NexusGPT/openring/design/datasheets/README.md

# Maker documents are not included

The project was built from the datasheets, application notes and web pages of the parts' makers. Those documents belong to their makers, so none of them is in this repository. Each part below has its maker, the maker part number as written in the parts lists (`design/bom.csv` for the ring, `design/case/case-bom.csv` for the charging case) and the title of the maker document the project cites. A public address is given only where a project file already states it; no address was looked up for this table. Get the documents from the makers.

The `Cited as` column holds the file name the document had in the project's working folder, so that a citation in a design document can be matched to a row.

| Maker | Maker part number | Used for (reference, list) | Title of the cited maker document | Cited as | Public address stated in a project file |
|---|---|---|---|---|---|
| Nordic | NRF54LM20A-CAAA-R7 | U1 (ring) | no maker document is cited for this row (order code from a list or a calculation) | none | none stated |
| Nordic | nPM1304-CAAA-R7 | U2 (ring) | nPM1304 Power Management IC - Datasheet v1.0 | npm1304_datasheet_v1_0.pdf | none stated |
| Yageo | RC0201FR-0747KL | R60, R71, R63,R64,R65 (ring) | no maker document is cited for this row (order code from a list or a calculation) | none | none stated |
| Yageo | RC0201FR-07150KL | R72 (ring) | no maker document is cited for this row (order code from a list or a calculation) | none | none stated |
| Yageo | RC0201FR-07330KL | R73 (ring) | no maker document is cited for this row (order code from a list or a calculation) | none | none stated |
| CS Semiconductor | CSNP32GCR01-BOW | U3 (ring) | SD NAND Memory (CSNP32GCR01-BOW ) | slim2_cs-sdnand-20230403.pdf | none stated |
| Texas Instruments | SN74AXC4T774RSVR | U10 (ring) | no maker document is cited for this row (order code from a list or a calculation) | none | https://www.ti.com/lit/ds/symlink/sn74axc4t774.pdf |
| SGMICRO | SGM38046YG/TR | U4 (ring) | SGM38046 / Single Inductor Power Supply [first lines of page 1] | p3_sgm38046.pdf | none stated |
| Knowles | SPK0641HT4H-1 | U5,U6 (ring) | no maker document is cited for this row (order code from a list or a calculation) | none | none stated |
| Tailor Pixels | TOH095XVT-01 | DISP1 (ring) | Manufacturer Certificated / CERT. No.: 282Q19070712006 CERT. No.: 282E19070712007 [first lines of page 1] | display_TOH095XVT-01.pdf | none stated |
| Hirose | FH35C-15S-0.3SHW(50) | J1 (ring) | no maker document is cited for this row (order code from a list or a calculation) | none | none stated |
| Johanson | 2450AT18D0100001E | ANT1 (ring) | no maker document is cited for this row (order code from a list or a calculation) | none | none stated |
| Murata | LQP03HQ3N6B02 | L2 (ring) | nRF54LM20x_caaa | nrf54lm20x_caaa_ref_schematic_0_2.pdf | none stated |
| Murata | LQP03HQ4N7H02 | L3 (ring) | nRF54LM20x_caaa | nrf54lm20x_caaa_ref_schematic_0_2.pdf | none stated |
| Murata | LQP03HQ3N3B02 | L4 (ring) | nRF54LM20x_caaa | nrf54lm20x_caaa_ref_schematic_0_2.pdf | none stated |
| Murata | GJM0335C1H1R2WB01D | C3 (ring) | nRF54LM20x_caaa | nrf54lm20x_caaa_ref_schematic_0_2.pdf | none stated |
| Murata | GJM0335C1ER50WB01D | C12 (ring) | nRF54LM20x_caaa | nrf54lm20x_caaa_ref_schematic_0_2.pdf | none stated |
| Kyocera | CX2016DB32000D0WZRC1 | X1 (ring) | nRF54LM20x_caaa | nrf54lm20x_caaa_ref_schematic_0_2.pdf | none stated |
| TXC | 9HT11-32.768KDZC-T | X2 (ring) | nRF54LM20x_caaa | nrf54lm20x_caaa_ref_schematic_0_2.pdf | none stated |
| TDK | MLZ1608M4R7WT000 | L1 (ring) | nRF54LM20x_caaa | nrf54lm20x_caaa_ref_schematic_0_2.pdf | none stated |
| Murata | BLM03AG121SN1D | FB1 (ring) | nRF54LM20x_caaa | nrf54lm20x_caaa_ref_schematic_0_2.pdf | none stated |
| Yageo | RC0603FR-072R2L | R1 (ring) | no maker document is cited for this row (order code from a list or a calculation) | none | none stated |
| Yageo | RC0201FR-07220RL | R2 (ring) | no maker document is cited for this row (order code from a list or a calculation) | none | none stated |
| Samsung | CL03A104KP3NNNC | C1,C2,C5, C61,C72,C80,C81,C82 (ring) | no maker document is cited for this row (order code from a list or a calculation) | none | none stated |
| Murata | GRM155R60J106ME15D | C4, C25, C74,C75,C78,C79,C90 (ring) | GRM155R60J106ME15# 「 # 」には包装コードが入ります。 / ＜包装コード有り品番一覧＞ [first lines of page 1]<br>SGM38046 / Single Inductor Power Supply [first lines of page 1] | w1d_murata_grm155r60j106me15.pdf<br>p3_sgm38046.pdf | none stated |
| Murata | GRM035R60J475ME15J | C6 (ring) | nRF54LM20x_caaa | nrf54lm20x_caaa_ref_schematic_0_2.pdf | none stated |
| Murata | GRM033D80E225ME47D | C7,C10,C14 (ring) | nRF54LM20x_caaa | nrf54lm20x_caaa_ref_schematic_0_2.pdf | none stated |
| Murata | GRM155R61A475MEAAD | C11, C84, C21,C26,C27 (ring) | nRF54LM20x_caaa<br>GRM155R61A475MEAA# 「 # 」には包装コードが入ります。 / ＜包装コード有り品番一覧＞ [first lines of page 1]<br>SGM38046 / Single Inductor Power Supply [first lines of page 1] | nrf54lm20x_caaa_ref_schematic_0_2.pdf<br>w1d_murata_grm155r61a475meaa.pdf<br>p3_sgm38046.pdf | none stated |
| Murata | 1269AS-H-2R2M=P2 | L10, L71,L72 (ring) | SGM38046 / Single Inductor Power Supply [first lines of page 1]<br>Spec No. J(E)TE243A-0004A-01 Reference Only 1/9 / 参考図 Reference Specifications 型名 Type DFE252010C [first lines of page 1]<br>nPM1304 Power Management IC - Datasheet v1.0 | p3_sgm38046.pdf<br>w1b_murata_1269as-h-2r2m.pdf<br>npm1304_datasheet_v1_0.pdf | none stated |
| Murata | GRM188R61C106KAALD | C24 (ring) | SGM38046 / Single Inductor Power Supply [first lines of page 1] | p3_sgm38046.pdf | none stated |
| Murata | GRM155R60J225ME15 | C23 (ring) | SGM38046 / Single Inductor Power Supply [first lines of page 1] | p3_sgm38046.pdf | none stated |
| Murata | GRM155R60J106ME15 | C22, C83 (ring) | SGM38046 / Single Inductor Power Supply [first lines of page 1] | p3_sgm38046.pdf | none stated |
| Murata | GRM155R60J226ME11D | C28,C29 (ring) | SGM38046 / Single Inductor Power Supply [first lines of page 1] | p3_sgm38046.pdf | none stated |
| Murata | GRM033R60J105MEA2D | C73, C31,C32 (ring) | no maker document is cited for this row (order code from a list or a calculation) | none | none stated |
| Kyocera AVX | 04025A102JAT2A | C35,C36 (ring) | C0G (NP0) Dielectric / General Specifications [first lines of page 1]<br>SPK0641HT4H-1 / Digital SiSonicTM Microphone [first lines of page 1] | w1_kyocera_avx_c0g_dielectric.pdf<br>w1b_knowles_spk0641ht4h-1_chipdip.pdf | none stated |
| Yageo | RC0201FR-07100RL | R61, R31,R32 (ring) | no maker document is cited for this row (order code from a list or a calculation) | none | none stated |
| Alps Alpine | SKTAAAE010 | SW2, SW1,SW3,SW4,SW5 (ring) | 一太郎 10/9/8 文書 | slim_alps-skta-aaae010-orwin.pdf | none stated |
| Yageo | RC0201FR-074K7L | R57,R58 (ring) | no maker document is cited for this row (order code from a list or a calculation) | none | none stated |
| Kyocera AVX | 0402ZC225KAT2A | C60, C85 (ring) | SD NAND Memory (CSNP32GCR01-BOW )<br>X7R Dielectric / General Specifications [first lines of page 1]<br>nPM1304 Power Management IC - Datasheet v1.0 | slim2_cs-sdnand-20230403.pdf<br>w1_kyocera_avx_x7r_dielectric.pdf<br>npm1304_datasheet_v1_0.pdf | none stated |
| Jinlong Machinery | W0525AB001D | M1 (ring) | YB0525BWA APPROVAL REQUEST Rev.0  - 副本.docx | slim2_jinlong-w0525ab001d.pdf | none stated |
| Texas Instruments | TLV75530PDQNR | U11 (ring) | TLV755P 500mA, Low-IQ , Small-Size, Low-Dropout Regulator datasheet (Rev. D) | motor_tlv755p.pdf | none stated |
| Grepow (custom order) | not stated | BT1, PRT1 (ring) | no maker document is cited for this row (order code from a list or a calculation) | none | none stated |
| Gore | not stated | MEM1,MEM2 (ring) | no maker document is cited for this row (order code from a list or a calculation) | none | none stated |
| Texas Instruments | TPD4E05U06DQAR | U6, U9 (case+ring) | TPDxE05U06 1, 4, 6 Channel ESD Protection Device for Super-Speed (Up to 6 Gbps) Interface datasheet (Rev. O) | case_tpd4e05u06.pdf | none stated |
| Yageo | RC0201FR-07100KL | R62,R66 (ring) | no maker document is cited for this row (order code from a list or a calculation) | none | none stated |
| Murata | GRM155R61E105KA12D | C71, C86,C87 (ring) | 注意 : このデータシートは最新でない可能性があります。 / 製品検索 データシート 村田製作所公式ウェブサイトよりGRM155R61E105KA12#の最新データシートをダウンロードして [first lines of page 1]<br>nPM1304 Power Management IC - Datasheet v1.0 | w1b_murata_grm155r61e105ka12.pdf<br>npm1304_datasheet_v1_0.pdf | https://akizukidenshi.com/goodsaffix/GRM155R61E105KA12.pdf |
| Murata | GRT188R61A106KE13D | C88 (ring) | Note: This datasheet may be out of date. / Product Search Data Sheet Please download the latest datasheet of GRT188R61A106KE13# from the official webs [first lines of page 1]<br>nPM1304 Power Management IC - Datasheet v1.0 | w1c_murata_grt188r61a106ke13.pdf<br>npm1304_datasheet_v1_0.pdf | none stated |
| Murata | GRM0335C1H102JE01D | C76,C77 (ring) | Chip Multilayer Ceramic Capacitors for Consumer Electronics & Industrial Equipment Reference Sheet / ■ Scope [first lines of page 1] | c76_murata_GRM0335C1H102JE01.pdf | none stated |
| Murata | NCP15XH103F03RC | RT1 (ring) | Note: This datasheet may be out of date. / Product Search Data Sheet Please download the latest datasheet of NCP15XH103F03RC from the official website [first lines of page 1]<br>nPM1304 Power Management IC - Datasheet v1.0 | w1b_murata_ncp15xh103f03rc.pdf<br>npm1304_datasheet_v1_0.pdf | https://static.chipdip.ru/lib/012/DOC013012218.pdf |
| Master Bond | EP30Med | RC1 (ring) | no maker document is cited for this row (order code from a list or a calculation) | none | none stated |
| Espressif | ESP32-S3-MINI-1-N8 | U1 (case) | ESP32-S3-MINI-1 / ESP32-S3-MINI-1U [first lines of page 1]<br>ESP32-S3 Series / Datasheet Version 2.2 [first lines of page 1] | case_esp32s3_mini1.pdf<br>case_esp32s3_ds.pdf | none stated |
| Texas Instruments | BQ25895RTWR | U2 (case) | BQ25895 I2C Controlled Single Cell 5-A Fast Charger with MaxChargeTM for High Input Voltage and Adjustable Voltage 3.1-A Boost Operation datasheet (Rev. C) | case_bq25895.pdf | none stated |
| Texas Instruments | TPS63802DLAR | U3 (case) | TPS63802 2-A, High-efficient, Low IQ Buck-boost Converter in DFN Package datasheet (Rev. D) | case_tps63802.pdf | none stated |
| Zetta | ZDSD64GLQEAG-R | U4 (case) | ZDSD08G/16G/32G/64G / ZETTA SD NAND Product Datasheet [first lines of page 1] | sdnand_zetta_family_atta.pdf | none stated |
| Texas Instruments | TPS2553DBVR | U5 (case) | TPS255xx Precision Adjustable Current-Limited Power-Distribution Switches datasheet (Rev. G) | case_tps2553.pdf | none stated |
| DNK Power | DNK852338 | BT1 (case) | 3.7V DNK852338 700mAh LiPo Battery Pack with PCM. This / Battery Dimension Pictures 1 YEAR [first lines of page 1] | case_cell_dnk852338.pdf | none stated |
| GCT | USB4105-GF-A | J1 (case) | USB4105 | case_usb4105.pdf | none stated |
| Harwin | P70-6000045R | P1-P4 (case) | (file not found in the source project)<br>(file not found in the source project)<br>(file not found in the source project) | w15_harwin_drawing_P70-600.pdf<br>w15_harwin_component_spec_C056.pdf<br>w15_harwin_graph_CPPOGO.txt | none stated |
| Kingbright | APTF1616SEEZGQBDC | LED1 (case) | APTF1616SEEZGQBDC(Ver.14B) | case_kb_aptf1616.pdf | none stated |
| Yageo | RC0402FR-07510RL (R8); RC0402FR-07270RL (R9 and R10) | R8-R10 (case) | no maker document is cited for this row (order code from a list or a calculation) | none | none stated |
| Mill-Max | 0981-0-15-20-87-14-11-0 | PA1-PA4 (case) | Mill-Max 0981-0-15-20-87-14-11-0 Datasheet | p3_millmax_0981.pdf | none stated |
| Semitec | 103AT-2 | TH1 (case) | BQ25895 I2C Controlled Single Cell 5-A Fast Charger with MaxChargeTM for High Input Voltage and Adjustable Voltage 3.1-A Boost Operation datasheet (Rev. C) | case_bq25895.pdf | none stated |
| Celanese | Vectra E130i, black | MECH16 (case) | no maker document is cited for this row (order code from a list or a calculation) | none | none stated |
