NexusGPT/openring/design/bench/bench-kits.md

# Bench kits for the AI ring recorder (version B2, 2026-11-12)

Same parts as `design/bench/bench-plan.md` version B2. The B1 version of this file (listings read 2026-11-10) is saved as `design/bench/logs/bench-kits-B1-copy.md`; what B2 changed is in `design/bench/b2-notes.md`.

Tags. [F] = read in full on the maker's or seller's page, or in a saved document. [S] = search-result text only, page not opened. [B1] = carried from the 2026-11-10 listing, not read again in B2. Pages read in B2 were fetched as text with `curl` (read only, the default curl user agent except for the first request (the Nordic DK guide, which used the generic string 'Mozilla/5.0 (compatible; text-fetch)' and was refused with a browser check), no account, no cart, no contact, no project or owner name in any request); the UTC read time of each is in `design/bench/logs/fetch_all.log` and the saved copy is in `design/bench/sources/`. Pages that answered HTTP 403 (a browser check), 404 or no reply are listed in the log and marked "not read" below; none was worked around.

The ring's parts are in `design/bom.csv`; the reference and line of each are given in the plan's section 2.

## 1. Main chip (ring: nRF54LM20A, `design/bom.csv` line 2): development kit, debugger, current measurement

**Kit: nRF54LM20 DK, maker Nordic Semiconductor, order code `NRF54LM20-DK`** (Digi-Key part 1490-NRF54LM20-DK-ND) [B1, F on Digi-Key 2026-11-10]. Nordic's DK page prints no order code [B1].

- The kit as sold carries the nRF54LM20B [B1, F]. **The A chip's rules on that kit (new in B2):** the Zephyr documentation of the board says "The nrf54lm20dk/nrf54lm20a board is a modified version of the nRF54LM20 DK that enforces the limitations imposed by the nRF54LM20A IC ... Since Nordic does not offer a development kit for the nRF54LM20A, you can use this board to develop for this IC while using the nRF54LM20 Development Kit (PCA10184)" [F, `https://docs.zephyrproject.org/latest/boards/nordic/nrf54lm20dk/doc/index.html`, saved text `design/bench/sources/zephyr_nrf54lm20dk_board.txt`, page last source update 2026-10-08]. The bench therefore builds for board target `nrf54lm20dk/nrf54lm20a/cpuapp`. This closes the "no kit carries the A die" gap of B1 as far as software can; the silicon stays the B die (plan D4).
- Pin map of the headers [F, new in B2]: DK schematic revision 0.5.4, sheet 8, saved as `design/bench/sources/dk_sch_p8_P1P2-08.png` and `dk_sch_p8_P17top-08.png`. Headers P1 to P5 are 2x10: pins 1, 2, 19, 20 are VDD:IO; P1 pin n = P0.(n-3) (P0.00 to P0.09); P2 pin n = P1.(n-3) (P1.00 to P1.15); P3 pin n = P1.(n+13) (P1.16 to P1.31); P4 pin n = P2.(n-3) (the nets are named P2.00_A to P2.10); P5 pin n = P3.(n-3) (P3.00 to P3.12). P17 (2x13) pin 1 VDD, pin 2 GND, and named pins A0 to F1, C4, G0, H0 to H5 with their chip pins. The user guide's own pin table is still not read (below).
- Pins the DK shares with its own parts [F, DK schematic sheet 2 text and sheet 4 image; Zephyr devicetree `design/bench/sources/zephyr_nrf54lm20dk_common.dtsi` and `zephyr_nrf54lm20dk_a_b_pinctrl.dtsi`]: push button 0 on P1.26, button 1 on P1.09, button 2 on P1.08, button 3 on P0.05; LEDs on P1.22, P1.25, P1.27, P1.28; uart20 on P1.16 to P1.19; uart30 on P0.06 to P0.09 (reaching the debugger through analog switches, sheet 4); the on-board QSPI flash on P2.00 to P2.05.
- Supply: VDD:nRF = VDD:IO = 1.8 to 3.6 V from the DK's own nPM1300; its start-up value is 1.8 V ("Startup VOUT1: 47k -> 1.8V", `design/bench/sources/dk_sch_p6-06.png`, sheet 6) [F]. "DK requires power from USB connector" in the default configuration; a manual override powers the chip through header P14 (sheet 4 note: "R43, R51 mounted: Analog switches are powered from P14") [F]. The two USB-C connectors: nRF USB (J3) and Debugger USB (J4), sheet 8 [F].
- Current measurement: P14 (1x3) and JP1 "Shunt 2.54mm" in the block "Current Measurement", sheet 6 [F]. Nordic's set-up page: "Remove the jumper from the P14 header" and "replace the measurement devices on P14 with the jumper" [B1, F, quoted].
- On-board debugger: SEGGER J-Link OB [B1, F].
- Caveat [B1, S]: a DevZone user read 89 uA on an nRF54LM20A DK against a 4 uA datasheet figure; no confirmed answer found.
- Price: **US$45.00** (quantity 1), Digi-Key US, 321 in stock, lead time 19 weeks, as read 2026-11-10 [B1, F]. Not read again in B2: Digi-Key answers curl with HTTP 403.
- Not read: the DK user guide v0.3.4 (a browser-check page, `design/datasheets/bench_nrf54lm20-dk-hw-ug-v0.3.4.pdf`) and the same guide through `https://docs.nordicsemi.com/bundle/ug_nrf54lm20_dk/...` (HTTP 403, `design/bench/sources/nordic_dk_connector_if.html`).

**Power Profiler Kit II, maker Nordic Semiconductor, order code `nRF-PPK2`** [B1, F: "Ordering code: nRF-PPK2" on `https://www.nordicsemi.com/startppk2`]. Range 200 nA to 1 A; supports all Nordic DKs [B1, F]. Price **US$107.30**, Digi-Key US part 1490-NRF-PPK2-ND, 1,608 in stock, lead 16 weeks, 2026-11-10 [B1, F]. Header names of the PPK2 are not read.

## 2. Power chip (ring: nPM1304-CAAA-R7, `design/bom.csv` line 3): nPM1304 EK

**Kit: nPM1304 EK, maker Nordic Semiconductor, order code `nPM1304-EK`.**

- Order code [F]: Nordic's nPM1304 Product Specification v1.0, "Table 50: nPM1304 order codes", page 168: "nPM1304-EK  Evaluation kit" (saved `design/datasheets/npm1304_datasheet_v1_0.pdf` and its text copy; also `design/architecture.md` line 644 and `design/ecad/motor-drive/motor-drive.md` section 2.9, which names the same kit for the motor test).
- Existence as a product [F]: the specification line "The nPM1304 Evaluation Kit provides simple evaluation and code-free configuration of nPM1304" (same text copy); Zephyr ships a shield `npm1304_ek` for it, "nPM1304 EK", with a 4 mA default charge current and PMIC buttons (saved `design/bench/sources/zephyr_npm1304_ek_doc.txt`, `zephyr_npm1304_ek_overlay.txt`, read 2026-11-11 UTC per the log); Nordic's own product line "The new nPM1304 Evaluation Kit is now available for order through Nordic's distribution partners" is quoted in `design/parts/research-npm1304.md` line 73 [F, saved file].
- Zephyr's page says the EK "is not a direct fit into an Arduino connector" and that its I2C lines must be connected to the board's I2C bus [F]. No header designator or pin table is given.
- **Not read:** price and stock of the nPM1304 EK at any seller (Digi-Key and Nordic answered curl with HTTP 403; Mouser and Farnell gave no reply; see the log). The B1 price of US$64.35 was for the nPM1300 EK and is not carried over. The EK user guide `ug_npm1304_ek` (`https://docs.nordicsemi.com/bundle/ug_npm1304_ek/...`, HTTP 403 browser check, `design/bench/sources/nordic_ug_npm1304_ek_a.html`): battery connector pinout, header labels, VDDIO and pull-ups on the EK are therefore not read (plan section 9, points 1 and 2).
- Chip pins and balls the plan uses: `design/ecad/ring/npm1304-balls.csv` (VBAT D1 D2, VOUT1 B6, VOUT2 C6, LSIN1 B4, LSIN2 B5, LSOUT1 A4, LSOUT2 A5, SDA E5, SCL E3, GPIO0 D6, VDDIO E4).
- Outputs of the buck converters on the family: 1.0 to 3.3 V (Zephyr overlay `limits are set to min/max allowed values`, 1,000,000 to 3,300,000 uV) [F]; this is why the bench sets VOUT2 to 3.3 V (plan D1).
- Used in B1 and not used in B2: the nPM1300 EK (NPM1300-EK, US$64.35 [B1]).

## 3. Microphones (ring: 2 x Knowles SPK0641HT4H-1, `design/bom.csv` line 9)

- **The ring's part, used itself** (plan row 4): Knowles SPK0641HT4H-1, 8-pad LGA, top port, 4.00 x 3.00 x 1.00 mm; pins 1 DATA, 2 CLOCK, 3 SELECT, 4 Vdd, 5 to 8 GROUND; supply 1.6 to 3.6 V; clock 1.0 to 4.8 MHz [F, `design/mech/mic-path/datasheets/knowles-spk0641ht4h-1_chipsmall.pdf`, a third-party host's copy of Knowles Rev A]. Reel suffix, distributor code, stock and price are not known (`design/mech/mic-path/mic-path.md` line 32 and its open item O1; open item S23). Order code: **not confirmed**.
- **Maker's evaluation board for the SPK0641HT4H-1: none found.** No saved file names one. A search engine query for it (`html.duckduckgo.com`, 2026-11-11 UTC) was answered with a bot-check page (HTTP 202, saved `design/bench/sources/ddg_knowles_eval.html`) and was not worked around; Knowles' own site search returned a bot-check page (`knowles_search.html`); Digi-Key, TME and Octopart answered HTTP 403; Mouser, Arrow, Newark and Farnell gave no reply (all in `design/bench/logs/fetch_all.log`). The plan therefore mounts two of the ring's parts on carrier CB-MIC, drawn in plan section 4.1 from the Knowles sheet and the ring's netlist.
- Not used in B2: Infineon kits `KITIM68D128BV01FLEXTOBO1` (US$75.19, 9 in stock, lead time 97 weeks [B1, F]) and `KITIM73D122V01FLEXTOBO1` [B1]. The ring no longer uses the IM68D128B or the IM73D122 (`design/architecture.md` 17.19; review 3 contradiction C7).

## 4. Screen (ring: Tailor Pixels TOH095XVT-01, `design/bom.csv` line 10)

- **The ring's panel cannot run on the bench today.** It needs the vendor's start-up code for the SH8501A (open item 12.1), a panel supply of +4.6 V and -2.2 V (the ring's U4, SGM38046), and a 15-contact 0.3 mm-pitch tail connector (Hirose FH35C-15S-0.3SHW(50), bom.csv line 11) [B1]. No seller offers it with an adapter and example code [B1: BuyDisplay and Gesight pages not readable; Panox BO095F120S datasheet saved `design/datasheets/bench_panox-bo095f120s.pdf`].
- **Chosen stand-in: Waveshare 0.95inch RGB OLED (A), SKU 10507, part number "0.95inch RGB OLED (A)"** [F, `https://www.waveshare.com/product/displays/oled/0.95inch-rgb-oled-a.htm`, saved `design/bench/sources/waveshare_oled095_a.txt`, read 2026-11-11 23:31 UTC]: driver SSD1331, SPI, 96 x 64, 65K colours, 0.95 inch, operating voltage 3.3 V / 5 V; pins 1 VCC (3.3 to 5 V), 2 GND, 3 NC, 4 DIN, 5 CLK, 6 CS, 7 D/C, 8 RES; curved/horizontal pin header; price US$11.99 (quantity 1; US$11.40 at 10 to 49) as read; stock not shown on the page text; a straight-header version "(B)" exists, its SKU not read. Why this one: an OLED like the ring's AMOLED (self-lit pixels, true black), a complete pin table on the page, and the same 0.95 inch size class.
- Considered and not chosen: Adafruit 684, "OLED Breakout Board - 16-bit Color 0.96" w/microSD holder", SSD1331, 96 x 64, 3.3 to 5 V logic and power, US$29.95 (quantity 1), 90 in stock [F, `design/bench/sources/adafruit_684.txt`, same read time]; its pin names are not on the page text.
- The bench stand-in does not carry the panel's real current: the always-lit sign's cost on the ring's panel stays a bench measurement for the day the panel arrives (plan section 8).

## 5. Storage and level shifting (ring: U3 CSNP32GCR01-BOW, bom.csv line 6; U10 SN74AXC4T774RSVR, bom.csv line 7)

- **Adafruit MicroSD card breakout board+, product ID 254** (stand-in; microSD card not included) [F, `https://www.adafruit.com/product/254`, saved `design/bench/sources/adafruit_254.txt`, read 2026-11-11 23:31 UTC]: price US$7.50 (quantity 1), in stock; onboard 5 V to 3 V regulator, 150 mA; 3 V level shifting with a proper level-shifting chip; 0.1 inch header supplied unattached; pins GND, 5V, CLK, DO, DI, CS named in its wiring sentence. The 3 V logic of this board cannot read the DK's 1.8 V highs, which is why the plan puts a TXB0108 breakout in front of it (plan D2). Product 6039 (XTSD 4 GB chip board) was out of stock in B1 [B1].
- **Adafruit 8-channel Bi-directional Logic Level Converter - TXB0108, product ID 395** (two pieces: storage lines and screen lines) [F, `https://www.adafruit.com/product/395`, saved `design/bench/sources/adafruit_395.txt`, same read time]: price US$7.95 (quantity 1; US$7.16 at 10 to 99), in stock; TXB0108 with 0.1 uF capacitors on both sides and a 10 kohm pull-up on the output enable pin; "does not have strong output pins"; I2C does not work well through it. Pin labels on the board (A1 to A8, B1 to B8, VA, VB, OE, GND) are not shown in the page text. Used for SPI lines only.
- **The ring's SD NAND, CS Semiconductor CSNP32GCR01-BOW (LGA-8, 8.0 x 6.2 mm)** [B1, S]: LCSC listing with 2.7 to 3.6 V and an SD interface; SPI-mode pin table in `design/datasheets/slim2_cs-sdnand-20230403.pdf` p4 to p6. A breakout for it: not found [B1, S].
- The ring's level shifter U10 (TI SN74AXC4T774RSVR, one-way ports, Hi-Z below 100 mV on VDD_SD) is not on the bench: the TXB0108 is bidirectional (plan section 8).

## 6. Vibration motor and its regulator (ring: M1 Jinlong W0525AB001D, bom.csv line 44; U11 TI TLV75530PDQNR, bom.csv line 45)

- **Motor: Jinlong Machinery W0525AB001D, the ring's part itself** (plan row 5). Brushless coin motor with its own drive chip, 5.0 mm diameter x 2.5 mm, two lead wires (red +, blue -); rated 3.0 V, operating 2.7 to 3.3 V, rated current below 80 mA, starting current below 175 mA, starting voltage below 2.5 V [F, `design/architecture.md` 17.16; Jinlong spec S-525113 rev 0 copy `design/datasheets/slim2_jinlong-w0525ab001d.pdf`, a third-party host's copy; `design/ecad/motor-drive/motor-drive.md` section 1]. Seller, order code and price: **not confirmed** (bom.csv line 44: "the maker must confirm the part and its price (no price read)"; no seller page found in saved files).
- **Regulator: Texas Instruments TLV75530PDQNR, the ring's part itself, on carrier CB-MOT** [F]: 3.0 V fixed, 500 mA, X2SON-4 (DQN), 1.0 x 1.0 mm, reel of 3000, status Active, marking KI; the order line is printed in `design/ecad/motor-drive/src_tlv755p.txt` (text copy of TI SBVS320D, "TLV75530PDQNR ... Active ... X2SON (DQN) | 4 ... 3000 | LARGE T&R") and `design/ecad/motor-drive/motor-drive.md` section 2.2 (pins OUT 1, GND 2, EN 3, IN 4). TI's product page of the family, read 2026-11-11 23:31 UTC (`design/bench/sources/ti_tlv755p.txt`), lists two evaluation modules: `MULTIPKGLDOEVM-823` ("Universal LDO linear voltage regulator evaluation module for DBV, DRB, DRV and DQN packages", "a DRB, DRV, DQN and DBV footprint for you to solder") and `TLV755EVM-087` ("a single low-IQ, small-size linear regulator"; its package is not stated in the page text). Their pin tables are in user guides not read. Not chosen: CB-MOT is a drawn netlist with known pins (plan section 4.1). Price at quantity 1 of TLV75530PDQNR: not read.
- Not used in B2: Vybronics VC0720B088L (US$3.23 [B1]), VC0625B001L (US$3.17 [B1]) and the Adafruit MOSFET driver 5648 (US$3.95 [B1]); the ring no longer uses them (`design/architecture.md` 17.16 and 17.22; review 3 contradiction C8).

## 7. Switches (ring: 5 x Alps Alpine SKTAAAE010, bom.csv lines 39 and 40)

- **Chosen: Adafruit Thru-hole 5-way Navigation switch, product ID 504** [F, `https://www.adafruit.com/product/504`, saved `design/bench/sources/adafruit_504.txt`, read 2026-11-11 23:31 UTC]: "Inside is 5 switches: left, right, up, down and 'select' (pressing down), all with a common ground pin"; US$1.95 (quantity 1; US$1.76 at 10 to 99), in stock; "Datasheet for similar part SKQUCAA010". The Alps sheet of that similar part (`https://cdn-shop.adafruit.com/datasheets/SKQUCAA010-ALPS.pdf`, saved `design/bench/sources/SKQUCAA010-ALPS.pdf` and `.txt`) gives: SKQU series 4-directional with center push, 10 mm square, 1.57 N (directions), 3.14 N (centre), 12 V DC 50 mA, 100,000 cycles; circuit: pin 1 = A, 2 = B, 3 = C, 5 = D, 6 = centre, 4 = common; drawing: A at the top, B left, C bottom, D right. Whether the Adafruit part's pins follow that table is not confirmed: plan test T0 step 3 reads it by continuity.
- Not chosen: Adafruit 367 (6 mm tactile switch, 20 pack): out of stock on 2026-11-11 [F, `design/bench/sources/adafruit_367.txt`]. The ring's own SKTAAAE010: no seller page read [B1: search-text figures only]; its land pattern is open (open item S9), so no carrier can be drawn.

## 8. Reference device: Plaud recorders [B1]

Prices and specs from `https://www.plaud.ai/pages/compare-plaud-devices` [B1, F] (USD): Plaud Note Pro $189.00; Plaud Note $159.00; Plaud NotePin S $179.00; Plaud NotePin $159.00; Plaud One $249.99. Every model except Plaud One shown as pre-order. Export of raw audio (MP3 or WAV; sample rate) not read: the support page answered HTTP 403 [B1]. `requirements.md` section 4 names a Plaud Note Pro as the reference; B1 and B2 use the NotePin (plan row 11); the owner decides.

## 9. Measurement method sources [B1]

LibriSpeech test-clean (`https://www.openslr.org/12`, CC BY 4.0); ITU-T P.501 (04/2025) Annex B; jiwer (`https://github.com/jitsi/jiwer`, Apache-2.0); Whisper (`https://github.com/openai/whisper`, MIT); Plaud's chamber test (`https://www.plaud.ai/blogs/news/inside-plaud-s-anechoic-chamber`: 1 m and 3 m; quiet about 35 dB, moderate about 55 dB, loud about 70 dB). No neutral head-to-head table at distance was found [B1].

## questions_for_owner

1. Accept a DK with the nRF54LM20B die running the A chip's rules (plan D4)? No kit with the A die exists (Zephyr documentation, section 1).
2. Reference recorder: `requirements.md` section 4 says Plaud Note Pro; the plan buys the NotePin (the one B1 chose). Which one?
3. The nPM1304 EK user guide is behind a browser check. Someone with a browser can save `ug_npm1304_ek` (battery connector pinout, header labels, VDDIO) into `design/datasheets/`; it closes plan section 9 points 1 and 2.
4. Two blocked downloads are still saved in `datasheets/` as `bench_nrf54lm20-dk-hw-ug-v0.3.4.pdf` and `bench_npm1300-ek-ug-v1.1.0.pdf`; each is an HTML block page, not a PDF.

RESULT: done, B2 parts follow the ring (nPM1304 EK, Knowles microphones, Jinlong motor with its TLV75530 regulator, 5-way switch, OLED stand-in); order codes confirmed for 8 items and not confirmed for the Knowles microphone, the Jinlong motor and the Plaud.
