NexusGPT/openring/design/case/case-architecture.md

# Ring charging case: architecture (version C5d)

Version C5d (2026-11-11) is the soft cube the owner chose (C5b, detailed as C5c) with its open points closed. Size unchanged: 45.4 x 45.9 x 41.4 mm (out/case_size.txt). Check: look/c5d_check_lead_rerun.log (last line: "case_check: PASS, 3447 pairs checked, 0 failures"). Handover: c5d-open-points-handover.md.

## Changes from C5d to C5d-r4 (2026-11-13: the routed boards in the model)

Notes with every value and source: `case-model-r4-notes.md`. Check of this version (with the corrected pin heights): r4/pins_full_check.log, PASS with 0 failures over 8035 pair checks at US 7 to 13 (look/c5d_check_lead_rerun.log is still the lead's rerun of C5d; its count is the one quoted elsewhere in this file until the lead reruns this version).

| Topic | C5d | C5d-r4 | Source |
|---|---|---|---|
| Main board | box 23.0 x 35.4 x 1.0 mm, symmetric, part volumes typed as boxes | read on every run from `design/ecad/case/pcb/case_main.kicad_pcb` (KiCad's Python) and its own STEP (kicad-cli): outline 24.85 x 37.90 mm with the socket tab (main part u 0 to 23.0, y -17.70 to 20.20), thickness 1.0 mm, 59 part bodies | r4/case_boards.py; check test 15 |
| Board place | pcb1_x0 = x_lay + 1.9 (-9.637) | -10.142: the socket body's own front sits 0.3 mm behind the skin (the C5d place read the socket front 0.505 mm too far forward) | case.py `pcb1_x0` |
| Cavity at the board | -X wall at -10.037, ends at y +-20.35 | from 0.35 mm under the board to the ceiling: -X wall at -10.542, socket-side end at y 20.60; below the board as C5d | case.py `uf` |
| Pin board | three boxes (inner island 3.9 mm wide) | islands from `case_pins.kicad_pcb`: inner y -2.25 to 2.25, wings 2.35 to 4.90 (and mirrored); the holder's island pockets follow | check test 15a |
| Board holding | none | `board_retainer` (printed): web 0.8 mm under the ceiling, 4 posts dia 1.6 mm, 2.86 mm long, at (6.71, 10.15); (-9.04, 18.90); (9.21, -0.60); (-5.29, 18.15); a fence x 12.88 to 15.84, y -10.00 to 10.00; foam pad 0.8 mm under the cell; insulating sheet 0.25 mm on the cell | BOM MECH18 to MECH20 |
| Leads | not modelled | nine swept wires checked against every part (test 16): TH1_1 6.7 mm; TH1_2 4.7 mm; W1 10.2 mm; W2 10.8 mm; W3 10.8 mm; W4 10.2 mm; W5 11.2 mm; W6 6.7 mm; W7 10.7 mm | case.py `swept_wire` |
| Pin holder | wires had no room in front of the pad face | a 0.7 mm recess in the holder's front wall behind the five wire pads, up to z 22.66; the floor slot starts at x 4.82 (C5d: 6.82) | case.py |
| Lift out | not simulated | test 17: lid open, ring lifted straight up in 0.25 mm steps until clear, every size; smallest free space (seat contacts left out): US 7 0.172 mm to shell at 0.25 mm; US 8 0.175 mm to shell at 0.25 mm; US 9 0.182 mm to shell at 0.25 mm; US 10 0.188 mm to shell at 0.25 mm; US 11 0.163 mm to shell at 0.25 mm; US 12 0.141 mm to shell at 0.25 mm; US 13 0.121 mm to shell at 0.25 mm | case_check.py test 17 |

## Changes from C5c to C5d

| Topic | C5c | C5d | Source |
|---|---|---|---|
| Ring used by the model and the check | `ring-merged32e.step` (US 9) and six COMPUTED sizes (band tube, joystick moved radially) | the accepted exterior merged32h, one real file per size: `design/look/s1/out/ring-merged32h-us7.step` to `-us13.step`; bore radius and centre from `measures-merged32h-us<n>.json` | case.py `RING_STEP_N`, `_ring_info` |
| Joystick | the old merged32e nub (6.4 mm along the band; its outer face at y -14.394 on US 9, 0.739 mm lower than merged32h's -15.133) | the round joystick of merged32h: frame dia 5.4 mm, cap dia 4.4 mm, cap top 1.48 mm above the frame (`work-32h/summary-32h.log`), at -84 / -81 / -78 degrees (US 7 / 8 / 9 to 13); the dish grew from radius 17.10 to 17.64 mm at the floor (rw0) to keep 0.3 mm round every size's joystick; outer size unchanged | out/case_params.json `dish`, `joy_deg`; check test 13 |
| Pads | typed in case.py (pitch 2.4, disc 1.6, row offset -1.0) | READ from `design/mech/thin/placement.csv` (rows `pad_VBUS`, `pad_D-`, `pad_D+`, `pad_GND`): row X -1.000 mm, disc 1.60 x 0.07 mm, face radius 9.4761 mm about Z -9.8740 (circle fitted to the four pad centres), arc pitch 2.4000 mm; kept as arc positions at every size's bore | case.py `read_placement`; out/case_params.json `placement` |
| Pin order | assumption A1: VBUS at -Y | from placement.csv: P1 VBUS y +3.521, P2 D- +1.197, P3 D+ -1.197, P4 GND -3.521 (case frame, US 10 pad places) | out/case_params.json `ypin`, `pin_nets` |
| Pin holder | none: PCB2 islands stood free in front of a plain lug | `pin_holder`: black LCP (Celanese Vectra E130i), front follows the band's inner face, four bores dia 1.60, lip on the lug top, two heat stakes moulded on the post (section 7 "Pin holder") | case.py, out/parts/pin_holder.step, out/case_pin_holder.stl, BOM MECH16, MECH17 |
| Band rests (the two V flanks in the dish) | two bars from the floor to the rim (11 mm above the band) | kept (they are the band's seat), now 7.0 mm high: floor to 1.0 mm below the band's top, top edges rounded 0.8 mm, the flank face's vertical edges rounded 0.25 mm (section 7 "Band rests") | case.py `REST_*` |
| Checks | tests 1 to 12 | test 3 matches each pin to the pad of its own net read from placement.csv; new 13 (joystick clearance per size), new 14 (pin holder: one valid solid, front to the band per size) | case_check.py |

Version C5b (2026-11-11) redoes the look of C5 with size as the first rule: the case was 45.5 x 45.9 x 41.4 mm at C5b (since C5d: 45.4 x 45.9 x 41.4 mm, out/case_size.txt) (C4: 43.2 x 44.0 x 40.6 mm; the C5 attempt at 57.7 x 52.1 x 43.0 mm is in `out/old_C5/` and `look/old_C5/`). Changes against C4, in one line each: (1) the outside is one smooth skin, no planar face (a superellipse plan, elliptical bottom and top edges, a crowned base and a crowned lid); (2) the lid covers the WHOLE top: the seam lies in the straight wall, 0.3 mm gap; (3) the pivot pin is fixed in the lid and hidden, the base magnet is under a 0.5 mm skin, the glides ride on the lid; (4) the USB-C mouth is a recessed rounded slot with a lead-in chamfer, the light is one 1.0 mm dot; (5) the dish rolls into the wall; (6) pads are 1.6 mm discs at 2.4 mm pitch (`design/architecture.md` 17.15); (7) the C4 assembly STEP and GLB applied every part's location twice: fixed. The ring stands around a centre post as in C4; electronics, parts and figures are those of C4 (section 7 and "Changes from C4 to C5b" below). The body is a non-conductive moulded polymer with a metal-look finish (section 7, "Finish and Wi-Fi").

## Changes from C4 to C5b

| Topic | C4 | C5b | Source |
|---|---|---|---|
| Outer size | 43.2 x 44.0 x 40.6 mm | 45.4 x 45.9 x 41.4 mm (out/case_size.txt): +2.2, +1.9, +0.8 mm; the owner's limit was 45.5 x 46.0 x 41.5 | out/case_size.txt |
| Outside form | box, straight walls, edge radius 1.5 (top) and 2.5 (bottom), plan corners 4 and 14 mm, flat top and bottom | one skin: superellipse plan (exponent 6.0 on the -X side, 4.95 on the +X side; smallest radius of curvature 5.6 mm at the -X corners, set by the corners of the 40 mm cell), straight wall, elliptical bottom edge 7.5 mm wide x 3.1 mm high, elliptical top edge 10.0 mm wide x 1.8 mm high, base crowned by 0.44 mm, lid crowned by 0.68 mm; no planar outside face (test 8) | look/pebble.py, case.py `skin_part`, look/explore2.log |
| Lid | flat cap 4.0 mm, a cap over the top of the box | the lid is the whole top of the pebble: its outline is the base's outline, the seam is cut in the straight wall (base rim z = 37.66 mm, lid underside z = 37.96 mm: 0.3 mm shadow gap), the wall runs 0.5 mm above the seam before the top edge starts | case.py |
| Pivot and magnets | pin in the base, 0.4 mm glides on the base rim, magnet pockets open on the rim | pin fixed in the lid at (-7.98, -18.75), its top 1.3 mm under the crown (a 3.2 mm blind hole shows in the rim when the lid is open); four 0.3 mm glides fixed to the lid; base magnet under a 0.5 mm skin; the lid opens 100 degrees | case.py `seam_layout` |
| USB-C and light | rectangular opening, 2.4 mm light hole | rounded slot (radius 0.9 mm, 0.6 mm round the socket) with a 0.9 mm lead-in chamfer, socket front 0.3 mm behind the skin at its outermost corner (the skin curves, so the recess at the middle of the mouth is 1.4 mm), z 13.2 to 16.5 (lower half); the light is one 1.0 mm dot beside it | case.py `mouth_cutter`, test 10 |
| Inside | box well and pocket, sharp edges | dish floor rolls into the wall (1.8 mm radius), pocket and notch with rounded corners | case.py `rolled_prism`, `rbox` |
| Pads | pitch 2.0 mm, discs 1.0 mm | pitch 2.4 mm, discs 1.6 mm; pin heights 1.980 to 2.150 mm, spread 0.170 mm (REPLACED 2026-11-13 (was 2.280 to 2.418 mm, spread 0.138 mm: the C5d range)) | out/case_params.json lines 118 to 120 (pin_travel) |
| Body material | metal-look finish on a non-conductive body (K2) | proposal in section 7 "Finish and Wi-Fi" | case-notes.md K2 |
| Assembly file | location of every part applied twice (`shp.moved(shp.location)`) | fixed (parts are copied) | case.py `main` |
| Checks | tests 1 to 7 | tests 1 to 7 as C4 (the pad selector follows the pad diameter), new test 8 (no planar outside face; run once on the C4 shape it finds 10), test 10 (seam gap, lip, dot); test 9 (plan radius, vertical share) is information only | case_check.py |

## Changes from C3 to C4

| Topic | C3 | C4 | Source |
|---|---|---|---|
| Look | printed box with hinge, 13.0 mm lid and latch tab | rounded pebble, flat 4.0 mm lid that swivels open on a corner pin, rides on four 0.4 mm glides (constant shadow gap), two magnets as detent | owner 21:59 and 22:40, `design/architecture.md` 17.12, case.py |
| Ring pads | four pads on the OUTSIDE of the band at 150 degrees, pitch 1.6 mm | four pads on the INSIDE face of the band opposite the block, in a row around the band; arc pitch at the inner radius is a parameter, default 2.0 mm, pad diameter 1.0 mm, row 1.0 mm from the band middle toward the light end | `design/architecture.md` 17.12, case.py PAD_PITCH |
| Seating | ring rolled 30 degrees on two flanks of a V seat, block rests in a pocket, pins vertical under the pads | ring stands with its band axis vertical, band bottom on the floor around a centre post, block hangs in a pocket beside the post; the band is clamped between the pins (inside) and two flat flanks at +-20 degrees of a V wall (outside), so the band's 2.6 mm thickness, not the ring size, fixes the pad place | case.py, out/case_params.json |
| One post for US 7 to 13 | one V seat, pad moves 0.157 mm | the same V wall; the bore centre moves 2.59 mm (x 11.98 to 14.58) and the pad faces move 0.14 mm in height between sizes; stepped PCB2 islands and the pins' travel take it up: heights 1.980 to 2.150 mm, spread 0.170 mm, stroke needed 0.370 mm (section 7) (REPLACED 2026-11-13 (was heights 2.277 to 2.421 mm, spread 0.144 mm, stroke needed 0.34 mm: the C5c figures)) | out/case_params.json lines 118 to 121 (pin_travel) |
| One orientation | pocket walls and the joystick nub wall A | the pocket (block outline over all sizes plus 0.15 mm each side) blocks a ring turned 180 degrees or across; a ring flipped over is NOT blocked at every size, but no pin reaches a pad on it (section 7, conflict K3 in case-notes.md) | case_check.py |
| Hold-down | two spring plungers in the lid, M5, S7 spring | none: the pins push the band onto the V wall with 4 x 0.39 N; the lid does not touch the ring (0.7 mm clear) | section 7 |
| Pins | CONFLICT K1: Harwin P70-6000045R proposed for 1.6 mm pitch | the fitted pin is the Harwin P70-6000045R (the Mill-Max 0981 does not fit the pin holder's 1.60 mm bores); the pitch is now a parameter; since C5d-r4 the working range is the maker's 1.90 to 2.20 mm (design/case/pin-travel.md; design/datasheets/the Harwin drawing of P70-6000045R sheet 2 (w15_harwin_drawing_*.pdf), w15_harwin_component_spec_C056, w15_harwin_graph_CPPOGO.txt row P70-6000045R), which closes the stroke question | case-notes.md K1 |
| Outer size | 44.0 x 37.6 x 58.0 mm | 43.2 x 44.0 x 40.6 mm (out/case_size.txt); the concept was 46.0 x 46.0 x 37.7 mm without cell, board, socket and light | case.py |
| Pin board | PCB2 10.0 x 16.4 x 0.8 plus printed holder | PCB2 is a rigid-flex of three 0.8 mm islands (3.9 + 2 x 2.85 wide, 5.0 high) in the post's pin lug, the outer two recessed; the pin holder is gone | case.py |
| Main board | PCB1 stands in the YZ plane in a side compartment | PCB1 23.0 x 35.4 x 1.0 lies flat above the cell under the ring floor; J1 and the light open through the -X wall | case.py |
| Ring presence E1 | on PCB2, 2.1 mm below the band's lowest point | on PCB2's front face between the pins, 2.04 to 2.20 mm from the band's inner face on the strip's centre line (1.87 to 1.98 mm at the strip's side edges), US 13 to US 7; does not depend on the ring block's height (REPLACED 2026-11-13 (was 2.28 to 2.42 mm "(pin heights)", the old C5d range)): bench B3 repeats | design/wiring/g9-g11-work/e1_gap.py and e1_gap.log (x_b, cx, ri of out/case_params.json) |

Electrical sections 1 to 6 are unchanged except the pad coordinates and the pin remark below.

C2 changes against C1 (2026-11-10, after the case schematic `design/ecad/case/sch-notes.md`): 464.4 MB per recorded hour (4-microphone ring figure with block headers), so 6.37 min (C3 replaces both: 232.2 MB and 3.18 min, section 1); TPS2553 pin numbers EN 3, FAULT 4, GND 2; LED1 common anode on 3V3, cathodes driven low; U2 DSEL 10 kΩ pull-up (R28); CHG_OTG 100 kΩ pull-down (R27); SD_D2 and SD_D3 10 kΩ pull-ups (R29, R30); USB-C D+/D- no longer reach U2 (blocks the 9 V / 12 V adapter handshake); TPS63802 divider 511 kΩ / 91 kΩ (3.308 V); L1 1 µH settled; fifth pin-board wire W7 for E1; strapping pins left open per the series datasheet. The ring now records only after a long press (no listening mode): no change for the case.

Built against `design/architecture.md` version A5-draft and `requirements.md` section 2.7.
The mechanics (shell, post, pins, lid) are those of C4 for the thin ring with its pads on the inside; the electronics were first designed against A1 and are unchanged, because the link to the ring is still four contacts carrying USB full speed and 5 V.
Evidence tags: **DS** = read in the maker's document (file in `design/datasheets/`, text copies in `design/case/evidence/txt/`); **LIST** = listing, search text, a standard not read here, or my assumption; **CALC** = arithmetic in `design/case/evidence/calc_case.py`, output `design/case/evidence/calc_case.log`.

Axes (C4): X from the V wall toward the block pocket, Y across, Z up, bottom of the case at Z = 0. The ring stands with its band axis along Z; the block points to +X; the light end of the ring is up. The ring-file frame (X band axis, Z toward the block) is turned by `Rot(0, 90, 0)`.

## 1. Central choice: USB host plus Wi-Fi in one part

| Candidate | USB host | Wi-Fi | Fact that decides | Verdict |
|---|---|---|---|---|
| Espressif ESP32-S3-MINI-1-N8 (module) | "USB 2.0 OTG Full-Speed Interface", "FS and LS data rates", host mode with 8 channels, Bulk supported [DS case_esp32s3_ds.pdf p.55-56] | 802.11b/g/n, "802.11n up to 150 Mbps" [DS case_esp32s3_mini1.pdf p.1] | One module, 15.4 x 20.5 x 2.4 mm [DS mini1 Table 1-1]; SD/MMC host, 4-bit, up to 80 MHz [DS esp32s3_ds p.57]; 3.0 to 3.6 V supply, 0.5 A [DS mini1 Table 6-2] | **Chosen** |
| Espressif ESP32-S3-WROOM-1 | same chip, full speed only | yes | Larger module (not read: LIST); no gain over MINI-1 | rejected, size |
| Espressif ESP32-P4 + ESP32-C6 module | "USB 2.0 High-Speed OTG" [DS case_esp32p4_ds.pdf p.4] | **none in the chip**: "Wi-Fi" appears only in the trademark notice of the 10,450-line text [DS, evidence/read_p4.log] | Needs a second chip for Wi-Fi, QFN104 10 x 10 mm [DS p4 p.1], external flash; saves 2.50 min per recorded hour only | rejected (see notes) |

**Transfer time, stated plainly [CALC, evidence/calc_case.log]:**
- One recorded hour: 16,000 x 2 bytes x 2 channels x 3,600 s = 230.4 MB of audio (the ring has 2 microphones, `design/architecture.md` 16.6). The 464.4 MB behind the C2 figure 6.37 min was the old 4-microphone figure (460.8 MB plus 0.78 % block headers: 464.4 / 460.8 = 1.0078). Stored bytes (r4, following `design/firmware.md` line 718): 3,600 s / 0.512 s = 7,031.25 chunks x 33,280 bytes = **234.0 MB per recorded hour** [CALC] (C3 had 232.2 MB from the old header ratio).
- At the full-speed line rate of 12 Mbit/s (1.500 MB/s): 234.0 / 1.500 = 156.0 s = **2.60 min**. This is a bound the bus never reaches.
- Full-speed bulk ceiling: 19 packets x 64 bytes per 1 ms frame = 1.216 MB/s (USB 2.0 figure, LIST). 234.0 / 1.216 = 192.4 s = **3.21 min per recorded hour. This is the planning figure for the chosen part** (`design/firmware.md` line 718). A 10-hour day: 32.1 min. A full 4 GB card (16.9 hours, `design/firmware.md` line 718): 54.2 min. The ring's cell limits recording to 4.3 to 7.8 hours by ring size (`requirements.md` row P2): 4.3 x 3.21 = 13.8 to 7.8 x 3.21 = 25.0 min.
- High speed through ESP32-P4: the ring's storage read over SPI (2 MB/s, architecture.md section 8) is the limit: 234.0 / 2.0 = 117.0 s = 1.95 min per recorded hour. The gain is 1.26 min per recorded hour.
- A ring charge at 1 C (the charge current is open item S12) takes about 60 min of constant current. In the 60 minutes a ring charge takes, the case copies 18.7 recorded hours (60 / 3.21), more than the ring can hold; the 4.3 to 7.8 recorded hours of one battery are copied in 13.8 to 25.0 min.
- Condition: the ring's nRF54LM20A must run its high-speed USB device at full speed when the host does not answer the high-speed handshake. USB 2.0 requires this of every high-speed device (LIST). Nordic's USBHS page was not readable (`design/parts/mcu.md` line 71). Bench item B1.

## 2. Block diagram

```
 USB-C (J1) --VBUS 5 V--> [BQ25895 U2  charger + power path + boost] --BAT--> [cell 700 mAh with PCM, BT1]
   |  CC1, CC2: 5.1 k to GND (R1, R2), sensed by U1 ADC          |  SYS 3.0-4.4 V
   |  D+, D-  : not connected (U2 D+/D- open: no 9/12 V handshake) +--> [TPS63802 U3 buck-boost] --3V3--> U1, U4 (LED1 anode: SYS)
   |                                                              |
   |                             PMID 5.0 V (USB in) / 4.998 V (boost) --> [TPS2553 U5 switch, 401 mA limit] --VRING-->
   |                                                                                                           |
 [ESP32-S3-MINI-1-N8 U1] --USB host D+/D- (IO20/IO19)--> [TPD4E05U06 U6 ESD] -------------------------------+  |
   |-- SD 4-bit --> [ZDSD64GLQEAG-R U4, 8 GB buffer]                                                          v  v
   |-- I2C, INT, OTG, CE --> U2                                         4 spring pins P1-P4 (Harwin P70-6000045R, 1.90-2.20 mm) on pin board
   |-- EN, FAULT --> U5 ; VRING sense (divider)                            P1 VBUS  P2 D-  P3 D+  P4 GND
   |-- TOUCH4 --> copper electrode under the seat (ring presence)               |
   |-- 3 GPIO, active low --> RGB LED1 (common anode on SYS)                      ring pads (C4: on the inside of the band, in a row around it)
   +-- Wi-Fi 2.4 GHz (module antenna) --> upload
```

## 3. Fixed parts, one per function

| Ref | Function | Maker, part number | Key facts | Tag |
|---|---|---|---|---|
| U1 | Main chip: USB host, Wi-Fi, SD host, touch input | Espressif ESP32-S3-MINI-1-N8 | 8 MB flash, no PSRAM, 15.4 x 20.5 x 2.4 mm [Table 1-1]; 3.0-3.6 V [Table 6-2]; Wi-Fi TX peak 355 mA at 802.11b 20.5 dBm, RX 95 mA [Table 6-4]; Deep-sleep with ULP sensor-monitored pattern 18 µA typ [Table 6-7 p.30] | DS |
| U2 | Case cell charger, power path, 5 V boost, battery voltage ADC | TI BQ25895RTWR (BQ25895, RTW WQFN-24 4 x 4 mm) | Input 3.9-14 V; boost 4.55-5.51 V in 64 mV steps, default 5.126 V, up to 3.1 A; boost output on PMID; boost needs "no input source detected at VBUS"; ADC battery range 2.304-4.848 V, 20 mV steps; ILIM pin; inductor 1 µH (text of section 9.2.2: "To get good loop stability, 1-µH and minimum of 20-µF output capacitor is recommended"; the 2.2 µH label in the figure text is not used) [DS case_bq25895.pdf p.1, Table 6-1, p.10-11, section 9.2.2] | DS (order suffix RTWR: LIST) |
| U3 | 3.3 V rail from SYS | TI TPS63802DLAR | Buck-boost, input 1.3-5.5 V, 2 A at VO 3.3 V, 11 µA IQ, VFB 0.5 V, R2 at most 100 k [DS case_tps63802.pdf p.1, p.19] | DS |
| U4 | Recording buffer, 8 GB | Zetta ZDSD64GLQEAG-R | 64 Gb, LGA8x2 9 x 10 mm, SD3.0, 1/4-bit, speed class 10 supported, 3.3 V [DS sdnand_zetta_family_atta.pdf p.3] | DS |
| U5 | Ring VBUS switch with current limit | TI TPS2553DBVR | SOT-23-6, EN active high, 2.5-6.5 V, 85 mΩ, adjustable 75-1700 mA, reverse-voltage protection, FAULT open drain; IOSmin = 25230 / RILIM^1.016 [DS case_tps2553.pdf p.1, Figure 5-1, section 9.2.1.2] | DS (DBVR suffix: LIST) |
| U6 | ESD on the exposed pins D+, D-, VBUS | TI TPD4E05U06DQAR | 4 channels, 0.42-0.5 pF, IEC 61000-4-2 ±12 kV contact, breakdown 6.5 V min, USON-10 [DS case_tpd4e05u06.pdf p.1] | DS |
| BT1 | Case cell | DNK Power DNK852338 (LP852338) | 700 mAh, 3.7 V, 2.59 Wh, charge 4.2 V, max charge 0.5C, PCM over-charge 4.275 V, over-discharge 2.5 V, 40.0 x 23 x 8.5 mm with PCM, 11.7 g [DS case_cell_dnk852338.pdf] | DS |
| J1 | USB-C receptacle | GCT USB4105-GF-A | 8.94 x 7.35 x 3.31 mm top mount, VBUS 5 A, 20,000 cycles, CC1 A5, CC2 B5 [DS case_usb4105.pdf drawing rev B4] | DS |
| P1-P4 | Spring pins | Harwin P70-6000045R (the fitted pin on all four positions; the Mill-Max 0981 does not fit the pin holder and is history only, case-bom.csv reference PA1-PA4 quantity 0) | maker's drawing: flange 1.50 x 0.40 mm at the board, body 1.06 mm to 1.85 mm, plunger 0.60 mm, free height 2.80 mm; working height 1.90 (most compressed) to 2.20 (least), normal 2.10, 0.39 +-0.09 N at 2.10, 1 A, 30 milliohm, 10,000 cycles; the force at our 1.98 to 2.15 mm is not confirmed by a measurement | DS (design/case/pin-travel.md; design/datasheets/the Harwin drawing of P70-6000045R sheet 2 (w15_harwin_drawing_*.pdf), w15_harwin_component_spec_C056, w15_harwin_graph_CPPOGO.txt row P70-6000045R) |
| LED1 | One light, RGB, common anode (pin 1), cathodes red 2, green 3, blue 4 (package drawing p.1, read by the schematic helper) | Kingbright APTF1616SEEZGQBDC | 1.6 x 1.6 x 0.7 mm; VF at 20 mA: red 2.0 typ, green 3.3 typ, blue 3.3 typ [DS case_kb_aptf1616.pdf p.1-2] | DS |
| E1 | Ring presence | copper electrode on the pin board: front strip 3.9 x 1.15 mm plus a 4.1 x 4.6 mm back pour of the same net (18.9 mm2, design/ecad/case/pcb/board-notes.md conflict 7), fifth wire W7 to U1 TOUCH4 (IO4) | no extra part; confirmed by USB attach | CALC / bench B3 |
| R1, R2 | CC pull-downs | 5.1 kΩ 1 % 0402 | USB-C sink | LIST |
| H1 | Lid hold | corner pivot (3.0 mm steel pin), four 0.4 mm glides and two magnets (C4); the pins push the band onto the V wall | | LIST |

The full list with passives: `case-bom.csv`.

## 4. Power tree [values from section 3 rows; CALC lines from calc_case.log]

| Rail | Source | Voltage | Load |
|---|---|---|---|
| VBUS_IN | USB-C J1 | 5.0 V (USB) | U2 VBUS, input limit 500 mA by register (USB default), 1.5 A when CC shows a 1.5 A source |
| BAT | BT1 | 2.5 (PCM cut) / 3.0 (firmware stop) to 4.2 V | U2 BAT |
| SYS | U2 | 3.0-4.4 V on battery (BAT minus BATFET); with USB in, held above the minimum system voltage, default 3.5 V [DS section 8] | U3, VRING divider |
| PMID | U2 | 5.0 V from USB when plugged; 4.998 V boost (BOOSTV code 7 = 4.55 + 0.064 x 7) when on battery | U5 IN |
| VRING | U5 OUT | same as PMID minus 85 mΩ x I; limit 401 mA min (RILIM 59.0 kΩ) | pin P1 to ring VBUS |
| 3V3 | U3 | 3.308 V (R3 511 kΩ top, R4 91 kΩ bottom: 0.5 x (1 + 511/91), the 3.3 V row of TI Table 10-5) | U1 (355 mA peak), U4, pull-ups (LED1's anode is on SYS: design/ecad/case/sch-notes.md section 9) |
| REGN | U2 internal | for TS divider (RT1 5.23 k, RT2 30.1 k (E96 nearest to the computed 5.21 k and 29.87 k; TI Figure 9-1 values), 103AT NTC) [DS section 8] | |

Ring charge: the case supplies at least 401 mA at 4.998 V, about 2.0 W. The ring's charger draws 15 mA x 4.35 V = 0.065 W (a cell of 17.6 to 31.9 mAh by ring size, `design/architecture.md` 17.26; 4.35 V: A5-draft 17.10 and S12); the charge current is open item S12 (CHARGE_CURRENT = 15 mA, 1 C of the smallest cell, from `design/architecture.md` 17.13 line 567; the nPM1304 sets 4 to 100 mA, so the 32 mA minimum of the old nPM1300 no longer applies). The case does not set the ring's charge time; the ring's charger setting does (ring side).

Cell sizing [CALC], at 1 C; the charge current is open item S12: one ring charge takes 0.068 to 0.123 Wh in the ring cell (17.6 to 31.9 mAh by ring size, `design/architecture.md` 17.26, x 3.85 V, nominal voltage: LIST). The ring's charger is linear: 3.85 / 4.998 = 0.770. Boost efficiency taken as 0.85 at light load (datasheet gives 93 % at 1 A). Case energy per ring charge = 0.0678 / 0.770 / 0.85 = 0.104 Wh (US 7) to 0.1228 / 0.770 / 0.85 = 0.188 Wh (US 13); 3 charges = 0.311 to 0.563 Wh. Minimum cell for 3 charges: 84 to 152 mAh (0.311 Wh / 3.7 V; 0.563 / 3.7). Chosen 700 mAh: 13.8 charges at the least (2.59 Wh / 0.188 Wh, US 13) and 25.0 at the most (2.59 / 0.104, US 7), 13.8 to 25.0 ring charges (C2 with the old 135 mAh ring cell: 3.26). The C3 ring needs far less than the chosen cell; the cell stays at 700 mAh because the brief keeps it (electrical choice, not changed here).

Cell current: on battery the case keeps Wi-Fi off while VRING is on (boost plus ring is about 0.35 A from the cell; Wi-Fi peak adds about 0.38 A; the cell allows 1C = 700 mA continuous).

## 5. Sequence, step by step

1. Ring set into the pocket and around the post, lid closed: the two magnets hold the lid; the band's bottom rests on the floor and its outside on the two flanks of the V wall; each pin stands at 1.98 to 2.15 mm (28 values over 4 pins and 7 sizes, design/wiring/ring-case-contact.csv) (Harwin P70-6000045R, working height 2.10 mm).
2. U1 sleeps in Deep-sleep with the touch channel IO4 monitored. The ring's metal band over electrode E1 (on PCB2's front face, 2.04 to 2.20 mm from the band's inner face on the strip's centre line, design/wiring/g9-g11-work/e1_gap.log; REPLACED 2026-11-13 (was 2.28 to 2.42 mm): bench B3) raises the touch reading above the stored empty value: U1 wakes.
3. U1 reads the USB-C state from CC1/CC2 (ADC). No source: U1 sets the OTG pin high and the OTG_CONFIG bit to 1 [DS bq25895 section 8, "OTG pin HIGH and OTG_CONFIG bit =1"], BOOSTV code 7; with a source: no boost, PMID follows USB VBUS.
4. U1 sets U5 EN high: VRING rises at P1. U1 watches VRING sense (IO5) and FAULT (IO16). FAULT low or VRING below 4.5 V after 50 ms: EN low, light red blink (short or wrong object).
5. Ring's charger starts on VBUS. The ring's USB device pulls D+ up: U1, as USB host, sees the attach and enumerates (full speed). No attach within 3 s: EN low, light amber blink 3 times ("turn the ring over": a ring flipped over is not blocked by the pocket at every size), back to sleep.
6. U1 asks the ring for its file list and copies new recordings to U4 (SD 4-bit). Light: blue breathing. Speed 1.216 MB/s at most: 3.21 min per recorded hour.
7. After each file: U1 checks the file length and checksum against the ring's list, then tells the ring the file is safe; the ring may delete it.
8. Charging continues while VRING is on. The ring reports its charge state over USB. At full: EN low, OTG off. Light: green steady 10 s, then off.
9. Upload: when Wi-Fi is known and either USB-C is plugged or the ring charge is done, U1 uploads files from U4 over Wi-Fi, then deletes them from U4 after the server confirms. Light: blue slow blink.
10. Case charging: USB-C plugged: BQ25895 charges BT1 at 350 mA (0.5C), input limit from the CC reading. Light: amber steady while charging the case only.
11. Case low (BATV below 3.40 V): no boost, red blink every 5 s while the ring sits in the case.
12. Lid swung open and ring lifted: touch reading falls, USB detach: EN low, OTG off, U1 back to Deep-sleep.

## 6. Pin plan of U1 (ESP32-S3-MINI-1-N8, pin numbers from Table 3-1 [DS p.11-12])

| Module pin | Name | Net | Notes |
|---|---|---|---|
| 1, 2, 42, 43, 46-65 | GND | GND | |
| 3 | 3V3 | 3V3 | 10 µF + 0.1 µF at the pin |
| 4 | IO0 | BOOT test pad | strapping pin, 10 kΩ to 3V3, pad to GND for download |
| 5 | IO1 | CC1_SENSE | ADC1_CH0, 100 kΩ series from J1 A5 |
| 6 | IO2 | CC2_SENSE | ADC1_CH1, 100 kΩ series from J1 B5 |
| 7 | IO3 | not connected | strapping pin for the JTAG source, floating by default; used only when EFUSE_STRAP_JTAG_SEL is burnt (default 0) [DS esp32s3_ds section 3, Table 3-1 p.32]: left open; the production never burns EFUSE_STRAP_JTAG_SEL or EFUSE_VDD_SPI_FORCE (IO3 and IO45 stay open only while both are 0) |
| 8 | IO4 | RING_TOUCH | TOUCH4, to electrode E1 on the pin board |
| 9 | IO5 | VRING_SENSE | ADC1_CH4, divider 100 kΩ / 47 kΩ from VRING (5.0 V -> 1.60 V); the case software drives VRING_EN low when VRING_SENSE reads above 1.759 V (VRING above 5.5 V, the ring's U9 stand-off) and logs it |
| 10 | IO6 | CHG_OTG | to U2 OTG (pin 8), R27 100 kΩ to GND: OTG_CONFIG resets to 1 ("OTG Enable (default)" [DS bq25895 REG03 bit 5]), so a floating OTG pin could start the boost before U1 runs |
| 11 | IO7 | CHG_INT_N | from U2 INT (pin 7), 10 kΩ to 3V3 |
| 12 | IO8 | I2C_SDA | to U2 SDA (pin 6), 10 kΩ to 3V3 |
| 13 | IO9 | SD_D3 | U4, R30 10 kΩ to 3V3 (Zetta: RDAT pull-up 10-100 kΩ) |
| 14 | IO10 | SD_D2 | U4, R29 10 kΩ to 3V3 (Zetta: RDAT pull-up 10-100 kΩ) |
| 15 | IO11 | SD_CMD | U4, 10 kΩ to 3V3 |
| 16 | IO12 | SD_CLK | U4, 22 Ω series |
| 17 | IO13 | SD_D0 | U4, 10 kΩ to 3V3 |
| 18 | IO14 | SD_D1 | U4, 10 kΩ to 3V3 |
| 19 | IO15 | VRING_EN | to U5 EN (pin 3, TPS2553 SOT-23 [DS Table 5-1]), R25 100 kΩ to GND |
| 20 | IO16 | VRING_FAULT_N | from U5 FAULT (pin 4 [DS Table 5-1]), R17 10 kΩ to 3V3 |
| 21 | IO17 | I2C_SCL | to U2 SCL (pin 5), 10 kΩ to 3V3 |
| 22 | IO18 | CHG_CE_N | to U2 CE (pin 9), R21 10 kΩ to 3V3: charging off at power-on until the software has set the charger (design/ecad/case/sch-notes.md section 9) |
| 23 | IO19 | USB_D- | USB_D- of the internal PHY, through U6 to P2 |
| 24 | IO20 | USB_D+ | USB_D+ of the internal PHY, through U6 to P3 |
| 25 | IO21 | LED_R | R8 510 Ω to LED1 red cathode (pin 2), anode on SYS; active low |
| 26 | IO26 | not connected | |
| 27 | IO47 | LED_G | R9 270 Ω to LED1 green cathode (pin 3), anode on SYS; active low (bench B4) |
| 30 | IO48 | LED_B | R10 270 Ω to LED1 blue cathode (pin 4), anode on SYS; active low (bench B4) |
| 28, 29, 31-37 | IO33, IO34, IO35, IO36, IO37, IO38, IO39, IO40, IO41 | spare to test pads | |
| 38 | IO42 | spare test pad | |
| 39 | TXD0 | UART test pad | programming and log |
| 40 | RXD0 | UART test pad | |
| 41 | IO45 | not connected | strapping pin for VDD_SPI, weak pull-down, default 0 [DS esp32s3_ds Table 3-1 p.32]: left open, module default kept |
| 44 | IO46 | not connected | strapping pin (boot mode, ROM print), weak pull-down, default 0; with IO0 weak pull-up 1 this gives SPI boot [DS esp32s3_ds Table 3-1 p.32]: left open |
| 45 | EN | EN | 10 kΩ to 3V3, 1 µF to GND, test pad; never floating [DS Table 3-1] |

Other pins: U2 STAT (pin 4) not used (status read over I2C), 10 kΩ to 3V3; U2 DSEL (pin 24) R28 10 kΩ to 3V3 (Table 6-1: "Connect the DSEL to a logic rail via 10-KΩ resistor"), not read by U1; U2 QON (pin 12) to a test pad; U2 D+/D- (pins 2, 3) not connected, and J1 A6/B6/A7/B7 not connected: HVDCP_EN and MAXC_EN reset to 1 ("Enable HVDCP handshake (default)", "Enable MaxCharge handshake (default)" [DS bq25895 REG02]) and the handshake asks the adapter "to raise output voltage from 5 V to 9 V / 12 V" [DS section 8.2.3.3.1]; PMID would pass that to U5 (7 V absolute maximum [DS tps2553]) and to the ring. Without D+/D- the charger cannot see a DCP, so no handshake; U1 sets the input limit from the CC reading and also clears HVDCP_EN and MAXC_EN at start. U5 U6 then see at most the USB VBUS, inside the 5.5 V operating maximum of U6 [DS tpd4e05u06 Recommended Operating Conditions]. Whether TI allows D+/D- open: open item S5; U2 ILIM (pin 10): 260 Ω to GND gives 355 / 260 = 1.37 A typ cap [DS KILIM 320-390], register sets the working limit.

Pin order around the band (C5d, from the ring's placement file `design/mech/thin/placement.csv`): P1 VBUS at y = +3.521, P2 D- at +1.197, P3 D+ at -1.197, P4 GND at -3.521 (Y of the case frame, at the US 10 pad places; the joystick is on the -Y side). This replaces the C4 line (P1 VBUS at y = -2.954 ... P4 GND at +2.954, direction along Y by assumption A1, pitch 2.0 mm), which had VBUS on the other side.

## 7. Mechanical layout (built in case.py, checked by case_check.py)

All numbers below come from `out/case_params.json`, `out/case_size.txt` and `look/c5d_check_lead_rerun.log` (last line: "case_check: PASS, 3447 pairs checked, 0 failures, ring sizes US [7, 8, 9, 10, 11, 12, 13]"). C5d: the model and the check use the real exterior file of every size, `design/look/s1/out/ring-merged32h-us7.step` to `-us13.step` (read only); the computed sizes of C4 to C5c (US 9 block on a computed band tube) are no longer used. Numbers in this section written before C5d are the C5b/C5c values; where C5d changed them, the table "Changes from C5c to C5d" and look/c5d_check_final.log hold the current ones.

**Outer size, closed** (out/case_size.txt): 45.4 x 45.9 x 41.4 mm, against 43.2 x 44.0 x 40.6 mm in C4 (+2.2, +1.9, +0.8 mm). Size was the first rule: at most 45.5 x 46.0 x 41.5 mm. look/explore2.py (numpy search, log look/explore2.log) found the smallest-size form whose skin stays 1.15 mm outside the cell, board, pocket, well and socket, with the largest edge radii and the largest plan radius that this allows. What forces the size: the corners of the 40 mm cell (x = -7.68 mm, y = +-20.0 mm, 2.7 mm from the bottom) set the plan corner radius to 5.6 mm and the width to 45.9 mm; the 13.4 mm long socket run (J1 plus its mouth) sets the -X end; the pocket's end (x = 30.2 mm) sets the +X end.

**Form of the skin** (look/pebble.py, parameters in out/case_params.json "pebble"). Plan: a superellipse, exponent 6.0 on the -X side and 4.95 on the +X side, blended with cos t, half length 22.44 mm toward -X and 22.95 mm toward +X, half width 22.74 mm; no straight segment, smallest radius of curvature 5.6 mm (test 9, information). Profile: the outline at height z is the plan scaled by rho(z) about its centre: a base crown of 0.44 mm (centre lowest, smooth step), an elliptical bottom edge (7.5 mm horizontal x 3.1 mm vertical), a straight wall from z = 3.5 to 38.4 mm (86 percent of the height is within 5 degrees of vertical: the C5 limit of 40 percent was dropped on the owner's instruction), an elliptical top edge (10.0 mm horizontal x 1.8 mm vertical) and a lid crown of 0.68 mm. Near the poles the plan rounds toward an ellipse so the crowns close without a pinch. The skin is three lofted B-spline solids (plate z 0 to 3.0, shell 3.0 to 37.66, lid 37.96 to 41.4 mm), each with planar end faces that are inner or seam faces; no boolean runs on the skin. Radii the inside allows, as asked: bottom edge 7.5 x 3.1 mm (a larger vertical radius would cut the cell's lower corners), top edge 10.0 x 1.8 mm (the lid thickness above the seam, 3.4 mm at the crown, and a 0.5 mm wall above the seam leave that), plan corners 5.6 mm.

**Smallest height of this concept.** The ring lies flat around the post with its 29.3 mm block standing up (block half length 14.65 mm each side of the band's middle), so the inside is at least 29.3 mm high, plus 0.3 mm to the rim, the 0.3 mm gap and the lid. With the cell UNDER the ring floor (as modelled) the stack under the floor is plate, cell 8.5, board 1.0, socket 3.31, gaps and a 1.8 mm floor: the floor is 15.7 mm above the plate's top; with a 1.5 mm plate and the 3.0 mm lid of C4's flat form the case is 39.4 mm high [CALC from the same stack, flat bottom and flat top], C4 40.6 mm with a 4.0 mm lid; C5b is 41.4 mm because the bottom edge and crown need a 3.0 mm plate and the lid crown 3.4 mm. With the cell BESIDE the ring instead of under it [ESTIMATE, not modelled]: the block hangs 10.6 mm below the band's bottom face into its pocket, so the floor can be as low as 1.5 + 0.4 + 14.65 - 4.0 = 12.5 mm and the case 12.5 + 4.0 + 14.65 + 0.6 + 3.0 = 34.8 mm high (about 35 mm), but the 40 x 23 mm cell then lies beside the 29 mm ring well and the plan grows to about 70 x 46 mm: lower, not smaller. In this concept (ring standing around a post) the case cannot be a flat pebble.

**Ring seat (one post for US 7 to 13).** The ring stands with its band axis vertical and the band's bottom face on the floor (gap to the floor 0.010 to 0.010 mm over the seven sizes). The post (12.0 mm diameter, top 3.5 mm above the band's middle) stands in the bore; its pin lug faces -X, toward the pads. The band's outside rests on two flat flanks (tangent at +-20 degrees from the pad direction, strips 3.3 to 5.8 mm from the centre line) of the V wall, 0.01 mm model gap (measured normal gap 0.010 to 0.011 mm on both flanks at every size). The pins push the band onto the V wall from the inside, so the band is clamped by its own thickness: it is 2.6 mm at every size, therefore the pad row stays at the same place whatever the bore. What changes with the size is the bore centre (x = 11.985 at US 7 to 14.580 at US 13, 2.595 mm, the V wall guides it) and the curvature of the pad row (the outer pads sit further from the post than the inner pads). Post and pin board stay at least 1.083 mm from the ring body at every size.

**How one post serves seven bores: pin travel.** The band is clamped by its own 2.6 mm thickness, so the pad faces of all seven sizes lie within a narrow band of heights; the rest is taken up by the pins' travel. C5d-r4 (maker's range 1.90 to 2.20 mm, design/case/pin-travel.md; design/datasheets/the Harwin drawing of P70-6000045R sheet 2 (w15_harwin_drawing_*.pdf), w15_harwin_component_spec_C056, w15_harwin_graph_CPPOGO.txt row P70-6000045R): pin heights (from the pin base plane to the pad face) of the inner pins P2, P3 run 1.980 (US 13) to 2.118 mm (US 7), centred on 2.05 at US 10 (+-0.08 left to the maker's range); the outer pins P1, P4 run 2.139 to 2.150 mm, centred on 2.15, because their pads sit about 21 degrees round the bore and the band face under them is tilted: the pin body (1.06 mm, maker's drawing) clears the band from 2.10 mm (r4/outer_pin_scan_fine.log), so their tolerance is +-0.05 (2.10 to 2.20). Heights per pin and size: design/wiring/ring-case-contact.csv (written by case_check test 18). PCB2 is three islands: the inner island (P2, P3) and two outer islands (P1, P4) recessed by 0.676 mm. C5d had 2.277 to 2.421 mm in an assumed 2.15 to 2.65 window, above the maker's range, with the body modelled 1.50 x 1.85. Builder's step (also written as step 5 of the numbered case procedure in design/ecad/case/pcb/board-notes.md, "Soldering order"; depth gauge, 0.01 mm digital, ring out, holder staked): measure how far each free plunger tip stands in front of the pin holder's front face along the pin: P2 and P3 1.170 mm, P1 and P4 1.021 mm (r4/pin_gauge.log). Accept within +-0.04 mm (P2, P3) and +-0.03 mm (P1, P4). A tip standing out too little means the island sits too far back (pins too high): put stainless shim behind that island (between island and lug) in steps of 0.025 mm up to the shortfall (shim stock 0.025, 0.05 and 0.10 mm). A tip standing out too much: lap the lug's face for that island on 600-grit paper on a flat plate by the excess, then measure again. All 28 pin heights are inside the range and no pin barrel touches the band at any size (the pins are modelled at their working compression for each size in the collision check). Lateral offset of the pin axis to the pad centre: at most 0.014 mm over all sizes (limit 0.1), because the pin row is set at the pad positions of US 10 and the pad Y moves by 0.014 mm at most across the sizes. Force: 0.39 +-0.09 N at the 2.10 mm normal working height (maker); at 1.98 to 2.15 mm it is not measured.

**Pad pitch (parameter).** The pitch along the arc at the band's inner radius is `PAD_PITCH` in case.py (default 2.4 mm from C5, with 1.6 mm pad discs, `design/architecture.md` 17.15; C4 ran 2.0 mm and 1.0 mm; env `CASE_PAD_PITCH` runs the check at another value). The pin barrel is 1.5 mm, so the pitch cannot go below 1.6 mm. Pitch only changes the recess of the outer islands (0.26 mm at 1.6, 0.40 at 2.0, 0.58 at 2.4: computed from the pad geometry) and the spread (0.148 to 0.138 mm); above 2.4 mm the margin of the outer pins' barrel edge over the pad row at US 7 is gone (needed height 2.27 mm at 2.5 and 2.29 at 2.6, against 2.28 mm available; the pins-only run at 2.6 mm still passes, with no margin), and the outer barrel (at 3.6 mm from the centre line at 2.4 mm pitch, plus 0.75) reaches 4.35 mm of PCB2's 4.9 mm half width (4.95 mm at 2.8 mm pitch: too wide). Range the post allows: 1.6 to 2.4 mm. Proven by pins-only runs (out/work_c4/pitch_check.py: offset, window, pin barrel against the ring body, US 7 to 13) at 1.6, 2.4 and 2.6 mm, all PASS; the full check ran at 2.0 mm only (case-notes.md proof files).

**Keying (one way in).** The pocket for the block is the block's widest outline over all sizes, including its flare into the band, with 0.15 mm each side (width 20.091 mm, wider than the 14.75 mm block proper; a relief to 20.8 mm beside the band); it lies on the +X side of the post. A ring turned 180 degrees (block toward the post) or across hits the shell and the post for US 7, 9 and 13 (case_check.py, wrong placement lines). A ring FLIPPED over (band axis reversed, joystick nub on the other side) is not blocked at every size: the joystick nub is the only asymmetric feature of the ring and a nub on the +Y side stays inside the well that the larger sizes need; case_check.py prints what each size does. In every case no pin reaches a pad of a flipped ring: the pad row sits 1.0 mm from the band's middle, so the flipped row is 2.0 mm from the pins (check line "pin tip to nearest pad"), and the pins touch only the band's inside face. The light then blinks "turn the ring over" (sequence step 5). A ring-side feature (for example a chamfer on one end of the block) would make the pocket block the flip; that is a request to the ring design, conflict K3 in case-notes.md.

**Roll (R1, held since C5d).** The band is a cylinder, so the V wall does not fix the ring's turn about its own axis; the pocket's side walls (a pocket 20.091 mm wide, because it follows the block's flare into the band) are the only stop. The check turns each ring in 0.25 degree steps until it touches the shell (INFO lines of case_check.py, not counted as failures): the pad row then moves at most 0.135 mm (US 11) against 0.50 mm that a 0.6 mm pin tip can take on a 1.6 mm pad before it leaves the pad: OK. Current figures, look/c5d_check_lead_rerun.log: US 7: +0.75 / -0.75 degrees, pad row at most 0.113 mm; US 8: +0.75 / -0.75, 0.119 mm; US 9: +0.75 / -0.75, 0.124 mm; US 10: +0.75 / -0.75, 0.129 mm; US 11: +0.75 / -0.75, 0.135 mm; US 12: +0.50 / -0.50, 0.093 mm; US 13: +0.25 / -0.25, 0.048 mm; limit 0.50 mm (a 0.6 mm pin tip stays on a 1.6 mm pad), every size OK. State before C5d (C5b/C5c, kept as history only): the pad row moved at most 0.680 mm against 0.2 mm on a 1.0 mm pad, and the roll was not held; the real ring files, the 1.6 mm pad and the wider limit changed that. Not proven: the roll with the real moulded tolerances; the check proves the modelled play.

**Lid.** The lid is the whole top of the pebble: its outline is the base's outline, the seam is cut in the straight wall (base rim z = 37.66 mm, lid underside z = 37.96 mm: an even 0.3 mm shadow gap all round, the wall runs 0.5 mm above the seam before the top edge starts), and it is a crowned cap 3.44 mm thick at the crown. It turns on a 3.0 mm steel pin fixed in the lid (x = -7.981, y = -18.746 mm, found by the search over the seam plane in `seam_layout`: at least 0.9 mm plus the pin radius from the outline, at least 2.2 mm of lid above, clear of the well, relief and notch); the pin top is 1.3 mm under the crown, so nothing is proud of the surface, and with the lid open the pin leaves a 3.2 mm blind hole in the rim. It rides on four 0.3 mm PTFE glides fixed to the lid (one a 5.0 mm washer round the pin, three 4.0 mm discs); two 4.0 mm magnets hold it closed (base magnet under a 0.5 mm skin at x = 25.619, y = 17.254 mm; the lid magnet in the lid's underside). It swivels 100 degrees to open: the smallest angle at which the swung lid uncovers the whole well and pocket with 0.3 mm to spare (the pivot sits at the -X, -Y corner; test 4b prints the sweep). Opened, the lid is held by the pin only (friction; bench item B7). The base's rim is 0.3 mm above the block's top, so the lid is 0.600 mm from the ring when closed (test 4a, needs 0.5). There is no hold-down on the ring: the pins and the V wall hold it.

**Finger notches.** Two notches in the rim beside the pocket (3.5 mm each side, 7 mm deep) let a thumb and finger pinch the block's top end to lift the ring out.

**Pin holder (C5d, part `pin_holder`, BOM MECH16).** One moulded part in Celanese Vectra E130i, black (LCP, 30 percent glass fibre). Case frame, mm (out/case_params.json `pin_holder`):
- Envelope: X 3.83 (front, at y = 0) to 9.00 (lip back edge), Y -5.50 to 5.50, Z 19.71 to 27.03. Volume 156.3 mm3.
- Front face: a vertical surface that follows the band's inner face: at each y it stands 0.35 mm (along X) in front of the inner face of whichever size US 7 to 13 comes nearest the post there (US 13 near y = 0, US 7 toward the edges). Smallest true distance to the ring body, measured face by face per size by check test 14: US 7 0.270, US 8 0.327, US 9 0.335, US 10 0.339, US 11 0.339, US 12 0.336, US 13 0.330 (limit 0.2).
- Four bores dia 1.60 mm for the 1.50 mm barrels of P1 to P4, coaxial with the pins (y +3.521, +1.197, -1.197, -3.521; z 23.71), each with a 0.2 x 45 degree lead-in at the face. The barrel tops sit just inside the bores; only the 0.60 mm plungers stand out.
- Front wall 1.67 mm thick at y = 0 (1.6745: out/case_params.json line 652, key pin_holder.wall_in_front_of_E1 = holder front face at y = 0 to the front of the inner island's pocket, case.py line 877; REPLACED 2026-11-13 (was 1.97 mm: the same distance at the old x_b 5.82, before PCB2 moved 0.30 mm toward the post)), in front of PCB2's inner island and its touch electrode E1 (bench B3 now reads E1 through this wall).
- Back: open over the three PCB2 islands (C5d-r4, islands from the board file: inner island pocket 0.84 x 4.54 mm, outer pockets from x 6.38 back, |y| 2.27 to 4.92; a 0.7 mm wire recess behind the five wire pads), so the islands press into the holder from behind; open at the bottom so the five wires drop to the floor slot. Side cheeks |y| 4.92 to 5.50 run back to x 7.18, 0.02 mm in front of the lug's outer face.
- Lip: 0.80 mm thick on the lug top (z 26.23 to 27.03), plan from the front face to x 9.00, back corners rounded 1.0 mm, top outline rounded 0.3 mm, front corners 0.5 mm, bottom front edge 0.3 mm.
- Fixing: two heat stakes (BOM MECH17). The post carries two pegs dia 1.0 mm on the lug top at x 7.95, y +-3.60; they pass through dia 1.10 holes in the lip and are formed by a heated tip into heads dia 1.70 x 0.35 mm inside dia 1.80 x 0.40 mm counterbores, 0.03 mm below the lip top. Order: solder P1 to P4 to PCB2; press PCB2 into the holder from the back (barrels into the bores); lower the pair onto the lug (the islands' backs slide down the lug's front faces); form the two stakes. The pins push the band with 4 x 0.39 N; the reaction pushes PCB2 onto the lug, so the stakes carry no pin load. Holder and PCB2 come off only by cutting the stake heads.
- Model gaps: 0.02 mm to the lug, the islands and the stake heads (so the boolean checks stay clean).

**Band rests (C5d).** The two flat flanks the band rests on (tangent at +-20 degrees from the pad direction, |y| 3.3 to 5.8 mm, part of `liner`) stay: they are the band's seat, and the pins push the band onto them, so one post serves US 7 to 13. They now end 1.0 mm below the band's top (z 18.7 to 25.71 mm, 7.0 mm high, against 18.7 to the rim at 37.66 in C5c), their top edges are rounded 0.8 mm and the two vertical edges of each flank face 0.25 mm; the flank face keeps |y| 3.55 to 5.55 mm for the band. Check test 2b measures the band on both flanks at every size (0.0105 to 0.0111 mm model gap).

**Compartments.** Under the floor: bottom plate (4 screws), the cell 40 x 23 x 8.5 mm lying along Y, PCB1 above it, as routed: 24.85 x 37.90 x 1.0 mm with the socket tab (`case_main.kicad_pcb`), all 59 part bodies on its top face from the board's own STEP (C5d-r4; C5d had reserved boxes), held by the board retainer (section "Changes from C5d to C5d-r4"). J1's mouth is a recessed rounded slot (radius 0.9 mm, 0.6 mm round the socket) with a 0.9 mm lead-in chamfer in the lower half of the -X side (z 13.2 to 16.5 mm); the socket front is 0.3 mm behind the skin at its outermost corner (the skin curves along the 9 mm mouth, so the recess at the middle of the mouth is larger); the charge light is one 1.0 mm dot beside it (y = 6.75 mm) above the light's 1.6 mm LED on the board. Distances to the shell walls are printed by test 5 of case_check.py (needs 0.3 mm each). PCB2 stands in the lug; its five wires (W1 to W4, W7) go down a slot in the floor to PCB1. The satin finish is a 0.6 mm skin that the dimensions already include; there is no separate liner part in C5b.

**Files.** out/case_assembly_US9.step and .glb (case with the US 9 ring seated, one named node per part, ring node `ring_US9`), out/parts/*.step (one STEP per part, including `lid` and `hinge_pivot`, the lid's vertical swivel axis), STL of the printed parts out/case_shell.stl, case_base_plate.stl, case_lid.stl, case_post.stl, case_pin_board_pcb2.stl, case_hinge_pivot.stl; C5d adds out/parts/pin_holder.step and out/case_pin_holder.stl; C5d-r4 adds out/case_board_retainer.stl, out/parts/board_retainer.step, the leads (out/parts/lead_*.step) and the boards as read (out/boards/) (the older out/case_pin_holder.stl of C3 is overwritten). C5d pictures (look/render.py, no browser): look/case-closed.png, look/case-open.png (ring US 9 seated), look/case-open-empty.png, look/case-post-closeup.png and look/case-post-closeup-ring.png (cutaway at x = -4.0 mm, lid left out: the post, the pin holder, the four pin tips and the two rests; the second with the ring seated); the C5c pictures are kept as look/case-closed-c5c.png, case-open-c5c.png, case-open-empty-c5c.png. Pictures (software renderer look/render.py, no browser): look/case-closed.png, look/case-open.png, look/case-open-empty.png, look/case-side.png, look/case-in-hand.png, look/case-compare-c4-c5b.png (C4 and C5b side by side at one scale with a 20 mm bar); the two C4 line drawings stay in out/case-c4-closed.png and out/case-c4-open-ring.png. Look notes: look/look-notes.md.

**Finish and Wi-Fi (conflict K2, proposal to confirm with a maker).** A metal shell would screen the case's Wi-Fi antenna (U1's module antenna sits inside the shell), so the shell and lid are NOT metal. Proposal 1 (the one the pictures show): a moulded polymer body (PC/ABS or PC, 1.2 mm wall) with a physical-vapour-deposited satin metal layer a few tens of nanometres thick under a satin clear coat; at that thickness the layer is discontinuous at 2.4 GHz and does not screen (non-conductive vacuum metallisation, NCVM, is the maker's name for it). Cost in looks: a slightly softer reflection than solid metal and less cold weight; it can chip at the USB-C mouth. Proposal 2: a ceramic-like coating (anodised-look or PVD ceramic) on the polymer; same Wi-Fi result, harder surface, less metallic. Alternative if the owner wants real metal: a satin aluminium shell with a polymer window over the antenna end (the +X side, about 20 x 12 mm), which shows as a visible patch of another material in the pebble: that costs the one-piece look. Not tested here: no sample, no range test; both proposals are [LIST] and are supplier item S7 (section 8).

## 8. Items only a supplier can close

| # | Item | Who | What to ask |
|---|---|---|---|
| S1 | Cell with the leads, connector and PCM side for this layout | DNK Power | DNK852338 with 40 mm flying leads from the PCM end, NTC 10 k 103AT optional, UN38.3 report, 20 samples |
| S2 | Full-speed fallback of the ring chip's high-speed USB | Nordic | confirmation that nRF54LM20A USBHS enumerates at full speed with a full-speed host |
| S3 | Exact package drawing and pad layout of ZDSD64GLQEAG-R | Zetta | LGA8x2 9 x 10 mm drawing and package height |
| S4 | Pin for 1.6 mm pad pitch (conflict K1) | Harwin | closed in C5d-r4 by the maker's documents (working range 1.90 to 2.20 mm, force, life: design/case/pin-travel.md; design/datasheets/the Harwin drawing of P70-6000045R sheet 2 (w15_harwin_drawing_*.pdf), w15_harwin_component_spec_C056, w15_harwin_graph_CPPOGO.txt row P70-6000045R); left: the force curve between 1.90 and 2.20 mm (only the 2.10 value is stated) |
| S5 | Boost efficiency at 0.1-0.3 A, PMID load in charge mode | TI | confirmation that a load on PMID is allowed while charging from VBUS |
| S6 | Production housing | tooling partner | material and process for shell, lid, post and bottom plate |
| S7 | Satin finish that lets the Wi-Fi through | tooling partner | NCVM (non-conductive vacuum metallisation) or a ceramic-like coating on a moulded polymer shell and lid, as in section 7 "Finish and Wi-Fi": a satin metal look that does not screen the 2.4 GHz antenna of U1 (conflict K2 in case-notes.md), with a sample, a gloss and chip test and a Wi-Fi range test; or a metal shell with a polymer window over the antenna, and the cost in looks |
