NexusGPT/openring/design/case/look/case-closed-c5b.png

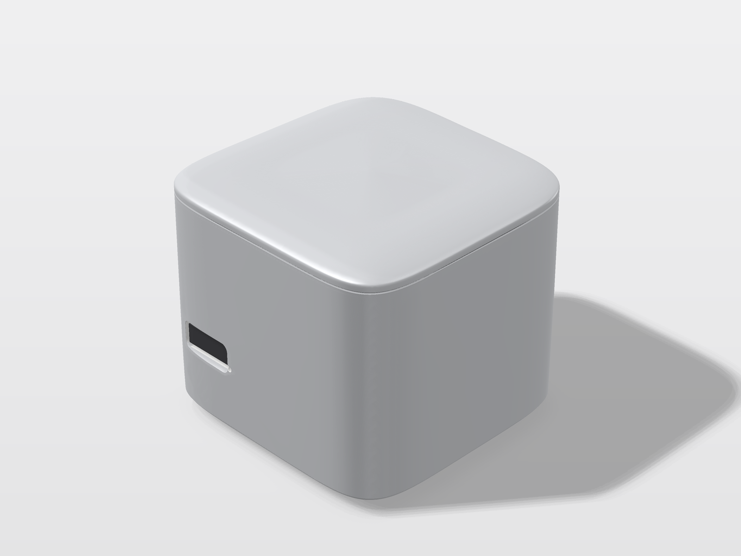
design/case/look/case-closed-c5b.png
