NexusGPT/openring/design/case/look/case-compare-c4-c5b.png

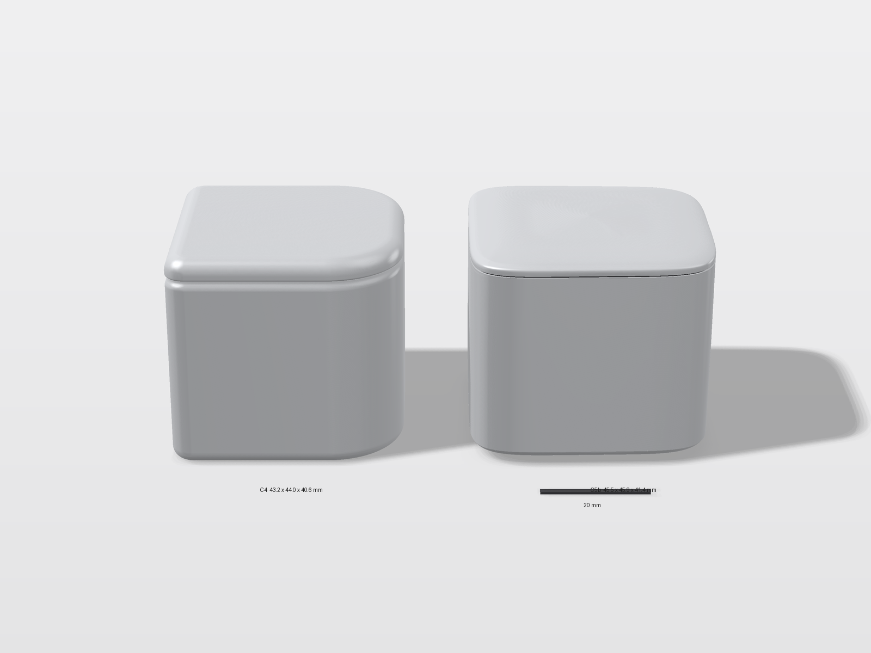
design/case/look/case-compare-c4-c5b.png
