NexusGPT/openring/design/case/look/case-in-hand.png

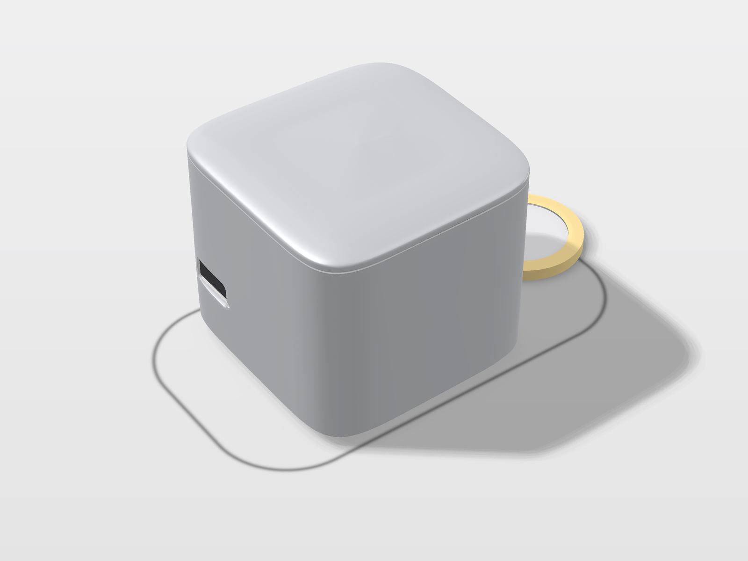
design/case/look/case-in-hand.png
