NexusGPT/openring/design/case/look/case-open-c5b.png

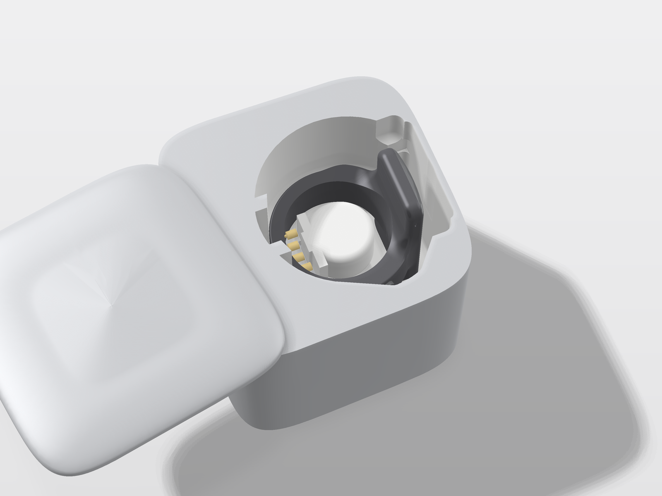
design/case/look/case-open-c5b.png
