NexusGPT/openring/design/case/look/case-post-closeup-ring.png

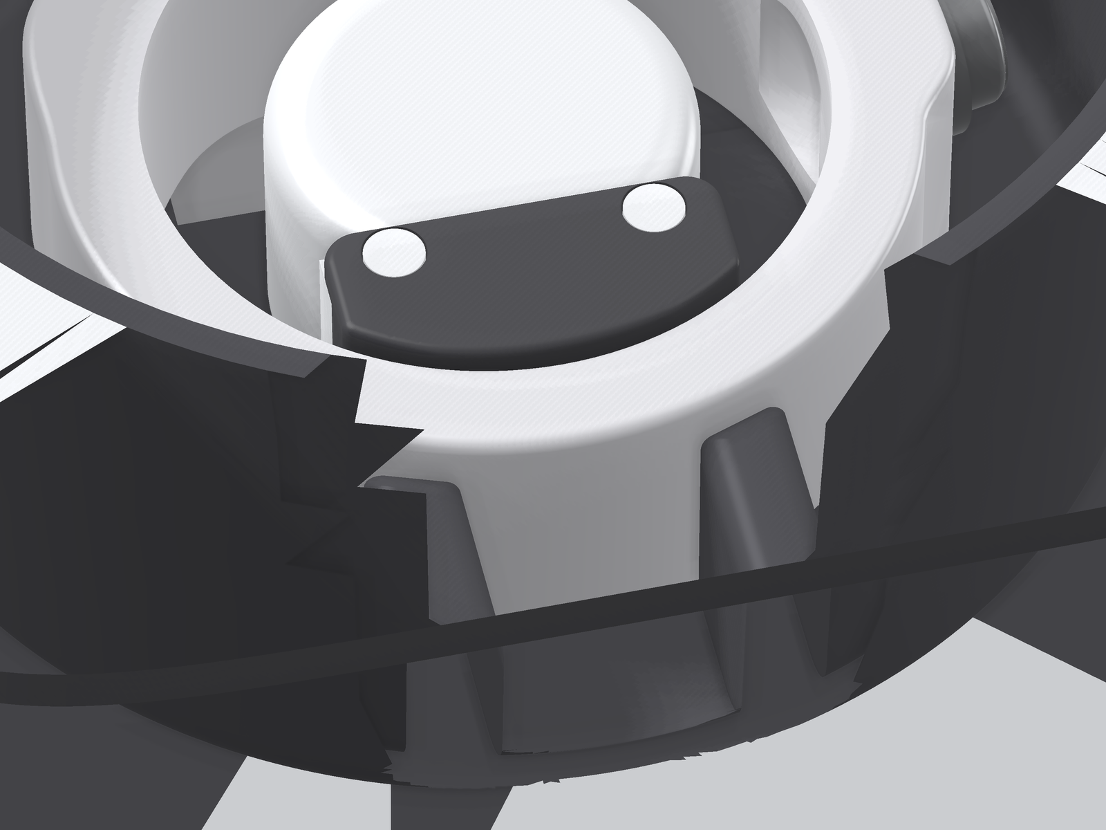
design/case/look/case-post-closeup-ring.png
