NexusGPT/openring/design/case/look/case-post-closeup.png

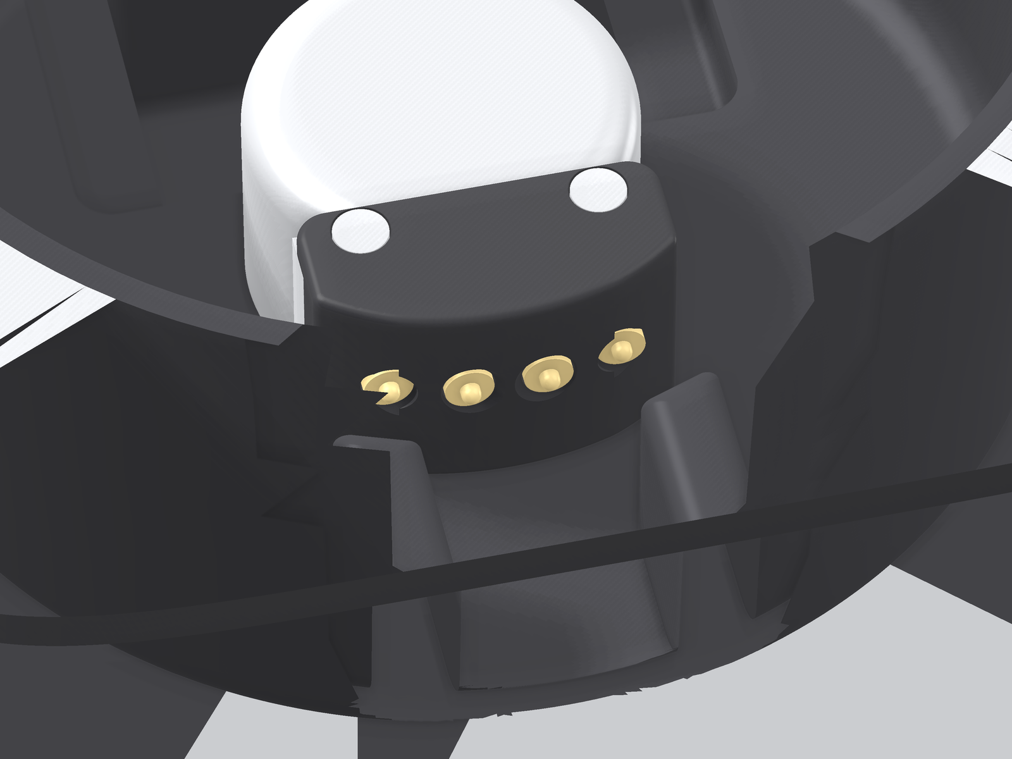
design/case/look/case-post-closeup.png
