NexusGPT/openring/design/case/look/case-side-c5b.png

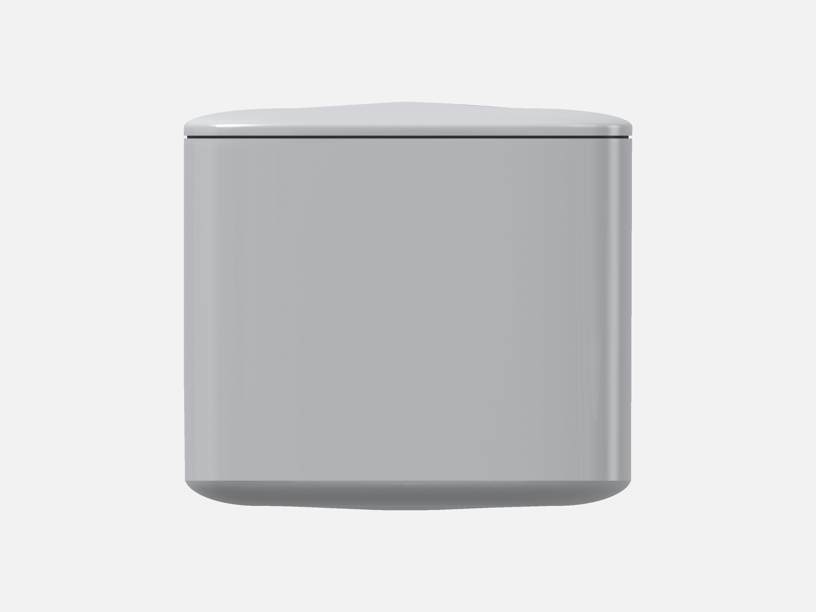
design/case/look/case-side-c5b.png
