NexusGPT/openring/design/case/look/case-underside.png

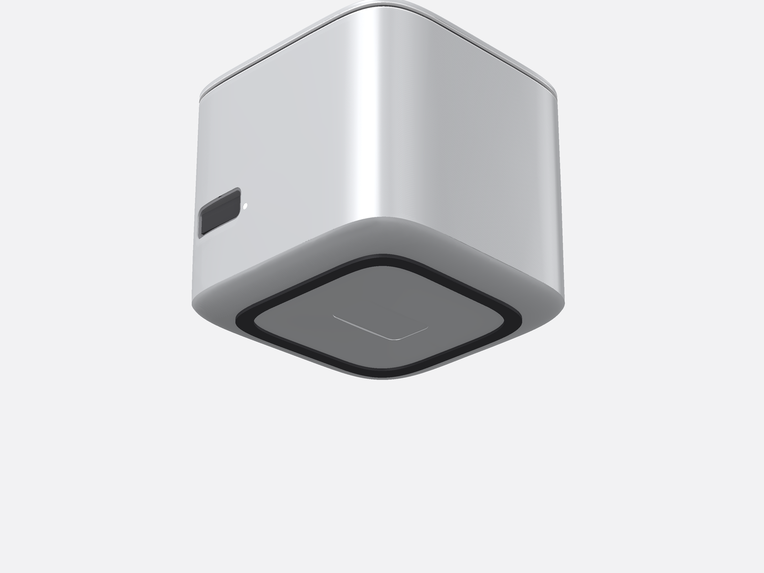
design/case/look/case-underside.png
