NexusGPT/openring/design/case/look/dbg_mat.png

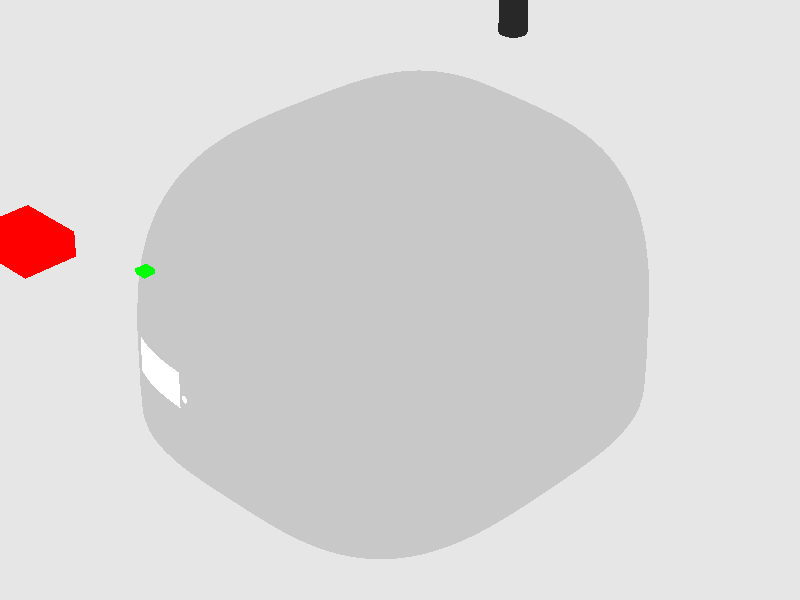
design/case/look/dbg_mat.png
