NexusGPT/openring/design/case/out/case-c4-closed.png

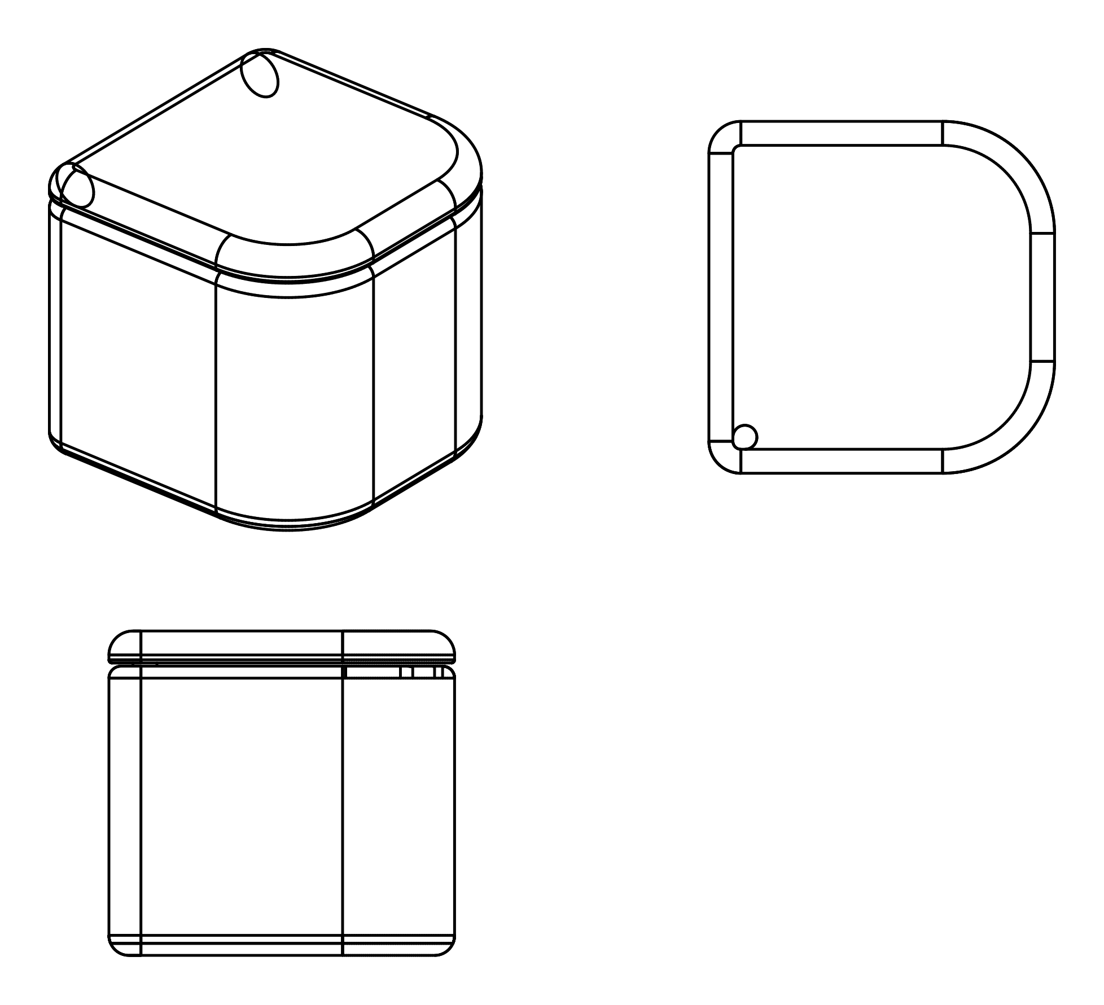
design/case/out/case-c4-closed.png
