NexusGPT/openring/design/case/out/case-c4-open-ring.png

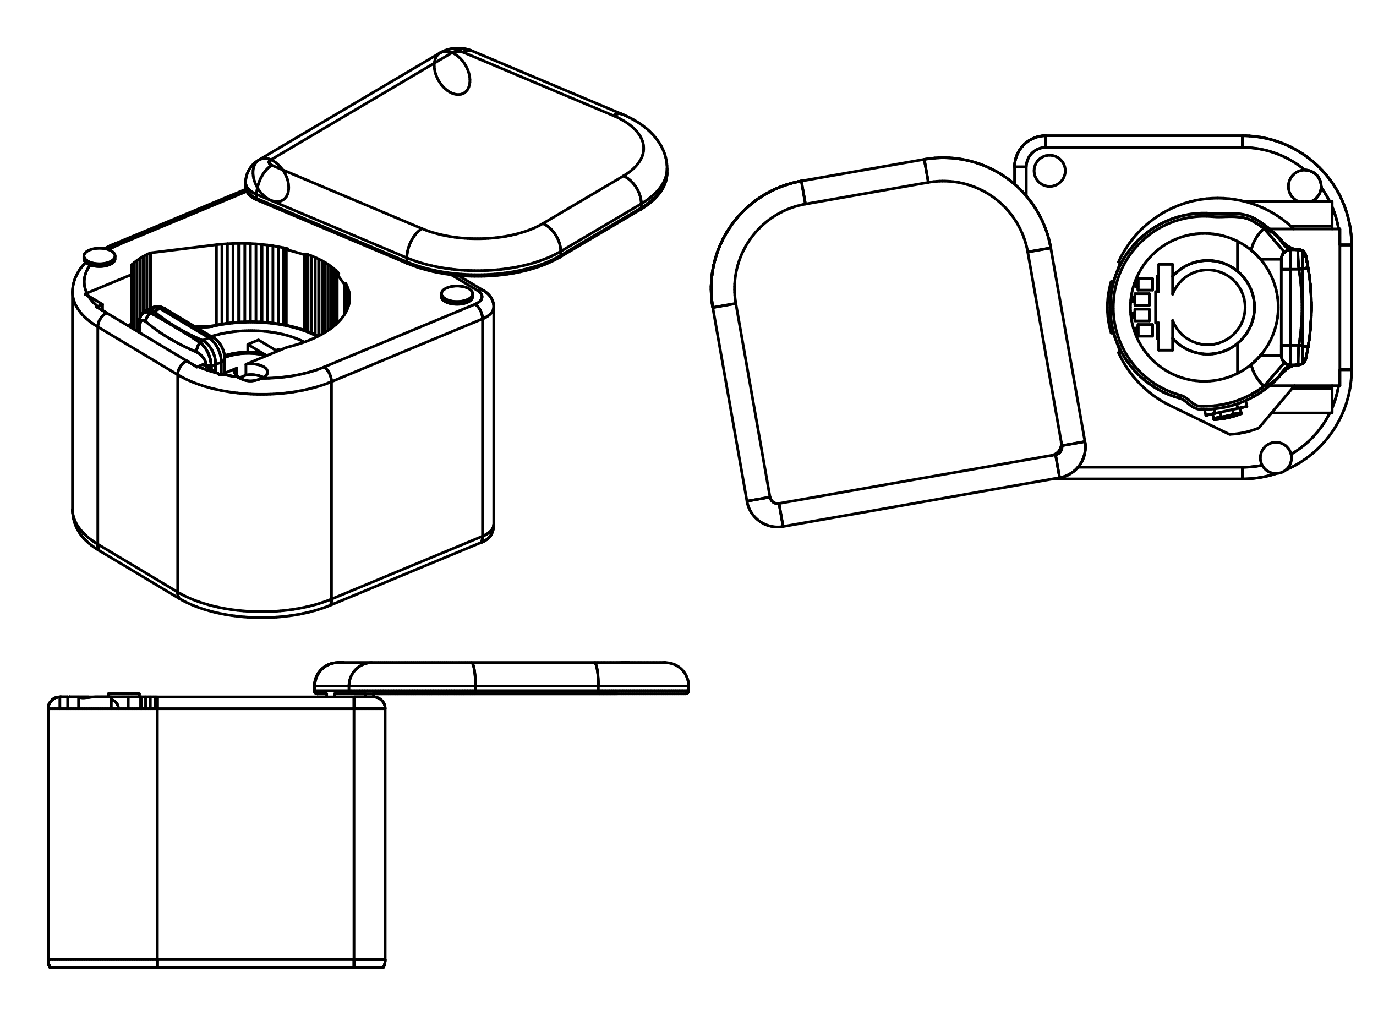
design/case/out/case-c4-open-ring.png
