NexusGPT/openring/design/ecad/band/band-paste-work/after3-f1us9-1.png

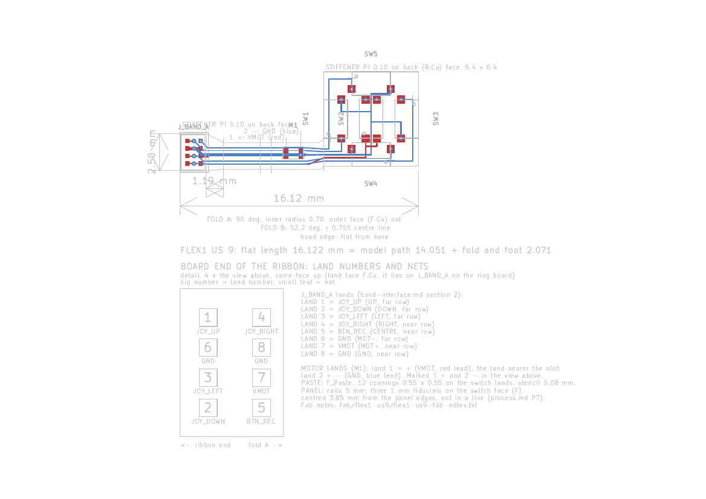
design/ecad/band/band-paste-work/after3-f1us9-1.png
