NexusGPT/openring/design/ecad/band/band-paste-work/after3-f2us9-1.png

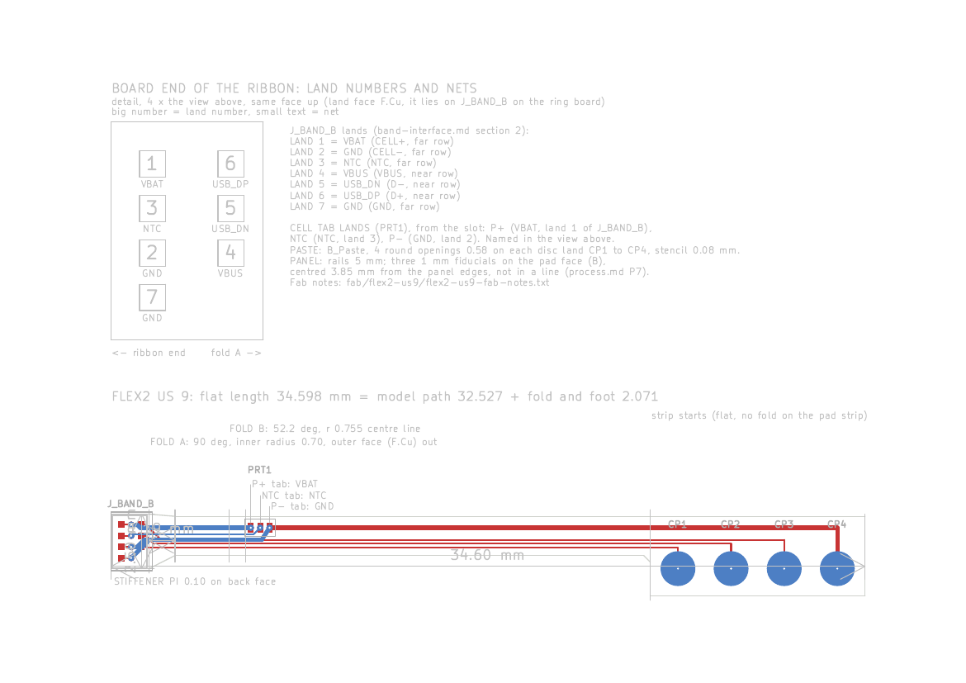
design/ecad/band/band-paste-work/after3-f2us9-1.png
