NexusGPT/openring/design/ecad/band/band-paste-work/before-f1us9-1.png

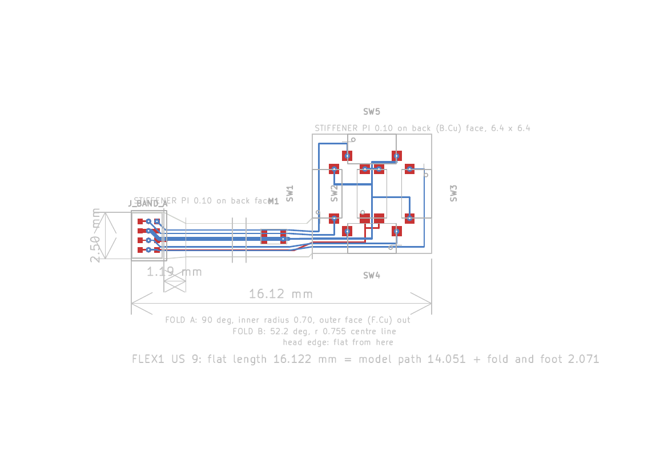
design/ecad/band/band-paste-work/before-f1us9-1.png
