NexusGPT/openring/design/ecad/band/evidence/view/f2-13-1.png

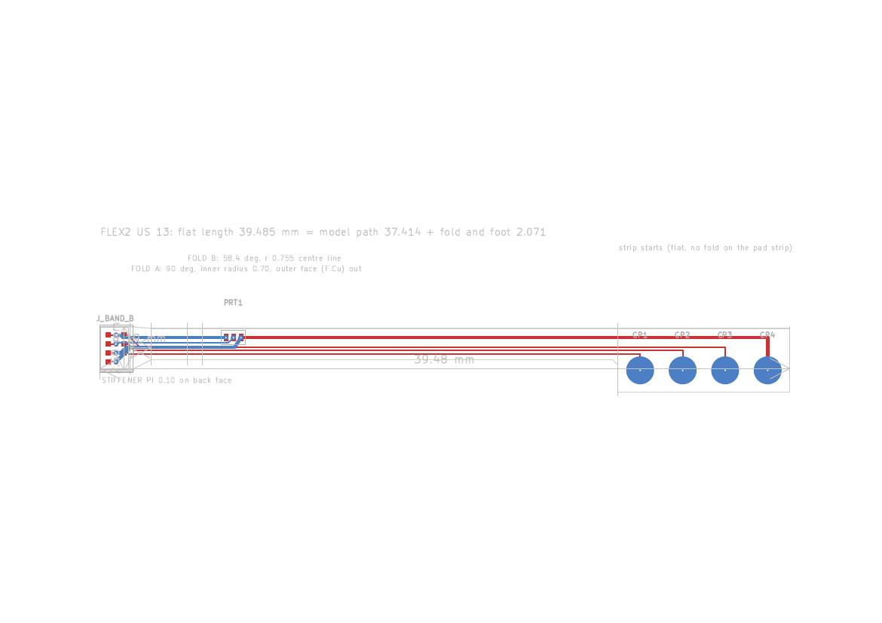
design/ecad/band/evidence/view/f2-13-1.png
