NexusGPT/openring/design/ecad/band/evidence/view/flex1-us9-1.png

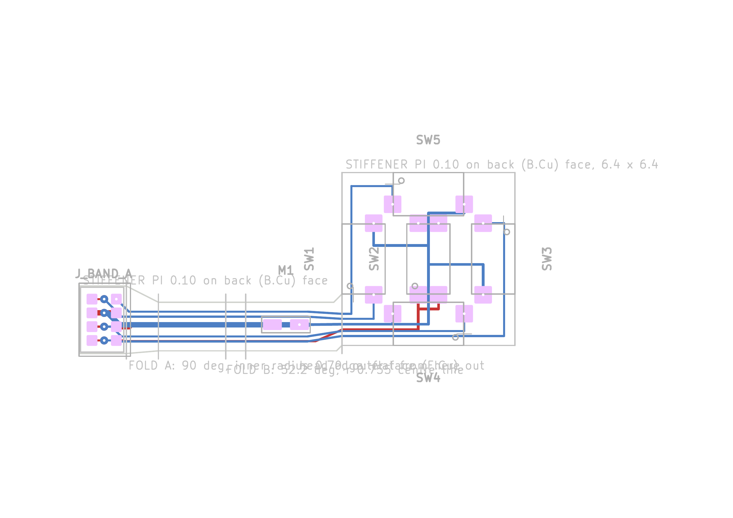
design/ecad/band/evidence/view/flex1-us9-1.png
