NexusGPT/openring/design/ecad/band/evidence/view/flex1-us9b-1.png

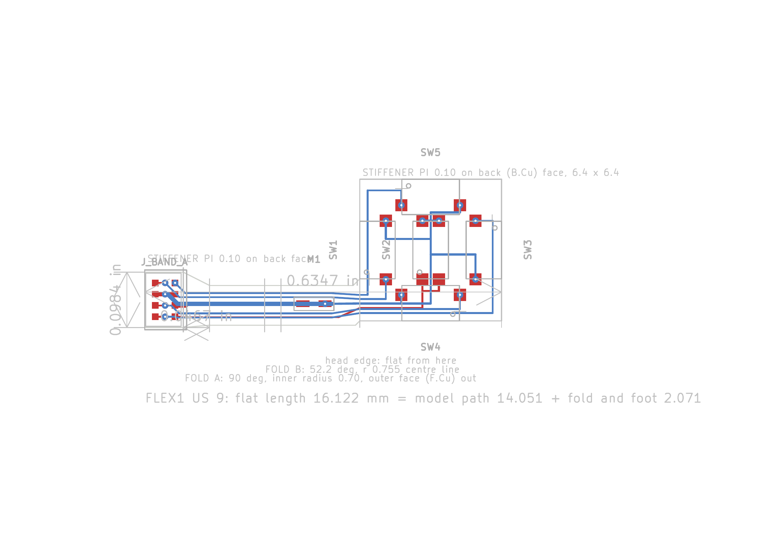
design/ecad/band/evidence/view/flex1-us9b-1.png
