NexusGPT/openring/design/ecad/band/evidence/view/flex2-us9-1.png

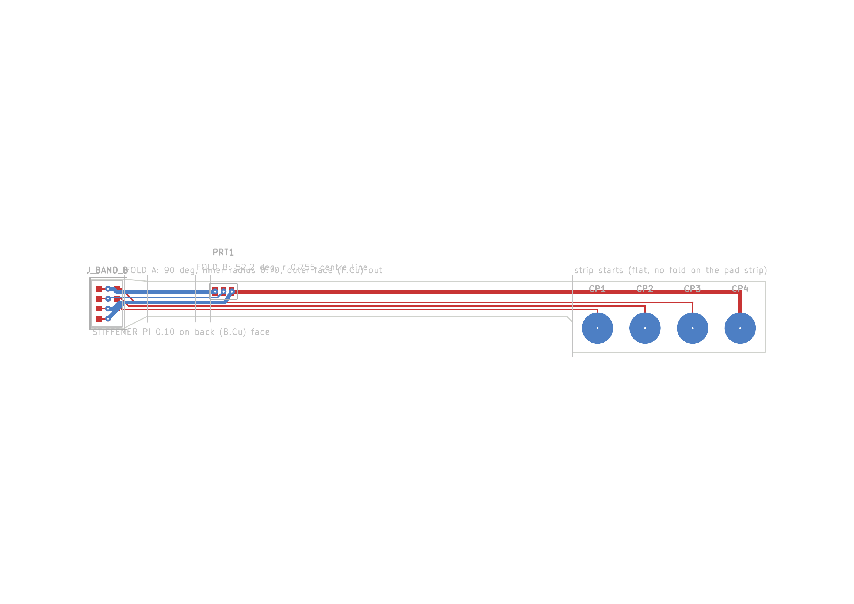
design/ecad/band/evidence/view/flex2-us9-1.png
