NexusGPT/openring/design/ecad/case/evidence/pdf_c1_p1.png

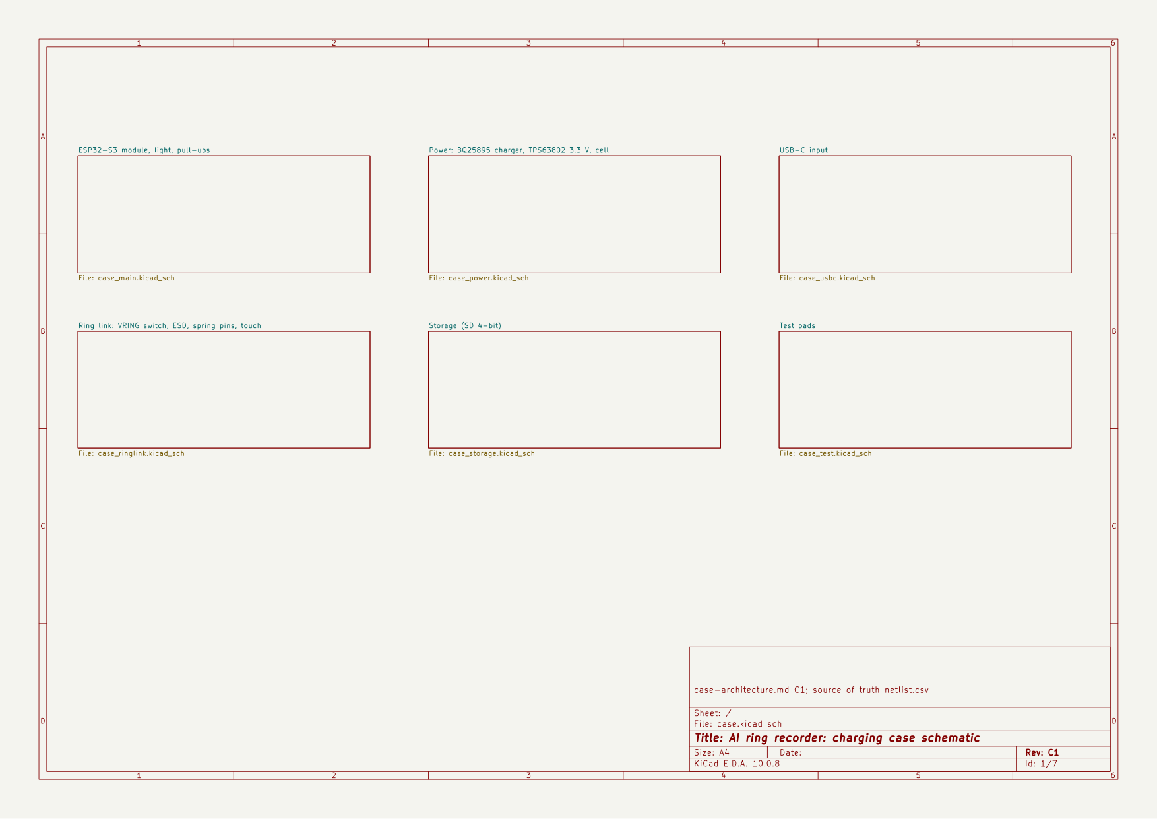
design/ecad/case/evidence/pdf_c1_p1.png
