NexusGPT/openring/design/ecad/case/evidence/pdf_c1_p2.png

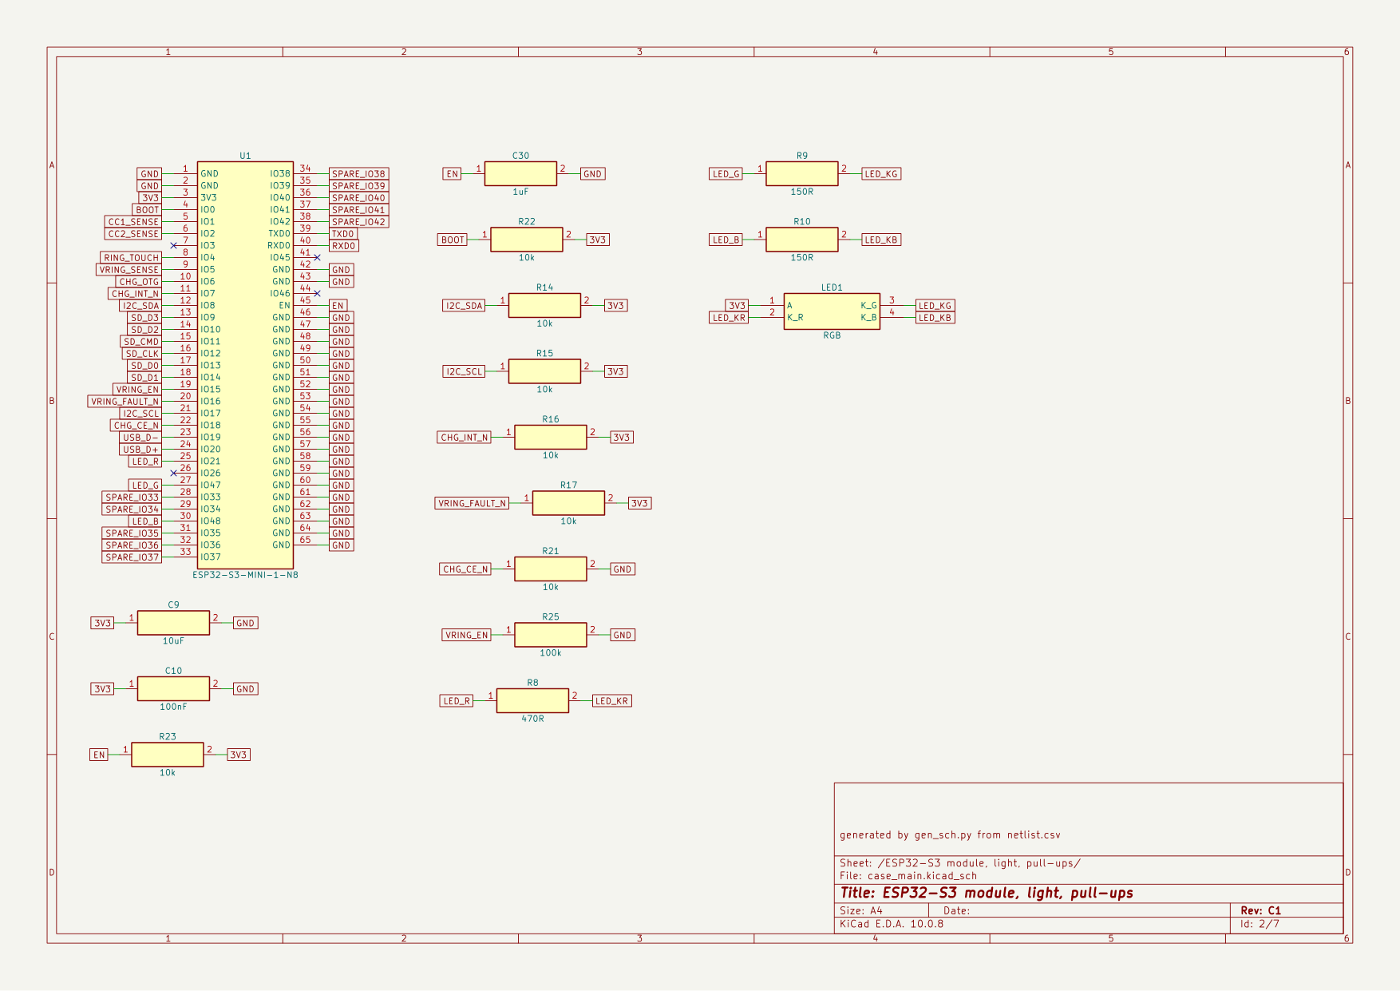
design/ecad/case/evidence/pdf_c1_p2.png
