NexusGPT/openring/design/ecad/case/evidence/pdf_c1_p3.png

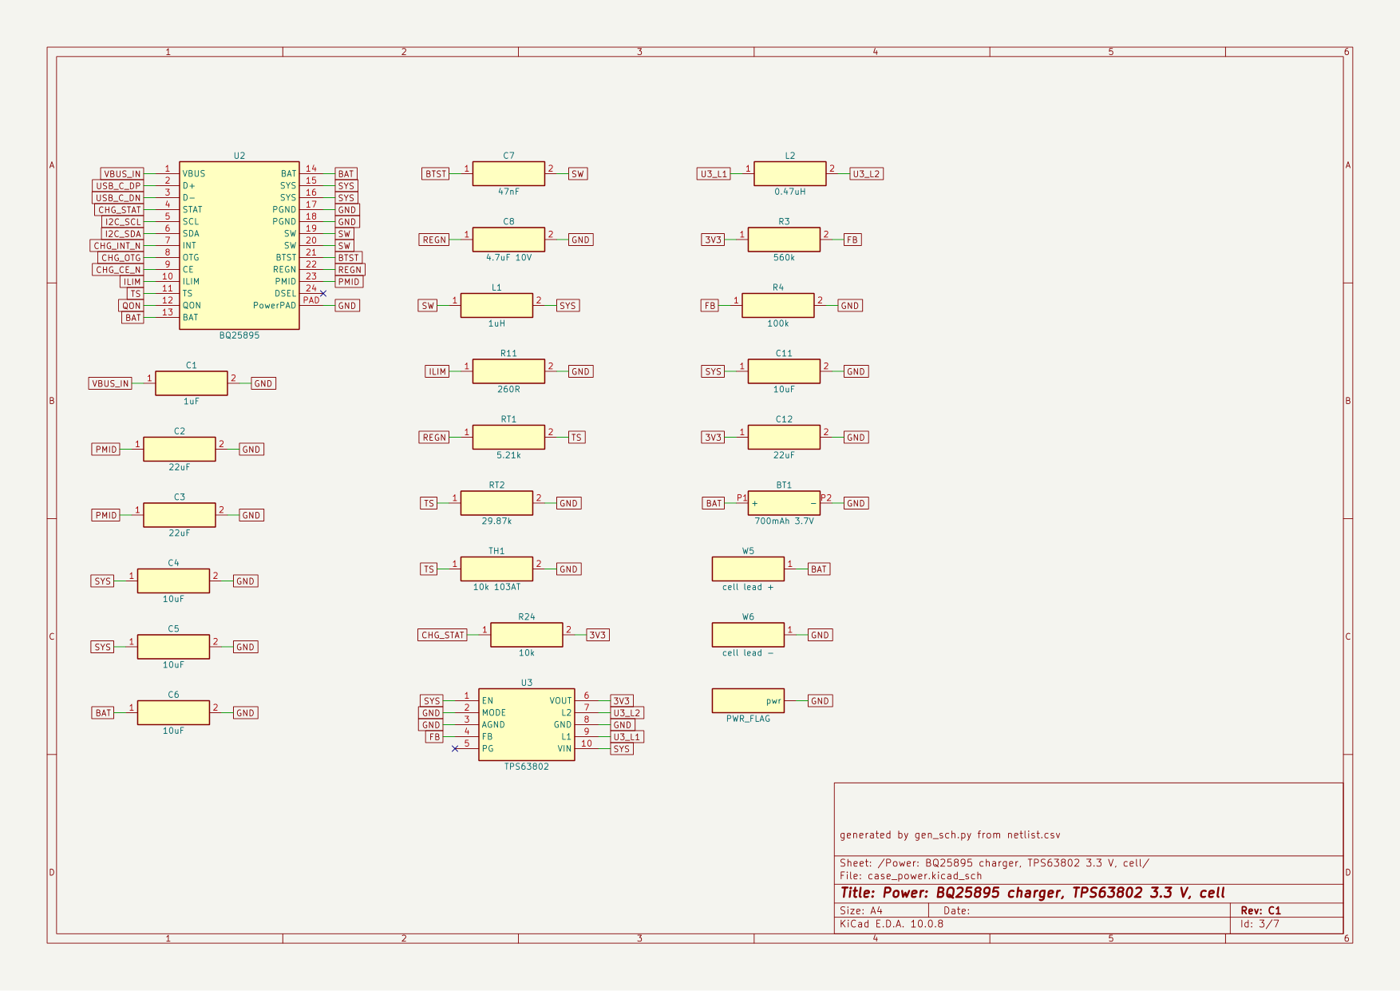
design/ecad/case/evidence/pdf_c1_p3.png
