NexusGPT/openring/design/ecad/case/evidence/pdf_c1_p4.png

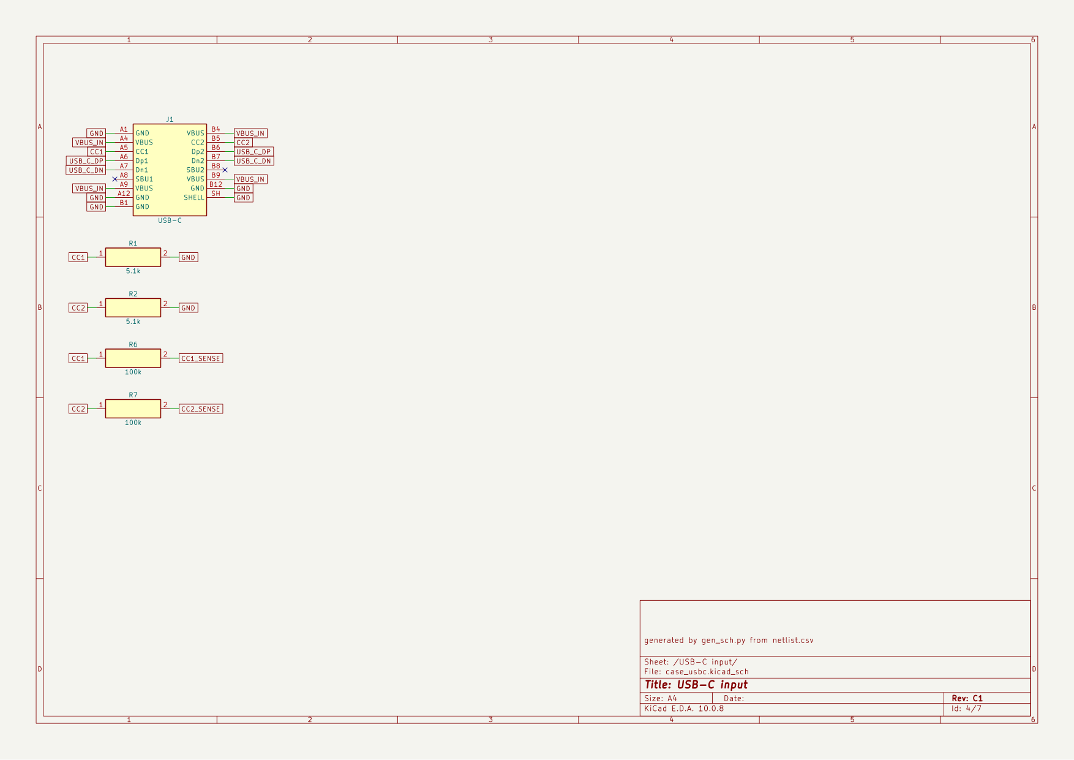
design/ecad/case/evidence/pdf_c1_p4.png
