NexusGPT/openring/design/ecad/case/evidence/pdf_c1_p5.png

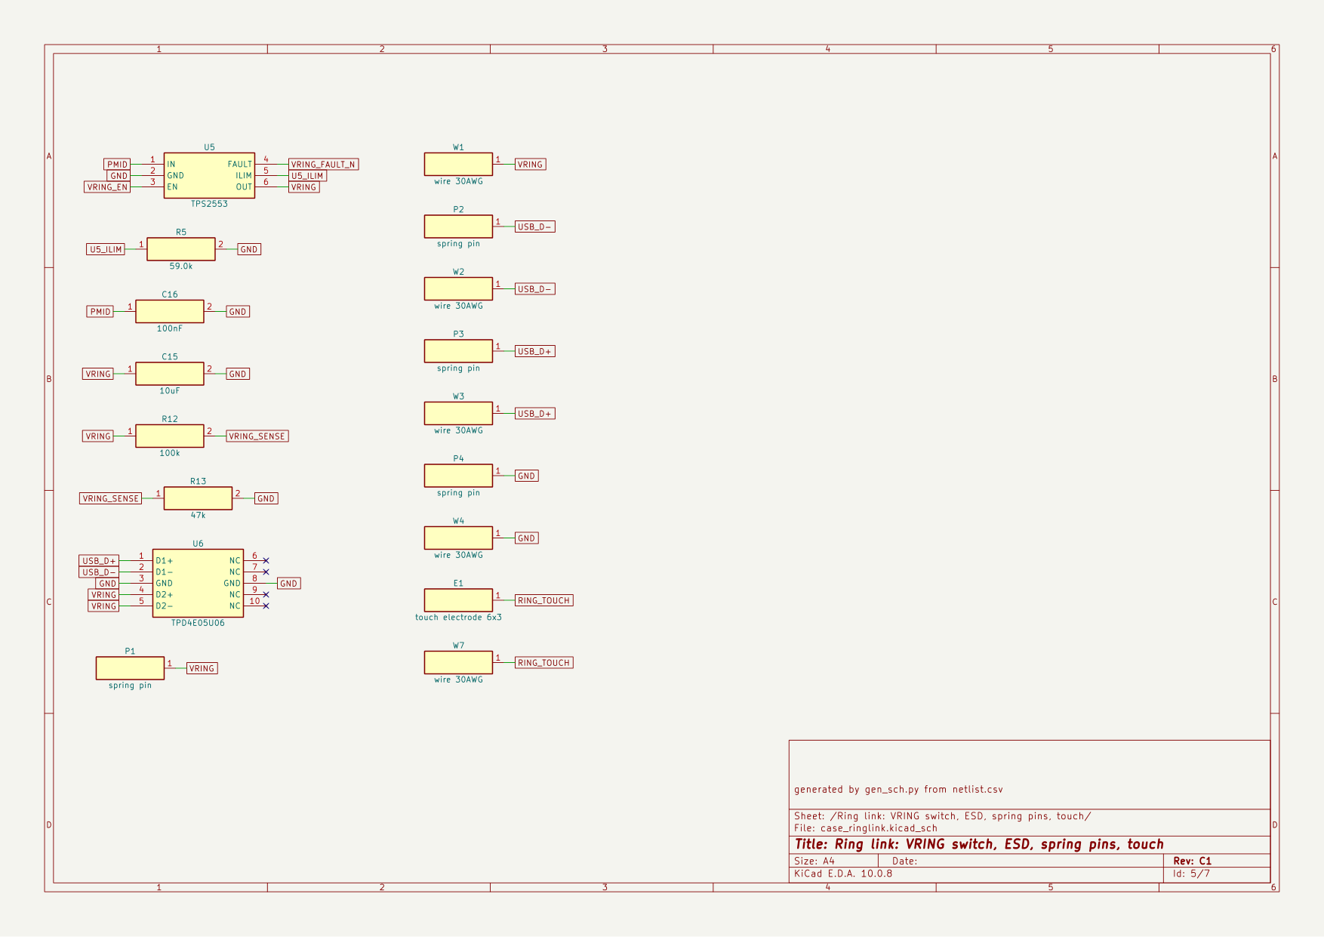
design/ecad/case/evidence/pdf_c1_p5.png
