NexusGPT/openring/design/ecad/case/evidence/pdf_c1_p7.png

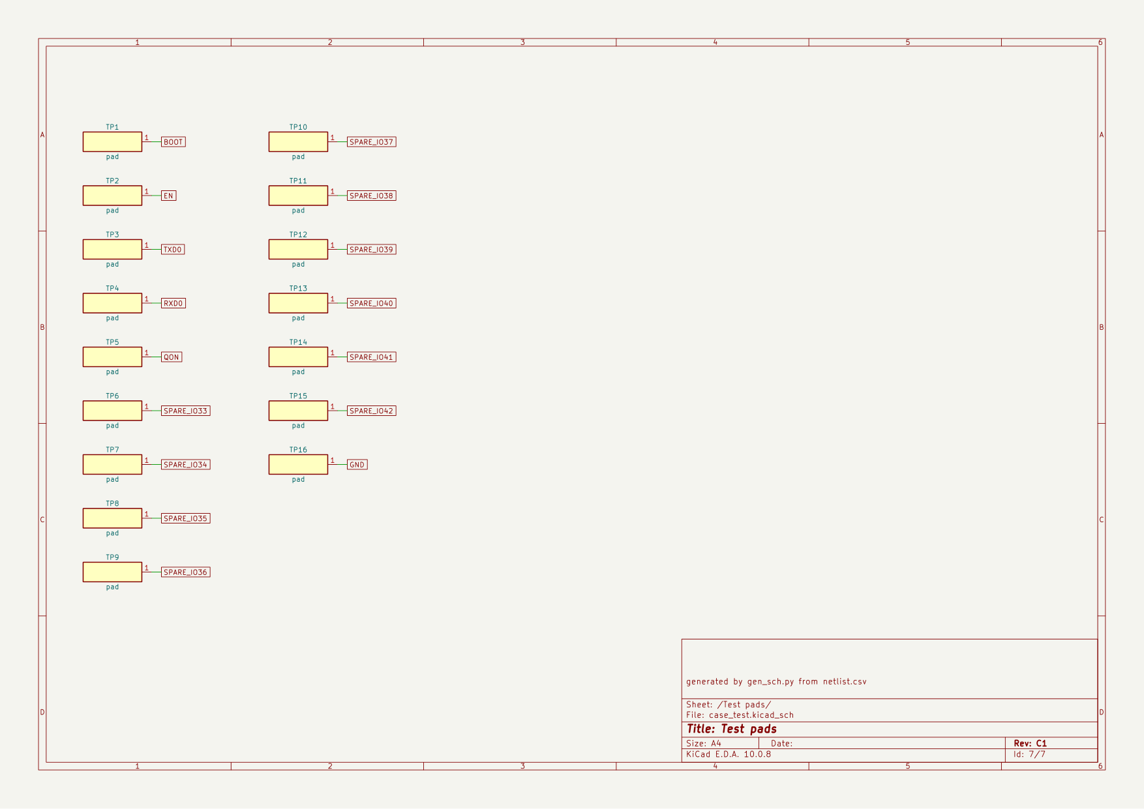
design/ecad/case/evidence/pdf_c1_p7.png
