NexusGPT/openring/design/ecad/case/evidence/pdf_c2_p3.png

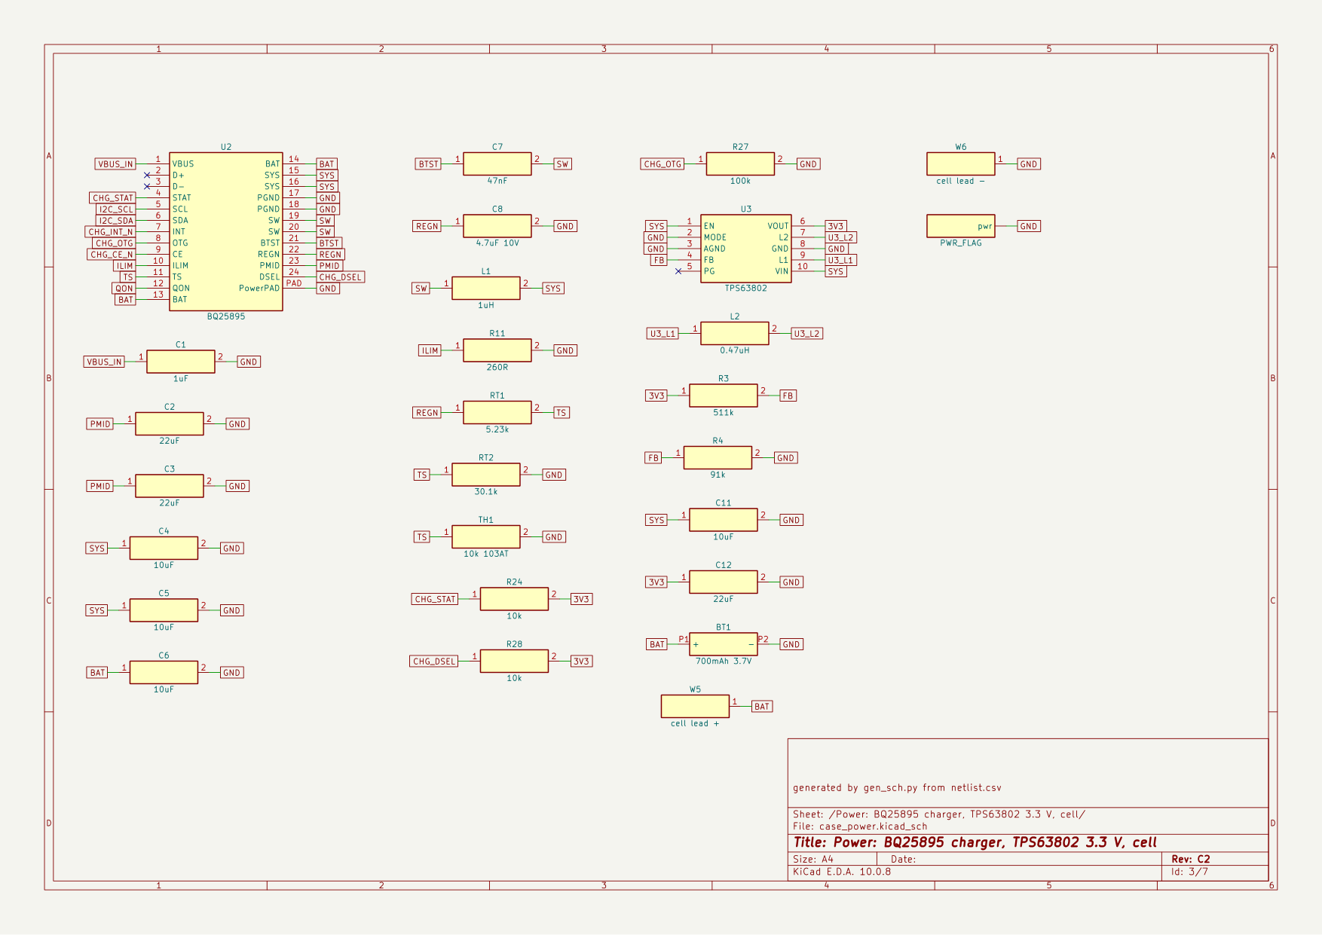
design/ecad/case/evidence/pdf_c2_p3.png
