NexusGPT/openring/design/ecad/case/evidence/pdf_c2_p6.png

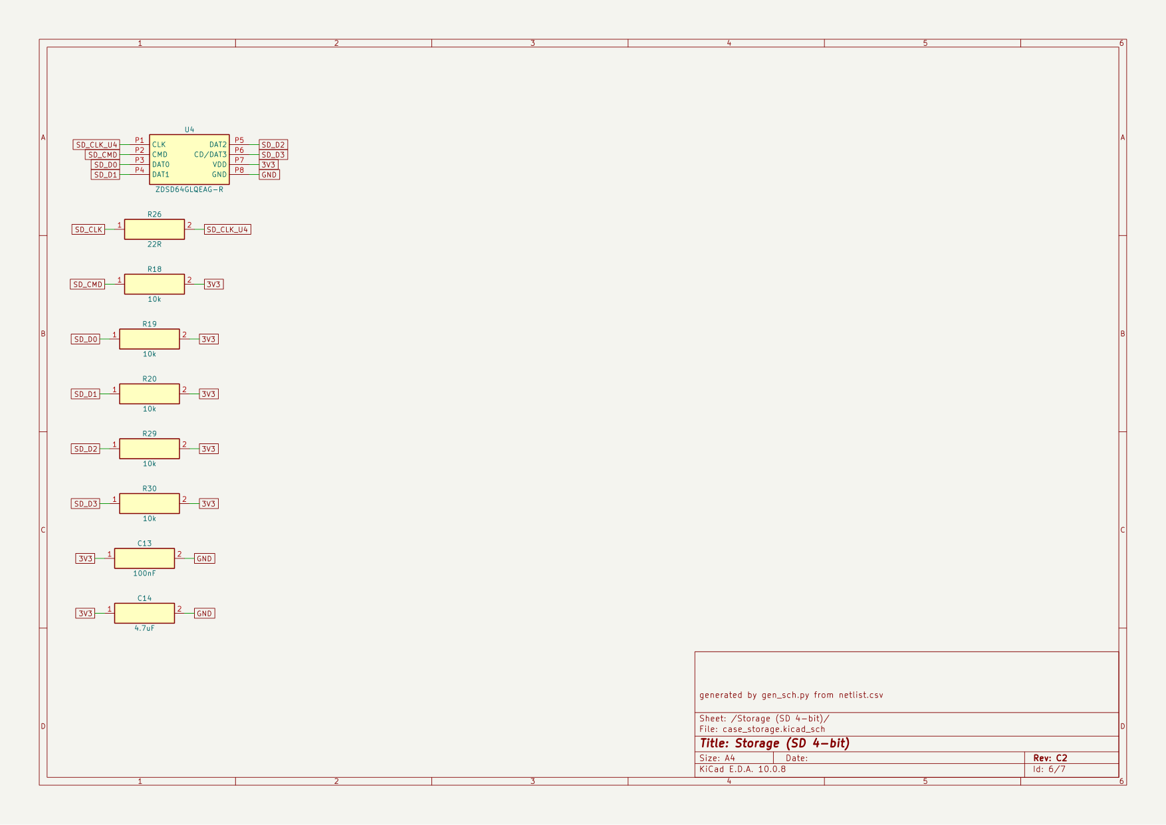
design/ecad/case/evidence/pdf_c2_p6.png
