NexusGPT/openring/design/ecad/case/pcb/evidence/pcb2_front.png

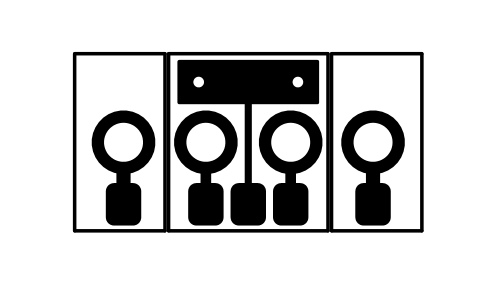
design/ecad/case/pcb/evidence/pcb2_front.png
