NexusGPT/openring/design/ecad/case/pcb/evidence/runB_front.png

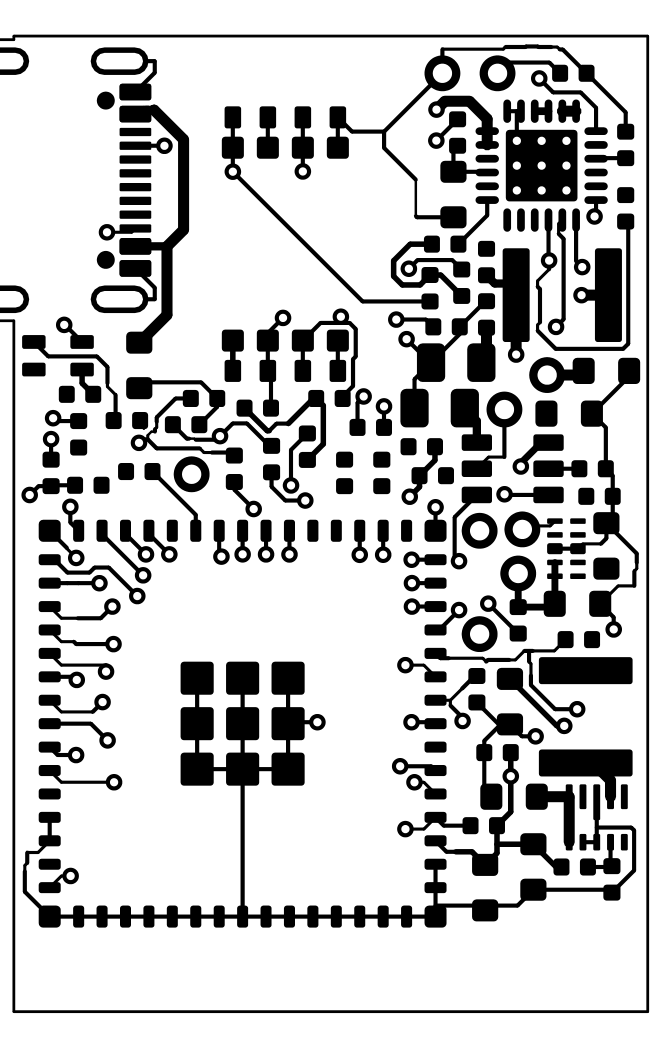
design/ecad/case/pcb/evidence/runB_front.png
