NexusGPT/openring/design/ecad/case/pcb/evidence/t51n_zoom.png

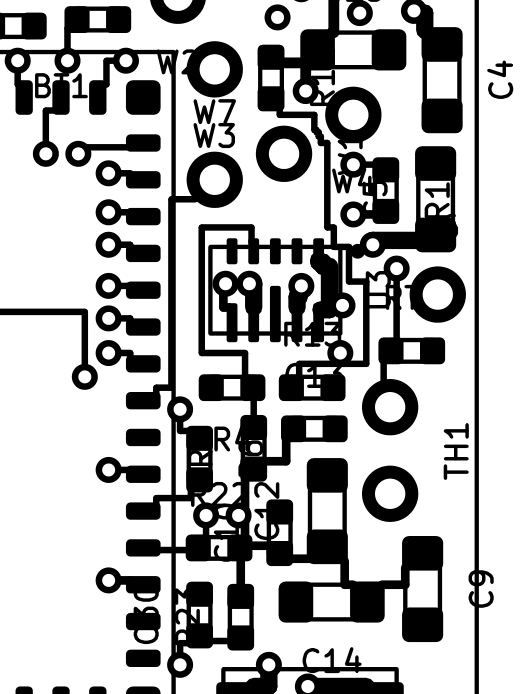
design/ecad/case/pcb/evidence/t51n_zoom.png
