NexusGPT/openring/design/ecad/ring-apply-a2/pic/a2-B.png

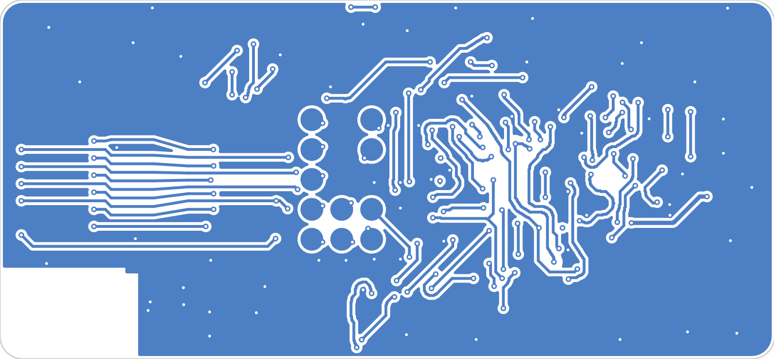
design/ecad/ring-apply-a2/pic/a2-B.png
