NexusGPT/openring/design/ecad/ring-apply-a2/pic/a2-F.png

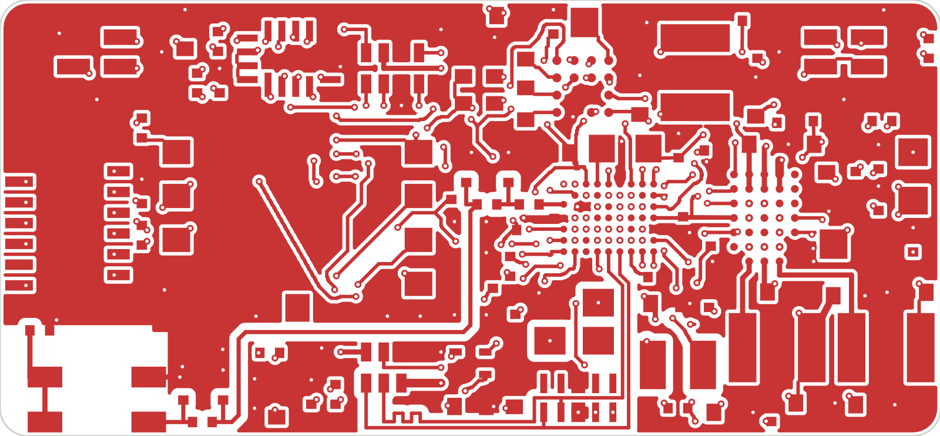
design/ecad/ring-apply-a2/pic/a2-F.png
