NexusGPT/openring/design/ecad/ring-route-h/logs/pic/h00-F.png

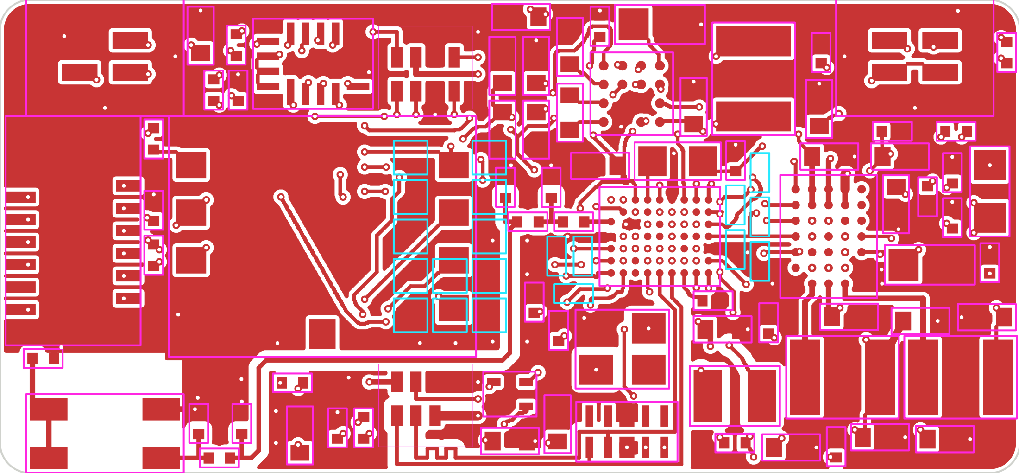
design/ecad/ring-route-h/logs/pic/h00-F.png
