NexusGPT/openring/design/ecad/ring-route-h/logs/pic/h00-In1.png

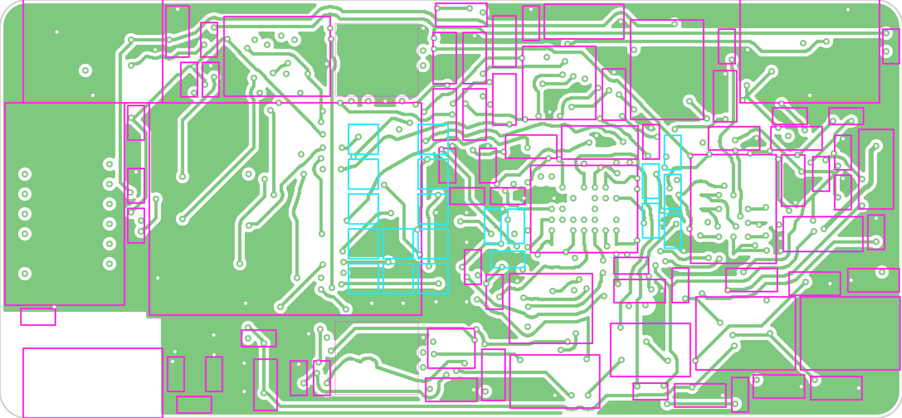
design/ecad/ring-route-h/logs/pic/h00-In1.png
