NexusGPT/openring/design/ecad/ring-route-h/logs/pic/h00-In2.png

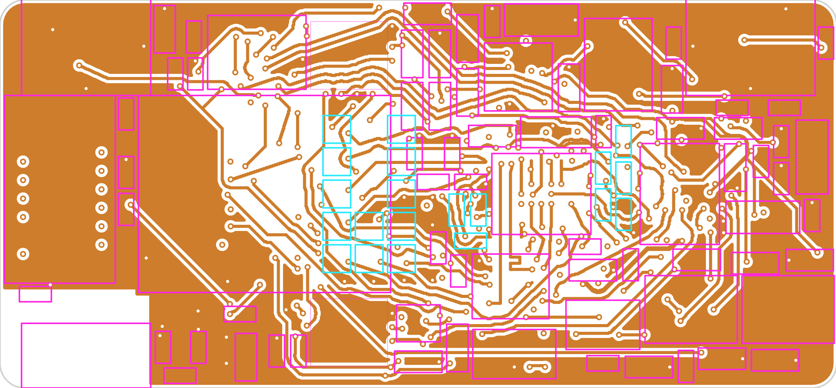
design/ecad/ring-route-h/logs/pic/h00-In2.png
