NexusGPT/openring/design/ecad/ring/evidence/pdf_a5_p1.png

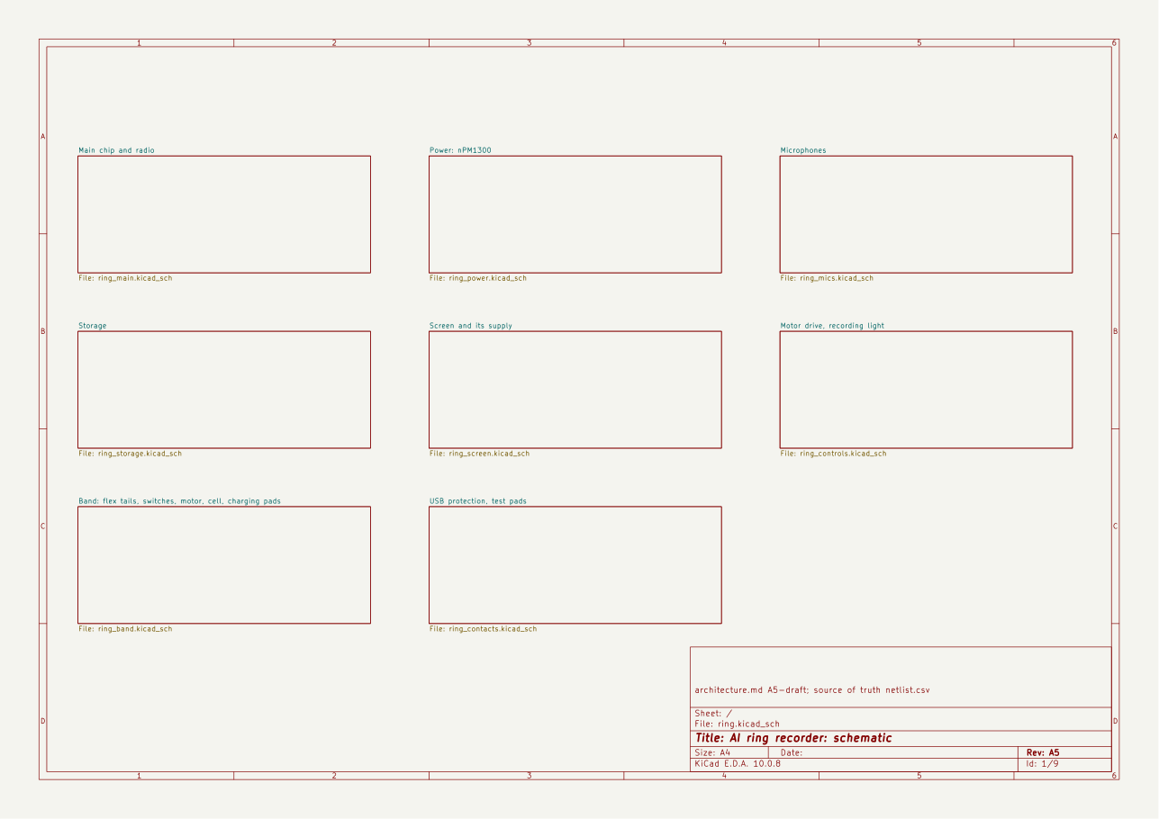
design/ecad/ring/evidence/pdf_a5_p1.png
