NexusGPT/openring/design/ecad/ring/evidence/pdf_a5_p2.png

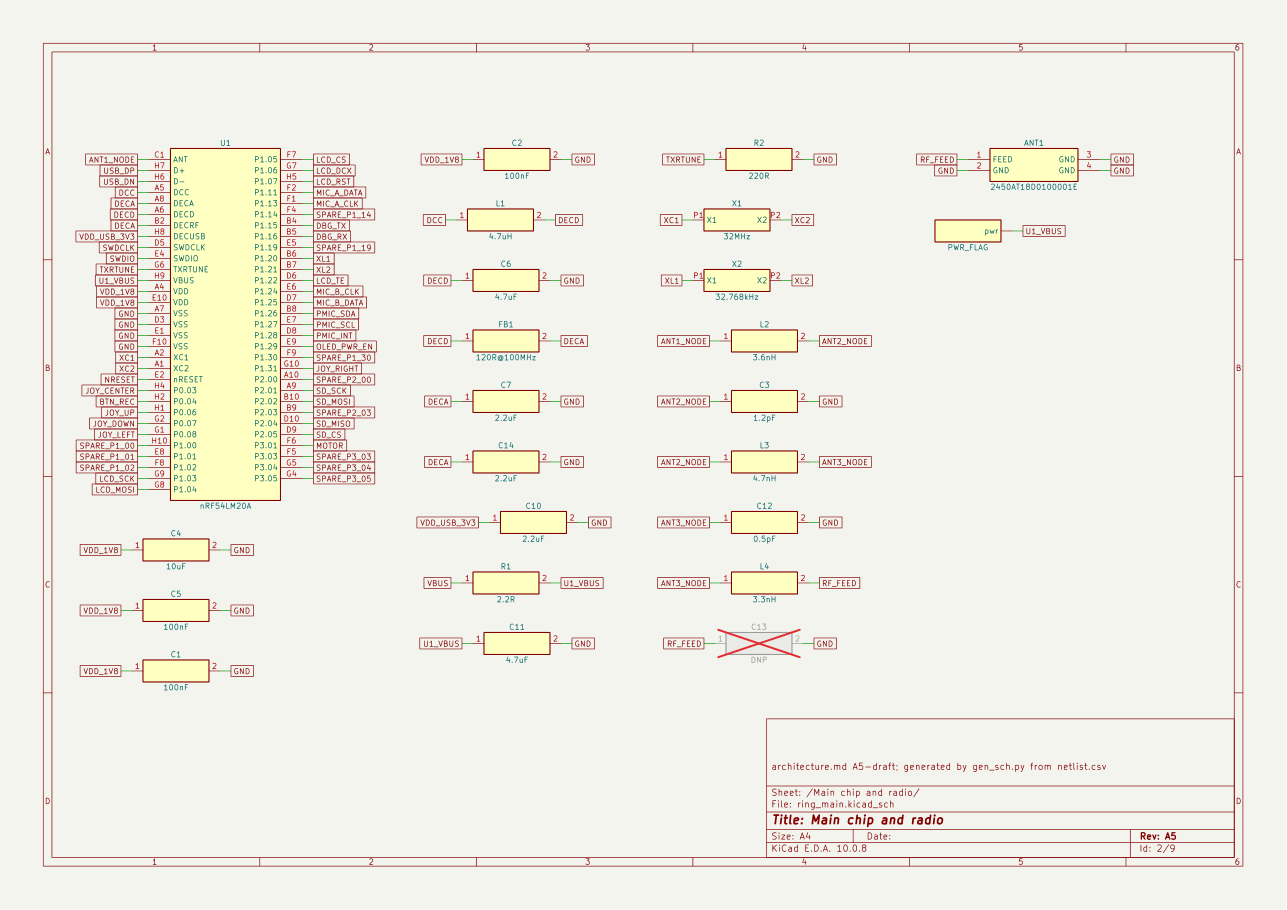
design/ecad/ring/evidence/pdf_a5_p2.png
