NexusGPT/openring/design/ecad/ring/evidence/pdf_a5_p3.png

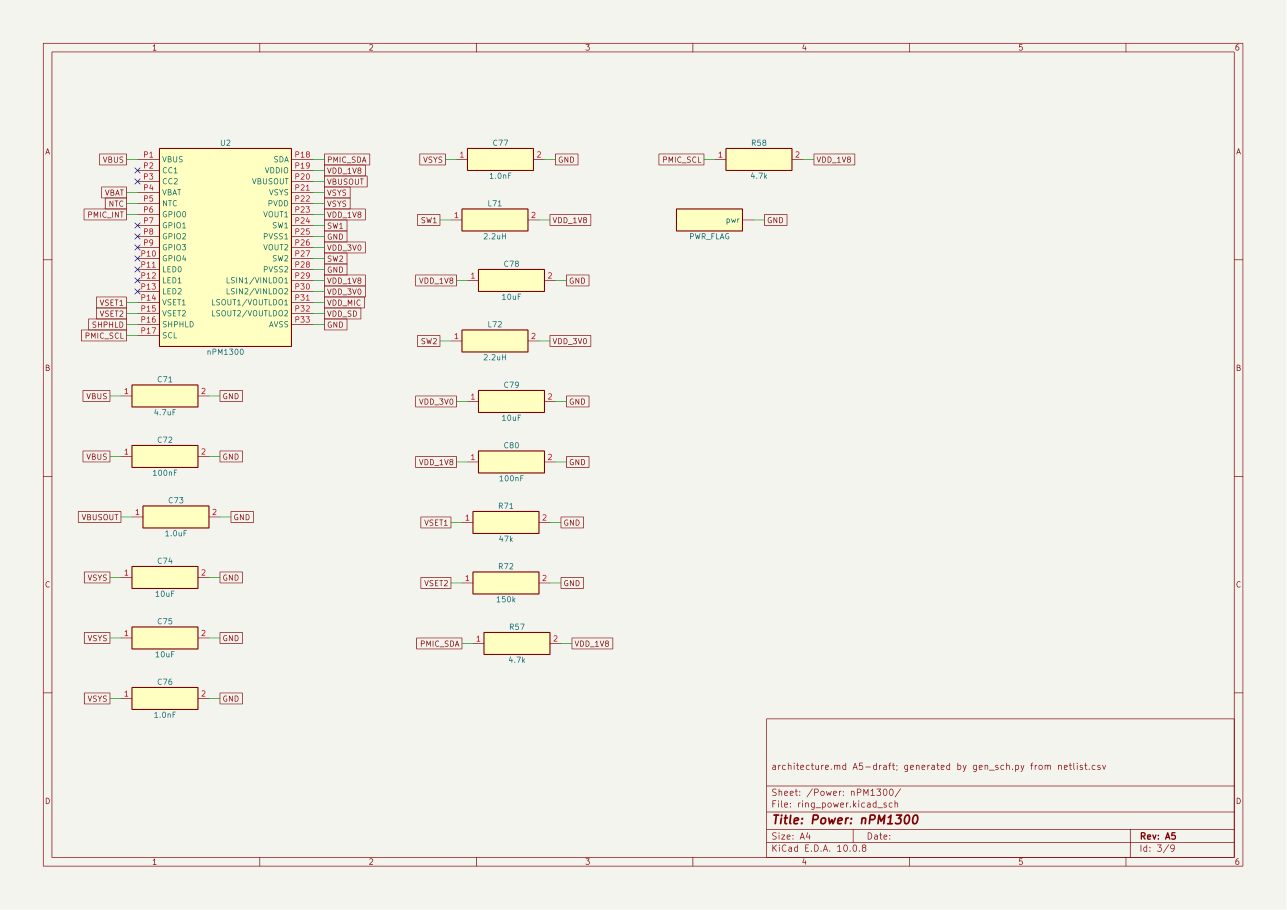
design/ecad/ring/evidence/pdf_a5_p3.png
