NexusGPT/openring/design/ecad/ring/evidence/pdf_a5_p4.png

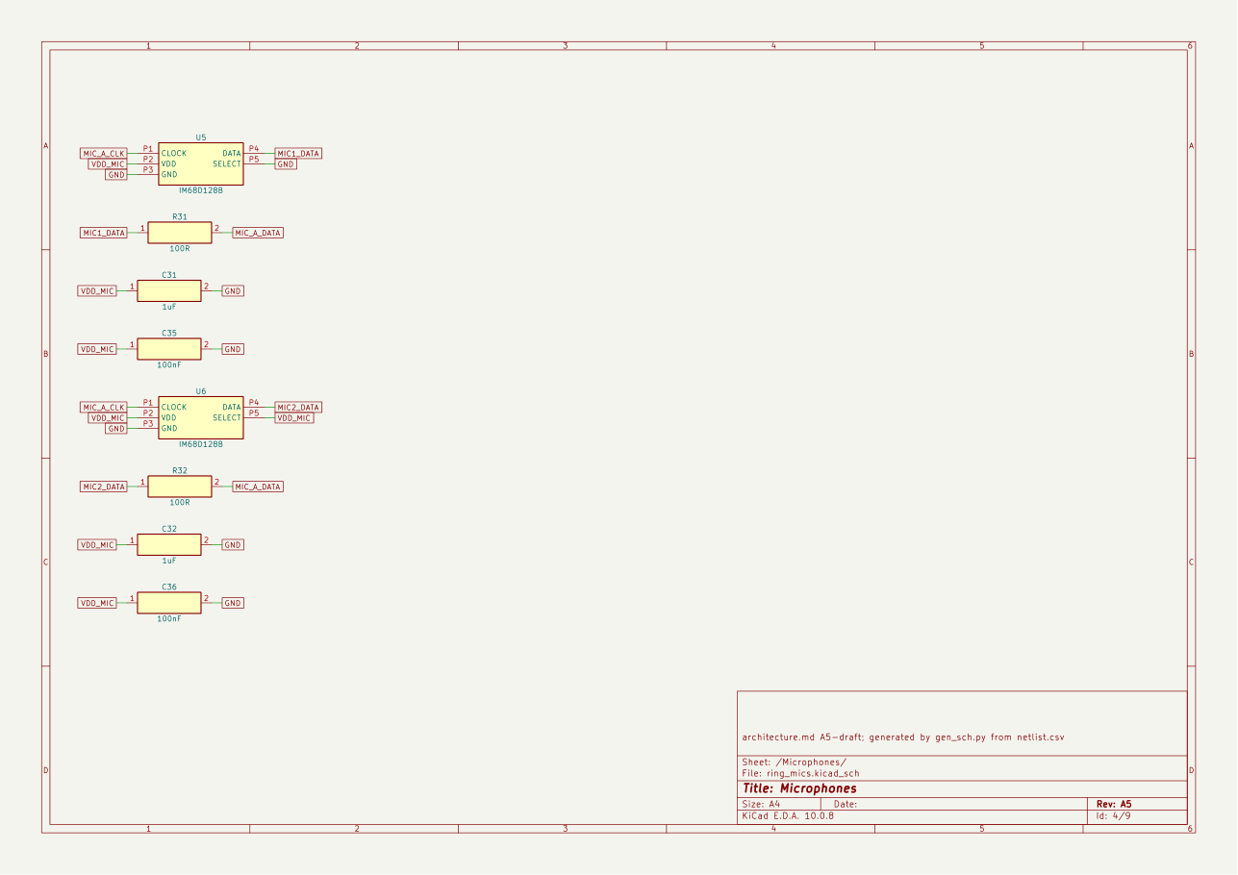
design/ecad/ring/evidence/pdf_a5_p4.png
