NexusGPT/openring/design/ecad/ring/evidence/pdf_a5_p6.png

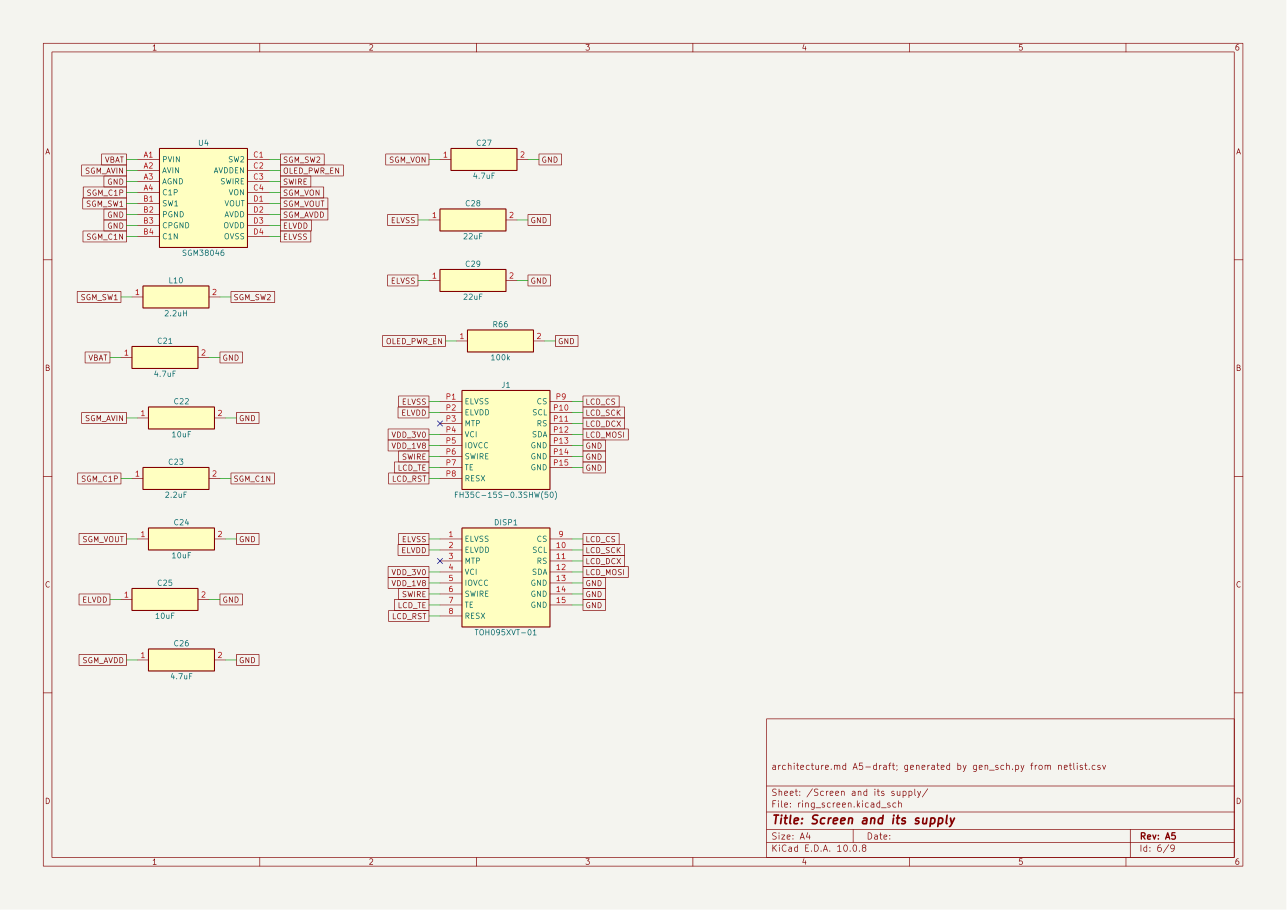
design/ecad/ring/evidence/pdf_a5_p6.png
