NexusGPT/openring/design/ecad/ring/evidence/pdf_a5_p7.png

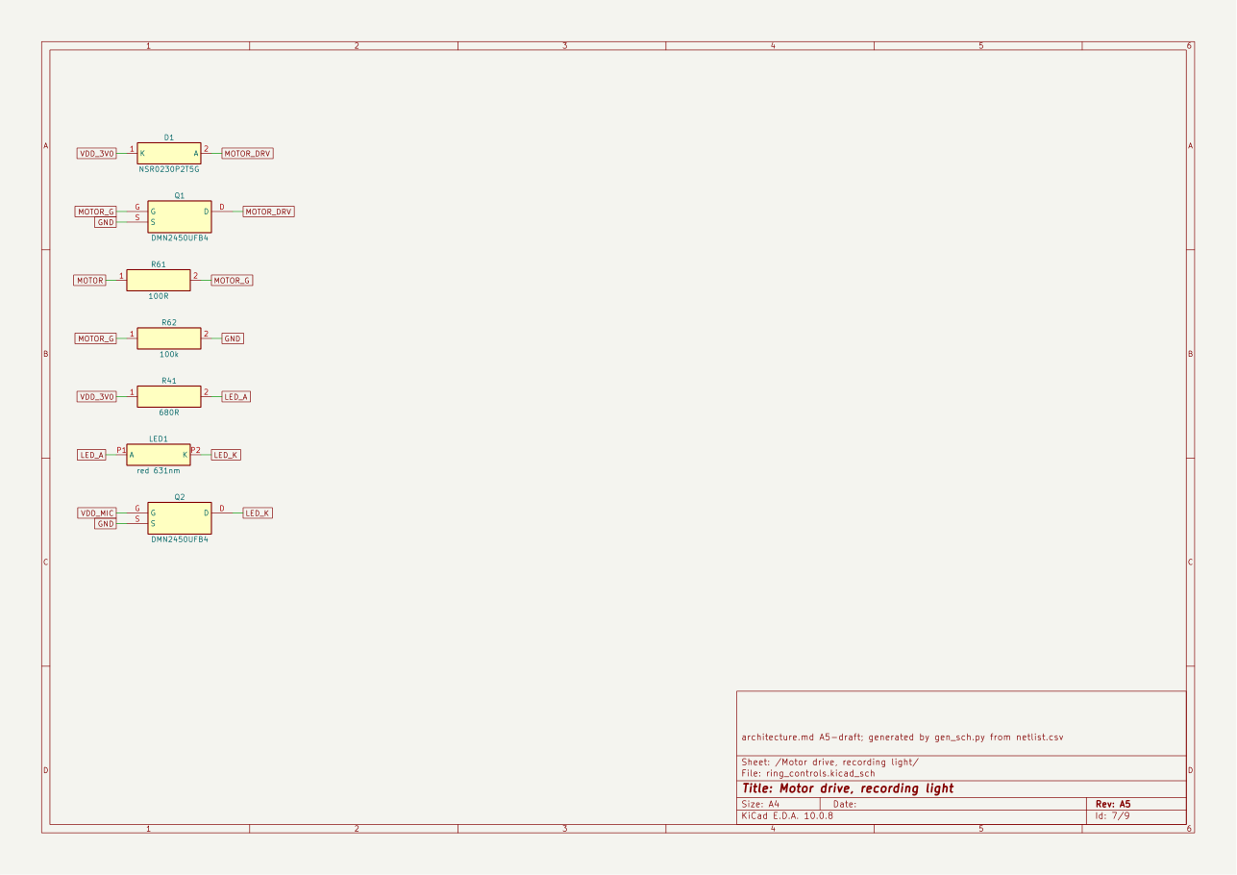
design/ecad/ring/evidence/pdf_a5_p7.png
