NexusGPT/openring/design/ecad/ring/evidence/pdf_a5_p8.png

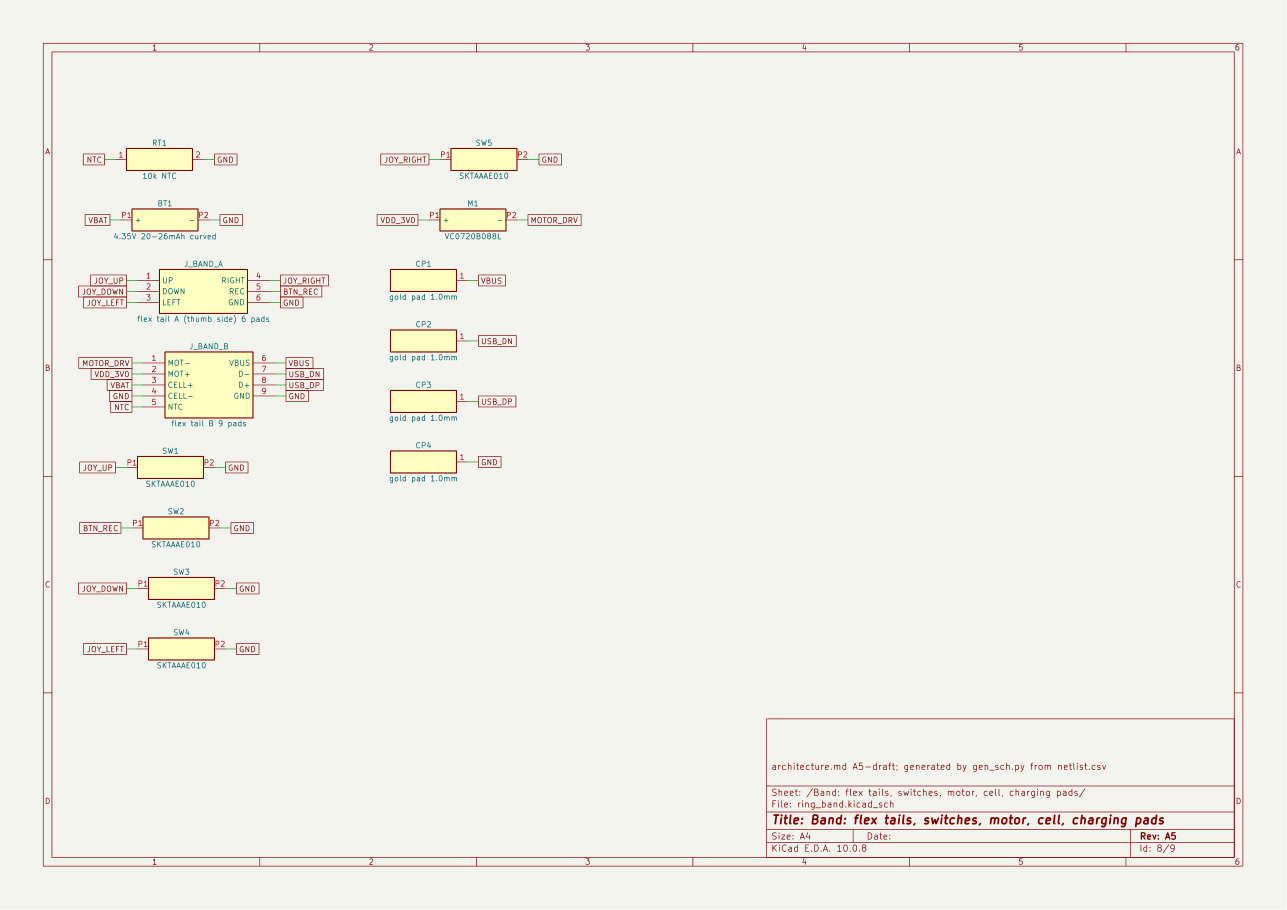
design/ecad/ring/evidence/pdf_a5_p8.png
