NexusGPT/openring/design/ecad/ring/evidence/pdf_a5_p9.png

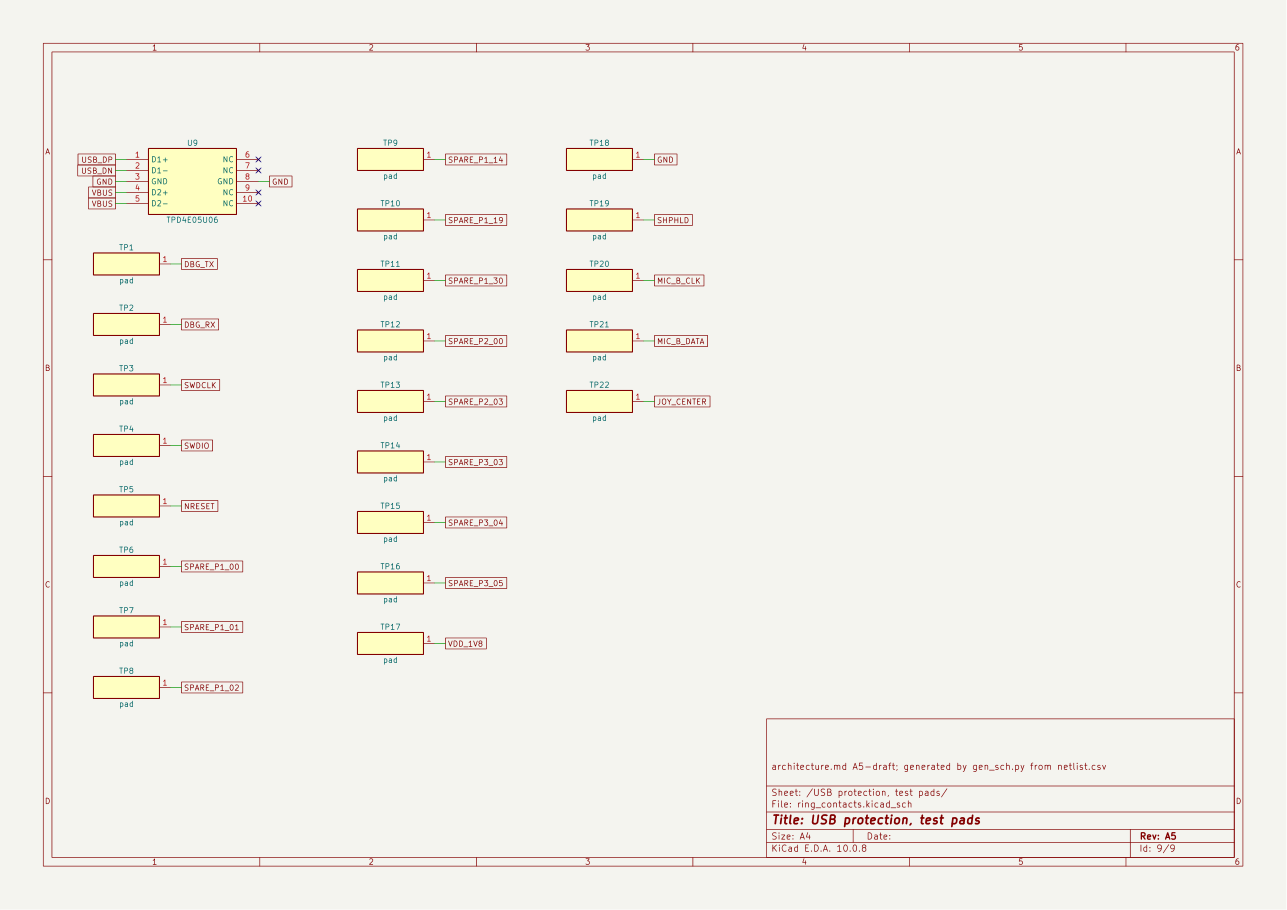
design/ecad/ring/evidence/pdf_a5_p9.png
