NexusGPT/openring/design/ecad/ring/evidence/pdf_a6_p5.png

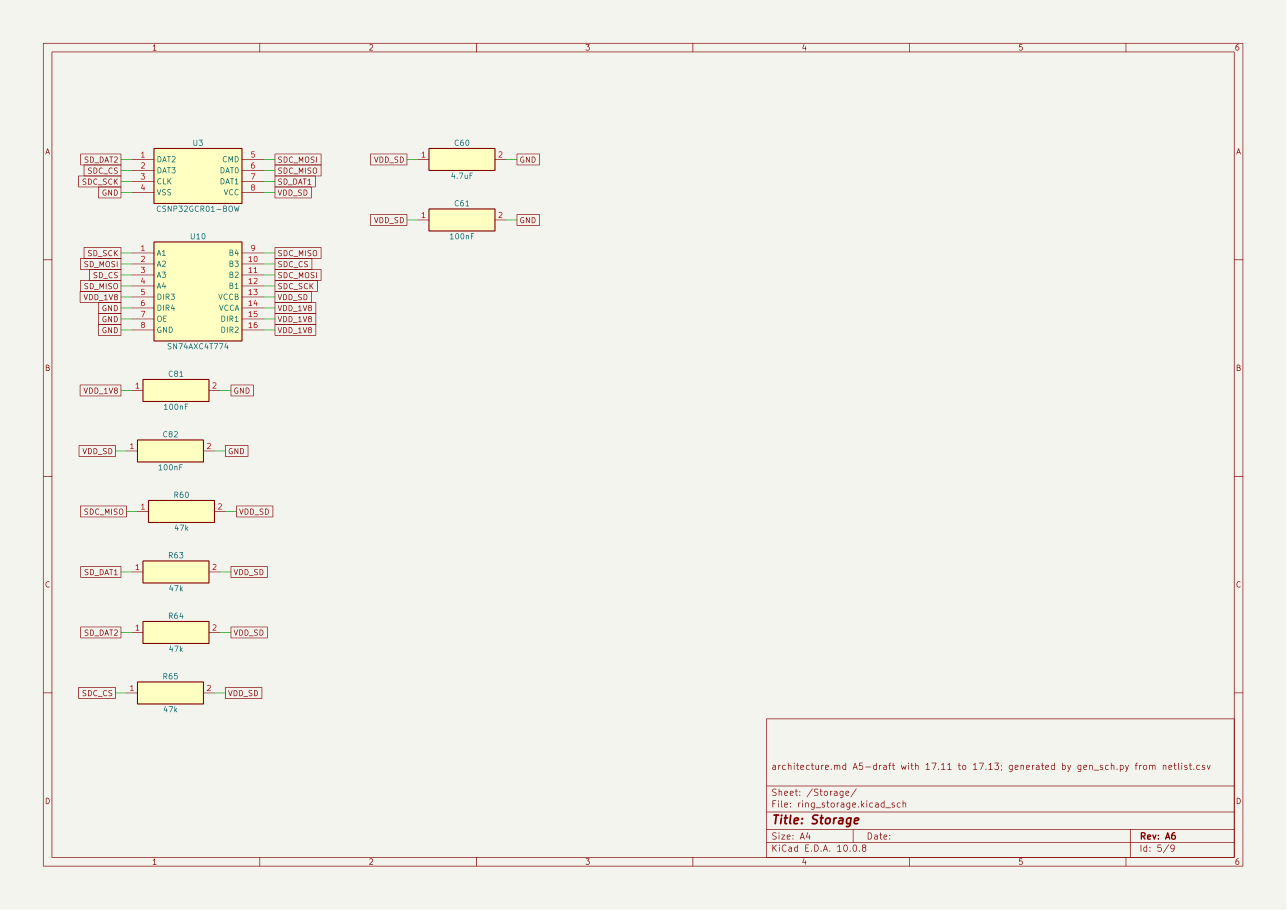
design/ecad/ring/evidence/pdf_a6_p5.png
