NexusGPT/openring/design/ecad/ring/evidence/pdf_a7_1_p3.png

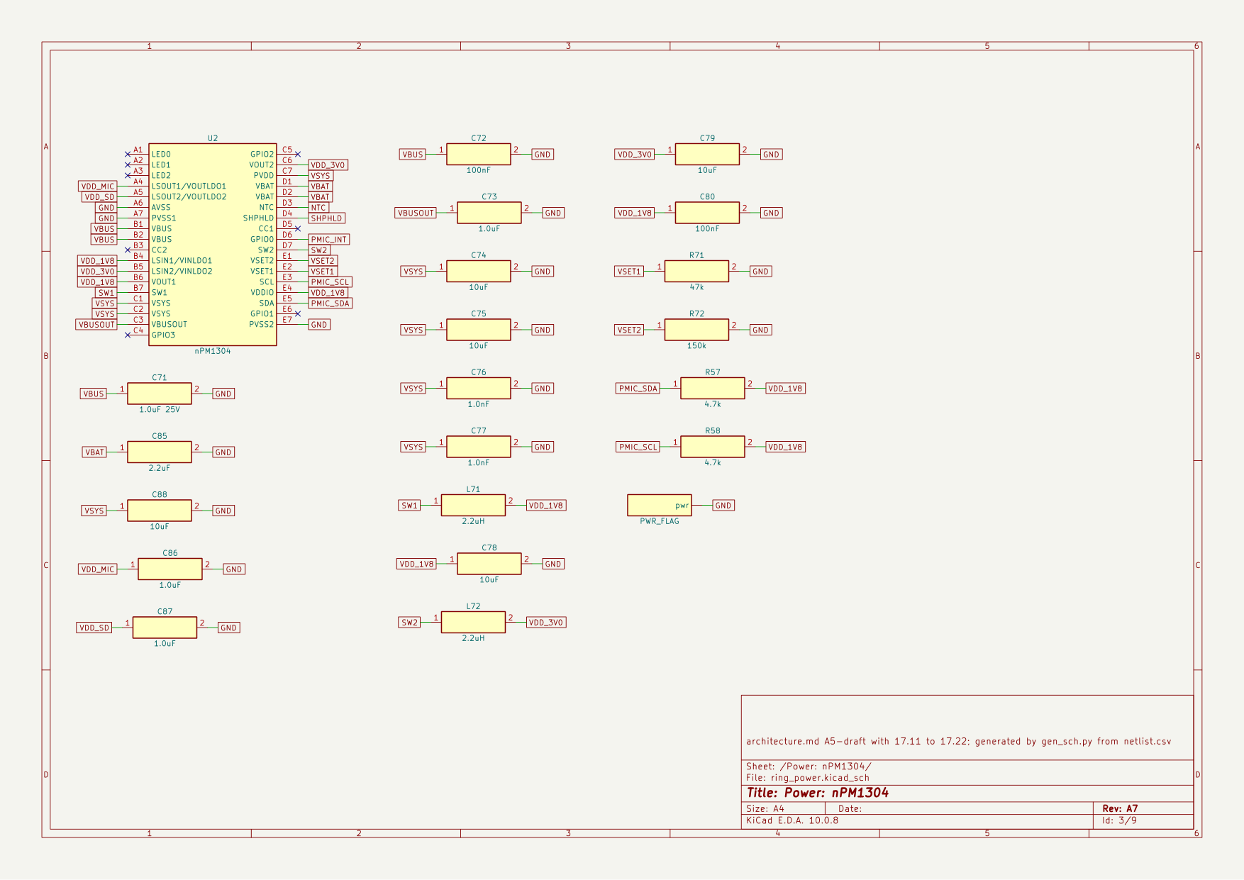
design/ecad/ring/evidence/pdf_a7_1_p3.png
