NexusGPT/openring/design/ecad/ring/evidence/pdf_t4_p1.png

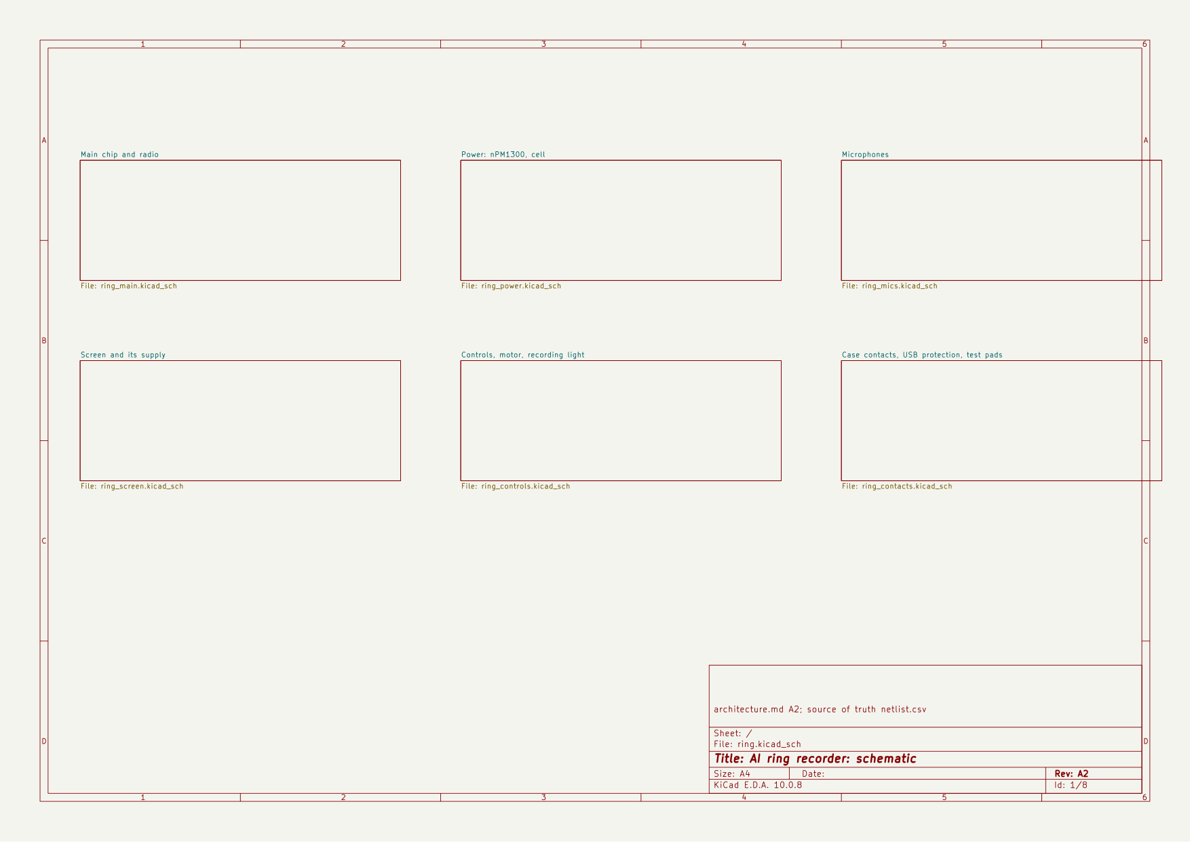
design/ecad/ring/evidence/pdf_t4_p1.png
