NexusGPT/openring/design/ecad/ring/evidence/pdf_t4_p2.png

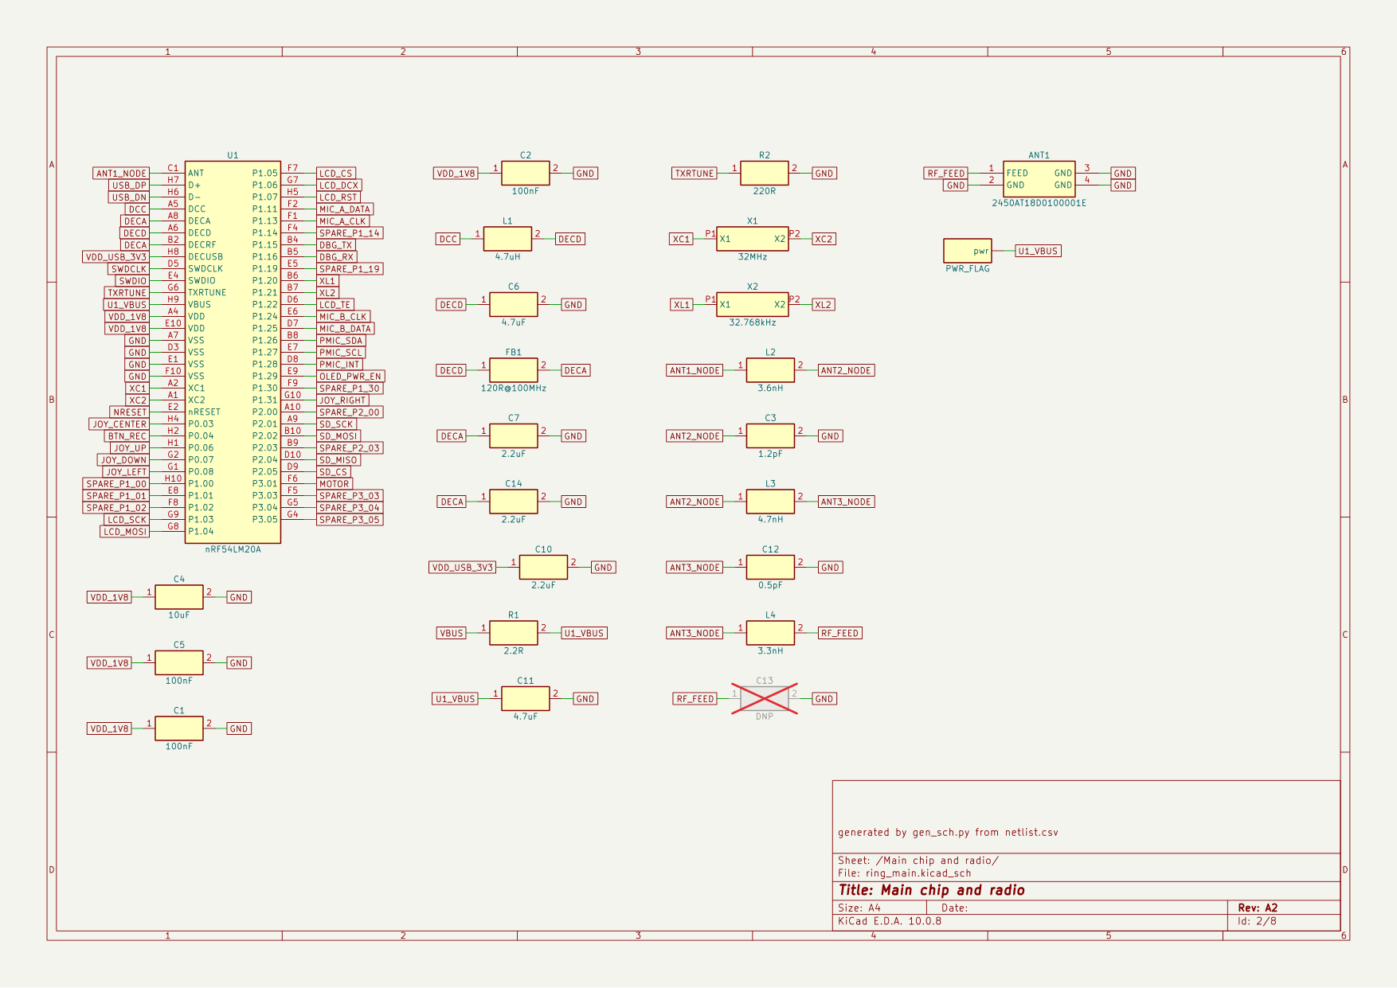
design/ecad/ring/evidence/pdf_t4_p2.png
