NexusGPT/openring/design/ecad/ring/evidence/pdf_t4_p3.png

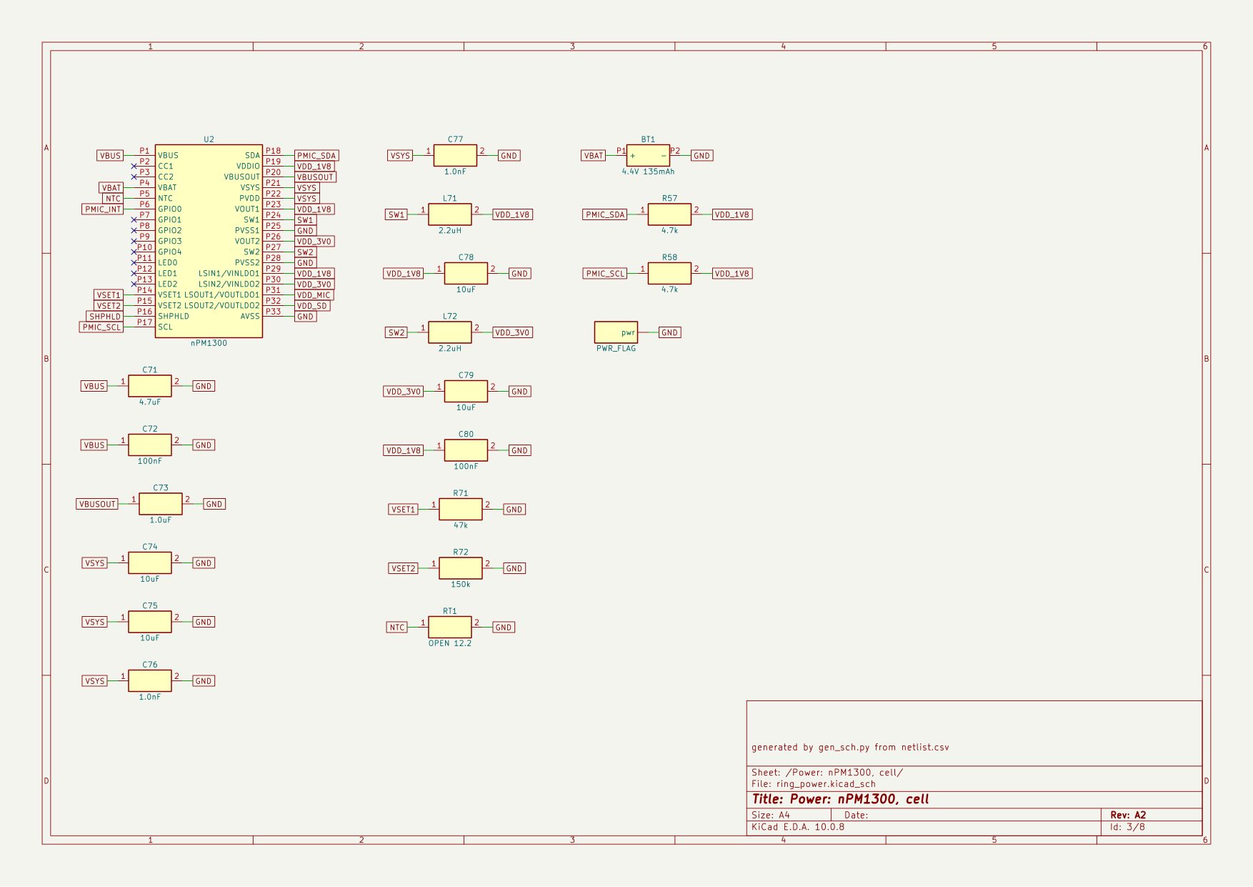
design/ecad/ring/evidence/pdf_t4_p3.png
