NexusGPT/openring/design/ecad/ring/evidence/pdf_t4_p8.png

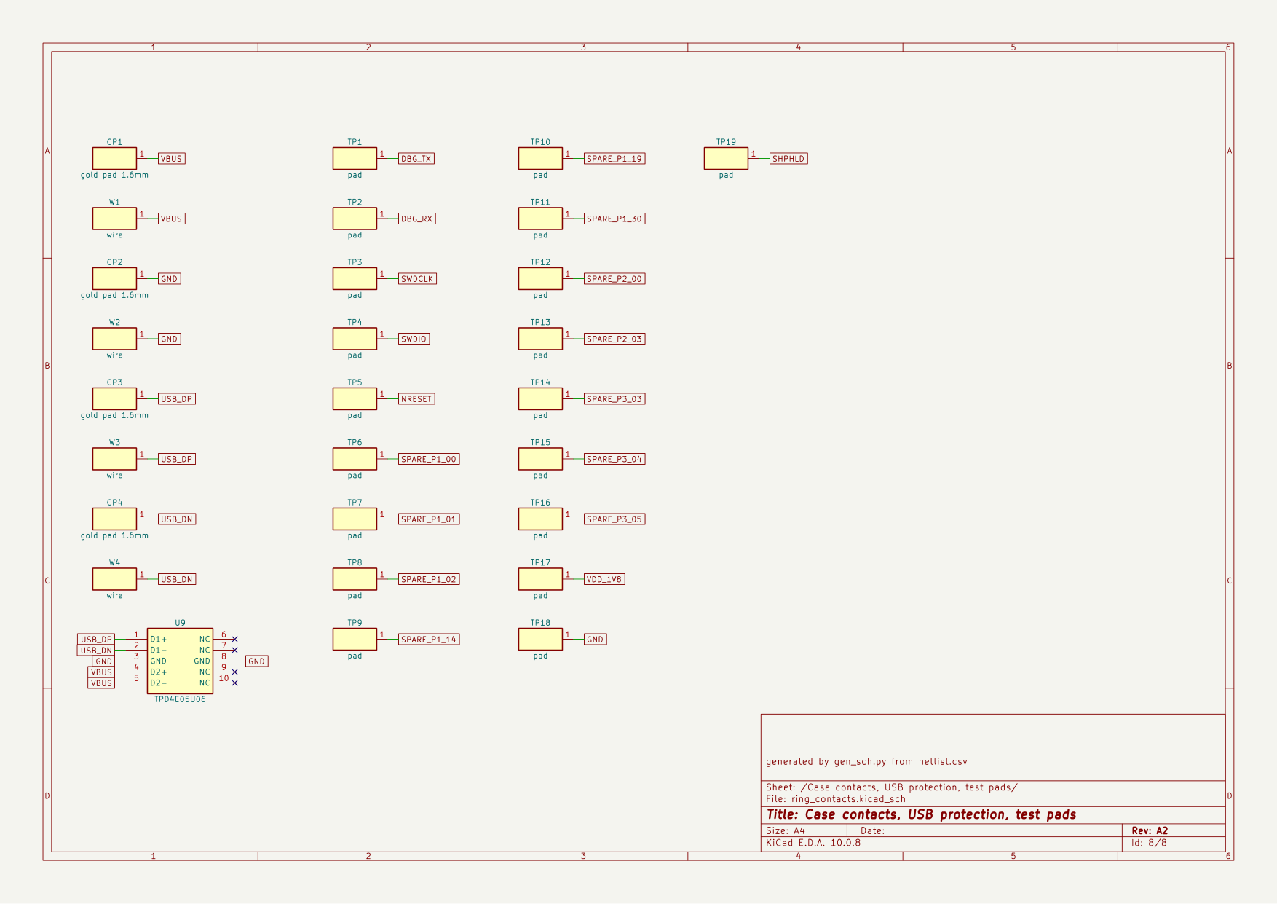
design/ecad/ring/evidence/pdf_t4_p8.png
