NexusGPT/openring/design/ecad/ring/evidence/pdf_t5_p3.png

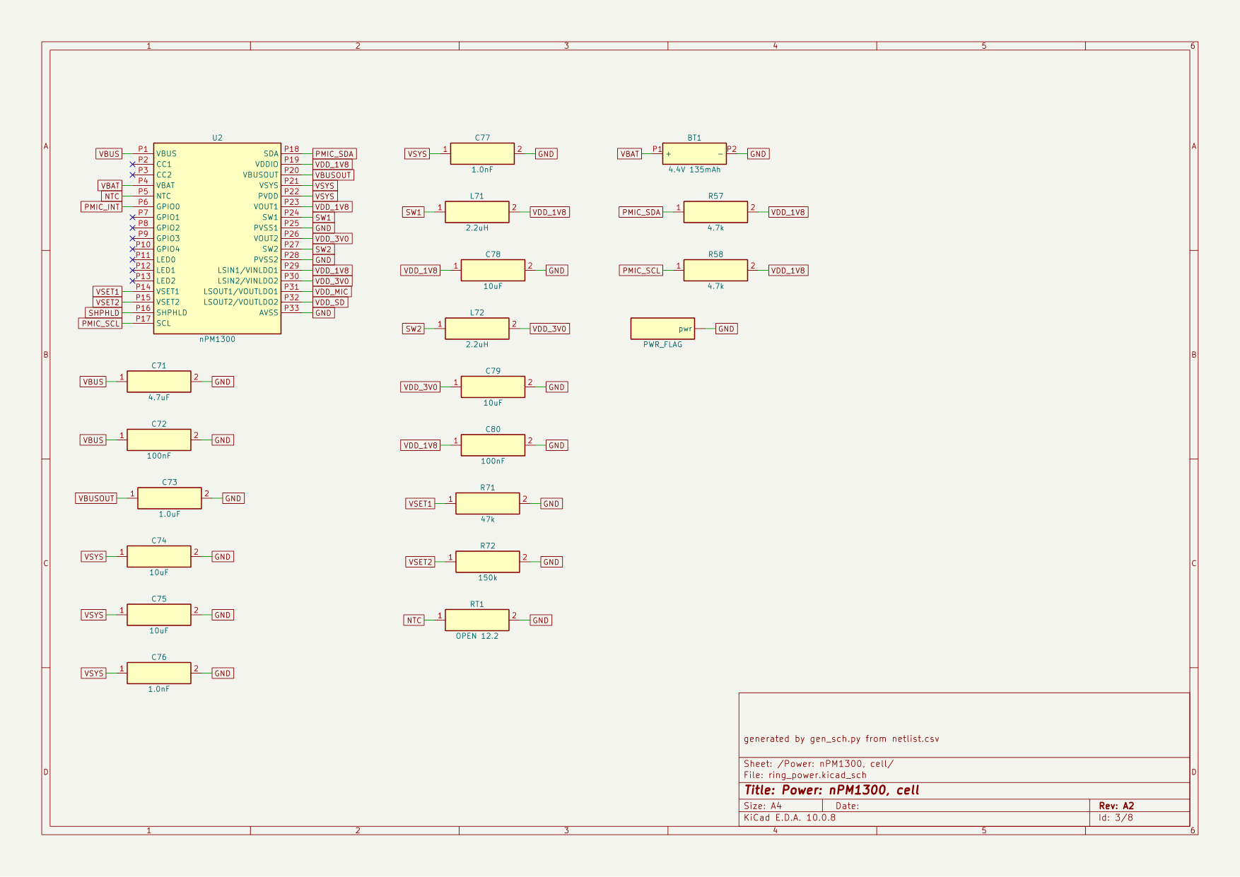
design/ecad/ring/evidence/pdf_t5_p3.png
