NexusGPT/openring/design/ecad/ring/evidence/pdf_t5_p4.png

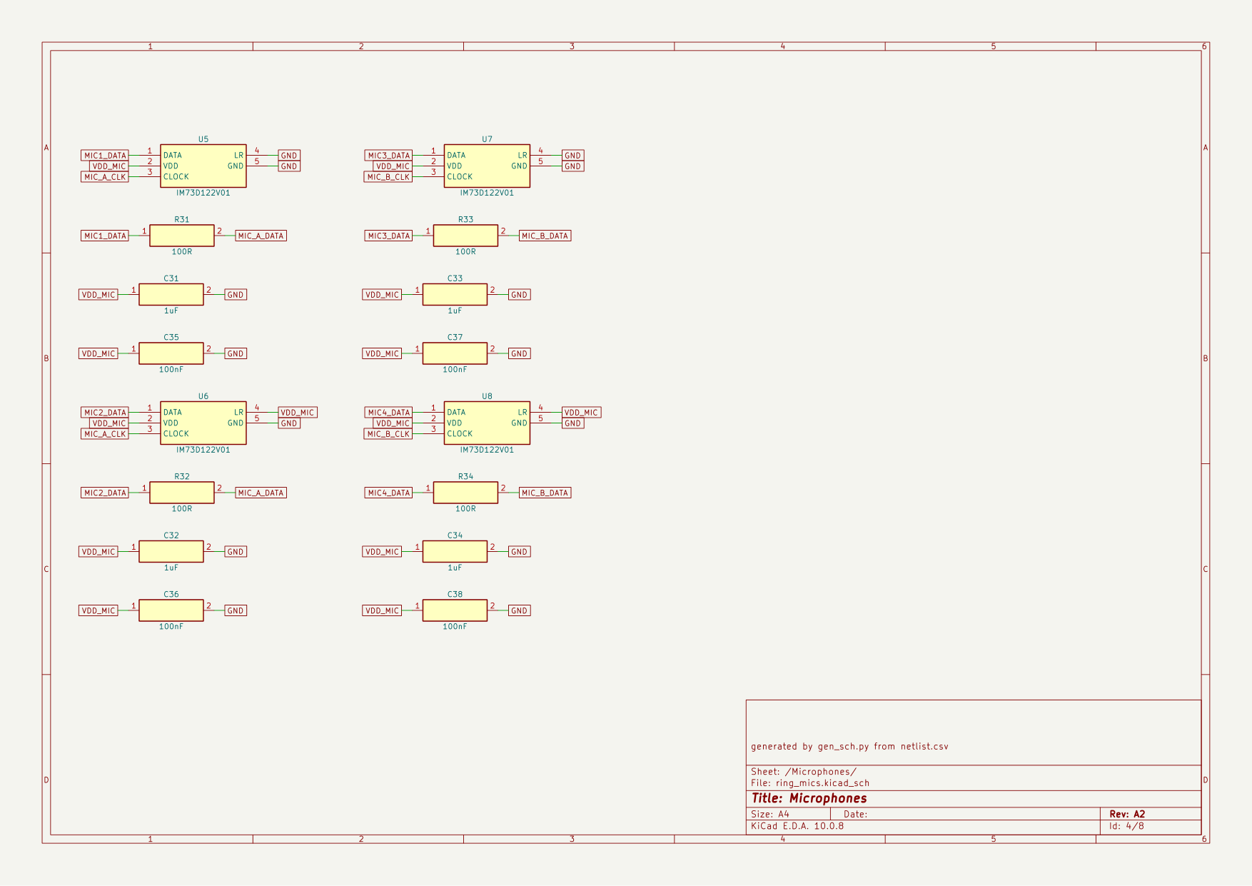
design/ecad/ring/evidence/pdf_t5_p4.png
