NexusGPT/openring/design/ecad/ring/evidence/pdf_t5_p7.png

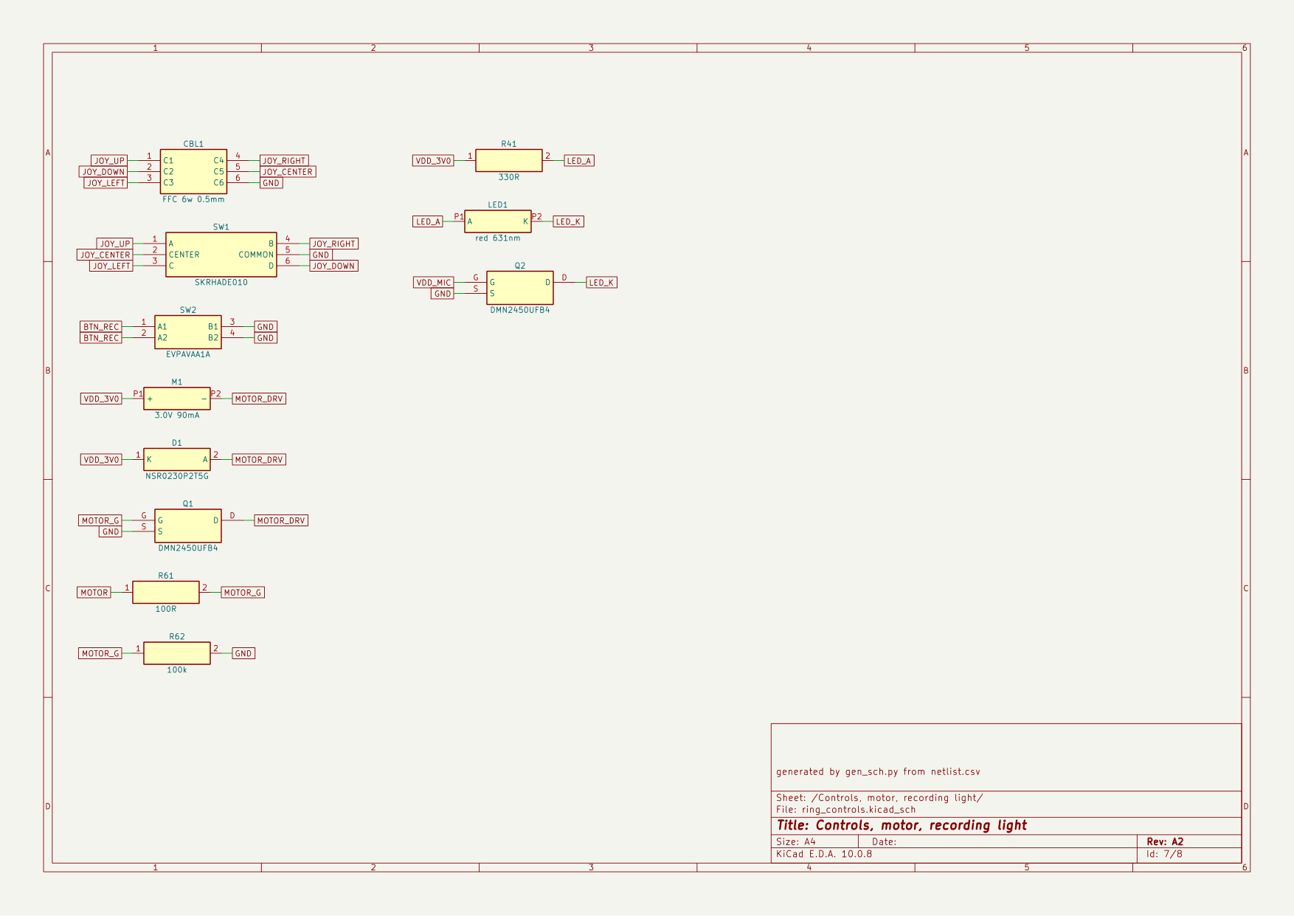
design/ecad/ring/evidence/pdf_t5_p7.png
