NexusGPT/openring/design/ecad/ring/evidence/pdf_t5_p8.png

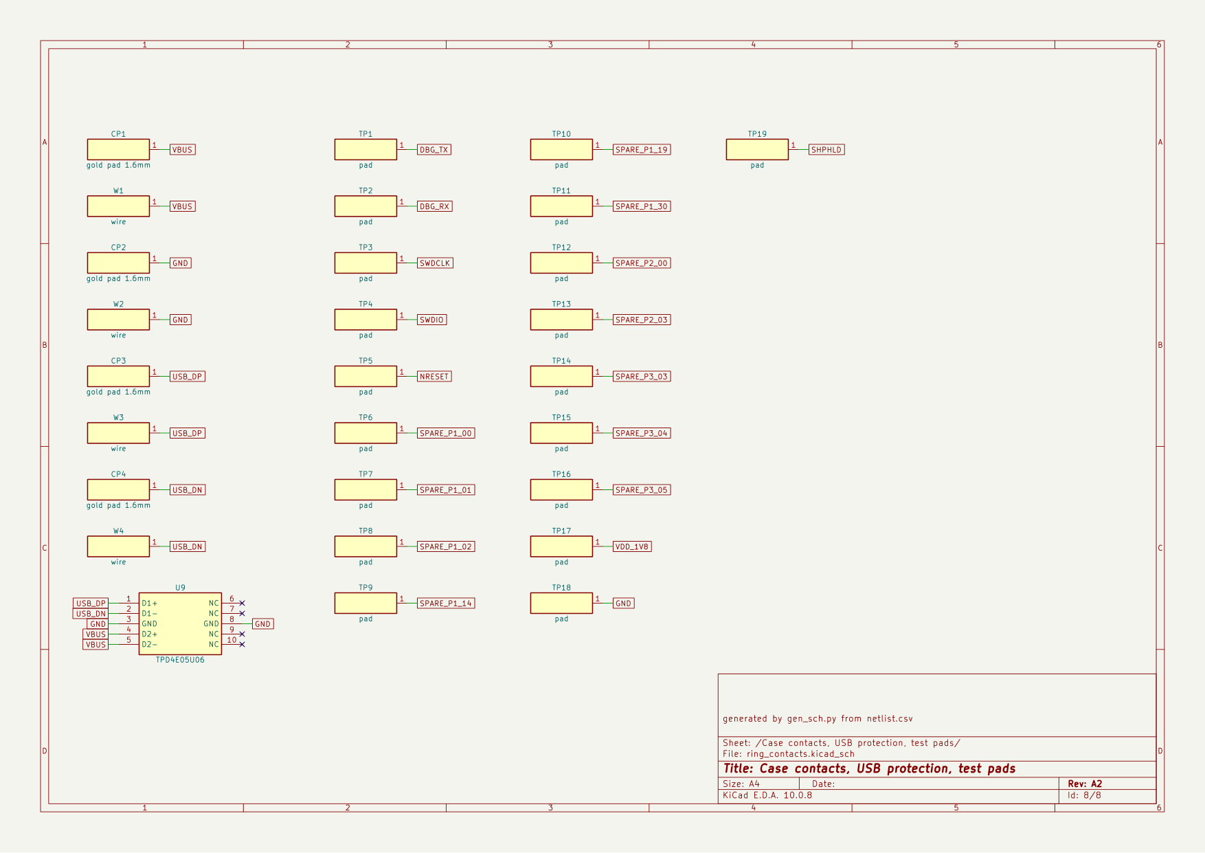
design/ecad/ring/evidence/pdf_t5_p8.png
