NexusGPT/openring/design/ecad/ring/evidence/pdf_t6_p1.png

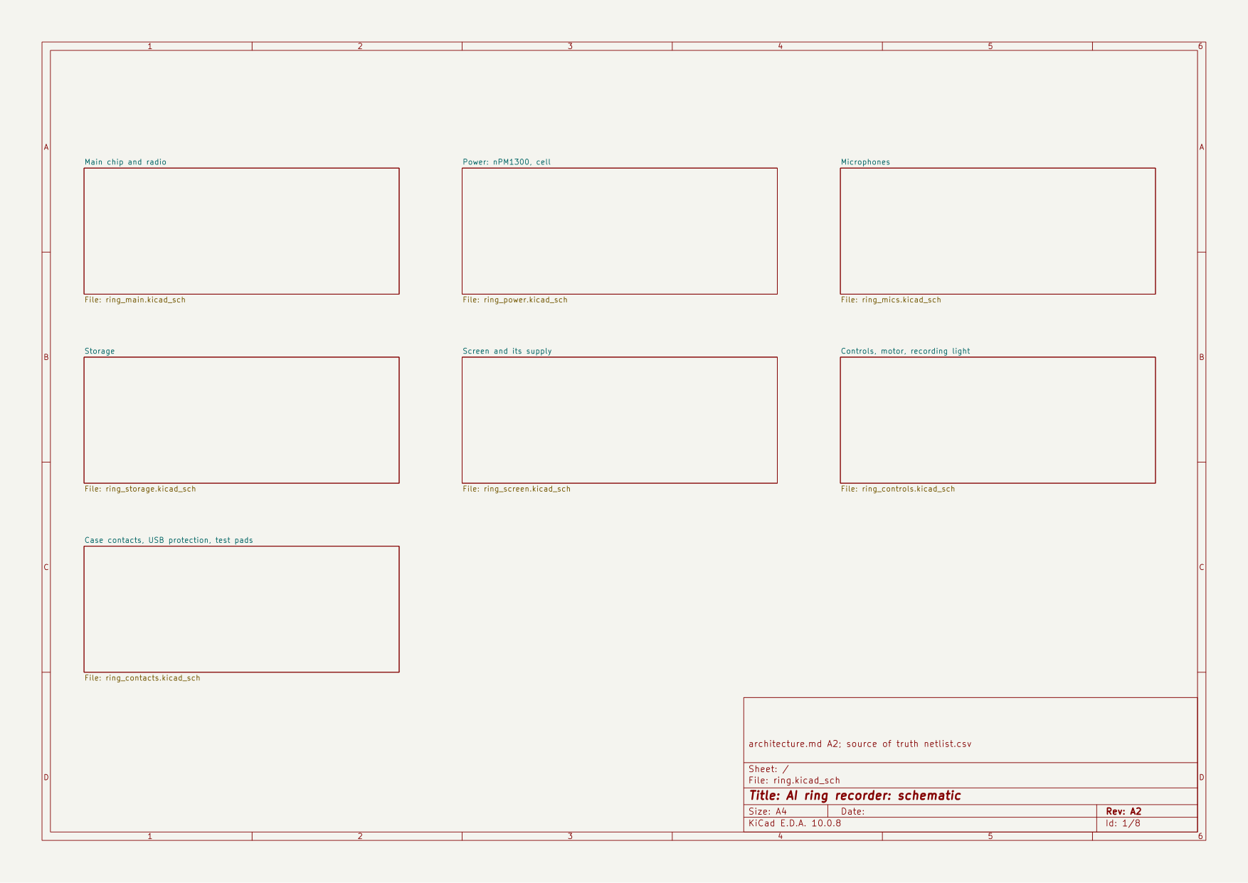
design/ecad/ring/evidence/pdf_t6_p1.png
