NexusGPT/openring/design/ecad/ring/evidence/pdf_t7_p7.png

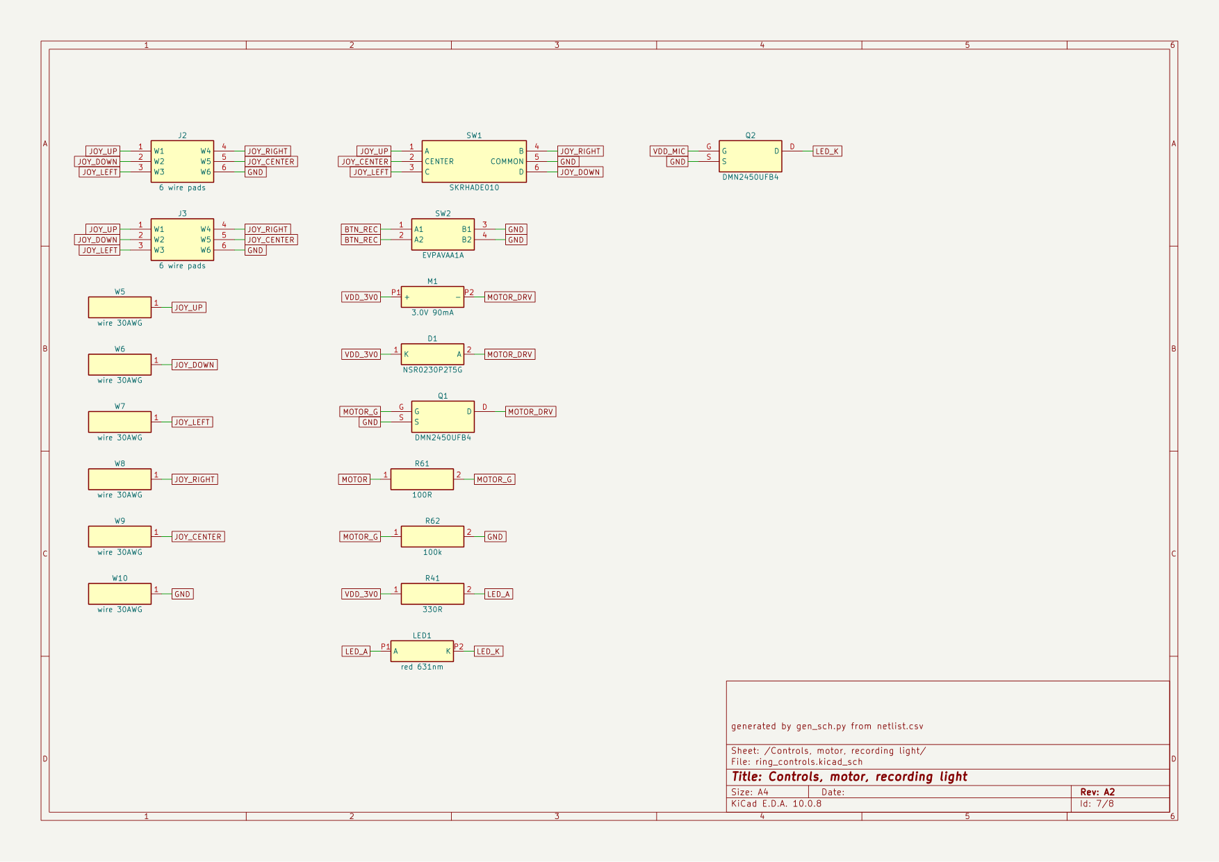
design/ecad/ring/evidence/pdf_t7_p7.png
