NexusGPT/openring/design/ecad/ring/evidence/pdf_v7_final_p7.png

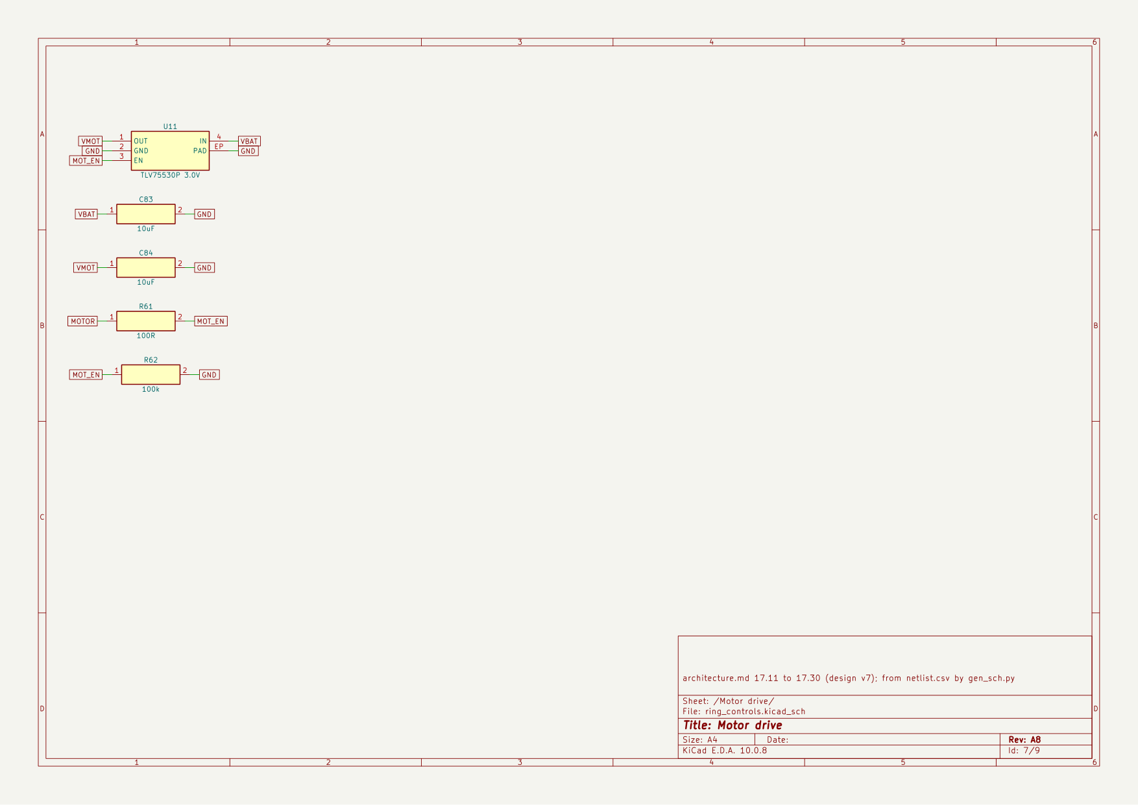
design/ecad/ring/evidence/pdf_v7_final_p7.png
