NexusGPT/openring/design/ecad/ring/pcb/evidence/dbg_top.png

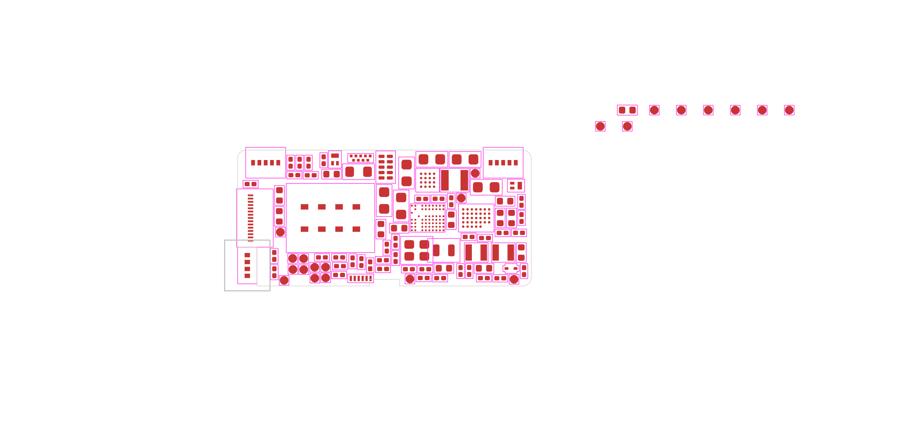
design/ecad/ring/pcb/evidence/dbg_top.png
