NexusGPT/openring/design/ecad/ring/pcb/evidence/r2/s1/fixed_F.png

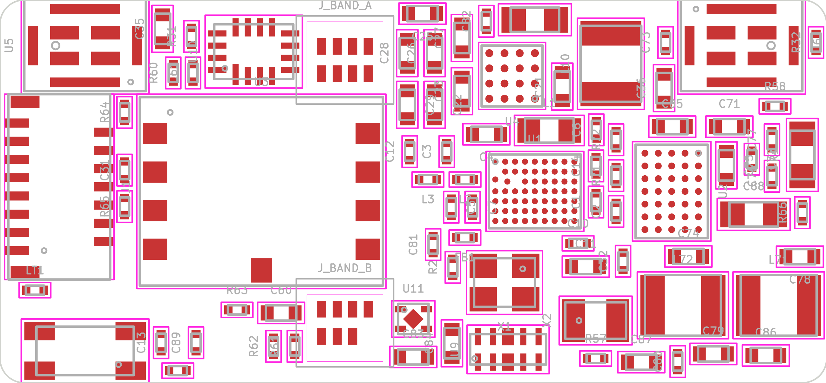
design/ecad/ring/pcb/evidence/r2/s1/fixed_F.png
