NexusGPT/openring/design/ecad/ring/pcb/evidence/r2/s6/p8-In2.Cu.png

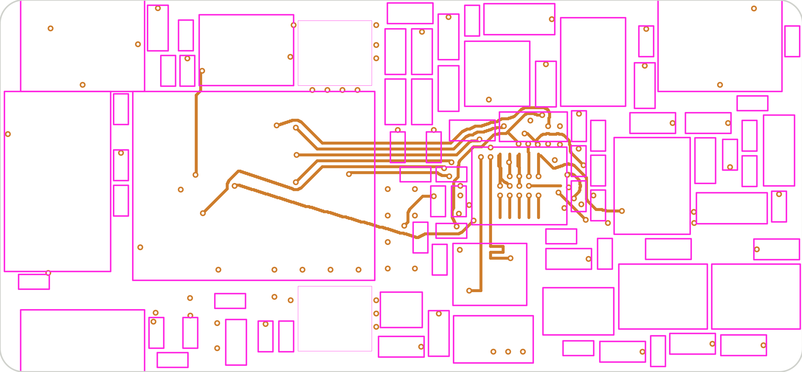
design/ecad/ring/pcb/evidence/r2/s6/p8-In2.Cu.png
