NexusGPT/openring/design/ecad/ring/pcb/fallback-417/board-bottom.png

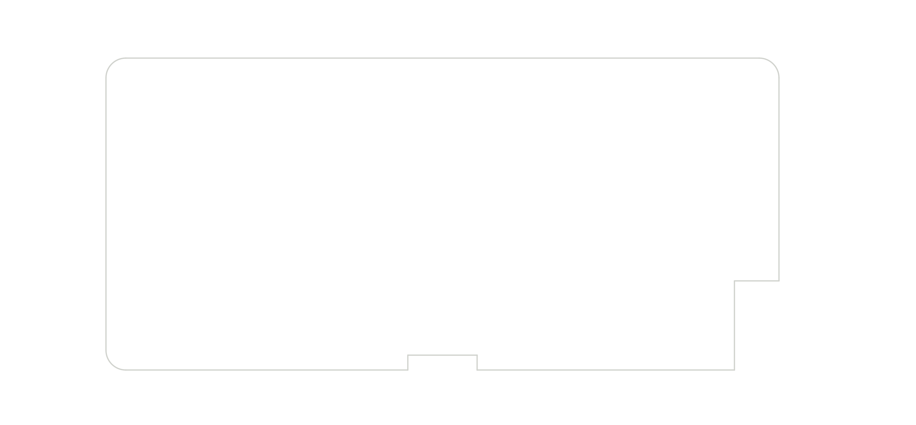
design/ecad/ring/pcb/fallback-417/board-bottom.png
