NexusGPT/openring/design/ecad/ring/pcb/fallback-417/board-top.png

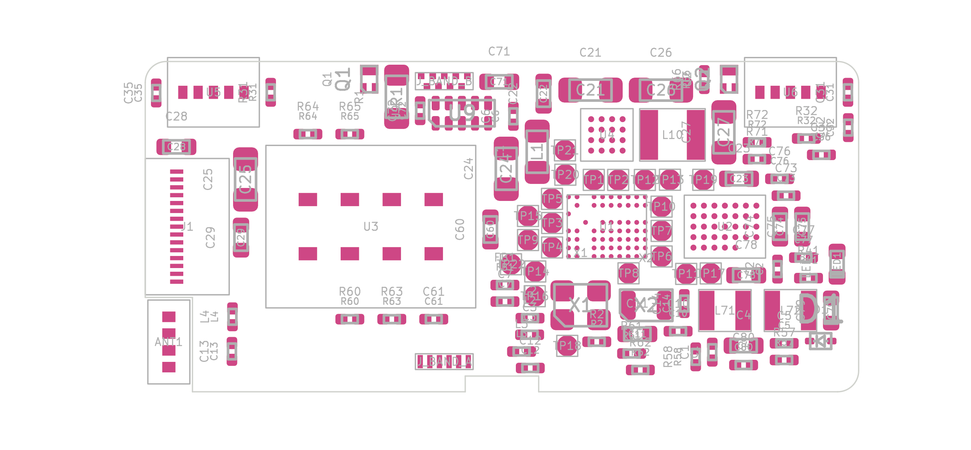
design/ecad/ring/pcb/fallback-417/board-top.png
