NexusGPT/openring/design/look/s1/out/merged32h-us9-before-after.png

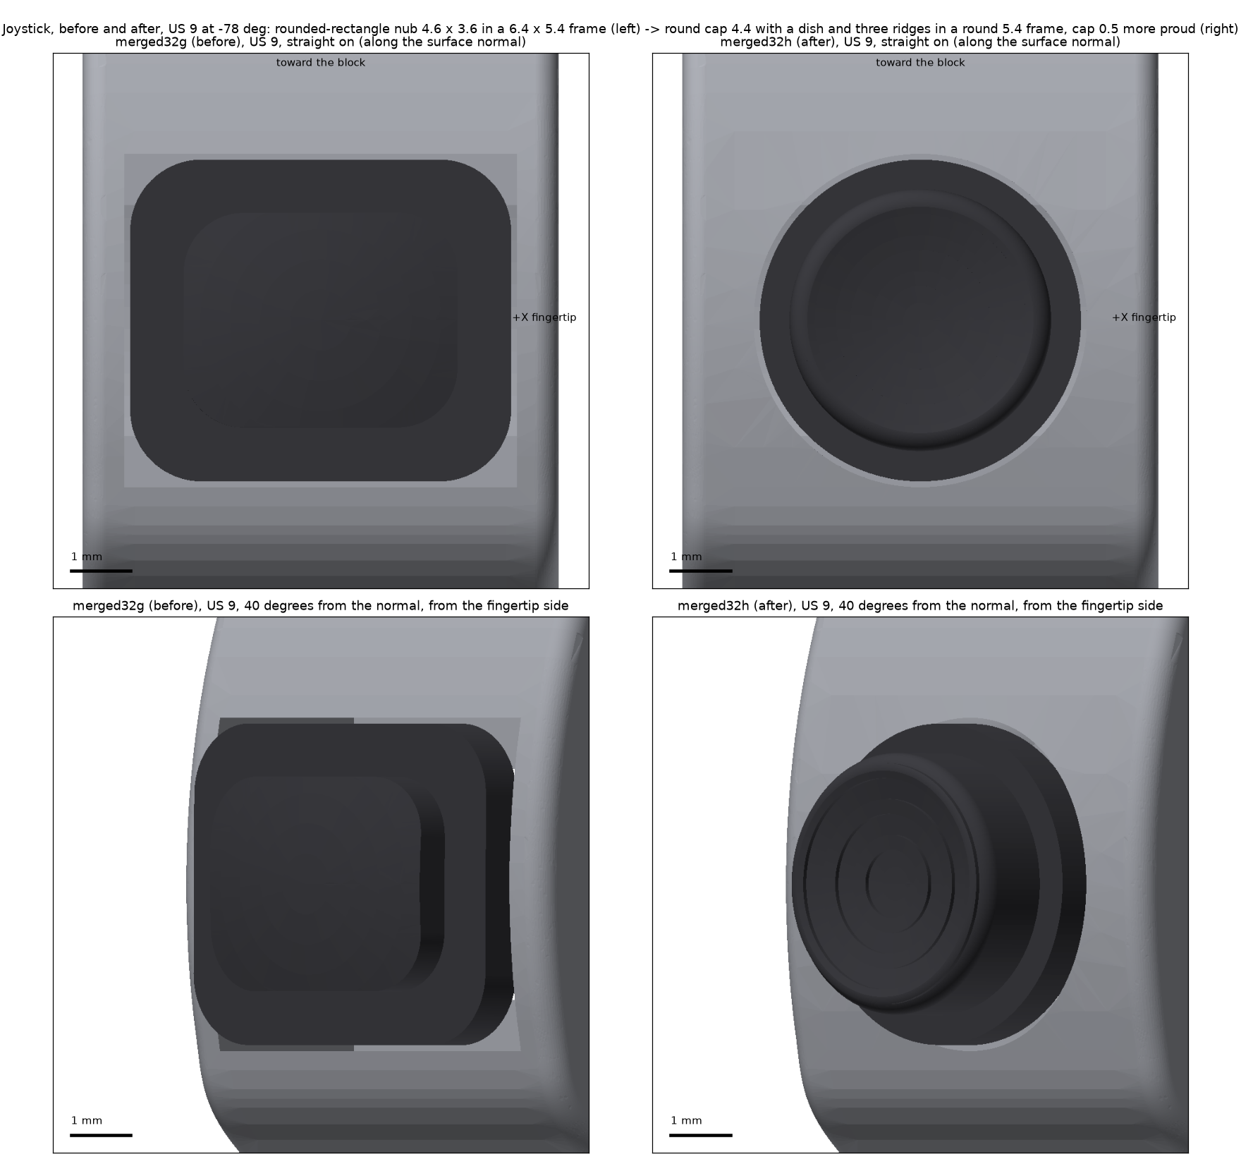
design/look/s1/out/merged32h-us9-before-after.png
