NexusGPT/openring/design/look/s1/pictures-417/merged417flatw-us7-side_m.png

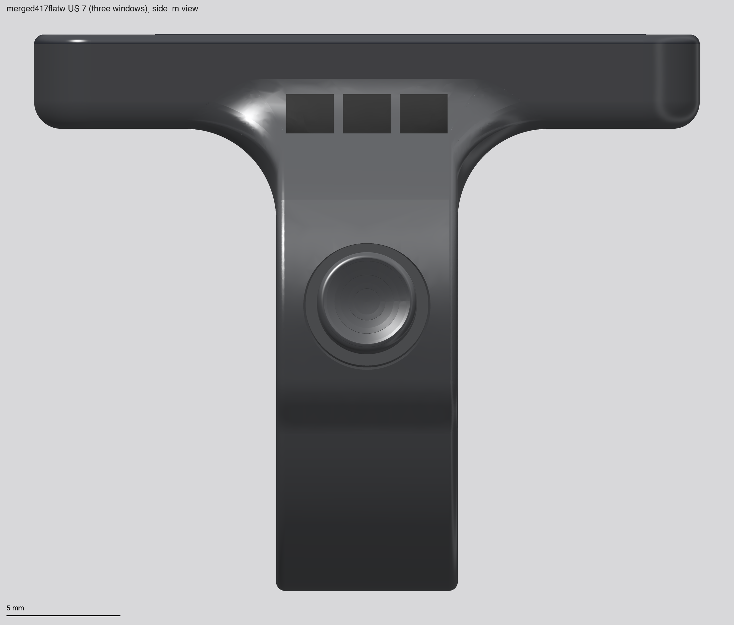
design/look/s1/pictures-417/merged417flatw-us7-side_m.png
