NexusGPT/openring/design/mech/out/section-across-x-6.png

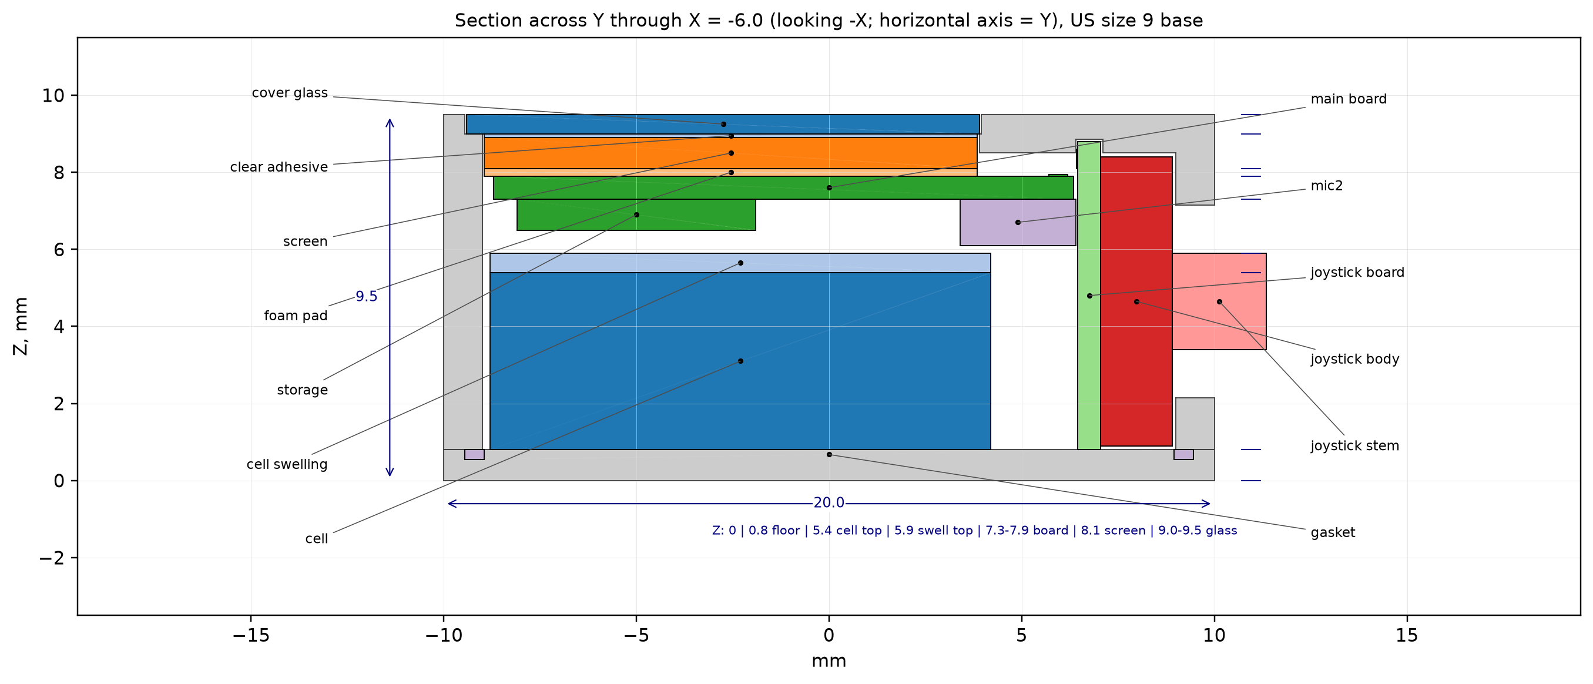
design/mech/out/section-across-x-6.png
