NexusGPT/openring/design/mech/out/section-along-y-2.5.png

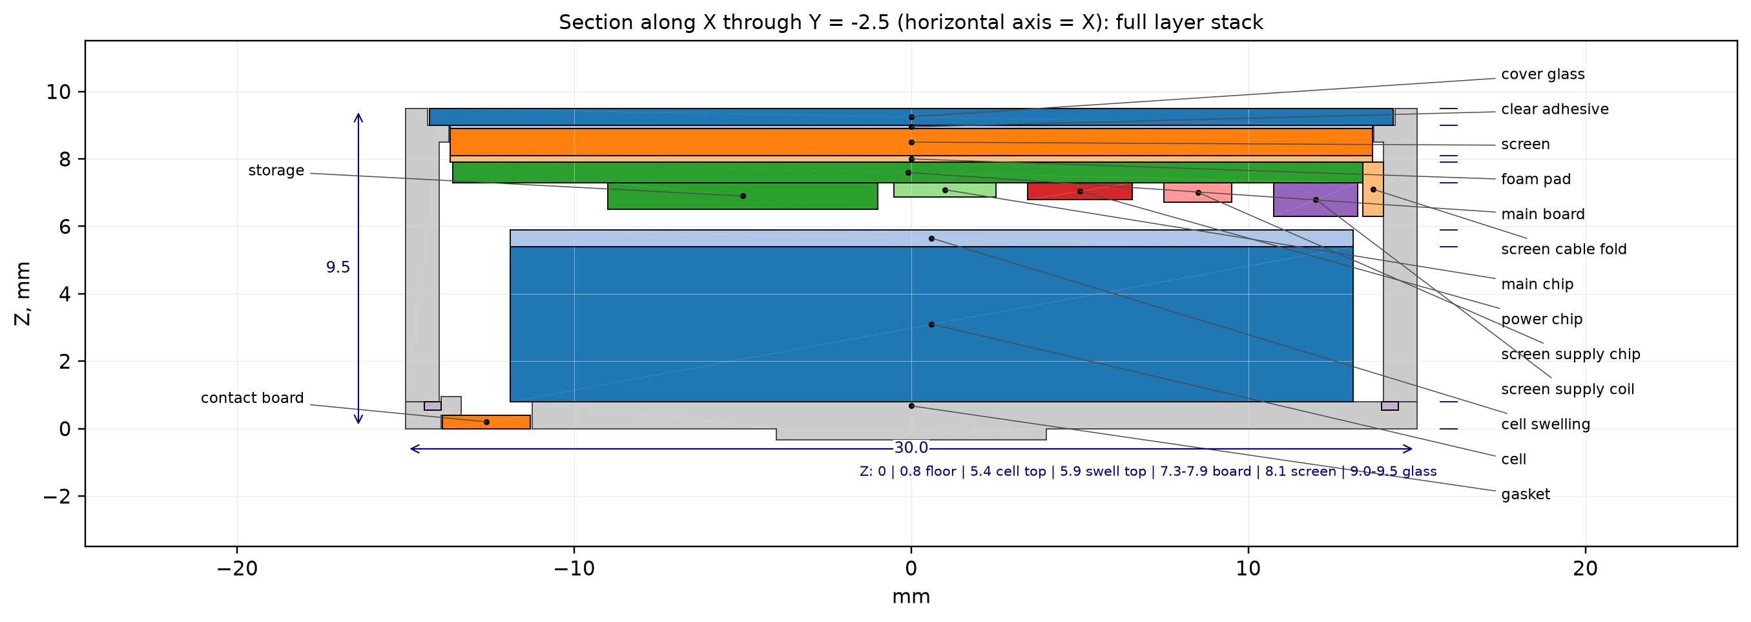
design/mech/out/section-along-y-2.5.png
