NexusGPT/openring/design/mech/out/section-end-x0-bands.png

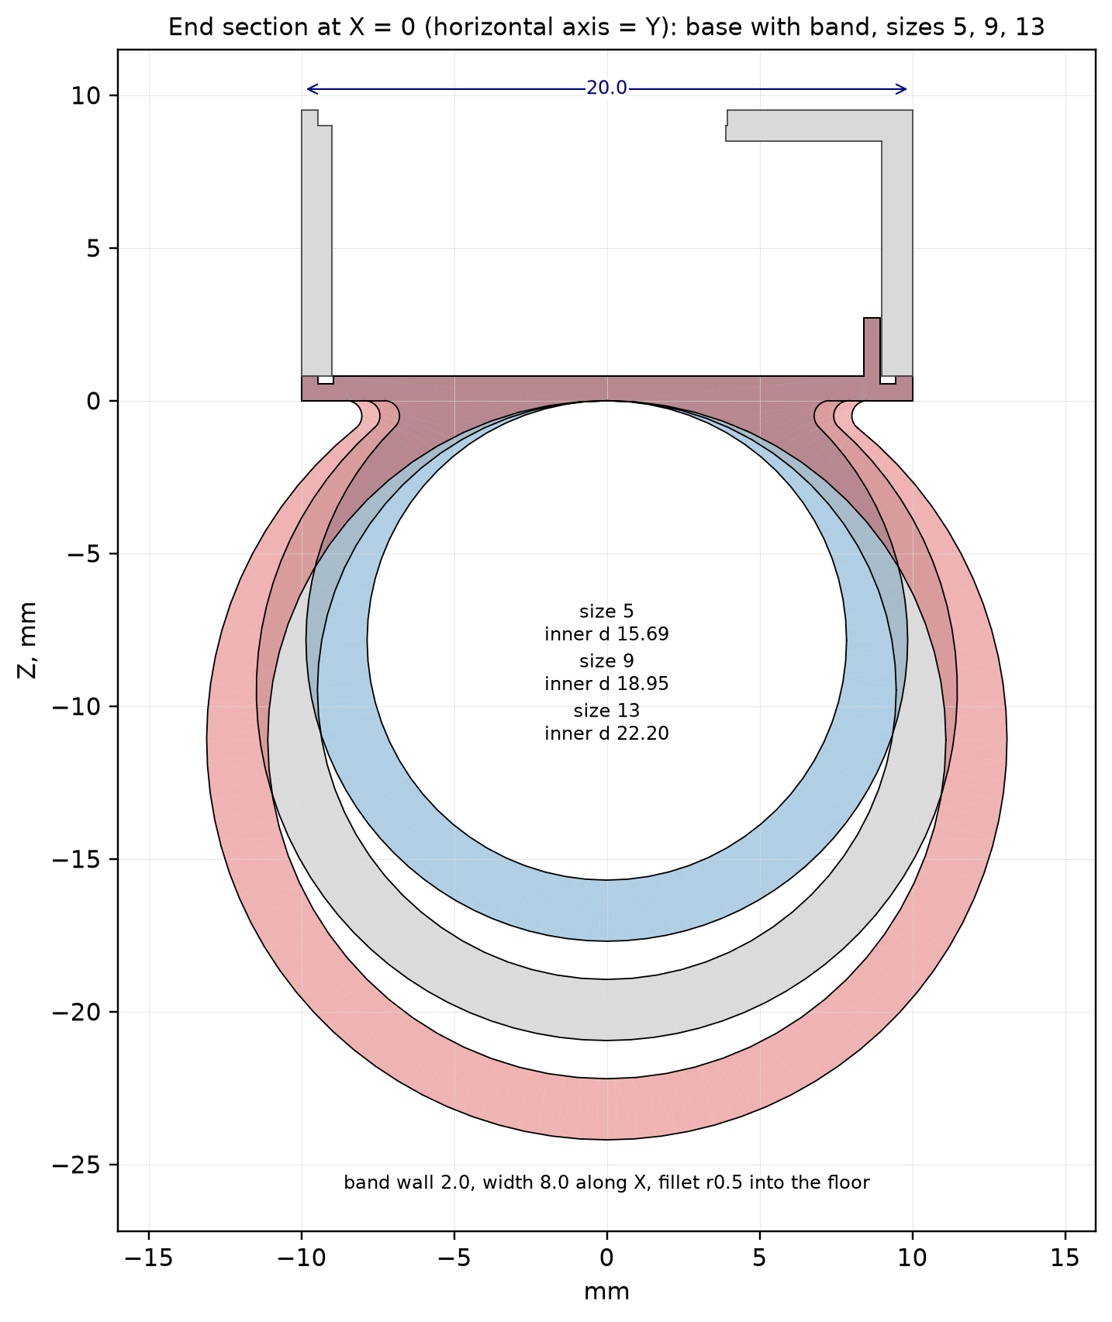
design/mech/out/section-end-x0-bands.png
