NexusGPT/openring/design/mech/out/side-view.png

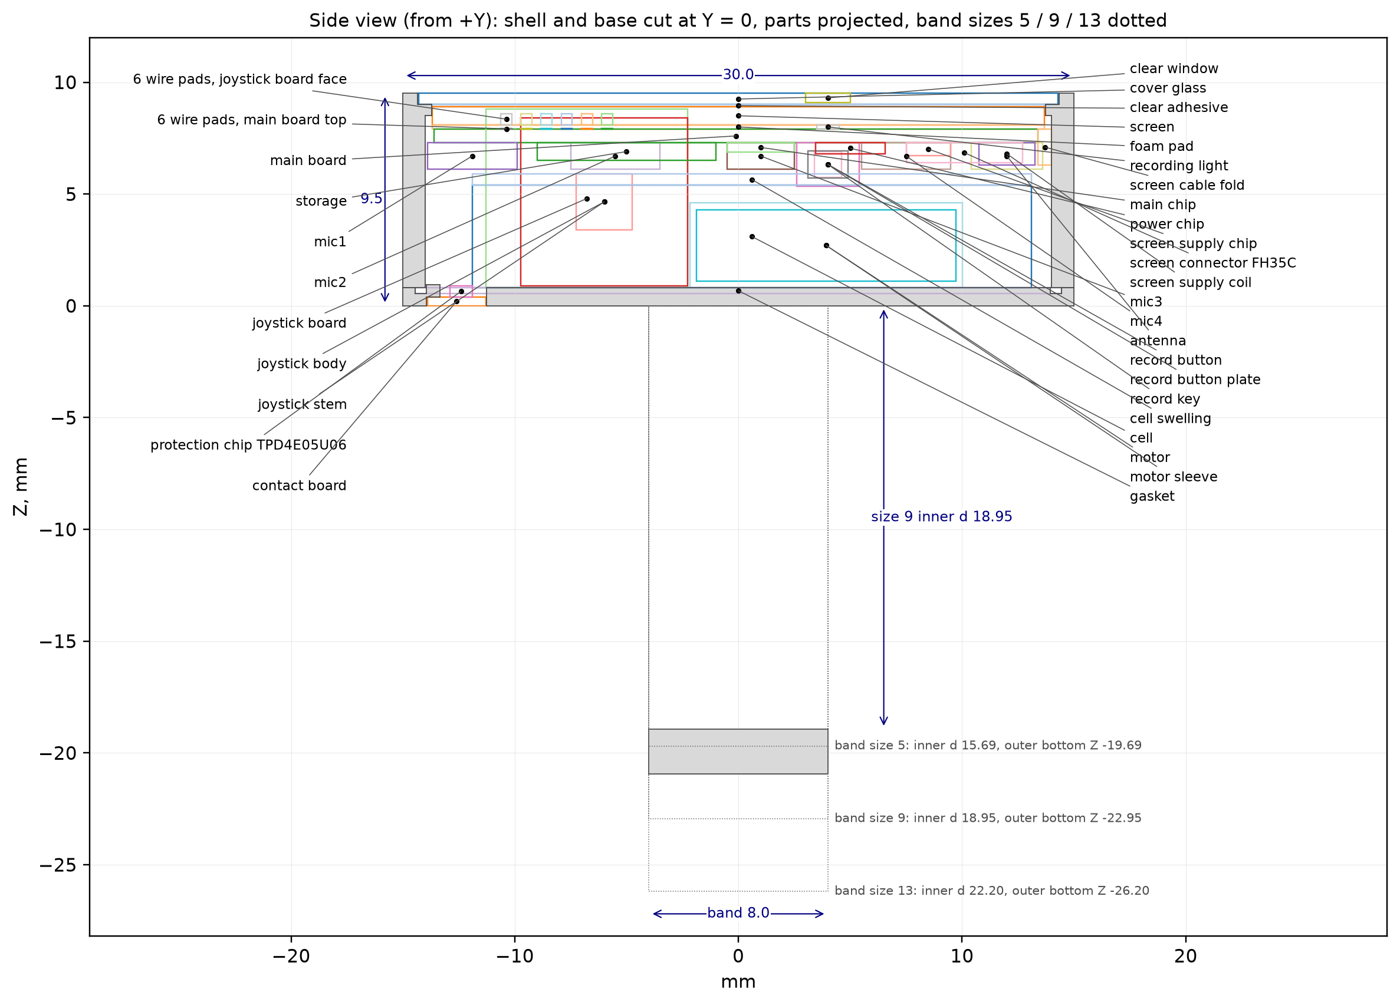
design/mech/out/side-view.png
