NexusGPT/openring/design/mech/out/top-view.png

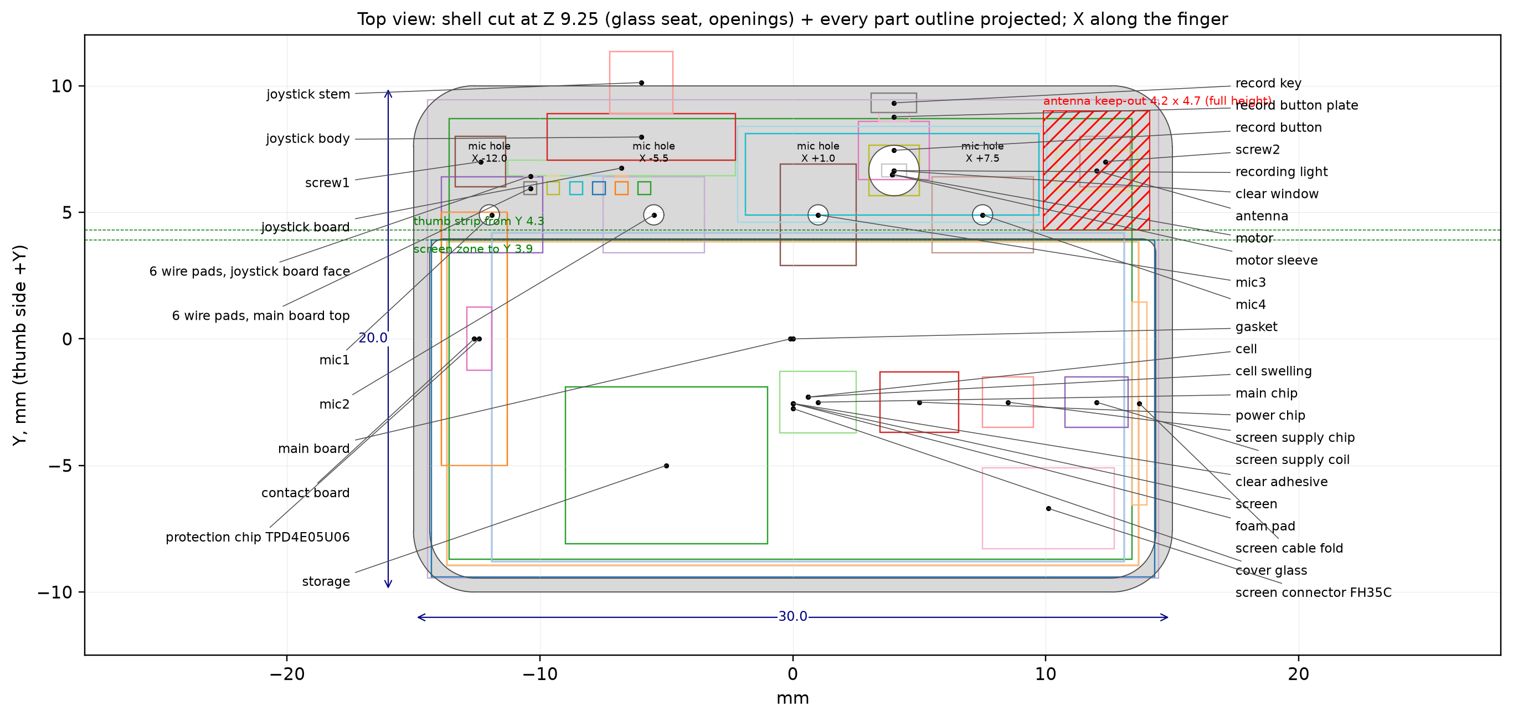
design/mech/out/top-view.png
