NexusGPT/openring/design/mech/thin/out/thin-closeup-board.png

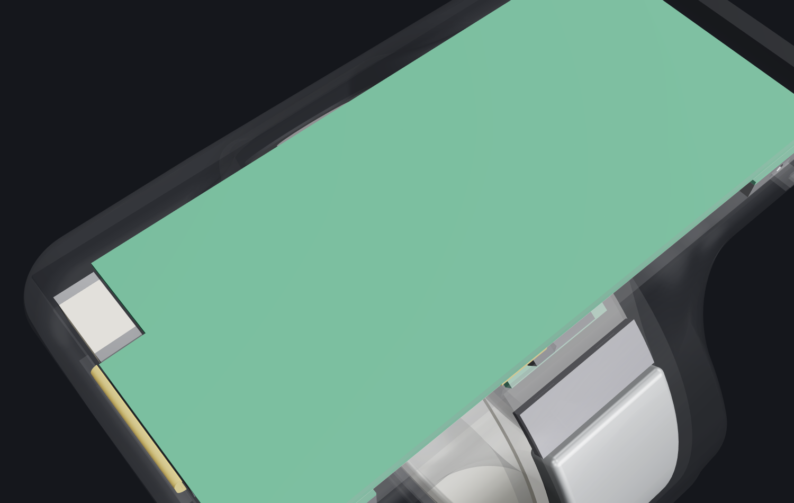
design/mech/thin/out/thin-closeup-board.png
