NexusGPT/openring/design/mech/thin/out/thin-closeup-thumb.png

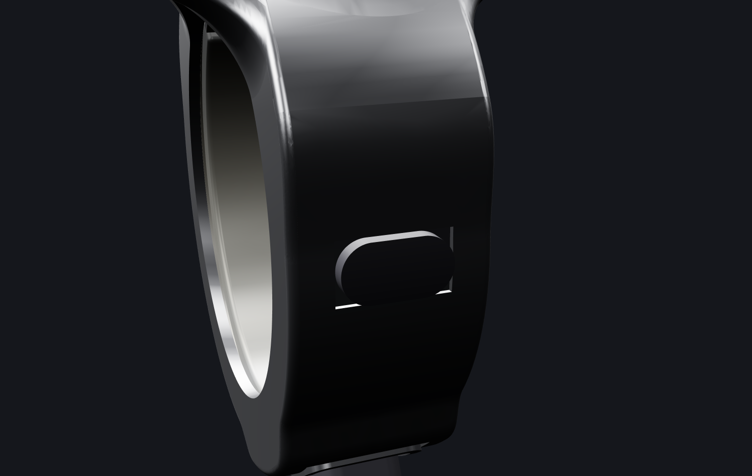
design/mech/thin/out/thin-closeup-thumb.png
