NexusGPT/openring/design/mech/thin/out/thin-closeup-under.png

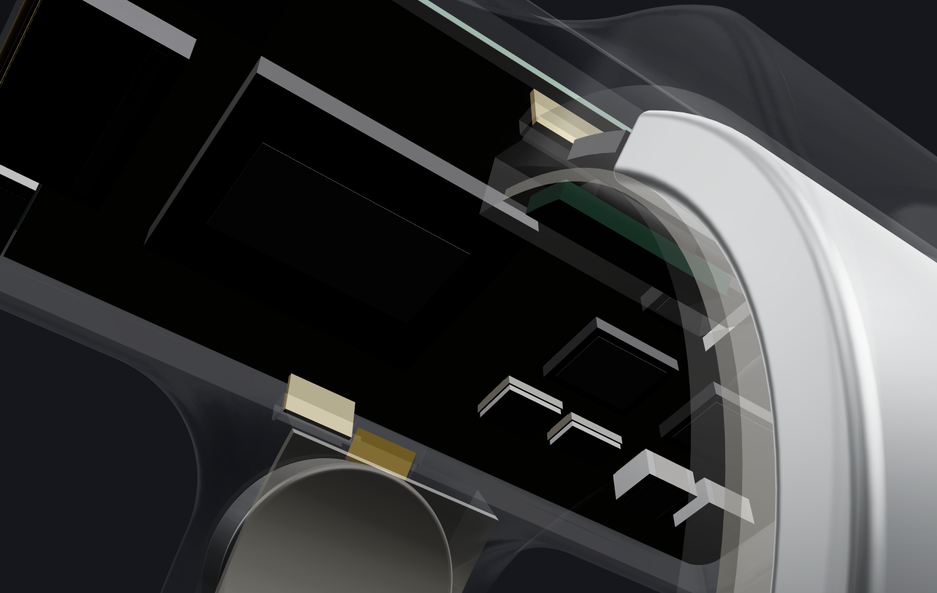
design/mech/thin/out/thin-closeup-under.png
