NexusGPT/openring/design/mech/thin/out/thin-exploded.png

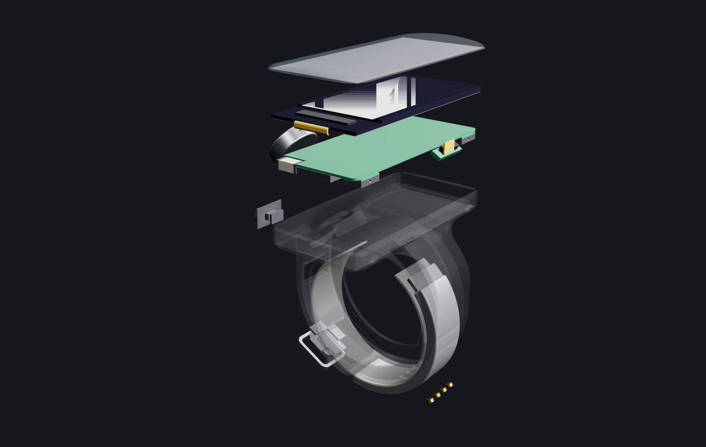
design/mech/thin/out/thin-exploded.png
