NexusGPT/openring/design/mech/thin/out/v7-export/sheet_body-us7.png

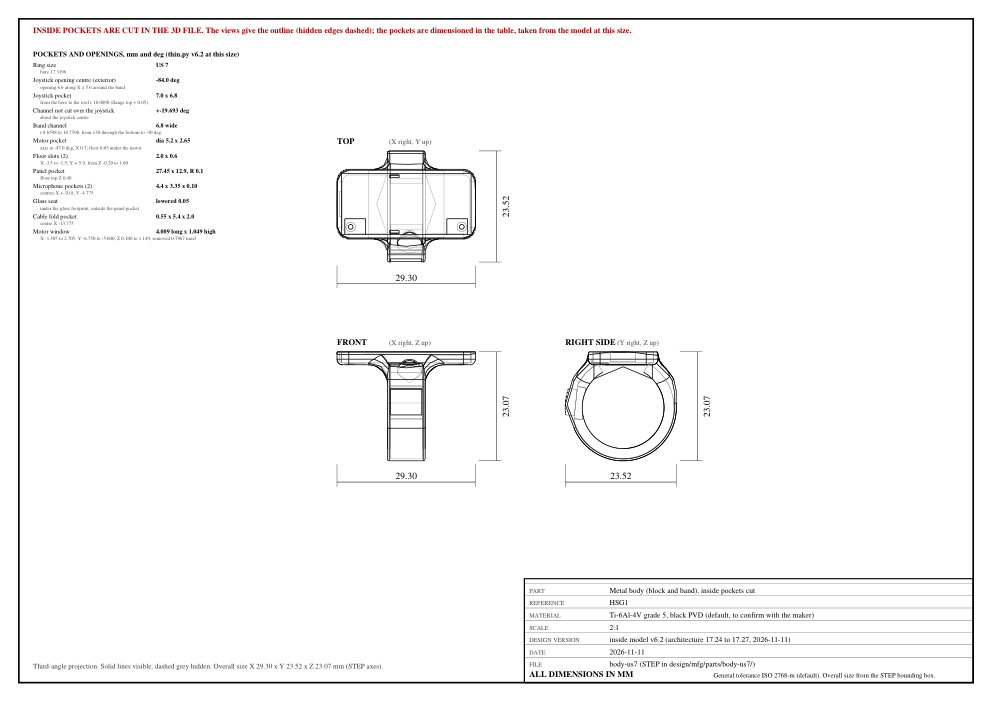
design/mech/thin/out/v7-export/sheet_body-us7.png
