NexusGPT/openring/design/mech/thin/out/v7-export/sheet_body.png

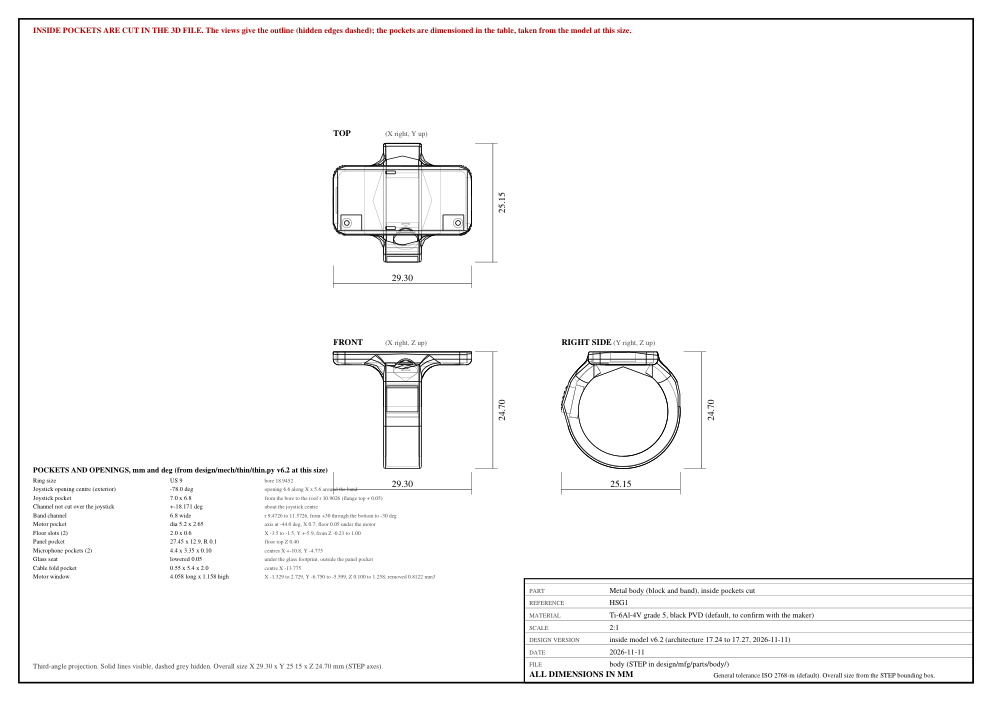
design/mech/thin/out/v7-export/sheet_body.png
