NexusGPT/openring/design/mfg/specs/screen-panel-work/pictures/panel-envelope-final.png

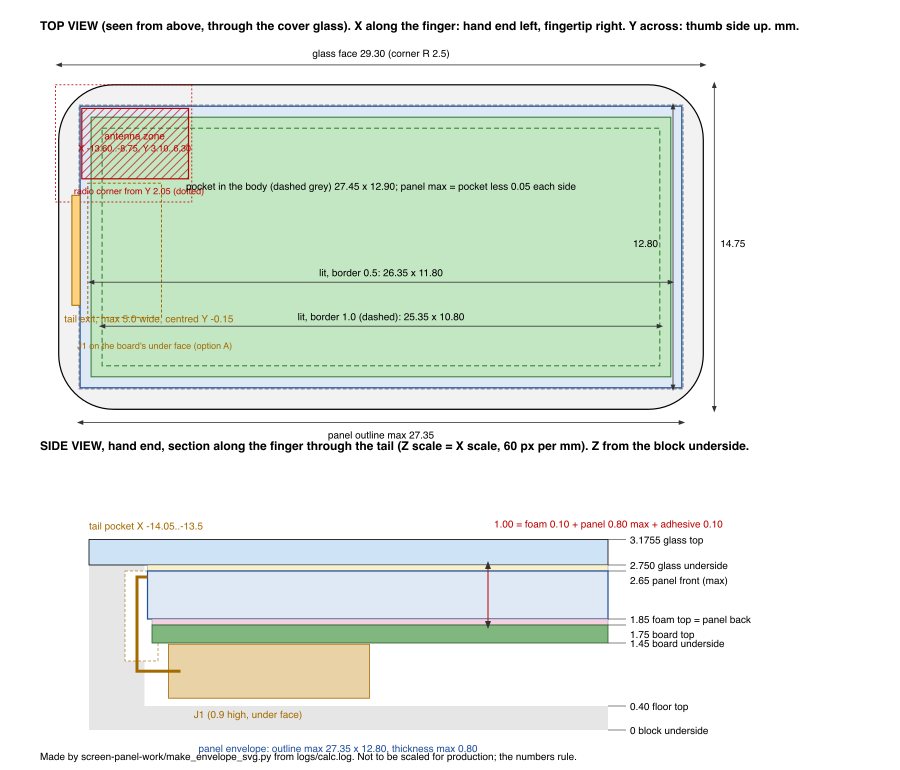
design/mfg/specs/screen-panel-work/pictures/panel-envelope-final.png
