NexusGPT/openring/design/software/os/screens/charging.png

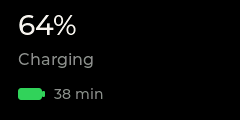
design/software/os/screens/charging.png
