NexusGPT/openring/design/software/os/screens/confirm.png

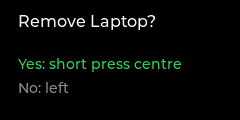
design/software/os/screens/confirm.png
