NexusGPT/openring/design/software/os/screens/control-agent.png

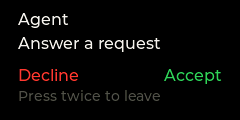
design/software/os/screens/control-agent.png
