NexusGPT/openring/design/software/os/screens/control-media.png

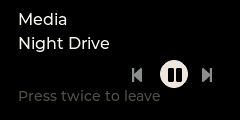
design/software/os/screens/control-media.png
