NexusGPT/openring/design/software/os/screens/control-pointer.png

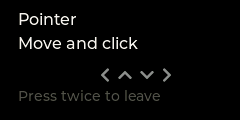
design/software/os/screens/control-pointer.png
