NexusGPT/openring/design/software/os/screens/devices.png

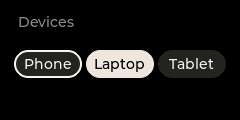
design/software/os/screens/devices.png
