NexusGPT/openring/design/software/os/screens/menu.png

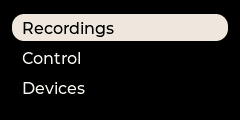
design/software/os/screens/menu.png
