NexusGPT/openring/design/software/os/screens/message-battery-low.png

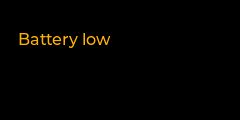
design/software/os/screens/message-battery-low.png
