NexusGPT/openring/design/software/os/screens/modes.png

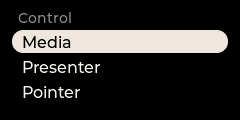
design/software/os/screens/modes.png
