NexusGPT/openring/design/software/os/screens/notification.png

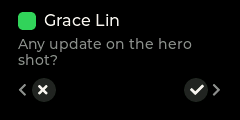
design/software/os/screens/notification.png
