NexusGPT/openring/design/software/os/screens/notifications-empty.png

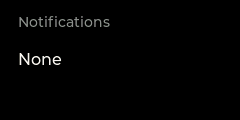
design/software/os/screens/notifications-empty.png
