NexusGPT/openring/design/software/os/screens/notifications.png

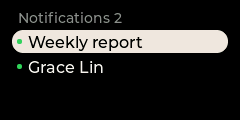
design/software/os/screens/notifications.png
