NexusGPT/openring/design/software/os/screens/pairing.png

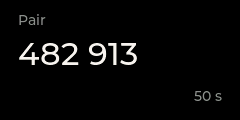
design/software/os/screens/pairing.png
