NexusGPT/openring/design/software/os/screens/recording-highlight.png

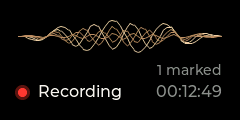
design/software/os/screens/recording-highlight.png
