NexusGPT/openring/design/software/os/screens/recording-idle.png

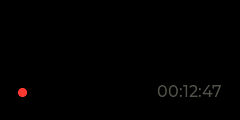
design/software/os/screens/recording-idle.png
