NexusGPT/openring/design/software/os/screens/recording.png

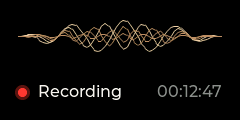
design/software/os/screens/recording.png
