NexusGPT/openring/design/software/os/screens/settings.png

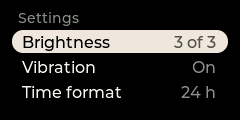
design/software/os/screens/settings.png
