NexusGPT/openring/design/software/os/screens/status.png

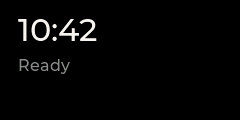
design/software/os/screens/status.png
