NexusGPT/openring/docs/images/screen-designs.png

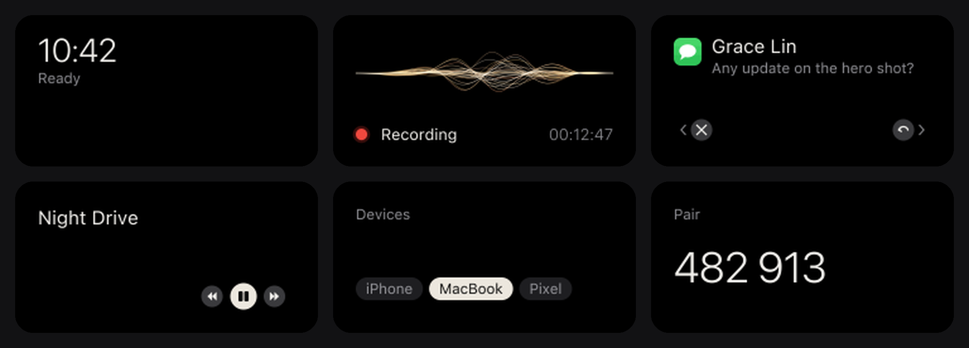
docs/images/screen-designs.png
