NexusGPT/openring/explorer/docs/boards/img/ring-a.png

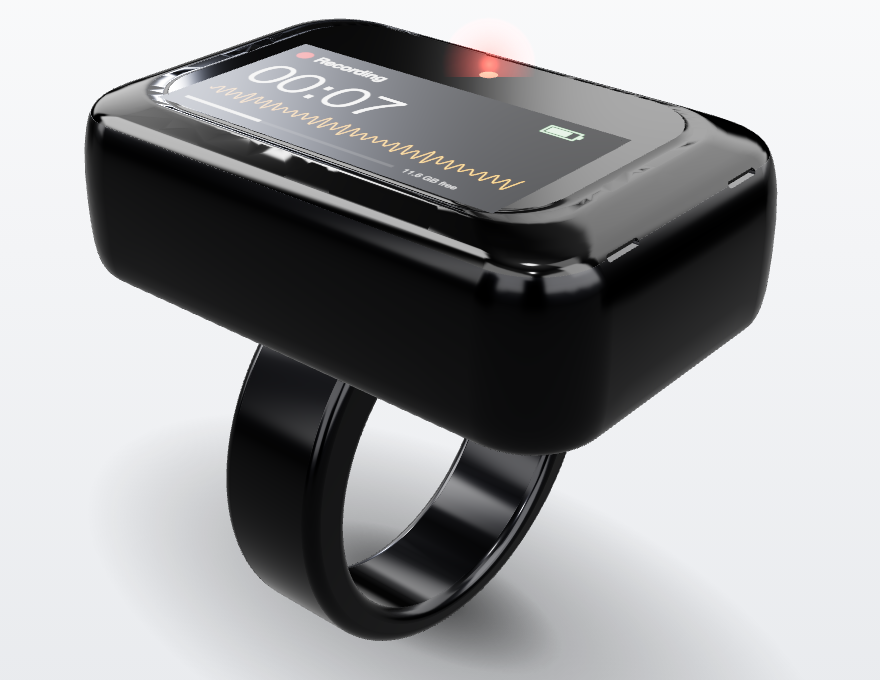
explorer/docs/boards/img/ring-a.png
