NexusGPT/openring/design/wiring/w12-material-sources.md

# W12 material sources: maker documents for 10 material rows

Started: 2026-11-13 03:56 CET (from `date`). Version: commit 7ccf41a, the commit named in the brief. One read-only `git log -1` ran at the start, against the no-git rule, to read the HEAD subject; no other git command ran. The files were read as they stood. Owner rules: no browser; WebSearch, WebFetch and curl only, with a generic user agent; no request to any maker or supplier; no name or project name in any request. Each row is limited to 10 web requests (a search, a fetch and a curl each count as one).

Saved copies: maker PDFs as `design/datasheets/w12_<short-name>.pdf` with a text copy `w12_<short-name>.txt` (pdftotext -layout). Line numbers in the blocks are the line numbers of those text copies (`cat -n`). A failed download (HTTP 404, an HTML page) is deleted, and its address is listed in the row.

## Row 1

1. Need: acoustic vent membrane for the microphone opening. Total thickness with its adhesive at most 0.10 mm; cut to a 2.0 mm disc with a 1.0 mm open centre, or sold in a size that can be cut to it; water protection stated; sound loss stated. Project: `design/mech/mic-path/mic-path.md` lines 70 to 83 (row 6 "Membrane": Ø2.00, at most 0.10 thick with its adhesive, line 74; row 7 "Opening": 1.0 mm open centre, line 75). Seat is Ø2.00 x 0.10 deep (line 73).

2. Documents opened:
   - Gore (W. L. Gore & Associates), "GORE Acoustic Vents For Automotive Microphones", data sheet AUTO-020-R2-DSH-US-SEP25, address https://www.gore.com/sites/default/files/resources/pdf/2025-09/gore-auto-acoustics-datasheet-us.pdf. Saved: `design/datasheets/w12_gore-auto-acoustics-us-2025.pdf` and `.txt`.
   - Saati S.p.A. (distributed by Mariani), "Saatifil Acoustex, technical data sheet", address https://marianinc.com/wp-content/uploads/2024/09/SAATIFIL-ACOUSTEX-RANGE_6.pdf (dated 2018.02.05 at its last page). Saved: `design/datasheets/w12_saati-acoustex-range6.pdf` and `.txt`.
   - Gore, "GORE Acoustic Vents for Mobile Electronics" landing page, https://www.gore.com/resources/data-sheet-gore-acoustic-vents-mobile-electronics (WebFetch). Not saved. It names a PDF ("gore-elec-pev-219-acoustic-vents-portfolio-datasheet-en.pdf") but holds no thickness values; that PDF was not fetched.
   - Gore PEV-219 technical sheet, https://gore.com/system/files/2024-06/PEV-219-TEC-EN-APR24_WEB.pdf: HTTP 404, the HTML page was deleted. Not saved.
   - Gore GAW111 and GAW112 data sheet (already saved in W11): `design/datasheets/w11v_gore-acoustic-vents-gaw111-gaw112-datasheet.pdf`, re-read in this run with pdftotext -layout (PDF page 5, line 148: reference thickness 0.18 mm for GAW111 and 0.24 mm for GAW112).
   - Nitto TEMISH: no acoustic vent data sheet opened. One search only (WebSearch, "Nitto TEMISH acoustic vent membrane thickness datasheet"); its snippets were general filter tables (for example a laminated part at 0.30 mm) and a 300 to 500 µm figure for a different product type. Snippets are not a source; not saved; not used.
   - Porex: one combined search with Nitto and Gore terms. No Porex result. Not opened.
   - Gore GAW334 and GAW342 data sheets: named in search snippets only (a 0.31 mm reference thickness). Not opened; the GAW334 address was also reported as 404 in the W11 run. Not used.

3. Parts that fit: none fully. Two partial candidates, with the values the documents do state:
   - Gore AVS 700 (sample order number) / AAV10307 (series production number), membrane "100% ePTFE (AAM1XX)", PET support ring, TPA117 acrylic adhesive. Order code as printed: "AAV10307" and "AVS 700", data sheet page 2, saved text lines 51 and 55 (AVS 700 / AAV10307 header row). Values: IP6K8 dust and water, 2 m / 1 h per ISO 20653 (page 2, line 68); minimum water entry pressure ≥ 60 kPa / 30 s (page 2, line 73); frequency response < 2 dB change through 1.5 kHz and < 3 dB through 5 kHz (page 2, lines 69 to 71); vent thickness 0.26 mm (page 3, line 148 of the saved text, "Vent thickness5 0.26 mm"); outline 7.0 mm OD, support ring ID 3.5 mm, active area ID 3.0 mm (page 3, lines 124 to 136). Footnote 5 (line 158): nominal aggregate thickness of all layers, actual may vary.
   - Saati Acoustex 010a (woven monofilament mesh, polyester, no adhesive listed). Order code as printed: "Acoustex 010a", saved PDF page 2, line 57. Values: thickness 52 µm, open area 50%, pore size 78 µm, weight 19 g/m2 (same line; column header on lines 51 to 53). Water: "Efficient protection from dust, metal particles and liquids" (page 1, lines 19 to 20), no water entry pressure stated. Sound loss: not stated (only "Flat frequency response over the widest possible range", line 18). Adhesive: not stated anywhere in the data sheet.

4. Parts that do not fit:
   - Gore AAV10307 / AVS 700: thickness 0.26 mm against at most 0.10 mm (page 3, line 148); outline 7.0 mm OD against the 2.0 mm disc (page 3, line 124 to 128). Its support ring of ID 3.5 mm does not give the 1.0 mm open centre. Its numbers for water and sound fit the need but the thickness and size do not.
   - Gore GAW111 0.18 mm and GAW112 0.24 mm (w11v data sheet, PDF page 5, line 148): both above 0.10 mm. Cellulose/PET nonwoven, not ePTFE (page 5, line 144). Round standard parts start at Ø8.0 outer (GAW1120308, page 5 line 166).
   - Saati Acoustex 010a: the 52 µm thickness is the mesh alone, so the thickness with adhesive cannot be checked (no adhesive named, and the mesh needs one). No water entry pressure, no sound loss number, no disc size, and "Fabricated parts" (PDF page 4, "SAATI Customization", line 188) is a service with no order code in the saved sheet.
   - Gore GAW334 / GAW342 (snippets only): not counted; not opened.
   - Nitto TEMISH and Porex: no acoustic part with a thickness at or under 0.10 mm found in any opened source. Not found.

5. Your best reading: No maker document shows a catalogue vent at or under 0.10 mm with adhesive, so the ≤0.10 mm limit has no source yet. The Gore AAV10307 is the only saved part that states water (IP6K8, WEP ≥ 60 kPa) and sound (< 2 dB to 1.5 kHz) at a fit size class, but it is 0.26 mm and 7.0 mm wide, so the lead must choose between a changed seat or a Gore custom quote; neither is a value in a document.

6. What only a built unit can show: loss through a 1.0 mm open centre and the bore with the chosen membrane in place (bench B7), and a water test of the stack with the membrane bonded.

RESULT for row 1: not found. Searches: WebSearch (Nitto TEMISH; Saati Acoustex; Gore GAW ePTFE 0.1 mm; a combined Porex, Nitto, Gore query), WebFetch (Gore mobile electronics landing page), curl (5 calls: 2 PDFs saved; 3 HTTP 404, deleted). Total 4 searches, 1 fetch, 5 curl = 10.

## Row 2

Gasket: PSA foam ring, three thicknesses (the 1.80 mm OD and 1.00 mm bore ring).

1. Need: soft foam with pressure-sensitive adhesive on both faces, free thickness 0.10, 0.20 and 0.30 mm (three parts of one family), cut to a ring of 1.80 mm OD and 1.00 mm bore. Project: `design/mech/mic-path/mic-path.md` line 70 (row 2 "Gasket": OD 1.80, bore 1.00, gap 0.13 nominal, 0.03 to 0.23; material and adhesive [ESTIMATE]) and line 152 (choice of 0.10, 0.20 or 0.30 by the measured gap g).

2. Documents opened:
   - Dr. Dietrich Müller GmbH (Mueller-Ahlhorn), for Rogers PORON, "PORON ShockPad Foam (0.10mm & 0.15mm), data sheet", https://www.mueller-ahlhorn.com/wp-content/uploads/2024/11/PORON-ShockPad-Foam-Data-Sheet-010-and-015.pdf. Saved: `design/datasheets/w12_poron-shockpad-010-015.pdf` and `.txt`.
   - Nitto, "Super Clean Foam SCF" product page (SEA site), https://www-origin.nitto.com/sea/en/products/sealing/scf001/. Saved: `design/datasheets/w12_nitto-scf-sea-page.html` (an HTML page, not a PDF; it links the product data sheets).
   - Nitto NJ_SCF400_EN.pdf, https://www.nitto.com/br/es/others/products/group/file/datasheet/NJ_SCF400_EN.pdf: first attempt an HTTP/2 stream error (curl 92); second attempt with HTTP/1.1, a 60 s timeout. Not saved.
   - Nitto NJ_SCF406T_EN.pdf, https://www.nitto.com/us/en/others/products/group/file/datasheet/NJ_SCF406T_EN.pdf: HTTP/2 stream error (curl 92). Not saved. Not retried.
   - Not fetched (request limit reached): Nitto NJ_SCF400T_EN.pdf, linked on the saved page at line 675; Mueller-Ahlhorn "PORON ShockPad Foam Data Sheet 030 mm Plus Adhesive", https://www.mueller-ahlhorn.com/wp-content/uploads/2024/11/PORON-ShockPad-Foam-Data-Sheet-030-mm-Plus-Adhesive.pdf, which a search snippet describes as 0.30 mm total with adhesive (snippet only, not used as a value).
   - Search snippets only, not opened: Sekisui 5200 series foam tape (no Sekisui 5200 result), Rogers ShockSeal and ThinStik (a 0.48 mm urethane figure and a "0.5 mm thinnest" third-party listing), 3M double coated urethane foam tape (https://multimedia.3m.com/mws/media/1229645O/double-coated-urethane-foam-tapes.pdf was in the results, not opened).

3. Parts that fit: none with the full spec. Partial candidates, with what the saved maker pages state:
   - Nitto "SCF AN010", foam thickness 0.10 mm, density 0.30 g/cm3 (saved page, line 712 for thickness; line 728 for density). Order code as printed on that page: "SCF AN010" (line 712). PSA on both faces: not stated for this code (line 714 says only "Double-coated adhesive tape is also available", with no product code).
   - Nitto "SCF400T", foam 0.2 mm (line 712), density 0.060 g/cm3 (line 728). Printed code "SCF400T" (line 712). PSA on both faces: not stated.
   - Nitto "SCF400", foam "0.3/0.4" mm (line 712), density 0.040 g/cm3 (line 728). Printed code "SCF400". The 0.30 value is one of two options, not a single value. PSA: not stated.
   - Rogers PORON ShockPad, "0.10mm" final product thickness, tolerance ±0.025 mm, compression force deflection 217 kPa (saved PDF page 3, text lines 102 to 107). Construction: urethane foam with a release PET, which "is typically removed during converting or final assembly" (page 3, lines 117 to 122). No adhesive layer is named or drawn, so PSA on both faces is not shown. No order code is printed; the only code is "Black (04)" (line 109), a colour code.

4. Parts that do not fit:
   - PORON ShockPad 0.10 mm: no adhesive on either face is shown (page 3, lines 117 to 122: urethane and release PET only). No order code. Fails the PSA requirement.
   - Nitto SCF AN010, SCF400T and SCF400: the saved page states no adhesive for these codes (line 714 is a general remark). Fails the PSA requirement as shown; the Nitto product data sheets, which would state it, were not obtained.
   - Sekisui 5200 series, 3M thin foam tapes, Rogers ShockSeal: no 0.10, 0.20 or 0.30 mm PSA foam from one family in any opened document. Not found.
   - Rogers PORON 4701-40 Soft: 0.79 mm minimum (W11 read of `design/datasheets/w11v_poron-4701-40-soft-datasheet.pdf`, page 2 lines 57 to 58; not re-read in this run). Too thick for a 0.13 mm gap.

5. Your best reading: No opened document gives one PSA foam family at 0.10, 0.20 and 0.30 mm. The Nitto SCF page has all three thicknesses (SCF AN010 0.10, SCF400T 0.2, SCF400 0.3/0.4) in one maker family, so its PSA versions are the next thing to check; the Nitto product data sheets for those codes must be fetched first, because this run could not get them.

6. What only a built unit can show: the lid height over the foam after reflow, and the foam compression under the lid (the gap g in mic-path.md line 152); the leak with the chosen gasket (mic-path.md line 150 states the leak as 7.31 times the bore's impedance at 1 kHz).

RESULT for row 2: not found (partial: Nitto SCF codes with thickness, PSA not stated). Web requests used: 10 of 10 (4 searches, 1 fetch, 5 curl calls).

## Row 3

Glass seal: double-coated film, 0.05 mm, glass to coated titanium, water-tight.

1. Need: a double-coated adhesive film 0.05 mm thick that bonds the glass cover to coated titanium and keeps water out. Project: `design/mfg/specs/cover-glass.md` line 43 (glass seal SEAL1, 0.05 mm thick, perimeter ring between the glass underside and the body seat, Z 2.70 to 2.75); `design/mfg/assembly/assembly.md` line 321 (K-A4: "Glass seal SEAL1 ... 0.05 mm"; the tape and its compressed thickness open, S26) and line 360 (open row "Glass seal SEAL1: the tape and its compressed thickness", S26).

2. Documents opened:
   - tesa SE, "tesa 61305, 50 µm double sided transparent high performance filmic tape, Product Information" (as of 17/04/26, en-US), https://www.tesa.com/en/files/download/11187710,5,medium-11187710.pdf. Saved: `design/datasheets/w12_tesa-61305.pdf` and `.txt`.
   - tesa SE, "tesa 4972, 48 µm double sided transparent filmic tape, Product Information" (page footers "as of 06/08/2019 - ensg"), https://www.tesa.com/id-id/files/download/817809,31,4972-country-pi-ensg.pdf. Saved: `design/datasheets/w12_tesa-4972-product-info.pdf` and `.txt`.
   - tesa SE, "tesa 4972, Product Information" (footers "as of 19/04/24 – en-NG"), https://www.tesa.com/en-ma/files/download/11338953,2,medium-11338953.pdf (the requested ",0," address redirected to ",2,"). Saved: `design/datasheets/w12_tesa-11338953.pdf` and `.txt`.
   - 3M Double Coated Tape 9731-050, https://multimedia.3m.com/mws/media/2366081O/%EF%BF%BD%C3%BF and https://multimedia.3m.com/mws/media/2366685O/%EF%BF%BD%C3%BF (both named in search results): HTTP 403 to curl. Not saved; the 403 files were deleted. The 3M page https://www.3m.com/3M/en_US/p/d/b40071892/ was in search results only, not opened.
   - Search snippets only, not opened: 3M 9731-050 "total 0.05 mm" and a 0.107 mm liner (snippet, not checked); Nitto No.5605BN "0.05 mm" and Nitto No.5600 "5 µm" (snippets); tesa 61380 and 62612 product pages (snippets). None is used as a value.
   - 3M 55256: no result in the search. Not found.

3. Parts that fit: tesa 61305 meets the thickness and the glass bond. Order code as printed: "tesa® 61305" (page 1, saved line 1; the product link in the footer, line 91, is "?ip=61305"). Values on page 1: total thickness 50 µm (line 31; also line 12); double sided, PET backing, tackified acrylic (lines 9 and 28); adhesion to glass 12.4 N/cm initial and 12.7 N/cm after 14 days (lines 49 and 50 of the saved text are on pdf page 1 for the initial value); steel 10.3 N/cm initial (line 49); humidity resistance "very good" (line 37); temperature 100 °C long term and 200 °C short term (lines 36, 38). Water: no immersion or ingress value; the sheet says only "Excellent resistance to demanding environmental conditions" (line 16).

4. Parts that do not fit:
   - tesa 4972: 48 µm total (first saved copy lines 7 and 22; second saved copy line 34), so 0.002 mm under the 0.05 mm requirement. Its adhesion list has steel (7.0 N/cm initial, 9.6 after 14 days) and no glass value (first saved copy line 26). Not a fit for the glass bond as stated.
   - tesa 61305 for the titanium part: the sheet gives glass, steel, ABS and PMMA only (lines 47 to 50). No titanium and no coated metal. The coated titanium bond is not shown.
   - tesa 61305 for water: no water test is printed; "humidity resistance very good" is a rating, not a water-ingress value. The water-tight claim is not shown.
   - 3M 9731-050, Nitto No.5600, No.5605BN: not opened (403, or snippets only). Not a fit as shown.

5. Your best reading: tesa 61305 is the only opened sheet with exactly 50 µm and a glass bond value, so it is the first part to test against the spec. It is not proven for water or for a coated titanium face: the sheet names neither, so the lead needs a bench bond and water test on the coated titanium before it is chosen.

6. What only a built unit can show: water entry at the glass seal with the tape compressed in the seat (the seal ring SEAL1 at Z 2.70 to 2.75), and the bond of the tape on the coated titanium after the water test (bench B9 for the coating bond, from `design/mech/thin/thin-notes.md` line 470).

RESULT for row 3: partial (thickness and glass bond found in tesa 61305; titanium and water not stated). Web requests used: 10 of 10 (5 searches; 5 curl calls: 3 saved (tesa 4972 product information, tesa 11338953, tesa 61305), 2 HTTP 403 from 3M (deleted)).

## Row 4

1. Need: (a) foam pad 0.10 mm between the screen and the board; (b) clear adhesive 0.10 mm under the glass (the optically clear film of the screen stack). Project: `design/mfg/specs/body.md` line 40 (foam pad thickness above the board 0.10 mm, open point 5), line 42 (clear adhesive thickness under the glass 0.10 mm, open point 5); the same two values are in `design/bom.csv` line 57 (FOAM1, "0.10 mm", design partner to answer the product). The clear adhesive is also in `design/bom.csv` line 53 (ADH1, "clear adhesive bonding the cover glass to the screen over the whole face, 0.10 mm").

2. Documents opened:
   - tesa SE, "tesa 69404, 100 µm optically clear transfer tape, Product Information" (as of 12/07/2019, ensg), https://www.tesa.com/id-id/files/download/819206,24,69404-country-pi-ensg.pdf. Saved: `design/datasheets/w12_tesa-69404.pdf` and `.txt`.
   - 3M, "3M Optically Clear Adhesive 8146-x, Technical Data" (November 2013). Copy hosted by a third party (Prostech, Vietnam), https://prostech.vn/wp-content/uploads/2021/10/OCA-8146-X-TDS.pdf. Saved: `design/datasheets/w12_3m-oca-8146x-prostech-copy.pdf` and `.txt`. The 3M-hosted address https://multimedia.3m.com/mws/media/1775334O/3m-contrast-enhancement-film-cef05xx-8146-x-series.pdf (named in search results) returned HTTP 403 to curl; the 403 file was deleted.
   - Rogers PORON ShockPad Foam (0.10 mm and 0.15 mm), data sheet, https://www.mueller-ahlhorn.com/wp-content/uploads/2024/11/PORON-ShockPad-Foam-Data-Sheet-010-and-015.pdf. Already saved in row 2: `design/datasheets/w12_poron-shockpad-010-015.pdf` and `.txt` (re-used, not re-downloaded).
   - Nitto, "Super Clean Foam SCF" product page, https://www-origin.nitto.com/sea/en/products/sealing/scf001/. Already saved in row 2: `design/datasheets/w12_nitto-scf-sea-page.html` (re-used).
   - Search snippets only, not opened: tesa 69804 (100 µm UV-curable display tape; its values are from a snippet), tesa 69604 (100 µm UV transfer tape), 3M ACO 01N and ACO 05U series (100 µm variants; snippets), 3M VHB RP+040GF (0.4 mm), 3M VHB 4920 (0.40 mm foam plus 0.08 mm liner). None of the 0.4 mm foam tapes is a 0.10 mm foam.

3. Parts that fit:
   - (b) clear adhesive 0.10 mm, tesa® 69404: order code as printed "tesa® 69404" (saved PDF page 1, line 2). Values: total thickness 100 µm, no backing, pure acrylic (line 27 and line 28); transmittance > 99 % (line 27 area, the "Transmittance (380 - 780nm)" row); haze < 0.5 % (line 28); refractive index 1.48 (line 29); glass adhesion 6.9 N/cm initial (line 33); "Excellent temperature, humidity and UV resistance" (line 9); application "capacitive type touch panels", "bonding of touch panels to protective cover or lens" (lines 19 and 20).
   - (b) clear adhesive 0.10 mm, 3M 8146-4 (the 100 µm member of the 8146-x family): order code as printed "8146-4" in the table header of "3M Optically Clear Adhesive 8146-x" (saved copy, PDF page 1, line 25; the 100 µm value is on PDF page 1, adhesive row "4.0 mil (100 micron)", line 36 to 37). Values: acrylic, no carrier (lines 27 and 29); glass peel 20 min dwell 60 oz/in (65 N/100 mm) for 8146-4 (saved text line 86, the glass row, PDF page 2); refractive index 1.474 (saved text line 52; the "Refractive Index" heading on PDF page 2); haze < 1.0 % (saved text line 59, PDF page 2); transmission > 99 % corrected (line 115 of the saved copy); heat-aged shear > 10,000 min (saved text line 95, PDF page 2). The sheet says its figures are "representative or typical only" (line 45). Caution: this is a third-party copy of a 2013 3M sheet.
   - (a) foam pad 0.10 mm, PORON ShockPad 0.10 mm: thickness "0.10 (4)" mm with tolerance ±0.025 mm (saved PDF page 3, lines 103 to 105); compression force deflection 217 kPa at 25 % (line 106); compression set 4.3 % at 70 °C (line 108). Order code: none printed. The sheet's only code is the colour code "Black (04)" (line 109). The product name "PORON ShockPad Foam (0.10mm & 0.15mm)" is on the title (page 3, line 97). So: a fit in thickness with no order code; not a catalogue part number.
   - (a) foam pad 0.10 mm, Nitto "SCF AN010": order code as printed "SCF AN010" (saved Nitto page, line 712, thickness 0.10); density 0.30 g/cm3 and 50 % compression 6.0 N/cm2 (saved page, line 728). Printed code: yes. No data sheet obtained; the page does not state adhesive for this code.

4. Parts that do not fit:
   - tesa 69404 at 100 µm: fits thickness (line 27), but the glass adhesion (6.9 N/cm initial, line 33) is a value and no pass or fail limit is set by the project for it; the project's need is the thickness only.
   - 3M 8146-4: fits 100 µm (line 36 to 37). The 2013 sheet is a typical-value sheet (line 45) and it is a third-party copy; the current 3M revision was not obtained.
   - PORON ShockPad 0.10 mm: no order code printed (only the colour code, line 109), so it cannot be a part line. It has no adhesive layer (release PET only, page 3, lines 117 to 122).
   - Nitto SCF AN010: the thickness and density are on the page; no datasheet, so no compression or height tolerance is stated beyond the page values.
   - 0.4 mm and thicker foam tapes (3M VHB RP+040GF, 3M VHB 4920): not 0.10 mm (snippets only).

5. Your best reading: For the clear adhesive, tesa 69404 (100 µm, backing-free, haze < 0.5 %) and 3M 8146-4 (100 µm, glass peel 65 N/100 mm) are both printed at 0.10 mm in a maker document with a code; tesa 69404 is the cleaner first choice for a display stack because its sheet states haze and transmission in the figures. For the foam pad, PORON ShockPad 0.10 mm matches the thickness with tight tolerance but has no order code, so the Nitto SCF AN010 (a printed code at 0.10 mm) is the only code-bearing 0.10 mm foam in the saved documents; its data sheet is the next thing to fetch.

6. What only a built unit can show: the compressed foam height under the screen (the foam is compressed by the panel and the cover glass, with a test on the first body), and the optical haze of the stack with the chosen clear adhesive under the cover glass.

RESULT for row 4: partial (clear adhesive: two parts with printed codes at 100 µm; foam: no datasheet for a printed 0.10 mm code). Web requests used: 6 of 10 (3 searches; 3 curl: tesa 69404 saved, 3M CEF05XX HTTP 403 deleted, prostech 8146-X copy saved).

## Row 5

1. Need: non-metal screw M1.2 x 3 with its head size, if the current design still has one.

2. Documents opened: none (no maker search; the brief says to skip the search when the design no longer has the screw).

3. Parts that fit: not applicable (no screw in the design to match).

4. Parts that do not fit: not applicable.

5. Your best reading: no longer in the design. The M1.2 screw is not in `design/mech/thin/thin.py` or in `design/bom.csv`, so no screw part is needed for this row unless the lead adds one back.

6. What only a built unit can show: not applicable.

Lines read:
   - `design/bom.csv`: `grep -n -i "screw\|M1[^0-9]\|M1$"` gave the motor row M1 (line 44, "Vibration motor,M1,...") and lines 51, 55, 57, 58, 81 and 82, which match only through part names (HSG1, DAM1, FOAM1, MEM1, CAP1, FRM1). No "screw" in any line. Second search, `grep -n "M1[._]\?2"` on both files: no hit (exit code 1).
   - `design/mech/thin/thin.py`: `grep -n -i "screw\|M1[^0-9]\|M1$"` gave lines 3, 65, 422, 684, 727, 749 and 754 (FRM1, FOAM1, DAM1, M1 as the motor name in `bandpart("vibration_motor", "M1", ...)`, line 754). No "screw" in any line. Second search for `M1[._]\?2`: no hit.
   - Searches in these two files only, as the brief says. The screw is not named in any other file read in this row.

RESULT for row 5: no longer in the design (0 web requests used).

## Row 6

1. Need: a chemically strengthened aluminosilicate glass with a public sheet that states density, thickness range and bend or forming limits. Project: `design/mfg/specs/cover-glass.md` line 12 (material: "chemically strengthened aluminosilicate glass", default, to confirm with the maker), line 15 (forming: arc 30.7 mm with 1.0 mm and 1.2 mm rolls at 1.10 mm thickness, forming tolerance open point 2), lines 28 to 30 (glass 1.10 mm at the centre, 0.42 mm over the screen edge, face arc radius 30.7 mm).

2. Documents opened:
   - AGC Inc., "Product Datasheet: Dragontrail Pro Cover Glass Substrate", rev. 5 (Nov. 2025), https://agc-electronics.com/cms/agc/Document/en/Dragontrail-Pro_catalog.pdf. Saved: `design/datasheets/w12_agc-dragontrail-pro-catalog.pdf` and `.txt`.
   - Photonics Online copy of a SCHOTT Xensation Cover data sheet (the page metadata names Abrisa Technologies as the company; not a SCHOTT file), https://www.photonicsonline.com/doc/SCHOTT-Xensation-Cover-Glass-0001 (curl at its final address https://www.photonicsonline.com/doc/schott-xensation-cover-glass-0001). Saved as HTML: `design/datasheets/w12_schott-xensation-cover-photonics.html`. The specification part is behind a login (gated text); the page text has only the one-line description.
   - Corning, "Gorilla Glass Victus PI Sheet", https://www.corning.com/microsites/csm/gorillaglass/PI_Sheets/Gorilla_Glass_Victus_PI_Sheet.pdf: HTTP 403 to curl (the file was deleted). Not saved. Also tried "Gorilla_Glass_Victus_2_PI_Sheet.pdf" and "2020/Gorilla_Glass_3_ProdSheet.pdf" on the same host: HTTP 403 (both deleted). Not saved.
   - Search snippets only, not opened: Corning Victus PI sheet (snippet: standard thickness 0.4 mm to 1.2 mm, "other sizes available on request"; the snippet did not show a density, which the search summary reported as not found); Corning Gorilla Glass 6 (0.4 to 0.9 mm) and large-format sheet (0.55 to 2.0 mm); Schott Xensation technical details pages (SCHOTT regional pages: density 2.39 g/cm3 for Xensation α, 2.48 for Xensation Up; thickness 0.50 to 0.70 mm for Core, 0.55 to 0.80 mm for α and Up; a 2022 copy lists α as 0.60 to 0.80 mm). These are snippets and not used as values.

3. Parts that fit: none of the opened maker sheets states all three (density, thickness range, bend or forming limit).
   - AGC Dragontrail Pro, density 2.46 (saved PDF, page 1, line 7); chemical strengthening "typical CS value 1000 MPa, typical DOL value 40 µm" for coverglass (page 2, lines 63 to 64). No thickness range is printed (the only thickness in the sheet is "t0.7 mm" on a chart axis, line 98, which is a test label, not a range). Forming limits: not stated. Composition: the sheet does not say "aluminosilicate" (grep count 0 in the saved text).
   - SCHOTT Xensation Cover, the Photonics Online copy: the description says "Alumino-Silicate glass for capacitive touch technologies" (saved HTML, line 353). This copy has no density, thickness or forming figure (gated). Maker-stated values exist only in SCHOTT's own pages, which the search returned as snippets, not opened.

4. Parts that do not fit:
   - Dragontrail Pro: fails the thickness range (not printed) and the bend or forming limit (not printed); the composition wording is not stated in the sheet.
   - Xensation Cover (photonicsonline copy): fails density and thickness (gated copy); no forming limit.
   - Corning Victus: not opened (403). The snippet gives thickness 0.4 to 1.2 mm, which covers 1.10 mm, but the density and the forming limit are not in any opened document. Not counted as a fit.

5. Your best reading: No public sheet opened in this row gives density, thickness range and a forming limit together. The Corning Victus sheet (snippet: 0.4 to 1.2 mm) is the likeliest to cover the 1.10 mm thickness, but Corning's own host returned 403 to curl, so its density and forming limit are unverified; the lead or the glass maker must provide the forming limit in writing (cover-glass.md open point 2).

6. What only a built unit can show: the arc of 30.7 mm at 1.10 mm thickness formed and strengthened on a sample (the forming and the strength after the cut), and the glass thickness at the centre and over the screen edge (1.10 and 0.42 mm, cover-glass.md lines 28 and 29).

RESULT for row 6: not found (AGC Dragontrail Pro gives density and strengthening, not thickness or forming; Corning Victus unverified, 403 to curl). Web requests used: 10 of 10 (5 searches; 5 curl calls: 2 saved (AGC PDF, Photonics Online HTML), 3 HTTP 403 from corning.com and deleted).

## Row 7

1. Need: a coater's public sheet that states the thickness range, hardness and colour of a decorative black PVD or DLC coating on Ti-6Al-4V (the gloss black coating of the body). Project: `design/bom.csv` line 51 (HSG1 finish: "polished, then gloss black coating, PVD or DLC (architecture 17.29)"); `design/mfg/specs/body.md` line 92 (first-article check "coating colour and adhesion"). No line in the project gives a thickness or a hardness for the coating.

2. Documents opened:
   - Oerlikon Balzers, "HQ040EN Coated Components" brochure (79 pages), https://www.oerlikon.com/ecoma/files/HQ040EN_Coated-Components.pdf?download=1. Saved: `design/datasheets/w12_oerlikon-hq040-coated-components.pdf` and `.txt`.
   - Oerlikon Balzers, "HQ161EN Food Processing" brochure, https://www.oerlikon.com/ecoma/files/HQ161EN_Food-Processing.pdf?download=1. Saved: `design/datasheets/w12_oerlikon-hq161-food-processing.pdf` and `.txt`.
   - Blösch AG, "DLC HARD" factsheet (German), https://www.bloesch.ch/media/filer/2021/factsheet_d_dlc_hard.pdf. Saved: `design/datasheets/w12_bloesch-dlc-hard-factsheet.pdf` and `.txt`.
   - rubig Beschichtungszentrum, "DLC Xtended" technical data sheet (English), https://cdn.rubig.com/assets/rubig.com/dokumente/Beschichtungszentrum/rubig-beschichtungszentrum-datenblatt-dlc-xtended-en.pdf. Saved: `design/datasheets/w12_rubig-dlc-xtended-datasheet.pdf` and `.txt`.
   - Innovent, "Data sheet PCO22 black", https://innovent-jena.de/fileadmin/media/images/01_OFT/EC/Data_sheet_PCO22_black.pdf: HTTP 404. Not saved (deleted).
   - Search snippets only, not opened: Ionbond Decobond Anthracite (thickness 0.4 to 1.0 µm, HV 1000 to 2500, a page of ionbond.com); Ionbond Decobond family (0.2 to 2.0 µm, HV 0.05 1500 to 2800); Ionbond Decobond Black Raven (3.0 to 5.0 µm, 2000 HV); Richter Precision DLC (no figure captured). Decobond Black (3701) has no figures in any result. Not used as values.

3. Parts that fit: none fully. Partial, with the values the saved maker pages state:
   - BALINIT® DLC (Oerlikon Balzers, a-C:H, black). Order code: none; the coating name "BALINIT® DLC" is the only identifier printed. Values: HQ161 table, saved text line 109 (page 4): thickness 1 to 3 µm, hardness "15 - 25" (the unit is not in the extracted row; the header is not read), friction 0.1 to 0.2, colour black. HQ040 table (PDF page 21): BALINIT DLC, a-C:H, hardness "> 2,000" in the row whose label is not in the extracted text, thickness 0.5 to 3 µm, roughness increase Ra approx. 0.02, friction 0.1 to 0.2, coating temperature "< 250" °C, colour black. The HQ040 microhardness row label "Typical microhardness (HK 0.01)" is printed for the C-series table (line 811), and footnote (line 826) says "HK corresponds approximately to HV". So the DLC hardness is most likely HK 0.01, not confirmed for DLC.
   - BALINIT® DLC STAR (Oerlikon, same HQ040 table, PDF page 21): a-C:H, black, hardness > 2,000, thickness 2 to 4 µm, coating temperature < 250 °C.
   - Titanium: HQ040 "Coatable materials" table (PDF page 33, saved text line 1496): row "Titanium alloys" with five "+" marks across the BALINIT columns. The text layer does not show which column is BALINIT DLC, so the DLC entry for Ti-6Al-4V is not confirmed.

4. Parts that do not fit:
   - rubig DLC Xtended: a-C:H:Si, optics "black, anthracite", hardness "min 800, max 2,500" HV, thickness "min 3, max 15" µm (saved text lines 82 to 92). Coatable materials: "Engineering steels, nitriding steels, stainless steels" (line 23); titanium is not listed. Fails for Ti-6Al-4V and the 3 to 15 µm thickness is far above the thin gloss finish in the spec (the thickness of a gloss finish is not in the project).
   - Blösch DLC HARD: colour "grau - schwarz" (grey to black, line 31), microhardness HV 3200 (line 32), thickness 2 µm (a single value, line 33), maximum application temperature 350 °C (line 35); application list "Rostfrei Stähle, Stahl, Bronze/Messing, Aluminium/Kupfer" (lines 42 to 45). Titanium is not listed. A tool coating, not a decorative gloss finish.
   - HQ161 and HQ040 for titanium: see the DLC row above; the titanium confirmation is not in any saved row.
   - Decobond Anthracite (Ionbond): colour is anthracite, not black, and not opened; snippet only.

5. Your best reading: BALINIT DLC (Oerlikon) is the only black decorative candidate in the saved maker documents that gives a thickness range, a hardness and a black colour, and its coating temperature (below 250 °C, HQ040) suits titanium. Ti-6Al-4V is not named for the DLC grade, so the coater must confirm it in writing and give the gloss value before the body is ordered.

6. What only a built unit can show: the colour, the gloss and the adhesion of the chosen coating on a polished Ti-6Al-4V body (body.md line 92), and the bond of the DP420 frame on that coating (bench B9, `design/mech/thin/thin-notes.md` line 470).

RESULT for row 7: partial (Oerlikon BALINIT DLC and DLC STAR give black, thickness and hardness; Ti-6Al-4V not confirmed for any saved grade; no order code exists for a coating). Web requests used: 9 of 10 (4 searches, 5 curl calls; the Innovent 404 was deleted).

## Row 8

1. Need: a two-part skin-contact casting resin for the 0.3 mm liner inside a ring cast over a live lithium cell: a stated skin-contact or medical standard (ISO 10993 or USP Class VI), cure at room temperature or at most 45 °C, viscosity low enough to fill 0.075 mm gaps. Project: `design/mfg/specs/band-liner.md` line 6 (0.3 mm skin of skin-safe resin, ribbons embedded with 0.075 mm of resin each side), line 43 (material: "a skin-safe cast resin", resin grade open, open point 1), line 45 (cure temperature and time open, open point 3; "The cell is live during the cure"), line 52 (K-A5: no maker has built this liner).

2. Documents opened:
   - Master Bond Inc., "Master Bond Adhesives Medical Device Applications" guide (18 pages), https://www.masterbond.com/sites/default/files/techdocs/Master_Bond-Adhesives-Medical-Device-Applications.pdf. Saved: `design/datasheets/w12_masterbond-medical-device-applications.pdf` and `.txt`.
   - Master Bond EP30Med product data sheet (TDS): https://www.masterbond.com/tds/ep30med, HTTP 403 to curl; the file was deleted. https://www.masterbond.com/node/2830 (product page): HTTP 403; deleted. Not saved.
   - Master Bond EP30Med on GlobalSpec, https://datasheets.globalspec.com/ds/master-bond/ep30med/91be76a7-446b-4c71-8312-8bf8db965dbb: HTTP 403; deleted. Not saved.
   - Epoxy Technology (EPO-TEK) MED-301 and MED-301-2 data sheets, https://www.epotek.com/docs/en/Datasheet/MED-301.pdf and .../MED-301-2.pdf, and the EPO-TEK biocompatible product list https://www.epotek.com/wp-content/uploads/2021/01/EPO-TEK%C2%AE-Biocompatible-Medical-Device-Grade-Products.pdf: each redirected to a distributor's HTML page (meridianadhesives.com). A distributor page is not a maker document; the files were deleted. Not saved.
   - Search snippets only, not opened: EPO-TEK MED-301 (snippet: 65 °C cure, 20:5 by weight, 100 to 200 cPs, ISO 10993 for a 1 h cure at 65 °C); EP30-4Med (snippet, ISO 10993-5, "Room Temperature Vulcanizing" in its datasheet title); EP21LVMed (snippet, one-to-one mix). None is used as a value.
   - Smooth-On Dragon Skin technical bulletin, already saved: `design/datasheets/w11v_smoothon-dragonskin-series-tb.pdf` (W11 note: no standard named; not re-read in this run).

3. Parts that fit: none with all four numbers in a saved maker document. Partial candidates, with the values the saved Master Bond guide states (its numbers are for the guide's own product list; the TDS, with the viscosity and cure values, was not obtained):
   - EP30Med (product name as printed, guide page 12): "two component, low viscosity epoxy resin system", "formulated to cure readily at room temperature or more quickly at elevated temperatures" (page 12, lines after the EP30Med heading, saved text line 468 to 470); "Meets ISO 10993-5 standard" and "Meets USP Class VI standard" (page 12, the key-features table); optically clear (page 12). Viscosity, mix ratio and cure schedule: not in the guide ("REQUEST A TDS for EP30Med", saved text line 491). Fails the viscosity check as shown: no number.
   - EP21LVMed (page 11): "Low viscosity, two component epoxy" (saved text line 419); "Cures at room temperature or elevated temperatures" (line 436); "Meets USP Class VI standard" (line 434); "one to one mix ratio by weight" (line 437). No viscosity value or cure time in the guide ("REQUEST A TDS for EP21LVMed", line 438).
   - EP42HT-2Med (page 5): "meets the USP Class VI standard" and "ISO 10993-5 standard" (saved text lines 154 to 157). Tg 150 to 155 °C (saved text line 196, the property table on page 5). Cure schedule not stated in the guide. It is a high-temperature system, so a room-temperature cure is not shown.

4. Parts that do not fit:
   - EPO-TEK MED-301 (snippet only, not counted): its snippet states a 65 °C cure, which is above the 45 °C limit; no saved maker document shows it.
   - EP30Med, EP21LVMed: the viscosity number and the cure time are not in any saved document, so the two claims that matter most (fill of 0.075 mm gaps, cure at or under 45 °C) are not shown. EP21LVMed's cure in the guide is "room temperature or elevated temperatures" with no time; the snippet's "overnight at 75 °F then 1 to 2 h at 150 to 200 °F" is not in the saved guide and is not used.
   - EP42HT-2Med: the cure is not stated in the guide; the high Tg suggests a heat cure, but this is not shown in a document, so it is not a fit as stated.
   - Smooth-On Dragon Skin (saved bulletin): no standard named (W11 read), so it fails the standard requirement.

5. Your best reading: No saved maker document gives a viscosity and a room-temperature cure time together with a skin-contact standard for one resin. Master Bond EP30Med (ISO 10993-5 and USP Class VI, cures at room temperature per its guide page 12) is the best first candidate to request the TDS for; the viscosity (to fill 0.075 mm gaps) and the cure schedule must come from that TDS, not from this guide.

6. What only a built unit can show: the cure temperature of the cell and the liner during the RT cure (the cell is live, band-liner.md line 45), the fill of the 0.075 mm gaps around the ribbons (K-A5, band-liner.md line 52), and the skin-contact standard as tested on the chosen lot (the standard number is a lot test, not a catalogue claim).

RESULT for row 8: not found (no saved maker document gives viscosity, room-temperature cure and a skin-contact standard together; Master Bond EP30Med and EP21LVMed are partial, values in the TDS not obtained). Web requests used: 10 of 10 (3 searches, 7 curl calls: 1 saved, 6 failed as 403 or redirect to a distributor and deleted).

## Row 9

1. Need: 3M Scotch-Weld DP420 Black: 3M's own sheet with the order code of the small duo-pak cartridge, and any 3M statement on bonding titanium or coated metal. Project: `design/mfg/specs/joystick-nub.md` line 18 (bond of the frame FRM1 in the body: "3M Scotch-Weld Epoxy Adhesive DP420 Black", mix ratio 2:1 by volume) and line 23 (cured 24 h at 22 C); `design/bom.csv` line 82 (FRM1 bonded in the 5.6 mm opening with DP420 Black, 0.10 mm radial gap, on the coated titanium).

2. Documents opened:
   - 3M, "Scotch-Weld Epoxy Adhesive DP420 Black" technical data sheet, 3M's own addresses: https://multimedia.3m.com/mws/media/1235389O/dp420-technical-data-sheet.pdf&fn=DP420.pdf (HTTP 403, deleted); https://www.3m.com/3M/en_US/p/dc/v101657054/ (HTTP 403, deleted); https://www.3m.com/3M/en_US/p/d/b40066431/ (HTTP 403, deleted); https://www.3mcanada.ca/3M/en_CA/p/dc/v101657054/ (HTTP 403, deleted); https://multimedia.3m.com/mws/media/2365922O/%EF%BF%BD%C3%BF and .../2365939O/%EF%BF%BD%C3%BF (both HTTP 403, deleted). None saved.
   - Third-party copy of the 3M sheet (10 pages, "Microsoft Word - 97106.doc"), https://www.3market.cz/user/related_files/dp420-black-dp420ns-black-dp420-off-white-dp420lh.pdf. Already saved by W11 as `design/datasheets/w11v_3m-dp420-tds.pdf`; text copy `design/datasheets/w12_3m-dp420-copy-w11v-text.txt` (made in this run with pdftotext -layout). Not a 3M address; its text is the 3M sheet's text.
   - Search snippets only, not opened: 3M product page b40066431 (snippet: "Duo-Pak cartridges in 1.69 fl oz (50 ml), 6.76 fl oz (200 ml), and 14.07 fl oz (400 ml)"); a 3M US listing (snippet: "3M Product Number DP420", "3M ID 7100319970", UL 94 HB); distributor listings with other numbers (7100148731, 7100148758, Boeing 638060-08966=32). These are not saved maker documents, so under the code rule none of them is a code in this row.

3. Parts that fit: none with a code in a saved maker document.
   - DP420 Black, small duo-pak cartridge: the saved copy states the size, "supplied in 50 ml, 200 ml and 400 ml configurations" (saved copy page 6, text lines 344 to 346), but prints no order or product number. Order code: "code not in a saved maker document".
   - Metal bonding data in the saved copy: overlap shear at 23 °C and at temperature for aluminium (etched, 4500 psi, page 4, text line 202), cold-rolled steel, copper, brass, stainless steel, galvanized steel (text lines 205 to 210, same table, page 4). The surface preparation sections D (isopropyl alcohol wipe) and E (isopropyl alcohol/abrade/isopropyl alcohol) are on page 8 (text lines 412 and 418).

4. Parts that do not fit (or are not shown):
   - Titanium: the saved copy has no titanium in any test table (page 4, lines 197 to 240 list aluminium, steel, copper, brass, stainless, galvanized) and no titanium surface preparation (grep "titan" in the saved text: 0 hits). The DP420 bond on titanium is not shown by 3M in any saved document.
   - Coated metal: the saved copy has no statement on a coated or painted metal (grep "coat": 0 hits). Not shown.
   - Order code of the 50 ml duo-pak: not printed in the saved copy; the 3M pages and distributor pages named above were not saved (403 or not fetched).

5. Your best reading: The DP420 Black sheet from 3M gives the 50 ml duo-pak size and the bond tables for aluminium and steel, but neither the code nor a titanium or coated-metal statement. The frame bond on the coated titanium is therefore a bench question (B9), and the code must come from 3M's own page: the lead or the owner should take it from the 3M product page for DP420 Black 50 ml (the number is not verified here).

6. What only a built unit can show: the bond strength of DP420 Black on the coated titanium frame (FRM1, 5.40 mm outer, 0.10 mm radial gap) after the DP420 cure of 24 h at 22 °C, measured by a pull or shear test on the first body (`design/mech/thin/thin-notes.md` line 470 lists this as "the DP420 bond on the coating: no bench").

RESULT for row 9: not found (no code in a saved 3M document; no titanium or coated-metal statement in the saved 3M copy; 3M's own addresses returned 403 to curl). Web requests used: 9 of 10 (3 searches; 6 curl calls, all HTTP 403, none saved).

## Row 10

1. Need: (a) a moulded holder in liquid crystal polymer with walls of 0.79 mm between 1.60 mm bores (0.794 mm wall, bores 1.60 mm at 2.39 mm centres): a resin maker's design guide that states the smallest wall LCP can fill (Celanese Vectra or Zenite, Polyplastics Laperos, Sumitomo Sumikasuper). Project: `design/case/c5d-open-points-handover.md` line 44 ("the moulder has not confirmed the 0.79 mm walls between bores (0.794 mm, the bores dia 1.60 at 2.39 mm centres) in LCP"). (b) The tact switch code SKTAAAE010 (`design/bom.csv` lines 39 and 40, Alps Alpine, "SKTAAAE010"): an Alps Alpine document that prints this exact code.

2. Documents opened:
   - (a) Celanese, "High Volume Manufacture of Thin-Wall Medical Device Components with Vectra MT LCP" (a Celanese-sourced white paper, the page says "Source: Celanese"), https://www.pharmaceuticalonline.com/doc/high-volume-manufacture-of-thin-wall-medical-device-components-with-vectra-mt-lcp-0001. Saved: `design/datasheets/w12_celanese-vectra-mt-thin-wall-article.html` and `.txt` (text copy, tags removed).
   - (a) Celanese design guide for Vectra LCP: not found. Two searches named the guide, but no Celanese PDF was returned; a Celanese page in the results says the guide exists, and it was not opened. A Celanese article on wearables (https://ondrugdelivery.com/wp-content/uploads/2021/09/124_2021_Sep_Wearables_Celanese.pdf) returned HTTP 403 to curl (deleted).
   - (a) Polyplastics Laperos design guide: not found (one search; results were Fictiv, Madearia, Nylonplastic, Patsnap and Machine Design pages, which are not maker documents and are not saved).
   - (a) Sumitomo Sumikasuper design guide: not found (one search; the Sumitomo product pages in the results name a technical data PDF, which was not opened).
   - (b) Alps Alpine "TACT Switch Surface Mount Type, 2.6×1.6 mm compact type with projection, SKTA series" (3-page series page, Update 2606), (address not recorded in the project files; the saved file is `design/datasheets/w4_alps_skta_catalog.pdf`, and `w1_alps_skta_catalog.pdf` has the same title and line 30). Already saved; re-read in this run.
   - (b) Alps Alpine product spec SKTAAAE010, https://tech.alpsalpine.com/e/products/detail/SKTAAAE010/pdf/product_spec_sktaaae010_en_62f9bac83c.pdf: HTTP 403 (deleted). Also https://tech.alpsalpine.com/e/info/detail/SKTAAAE010/: HTTP 403 (not saved). IBS copy https://datasheets.ibselectronics.com/SKTAAAE010-ALPS-datasheet-168924319.pdf: HTTP 403 (deleted).
   - (b) Already saved, read in this run: `design/datasheets/w4_alps_sktaaae010_spec.pdf` (7 pages, the Alps spec copy; the code is not printed in it, grep "SKTAAAE010": 0 hits; its contact resistance and life values are read below).

3. Parts that fit:
   - (a) Celanese white paper, Vectra MT LCP grade family (not a design guide): "thin-wall molding even as low as 0.3mm (0.012in) nominal wall without sacrificing mechanical stiffness and strength" (saved text line 408); "extreme flow to fill sub-mm wall sections" (line 406). The paper names the MT grade family, not the holder's grade. The holder grade is not named in the project (`design/case/c5d-open-points-handover.md` line 44 says only "LCP"). A 0.79 mm wall is above the 0.3 mm the paper states, so it is inside the stated claim; the paper does not state a hole-to-hole wall between two 1.60 mm bores.
   - (b) SKTAAAE010, printed in the saved Alps Alpine SKTA catalog (`design/datasheets/w4_alps_skta_catalog.pdf`, page 1, line 30 of the layout text; column header lines 22 to 26): "SKTAAAE010  Top push  1.6 (N)  standard  0.11 (mm)  300,000 (cycles)  500 mΩ max.  2.6×1.6×0.53  ●  ●  IP6X equivalent/IPX7". Order code as printed: "SKTAAAE010" (page 1, line 30). Water-proof and dust-proof marks ●, and "IP6X equivalent/IPX7" are on the same line. The same SKTA catalog file as `w1_alps_skta_catalog.pdf` (page 1, line 30).
   - (b) The saved Alps spec copy `w4_alps_sktaaae010_spec.pdf` gives the same switch's contact resistance "500 mΩ Max." (layout text line 46, section 6.1) and, after the operating life test, "20 Ω Max." (life test table, layout text line 223); the W11 note's "20 ohm" is the life-test value, not a conflict.

4. Parts that do not fit:
   - (a) Polyplastics Laperos, Sumitomo Sumikasuper: no maker design guide opened, so no minimum wall value from them. Not found.
   - (a) Celanese design guide: not opened; not found.
   - (a) The LCP holder's grade: not named in the project, so the Celanese MT claim may not hold for that grade. The moulder's written confirmation of the 0.79 mm wall (project line 44) is still open.
   - (b) Other rows of the same catalog (SKTABEE010 at 2.4 N, SKTACBE010 at 0.7 N, and others) are not the part: their force and life differ (catalog lines 28 to 40); not used.

5. Your best reading: (b) is closed: the code SKTAAAE010 is printed in the Alps Alpine SKTA catalog in the project (page 1, line 30), with 1.6 N, 0.11 mm, 300,000 cycles and IP6X/IPX7 on the same line. (a) is not closed: no maker design guide gives the smallest LCP wall between bores; the Celanese white paper's 0.3 mm nominal-wall claim supports the 0.79 mm wall as thick enough to fill, but the moulder's written confirmation (open point in project line 44) is still the closing document.

6. What only a built unit can show: the stake strength and the crack check of the moulded holder with a 0.79 mm wall between two 1.60 mm bores (a moulded sample, not a printed one), and the touch electrode reading through the wall (project line 44, bench B3).

RESULT for row 10: partial (b) SKTAAAE010 code found in a saved Alps Alpine catalog; (a) not found as a design guide (Celanese white paper only, grade not matched). Web requests used: 10 of 10 (5 searches, 5 curl calls: 1 saved white paper, 4 blocked with 403 or redirected and deleted).

## questions_for_owner

1. Row 1: may the membrane limit of 0.10 mm change to a Gore custom quote, or a seat change to the 0.26 mm AAV10307 (or a 0.24 mm GAW112 class part)? Evidence: no catalogue part at 0.10 mm in any saved document (`w12_gore-auto-acoustics-us-2025.txt` line 148: 0.26 mm; `w11v_gore-acoustic-vents-gaw111-gaw112-datasheet.pdf` PDF page 5, line 148: 0.18 and 0.24 mm).
2. Row 2 and row 4: the Nitto SCF data sheets (NJ_SCF400T_EN.pdf, NJ_SCF400_EN.pdf) are linked from the saved Nitto page (`w12_nitto-scf-sea-page.html` line 675 and line 756) but could not be downloaded from this run. Can the owner download them from a normal browser and place them in `design/datasheets/`? Evidence: curl gave an HTTP/2 error and a timeout (row 2).
3. Row 3: is 50 µm (tesa 61305, `w12_tesa-61305.txt` line 31) an acceptable match for the 0.05 mm glass seal, and may a bench water test and a bond test on the coated titanium be run before the tape is chosen? Evidence: the sheet does not state titanium or water entry.
4. Row 4: does the 0.10 mm foam pad need a pressure-sensitive adhesive on either face? The project spec does not say (`design/mfg/specs/body.md` line 40). Evidence: PORON ShockPad 0.10 mm has no adhesive layer and no order code (`w12_poron-shockpad-010-015.txt` lines 102 to 122).
5. Row 6: may the owner download the Corning Gorilla Glass Victus product information sheet in a browser (corning.com returned HTTP 403 to curl) and check its density and forming limit at 1.10 mm? Evidence: the search snippet gives 0.4 to 1.2 mm only.
6. Row 8: may the owner (not this helper) send a data-sheet request to Master Bond for EP30Med and EP21LVMed (viscosity, mix, cure schedule)? Evidence: the saved Master Bond guide says "REQUEST A TDS" for both (`w12_masterbond-medical-device-applications.txt` lines 438 and 491).
7. Row 9: may the owner copy the 3M product number of the DP420 Black 50 mL duo-pak from 3M's own page in a browser? Evidence: all 3M addresses returned HTTP 403 to curl; the saved copy gives the 50 ml size without a number (`w12_3m-dp420-copy-w11v-text.txt` lines 344 to 346).
8. Row 10: which LCP grade and supplier is the holder to be moulded in, and may the owner send the moulder's written confirmation of the 0.79 mm wall (project line `design/case/c5d-open-points-handover.md` line 44)? Evidence: no maker design guide for Celanese, Polyplastics or Sumitomo was retrievable; the Celanese white paper gives 0.3 mm nominal wall for the MT grade family only.
9. Row 5: is the M1.2 x 3 non-metal screw intentionally gone from the design? Evidence: no screw in `design/mech/thin/thin.py` or `design/bom.csv`.

RESULT: done, all 10 rows have a block; 0 of 10 rows have a part that meets every number in a saved maker document: row 5 is no longer in the design, rows 4 and 10 each have a printed order code for a part that meets part of their need, rows 1, 2, 6, 8 and 9 found no fitting part, rows 3 and 7 are partial; 9 questions for the owner.
