NexusGPT/openring/explorer/docs/lanes/collector-parts.brief.md

# Lane brief: collector-parts

Generated by `lane-brief.py` from `docs/lane-dag.json` at 0a6bd65 (working tree). Do not retype it.

Seat: builder
Repo: explorer
Fork point: 0a6bd65

Owns:
- `collector/extract/parts.py`
- `collector/extract/files.py`
- `collector/tests/collector-parts/**`

Must not touch:
- contract: `package.json`, `package-lock.json`, `vendor/**`, `tsconfig.json`, `vite.config.ts`, `index.html`, `.gitignore`, `tools/serve-files/**`, `src/contract/**`, `src/data/**`, `contract/schema/**`, `collector/run.py`, `collector/lib/**`, `collector/tests/conftest.py`, `collector/tests/contract/**`, `tests/playwright.config.ts`, `tests/support/**`, `scripts/**`, `docs/CONTRACT.md`, `docs/DIGEST.md`, `docs/SOURCE-CONTRACT.md`, `docs/CONSTANTS.md`
- shell: `src/main.tsx`, `src/app/**`, `src/styles/**`
- stage: `src/stage/**`
- svg-viewer: `src/components/SvgViewer/**`
- part-card: `src/components/PartCard/**`
- part-notes: `content/part-notes.json`, `collector/tests/part-notes/**`
- collector-model: `collector/extract/placements.py`, `collector/extract/ring_model.py`, `collector/extract/screens.py`, `collector/cad/**`, `collector/tests/collector-model/**`
- collector-state: `collector/extract/facts.py`, `collector/extract/areas.py`, `collector/tests/collector-state/**`
- collector-look: `collector/extract/look_options.py`, `collector/tests/collector-look/**`
- collector-electronics: `collector/extract/schematic.py`, `collector/extract/electronics.py`, `collector/tests/collector-electronics/**`
- collector-board: `collector/extract/board.py`, `collector/tests/collector-board/**`
- collector-behaviour: `collector/extract/behaviour.py`, `collector/tests/collector-behaviour/**`
- collector-case: `collector/extract/case.py`, `collector/tests/collector-case/**`
- collector-open: `collector/extract/open_items.py`, `collector/tests/collector-open/**`
- behaviour-engine: `src/engine/behaviour/**`
- home: `src/routes/home/**`, `tests/checks/home/**`
- look: `src/routes/look/**`, `tests/checks/look/**`
- inside: `src/routes/inside/**`, `tests/checks/inside/**`
- electronics: `src/routes/electronics/**`, `tests/checks/electronics/**`
- board: `src/routes/board/**`, `tests/checks/board/**`
- parts: `src/routes/parts/**`, `tests/checks/parts/**`
- behaviour: `src/routes/behaviour/**`, `tests/checks/behaviour/**`
- case: `src/routes/case/**`, `tests/checks/case/**`
- open-files: `src/routes/open-files/**`, `tests/checks/open-files/**`
- fixture-a3: `tests/fixtures/**`
- journeys-a: `journeys/J1.spec.ts`, `journeys/J3.spec.ts`, `journeys/J6.spec.ts`
- journeys-b: `journeys/J2.spec.ts`, `journeys/J4.spec.ts`, `journeys/J5.spec.ts`, `journeys/J7.spec.ts`
- seams: `tests/seams/**`
- smoke-perf: `tests/smoke/**`
- frozen root files: `package.json`, `tsconfig.json`, `vite.config.ts`, `index.html`, `contract/schema/**`, `src/contract/**`, `src/data/**`, `collector/run.py`, `collector/lib/**`, `tests/playwright.config.ts`, `tests/support/**`, `docs/CONTRACT.md`, `docs/DIGEST.md`, `docs/SOURCE-CONTRACT.md`, `docs/CONSTANTS.md`

Writes to:
- `docs/lanes/collector-parts.md`
- `_captures/collector-parts/`

Done when:
- pytest collector/tests/collector-parts exits 0 on a git-archive copy of commit 99dfb85 and on the live folder
- parts.json and files.json validate against contract/schema

Work items (plan docs/plan.json):
- `functionality-parts-extract`: extract/parts.py: ring lines from design/bom.csv and case lines from design/case/case-bom.csv; refs split ('U5, U6, U7, U8' -> 4 refs); evidence code with its plain meaning read from architecture.md 'How to read this'; open_action resolved to architecture section 12 (who, what to ask) or case section 8; price parsed with currency; each source_file_or_url resolved to a files.json entry (on disk or not); plain notes joined from content/part-notes.json. Acceptance: On the fixture: ring lines = 77, ring parts = 146, ref 'U7' resolves to the line with maker_part_number 'IM73D122V01XTMA1', ring:BT1 open_action resolves to who 'Grepow'; pytest collector/tests/collector-parts exits 0; a bom.csv copy without the 'reference' column gives status 'unparsed' and exit 0.
- `functionality-files-index`: extract/files.py: index of every project file (design/ minus .venv and __pycache__, plus requirements.md, feasibility.md, partners.md) with size, modified date, area (folder-to-area rule written in docs/SOURCE-CONTRACT.md) and the git state (tracked or not). Acceptance: On the live folder files.json contains design/datasheets/mic_infineon_im73d122v01_en.pdf with area 'parts' and size equal to os.path.getsize; no entry path contains '.venv' or '__pycache__'; every area of the 8 has at least one file or an explicit empty list.
- `functionality-bundle-zip`: Partner bundle: bundle.zip of `git ls-files --cached --others --exclude-standard` over design/ plus requirements.md, feasibility.md, partners.md, with a contents list in files.json. Acceptance: zipfile.testzip() returns None; the zip entry list equals files.json 'bundle' list; no entry contains '.venv/' or '__pycache__/'.

TESTS
(docs/TEST-PLAN.md has no `## TESTS` block)

Standing rules (docs/CONSTRAINTS.md; each carries its source):
- 1 (source: Cue, the owner's standing rule recorded before this project: "Headless tests only")
- 2 (source: rule docs/PRD.md:21)
- 3 (source: Cue, the build plan the owner approved in plan mode on 2026-11-10 says "A guard against stale facts")
- 4 (source: rule docs/PRD.md:27)
- 5 (source: rule docs/DESIGN.md:22)
- 6 (source: Cue, measured 4.6 GB free on 2026-11-10; the owner approved the plan's "Risks: Disk space")
- 7 (source: Cue, the build plan the owner approved on 2026-11-10 says "Helpers work in one shared copy, each on its own files")
- 8 (source: Cue, the build plan the owner approved on 2026-11-10 says "Honest screens during the redesign")
- 9 (source: rule docs/PRD.md:30)

Teardown: after the merge, `git -C explorer worktree remove <this lane's tree>` then `git -C explorer branch -d lane/collector-parts`, one target at a time. The spawner checks `git worktree list` against the live lanes at the wave boundary.
