NexusGPT/openring/explorer/docs/lanes/parts.brief.md

# Lane brief: parts

Generated by `lane-brief.py` from `docs/lane-dag.json` at 8403cae (working tree). Do not retype it.

Seat: app-executor
Surface: parts
Repo: explorer
Fork point: 8403cae

Owns:
- `src/routes/parts/**`
- `tests/checks/parts/**`

Must not touch:
- contract: `package.json`, `package-lock.json`, `vendor/**`, `tsconfig.json`, `vite.config.ts`, `index.html`, `.gitignore`, `tools/serve-files/**`, `src/contract/**`, `src/data/**`, `contract/schema/**`, `collector/run.py`, `collector/lib/**`, `collector/tests/conftest.py`, `collector/tests/contract/**`, `tests/playwright.config.ts`, `tests/support/**`, `scripts/**`, `docs/CONTRACT.md`, `docs/DIGEST.md`, `docs/SOURCE-CONTRACT.md`, `docs/CONSTANTS.md`, `tests/static/**`, `README.md`
- shell: `src/main.tsx`, `src/app/**`, `src/styles/**`
- stage: `src/stage/**`
- svg-viewer: `src/components/SvgViewer/**`
- part-card: `src/components/PartCard/**`
- part-notes: `content/part-notes.json`, `collector/tests/part-notes/**`
- collector-parts: `collector/extract/parts.py`, `collector/extract/files.py`, `collector/tests/collector-parts/**`
- collector-model: `collector/extract/placements.py`, `collector/extract/ring_model.py`, `collector/extract/screens.py`, `collector/cad/**`, `collector/tests/collector-model/**`
- collector-state: `collector/extract/facts.py`, `collector/extract/areas.py`, `collector/tests/collector-state/**`
- collector-look: `collector/extract/look_options.py`, `collector/tests/collector-look/**`
- collector-electronics: `collector/extract/schematic.py`, `collector/extract/electronics.py`, `collector/tests/collector-electronics/**`
- collector-board: `collector/extract/board.py`, `collector/tests/collector-board/**`
- collector-behaviour: `collector/extract/behaviour.py`, `collector/tests/collector-behaviour/**`
- collector-case: `collector/extract/case.py`, `collector/tests/collector-case/**`
- collector-open: `collector/extract/open_items.py`, `collector/tests/collector-open/**`
- behaviour-engine: `src/engine/behaviour/**`
- home: `src/routes/home/**`, `tests/checks/home/**`
- look: `src/routes/look/**`, `tests/checks/look/**`
- inside: `src/routes/inside/**`, `tests/checks/inside/**`
- electronics: `src/routes/electronics/**`, `tests/checks/electronics/**`
- board: `src/routes/board/**`, `tests/checks/board/**`
- behaviour: `src/routes/behaviour/**`, `tests/checks/behaviour/**`
- case: `src/routes/case/**`, `tests/checks/case/**`
- open-files: `src/routes/open-files/**`, `tests/checks/open-files/**`
- fixture-a3: `tests/fixtures/**`
- journeys-a: `journeys/J1.spec.ts`, `journeys/J3.spec.ts`, `journeys/J6.spec.ts`
- journeys-b: `journeys/J2.spec.ts`, `journeys/J4.spec.ts`, `journeys/J5.spec.ts`, `journeys/J7.spec.ts`
- seams: `tests/seams/**`
- smoke-perf: `tests/smoke/**`
- frozen root files: `package.json`, `tsconfig.json`, `vite.config.ts`, `index.html`, `contract/schema/**`, `src/contract/**`, `src/data/**`, `collector/run.py`, `collector/lib/**`, `tests/playwright.config.ts`, `tests/support/**`, `docs/CONTRACT.md`, `docs/DIGEST.md`, `docs/SOURCE-CONTRACT.md`, `docs/CONSTANTS.md`

Writes to:
- `docs/lanes/parts.md`
- `_captures/parts/`

Done when:
- tests/checks/parts (lane ids parts-C01..C99) pass against the live collect AND against an empty bundle (honest banner, 0 console errors)
- with only its dependencies merged, the route renders inside the shell at 1512x982 with no page scroll

Work items (plan docs/plan.json):
- `ux-parts-table`: Parts: the full table (part, maker, order code, price, evidence, open action) with totals (77 lines, 146 parts, priced sum and count of unpriced lines); row click opens the card; filters has code / made to drawing / needs supplier / page. Acceptance: On the fixture: 77 rows (virtualized rows count from the table model, not the DOM); the totals line reads '77 lines' and '146 parts'; clicking the U5 row opens the card of ring:U5.
- `interaction-parts-filter`: Filter chips write into one filter model with a clear-all chip; URL keeps the filter. Acceptance: Clicking 'needs supplier' leaves only lines whose open_action is a section 12 item; clear-all restores 77; reload keeps the filter (URL query).
- `interaction-parts-export`: Export CSV downloads design/bom.csv as it is on disk. Acceptance: The downloaded file's sha256 equals the sha256 of the bundle's source design/bom.csv; suggestedFilename is 'bom.csv'.

TESTS
(docs/TEST-PLAN.md has no `## TESTS` block)

Standing rules (docs/CONSTRAINTS.md; each carries its source):
- 1 (source: Cue, the owner's standing rule recorded before this project: "Headless tests only")
- 2 (source: rule docs/PRD.md:21)
- 3 (source: Cue, the build plan the owner approved in plan mode on 2026-11-10 says "A guard against stale facts")
- 4 (source: rule docs/PRD.md:27)
- 5 (source: rule docs/DESIGN.md:22)
- 6 (source: Cue, measured 4.6 GB free on 2026-11-10; the owner approved the plan's "Risks: Disk space")
- 7 (source: Cue, the build plan the owner approved on 2026-11-10 says "Helpers work in one shared copy, each on its own files")
- 8 (source: Cue, the build plan the owner approved on 2026-11-10 says "Honest screens during the redesign")
- 9 (source: rule docs/PRD.md:30)

Teardown: after the merge, `git -C explorer worktree remove <this lane's tree>` then `git -C explorer branch -d lane/parts`, one target at a time. The spawner checks `git worktree list` against the live lanes at the wave boundary.
