NexusGPT/openring/design/bom.csv

item | reference | quantity | function | maker | maker_part_number | package | size_mm | value | key_figures | evidence | source_file_or_url | unit_price_and_currency_at_qty1 | open_action
Main chip | U1 | 1 | Bluetooth, USB, 4 PDM inputs, application processor | Nordic | NRF54LM20A-CAAA-R7 | WLCSP-61 (CAAA) | 3.02 x 2.43 x 0.43 |  | 2 MB NVM, 512 KB RAM, high-speed USB, 1.7 to 3.6 V; Nordic reference BOM names the die as nRF54LM20x-CAAA, order string from a DigiKey listing | LIST | design/parts/mcu.md section 1a ; <work>/ai-ring-recorder-bom-evidence/nordic_caaa_bom.txt |  | 12.2
Power chip | U2 | 1 | charger, 2 buck rails, 2 load switches, ship mode (Nordic nPM1304, architecture 17.13) | Nordic | nPM1304-CAAA-R7 | CSP-35 (nPM1304-CAAA) | 2.3775 x 3.0775 x 0.464 |  | nPM1304 (review F05): charge current 4 to 100 mA in 0.5 mA steps, accuracy +-10 % (p29); charge voltage 4.35 V is register BCHGVTERM value 9 (p36); battery discharge current limit IBATLIM 100 mA minimum (p29); 35 balls, VBUS B1 B2, VSYS C1 C2, VBAT D1 D2, no GPIO4 (Table 33 p153); order code nPM1304-CAAA-R7, reel of 1500 (Table 50 p168); charge setting 15 mA and 4.35 V | DS | design/datasheets/npm1304_datasheet_v1_0.pdf p29, p36, p153, p155, p157, p168 ; design/ecad/ring/npm1304-balls.csv ; design/architecture.md 17.18 |  | S22 (architecture 17.22): bench proof of the motor regulator U11, which keeps the motor out of the IBATLIM path; price at quantity 1 not read (a distributor)
Power chip VSET1 resistor | R71 | 1 | sets buck 1 to 1.8 V (Nordic reference configuration 1) | Yageo | RC0201FR-0747KL | 0201 |  | 47 kohm 1 % | +/-1 %; package not stated | LIST | design/parts/order-codes.md |  | confirmed for the nPM1304: spec Table 36 page 156 (47 kohm gives 1.8 V, 150 kohm gives 3.0 V), resistor tolerance 5 % or better (npm1304-reference.md)
Power chip VSET2 resistor | R72 | 1 | sets buck 2 to 3.0 V (Nordic reference configuration 1) | Yageo | RC0201FR-07150KL | 0201 |  | 150 kohm 1 % | +/-1 %; package not stated | LIST | design/parts/order-codes.md |  | confirmed for the nPM1304: spec Table 36 page 156 (47 kohm gives 1.8 V, 150 kohm gives 3.0 V), resistor tolerance 5 % or better (npm1304-reference.md)
VBUS discharge resistor | R73 | 1 | from VBUS to GND on the ring: empties the VBUS capacitors after the ring leaves the case, so the pads on the finger fall under 0.1 V within 10 s (lead-decisions.md row "sim finding 1"); draws about 15 uA from the case while charging, nothing from the cell | Yageo | RC0201FR-07330KL | 0201 |  | 330 kohm 1 % | order code written by the coding of the series RC0201FR-07 (RC_L), NOT confirmed at a distributor; 1 % from the series | LIST | design/parts/order-codes.md section 1 ; design/wiring/lead-decisions.md row sim finding 1 ; design/sim/circuit/sim-notes.md finding 1 |  | confirm at a distributor that RC0201FR-07330KL exists (code by the series coding only), its stock and price
Storage | U3 | 1 | 4 GB SD NAND, SPI mode (architecture 16.4) | CS Semiconductor | CSNP32GCR01-BOW | LGA-8 | 8.0 x 6.2 x 0.75 |  | 32 Gbit, SPI mode pins RSV, CS, SCLK, VSS, DI, DO, RSV, VCC; Vcc 2.7 to 3.6 V; standby under 200 uA; read and write current not read; 2 channels 230 MB per hour so about 16 hours (3.7 GB usable) | DS | design/datasheets/slim2_cs-sdnand-20230403.pdf p4, p5, p6 ; design/parts/slim-2.md section 2.1 |  | CS Semiconductor or its distributor must answer: price and lead time at quantity 1 (none read), and the read and write current (p7 of the spec not read)
Level shifter, storage bus | U10 | 1 | SPI bus between the 1.8 V main chip and the 3.0 V storage part: SD_SCK, SD_MOSI, SD_CS from 1.8 V to 3.0 V (A to B), SD_MISO from 3.0 V to 1.8 V (B to A); VCCA on VDD_1V8, VCCB on VDD_SD; all ports Hi-Z while VDD_SD is below 100 mV (review F07, sch-notes A6) | Texas Instruments | SN74AXC4T774RSVR | UQFN-16 (RSV) | 2.6 x 1.8 |  | 4-bit dual-supply translator, 0.65 to 3.6 V on each port, independent DIR pins, up to 310 Mbps 1.8 V to 3.3 V, 3000 per reel, status Active Production (TI SCES898C, saved copy evidence/a6/ti_sn74axc4t774.txt) | DS | https://www.ti.com/lit/ds/symlink/sn74axc4t774.pdf ; design/ecad/ring/evidence/a6/ti_sn74axc4t774.txt |  | NEW-12: a distributor must answer: price and stock of SN74AXC4T774RSVR (not read); the lead confirms the level shifter choice (sch-notes A6 open point O3); the board owner must place the 2.6 x 1.8 mm part and C81, C82
Screen supply | U4 | 1 | panel supply, +4.6 V and -2.2 V from the cell | SGMICRO | SGM38046YG/TR | WLCSP-2x2-16B | 2.0 x 2.0 x 0.58 |  | OVDD 2.8 to 4.6 V, OVSS -4.0 to -0.6 V, SWIRE 76 pulses for -2.2 V, quiescent 360 uA, shutdown 0.1 uA, 3000 per reel | DS | design/datasheets/p3_sgm38046.pdf p1, p4, p16, p18
Microphone x2 | U5,U6 | 2 | PDM microphone, top port facing down through the floor, one stereo input (architecture 17.19); pins 1 DATA, 2 CLOCK, 3 SELECT, 4 Vdd, 5 to 8 GROUND | Knowles | SPK0641HT4H-1 | 8-pad LGA, top port 0.25 mm | 4.00 x 3.00 x 1.00 |  | SNR 64.5 dB(A), sensitivity -26 dBFS, 630 uA at 1.8 V (710 max), supply 1.6 to 3.6 V, clock 1.0 to 4.8 MHz, AOP 120 dB SPL (Knowles Rev A sheets 2 and 6, third-party host copy); U5 at X -10.8 and U6 at X +10.8, Y -4.8, ports 23.54 mm apart | DS | design/mech/mic-path/datasheets/knowles-spk0641ht4h-1_chipsmall.pdf sheets 2, 4, 6 ; design/mech/mic-path/mic-path.md sections 3, 4, 9 ; design/architecture.md 17.19 |  | S23: Knowles or a distributor must answer: the orderable code (reel suffix) and stock of SPK0641HT4H-1; price at quantity 1 not read; second source SPK0838HT4H-B has another pin order
Screen | DISP1 | 1 | 0.95 inch AMOLED 120 x 240, 4-wire SPI, driver SH8501A, with 15-pin tail | Tailor Pixels | TOH095XVT-01 | module with FPC tail | 12.8 x 27.35 x 0.8 |  | active area 10.8 x 21.6, ELVDD 4.55 to 4.65 V, ELVSS -2.3 to -2.1 V, VCI 2.7 to 3.6 V, IOVCC 1.65 to 3.3 V, 15 contacts, no connector part number in the document | DS | design/datasheets/display_TOH095XVT-01.pdf p4, p5, p6 |  | 12.1
Screen connector | J1 | 1 | board-side connector for the 15-contact screen tail | Hirose | FH35C-15S-0.3SHW(50) | FPC 0.3 mm pitch, 15 positions |  | 0.88 mm high, 0.20 mm cable | pitch not printed in the screen datasheet; architecture states 0.3 mm; tail 0.2 mm thick with PI stiffener | LIST | design/parts/order-codes.md | GBP 1.76 | 12.1 and S8: Tailor Pixels must answer whether the screen tail is 0.3 mm pitch (the datasheet prints no pitch; 0.5 mm would need about 7 mm)
Antenna | ANT1 | 1 | 2.4 GHz chip antenna | Johanson | 2450AT18D0100001E | SMD EIA 1206 | 3.2 x 1.6 x 1.2 |  | 2400 to 2500 MHz, efficiency 72 %, peak gain 1.5 dBi, return loss 6 dB min, 50 ohm; keep-out 4.2 x 4.7 mm no copper on any layer; datasheet gives no matching values (footnote 4: pi network slots) | DS | <work>/ai-ring-recorder-power-evidence/johanson_2450AT18D0100_rev5.0.pdf p1, p3
Antenna match, inductor | L2 | 1 | RF match, Nordic reference L2 | Murata | LQP03HQ3N6B02 | 0201 | 0.6 x 0.3 | 3.6 nH | 500 mA, +/-0.1 nH; retune on the real board (bench B4) | DS | <work>/ai-ring-recorder-bom-evidence/nordic_caaa_bom.txt ; design/datasheets/nrf54lm20x_caaa_ref_schematic_0_2.pdf p1
Antenna match, inductor | L3 | 1 | RF match, Nordic reference L3 | Murata | LQP03HQ4N7H02 | 0201 | 0.6 x 0.3 | 4.7 nH | 400 mA, +/-3 %; retune on the real board (bench B4) | DS | <work>/ai-ring-recorder-bom-evidence/nordic_caaa_bom.txt ; design/datasheets/nrf54lm20x_caaa_ref_schematic_0_2.pdf p1
Antenna match, inductor | L4 | 1 | RF match, Nordic reference L4 | Murata | LQP03HQ3N3B02 | 0201 | 0.6 x 0.3 | 3.3 nH | 500 mA, +/-0.1 nH; retune on the real board (bench B4) | DS | <work>/ai-ring-recorder-bom-evidence/nordic_caaa_bom.txt ; design/datasheets/nrf54lm20x_caaa_ref_schematic_0_2.pdf p1
Antenna match, capacitor | C3 | 1 | RF match, Nordic reference C3 | Murata | GJM0335C1H1R2WB01D | 0201 | 0.6 x 0.3 | 1.2 pF | NP0, +/-0.05 pF, 50 V | DS | <work>/ai-ring-recorder-bom-evidence/nordic_caaa_bom.txt ; design/datasheets/nrf54lm20x_caaa_ref_schematic_0_2.pdf p1
Antenna match, capacitor | C12 | 1 | RF match, Nordic reference C12 | Murata | GJM0335C1ER50WB01D | 0201 | 0.6 x 0.3 | 0.5 pF | C0G, +/-0.05 pF, 25 V | DS | <work>/ai-ring-recorder-bom-evidence/nordic_caaa_bom.txt ; design/datasheets/nrf54lm20x_caaa_ref_schematic_0_2.pdf p1
Antenna match, capacitor (not mounted) | C13 | 1 | RF match tuning pad, Nordic reference C13, left empty |  |  | 0201 | 0.6 x 0.3 | not mounted | pad only, no part fitted at first build; Nordic lists N.A. | DS | <work>/ai-ring-recorder-bom-evidence/nordic_caaa_bom.txt ; design/datasheets/nrf54lm20x_caaa_ref_schematic_0_2.pdf p1 |  | NEW-6 footprint only, nothing to buy: the bench B4 owner answers after antenna tuning whether a capacitor is fitted
32 MHz crystal | X1 | 1 | main chip high-frequency clock | Kyocera | CX2016DB32000D0WZRC1 | XTAL_2016 | 2.0 x 1.6 | 32 MHz | load 8 pF, total tolerance +/-40 ppm; Nordic reference shows no external load capacitor | DS | <work>/ai-ring-recorder-bom-evidence/nordic_caaa_bom.txt ; design/datasheets/nrf54lm20x_caaa_ref_schematic_0_2.pdf p1
32.768 kHz crystal | X2 | 1 | main chip low-frequency clock | TXC | 9HT11-32.768KDZC-T | XTAL_2012 | 2.0 x 1.2 | 32.768 kHz | load 9 pF, +/-20 ppm; Nordic reference shows no external load capacitor | DS | <work>/ai-ring-recorder-bom-evidence/nordic_caaa_bom.txt ; design/datasheets/nrf54lm20x_caaa_ref_schematic_0_2.pdf p1
Chip power coil | L1 | 1 | DC/DC inductor of the main chip | TDK | MLZ1608M4R7WT000 | 0603 | 1.6 x 0.8 | 4.7 uH | 120 mA, +/-20 %, 0.65 ohm | DS | <work>/ai-ring-recorder-bom-evidence/nordic_caaa_bom.txt ; design/datasheets/nrf54lm20x_caaa_ref_schematic_0_2.pdf p1
Ferrite bead | FB1 | 1 | supply filter, Nordic reference FB1 | Murata | BLM03AG121SN1D | 0201 | 0.6 x 0.3 | 120 ohm at 100 MHz | 0.2 A, 500 mohm max | DS | <work>/ai-ring-recorder-bom-evidence/nordic_caaa_bom.txt ; design/datasheets/nrf54lm20x_caaa_ref_schematic_0_2.pdf p1
Resistor 2.2 ohm | R1 | 1 | Nordic reference R1 | Yageo | RC0603FR-072R2L | 0603 | 1.6 x 0.8 | 2.2 ohm 1 % | +/-1 %, 0.1 W | LIST | design/parts/order-codes.md
Resistor 220 ohm | R2 | 1 | Nordic reference R2 | Yageo | RC0201FR-07220RL | 0201 | 0.6 x 0.3 | 220 ohm 1 % | +/-1 %, 0.05 W | LIST | design/parts/order-codes.md
Capacitor 100 nF | C1,C2,C5 | 3 | main chip supply decoupling, Nordic reference | Samsung | CL03A104KP3NNNC | 0201 | 0.6 x 0.3 | 100 nF X5R 10 V | X7R, +/-10 %, 10 V | LIST | design/parts/order-codes.md |  | NEW-8 Nordic lists X7R; only an X5R 0201 code was found; confirm with the distributor
Capacitor 10 uF | C4 | 1 | main chip supply bulk, Nordic reference | Murata | GRM155R60J106ME15D | 0402 | 1.0 x 0.5 | 10 uF X5R 6.3 V | X6S, +/-20 %, 6.3 V | LIST | design/parts/order-codes.md | GBP 0.13
Capacitor 4.7 uF 0201 | C6 | 1 | main chip decoupling, Nordic reference | Murata | GRM035R60J475ME15J | 0201 | 0.6 x 0.3 | 4.7 uF | X5R, +/-20 %, 6.3 V | DS | <work>/ai-ring-recorder-bom-evidence/nordic_caaa_bom.txt ; design/datasheets/nrf54lm20x_caaa_ref_schematic_0_2.pdf p1
Capacitor 2.2 uF | C7,C10,C14 | 3 | main chip decoupling, Nordic reference | Murata | GRM033D80E225ME47D | 0201 | 0.6 x 0.3 | 2.2 uF | X6T, +/-20 %, 2.5 V | DS | <work>/ai-ring-recorder-bom-evidence/nordic_caaa_bom.txt ; design/datasheets/nrf54lm20x_caaa_ref_schematic_0_2.pdf p1
Capacitor 4.7 uF 0402 | C11 | 1 | main chip decoupling, Nordic reference | Murata | GRM155R61A475MEAAD | 0402 | 1.0 x 0.5 | 4.7 uF | X5R, 10 V | DS | <work>/ai-ring-recorder-bom-evidence/nordic_caaa_bom.txt ; design/datasheets/nrf54lm20x_caaa_ref_schematic_0_2.pdf p1
Screen supply coil | L10 | 1 | SGM38046 inductor, datasheet L1 | Murata | 1269AS-H-2R2M=P2 | 2.5 x 2.0 x 1.0 mm | 2.5 x 2.0 x 1.0 | 2.2 uH | datasheet alternative ZTLF-2016TB-2R2M (ZenithTek) | DS | design/datasheets/p3_sgm38046.pdf p4 Table 1; design/datasheets/w1b_murata_1269as-h-2r2m.pdf p2 (code, 2.2 uH +-20 %, DCR 156 mohm max, 1.9 A saturation), p1 (2.5 x 2.0 x 1.0 max), p5 (land)
Capacitor 4.7 uF 0402 10 V | C21,C26,C27 | 3 | SGM38046 datasheet C1, C6, C7 (0402 instead of the sheet's 0603: board plan round 4, lead's ruling) | Murata | GRM155R61A475MEAAD | 0402 | 1.0 x 0.5 x 0.65 max | 4.7 uF | X5R, 10 V, +-20 %; about 2.4 uF left at 4.35 V (C21), 3.05 uF at 3.3 V (C26), 2.55 uF at 4.1 V (C27) by the maker's DC bias graph | DS | design/datasheets/w1d_murata_grm155r61a475meaa.pdf p1 and p2; design/datasheets/p3_sgm38046.pdf p4 Table 1; design/ecad/ring/pcb/u4-capacitors.md section 3 |  | bench: ripple on VBAT at U4, SGM_AVDD and SGM_VON at full white screen (the sheet gives no minimum capacitance)
Capacitor 10 uF 0603 16 V | C24 | 1 | SGM38046 datasheet C4 | Murata | GRM188R61C106KAALD | 0603 | 1.6 x 0.8 | 10 uF | X5R, 16 V | DS | design/datasheets/p3_sgm38046.pdf p4 Table 1
Capacitor 10 uF 0402 6.3 V | C25 | 1 | SGM38046 datasheet C5 (0402 instead of the sheet's 0603: board plan round 4, lead's ruling) | Murata | GRM155R60J106ME15D | 0402 | 1.0 x 0.5 x 0.65 max | 10 uF | X5R, 6.3 V, +-20 %; about 2.7 uF left at 4.6 V by the maker's DC bias graph | DS | design/datasheets/w1d_murata_grm155r60j106me15.pdf p1 and p2; design/datasheets/p3_sgm38046.pdf p4 Table 1; design/ecad/ring/pcb/u4-capacitors.md section 3 |  | bench: ripple on ELVDD at full white screen (the sheet gives no minimum capacitance)
Capacitor 2.2 uF 0402 | C23 | 1 | SGM38046 datasheet C3 | Murata | GRM155R60J225ME15 | 0402 | 1.0 x 0.5 | 2.2 uF | X5R, 6.3 V | DS | design/datasheets/p3_sgm38046.pdf p4 Table 1
Capacitor 10 uF 0402 | C22 | 1 | SGM38046 datasheet C2 | Murata | GRM155R60J106ME15 | 0402 | 1.0 x 0.5 | 10 uF | X5R, 6.3 V | DS | design/datasheets/p3_sgm38046.pdf p4 Table 1
Capacitor 22 uF 0402 | C28,C29 | 2 | SGM38046 datasheet C8, C9 (panel rail outputs) | Murata | GRM155R60J226ME11D | 0402 | 1.0 x 0.5 | 22 uF | X5R, 6.3 V | DS | design/datasheets/p3_sgm38046.pdf p4 Table 1
Microphone bypass capacitor | C31,C32 | 2 | one per microphone (2), 1 uF on VDD_MIC kept from W4; Knowles sheet 4 (text lines 230 to 231): 'Bypass capacitors should be placed next to each microphone's Vdd pin' and 'Capacitors near the microphone should not contain Class 2 dielectrics': this X5R part is Class 2, so it sits on VDD_MIC away from the microphone and C35, C36 are the bypass next to Vdd | Murata | GRM033R60J105MEA2D | 0201 |  | 1 uF X5R 6.3 V | package not stated; place within 1.2 mm height zone under the board | LIST | design/mech/mic-path/datasheets/knowles-spk0641ht4h-1_chipsmall.pdf sheet 4 ; design/parts/order-codes.md | CAD 0.15
Microphone decoupling capacitor | C35,C36 | 2 | one per microphone (2), 0.1 uF next to the Vdd pin (Knowles SPK0641HT4H-1 sheet 4, Figure 4); no Class 2 dielectric near the microphone (same sheet) | Kyocera AVX | 04025A102JAT2A | 0402 | 1.0 x 0.5 x 0.56 max | 1.0 nF C0G 50 V | Class 1 C0G, 50 V, +-5 %; AVX C0G table PDF p3 (printed p5): 0402 row 1000 pF at 16, 25, 50 V, thickness code C = 0.56 mm; the table has 0.1 uF C0G only in 1206 (2.29 mm). Knowles asks 0.1 uF at the Vdd pin (Figure 4, PDF p4 of w1b_knowles copy): that value is NOT met with a Class 1 part of this height; the build guide measures the noise floor. C31, C32 (Class 2, 1 uF) stay at least 2.0 mm from each microphone edge and carry the bulk | DS | design/datasheets/w1_kyocera_avx_c0g_dielectric.pdf PDF p3; design/datasheets/w1b_knowles_spk0641ht4h-1_chipdip.pdf PDF p4 (Figure 4 and notes); lead ruling 2026-11-13
Microphone output termination resistor | R31,R32 | 2 | series resistor on DATA, one per microphone (2); design choice kept from W4 (the SPK0641HT4H-1 sheet names no series resistor); pads kept on the board | Yageo | RC0201FR-07100RL | 0201 |  | 100 ohm 1 % | about 100 ohm per datasheet; optional, keep pads on the board | LIST | design/parts/order-codes.md | GBP 0.07
Joystick switches x4 | SW1,SW3,SW4,SW5 | 4 | 4 directions under the round joystick cap CAP1: SW1 up, SW3 down, SW4 toward the hand, SW5 toward the fingertip (architecture 17.11, 17.29); the centre press is the switch SW2 under the centre of the cap | Alps Alpine | SKTAAAE010 | SMD tact switch, projection type | 2.6 x 1.6 x 0.53 |  | 1.6 +/-0.5 N, travel 0.11 mm, 300,000 presses, IP6X and IPX7, 12 V 50 mA max; outline 2.6 x 1.6 x 0.53 is search text (LCSC), land pattern not in the document; in a cross at 2.4 mm from the centre of the cap (architecture 17.24 and 17.29); the land pattern is open (S9) | DS | design/datasheets/slim_alps-skta-aaae010-orwin.pdf p1 to p4 ; design/parts/slim.md section 3.1 |  | S9: Alps Alpine or its distributor must answer: the outline and land pattern drawing of SKTAAAE010, price at quantity 1 (search text only), and whether the part is in production (document marked 'For reference')
Joystick centre switch (the former record button; no record button remains) | SW2 | 1 | 1 switch under the centre of the round joystick cap CAP1, on net BTN_REC: a long press of 1.0 s starts and stops a recording, a short press while recording marks a highlight (architecture 17.11); second choice if it does not fit between the four direction switches: two opposite direction switches closing within 40 ms (16.5, bench item B6) | Alps Alpine | SKTAAAE010 | SMD tact switch, projection type | 2.6 x 1.6 x 0.53 |  | same part as the joystick switches (1.6 N, 0.11 mm travel, 300,000 presses) | DS | design/datasheets/slim_alps-skta-aaae010-orwin.pdf p1 to p4 |  | S9: same drawing question as SW1 to SW4
I2C pull-up resistors | R57,R58 | 2 | PMIC_SDA and PMIC_SCL pull-ups to VDD_1V8 | Yageo | RC0201FR-074K7L | 0201 |  | 4.7 kohm 1 % | value not in any source; nPM1300 datasheet not obtained | LIST | design/parts/order-codes.md
Storage bus pull-up resistors | R60 | 1 | storage pull-up (one of four, with R63 to R65), architecture W3; W3 stands for the CS part (16.4: same footprint) | Yageo | RC0201FR-0747KL | 0201 |  | 47 kohm 1 % | Zetta datasheet limits pull-up resistance RCMD and RDAT to 10 to 100 kohm | LIST | design/parts/order-codes.md; architecture.md W3
Storage supply capacitor | C60 | 1 | storage supply capacitor (with C61, 100 nF); 2.2 uF as the storage maker recommends (lead decision 24), was 4.7 uF | Kyocera AVX | 0402ZC225KAT2A | 0402 | 1.0 x 0.5 x 0.71 max | 2.2 uF 10 V X7R | X7R, 10 V, +-10 %; storage maker recommends 2.2 uF on VCC (slim2_cs-sdnand-20230403.pdf PDF p11); AVX X7R table PDF p3: row 2.2 uF, 0402, 10 V, code E = 0.71 mm max | DS | design/datasheets/slim2_cs-sdnand-20230403.pdf PDF p11; design/datasheets/w1_kyocera_avx_x7r_dielectric.pdf p1 and p3; design/wiring/lead-decisions.md item 24
Vibration motor | M1 | 1 | haptic motor in the joystick-side shoulder of the band, 0.7 mm off the band's centre line, at -47.0, -45.5, -44.0, -45.0, -43.5, -42.5, -42.5 degrees from the top on US 7, 8, 9, 10, 11, 12, 13 (design/mfg/specs/body.md 'motor position'; architecture 17.26 and 17.27; inside model v7); red lead + on VMOT (U11 output), blue lead - on ground; two lead wires soldered to flex tail A pads MOT+ and MOT- (BAND_SPLIT table of make_netlist.py) | Jinlong Machinery | W0525AB001D | coin, brushless, 2 lead wires (red +, blue -) | 5.0 dia x 2.5 | 3.0 V DC | rated 3.0 V, operating 2.7 to 3.3 V, rated current below 80 mA, starting current below 175 mA (rotor held), starting voltage below 2.5 V, 14,000 +-3,000 rpm, 0.25 G (avg), 0.32 g, life 1,000,000 cycles; has its own drive IC and Hall sensor | DS | design/datasheets/slim2_jinlong-w0525ab001d.pdf p2, p4, p5, p6, p8, p11 (Jinlong spec S-525113 rev 0, copy from a third-party host) ; design/parts/slim-2.md section 1.4 ; design/mech/thin/thin-notes.md row B and K5, K6 |  | S21 closed by design/ecad/motor-drive/motor-drive.md: the motor is fed from VBAT by U11, outside the nPM1304 limit; the maker must confirm the part and its price (no price read); rim metal at the motor is 0.425 mm (rule 0.40)
Motor regulator (in place of the motor switch and the motor diode) | U11 | 1 | 3.0 V LDO from VBAT for the motor, enabled by MOTOR; keeps the motor current out of the nPM1304 battery limit (architecture 17.22) | Texas Instruments | TLV75530PDQNR | X2SON-4 (DQN) | 1.0 x 1.0 x 0.4 max | 3.0 V | 500 mA, dropout 325 mV max at 500 mA, +-1.2 %, shutdown 1 uA max | DS | design/datasheets/motor_tlv755p.pdf p3 p5 p6 p28 p41 ; design/ecad/motor-drive/motor-drive.md 2.2 |  | S22: bench proof of this circuit and the layout room for U11, C83, C84 (architecture 17.22); price not read
Capacitor 10 uF 0402 6.3 V | C83 | 1 | U11 input (C84 at the output is a separate line since the change of 2026-11-13) | Murata | GRM155R60J106ME15 | 0402 | 1.0 x 0.5 | 10 uF | X5R, 6.3 V | DS | design/datasheets/p3_sgm38046.pdf p4 Table 1 ; design/ecad/motor-drive/motor-drive.md 2.2
Capacitor 4.7 uF 0402 10 V | C84 | 1 | U11 output; also the 2 uF or more across the motor that Jinlong asks; 4.7 uF in place of 10 uF (lead-decisions.md rows "sim finding 4 (item 41)" and "sim finding 4, correction") | Murata | GRM155R61A475MEAAD | 0402 | 1.0 x 0.5 | 4.7 uF | X5R, 10 V, +-20 %; T 0.5 +-0.15 mm (0.65 max); DC bias graph p2: about 3.9 uF at 2 V, 2.6 uF at 4 V (as read in design/ecad/ring/pcb/u4-capacitors.md) | DS | design/datasheets/w1d_murata_grm155r61a475meaa.pdf p1 p2 ; design/ecad/ring/pcb/u4-capacitors.md ; design/wiring/lead-decisions.md
Cell, curved | BT1 | 1 | custom curved cell in the band, 4.35 V; from +48.7 degrees through the bottom to -99.0 degrees at US 9 (inside model v6, architecture 17.26; before it -98.0 degrees) | Grepow (custom order) |  | curved pouch | 1.6 x 6.0 x 39.175 on its centre line at US 9 | 20 to 27 mAh at US 9 (17.6 to 23.5 mAh at US 7) | 376.1 cubic mm x 0.054 to 0.072 mAh per cubic mm = 20.3 to 27.1 mAh at US 9 (architecture 17.26); 4.35 V; charge 15 mA (0.55 to 0.74 C at US 9: 15 / 27.1 and 15 / 20.3; 0.85 C of 17.6 mAh at US 7) with the nPM1304 until Grepow states its own limit (architecture 17.13, S12); the motor draws up to 175 mA at each start (17.16); measured per ring size in inside model v6: 17.6 to 23.5 mAh at US 7 (33.936 mm) up to 23.9 to 31.9 mAh at US 13 (46.121 mm), smallest 17.6 mAh at US 7 (architecture 17.26; replaces the calculated table of 17.17) | CALC | design/architecture.md sections 17.13, 17.15, 17.16 (S12) ; design/mech/thin/thin-notes.md section Model v4 ; design/architecture.md 17.17 ; design/architecture.md 17.26 |  | S12: Grepow must answer: can it build the curved cell 1.6 x 6.0 x 39.175 mm on its centre line at US 9 (17.26) at 4.35 V, its order code, price, the highest charge current it accepts (the nPM1304 sets 4 to 100 mA) and the discharge current the cell and its protection circuit allow (motor start 175 mA, 17.16)
Cell protection circuit | PRT1 | 1 | protection circuit on the cell's tab, inside the cell envelope; its start is at 43.8 degrees on US 7, 41.5 degrees on US 8 and 39.5 degrees on US 9 to 13, from the top on the +Y side, before the cell's start (design/mfg/specs/cell.md, architecture 17.26; older values -35 to -27 degrees of 17.10 are replaced) | Grepow (custom order) |  | board on the cell tab | 1.5 x 5 |  | part of the cell order; thresholds not stated in the architecture | CALC | design/architecture.md section 17.3 |  | S12: Grepow must answer: the protection circuit part code and its overvoltage, overcurrent and undervoltage limits
Main circuit board | PCB1 | 1 | main board, parts on both faces: the parts face and the screen face (J1, eight 0201 passives C1, C2, C5, C7, C14, R71, R72, FB1, and the 12 test pads; design/ecad/ring/pcb/placement-final.csv side B); 2 flex tails leave it through slots in the block floor |  |  | 4 copper layers, any-layer microvias | 27.2 x 12.6 x 0.3 |  | 0.30 mm board, 4 copper layers, any-layer microvias (via spans in design/ecad/ring/pcb/board-notes-r3.md); 0.325 mm ball pitch of U1; 12 test pads TP1, TP3, TP4, TP5, TP6, TP12, TP14, TP15, TP17, TP18, TP19, TP21 (design/ecad/ring/parts.csv); routed board design/ecad/ring/pcb/ring.kicad_pcb, fabrication files design/ecad/ring/pcb/fab/; sound holes: none (top-port microphones port down through the floor) | CALC | design/architecture.md section 17.2, 17.4 ; section 16.3 |  | NEW-2 custom part: a board maker must quote 4 copper layers with any-layer microvias (blind and buried spans as in the drill files of design/ecad/ring/pcb/fab/), 0.30 mm, parts on both faces
Test pads | TP1,TP3,TP4,TP5,TP6,TP12,TP14,TP15 | 8 | copper pads on PCB1: DBG_TX, SWDCLK, SWDIO, nRESET and 4 spare pins (P1.00, P2.00, P3.03, P3.04); no part to buy; with TP17, TP18, TP19 and TP21 (their own lines) the board has 12 test pads: TP1, TP3, TP4, TP5, TP6, TP12, TP14, TP15, TP17, TP18, TP19, TP21 (design/ecad/ring/parts.csv); TP7 (P1.01) and TP10 (P1.19) removed with their balls E8 and E5 (design/wiring/ring-board-plan.md a.2); TP2 (DBG_RX, P1.16) and TP13 (P2.03) removed with their balls B5 and B9 (lead's ruling b, design/ecad/ring/pcb/board-notes-r2.md); TP8 (P1.02), TP9 (P1.14) and TP11 (P1.30) removed with their spare nets (lead's decision of 2026-11-13, pin changes for routing, design/ecad/ring/pcb/board-notes-r3.md) |  |  |  |  |  | 1 + 3 + 4 = 8 pads: DBG_TX, the 3 programming pads and the 4 spare pins of architecture section 7 that keep a test pad | CALC | design/architecture.md section 7 |  | NEW-6 footprint only, nothing to buy: the ring electronics designer places the pads
Metal body (block and band) | HSG1 | 1 | one metal body: block 29.3 x 14.75 mm in plan, 3.85 mm high at the centre line and 2.95 mm at the long edges, with the 8.0 mm wide band, 2.6 mm thick, 3.6 mm at the shoulders (19 to 61 degrees) and at the joystick (zone measured again in the rebuild, architecture 17.11), inner diameter by ring size (18.95 mm at US 9); 7 sizes US 7 to 13 as files |  |  | machined | 29.3 x 14.75 x 3.85 block |  | plan corner radius 2.5; glass face curved across the finger, arc radius 30.7; shell 0.5 mm outside and 0.6 mm at each edge, channel 7.0 mm wide (inside model v9; design/mfg/specs/body.md); openings: 2 floor pockets 4.4 x 3.35 x 0.10, 2 holes 1.0 dia, 2 seats 2.0 dia x 0.10 on the underside (no microphone slots; design/mech/mic-path/mic-path.md section 5), 2 floor slots, joystick: round opening 5.6 dia holding the round frame FRM1 (5.40 outer dia, bonded with a 0.10 mm radial gap), on the outer face at -84.0 degrees on US 7, -81.0 on US 8 and -78.0 on US 9 to 13, on the joystick side (minus side, toward the thumb on a ring worn on the right index finger; architecture 17.25, 17.29); no record opening; no pad holes: the 4 charging pads are on the inside face of the band in the resin liner (architecture 17.12); material titanium grade 5 (Ti-6Al-4V) (architecture 17.29); finish: one dark glossy finish, polished then gloss black coating, PVD or DLC (architecture 17.29) | CALC | design/architecture.md section 17.8, 17.1, 17.3, 16.10 |  | S13: a ring maker or the design partner must answer: who machines the one-piece body, material, price and a drawing per ring size
Cover glass | GL1 | 1 | chemically strengthened cover glass, one formed piece curved across the finger (one arc of radius 30.7 mm rising 0.90 mm from the long edges to the centre line, then a 1.0 mm roll into the side walls, 1.2 mm roll at the two ends); the screen under it stays flat; rolled edge continues into the metal (architecture 17.8) |  |  |  | 29.2958 x 14.429 x 1.10 at the centre | 1.10 mm at the centre | plan outline 29.2958 x 14.429 mm taken from the maker file design/mfg/parts/cover-glass/cover-glass.step (design/mfg/parts/index.csv line 14: box of the glass in the accepted exterior design/look/s1/out/ring-merged32h.step); the inside model uses the same glass solid (design/mech/thin/placement.csv row cover_glass: 29.296 x 14.429); 1.10 mm thick at the centre, 0.42 mm over the screen's edge, chemically strengthened, formed (curved) piece, rolled edge, black print outside the lit area with no opening in the print (architecture 17.30) | CALC | design/architecture.md section 17.1, 17.4 |  | Design partner must answer: glass maker, drawing with the rolled edge and print, and quote (no supplier in any source)
Clear adhesive | ADH1 | 1 | clear adhesive bonding the cover glass to the screen over the whole face, 0.10 mm, so no air gap shows the edge of the lit area (architecture 17.2, 17.30) |  |  |  |  |  | 0.10 mm, optically clear, full face: covers the whole face of the panel under the glass (architecture 17.30); outline equals the panel face given by the mechanics step | CALC | design/architecture.md section 17.2, 17.30 |  | Design partner must answer: adhesive product, outline and quote (no supplier in any source)
Glass seal | SEAL1 | 1 | perimeter seal ring between the cover glass and the body's glass seat, in a seat lowered 0.05 mm (architecture 17.23 K-A4, 17.24) |  |  | die-cut adhesive ring | 0.05 thick, under the glass edge outside the panel pocket |  | volume 3.01 cubic mm in the model; tape not chosen; compressed thickness unknown | CALC | design/mech/thin/thin-notes.md section Model v5 ; design/mfg/assembly/assembly.md step 23 |  | S26: a tape maker must answer: material, thickness after pressing, and quote
Joystick dam | DAM1 | 1 | UV-cured dam frame on the liner round the switch head of the joystick, keeps cast resin out of the switches (architecture 17.23 K-A3, 17.24) |  |  | dispensed UV-cure dam | frame 0.15 wide round the 5 switch bases, 0.05 off them, up to the base tops |  | seals the edge of the pocket only (thin-notes.md K15) | CALC | design/mech/thin/thin-notes.md section Model v5 ; design/mfg/assembly/assembly.md |  | S26: dam material and process; bench B9
Motor window seal | SEAL2 | 1 | sealant plug in the window between the motor pocket and the block's cavity, ring sizes US 7, 8 and 9 only; same sealant and step as the two floor slots, before the liner is cast (architecture 17.27) |  |  | dispensed sealant | window about 4.0 x 1.1, 0.79 to 0.81 cubic mm |  | not fitted on US 10 to 13 (a 0.34 to 0.41 mm wall stands there); 0.10 from the motor, the motor's adhesive bead closes that gap | CALC | design/mech/thin/thin-notes.md section Model v6.2 ; design/architecture.md 17.27 |  | S26: sealant and method with the floor slots; bench B8
Foam pad | FOAM1 | 1 | foam pad between screen and board, 0.10 mm (architecture 17.2) |  |  |  | 0.10 thick |  | 0.10 mm (A3 gap was 0.20); outline from the mechanics step | CALC | design/architecture.md section 17.2 |  | Design partner must answer: foam product (0.10 mm), outline and quote; 0.2 mm foam code was not found either (order-codes.md)
Microphone seal x2 | MEM1,MEM2 | 2 | acoustic membrane disc over each floor hole of the 2 microphones, in a 2.0 x 0.10 mm seat flush with the underside (architecture 17.19) | Gore |  | disc with adhesive ring | 2.0 dia, 0.10 thick at most |  | hydrophobic acoustic membrane (ePTFE class), at most 0.10 thick with its adhesive; the GAW112 cut on file is 0.24 thick, too thick for the seat (mic-path.md section 5) | CALC | design/mech/mic-path/mic-path.md sections 5 and 9 item 19 |  | 12.6: Gore must answer: a thinner cut (at most 0.10 mm) part number and price; no membrane part is chosen (mic-path.md O4)
Microphone gasket x2 | GSK2,GSK3 | 2 | foam gasket ring between each microphone lid and the floor pocket, PSA on both faces (architecture 17.19) |  |  |  | 1.8 outer dia, 1.0 bore | free thickness 0.10, 0.20 or 0.30, chosen per unit | soft closed-cell foam ring OD 1.8, bore 1.0, PSA both faces; thickness chosen per unit from the measured lid gap (mic-path.md section 8) | CALC | design/mech/mic-path/mic-path.md sections 5, 8 and 9 item 20 |  | S23: a gasket maker must answer: material, the three thicknesses and quote; bench B7 (seal, response)
USB protection array | U9 | 1 | W7 USB protection array for VBUS, D+, D- (architecture W7; 'protection parts' unchanged in 17.4); placement on the main board beside the J_BAND_B pads (no contact board); the charging pads touch the skin (architecture 17.12) | Texas Instruments | TPD4E05U06DQAR | USON-10 (DQA) |  | TPD4E05U06 | TPD4E05U06, 4 channels (TI SLVSBO7O); 'first choice' in order-codes.md section 3 | DS | design/ecad/ring/additions.csv; design/ecad/ring/sch-notes.md |  | NEW-10: a distributor must answer: whether the suffix of TPD4E05U06DQAR is the orderable code of the DQA package (copied from the TI listing). The ring electronics designer must place it, since the contact board is removed
Charging pads x4 | CP1,CP2,CP3,CP4 | 4 | charging pads on the INSIDE face of the band at the point opposite the block (180 degrees), in a row around the band, in the resin liner and not in the metal body, gold-plated flush with the liner, order VBUS, D-, D+, GND (architecture 17.12) |  |  | round pad | 1.6 dia | gold pad 1.6 mm | 4 pads, 2.4 mm pitch along the arc, 0.07 mm thick, set in the liner; the row stands at X = -1.0 mm from the band's middle (architecture 17.15 and 17.28; design/mfg/specs/band-flex-tails.md and band-liner.md); wired in flex tail B (other side); the pebble case (17.12) mates with them | CALC | design/architecture.md section 17.1, 17.3 |  | decided (design/ecad/band/band-interface.md line 141): each pad is a gold-plated disc 1.6 dia x 0.07 thick, soldered flat on its land of flex tail B with SAC305 paste at assembly step 8 and set in the liner at step 21; the case contact is the spring pin Harwin P70-6000045R (design/wiring/ring-case-contact.csv). Open: no maker order code for the disc (a stamped, hard-gold plated disc to this drawing; a code only from a saved maker document)
Motor regulator enable series resistor 100 ohm | R61 | 1 | motor regulator enable series resistor 100 ohm | Yageo | RC0201FR-07100RL | R_0201 |  | 100R |  | LIST | design/ecad/ring/additions.csv; design/ecad/ring/sch-notes.md
Pull-down 100 kohm: motor regulator enable (R62) and screen supply AVDDEN (R66) | R62,R66 | 2 | motor regulator enable pull-down 100 kohm (R62); AVDDEN pull-down 100 kohm (R66, W10) | Yageo | RC0201FR-07100KL | R_0201 |  | 100k |  | LIST | design/ecad/ring/additions.csv; design/ecad/ring/sch-notes.md
Schematic addition: W3 pull-up DAT1 47 kohm | R63,R64,R65 | 3 | W3 pull-up DAT1 47 kohm | Yageo | RC0201FR-0747KL | R_0201 |  | 47k |  | LIST | design/ecad/ring/additions.csv; design/ecad/ring/sch-notes.md
Schematic addition: 100 nF at storage supply (C61), U2 VBUS (C72), U2 VDDIO (C80), U10 supplies (C81, C82) | C61,C72,C80,C81,C82 | 5 | 100 nF: storage supply (W3), U2 VBUS and VDDIO (nPM1300 kit design, to confirm against the nPM1304 product specification (S18)), U10 VCCA and VCCB (TI SN74AXC4T774 datasheet SCES898C section 8, 0.1 uF) | Samsung | CL03A104KP3NNNC | C_0201 |  | 100nF |  | LIST | design/ecad/ring/additions.csv; design/ecad/ring/sch-notes.md |  | C72 and C80: to confirm against the nPM1304 product specification (S18)
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
