NexusGPT/openring/design/case/out/boards_check/main.step

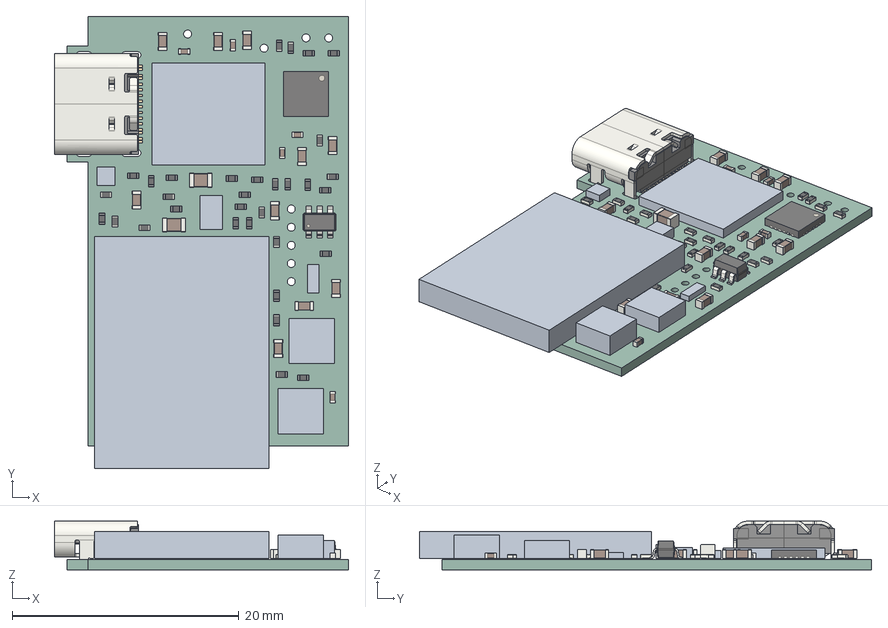
[picture p112: CAD file, 2026-11-13]
design/case/out/boards_check/main.step
25.9 x 39.9 x 4.30 mm
C_0402_1005Metric x 5
R_0402_1005Metric x 32
C_0603_1608Metric x 10
C_0805_2012Metric x 2
SOT-23-6
USB_C_Receptacle_16P_TopMnt_Horizontal_GCT_USB4105-xx-A
QFN-24-1EP_4x4mm_Pitch0.5mm
case_main_PCB
