NexusGPT/openring/design/mfg/parts/main-board/main-board.step

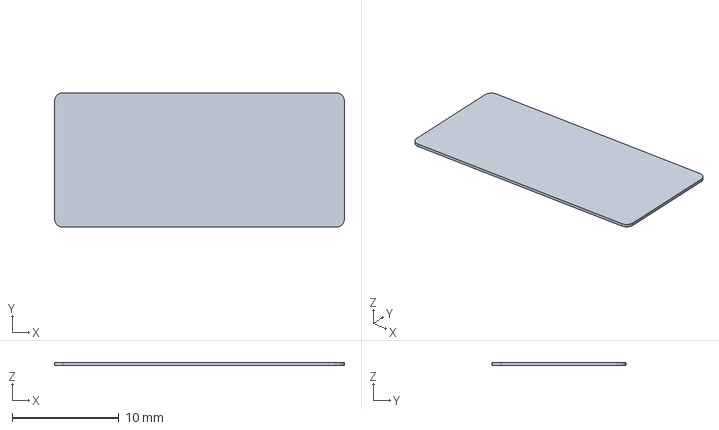
[picture p114: CAD file, 2026-11-13]
design/mfg/parts/main-board/main-board.step
27.2 x 12.6 x 0.28 mm
