NexusGPT/openring/design/mech/out/ring-assembly-size9.step

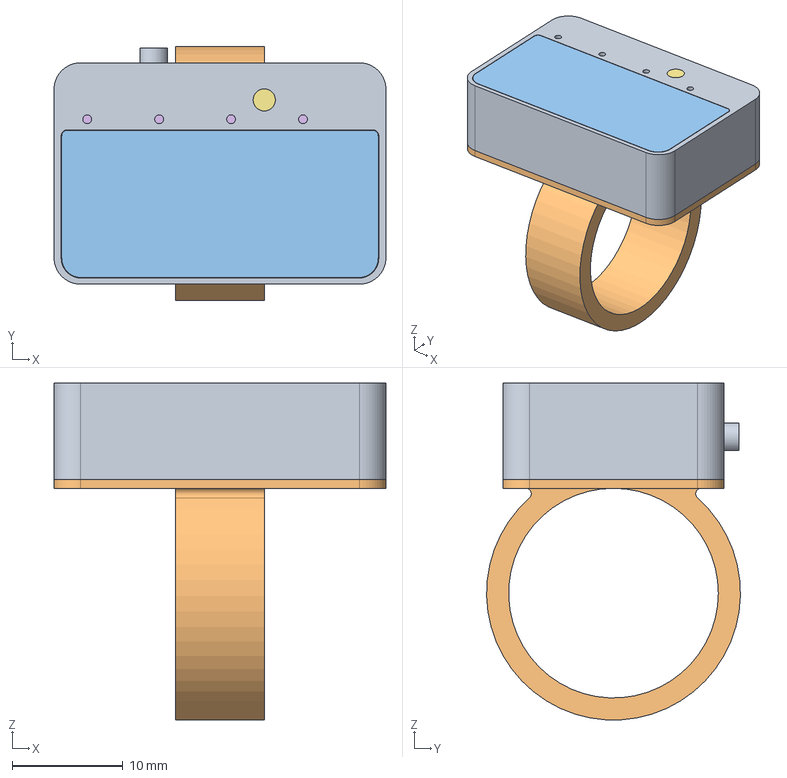
[picture p115: CAD file, 2026-11-13]
design/mech/out/ring-assembly-size9.step
30.0 x 22.9 x 30.4 mm
top_shell
base_size9
cover_glass
clear_adhesive
screen
foam_pad
main_board
joystick_board
joystick_body
joystick_stem
mic1
mic2
mic3
mic4
record_button
record_button_plate
record_key
recording_light
clear_window
antenna
motor
motor_sleeve
cell
cell_swelling
contact_board
screen_cable_fold
storage
main_chip
power_chip
screen_supply_chip
screen_supply_coil
gasket
screw1
screw2
protection_chip_TPD4E05U06
screen_connector_FH35C
wire_pad_main_1
wire_pad_joy_1
wire_pad_main_2
wire_pad_joy_2
wire_pad_main_3
wire_pad_joy_3
wire_pad_main_4
wire_pad_joy_4
wire_pad_main_5
wire_pad_joy_5
wire_pad_main_6
wire_pad_joy_6
