NexusGPT/openring/design/mfg/parts/assembly/ring-assembly-us7.step

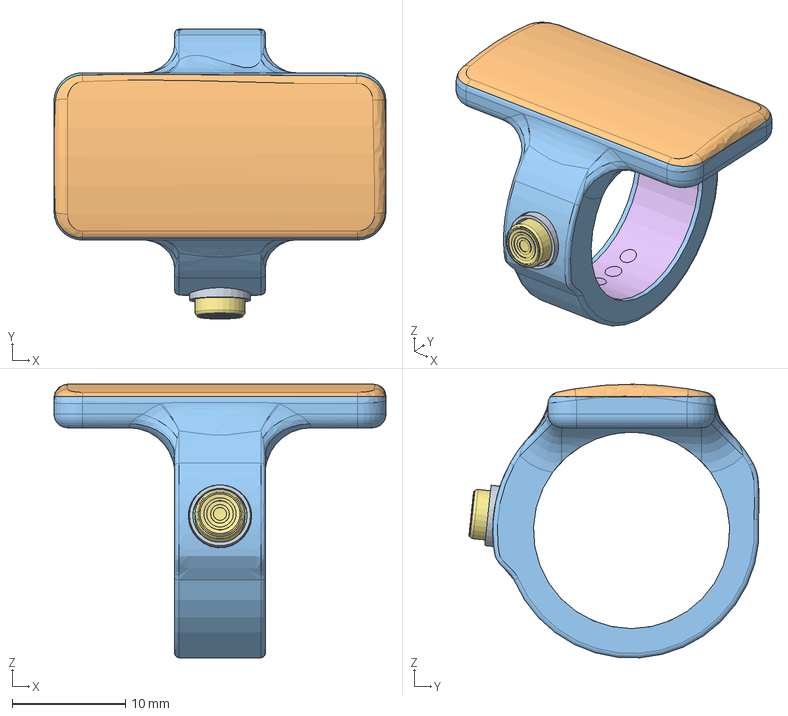
[picture p117: CAD file, 2026-11-13]
design/mfg/parts/assembly/ring-assembly-us7.step
29.3 x 25.6 x 24.1 mm
main_chip__chip
main_chip__mark
main_chip__metal x 61
power_chip__chip
power_chip__mark
power_chip__metal x 35
screen_supply_chip__chip
screen_supply_chip__mark
screen_supply_chip__metal x 16
screen_supply_coil__ceramic
screen_supply_coil__metal x 2
power_coil_1__ceramic
power_coil_1__metal x 2
power_coil_2__ceramic
power_coil_2__metal x 2
crystal_32M__ceramic
crystal_32M__metal
crystal_32k__ceramic
crystal_32k__metal
storage__chip
storage__mark
storage__gold x 9
mic_1__pcb
mic_1__metal
mic_gasket_1__foam
mic_membrane_1__polymer
mic_2__pcb
mic_2__metal
mic_gasket_2__foam
mic_membrane_2__polymer
antenna__ceramic
antenna__metal x 4
screen_connector__polymer
screen_connector__metal
screen_connector__gold x 15
motor_regulator__chip
motor_regulator__mark
motor_cap_in__ceramic
motor_cap_in__metal x 2
motor_cap_out__ceramic
motor_cap_out__metal x 2
main_board__pcb
main_board__resin
main_board__gold x 179
foam__foam
screen__screen
screen__mark
screen_tail__flex x 4
clear_adhesive__polymer
cover_glass__glass
outer_body__metal
glass_seal__polymer
motor_window_seal__polymer
band_liner__resin
joystick_cap__polymer x 2
joystick_frame__metal
joy_sw_fingertip__polymer
joy_sw_fingertip__metal
joy_sw_hand__polymer
joy_sw_hand__metal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
