NexusGPT/openring/design/case/out/case_assembly_US9.step

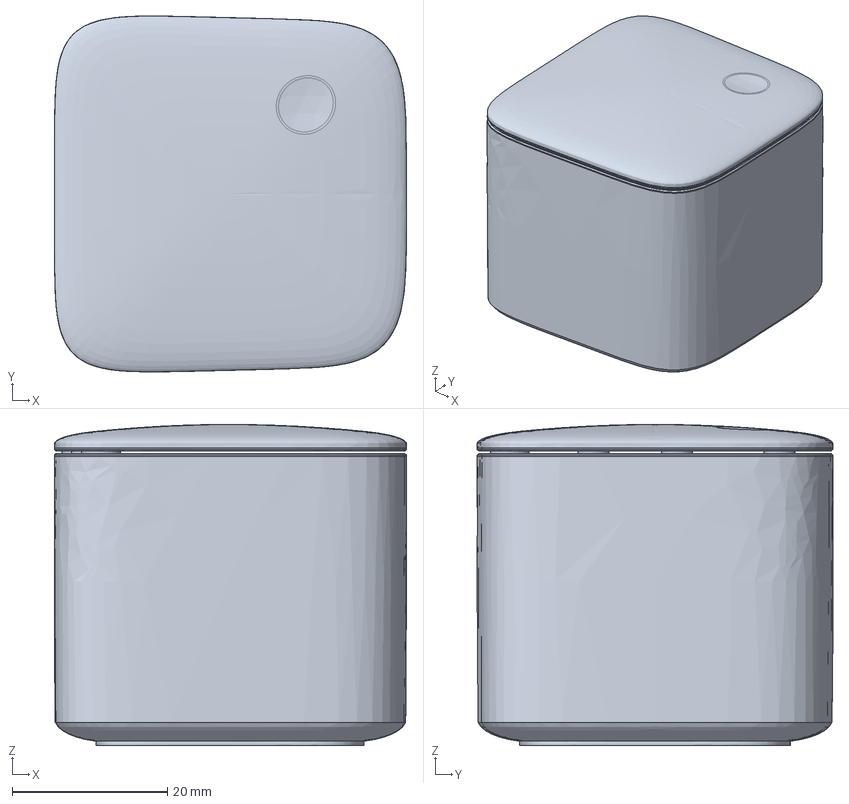
[picture p121: CAD file, 2026-11-13]
design/case/out/case_assembly_US9.step
45.4 x 45.9 x 41.4 mm
PCB1
C_0603_1608Metric x 10
C_0402_1005Metric x 5
C_0805_2012Metric x 2
USB_C_Receptacle_16P_TopMnt_Horizontal_GCT_USB4105-xx-A
R_0402_1005Metric x 32
QFN-24-1EP_4x4mm_Pitch0_5mm
SOT-23-6
cell_dnk852338
foam_pad
insulation_sheet
pin_board_pcb2_wing_R
pin_board_pcb2
pin_board_pcb2_wing_L
pin_P1_VBUS
pin_P2_D-
pin_P3_D+
pin_P4_GND
post
pin_holder
TH1_bead
board_retainer
usb_bezel
light_window
liner
foot
base_plate
seam_trim
lid
lid_seam_trim
hinge_pivot
magnet_base
magnet_lid
glide_1
glide_2
glide_3
glide_4
ring_US9_body
ring_US9_glass
ring_US9_joystick
ring_US9_pads
