NexusGPT/openring/design/case/out/boards/pins.step

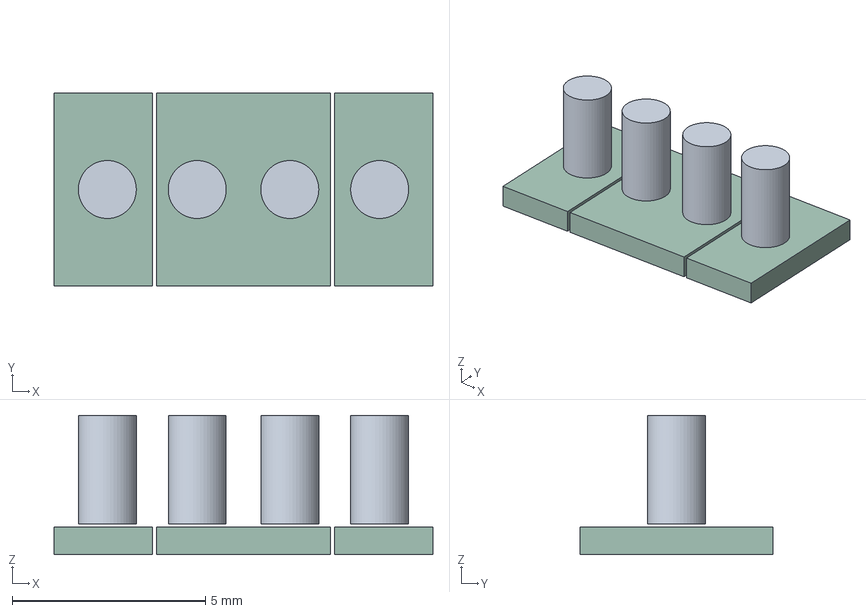
[picture p123: CAD file, 2026-11-13]
design/case/out/boards/pins.step
9.80 x 5.00 x 3.59 mm
case_pins_PCB_1
case_pins_PCB_2
case_pins_PCB_3
