NexusGPT/openring/design/case/out/case_body.stl

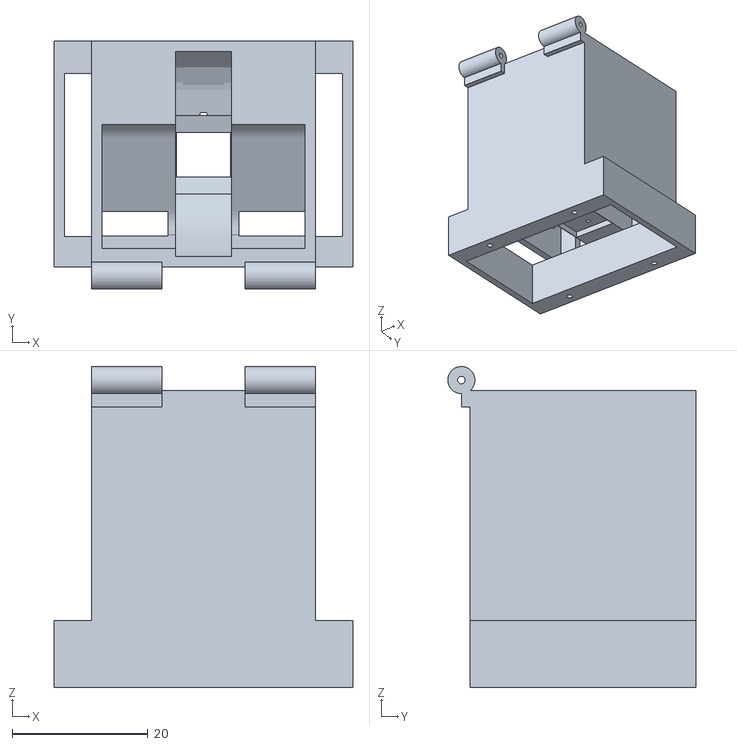
[picture p124: CAD file, 2026-11-13]
design/case/out/case_body.stl
44.0 x 36.6 x 47.3
