NexusGPT/openring/design/case/out/parts/TH1_bead.step

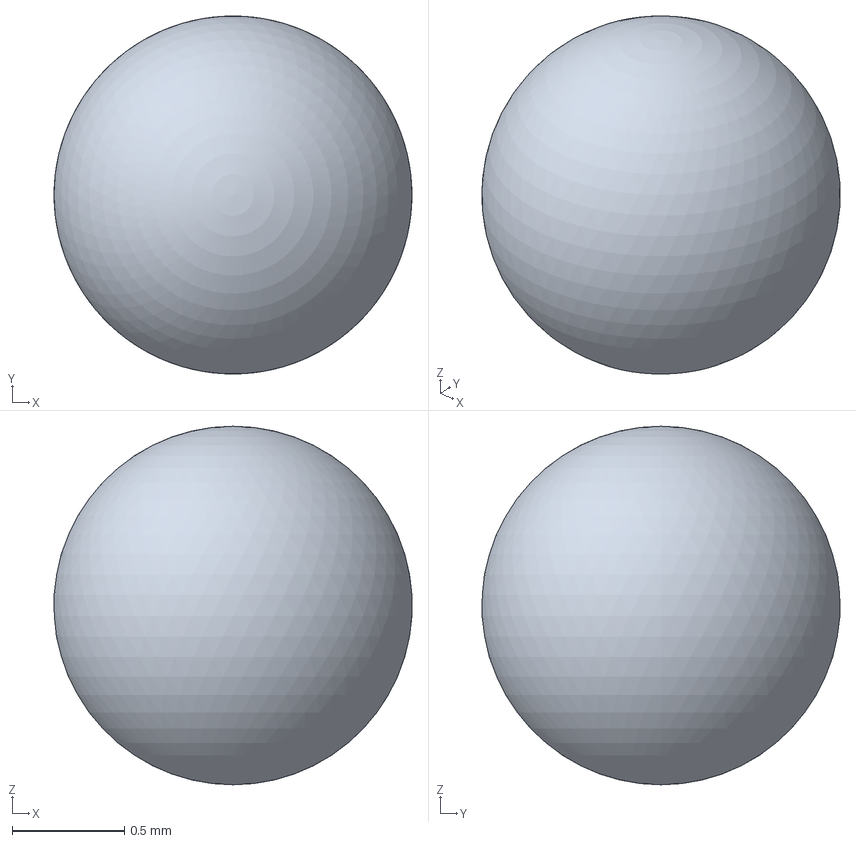
[picture p125: CAD file, 2026-11-13]
design/case/out/parts/TH1_bead.step
1.60 x 1.60 x 1.60 mm
