NexusGPT/openring/design/ecad/case/pcb/models/box_dfn10.step

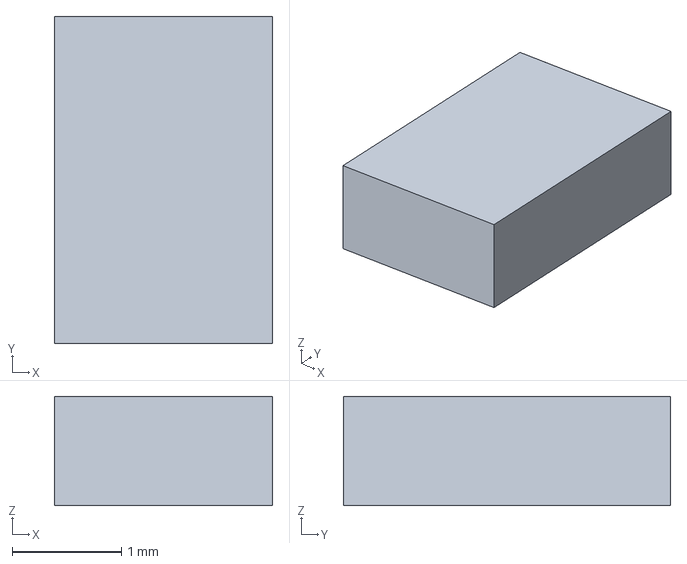
[picture p126: CAD file, 2026-11-13]
design/ecad/case/pcb/models/box_dfn10.step
2.00 x 3.00 x 1.00 mm
