NexusGPT/openring/design/ecad/ring/pcb/fab/ring.step

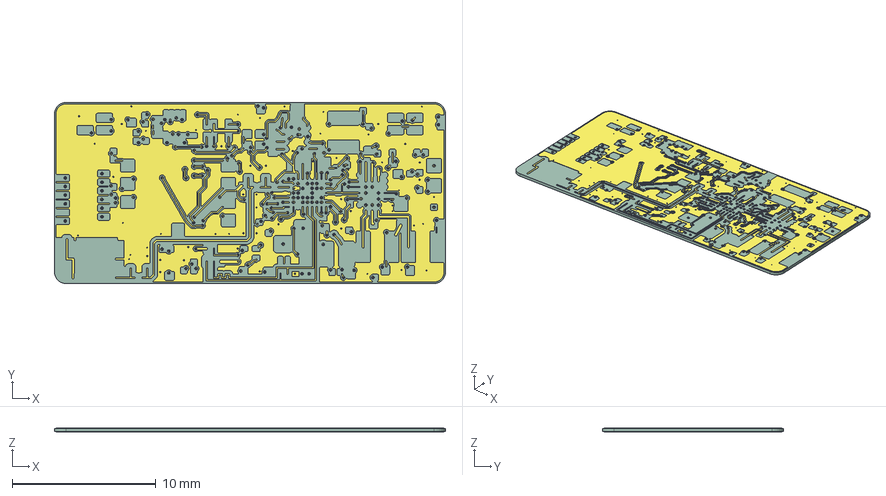
[picture p127: CAD file, 2026-11-14]
design/ecad/ring/pcb/fab/ring.step
27.2 x 12.6 x 0.267 mm
ring_copper
ring_via
ring_PCB
