NexusGPT/openring/design/look/s1/out/ring-merged32h-us9.step

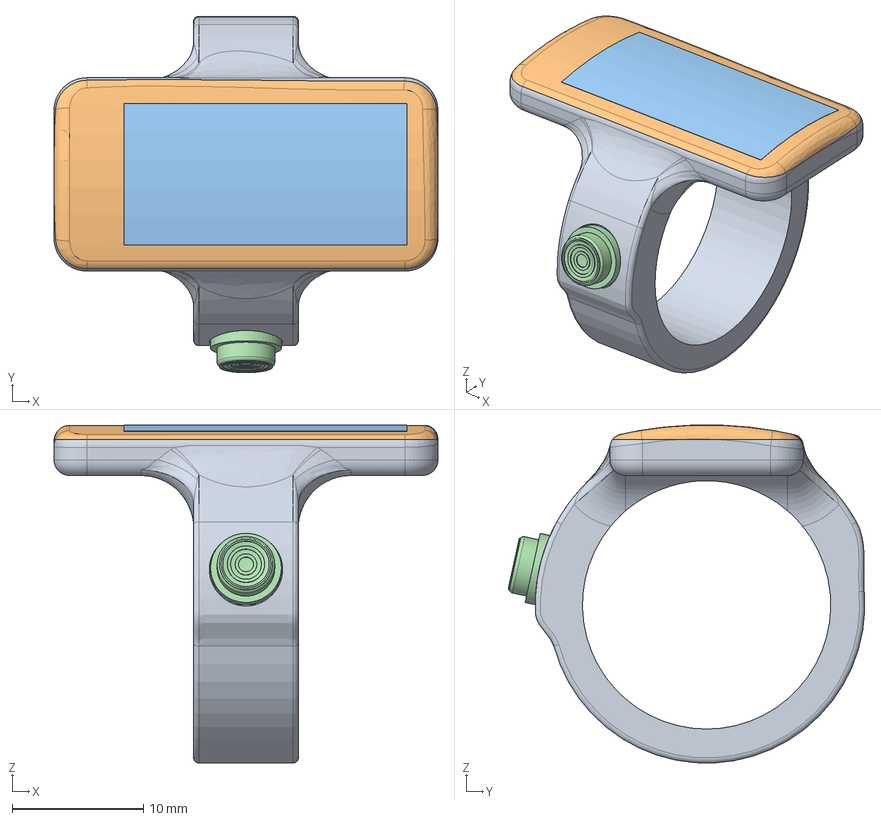
[picture p128: CAD file, 2026-11-13]
design/look/s1/out/ring-merged32h-us9.step
29.3 x 27.2 x 25.8 mm
glass
screen
joystick
mic_1
mic_2
