NexusGPT/openring/design/mech/out/base-size8.step

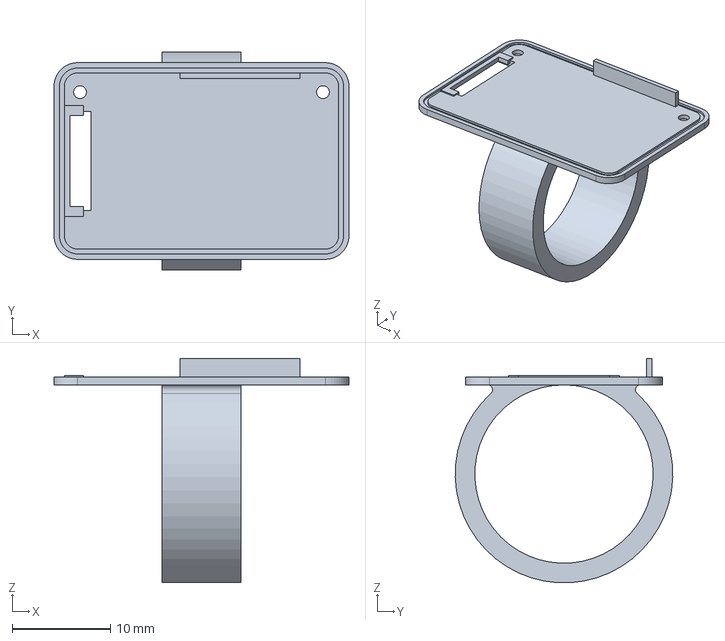
[picture p129: CAD file, 2026-11-13]
design/mech/out/base-size8.step
30.0 x 22.1 x 22.8 mm
