NexusGPT/openring/design/mech/thin/fallback-417/us9/thin-inside.step

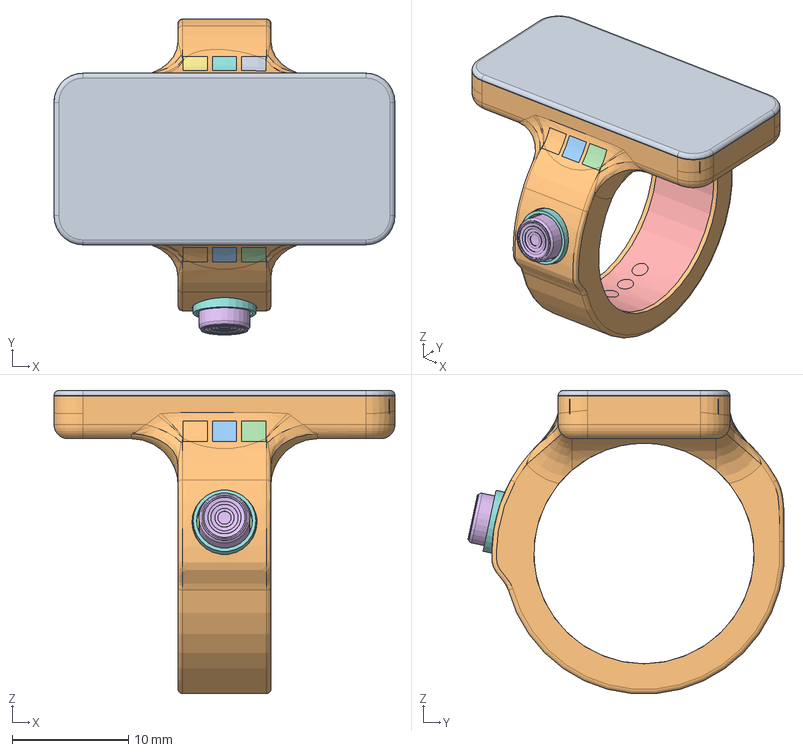
[picture p130: CAD file, 2026-11-13]
design/mech/thin/fallback-417/us9/thin-inside.step
29.3 x 27.1 x 26.0 mm
main_chip__chip
main_chip__mark
power_chip__chip
power_chip__mark
screen_supply_chip__chip
screen_supply_chip__mark
screen_supply_coil__ceramic
power_coil_1__ceramic
power_coil_2__ceramic
crystal_32M__ceramic
crystal_32M__metal
crystal_32k__ceramic
crystal_32k__metal
storage__chip
storage__mark
mic_1__pcb
mic_1__metal
mic_gasket_1__foam
mic_membrane_1__polymer
mic_2__pcb
mic_2__metal
mic_gasket_2__foam
mic_membrane_2__polymer
antenna__ceramic
screen_connector__polymer
screen_connector__metal
motor_regulator__chip
motor_regulator__mark
motor_cap_in__ceramic
motor_cap_out__ceramic
chip_C90__ceramic
chip_R73__ceramic
top_C5__ceramic
top_C1__ceramic
top_C2__ceramic
top_FB1__ceramic
top_C7__ceramic
top_C14__ceramic
top_R71__ceramic
top_R72__ceramic
main_board__pcb
main_board__resin
screen__screen
screen__mark
clear_adhesive__polymer
cover_glass__glass
outer_body__metal
glass_seal__polymer
motor_window_seal__polymer
band_liner__resin
joystick_frame__metal
joy_sw_fingertip__polymer
joy_sw_fingertip__metal
joy_sw_hand__polymer
joy_sw_hand__metal
joy_sw_up__polymer
joy_sw_up__metal
joy_sw_down__polymer
joy_sw_down__metal
joy_sw_centre__polymer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
