NexusGPT/openring/design/mech/thin/out/v9/drawparts/flex-tail-away-footstiffener/flex-tail-away-footstiffener-us12.step

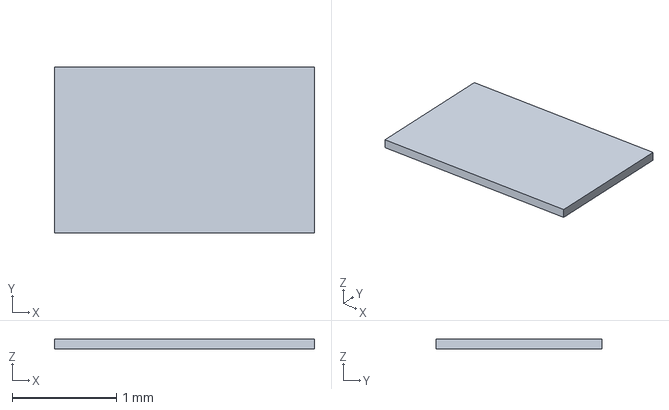
[picture p131: CAD file, 2026-11-13]
design/mech/thin/out/v9/drawparts/flex-tail-away-footstiffener/flex-tail-away-footstiffener-us12.step
2.50 x 1.60 x 0.1 mm
