NexusGPT/openring/design/mfg/parts/band-liner/band-liner-us13.step

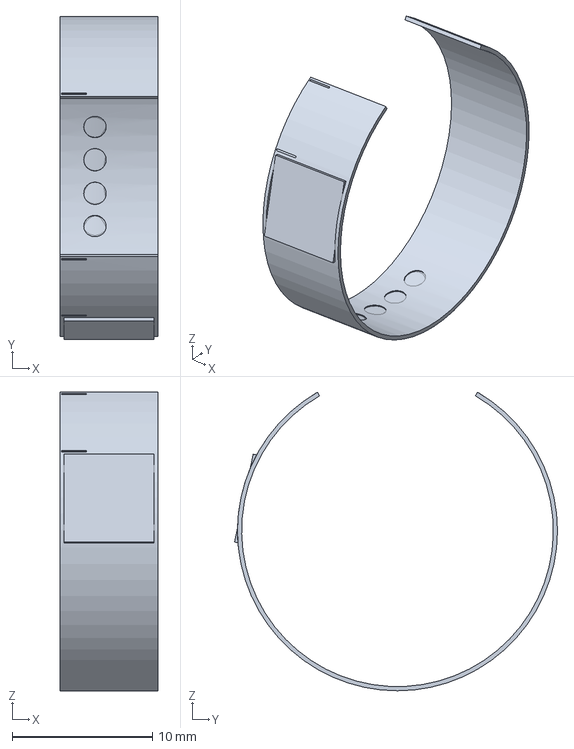
[picture p132: CAD file, 2026-11-13]
design/mfg/parts/band-liner/band-liner-us13.step
7.00 x 23.0 x 21.3 mm
