NexusGPT/openring/design/mfg/parts/body/body-us8.step

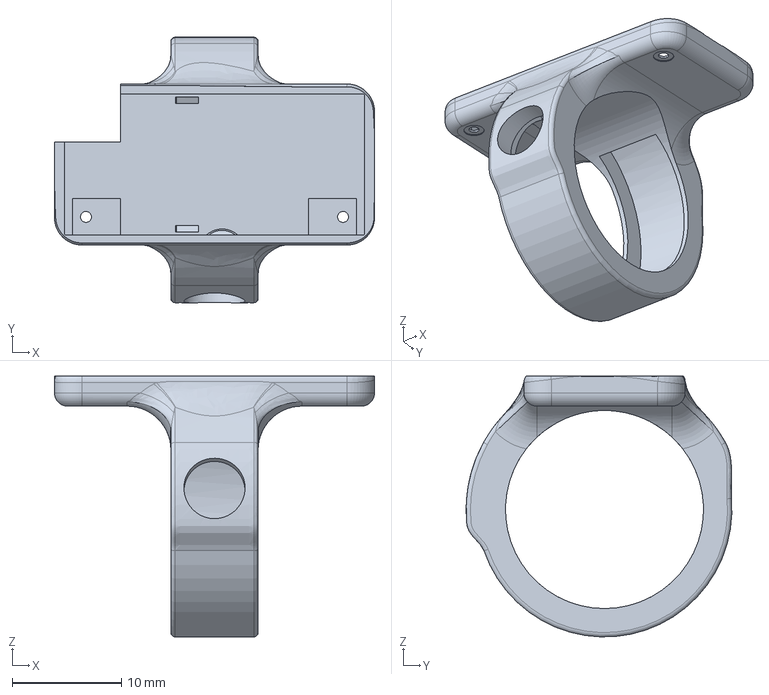
[picture p133: CAD file, 2026-11-13]
design/mfg/parts/body/body-us8.step
29.3 x 24.3 x 23.9 mm
