NexusGPT/openring/design/mfg/parts/cell/cell-us12.step

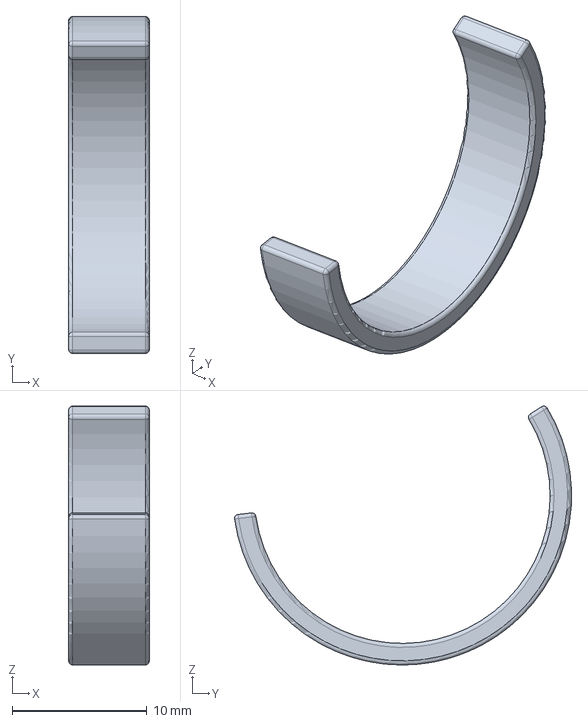
[picture p134: CAD file, 2026-11-13]
design/mfg/parts/cell/cell-us12.step
6.00 x 25.1 x 19.2 mm
