NexusGPT/openring/design/mfg/parts/cover-glass/cover-glass.step

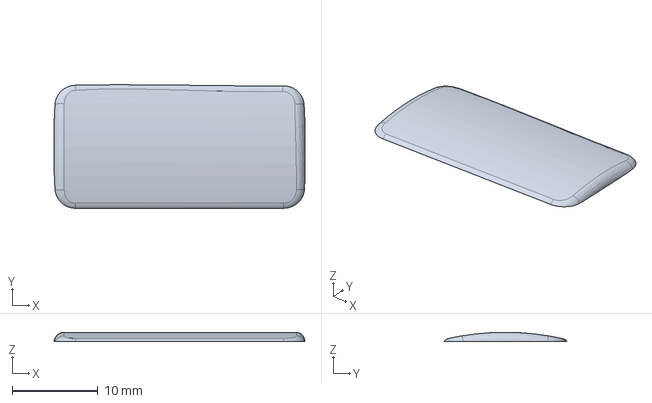
[picture p135: CAD file, 2026-11-13]
design/mfg/parts/cover-glass/cover-glass.step
29.3 x 14.4 x 1.10 mm
