NexusGPT/openring/design/mfg/parts/flex-tail-away/flex-tail-away-us10.step

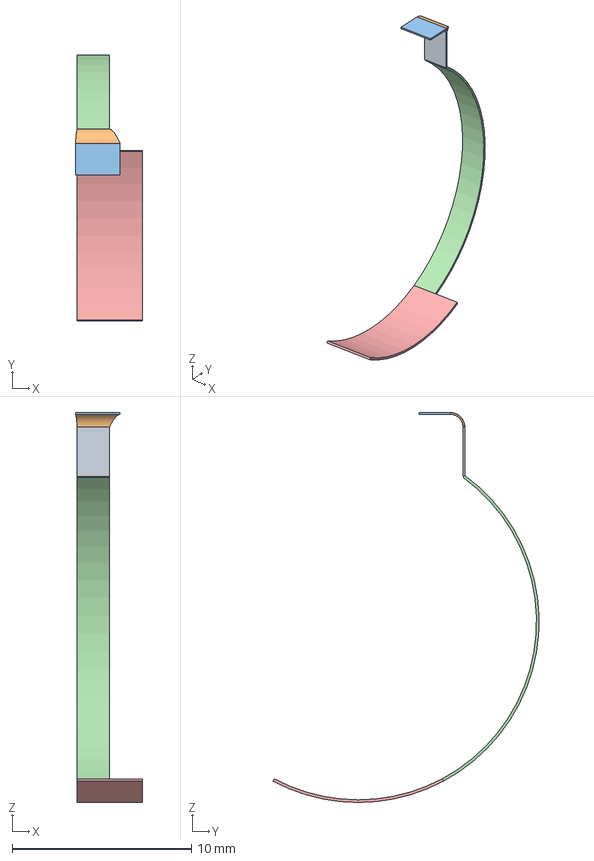
[picture p136: CAD file, 2026-11-13]
design/mfg/parts/flex-tail-away/flex-tail-away-us10.step
3.75 x 14.9 x 21.8 mm
