NexusGPT/openring/design/mfg/parts/flex-tail-thumb/flex-tail-thumb-us11.step

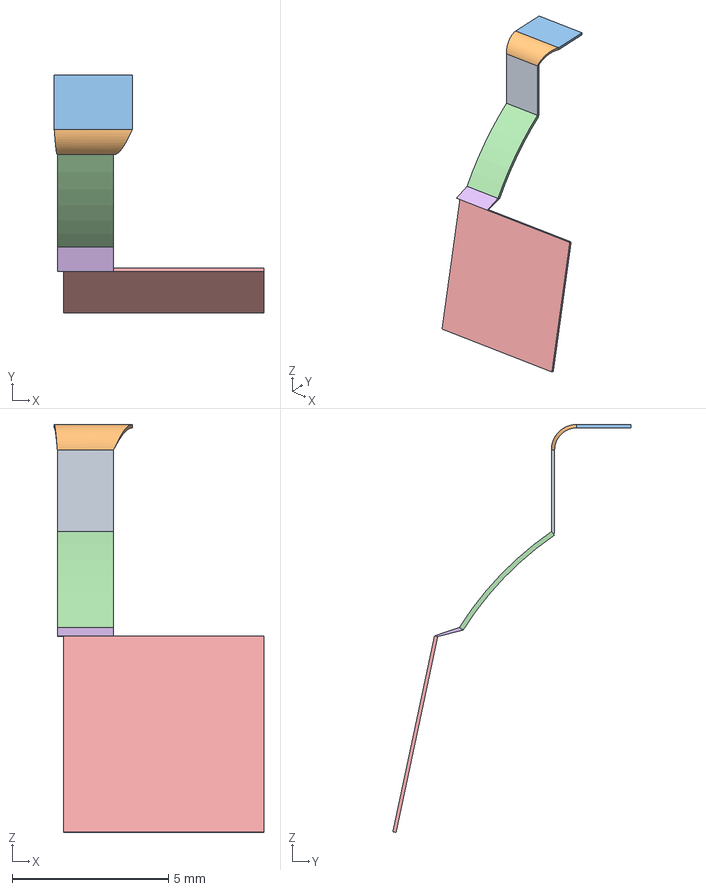
[picture p137: CAD file, 2026-11-13]
design/mfg/parts/flex-tail-thumb/flex-tail-thumb-us11.step
6.70 x 7.62 x 13.0 mm
