NexusGPT/openring/design/mfg/parts/glass-seal/glass-seal-us11.step

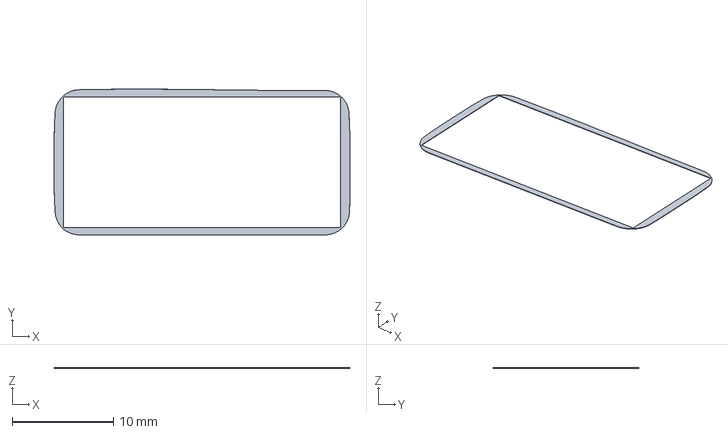
[picture p138: CAD file, 2026-11-13]
design/mfg/parts/glass-seal/glass-seal-us11.step
29.3 x 14.4 x 0.05 mm
