NexusGPT/openring/design/mfg/parts/joystick-cap/joystick-cap.step

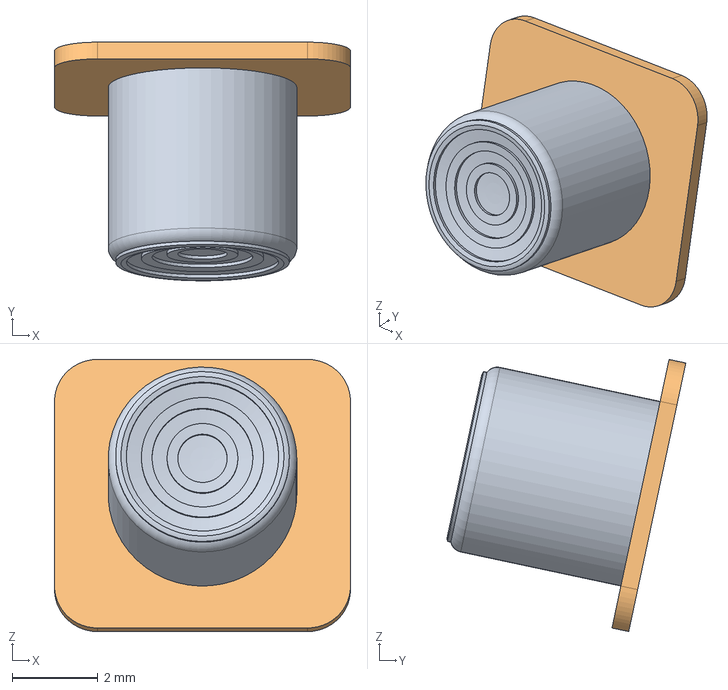
[picture p139: CAD file, 2026-11-13]
design/mfg/parts/joystick-cap/joystick-cap.step
6.90 x 5.56 x 6.34 mm
