NexusGPT/openring/design/mfg/parts/joystick-dam/joystick-dam-us11.step

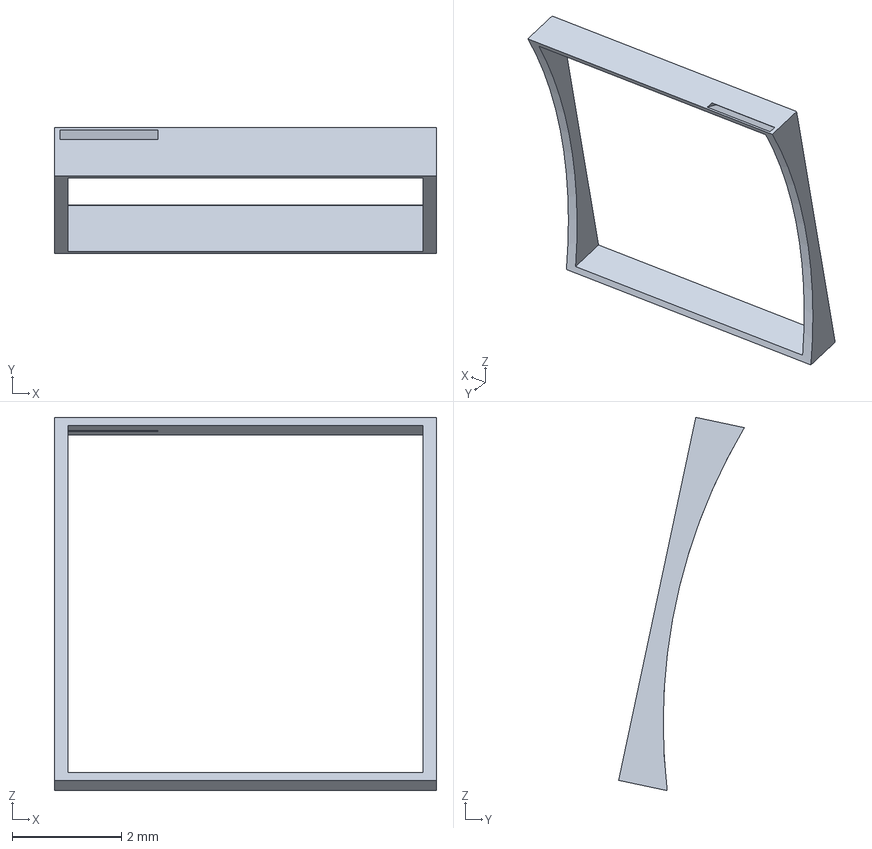
[picture p140: CAD file, 2026-11-13]
design/mfg/parts/joystick-dam/joystick-dam-us11.step
7.00 x 2.30 x 6.84 mm
