NexusGPT/openring/design/mfg/parts/joystick-frame/joystick-frame.step

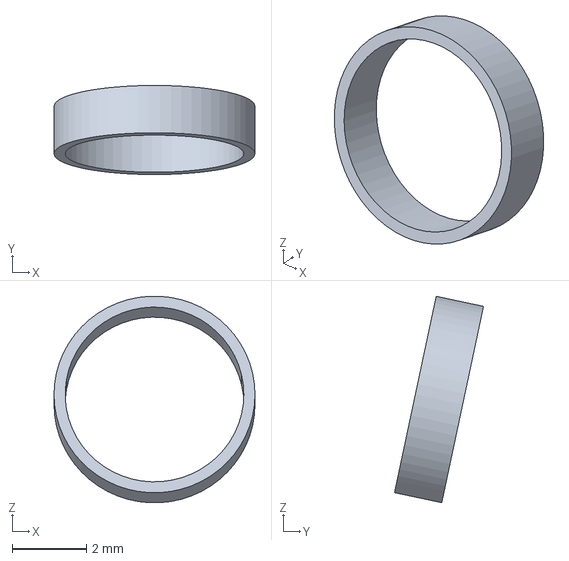
[picture p141: CAD file, 2026-11-13]
design/mfg/parts/joystick-frame/joystick-frame.step
5.40 x 2.39 x 5.54 mm
