NexusGPT/openring/design/mfg/parts/joystick-stiffener/joystick-stiffener-us12.step

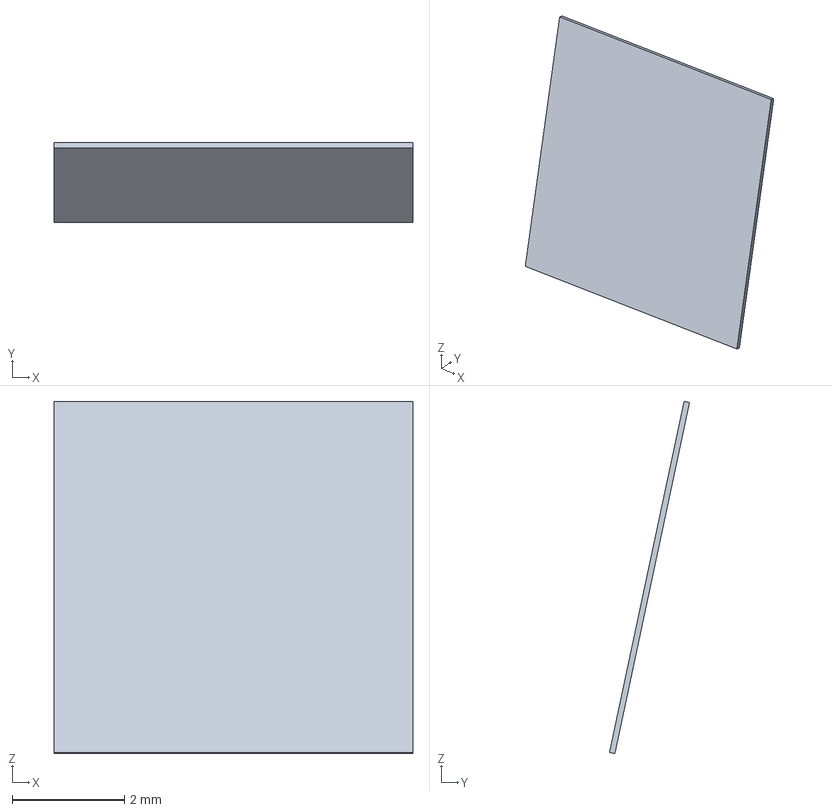
[picture p142: CAD file, 2026-11-13]
design/mfg/parts/joystick-stiffener/joystick-stiffener-us12.step
6.40 x 1.43 x 6.28 mm
