NexusGPT/openring/design/mfg/parts/mic-gasket/mic-gasket.step

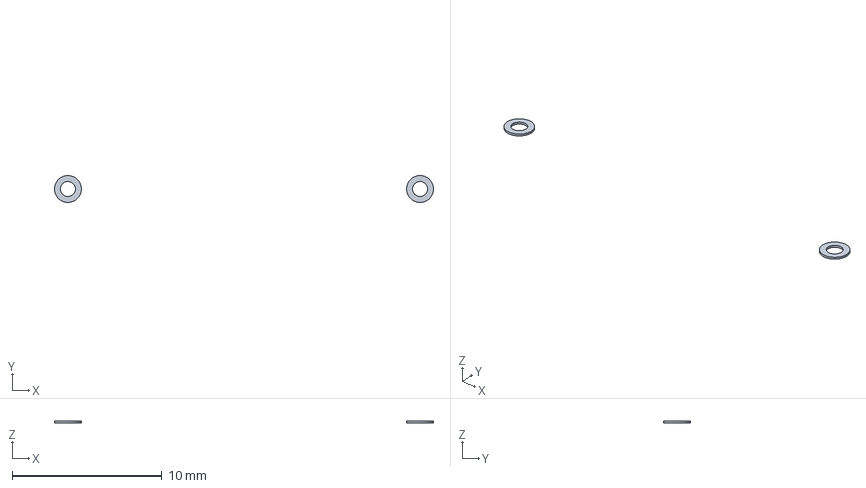
[picture p143: CAD file, 2026-11-13]
design/mfg/parts/mic-gasket/mic-gasket.step
25.3 x 1.80 x 0.13 mm
