NexusGPT/openring/design/mfg/parts/mic-membrane/mic-membrane.step

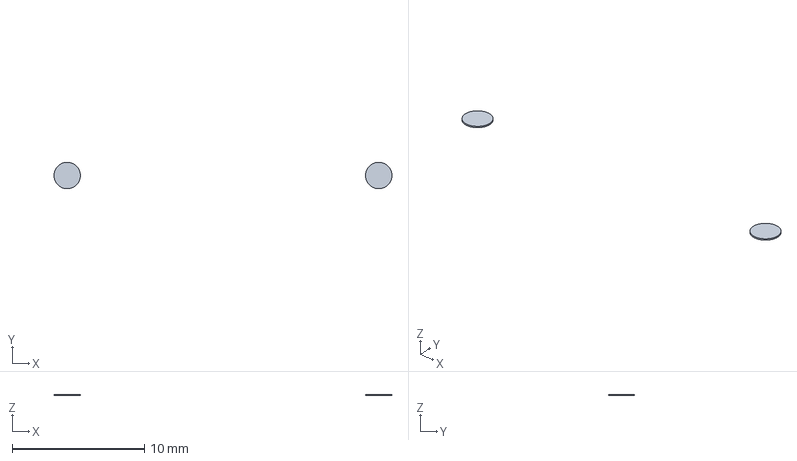
[picture p144: CAD file, 2026-11-13]
design/mfg/parts/mic-membrane/mic-membrane.step
25.5 x 2.00 x 0.1 mm
