NexusGPT/openring/design/mfg/parts/motor-window-seal/motor-window-seal-us7.step

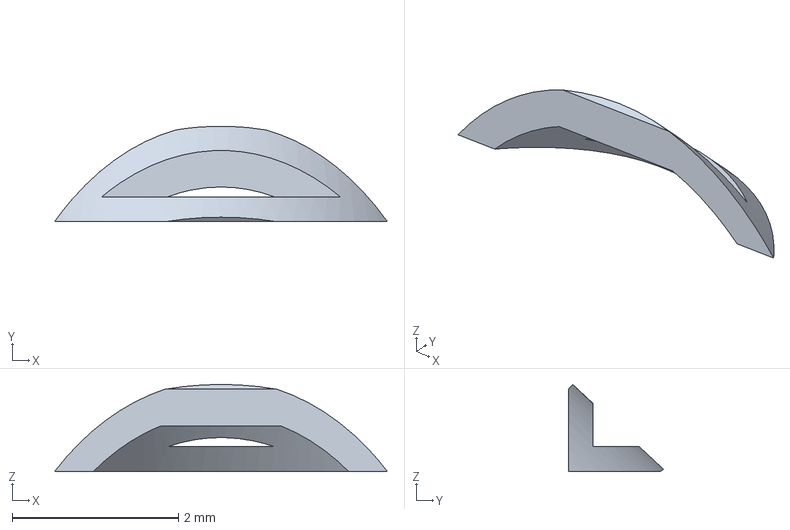
[picture p145: CAD file, 2026-11-13]
design/mfg/parts/motor-window-seal/motor-window-seal-us7.step
4.01 x 1.15 x 1.05 mm
