NexusGPT/openring/design/mfg/parts/radio-corner/radio-corner.step

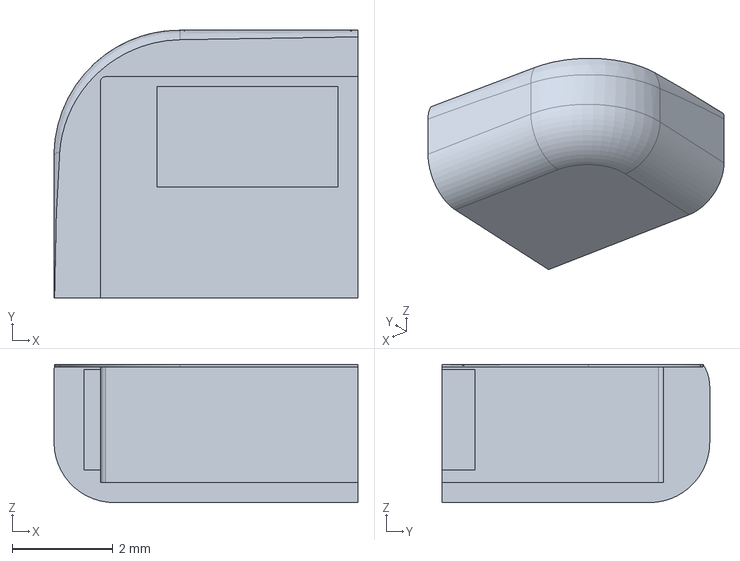
[picture p146: CAD file, 2026-11-13]
design/mfg/parts/radio-corner/radio-corner.step
6.05 x 5.33 x 2.75 mm
