NexusGPT/openring/design/mfg/tools/testdata/parts/body/body.step

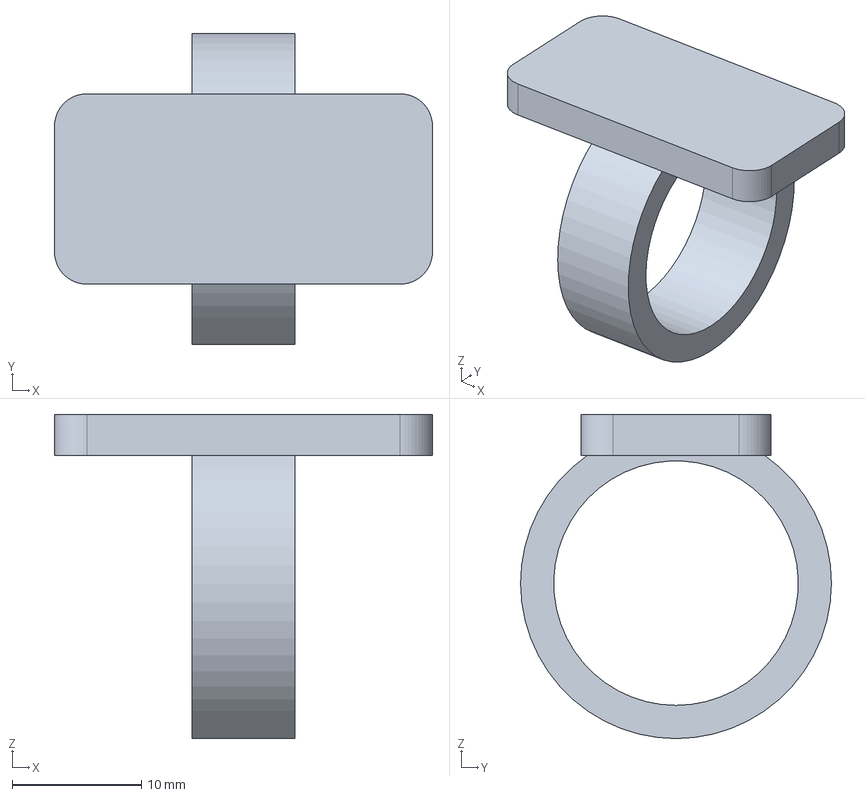
[picture p147: CAD file, 2026-11-13]
design/mfg/tools/testdata/parts/body/body.step
29.3 x 24.1 x 25.1 mm
