NexusGPT/openring/design/mfg/tools/testdata/parts_real/body/body.step

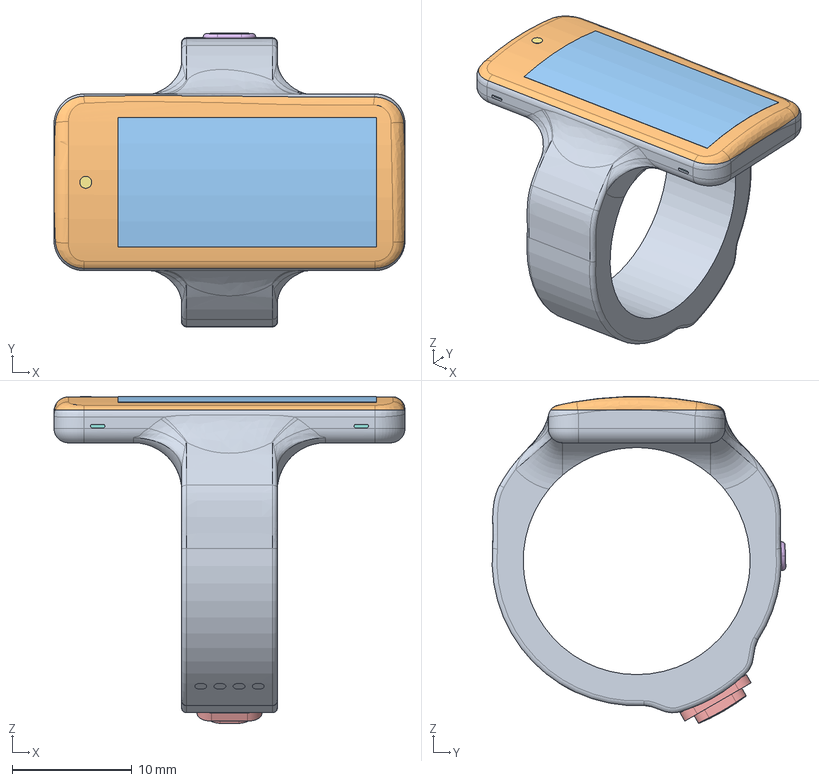
[picture p148: CAD file, 2026-11-13]
design/mfg/tools/testdata/parts_real/body/body.step
29.3 x 24.5 x 27.3 mm
glass
screen
band
joystick
button
light
mic_1
mic_2
contacts
