NexusGPT/openring/design/case/out/case_shell.stl

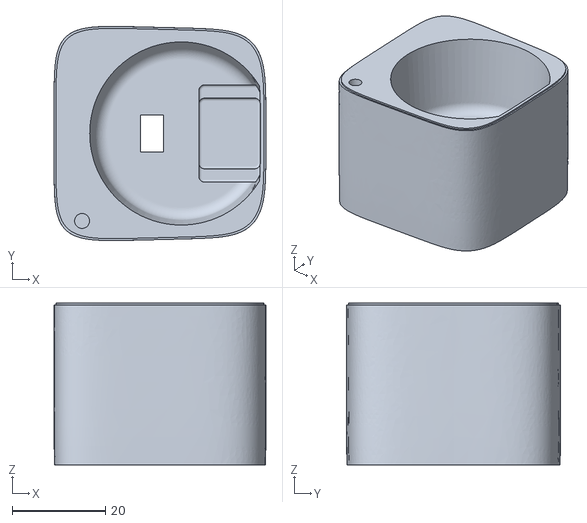
[picture p149: CAD file, 2026-11-13]
design/case/out/case_shell.stl
45.4 x 45.9 x 34.7
