NexusGPT/openring/design/case/out/parts/post.step

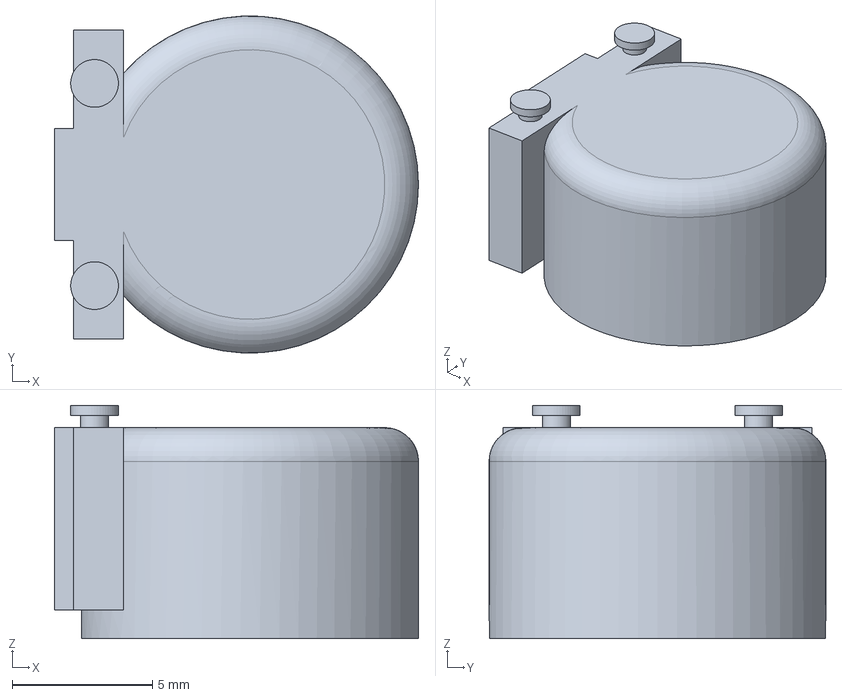
[picture p150: CAD file, 2026-11-13]
design/case/out/parts/post.step
13.0 x 12.0 x 8.30 mm
