NexusGPT/openring/design/ecad/case/pcb/models/box_lga16.step

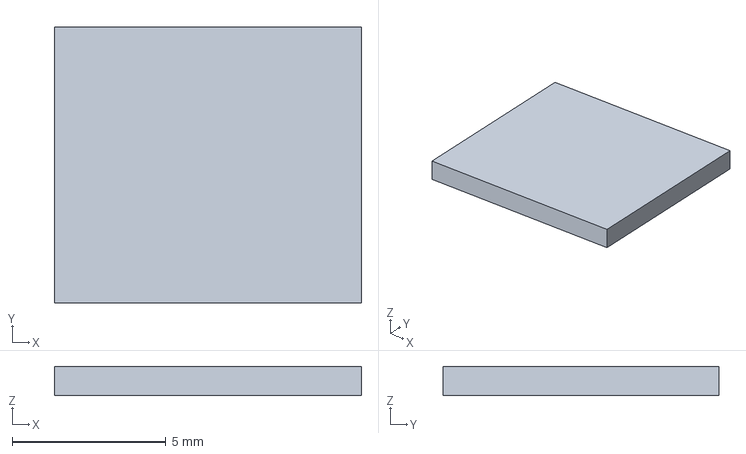
[picture p151: CAD file, 2026-11-13]
design/ecad/case/pcb/models/box_lga16.step
10.0 x 9.00 x 0.95 mm
