NexusGPT/openring/design/look/s1/out/ring-merged32h-us7.step

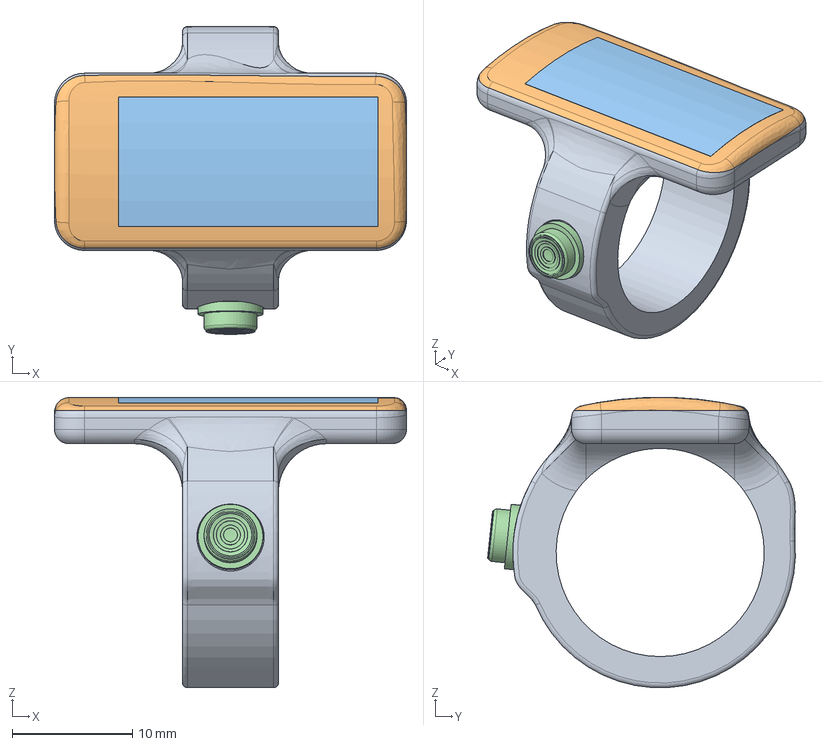
[picture p152: CAD file, 2026-11-13]
design/look/s1/out/ring-merged32h-us7.step
29.3 x 25.6 x 24.2 mm
glass
screen
joystick
mic_1
mic_2
