NexusGPT/openring/design/mfg/parts/band-liner/band-liner-us9.step

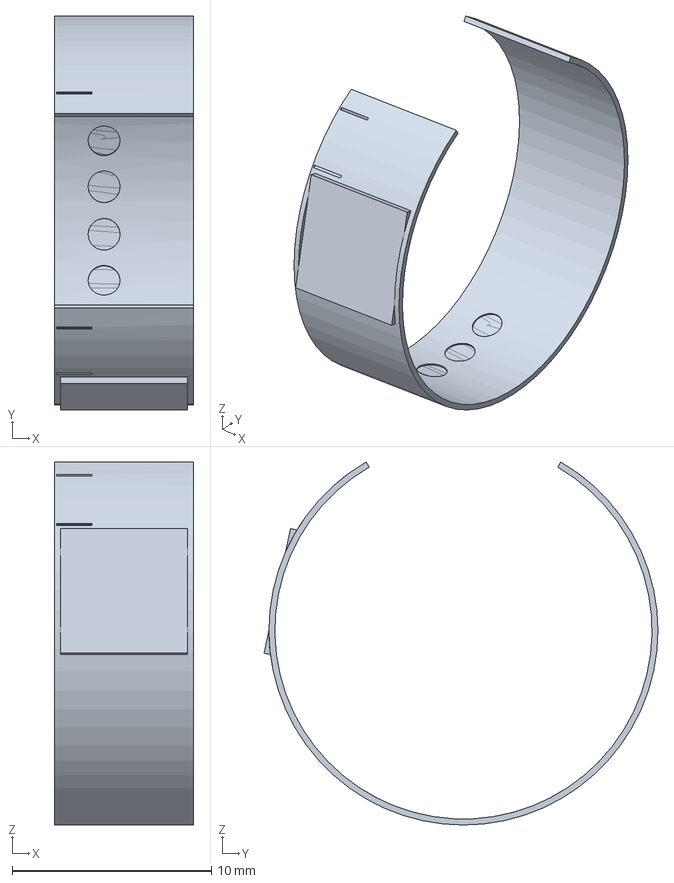
[picture p153: CAD file, 2026-11-13]
design/mfg/parts/band-liner/band-liner-us9.step
7.00 x 19.8 x 18.2 mm
