NexusGPT/openring/design/mfg/parts/body/body-us9.step

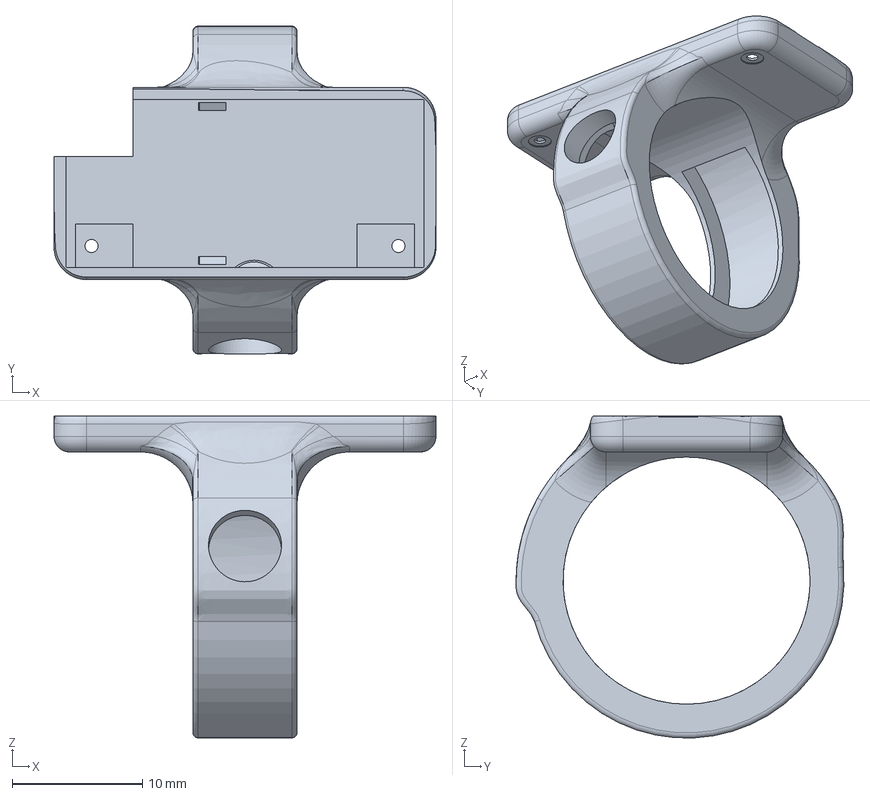
[picture p154: CAD file, 2026-11-13]
design/mfg/parts/body/body-us9.step
29.3 x 25.1 x 24.7 mm
