NexusGPT/openring/design/mfg/parts/cell/cell-us9.step

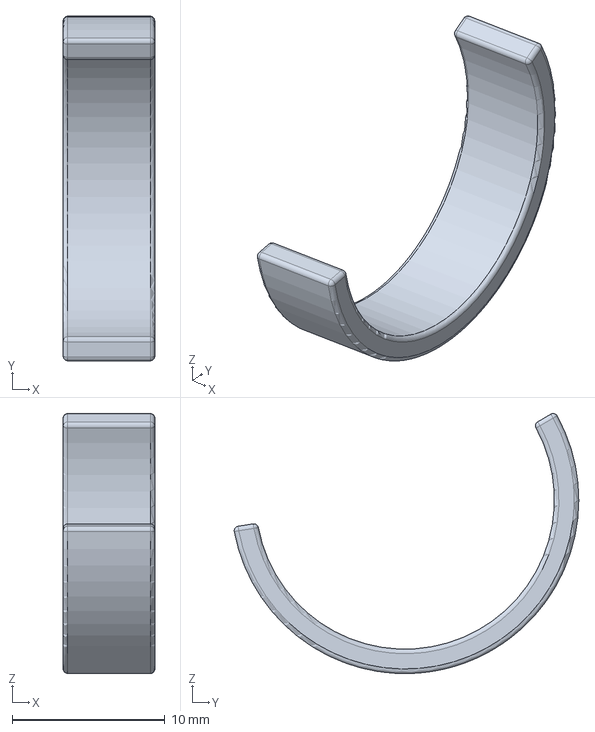
[picture p155: CAD file, 2026-11-13]
design/mfg/parts/cell/cell-us9.step
6.00 x 22.6 x 17.0 mm
