NexusGPT/openring/design/mfg/parts/flex-tail-away/flex-tail-away-us9.step

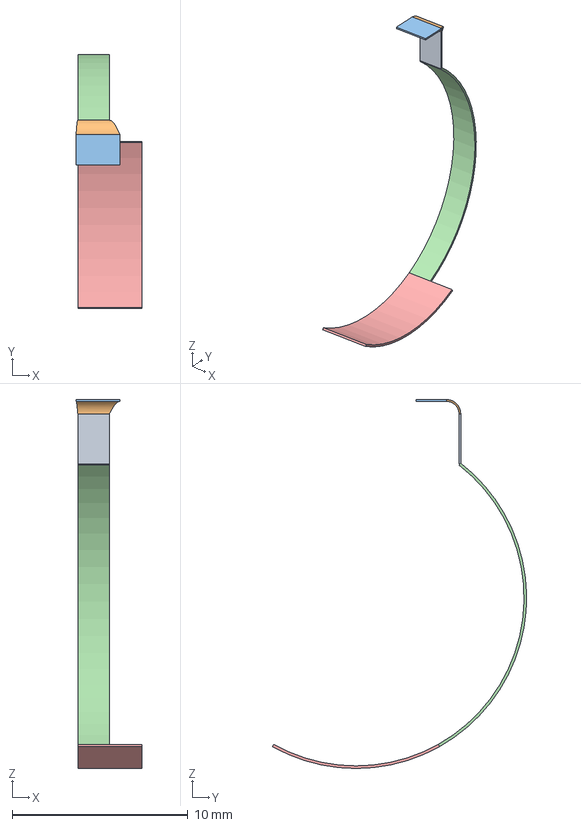
[picture p156: CAD file, 2026-11-13]
design/mfg/parts/flex-tail-away/flex-tail-away-us9.step
3.75 x 14.4 x 21.0 mm
