NexusGPT/openring/design/mfg/parts/flex-tail-thumb/flex-tail-thumb-us8.step

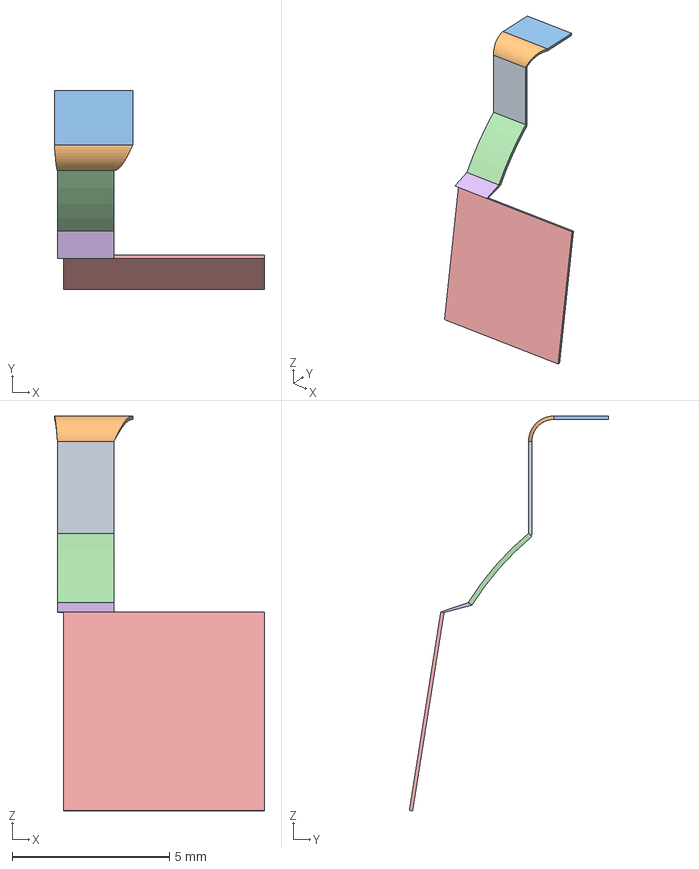
[picture p157: CAD file, 2026-11-13]
design/mfg/parts/flex-tail-thumb/flex-tail-thumb-us8.step
6.70 x 6.35 x 12.6 mm
