NexusGPT/openring/design/mfg/parts/joystick-dam/joystick-dam-us7.step

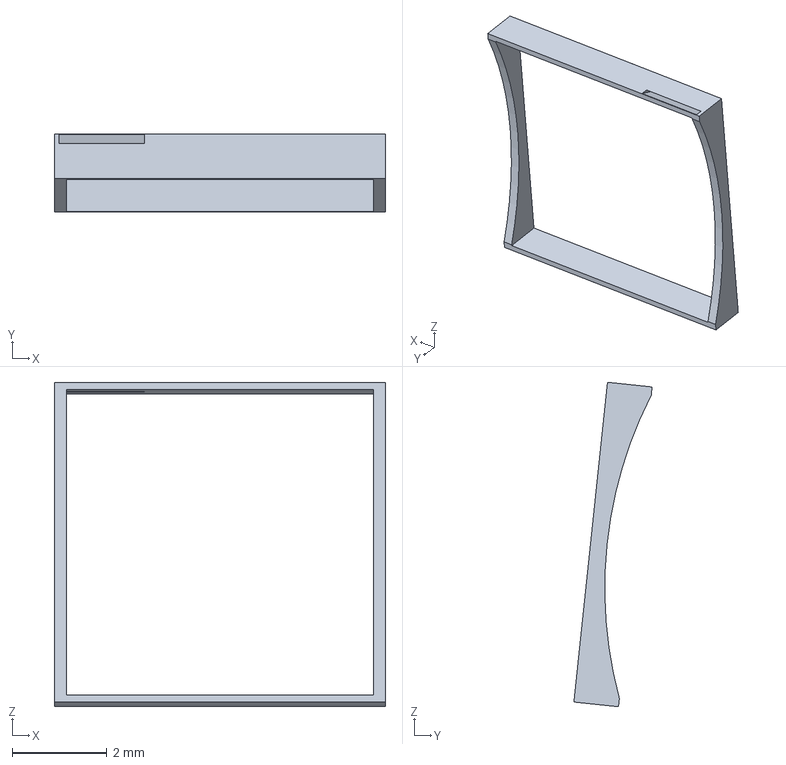
[picture p158: CAD file, 2026-11-13]
design/mfg/parts/joystick-dam/joystick-dam-us7.step
7.00 x 1.66 x 6.86 mm
