NexusGPT/openring/design/mfg/parts/joystick-stiffener/joystick-stiffener-us7.step

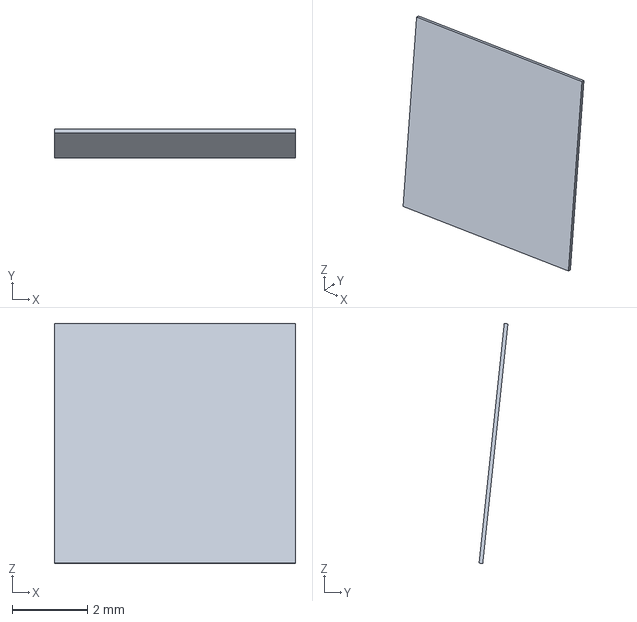
[picture p159: CAD file, 2026-11-13]
design/mfg/parts/joystick-stiffener/joystick-stiffener-us7.step
6.40 x 0.768 x 6.38 mm
