NexusGPT/openring/design/mfg/parts/motor-window-seal/motor-window-seal-us9.step

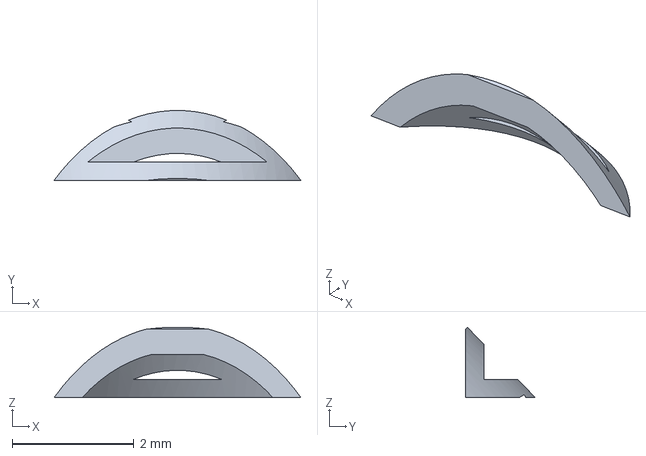
[picture p160: CAD file, 2026-11-13]
design/mfg/parts/motor-window-seal/motor-window-seal-us9.step
4.06 x 1.15 x 1.16 mm
