NexusGPT/openring/design/case/out/parts/base_plate.step

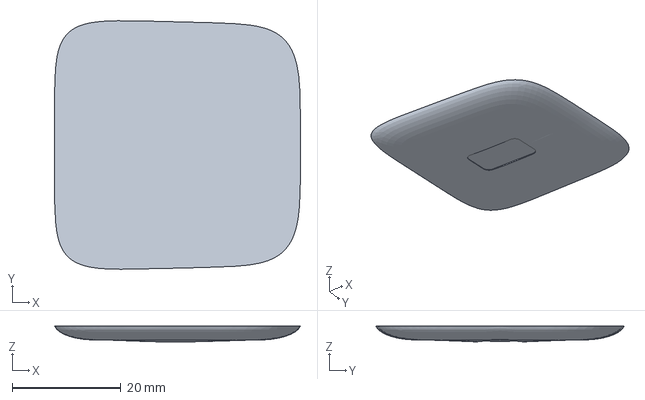
[picture p161: CAD file, 2026-11-13]
design/case/out/parts/base_plate.step
45.2 x 45.7 x 2.93 mm
