NexusGPT/openring/design/ecad/case/pcb/models/box_xfl4020.step

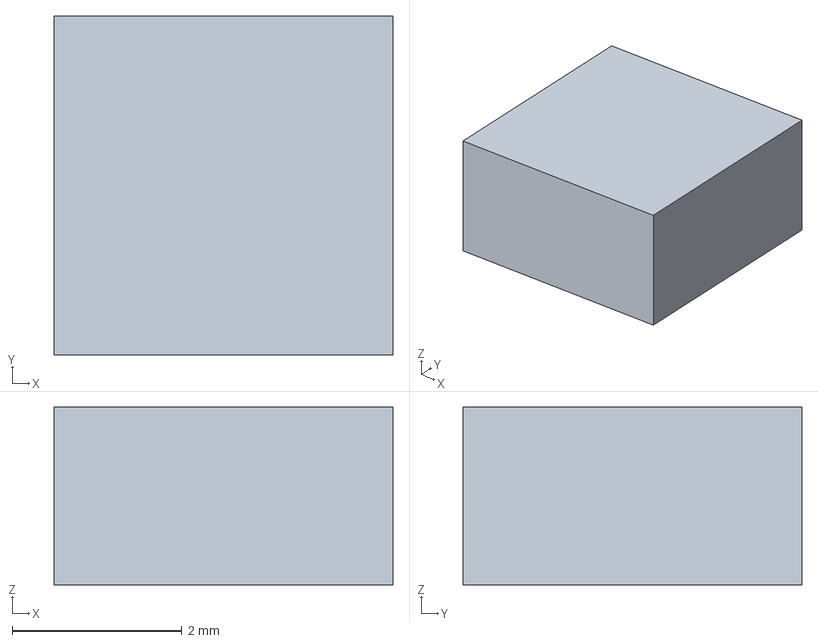
[picture p162: CAD file, 2026-11-13]
design/ecad/case/pcb/models/box_xfl4020.step
4.00 x 4.00 x 2.10 mm
