NexusGPT/openring/design/look/s1/out/ring-merged32h-us12.step

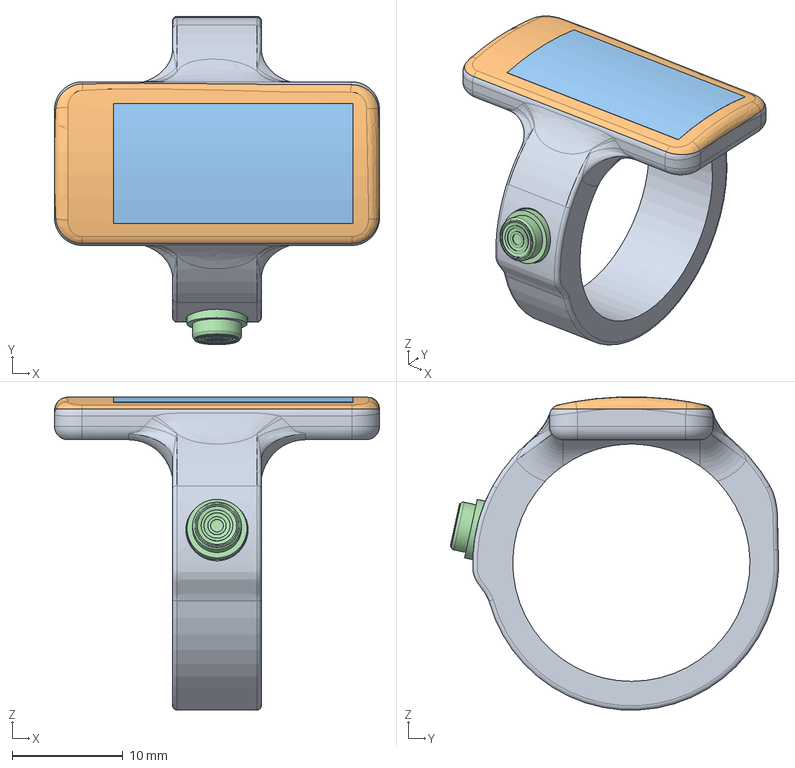
[picture p163: CAD file, 2026-11-13]
design/look/s1/out/ring-merged32h-us12.step
29.3 x 29.6 x 28.2 mm
glass
screen
joystick
mic_1
mic_2
