NexusGPT/openring/design/mech/out/base-size10.step

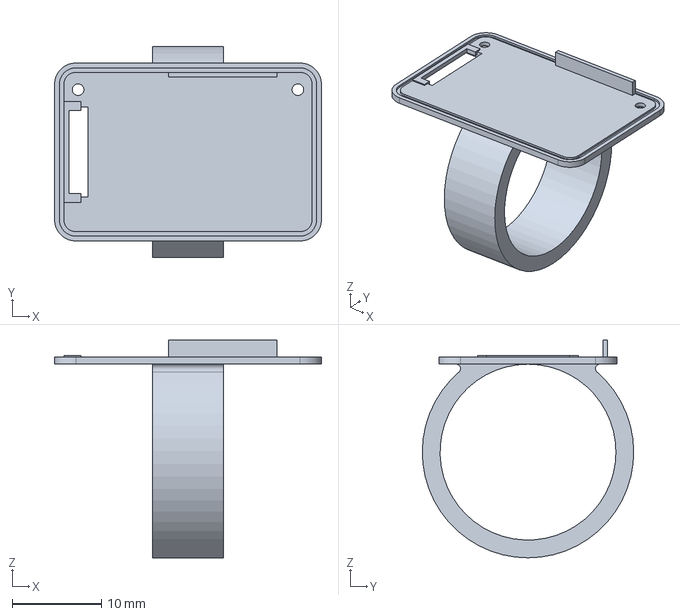
[picture p164: CAD file, 2026-11-13]
design/mech/out/base-size10.step
30.0 x 23.8 x 24.5 mm
