NexusGPT/openring/design/mfg/parts/band-liner/band-liner-us12.step

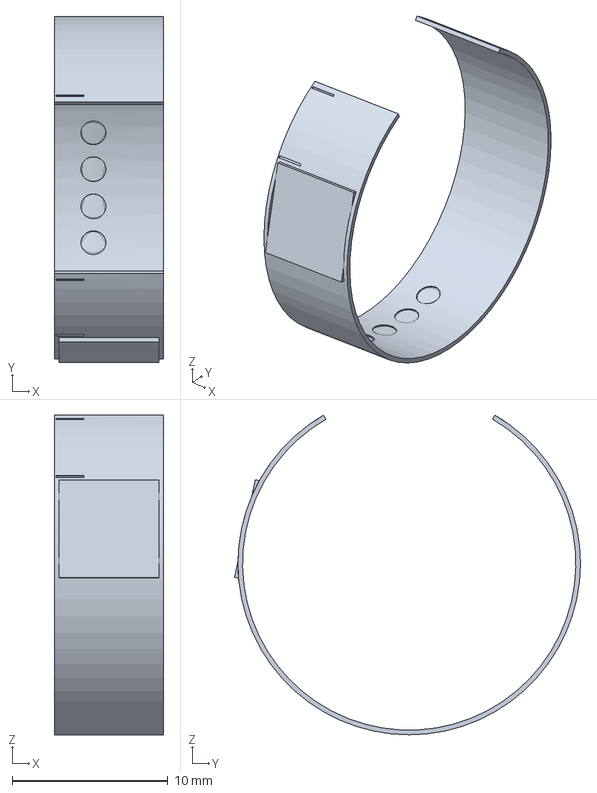
[picture p165: CAD file, 2026-11-13]
design/mfg/parts/band-liner/band-liner-us12.step
7.00 x 22.2 x 20.5 mm
