NexusGPT/openring/design/mfg/parts/body/body-us7.step

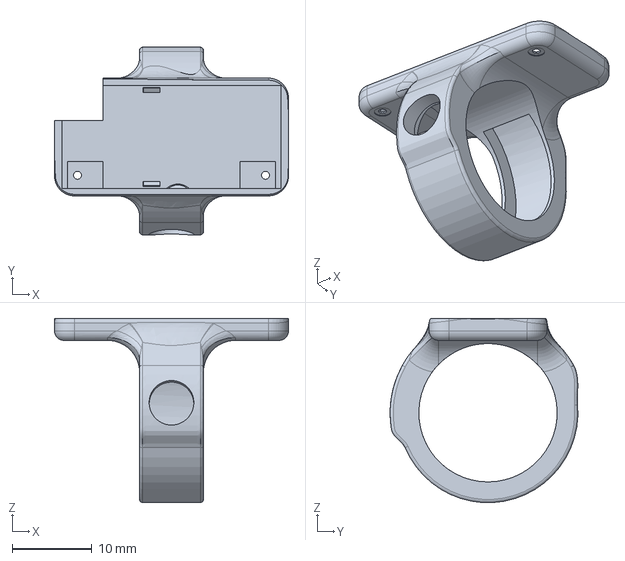
[picture p166: CAD file, 2026-11-13]
design/mfg/parts/body/body-us7.step
29.3 x 23.5 x 23.1 mm
