NexusGPT/openring/design/mfg/parts/cell/cell-us10.step

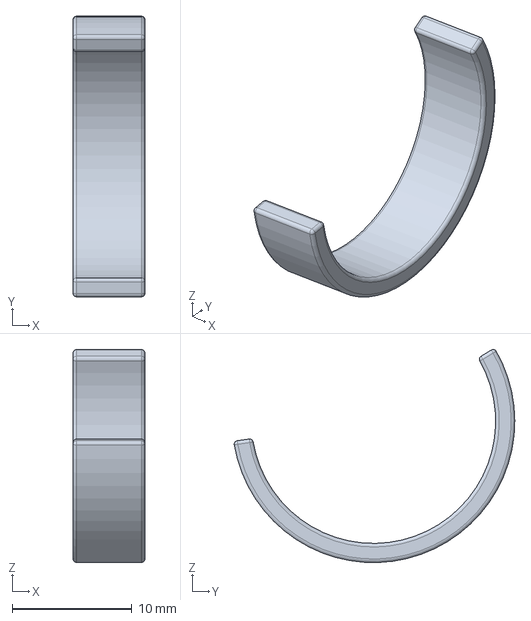
[picture p167: CAD file, 2026-11-13]
design/mfg/parts/cell/cell-us10.step
6.00 x 23.4 x 17.8 mm
