NexusGPT/openring/design/mfg/parts/flex-tail-away/flex-tail-away-us12.step

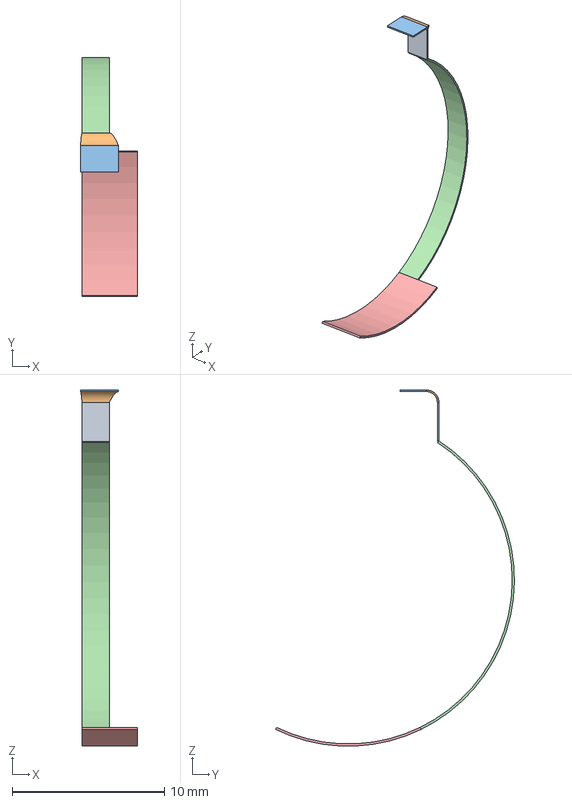
[picture p168: CAD file, 2026-11-13]
design/mfg/parts/flex-tail-away/flex-tail-away-us12.step
3.75 x 15.7 x 23.4 mm
