NexusGPT/openring/design/mfg/parts/flex-tail-thumb/flex-tail-thumb-us13.step

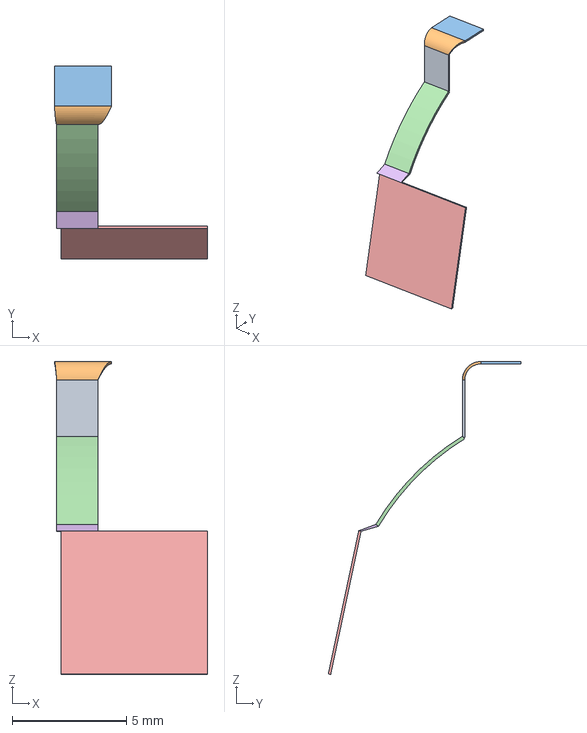
[picture p169: CAD file, 2026-11-13]
design/mfg/parts/flex-tail-thumb/flex-tail-thumb-us13.step
6.70 x 8.41 x 13.7 mm
