NexusGPT/openring/design/mfg/parts/motor-window-seal/motor-window-seal-us8.step

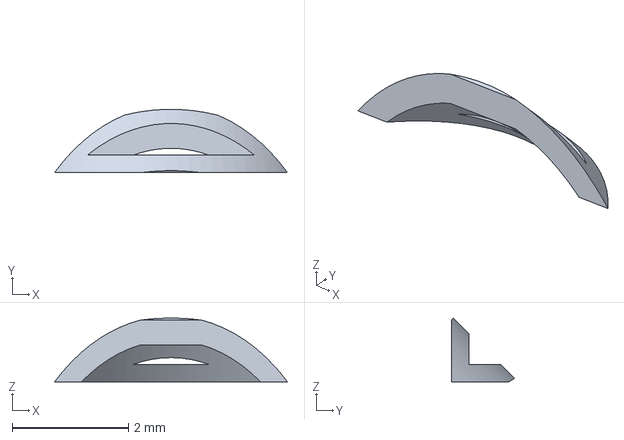
[picture p170: CAD file, 2026-11-13]
design/mfg/parts/motor-window-seal/motor-window-seal-us8.step
4.02 x 1.09 x 1.10 mm
