NexusGPT/openring/design/case/out/case_hinge_pivot.stl

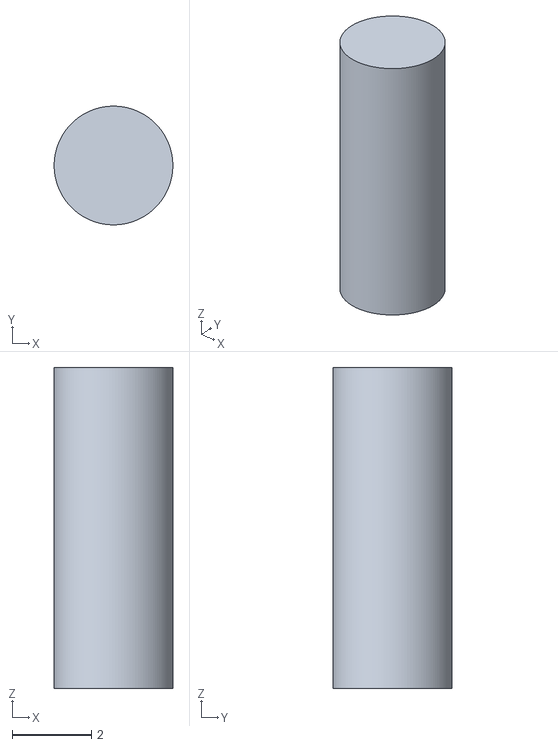
[picture p171: CAD file, 2026-11-13]
design/case/out/case_hinge_pivot.stl
3.00 x 3.00 x 8.11
