NexusGPT/openring/design/case/out/parts/usb_bezel.step

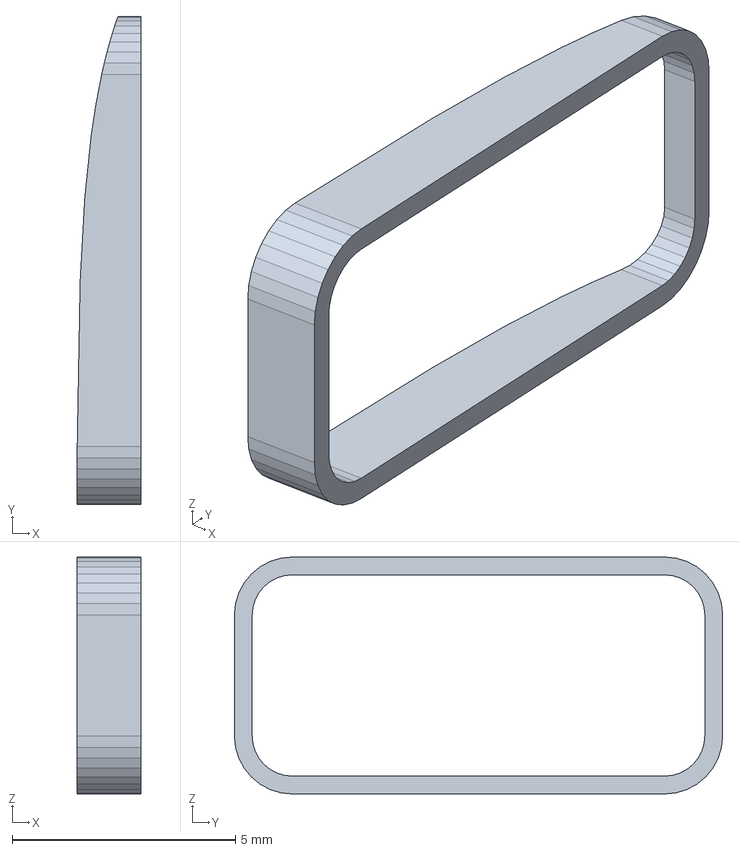
[picture p172: CAD file, 2026-11-13]
design/case/out/parts/usb_bezel.step
1.44 x 10.9 x 5.31 mm
