NexusGPT/openring/design/ecad/case/pcb/models/box_xfl4015.step

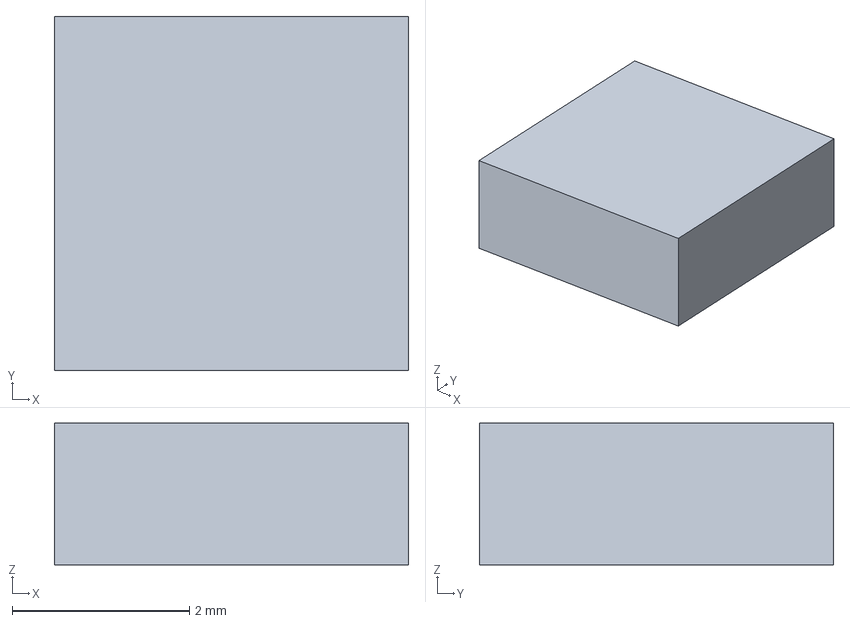
[picture p173: CAD file, 2026-11-13]
design/ecad/case/pcb/models/box_xfl4015.step
4.00 x 4.00 x 1.60 mm
