NexusGPT/openring/design/look/s1/out/ring-merged417flatw-us7.step

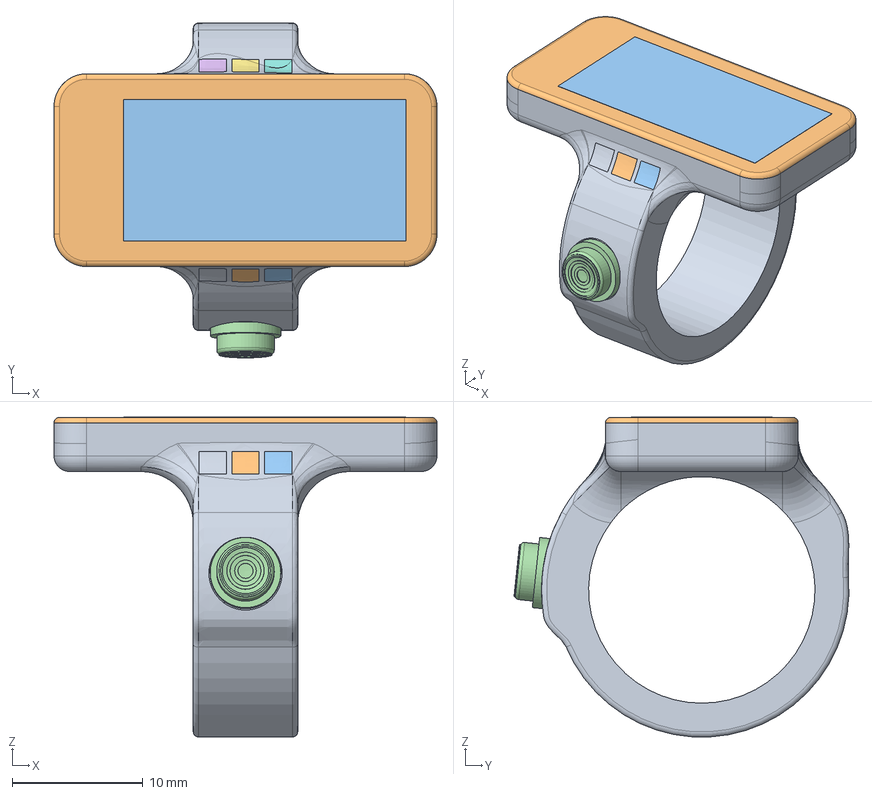
[picture p174: CAD file, 2026-11-13]
design/look/s1/out/ring-merged417flatw-us7.step
29.3 x 25.6 x 24.5 mm
glass
screen
joystick
mic_1
mic_2
slit_fill
