NexusGPT/openring/design/mech/out/base-size13.step

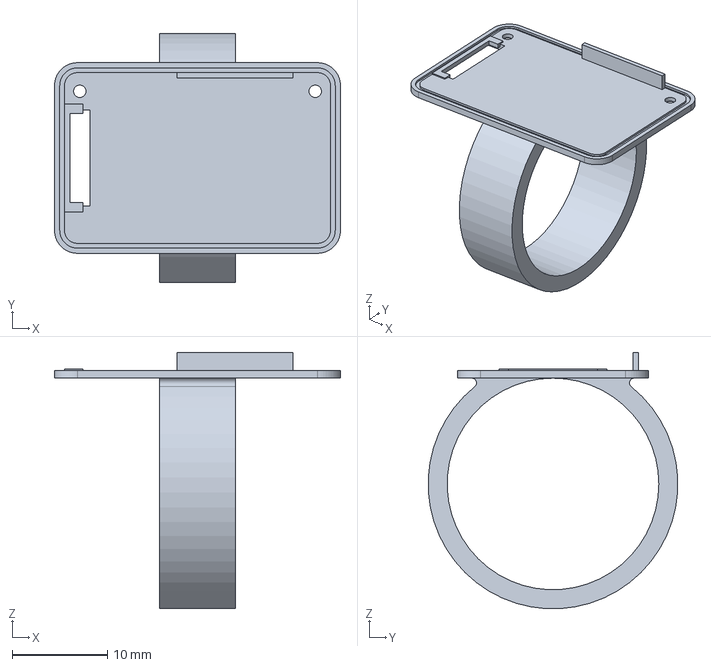
[picture p175: CAD file, 2026-11-13]
design/mech/out/base-size13.step
30.0 x 26.2 x 26.9 mm
