NexusGPT/openring/design/mfg/parts/band-liner/band-liner-us11.step

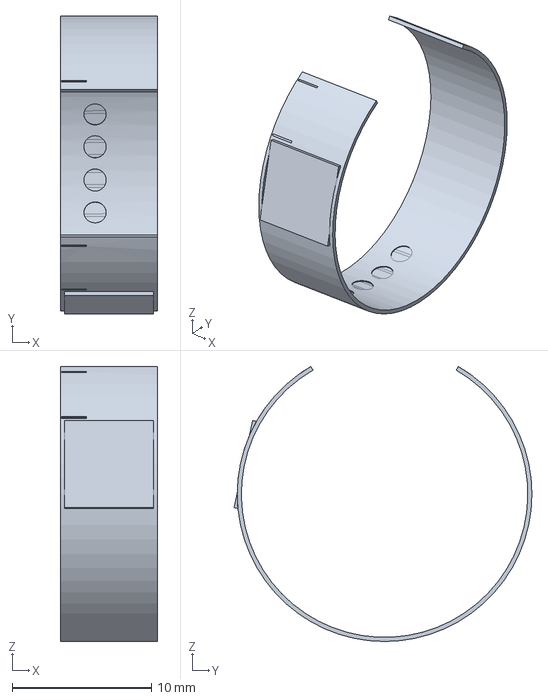
[picture p176: CAD file, 2026-11-13]
design/mfg/parts/band-liner/band-liner-us11.step
7.00 x 21.4 x 19.8 mm
