NexusGPT/openring/design/mfg/parts/body/body-us11.step

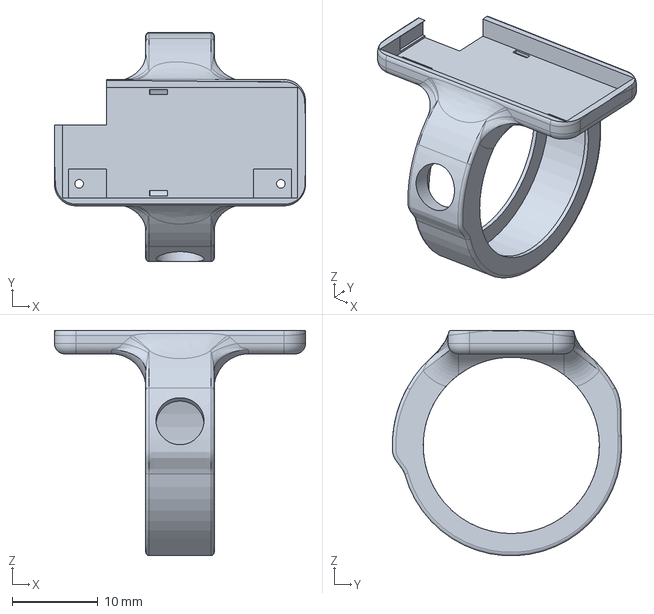
[picture p177: CAD file, 2026-11-13]
design/mfg/parts/body/body-us11.step
29.3 x 26.8 x 26.3 mm
