NexusGPT/openring/design/mfg/parts/cell/cell-us13.step

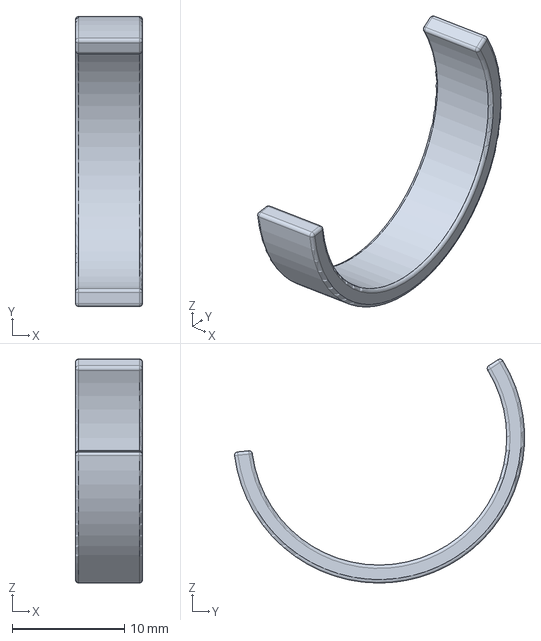
[picture p178: CAD file, 2026-11-13]
design/mfg/parts/cell/cell-us13.step
6.00 x 25.9 x 20.0 mm
