NexusGPT/openring/design/mfg/parts/flex-tail-away/flex-tail-away-us7.step

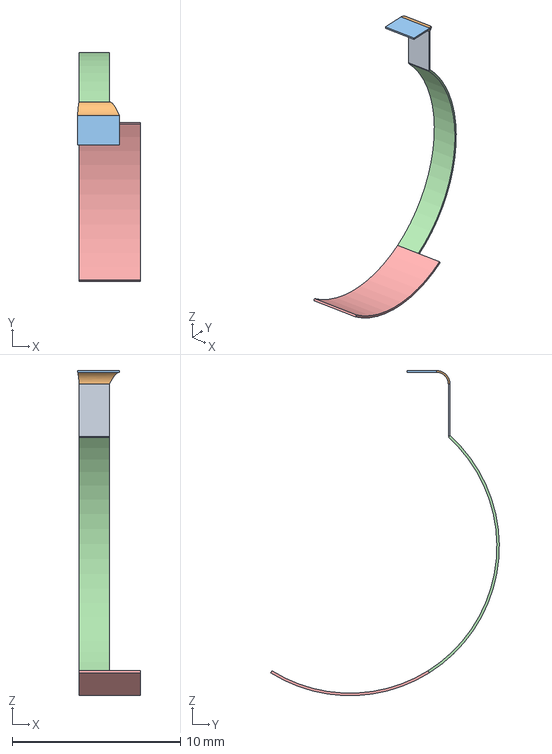
[picture p179: CAD file, 2026-11-13]
design/mfg/parts/flex-tail-away/flex-tail-away-us7.step
3.75 x 13.6 x 19.3 mm
