NexusGPT/openring/design/mfg/parts/flex-tail-thumb/flex-tail-thumb-us12.step

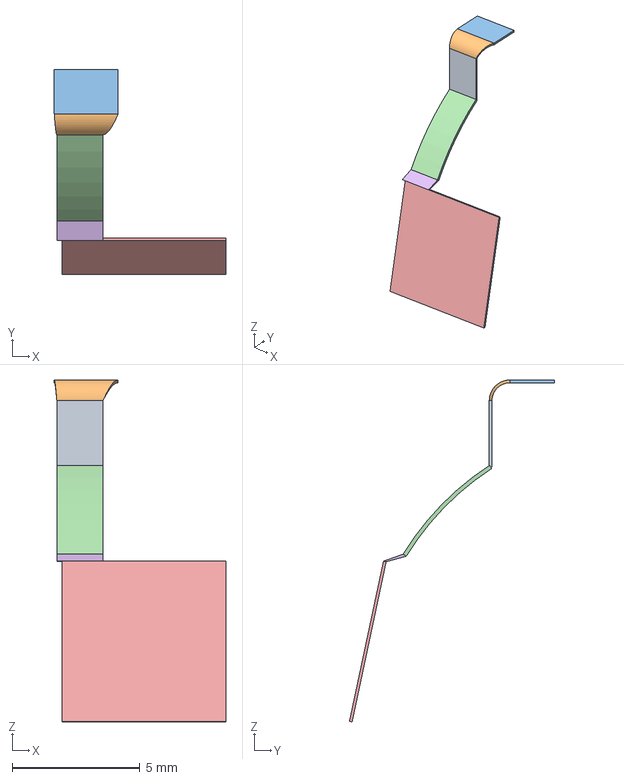
[picture p180: CAD file, 2026-11-13]
design/mfg/parts/flex-tail-thumb/flex-tail-thumb-us12.step
6.70 x 8.02 x 13.4 mm
