NexusGPT/openring/design/mfg/parts/joystick-dam/joystick-dam-us9.step

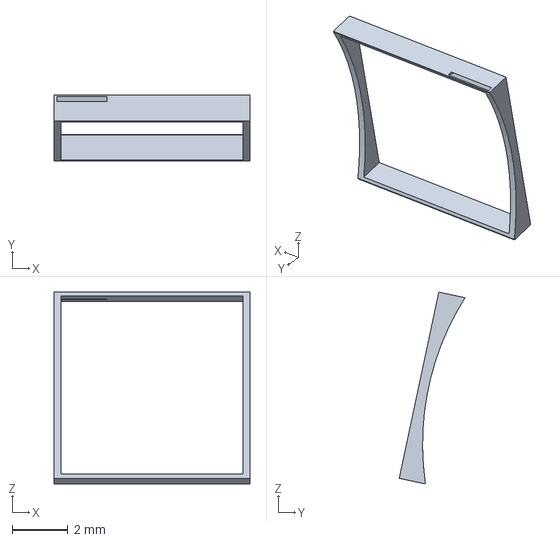
[picture p181: CAD file, 2026-11-13]
design/mfg/parts/joystick-dam/joystick-dam-us9.step
7.00 x 2.34 x 6.85 mm
