NexusGPT/openring/design/case/out/case_lid.stl

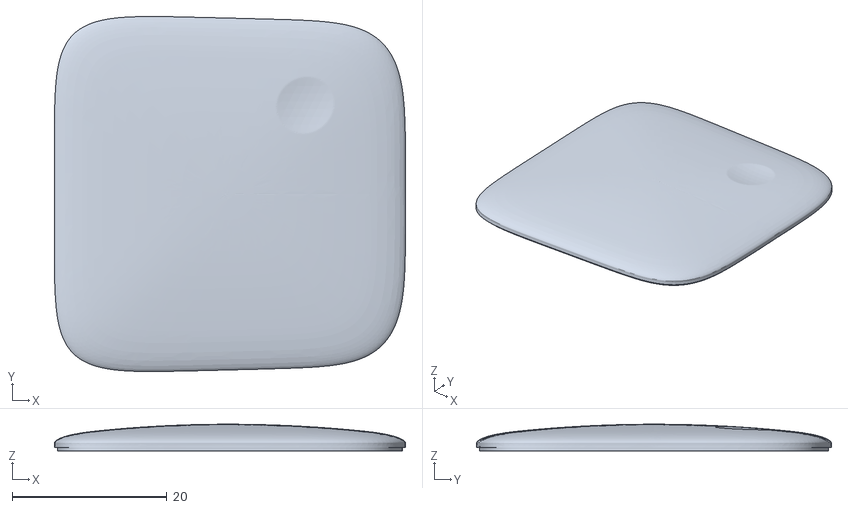
[picture p182: CAD file, 2026-11-13]
design/case/out/case_lid.stl
45.4 x 45.9 x 3.44
