NexusGPT/openring/design/case/out/parts/lead_W2.step

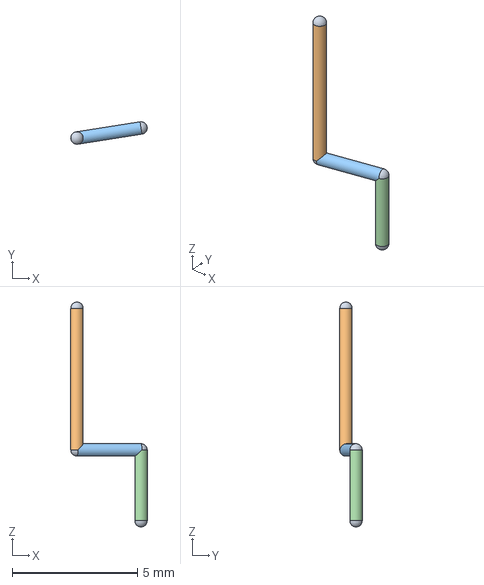
[picture p183: CAD file, 2026-11-13]
design/case/out/parts/lead_W2.step
3.06 x 0.903 x 8.99 mm
