NexusGPT/openring/design/ecad/case/pcb/models/box_uson10.step

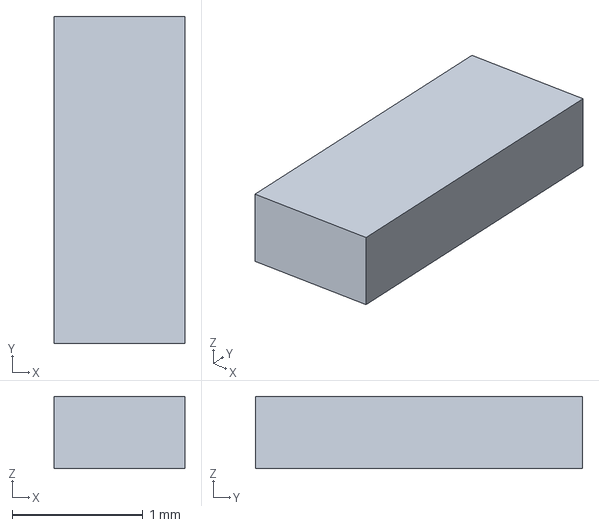
[picture p184: CAD file, 2026-11-13]
design/ecad/case/pcb/models/box_uson10.step
1.00 x 2.50 x 0.55 mm
