NexusGPT/openring/design/look/s1/out/ring-merged417flatw-us11.step

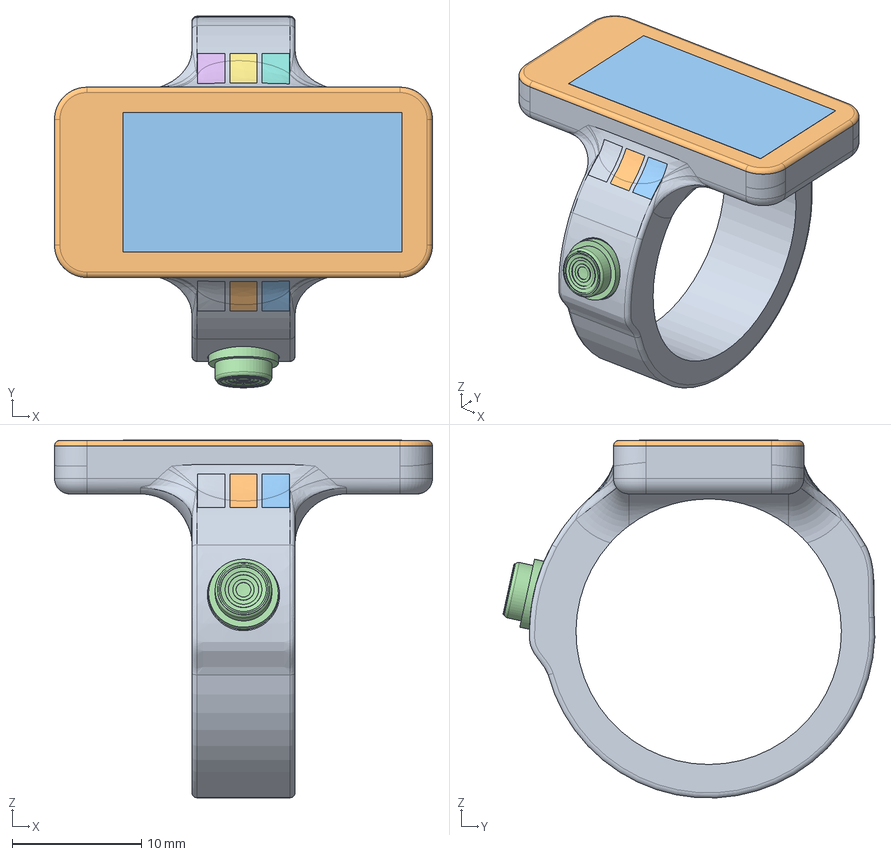
[picture p185: CAD file, 2026-11-13]
design/look/s1/out/ring-merged417flatw-us11.step
29.3 x 28.8 x 27.7 mm
glass
screen
joystick
mic_1
mic_2
slit_fill
