NexusGPT/openring/design/mech/out/base-size9.step

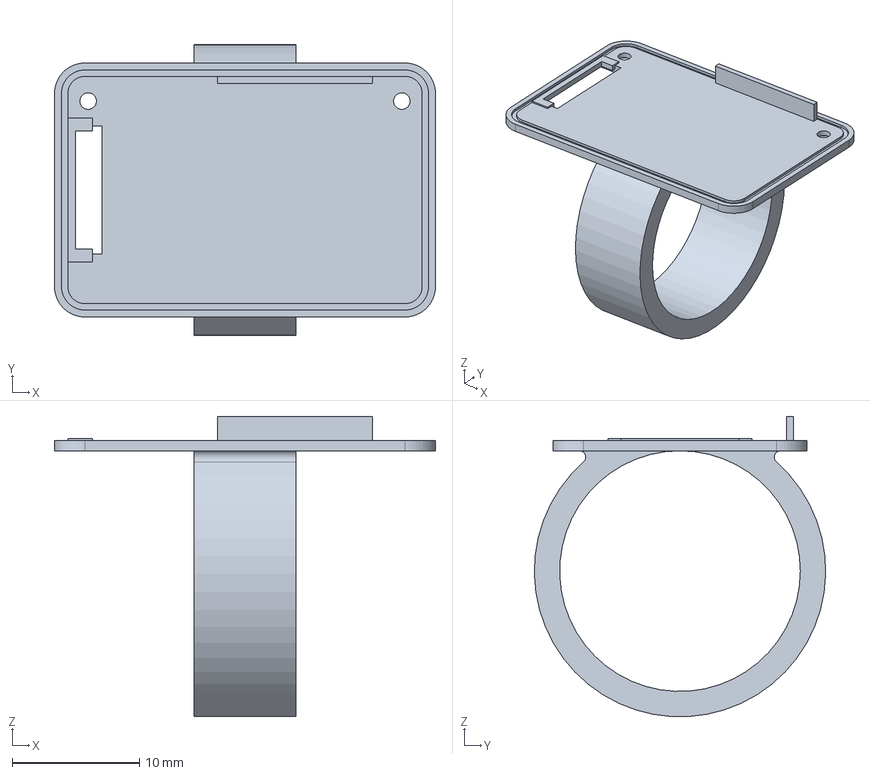
[picture p186: CAD file, 2026-11-13]
design/mech/out/base-size9.step
30.0 x 22.9 x 23.6 mm
