NexusGPT/openring/design/mfg/parts/band-liner/band-liner-us10.step

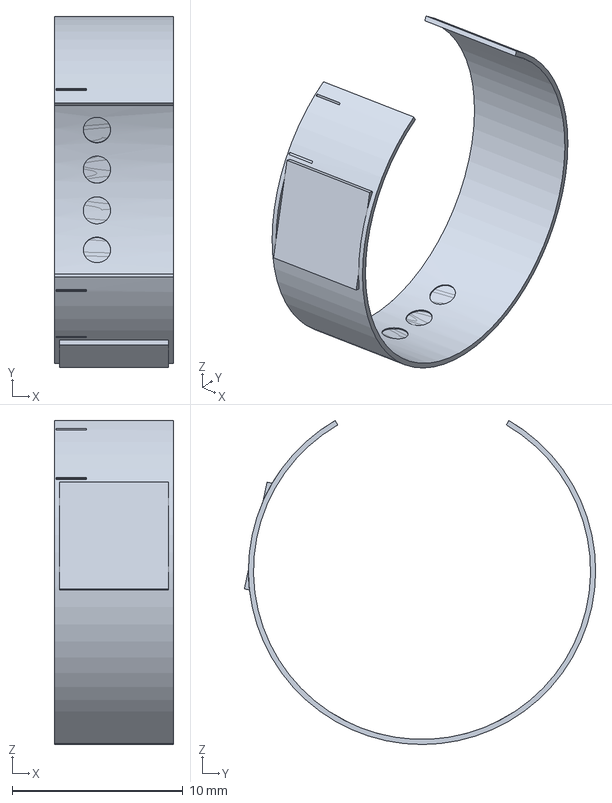
[picture p187: CAD file, 2026-11-13]
design/mfg/parts/band-liner/band-liner-us10.step
7.00 x 20.6 x 19.0 mm
