NexusGPT/openring/design/mfg/parts/body/body-us12.step

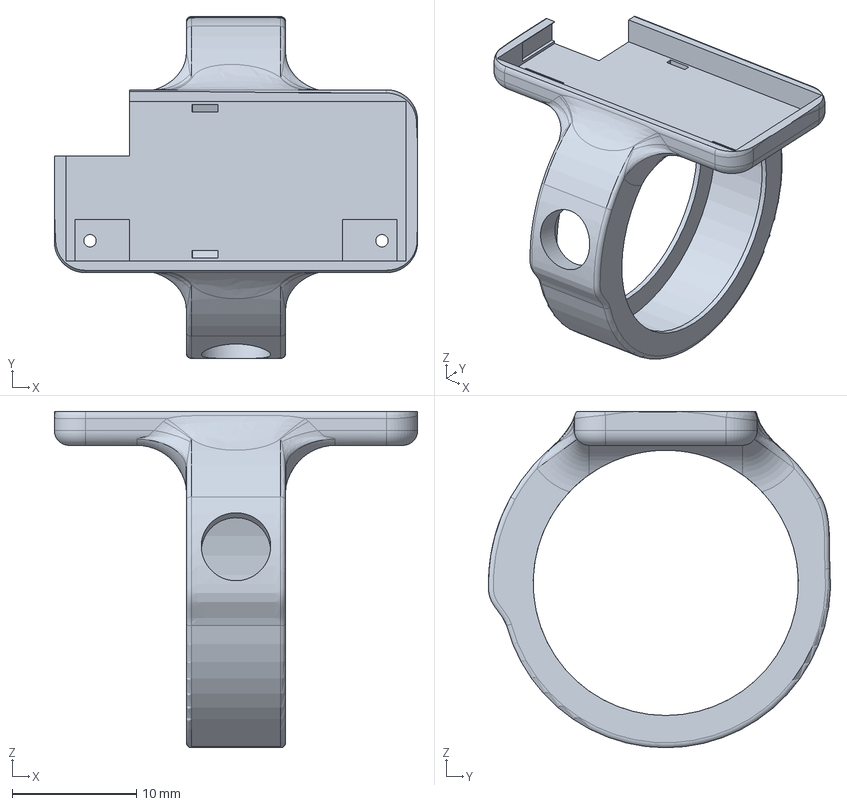
[picture p188: CAD file, 2026-11-13]
design/mfg/parts/body/body-us12.step
29.3 x 27.6 x 27.1 mm
