NexusGPT/openring/design/mfg/parts/cell/cell-us11.step

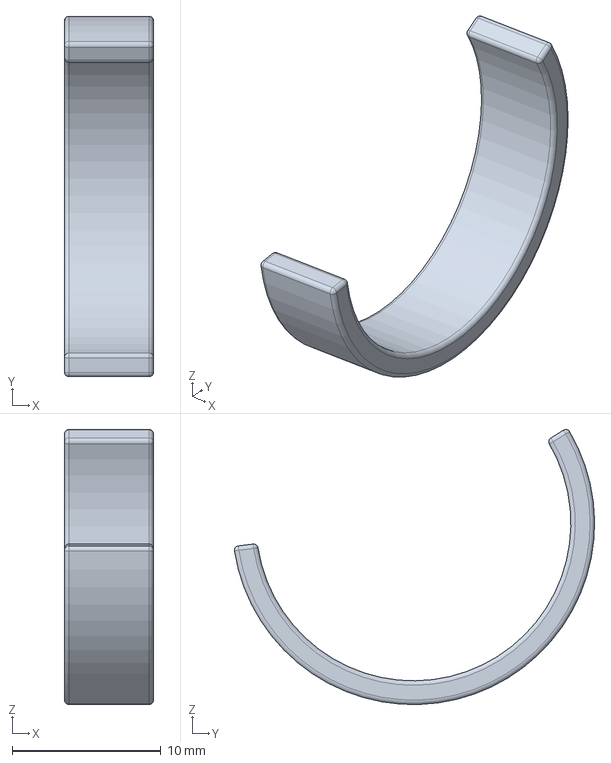
[picture p189: CAD file, 2026-11-13]
design/mfg/parts/cell/cell-us11.step
6.00 x 24.2 x 18.5 mm
