NexusGPT/openring/design/mfg/parts/flex-tail-away/flex-tail-away-us8.step

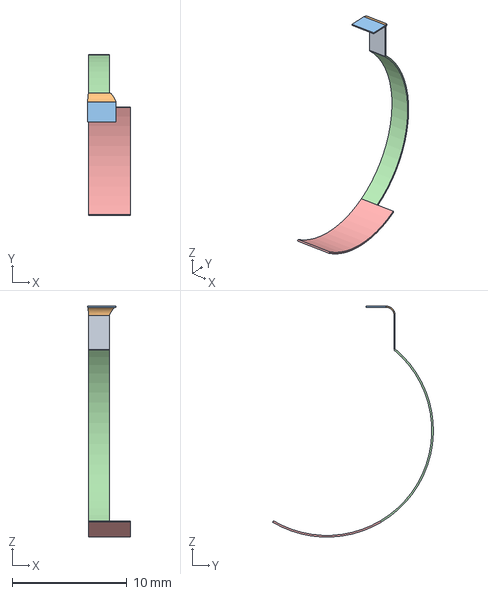
[picture p190: CAD file, 2026-11-13]
design/mfg/parts/flex-tail-away/flex-tail-away-us8.step
3.75 x 14.0 x 20.1 mm
