NexusGPT/openring/design/mfg/parts/flex-tail-thumb/flex-tail-thumb-us7.step

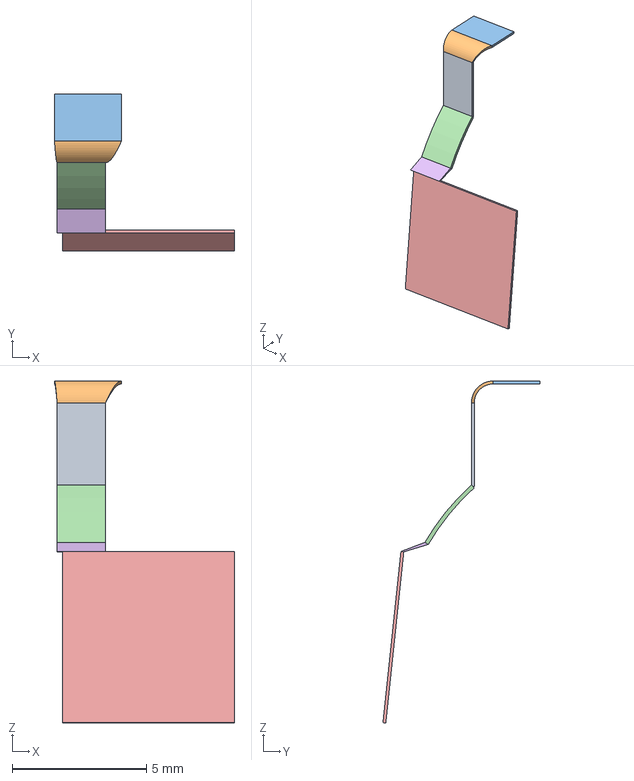
[picture p191: CAD file, 2026-11-13]
design/mfg/parts/flex-tail-thumb/flex-tail-thumb-us7.step
6.70 x 5.85 x 12.7 mm
