NexusGPT/openring/design/mfg/parts/joystick-dam/joystick-dam-us13.step

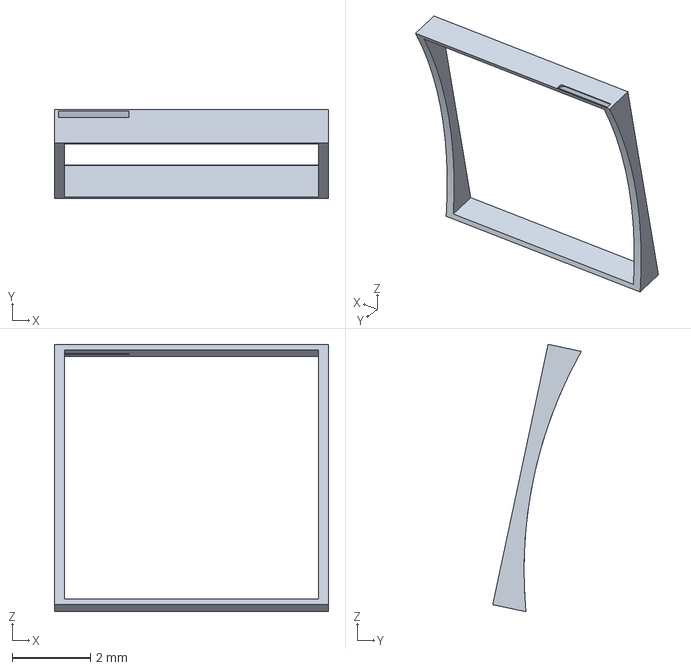
[picture p192: CAD file, 2026-11-13]
design/mfg/parts/joystick-dam/joystick-dam-us13.step
7.00 x 2.26 x 6.83 mm
