NexusGPT/openring/design/case/out/case_pin_board_pcb2.stl

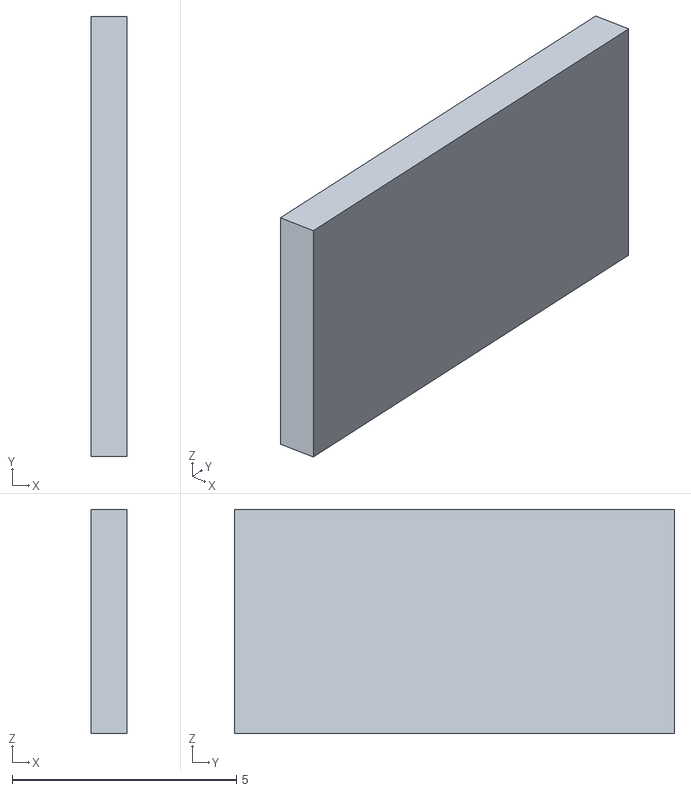
[picture p193: CAD file, 2026-11-13]
design/case/out/case_pin_board_pcb2.stl
0.8 x 9.80 x 5.00
