NexusGPT/openring/design/case/out/parts/board_retainer.step

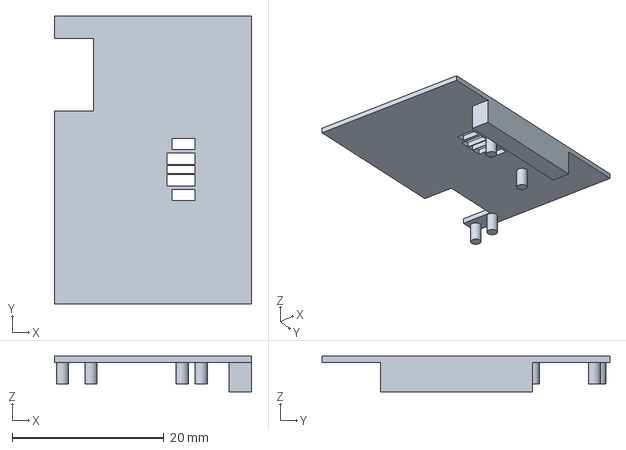
[picture p194: CAD file, 2026-11-13]
design/case/out/parts/board_retainer.step
26.0 x 37.9 x 4.68 mm
