NexusGPT/openring/design/ecad/case/pcb/models/cyl_harwin.step

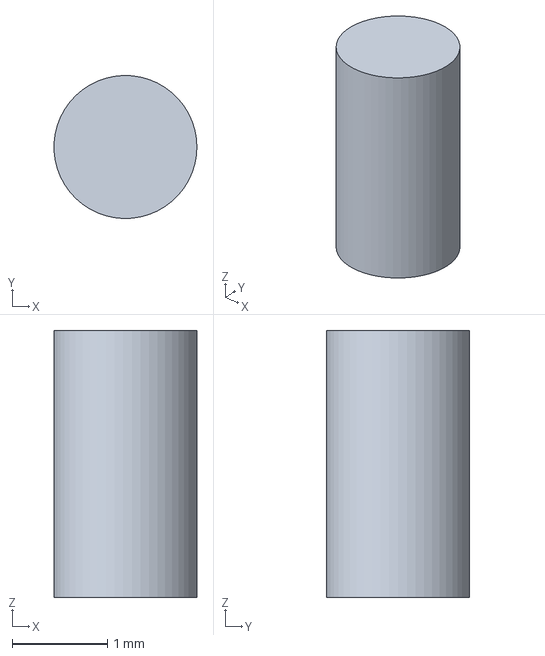
[picture p195: CAD file, 2026-11-13]
design/ecad/case/pcb/models/cyl_harwin.step
1.50 x 1.50 x 2.80 mm
