NexusGPT/openring/design/look/s1/out/ring-merged32h-us8.step

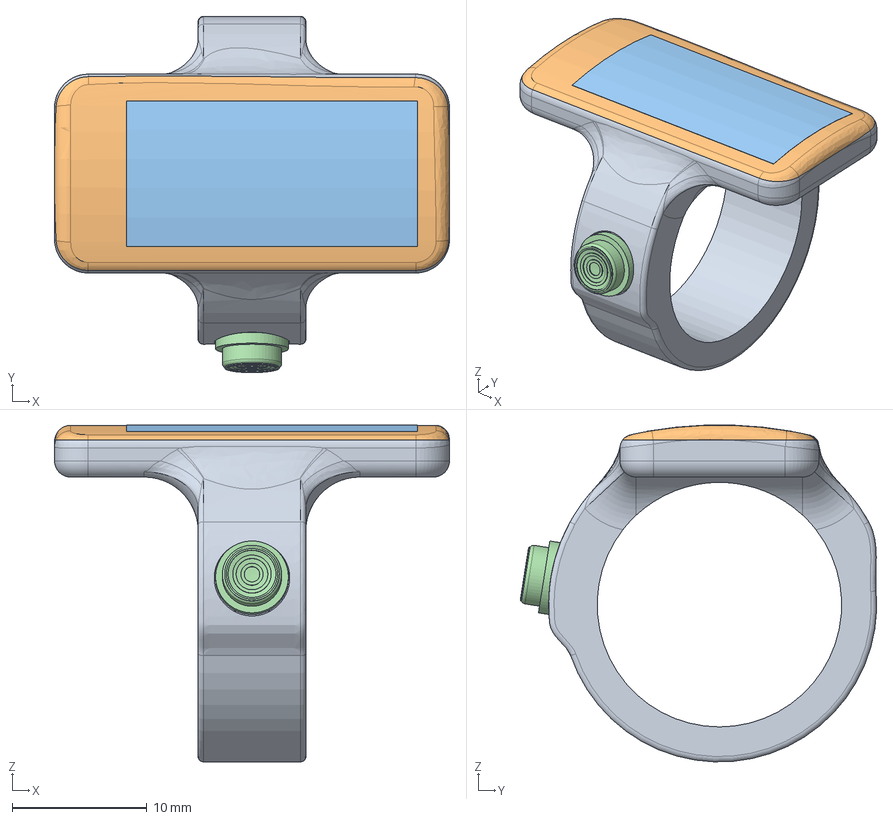
[picture p196: CAD file, 2026-11-13]
design/look/s1/out/ring-merged32h-us8.step
29.3 x 26.4 x 25.0 mm
glass
screen
joystick
mic_1
mic_2
