NexusGPT/openring/design/mech/out/base-size11.step

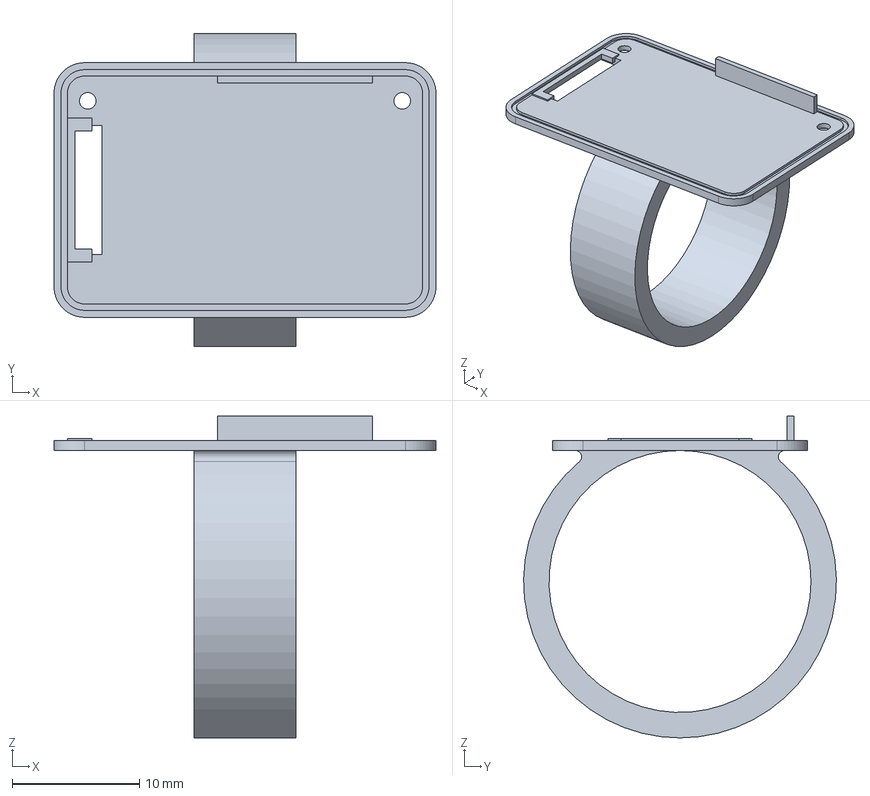
[picture p197: CAD file, 2026-11-13]
design/mech/out/base-size11.step
30.0 x 24.6 x 25.3 mm
