NexusGPT/openring/design/mfg/parts/band-liner/band-liner-us7.step

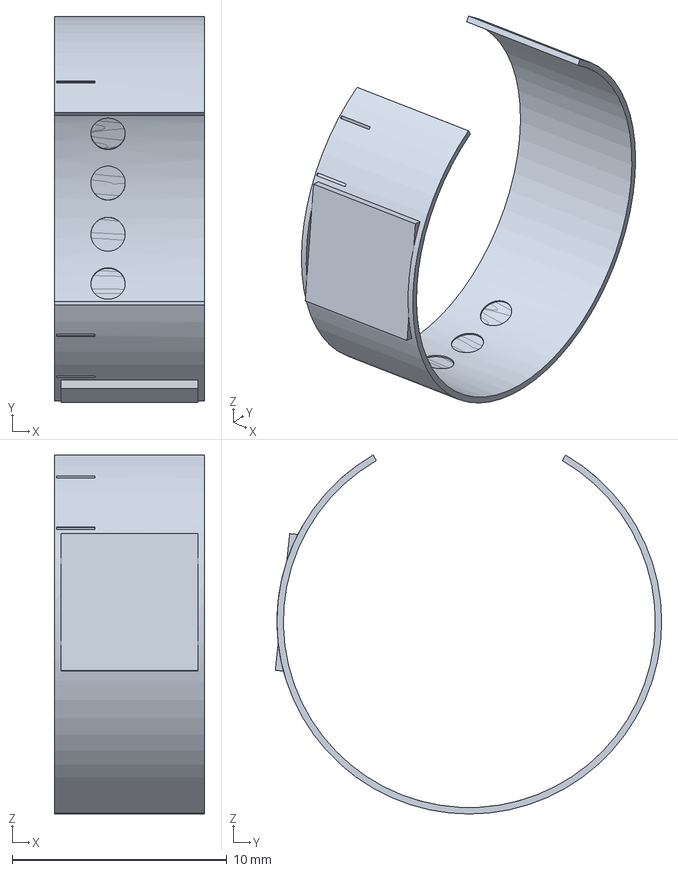
[picture p198: CAD file, 2026-11-13]
design/mfg/parts/band-liner/band-liner-us7.step
7.00 x 18.0 x 16.7 mm
