NexusGPT/openring/design/mfg/parts/body/body-us10.step

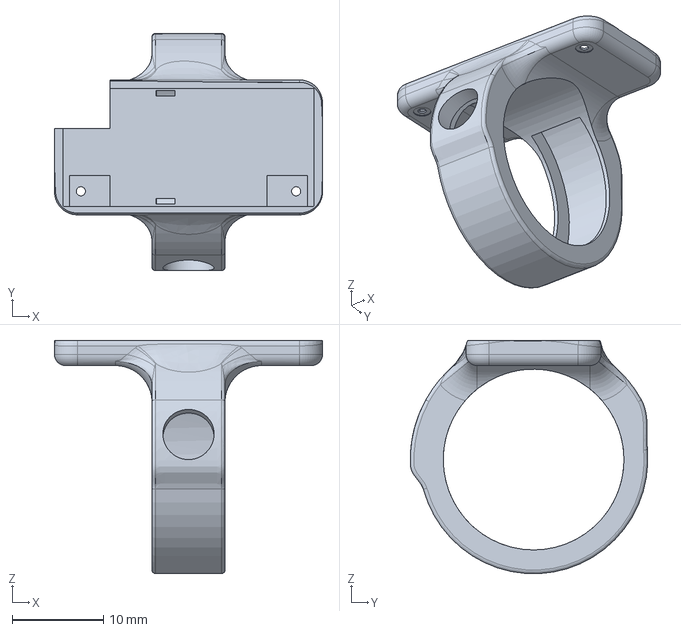
[picture p199: CAD file, 2026-11-13]
design/mfg/parts/body/body-us10.step
29.3 x 25.9 x 25.5 mm
