NexusGPT/openring/design/mfg/parts/cell/cell-us7.step

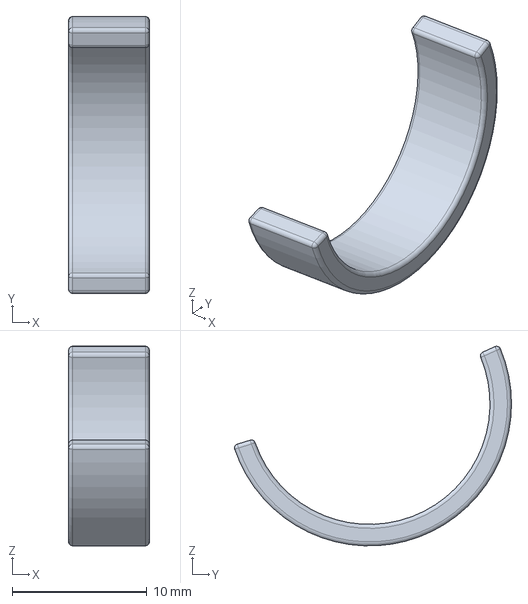
[picture p200: CAD file, 2026-11-13]
design/mfg/parts/cell/cell-us7.step
6.00 x 20.6 x 14.8 mm
