NexusGPT/openring/design/mfg/parts/flex-tail-away/flex-tail-away-us11.step

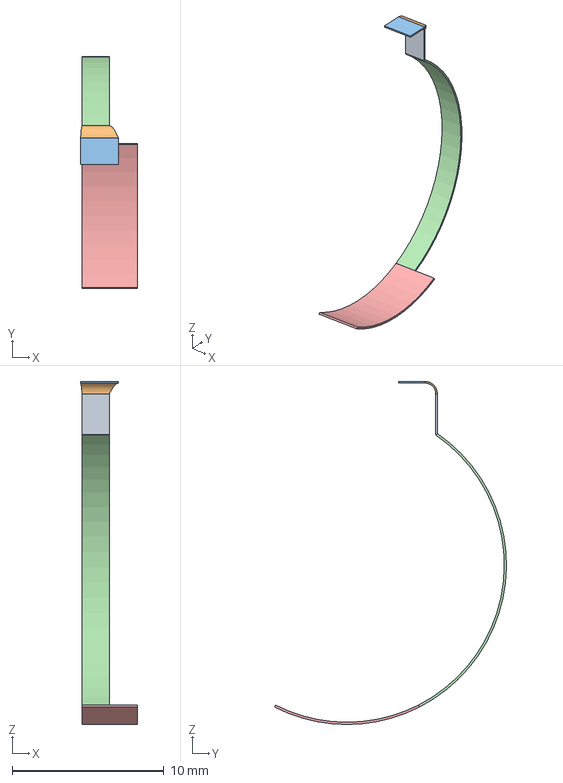
[picture p201: CAD file, 2026-11-13]
design/mfg/parts/flex-tail-away/flex-tail-away-us11.step
3.75 x 15.3 x 22.6 mm
