NexusGPT/openring/design/mfg/parts/flex-tail-thumb/flex-tail-thumb-us9.step

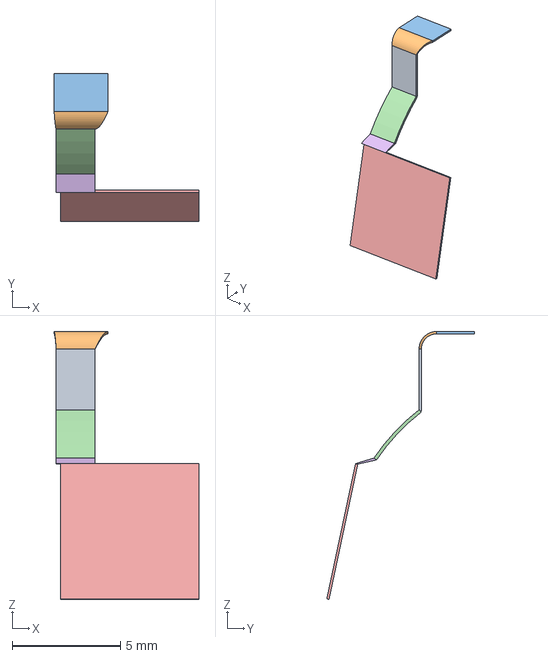
[picture p202: CAD file, 2026-11-13]
design/mfg/parts/flex-tail-thumb/flex-tail-thumb-us9.step
6.70 x 6.82 x 12.4 mm
