NexusGPT/openring/design/mfg/parts/joystick-dam/joystick-dam-us8.step

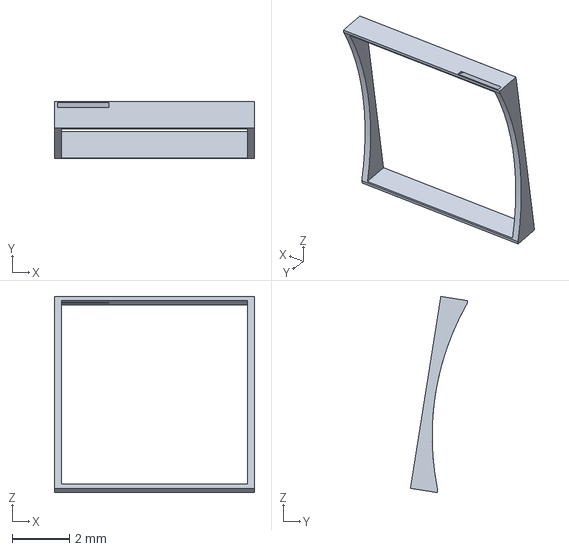
[picture p203: CAD file, 2026-11-13]
design/mfg/parts/joystick-dam/joystick-dam-us8.step
7.00 x 2.00 x 6.86 mm
