NexusGPT/openring/design/case/out/parts/cell_dnk852338.step

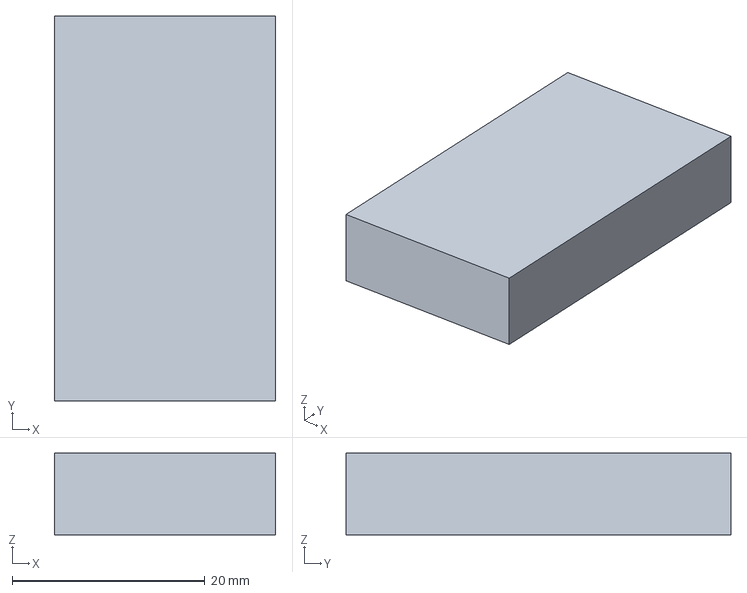
[picture p204: CAD file, 2026-11-13]
design/case/out/parts/cell_dnk852338.step
23.0 x 40.0 x 8.50 mm
