NexusGPT/openring/design/ecad/case/pcb/models/box_led1616.step

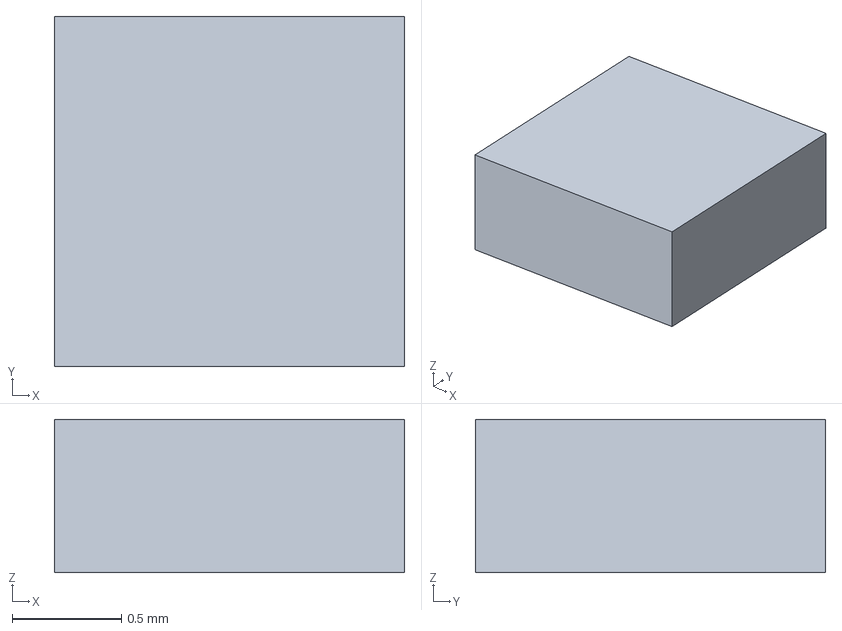
[picture p205: CAD file, 2026-11-13]
design/ecad/case/pcb/models/box_led1616.step
1.60 x 1.60 x 0.7 mm
