NexusGPT/openring/design/mech/out/base-size5.step

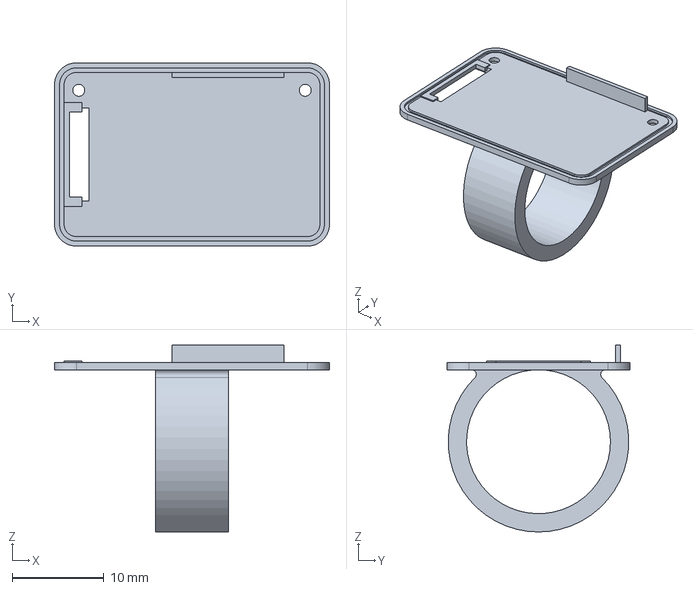
[picture p207: CAD file, 2026-11-13]
design/mech/out/base-size5.step
30.0 x 20.0 x 20.4 mm
