NexusGPT/openring/design/mfg/parts/band-liner/band-liner-us8.step

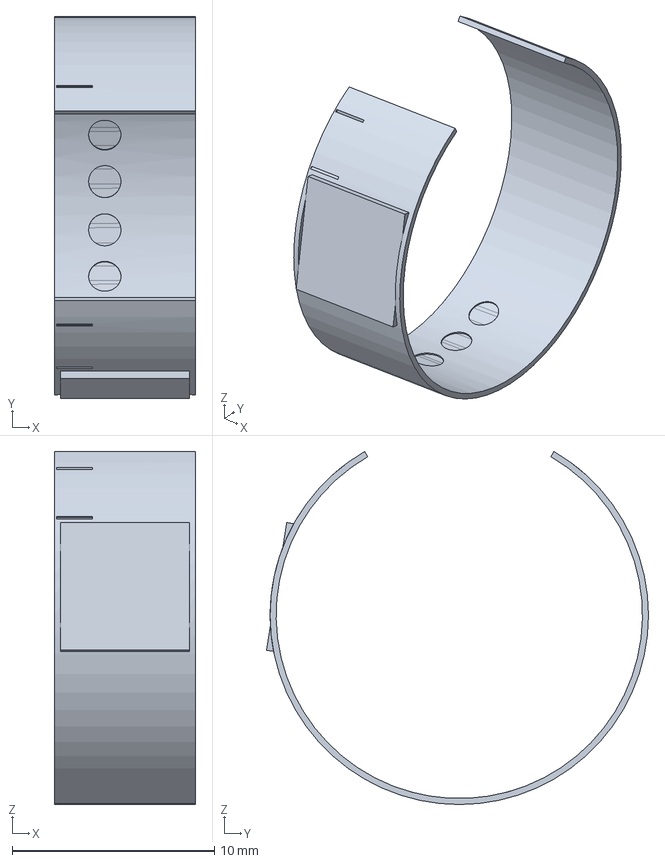
[picture p208: CAD file, 2026-11-13]
design/mfg/parts/band-liner/band-liner-us8.step
7.00 x 18.9 x 17.5 mm
