NexusGPT/openring/design/mfg/parts/body/body-us13.step

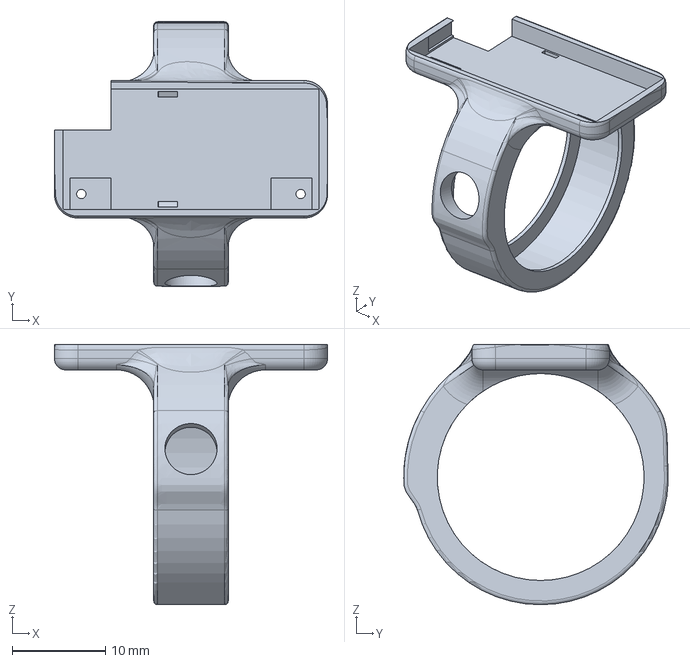
[picture p209: CAD file, 2026-11-13]
design/mfg/parts/body/body-us13.step
29.3 x 28.4 x 27.9 mm
