NexusGPT/openring/design/mfg/parts/cell/cell-us8.step

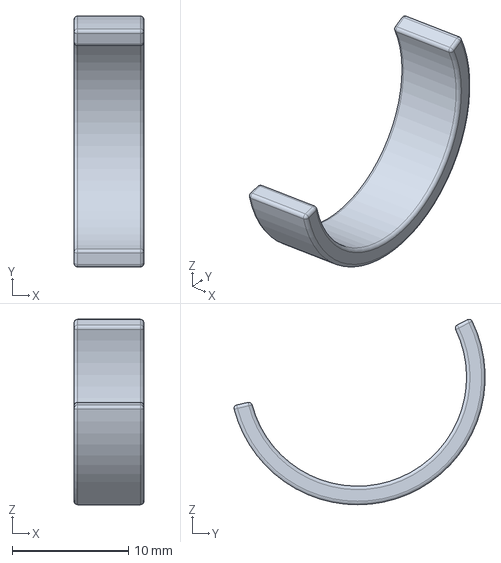
[picture p210: CAD file, 2026-11-13]
design/mfg/parts/cell/cell-us8.step
6.00 x 21.6 x 15.9 mm
