NexusGPT/openring/design/mfg/parts/flex-tail-away/flex-tail-away-us13.step

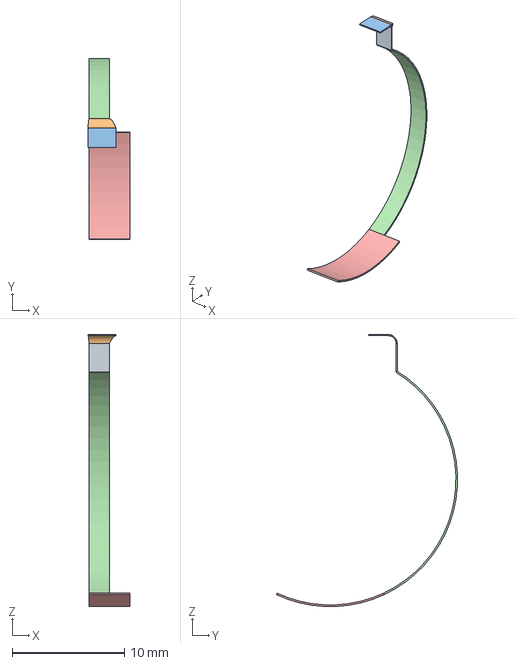
[picture p211: CAD file, 2026-11-13]
design/mfg/parts/flex-tail-away/flex-tail-away-us13.step
3.75 x 16.1 x 24.2 mm
