NexusGPT/openring/design/mfg/parts/flex-tail-thumb/flex-tail-thumb-us10.step

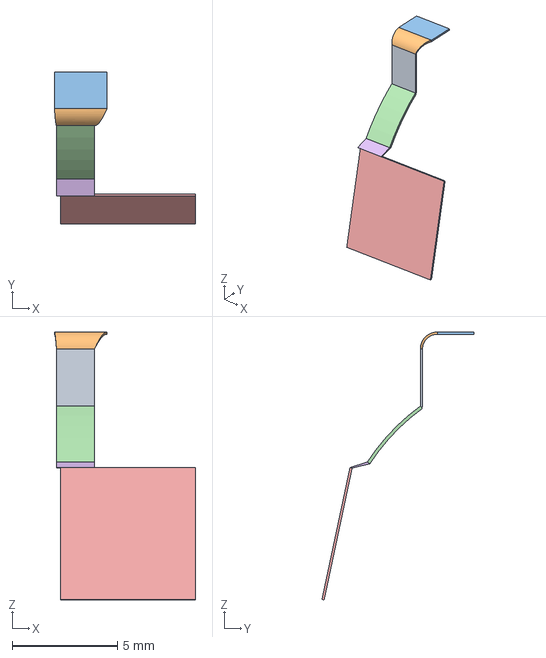
[picture p212: CAD file, 2026-11-13]
design/mfg/parts/flex-tail-thumb/flex-tail-thumb-us10.step
6.70 x 7.22 x 12.7 mm
