NexusGPT/openring/design/mfg/parts/joystick-dam/joystick-dam-us12.step

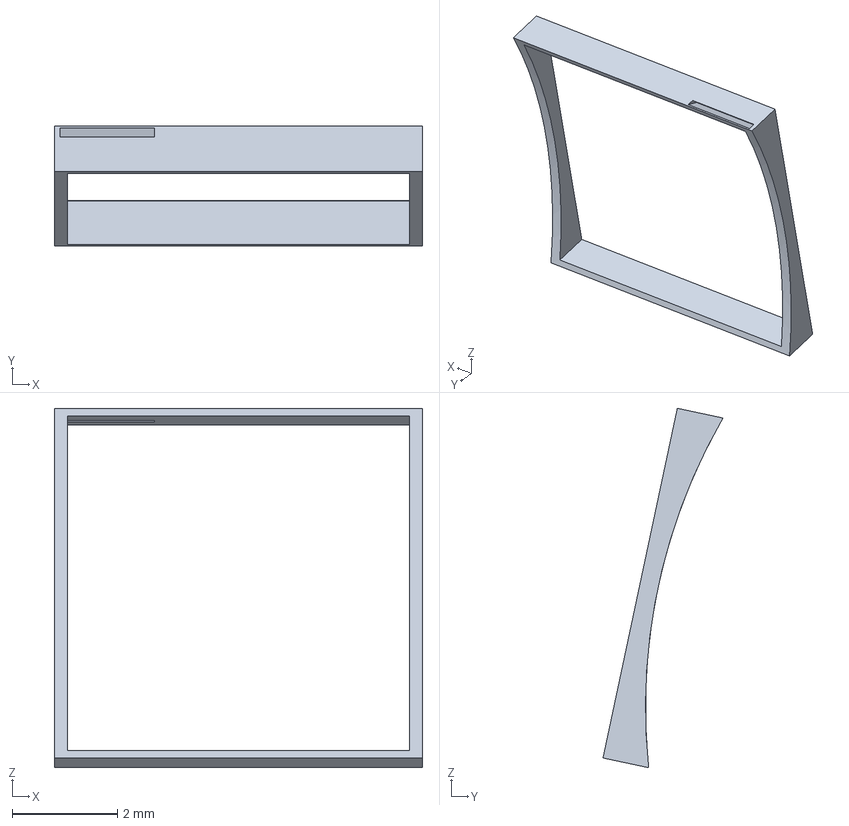
[picture p213: CAD file, 2026-11-13]
design/mfg/parts/joystick-dam/joystick-dam-us12.step
7.00 x 2.28 x 6.84 mm
