NexusGPT/openring/design/mfg/parts/joystick-stiffener/joystick-stiffener-us8.step

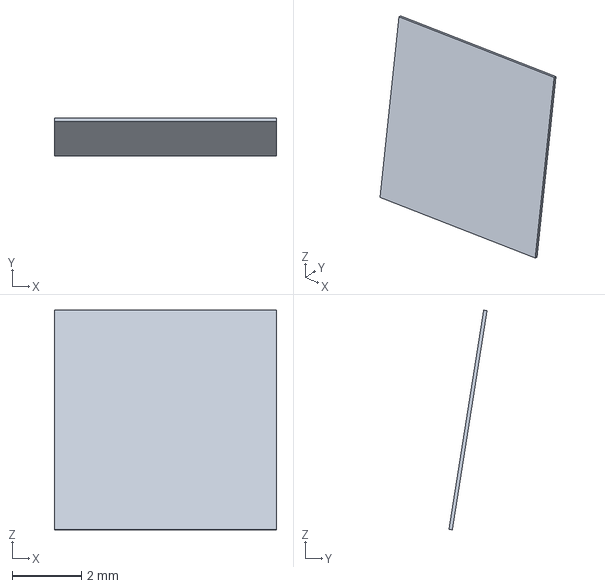
[picture p214: CAD file, 2026-11-13]
design/mfg/parts/joystick-stiffener/joystick-stiffener-us8.step
6.40 x 1.10 x 6.34 mm
