NexusGPT/openring/design/case/out/case_pin_holder.stl

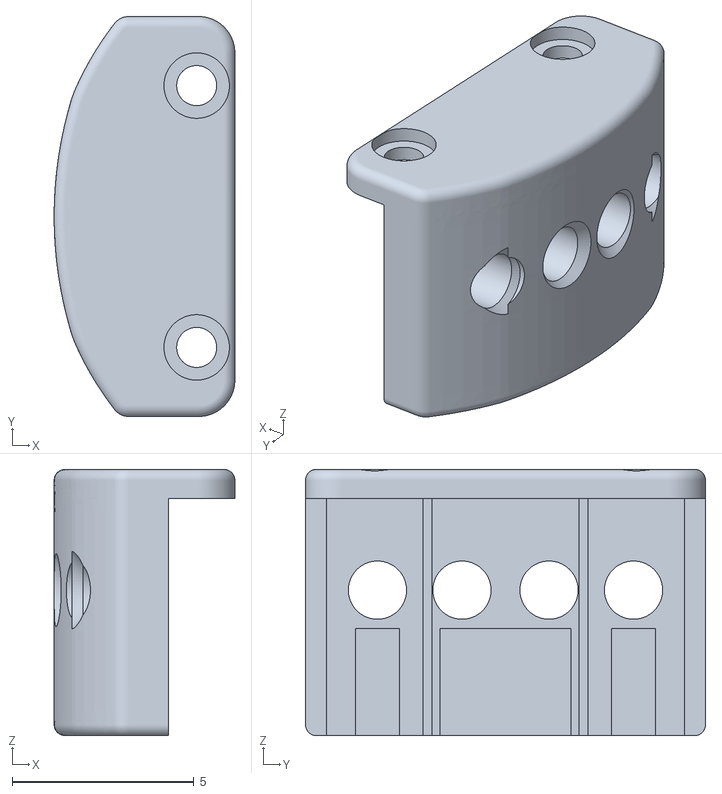
[picture p215: CAD file, 2026-11-13]
design/case/out/case_pin_holder.stl
4.97 x 11.0 x 7.32
