NexusGPT/openring/design/ecad/case/pcb/models/box_esp32s3_mini1.step

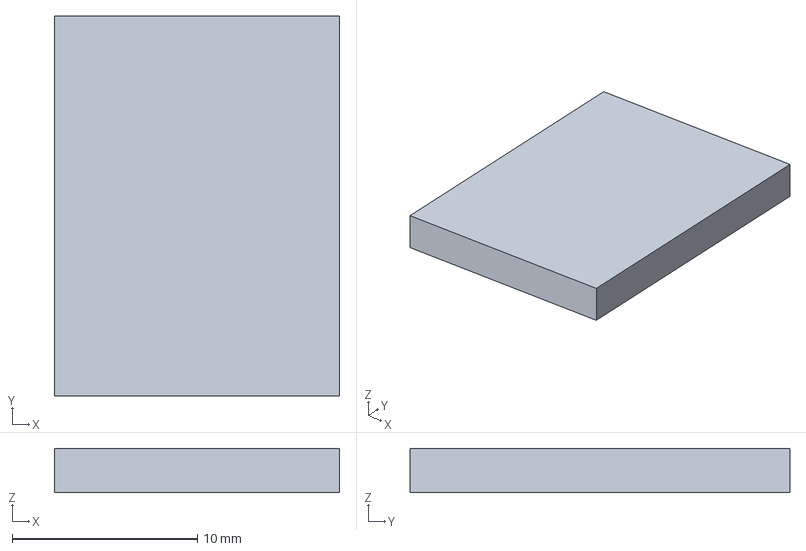
[picture p216: CAD file, 2026-11-13]
design/ecad/case/pcb/models/box_esp32s3_mini1.step
15.4 x 20.5 x 2.40 mm
