NexusGPT/openring/design/look/s1/out/ring-merged417flat-us10.step

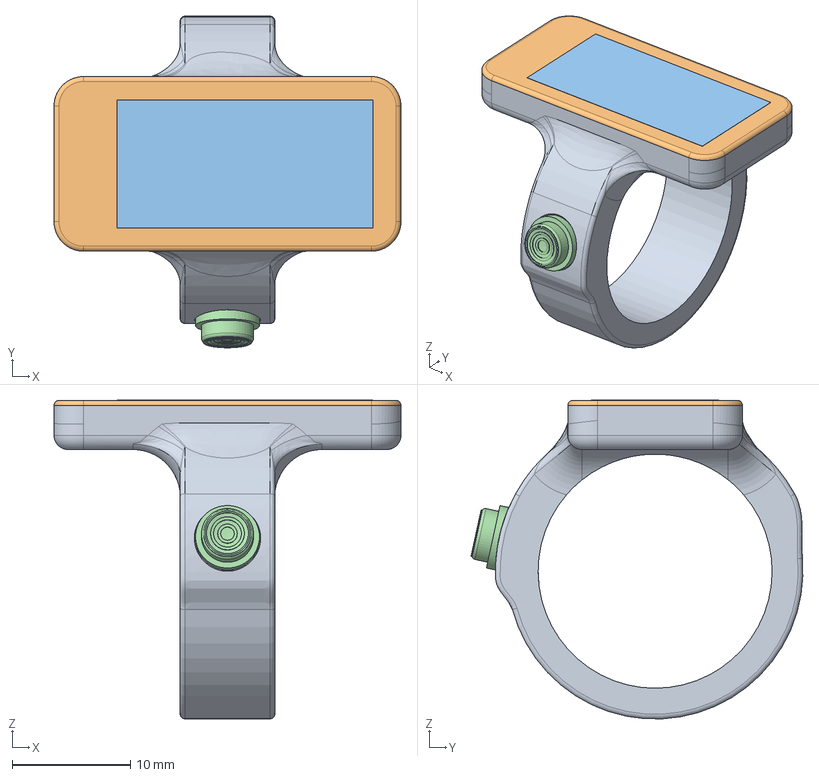
[picture p217: CAD file, 2026-11-13]
design/look/s1/out/ring-merged417flat-us10.step
29.3 x 28.0 x 26.9 mm
glass
screen
joystick
mic_1
mic_2
