NexusGPT/openring/design/mech/out/top-shell.step

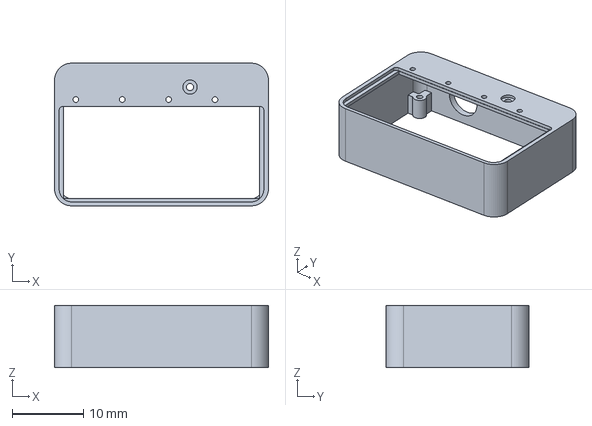
[picture p218: CAD file, 2026-11-13]
design/mech/out/top-shell.step
30.0 x 20.0 x 8.70 mm
