NexusGPT/openring/design/case/out/case_base.stl

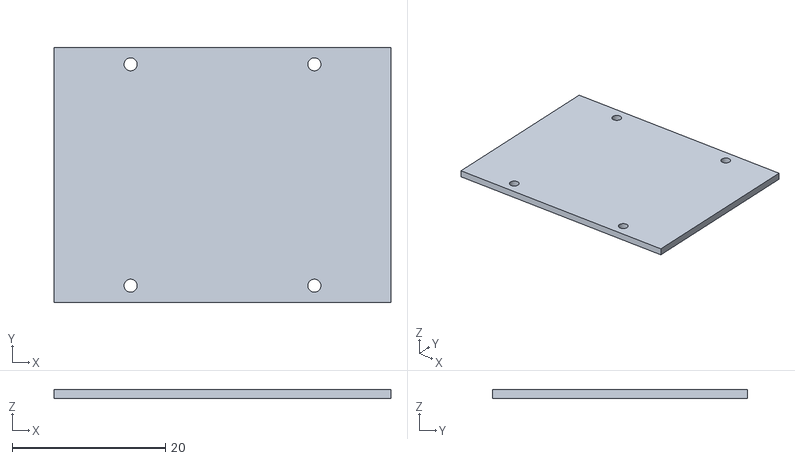
[picture p219: CAD file, 2026-11-13]
design/case/out/case_base.stl
44.0 x 33.3 x 1.20
