NexusGPT/openring/(list of files, cad)

Other CAD files:
design/ecad/case/pcb/case-proc-work/before/fab/case_main/case_main.step
design/ecad/case/pcb/evidence/marks/before/fab/case_main/case_main.step
design/ecad/case/pcb/fab/case_main/case_main.step
design/wiring/case-marks-2-work/before/fab_case_main/case_main.step
design/case/out/boards/main.step
design/case/r4/boards_now/main.step
design/case/out/parts/main_board.step
design/case/r4/boards_now/pins.step
design/ecad/case/pcb/case-proc-work/before/fab/case_pins/case_pins.step
design/ecad/case/pcb/evidence/marks/before/fab/case_pins/case_pins.step
design/ecad/case/pcb/fab/case_pins/case_pins.step
design/ecad/ring/pcb/fallback-417/fab/ring.step
design/mech/thin/out/thin-inside.step
design/mech/thin/out/v9/before/thin-inside_v8.step
design/mech/thin/out/v9/drawparts/flex-tail-thumb-footstiffener/flex-tail-thumb-footstiffener-us13.step
design/mfg/tools/testdata/parts/bad/bad.step
design/case/out/boards_check/pins.step
design/mech/thin/out/v9/drawparts/flex-tail-away-footstiffener/flex-tail-away-footstiffener-us8.step
design/mech/thin/out/v9/drawparts/flex-tail-thumb-footstiffener/flex-tail-thumb-footstiffener-us10.step
design/mfg/parts/glass-seal/glass-seal-us9.step
design/case/out/case_post.stl
design/mech/thin/out/v9/drawparts/flex-tail-away-footstiffener/flex-tail-away-footstiffener-us9.step
design/mech/thin/out/v9/drawparts/flex-tail-thumb-footstiffener/flex-tail-thumb-footstiffener-us11.step
design/mfg/parts/glass-seal/glass-seal-us8.step
design/mfg/parts/joystick-dam/joystick-dam-us10.step
design/mfg/parts/joystick-stiffener/joystick-stiffener-us13.step
design/mech/thin/out/v9/drawparts/flex-tail-away-footstiffener/flex-tail-away-footstiffener-us7.step
design/mech/thin/out/v9/drawparts/flex-tail-thumb-footstiffener/flex-tail-thumb-footstiffener-us8.step
design/mfg/parts/glass-seal/glass-seal-us10.step
design/mfg/parts/joystick-stiffener/joystick-stiffener-us11.step
design/mech/thin/out/v9/drawparts/flex-tail-away-footstiffener/flex-tail-away-footstiffener-us13.step
design/mech/thin/out/v9/drawparts/flex-tail-thumb-footstiffener/flex-tail-thumb-footstiffener-us9.step
design/mfg/parts/glass-seal/glass-seal-us12.step
design/mfg/parts/joystick-stiffener/joystick-stiffener-us10.step
design/mech/thin/out/v9/drawparts/flex-tail-away-footstiffener/flex-tail-away-footstiffener-us11.step
design/mech/thin/out/v9/drawparts/flex-tail-thumb-footstiffener/flex-tail-thumb-footstiffener-us7.step
design/mfg/parts/glass-seal/glass-seal-us13.step
design/mfg/parts/joystick-stiffener/joystick-stiffener-us9.step
design/mech/thin/out/v9/drawparts/flex-tail-away-footstiffener/flex-tail-away-footstiffener-us10.step
design/mech/thin/out/v9/drawparts/flex-tail-thumb-footstiffener/flex-tail-thumb-footstiffener-us12.step
design/mfg/parts/glass-seal/glass-seal-us7.step
design/case/out/parts/lid.step
design/case/out/case_base_plate.stl
design/case/out/case_board_retainer.stl
design/case/out/parts/foam_pad.step
design/case/out/parts/foot.step
design/case/out/parts/glide_1.step
design/case/out/parts/glide_2.step
design/case/out/parts/glide_3.step
design/case/out/parts/glide_4.step
design/case/out/parts/hinge_pivot.step
design/case/out/parts/insulation_sheet.step
design/case/out/parts/lead_TH1_1.step
design/case/out/parts/lead_TH1_2.step
design/case/out/parts/lead_W1.step
design/case/out/parts/lead_W3.step
design/case/out/parts/lead_W4.step
design/case/out/parts/lead_W5.step
design/case/out/parts/lead_W6.step
design/case/out/parts/lead_W7.step
design/case/out/parts/lid_seam_trim.step
design/case/out/parts/light_window.step
design/case/out/parts/liner.step
design/case/out/parts/magnet_base.step
design/case/out/parts/magnet_lid.step
design/case/out/parts/pin_P1_VBUS.step
design/case/out/parts/pin_P2_D-.step
design/case/out/parts/pin_P3_D+.step
design/case/out/parts/pin_P4_GND.step
design/case/out/parts/pin_board_pcb2.step
design/case/out/parts/pin_board_pcb2_wing_L.step
design/case/out/parts/pin_board_pcb2_wing_R.step
design/case/out/parts/pin_holder.step
design/case/out/parts/seam_trim.step
design/case/out/parts/shell.step
design/look/s1/out/ring-merged32h-us10.step
design/look/s1/out/ring-merged32h-us11.step
design/look/s1/out/ring-merged32h-us13.step
design/look/s1/out/ring-merged32h.step
design/look/s1/out/ring-merged417flat-us10.stl
design/look/s1/out/ring-merged417flat-us11.stl
design/look/s1/out/ring-merged417flat-us12.step
design/look/s1/out/ring-merged417flat-us12.stl
design/look/s1/out/ring-merged417flat-us13.step
design/look/s1/out/ring-merged417flat-us13.stl
design/look/s1/out/ring-merged417flat-us7.step
design/look/s1/out/ring-merged417flat-us7.stl
design/look/s1/out/ring-merged417flat-us8.step
design/look/s1/out/ring-merged417flat-us8.stl
design/look/s1/out/ring-merged417flat-us9.step
design/look/s1/out/ring-merged417flat-us9.stl
design/look/s1/out/ring-merged417flatw-us10.step
design/look/s1/out/ring-merged417flatw-us10.stl
design/look/s1/out/ring-merged417flatw-us11.stl
design/look/s1/out/ring-merged417flatw-us12.step
design/look/s1/out/ring-merged417flatw-us12.stl
design/look/s1/out/ring-merged417flatw-us13.step
design/look/s1/out/ring-merged417flatw-us13.stl
design/look/s1/out/ring-merged417flatw-us7.stl
design/look/s1/out/ring-merged417flatw-us8.step
design/look/s1/out/ring-merged417flatw-us8.stl
design/look/s1/out/ring-merged417flatw-us9.step
design/look/s1/out/ring-merged417flatw-us9.stl
design/mech/out/base-size10.stl
design/mech/out/base-size11.stl
design/mech/out/base-size12.step
design/mech/out/base-size12.stl
design/mech/out/base-size13.stl
design/mech/out/base-size5.stl
design/mech/out/base-size6.step
design/mech/out/base-size6.stl
design/mech/out/base-size7.step
design/mech/out/base-size7.stl
design/mech/out/base-size8.stl
design/mech/out/base-size9.stl
design/mech/out/top-shell.stl
design/mech/thin/out/v7/broken_height/out/thin-inside.step
design/mech/thin/out/v7/broken_led/out/thin-inside.step
design/mech/thin/out/v7/probe/a_cyl.step
design/mech/thin/out/v7/probe/b_fillet.step
design/mech/thin/out/v7/probe/c_dish.step
design/mech/thin/out/v7/probe/d_ridge_0.7.step
design/mech/thin/out/v7/probe/d_ridge_1.3.step
design/mech/thin/out/v7/probe/d_ridge_1.9.step
design/mech/thin/out/v7/probe/e_full.step
design/mech/thin/out/v7/probe/f_full_clean.step
design/mech/thin/out/v7/probe/g_rot.step
design/mech/thin/out/v7/probe/m_compound_fix.step
design/mech/thin/out/v7/probe/m_copy.step
design/mech/thin/out/v7/probe/m_fix.step
design/mech/thin/out/v7/probe/m_solid0.step
design/mfg/parts/band-liner/band-liner-us10.stl
design/mfg/parts/band-liner/band-liner-us11.stl
design/mfg/parts/band-liner/band-liner-us12.stl
design/mfg/parts/band-liner/band-liner-us13.stl
design/mfg/parts/band-liner/band-liner-us7.stl
design/mfg/parts/band-liner/band-liner-us8.stl
design/mfg/parts/band-liner/band-liner-us9.stl
design/mfg/parts/body/body-us10.stl
design/mfg/parts/body/body-us11.stl
design/mfg/parts/body/body-us12.stl
design/mfg/parts/body/body-us13.stl
design/mfg/parts/body/body-us7.stl
design/mfg/parts/body/body-us8.stl
design/mfg/parts/body/body-us9.stl
design/mfg/parts/joystick-cap/joystick-cap.stl
design/mfg/parts/joystick-frame/joystick-frame.stl
design/mfg/parts/radio-corner/radio-corner.stl
