NexusGPT/openring/design/wiring/lead-decisions.md

# Decisions of the lead on open items (package W7)

Each line closes one item of `deferred-items.md`. A decision has its source. The owner can overrule any of them.

| Item | Decision | Source | Date |
|---|---|---|---|
| 23 | The level shifter U10 (SN74AXC4T774RSVR) stays. The main chip stays on 1.8 V. Price and stock are not design inputs. | `design/ecad/ring/sch-notes.md` lines 160 to 163: the storage part needs 2.7 to 3.6 V and an input high of 1.875 V at 3.0 V; a 1.8 V output does not reach it. | 2026-11-12 23:42 |
| 29 | The motor is on the joystick-side tail (FLEX1, lands MOT- 6 and MOT+ 7 of J_BAND_A). | `design/ecad/ring/netlist.csv` lines 92 and 363; `design/mech/thin/placement.csv` rows 40 and 47; `design/mfg/specs/band-flex-tails.md` line 11. | 2026-11-12 23:42 |
| 34 | The cell's temperature sensor RT1 sits on the cell's protection circuit and is wired in the other tail (FLEX2, land NTC 3 of J_BAND_B). Its part number comes from package W1. | `design/bom-notes.md` line 47 (closed in design review 3, finding H05); `design/ecad/ring/netlist.csv` line 189. | 2026-11-12 23:42 |
| 40 | The motor is the Jinlong W0525AB001D (5.0 x 2.5 mm coin with lead wires). The two Vybronics parts in `bom-notes.md` line 43 are history. | `design/ecad/ring/parts.csv` line 87; `design/mech/thin/placement.csv` row 40. | 2026-11-12 23:42 |
| 47 | Closed: every wiring, parts list and firmware change of the motor drive (W1 to W12, B1 to B6, F1 to F5) is in today's files. The sentence "not made" in `design/ecad/motor-drive/reply.txt` line 9 is history. | `design/wiring/w7-facts.md` question 7, with the line of each change. | 2026-11-12 23:54 |
| 69 | The ring turns itself off at an average cell voltage of 3.30 V. The power chip's own power-fail reset stays at its default, 2.7 V. No 3.1 V cut-off exists; that sentence in `design/architecture.md` line 78 is removed in package W13. | `design/firmware.md` lines 117 and 997; nPM1304 datasheet page 109 (VSYSPOF: default 2.7 V, settable 2.5 to 3.4 V). | 2026-11-12 23:54 |
| 65 | The charger is set to 15 mA and ends at 4.35 V. Both are settings the power chip offers. The cell is our own custom part: its specification requires that every size accepts this charge (package W11 writes it into `design/mfg/specs/cell.md` as a requirement, not as a question). | nPM1304 datasheet text line 1427 ("between 4 mA and 100 mA in 0.5 mA steps") and the termination option 4V35 (page 36); `design/mfg/specs/cell.md` lines 40 and 41. | 2026-11-12 23:54 |
| 41 | The motor is fed from the cell through the regulator U11, outside the power chip's 100 mA battery limit. Fixed values: motor start below 175 mA, running below 80 mA at 3.0 V; U11 limits at 560 mA or more. Requirements written into the cell specification (W11): a 230 mA pulse of 100 ms leaves at least 3.0 V at the cell at 20 percent charge, and the protection circuit trips between 0.5 A and 1.0 A. Only a built unit shows the real voltage dip: the build guide (W9) gets the measurement, pass at 3.0 V or more during a motor start. | Jinlong W0525AB001D specification page 6 (items 3-1-4, 3-1-5); TLV755P datasheet page 5; nPM1304 datasheet page 29 (IBATLIM); `design/wiring/w7-facts.md` question 6. | 2026-11-12 23:54 |
| 22, 33 | The four charging pads on the inside of the band carry no voltage on the finger. VBUS is an input of the power chip and nothing on the ring drives it. D+ and D- belong to the main chip's USB block, which the ring software turns on only while VBUS is valid (W8 checks this rule in the software). The protection part U9 sits on VBUS, D+ and D-. The cell's positive pole is on no pad. The build guide (W9) gets the measurement: 10 s after the ring leaves the case, the voltage between any two pads is under 0.1 V. Limit: Nordic's sentence on the state of D+ and D- without VBUS was not found in a document on disk; the design does not depend on it, because nothing outside drives the pads when the ring is worn. | `design/ecad/ring/netlist.csv` lines 95, 285, 289, 304 to 309; nPM1304 datasheet pages 151 and 153 (VBUS: power, input supply); `design/wiring/w7-facts.md` questions 1 and 5. | 2026-11-12 23:54 |
| 24 | The storage supply capacitor C60 changes from 4.7 uF to 2.2 uF, the value the storage part's maker recommends. The supply then carries 3.4 uF. The 5 uF figure belonged to another maker's part. | CS Semiconductor CSNP32GCR01-BOW datasheet V1.0 page 11 ("It is recommended to have 2.2uF capacitance on VCC"); `design/ecad/ring/netlist.csv` lines 349 to 352. | 2026-11-12 23:54 |
| 66, 68 | Moved to the build guide (W9), with fixed design values: the currents of the main chip, the radio and the screen are not in any maker document on disk (the screen sheet's current row is blank). The power budget keeps its figures marked as estimates, and the build guide gets the measurement of each with the tool and the limit (the screen rail's regulator limit from the nPM1304 datasheet). | `design/wiring/w7-facts.md` questions 9 and 10. | 2026-11-12 23:54 |
| 7, 11 (part), W2 | The ring's main board has 4 copper layers, every via a laser microvia (0.10 mm hole, 0.20 mm land, filled), 0.30 mm finished (0.267 mm over copper, tolerance 0.025 mm). The block stays 3.20 mm. A 6-layer board cannot be 0.30 mm (least 0.408 mm from published minimums). If routing on 4 layers leaves a connection open, the lead brings the owner the figure before any thicker board is built on: no automatic switch to 6 layers (this replaces the gate sentence of the plan's step g.8). | `design/wiring/ring-board-plan.md` sections a to c (rerun by the lead: check_escape.py RESULT PASS, least gap 0.109 mm; broken copy fails; U2 check passes); owner 2026-11-10: "MUCH THINER NEEDED". | 2026-11-13 00:39 |
| 4, W2 | Rules of the board: track 0.10 mm, gap 0.075 mm, least 0.065 / 0.065; antenna line 0.120 mm with 0.20 mm gap (50 ohm, calculated); USB pair 0.100 / 0.075 mm (91.5 ohm, calculated), lengths within 0.10 mm. | `design/wiring/ring-board-plan.md` sections c.5 and d. | 2026-11-13 00:39 |
| 2, 3, 6, 8, W2 | The antenna sits on the board's under face at the hand-end corner on the +Y edge, on its maker's land pattern. No notch in the board (neither the antenna notch nor the old joystick notch). No copper on any layer inside X -13.60 to -9.45, Y 2.90 to 6.30, drawn as a rule area. Three spare contacts of the main chip (E5, E6, E8) and their test pads TP7, TP10, TP20 go. Two parts are added at the antenna: C89 (not fitted) and LT1 (0 ohm). | `design/wiring/ring-board-plan.md` section e and a.2. | 2026-11-13 00:39 |
| radio corner (owner item) | Default taken by the lead, the owner can overrule: the body's hand-end corner on the thumb side is resin, X -14.80 to -9.30 and Y 2.05 to the skin (about 5.5 x 5.3 mm), with a floor pocket 0.20 mm deep under the antenna (the antenna is 1.20 mm high, 1.00 mm is free under the board). The antenna simulation (`design/sim/antenna/`) tests this case against the all-metal body; the decision is looked at again with its result. | `design/wiring/ring-board-plan.md` section e.6; `design/mech/antenna/antenna-study.md` section 5. | 2026-11-13 00:39 |
| 62, 63, 64, 82 (ring cell), 162 | The cell's limits are requirements of the design, written in `design/mfg/specs/cell.md`, section "Requirements on the cell": chemistry, maximum sizes, capacity per size, charge at 15 mA to 4.35 V, a 230 mA pulse with 3.0 V left, protection circuit trip points (0.5 to 1.0 A, 4.425 V, 2.5 V), tabs as the band circuit draws them, never above 45 C in assembly (the resin cures at room temperature), safety reports with the first lot. Only a built cell proves them: the build guide (W9) carries the tests. | the sources are in the table of that section. | 2026-11-13 00:42 |
| 25 | The capacitors at the microphones (C35, C36) are 1.0 nF Class 1 (C0G) parts in 0402, each next to its microphone's supply pin. The 1 uF parts C31 and C32 stay at least 2.0 mm from each microphone's edge. A 0.1 uF Class 1 part exists only in a size 2.29 mm high; 1.00 mm is free under the board. Not met on paper: the 0.1 uF value of the microphone maker's example circuit. The build guide (W9) measures the noise floor of a silent recording; the circuit simulation checks the supply ripple at the pin. | Knowles SPK0641HT4H-1 datasheet Rev A page 4 ("Capacitors near the microphone should not contain Class 2 dielectrics due to their piezoelectric effect."); Kyocera AVX C0G table (the 0.1 uF row has marks only in 1206); `design/ecad/ring/pcb/part-docs.md` section 5; `design/architecture.md` 17.2. | 2026-11-13 00:44 |
| 127, 128 | A part line carries only an order code that a saved maker document shows. L71 and L72 are the same coil as L10 (Murata 1269AS-H-2R2M=P2: 2.2 uH, 156 mohm max, 1.9 A, 2.5 x 2.0 x 1.0 mm). C71, C86 and C87 are one part (Murata GRM155R61E105KA12D, 1.0 uF 25 V, 0402). RT1 is Murata NCP15XH103F03RC. C85 and C60 take a Kyocera AVX 2.2 uF part from its table. C88 takes a code only from a table that can be read. | `design/ecad/ring/pcb/part-docs.md` sections 1, 7, 8 (documents saved as `design/datasheets/w1b_*.pdf`). | 2026-11-13 00:44 |
| W2, correction | The antenna moves 0.70 mm along the board (centre X -10.80, Y 5.25): at the first place its outer land was cut by the board's rounded corner. The copper-free zone is X -13.60 to -8.75, Y 3.10 to 6.30 (Y 3.10 replaces the 2.90 of the line above; the screen connector needs it). The resin corner of the body reaches X -8.60 (about 6.2 x 5.3 mm). The courtyards of the band lands on the board equal their keep-out (2.5 x 2.2 mm). | the board builder's test build (KiCad rules check: copper to edge 0.000 at the land; 4 courtyard overlaps); `design/wiring/ring-board-plan.md` section f.4. | 2026-11-13 01:03 |
| W2, final places | The plan's round 2 section and its table `design/wiring/ring-board-plan-work/placement-plan.csv` are the single source for places; where the two rows above differ from it, it wins: antenna at (-10.75, 5.25); copper-free zone X -13.60 to -8.70, Y 2.90 to 6.30 less the notch X -9.20 to -8.70, Y 2.90 to 3.30; resin corner of the body to X -8.55 (about 6.25 x 5.3 mm), floor pocket X -12.55 to -8.95; screen connector at (-11.65, -0.15); the 19 test pads on the screen face. Not accepted yet: 12 regulator capacitors 3 to 8 mm from their pins (round 3 of the plan brings the critical ones within 1.5 mm). | `design/wiring/ring-board-plan.md` lines 509 to 699 (read by the lead); check_placement.log RESULT PASS. | 2026-11-13 01:12 |
| W2, rule on places | Places and the copper-free zone are read from the files, never from a message: `design/wiring/ring-board-plan-work/placement-plan.csv` and the text of `design/wiring/ring-board-plan.md`. As they stand at 01:14: antenna at (-10.80, 5.25); zone X -13.60 to -8.75, Y 3.10 to 6.30 with a notch at the storage chip's corner; resin corner of the body to X -8.60, floor pocket X -12.60 to -9.00. This row replaces the coordinates of the two rows above (the lead's messages crossed with the plan author's work; both sets met the rules, one had to be picked). | `check_placement.log`: RESULT PASS. | 2026-11-13 01:14 |
| sim finding 1 (replaces the sentence of items 22, 33 on the pads) | The ring gets a discharge resistor of 330 kohm from VBUS to ground. Without it the simulation holds up to 4.5 V on the VBUS pad 10 s after the ring leaves the case (the supply capacitors keep their charge; no maker states a leak). With it: 0.021 V. The resistor draws 15 uA from the case while charging and nothing from the cell (the power chip separates VBUS once it falls to the cell voltage plus 160 mV). The earlier sentence "the pads carry no voltage on the finger" was wrong as a claim without this part. | `design/sim/circuit/sim-notes.md` finding 1 and `results/info.txt` (lines "ring7"), rerun by the lead; nPM1304 datasheet page 17 (VBUSVALIDF). | 2026-11-13 01:23 |
| sim finding 4 (item 41) | The motor regulator's output capacitor C84 changes from 10 uF to 4.7 uF: the simulation shows the cell's dip at a motor start comes from charging this capacitor and disappears at 4.7 uF (3.023 V left in place of 2.995 V). The cell requirement is restated in resistance: with its protection circuit, at most 1.9 ohm at 20 percent charge with an open-circuit voltage of 3.45 V or more, measured with a 235 mA pulse of 100 ms. Not known: whether a cell this small meets 1.9 ohm. The fallback is a soft start of the motor in the ring software (the enable line switched in steps), listed for software step 6. | `design/sim/circuit/sim-notes.md` finding 4 and `results/sensitivity.txt`; TLV755P datasheet (output capacitor 1 uF or more). | 2026-11-13 01:23 |
| sim finding 2 (case risk 8) | The case's cell charger does not charge until its software has set it. Its enable input CE is pulled high at power-on (the resistor R21 goes to the charger's own REGN supply), and the case software pulls it low only after it has written the charge current (140 mA, never above 350 mA), the end voltage (4.192 V) and has turned off the charger's watchdog (which would otherwise restore the defaults after 40 s). The charger's power-on defaults are 2.048 A and 4.208 V; the cell allows 350 mA and 4.2 V. | `design/sim/circuit/sim-notes.md` finding 2 (BQ25895 datasheet pages 32, 36, 38; cell sheet page 1). | 2026-11-13 01:23 |
| sim finding 3 (case risk 6) | The case's status light takes its supply from the charger's system output SYS (3.5 V or more), not from 3.3 V, with resistors that give 2 to 5 mA in each colour over SYS 3.5 to 4.35 V. At 3.3 V the green and blue colours get 1.4 to 2.0 mA. | `design/sim/circuit/sim-notes.md` finding 3. | 2026-11-13 01:23 |
| screen supply capacitors (board plan round 3) | Of the five 0603 capacitors of the screen supply chip, C24 stays 0603 at its pin; C21 and C27 become 0402 where that brings them within 1.5 mm of their pins; C25 and C26 become 0402 only if the placement cannot pass otherwise. This is a stated deviation from the chip maker's parts table (16 V 0603 parts): under its working voltage a 0402 part keeps about 2.4 to 3.05 uF of 4.7 uF and about 2.7 uF of 10 uF. The chip's sheet gives no minimum capacitance. The ripple on these rails is measured on a built unit (build guide). | `design/ecad/ring/pcb/u4-capacitors.md` (SGM38046 sheet pages 2, 4, 5, 6; Murata sheets saved as `design/datasheets/w1d_*.pdf`, bias graphs on their page 2); `design/wiring/ring-board-plan.md` round 3. | 2026-11-13 02:07 |
| sim finding 4, correction | C84 is Murata GRM155R61A475MEAAD (4.7 uF, 10 V, 0402). The document the lead first named for the older code is a web page, not a sheet. | `design/ecad/ring/pcb/u4-capacitors.md`. | 2026-11-13 02:07 |
| sim findings 2 and 3, as built into the case circuit | Charger enable: R21 pulls the enable line to 3.3 V (not to the charger's REGN pin: its sheet names REGN only as a bias rail, and it would put the module pin above its 3.6 V limit). The case software writes 128 mA (the chip sets the current in 64 mA steps; never above 320 mA), 4.192 V and watchdog off, reads the registers back, then enables. Status light: anode on SYS, R8 510 ohm, R9 and R10 270 ohm (3.0 to 4.6 mA red, 2.2 to 4.7 mA green and blue over 3.5 to 4.35 V). The case software drives the three light pins high at start-up. | `design/ecad/case/sch-notes.md` section 9 (BQ25895 datasheet pages 5, 15, 36, 38, 39; ESP32-S3-MINI-1 sheet page 27; LED sheet page 3). | 2026-11-13 03:15 |
| band edge wall (model fit, conflict 1) | The band's two edge walls are 0.50 mm thick (before: 0.60), so the channel and the liner are 7.0 mm wide (before: 6.8). Reason: the band circuit as drawn is 1.8 mm wide with its edge at X -3.4, which touched the 6.8 mm channel wall (0.0000 mm); a flat circuit outline has a tolerance of 0.10 mm. The other way out, moving the circuit 0.1 mm, would move the 16 lands on the main board, which is being routed. The 0.50 mm wall equals the outside shell already in the design; the band stays 8.0 mm wide outside. The body and liner files, drawings and specs follow in the model work (W11). | `design/mech/thin/band-fit-notes.md` sections d and "Conflicts for the lead". | 2026-11-13 03:24 |
| motor offset per size (model fit, conflict 2) | The vibration motor stands 0.8 mm off the band's centre line at US 7 and US 12 and 0.7 mm at the other five sizes. At US 7 it keeps 0.0926 mm between the band circuit and the motor (0.0246 at 0.7); at US 12 it keeps 0.3727 mm of metal between the motor pocket and the floor slot (0.2977 at 0.7, rule 0.30). The body pocket, the US 7 window and the motor lead lengths of these two sizes follow. | `design/mech/thin/band-fit-notes.md` section d rows 3 and 4. | 2026-11-13 03:24 |
| floor slot width (model fit) | The two floor slots are 2.1 x 0.6 mm, X -3.55 to -1.45 (before: 2.0, X -3.5 to -1.5), which keeps 0.15 mm at each end of the 1.8 mm circuit neck. | `design/mech/thin/band-fit-notes.md` section d row 1. | 2026-11-13 03:24 |
| item 36 (liner with the two circuits inside) | No repair after the cast: a ring with a damaged liner is scrapped (as `design/mfg/assembly/assembly.md` line 253 already says). The liner keeps 0.3 mm with 0.075 mm of resin on each side of a circuit. Before the first ring, the builder casts one test strip (60 mm of the circuit stack in a 0.3 mm skin), cuts it and reads the resin on each face with a 10x loupe: at least 0.075 mm on each side and no void over copper. The resin's maker and code follow from the material search. | `design/wiring/w11-item-values.md` item 36. | 2026-11-13 03:56 |
| item 45 (motor window seal, US 7 to 9) | The motor window seal SEAL2 and the two floor slot seals use the adhesive that already bonds the joystick frame: 3M Scotch-Weld DP420 Black, mixed 2:1 by volume, put in with a 0.5 mm needle before the cast (0.80 cubic mm per window). One adhesive less to buy; the motor is glued rigid in its pocket anyway. Check on the first printed body: cut through the window and see the fill reach the motor's back face with no void over 0.1 mm. The order code follows from the material search. | `design/wiring/w11-item-values.md` item 45; 3M sheet page 1. | 2026-11-13 03:56 |
| item 53, part S25 | S25 is closed: it checked the path of the recording light, which version v7 removed (`design/architecture.md` line 523). Line 698 and `design/mech/light-path/light-path.md` line 117 still read open and are corrected in the text pass. Part S24 (the screen's metal over the antenna) stays open: the antenna simulation gets a case with that metal, and the cable study looks at turning the screen. | `design/wiring/w11-item-values.md` item 53. | 2026-11-13 03:56 |
| item 78 (does a finger cover the microphone openings) | Closed as a measurement in the build guide: a ring on a rod of the finger's diameter, a loudspeaker at 1 m, level with the openings free, then with a finger pad and a thumb pad on them. Pass: the level falls by at most 3 dB (the noise budget of `design/mech/mic-path/mic-path.md` line 203). Above 3 dB the result goes to the owner: the openings have no better place on this ring. | `design/wiring/w11-item-values.md` item 78. | 2026-11-13 03:56 |
| items 96, 97, 98 (body values) | The body's values are the model's values: the per-size table of `design/mfg/specs/body.md` lines 123 to 134 and the per-size files of `design/mfg/parts/index.csv`. The screen pocket clearance is 0.05 mm per side as modelled (the 0.15 mm of architecture 16.1 is superseded). The board stays 0.30 mm: it is the 4-layer microvia board of `design/wiring/ring-board-plan.md` section c.2, not a standard 0.4 mm board. The wrong pointers ("open point 5", line 113) are corrected in the text pass. Check: the model helper reads each maker file back against the model; the builder measures the first body with calipers and a depth gauge. Foam and clear adhesive of the screen stack follow from the material search. | `design/wiring/w11-item-values.md` items 96 to 98. | 2026-11-13 03:56 |
| item 99 (body material and process) | Fixed: titanium Ti-6Al-4V grade 5, bar to ASTM B348, machined from bar in one piece, general tolerance ISO 2768-m. The builder asks for the bar certificate and checks it: tensile strength at least 895 MPa, 0.2 percent proof at least 828 MPa, elongation at least 10 percent. The coating follows from the material search. | `design/wiring/w11-item-values.md` item 99; `design/datasheets/w11v_smith-ti-6al-4v-grade5-datasheet.pdf`. | 2026-11-13 03:56 |
| item 100 (joystick centre press) | The centre press is ONE switch, SW2, under the cap's centre (`design/bom.csv` line 39, `design/mfg/specs/joystick-nub.md` line 8, architecture 17.11). `design/architecture.md` line 398 ("two opposite switches") is older text and is marked superseded in the text pass. Build guide measurement: force at the click 1.1 to 2.1 N and travel 0.06 to 0.16 mm at the cap's centre (Alps sheet page 2); never press above 2.1 N. | `design/wiring/w11-item-values.md` item 100. | 2026-11-13 03:56 |
| item 101 (water at the joystick opening) | Version 1 claims no water or dust rating (`design/mfg/assembly/assembly.md` line 347). The switches' own rating and the dam stay as they are. The build guide holds one optional test (1 m of water for 30 minutes, then open and look): its result is recorded, it is not a pass line. A rating is the owner's choice. | `design/wiring/w11-item-values.md` item 101. | 2026-11-13 03:56 |
| item 106 (adhesive on the black coating) | Fixed process: the bond faces are abraded and cleaned with isopropyl alcohol before bonding (3M sheet, surface preparation E). Build guide measurement: 5 lap-shear strips of coated Ti-6Al-4V from the same coating batch, bonded and pulled; pass: the break is inside the adhesive, not at the coating. A break at the coating means the bond faces are masked before coating. | `design/wiring/w11-item-values.md` item 106. | 2026-11-13 03:56 |
| case boards round 2, open points | (1) The 16 test pads stay on the bottom face of the case's main board: they are bare copper with no body, and the factory test reaches them before the board goes into the case. (2) The copper pour check "minimum connection width" stays off for the main board: the one 0.031 mm neck it flags is at a ground via that is also joined to the inner ground plane. (3) The status light's three pins: the case software drives a pin high (3.3 V) to turn a colour off and never leaves it floating while the case is on; the circuit simulation gets a test of the pin's voltage in both states and during reset (limit 3.6 V). (4) The main board is 23.0 x 37.9 mm; the case model follows (board box, module box, socket tab, a holding feature for the board) with its fit check rerun. (5) The wire for the 7 hand-soldered leads gets a maker code in the material search. | `design/ecad/case/pcb/board-notes.md` section "Round 2". | 2026-11-13 04:06 |
| motor soft start (correction of "sim finding 4") | The software soft start of the motor is NOT a ready fallback and is not built in software step 6. The MOTOR pin drives the enable pin of the motor's regulator U11, and the dip found by the simulation comes from charging that regulator's output capacitor; switching the enable line in steps would charge it several times. The circuit simulation tests a stepped enable before any such rule is written. The fixed measures stay: C84 at 4.7 uF and the cell requirement of 1.9 ohm at 3.45 V with a 235 mA pulse. If a bought cell does not meet 1.9 ohm, the fallback is decided from that simulation and a bench measurement, not assumed. | `firmware/docs/step6-plan.md` decision D3; `design/firmware.md` line 314; `design/sim/circuit/sim-notes.md`. | 2026-11-13 04:09 |
| item 73 (microphone membrane) | No catalogue vent of 0.10 mm or less with adhesive exists in any maker document found (the thinnest Gore parts are 0.18 to 0.26 mm). Fixed design: the membrane is a disc of woven acoustic mesh, Saati Acoustex 010a (52 um thick, pores 78 um), 2.0 mm across, bonded with a ring of tesa 61305 film (50 um; 2.0 mm outside, 1.0 mm bore). Stack 0.102 mm in the 0.10 mm seat. It keeps dust and splashes out; it is not an immersion seal, and version 1 claims no water rating. The builder cuts both with punches of 2.0 and 1.0 mm. Measurement: sound loss through bore, gasket and mesh on the first ring (bench B7). | `design/wiring/w12-material-sources.md` row 1; `design/datasheets/w12_saati-acoustex-range6.pdf` page 2; `w12_tesa-61305.pdf`. | 2026-11-13 04:15 |
| item 77 (0.20 mm metal under the membrane seat) | The 0.20 mm of titanium between the seat and the microphone pocket stays (ring from 1.0 to 2.0 mm). It is a stated local exception to the 0.30 mm floor rule. Measurement on the first body: thickness through the pocket at 4 points with a micrometer, pass 0.17 to 0.23 mm; a body outside that is scrapped. | `design/mech/mic-path/mic-path.md` line 79. | 2026-11-13 04:15 |
| item 74 (microphone gasket) | Start parts, one maker family: Nitto SCF AN010 (0.10 mm), SCF400T (0.2 mm), SCF400 (0.3 mm), cut to a ring of 1.80 mm outside and 1.00 mm bore, with no adhesive: the microphone's lid holds the ring against the pocket floor. The builder measures the gap after soldering and takes 0.10 mm for a gap under 0.07, 0.2 mm for 0.07 to 0.14, 0.3 mm above. NOT settled by a document: Nitto's sheets with the compression values could not be downloaded, so the three thicknesses stay start values; bench B7 measures the leak. | `design/wiring/w12-material-sources.md` row 2; `design/datasheets/w12_nitto-scf-sea-page.html` lines 712 and 728. | 2026-11-13 04:15 |
| item 110 (glass seal SEAL1) | SEAL1 is a ring of tesa 61305 double-sided film, 50 um (bond to glass 12.4 N/cm). Its sheet states no value for coated titanium and none for water. Measurement on the first body: bond check after 24 hours, then a water spray test; version 1 claims no water rating. | `design/wiring/w12-material-sources.md` row 3; `design/datasheets/w12_tesa-61305.pdf`. | 2026-11-13 04:15 |
| item 96, rest (screen stack) | Clear adhesive ADH1: tesa 69404, optically clear, 100 um (haze under 0.5 percent). Foam pad FOAM1: Nitto SCF AN010, 0.10 mm, no adhesive, held by the screen's pressure. Both can change with the screen cable study, which looks at the room between screen and board. | `design/wiring/w12-material-sources.md` row 4; `design/datasheets/w12_tesa-69404.pdf`. | 2026-11-13 04:15 |
| item 105 (coating thickness) | The gloss black coating is Oerlikon Balzers BALINIT DLC: black, 1 to 3 um thick, applied under 250 degrees C. It adds at most 0.003 mm per face, which the 0.10 mm bond gap of the joystick frame takes. Its brochure lists titanium alloys as coatable but the table does not show for which coating: colour, gloss and adhesion are checked on the first coated body (already in `design/mfg/specs/body.md` line 92). | `design/wiring/w12-material-sources.md` row 7; `design/datasheets/w12_oerlikon-hq040-coated-components.pdf`, `w12_oerlikon-hq161-food-processing.pdf`. | 2026-11-13 04:15 |
| items 107, 108, 109 (cover glass, weight) | Cover glass material: AGC Dragontrail Pro, chemically strengthened (surface stress 1000 MPa, depth 40 um), density 2.46: the glass weighs 0.82 g (332.87 cubic mm). Its sheet gives no thickness range and no forming limit: whether a maker can form the 30.7 mm arc at 1.10 mm is shown only by the first formed sample (thickness at 5 points with a micrometer, radius with a gauge). The ring's weight is measured on the first unit, part by part, on a 0.01 g balance; the estimate takes the glass, foam and resin densities from the saved sheets. | `design/wiring/w12-material-sources.md` row 6; `design/datasheets/w12_agc-dragontrail-pro-catalog.pdf`. | 2026-11-13 04:15 |
| liner resin (item 36, material) | The liner resin is Master Bond EP30Med: two parts, low viscosity, cures at room temperature, stated to meet ISO 10993-5 and USP Class VI (the maker's guide, page 12). Its viscosity and cure time are only in a sheet that could not be downloaded: the test strip of item 36 shows whether it fills 0.075 mm, and the cell's temperature is measured during the first cure (limit 45 degrees C). ISO 10993-5 is a cell-toxicity test, not a skin-wear test: no skin claim is made for version 1. | `design/wiring/w12-material-sources.md` row 8; `design/datasheets/w12_masterbond-medical-device-applications.pdf`. | 2026-11-13 04:15 |
| adhesive code, switch code, screw (items 45, 100, 103) | 3M Scotch-Weld DP420 Black is ordered by its name and the 50 ml cartridge size, as its sheet prints them; no 3M number is in a saved document. The switch code SKTAAAE010 is printed in the saved Alps Alpine catalogue (page 1). The M1.2 screw is no longer in the design (not in the model, not in the parts list): that part of item 103 is closed. | `design/wiring/w12-material-sources.md` rows 5, 9, 10. | 2026-11-13 04:15 |
| item 85 (pin holder wall) | Partly closed: a Celanese paper states walls down to 0.3 mm for its Vectra MT family, so 0.79 mm is above the smallest stated wall. Still open: the exact grade and how a first builder makes the holder without a mould; the case model work settles it. | `design/wiring/w12-material-sources.md` row 10. | 2026-11-13 04:15 |
| case items 80, 81, 82, 88 | Closed by the routed case boards: the charger's thermal pad is pad 25, the socket's shell tabs carry the name SH, the storage chip's lands are numbered 1 to 8 from the maker's figure, the cell is ordered with flying leads (red +, black -) cut to 40 mm; the status light runs from the charger's system output with 510 and 270 ohm resistors. | `design/ecad/case/pcb/board-notes.md` lines 56 to 61 and section "Round 2"; row "sim finding 3". | 2026-11-13 04:27 |
| case items 26, 89, 91, 92 | (26) The protection part on the ring supply line works up to 5.5 V, which equals the highest voltage a USB-C source may give; the charger's data pins stay open so no source can raise the voltage. The builder measures the ring supply line with the charger in use: at most 5.5 V. (89) The 0.85 efficiency of the step-up stage is a start value: the builder counts how many full ring charges one case charge gives. (91) The case shell and lid are not metal and get no conductive coating; the builder reads the Wi-Fi signal strength with the lid closed. (92) The ring's USB link through the 4 spring pins is tested on the first case: the ring is listed by the case's chip and 100 MB are copied without an error. | `design/ecad/case/sch-notes.md` lines 13 and 78 to 81; `design/case/case-architecture.md` line 232. | 2026-11-13 04:27 |
| resin radio corner RC1, how it is made | RC1 is cast on its own in the liner's resin (Master Bond EP30Med) and bonded to the body before the board goes in (assembly step 10). It is not poured with the liner: the two cavities are 5.10 mm apart with metal between, and RC1 forms part of the board cavity's walls and of the glass seat, so it must exist before the board and the glass are fitted. Bond plane at X -8.60. | `design/mech/thin/model-v9-notes.md` section h. | 2026-11-13 04:28 |
| ring board round 2, test pads and crystal | Four test pads with no function are dropped: SPARE_P2_03 (TP13), SPARE_P3_05 (TP16), JOY_CENTER (TP22) and DBG_RX (TP2); their balls stay unconnected. The debug log is send-only (DBG_TX) and the programming pads stay. The 32.768 kHz crystal X2 goes beside the main chip's balls B6 and B7. The behaviour specification follows (lines 77, 81 and 1061). | `design/ecad/ring/pcb/board-notes.md` section f; `design/firmware.md`. | 2026-11-13 05:26 |
| owner decisions of 13 November (one card) | The owner's words: block height "4.17 mm, stock screen with connector (Recommended)"; antenna "Keep the resin corner (Recommended)"; hours "Accept 4 to 8 hours for the thin ring (Recommended)"; water "Splash and sweat resistant as a goal"; 12 g "A target, measured on the first ring (Recommended)"; "Keep the Agent mode (Recommended)"; phone app "After the ring software is finished (Recommended)". The requirement rows S1, S5, S6, P1 and P2 state the decided values. | `requirements.md` section "Changes after sign-off: owner decisions of 2026-11-13". | 2026-11-13 06:56 |
| water: goal and spray test (replaces the optional immersion test of item 101) | Version 1 is built to be splash and sweat resistant as a goal; no rating is claimed on the product or in any document. The build guide holds ONE water test, and it is a pass line (lead's definition; a workshop test, not a standard's test): the finished ring records; a hand trigger spray bottle of tap water is held 30 cm away; 10 pumps from each of 6 directions (top, bottom, both sides, both ends), the joystick and the microphone slots included; the ring is wiped and left 60 minutes. Pass: the recording never stopped and plays back; the screen shows no water under the glass; the joystick's five directions work; the ring charges in the case; each microphone's level in the factory microphone test is within 3 dB of its level before the spray. A fail is recorded with the place the water entered. The 1 m immersion of item 101 is no longer in the build guide. | Owner 2026-11-13; rows "item 101", "item 110". | 2026-11-13 06:56 |
| block height 4.17 mm: what follows | Layout C of the screen cable study is the design: stock screen turned 180 degrees, its cable bent back under the panel, connector J1 on the board's screen face at (-4.933, -0.003), block 4.17 mm. Work that follows, in order: exterior at 4.17 mm for the 7 sizes; inside model v10; cover glass print window; case fit; assembly order; the software turns the picture 180 degrees; explorer refresh; pictures for the owner. Until each is done its files describe the 3.20 mm block. | `design/wiring/screen-cable-study.md` section 4.3; `plan-417-rework.json` items on the work list. | 2026-11-13 06:56 |
| review 1, the 12 must-ask findings and 22 contradictions: state and corrections | State table: 19 answered, 11 still contradicted, 1 open, 3 no longer apply (read 06:58 to 07:12). Corrected now: architecture.md lines 221, 432, 491, 492, 495, 496, 508, 535, 536 carry REPLACED with the current value and its file (motor tail and angle, joystick angle and switch cross, pads, cell, protection circuit, transfer time); firmware.md line 1132 names case version C5d and row H12 is closed (RT1 on the cell's protection circuit); requirements.md row U3 no longer names a recessed button. Board thickness (K14): 0.30 mm as routed; the STEP file's 0.28 mm is the board without solder mask and is made again from the routed board. Still to correct: K20 in the case file (3.18 must read 3.21 minutes per recorded hour, from 234.0 MB per hour of firmware.md line 718; the case helper's file); F16, the travel of the case's spring pin (a maker document is being fetched). | `design/review/must-ask-state.md`. | 2026-11-13 07:12 |
| antenna simulation, final result and what follows | Simulated, not proven; the simulated antenna is a stand-in that failed its own validation, so the numbers rank mounts and do not predict range. No mount reaches the pass line set before the runs (6 dB return loss after a three-part match and 10 percent radiated). Radiated share of accepted power at 2.48 GHz on the finger: metal body with pocket 14.4 percent but it cannot be matched (1.09 dB); antenna on the board's screen face under the glass 8.0 percent and matchable; resin corner with the antenna under the board (today's design) 3.2 percent and matchable; without a finger the resin corner gives 11.7 percent, so the finger is the loss. The screen's metal at the hand end changes nothing measurable (+0.3 points), turning the screen 180 degrees changes nothing (0.0). What follows: the resin corner stays (owner 13 Nov); inside model v10 studies the antenna on the board's screen face (the taller block gives the 0.20 mm it needs, and the screen connector has left that end); the simulation is run again on the v10 geometry; the build guide keeps the bench tests T0 to T2 and adds T3 (screen-face mount), which alone settle the range. | `design/sim/antenna/antenna-sim.md` section 26. | 2026-11-13 07:48 |
| case wires W1 to W4 and W7: colour | Fixed by the lead so that a builder cannot swap them: W1 (VRING) red, W2 (USB_D-) white, W3 (USB_D+) green, W4 (GND) black, W7 (RING_TOUCH) yellow. All five are 30 AWG stranded hook-up wire (conductor 0.25 mm), cut to the lengths of the wiring table (15.6, 16.3, 16.3, 15.6, 15.9 mm); W2 and W3 are twisted together. The colours follow the usual USB cable colours for supply, data and ground; the touch line is the one colour not used by them. | `design/ecad/case/pcb/board-notes.md` section "Wiring table (replaces part f)"; `design/wiring/product-wiring.csv` lines for joint C5. | 2026-11-13 08:21 |
| ring board round 2 result and round 3 | Round 2 ended at 9 unconnected items and 5 violations on 4 layers, 0.30 mm (round 1: 22 and 13): not closed, no fabrication files. Round 3 is a new placement on BOTH faces of the board, made possible by the taller block (parts up to the connector's height may stand on the screen face): the main chip's decoupling parts go opposite the chip on the screen face, the level shifter U10 goes beside the chip's storage balls, the connector J1 goes to the screen face at (-4.933, -0.003), and the antenna's place on the screen face is studied with the inside model v10. The board stays 4 layers, 0.30 mm. The crystal X2 stays at (6.00, 4.25). The plan's rule of 0.50 mm free of other copper beside the antenna line is a target that the first antenna bench measurement checks, not a pass line of the layout; the layout rule is: ground on L2 under the line and no other net under it. | `design/ecad/ring/pcb/board-notes-r2.md`. | 2026-11-13 08:21 |
| case cell BT1 leads (wiring lines for joints C1, C2) | The maker's sheet states flying leads and shows one red and one black lead; it states no gauge, no insulation, no polarity by colour and no solder limit (the 100 in its table is read as the lead length, not stated in words). Fixed for the builder: the leads are used as the maker delivers them, never replaced. Before cutting, the builder measures the cell with a multimeter, red probe on the red lead: the reading must be positive, between 3.0 and 4.35 V; a negative reading means the colours are reversed on that cell, and the cell is set aside. Then: red lead to pad W5 cut to 13.0 mm, black lead to pad W6 cut to 15.2 mm (wiring table), 2 mm stripped. The gauge is recorded from the first delivered cell (measured over the insulation with a caliper and written in the build record); it does not change the pads. | `design/case/lead-specs.md` (maker documents saved as w16_*); `design/ecad/case/pcb/board-notes.md` wiring table. | 2026-11-13 08:28 |
| case thermistor TH1 leads (joint C3) and bead size | Maker's sheet (Semitec AT series, 103AT-2, shape 2): two bare leads of 0.5 mm tin plated 42 alloy at 2.54 mm pitch; no insulation, no colour, no polarity (a thermistor has none). Bead at most 2.4 mm high and 4.0 mm long: the parts list's "1.6 dia start value" is replaced by these. Soldering, from the maker: at least 5 mm from the bead, at most 7 seconds at 340 degrees C with a 50 W iron. Fixed for the builder: leads cut to 10 mm from the bead, soldered into the two plated holes TH1.1 and TH1.2 (either way round), the joint 5 mm or more from the bead; the two bare leads stay 2.54 mm apart over their whole length and touch nothing else (checked by eye and with a continuity test to the cell's can: open). | `design/case/lead-specs.md`; `design/datasheets/w16_*` (private). | 2026-11-13 08:28 |
| cover glass top on the taller block (owner) | Owner, card of 2026-11-13: "Flat glass, 4.15 mm (Recommended)". The block's top is flat: 4.145 mm above the block's underside over the whole face (measured on the US 9 option build), glass 0.4255 mm thick everywhere, seat at 3.72; the rounded long edges (1.0) and ends (1.2) stay. This replaces the crowned top (4.82 mm at the centre line). To build: the flat variant for the 7 sizes, the cover glass drawing and its specification (thickness, print window), a drop test of the thin glass on the first ring as a pass line of the build guide. | `design/look/s1/merged417-notes.md` (option merged417flat); pictures `design/look/s1/out/work-417/option-us9-*-417-vs-flat.png`. | 2026-11-13 11:33 |
| USB vendor and product id (owner) | Owner, card of 2026-11-13: "Keep the test pair for now (Recommended)". The ring software keeps the development kit's test pair, marked NOT FOR SHIPPING in the software and in the build guide; the owner decides before the first ring leaves the desk. | `firmware/docs/recorder-notes.md` section 7; `firmware/docs/xfer-notes.md` section 6. | 2026-11-13 11:33 |
| board read-back test: the lead's rulings on its four open points | (1) Parts that are not on a board (the cell BT1, the screen DISP1, the thermistor RT1) and the switches' terminals 1 and 2, which the band document leaves unsoldered, are known off-board items, not missing pads: by connections the 17 boards read 17 of 17 (0 shorts, 0 opens); the test's frozen strict count of 8 of 17 stays written in its file. (2) The USB pair's design gap is the plan's 0.075 mm at 0.100 mm width, constant along the pair, with ground under it. (3) Under the antenna line: ground on the next layer everywhere outside the antenna's copper-free zone; inside that zone no copper at all. (4) Case boards: ordered with 35 um outer copper (1 oz) and 17.5 um inner copper where a board has inner layers; this is written into the case board notes at the next change of those files. | `design/wiring/board-readback.md` section 5. | 2026-11-13 11:53 |
| ring board controlled lines, USB pair (replaces ruling 2 of row 'board read-back test') | The USB pair is accepted as routed: 0.100 mm tracks at a 0.075 mm gap on its coupled run, with three fan-outs (at the chip balls, at the protection part U9 and at the J_BAND_B lands) where no constant gap is possible, a 0.085 mm gap to U9's pads, and ground under only part of the pair. Basis: the product's link partner, the case, is a full-speed host only, and the band tail is not impedance controlled. U9 is not moved. High speed on a computer through the case is a bench measurement and is not claimed. | `design/firmware.md` line 670; `design/case/case-architecture.md` line 72; `design/wiring/ring-board-plan.md` line 494; `design/ecad/ring-lines/notes.md`. | 2026-11-13 12:51 |
| ring board controlled lines, 32.768 kHz crystal lines XL1 and XL2 | The 0.20 mm clearance holds outside the main chip's ball field and is waived inside it (adjacent balls B6 and B7 with vias in their pads leave about 0.09 mm). XL1's length of 9.343 mm is accepted: 9.0 mm was the plan's routing figure, not a maker's limit. The factory test T-XTAL measures the crystal. The escape group round ball B8 is not re-planned. The 32 MHz lines XC1 and XC2 and the antenna line meet their limits. | `design/ecad/ring-lines/notes.md`; `design/wiring/ring-board-plan.md` line 312; `design/firmware.md` section 9.3 (T-XTAL). | 2026-11-13 12:51 |
| two circuit changes found unapplied (sim findings 1 and 4) | The 330 kohm discharge resistor from VBUS to ground is part R73 (Yageo RC0201FR-07330KL, code by the series' coding, not confirmed at a distributor) and C84 is 4.7 uF (GRM155R61A475MEAAD). Until this row neither was in the ring's netlist, parts file, schematic, parts list or board. Both are being applied: the circuit files by helper ring-circuit, the board by helper ring-lines (items E3, E4). | rows 'sim finding 1' and 'sim finding 4, correction' of this file; `design/ecad/ring/netlist.csv` (net VBUS before the change). | 2026-11-13 12:51 |
| software step 6, event log code for a failed unmount | New code 0x0290 `RREC_LOG_UNMOUNT_FAILED` (errno, state, try); the list of ruling R23 has 27 codes. The M2 pattern length is the constant `RREC_PAT_M2_MS` 280. | `design/firmware.md` section 'Event log codes'; `firmware/docs/step6-review.md` findings R6-01, R6-03. | 2026-11-13 12:51 |
| power chip capacitors against Nordic's datasheet (differences D2 to D7 of `design/ecad/ring/npm1304-reference.md`; D1 was done) | D2 VBAT: no change; C85 2.2 uF sits 2.13 mm from the chip, the reference's value; its 10 V rating is read from the part code only, the maker's sheet is still to be saved. D3 VSYS: no change; three 10 uF are fitted (C74, C75, C88; the reference's 'add a third' was stale). Their ratings (6.3 V, 6.3 V, 10 V) are under the reference's 16 V but above the node's highest voltage: the chip cuts VBUS off above 5.5 V (datasheet lines 825 to 828). The datasheet states no minimum for this node; the bench measures the ripple on VSYS. D4 load switch outputs: no change; VDD_MIC and VDD_SD run in load switch mode (configuration 2: 1.0 uF on the output), C86 and C87 are that capacitor; the two 10 uF per output belong to regulator mode, which the ring does not use. D5: met (no GPIO4 on this package). D6 buck ground balls: each of A7 and E7 gets its own via to the ground layer if it has none (board item E6). D7 size and DC bias: ONE CHANGE. The datasheet asks for at least 4 uF effective at each buck output (Table 18, lines 3172 to 3174). The 1.8 V rail has C78 and C4 (about 6.5 uF each at 1.8 V by the maker's graph). The 3.0 V rail has only C79, about 4 uF at 3.0 V on the same graph, with a +-20 percent part: no margin. A second 10 uF, C90 (GRM155R60J106ME15D, 0402), is added from VDD_3V0 to ground beside C79. | `design/ecad/ring/pmic-caps-facts.md` (every quote checked by its script; the lead read the Murata graph and Table 18 again); `design/datasheets/npm1304_datasheet_v1_0.txt`; `design/datasheets/w1d_murata_grm155r60j106me15.pdf` page 2. | 2026-11-13 13:07 |
| ring board, 32.768 kHz crystal lines beyond the chip (adds to the row on XL1 and XL2) | After one bounded try on the board copy: PMIC_SDA and OLED_PWR_EN no longer run under 0.20 mm beside the crystal lines; LCD_SCK's via stays at 0.1705 mm from XL2 and U1_VBUS at 0.0908 mm from XL1 (neither via can move). Beyond 1.0 mm from the chip, 0.694 mm of XL1 and 0.406 mm of XL2 stay under 0.20 mm. Accepted, with two measures: (1) the factory crystal test T-XTAL is run while the screen is being refreshed, so a disturbance by the screen clock shows; (2) the ring software starts on the chip's internal slow clock when the crystal does not start or fails that test, and logs it. Both go into the behaviour specification with software step 7. | `design/ecad/ring-lines/notes.md` (logs/linestretch-far2-t07.log); `design/firmware.md` section 9.3 (T-XTAL). | 2026-11-13 13:33 |
| ribbon-to-board joint: how the two band ribbons are assembled (owner's decision) | Owner, on a card that gave the cost of each option: "A: side slits (Recommended)". Each of the two floor slots is opened through the block's long side wall, so the ribbon's neck slides in sideways. The joint of the 15 lands is made on the bench BEFORE the ribbons go into the body: board parts face up on the fixture, foot on top, hot bar from above. Only the metal body changes; the ribbons, the board outline and the land places stay. The slits are filled flush with the black slot sealant of assembly step 19. Consequences: the body model and the exterior get the two slits (pictures to the owner before the body files change); assembly step 16 moves before step 14 and the screen step after it; the 15 board lands get solder paste openings in the parts face stencil; the water sealing table gains the two slit seams. Options B, C and D of the study are not built. | `design/mfg/assembly/hotbar-joint.md` sections 2.4, 2.5, 3 and 4 (foot 2.500 mm against slot 2.100 mm at 14 of 14 ribbons; free length 0). | 2026-11-13 13:43 |
| soldering process of the whole product (confirms the choices of `design/mfg/assembly/process.md`) | One alloy, SAC305. Paste Kester NP505-HR Type 4, no-clean; wire Kester 275 SAC305 (0.25 mm for the ring cell tabs, 0.4 and 0.5 mm elsewhere); liquid flux Kester 959T only for the hot-bar joint and touch-up. Residues stay on every board: the microphone maker forbids washing, so assembly step 4 becomes inspection only. Stencils: 0.075 mm stainless on the ring's parts face, 0.10 mm on its screen face and on the case boards, 0.08 mm on the ribbons. Reflow profile: peak 240 C (235 to 245), 60 to 75 s above 217 C; the ring board is never reflowed a third time (the screen connector allows 2 cycles). The four spring pins are reflowed in paste, not soldered by iron. Case wires and cell leads: 340 C, 50 W iron, at most 7 s. The gold contact discs are soldered on a hot plate through a stencil and stand 0.070 to 0.112 mm above the land; the flush check moves to the liner step. Three fiducials per paste face on the panel rails. A reflowed joint is accepted by the visible criteria the guide writes out (the lead's wording, after the common workmanship practice for class 2 electronics); no paid standard is cited. Open: the main chip's own reflow limit (the maker's page refused the download) and the paste's metal share by volume. | `design/mfg/assembly/process.md` P1 to P8 and its list for the lead; 13 maker documents saved as `design/datasheets/proc_*`. | 2026-11-13 13:45 |
| side slits of the block: their look (owner's pick) | Owner, on a card with the three variants drawn at US 9 (picture `design/look/s1/out/work-flat/slit/smooth/compare-three_quarter.png`): "2: three windows". Each long side of the block carries the ribbon slit and two equal shallow windows in a row, all filled black; only the slit goes through the metal, the two other windows are blind grooves 0.20 mm deep; the wall behind them is 0.93 mm. Earlier words of the owner on it: "we can make it a design decision with a speaker grill maybe even ?". Follows: variant 2 goes into the flat-glass exterior at the 7 sizes and into the inside model; the body's maker files change after that. | `design/look/s1/slit-grille-notes.md`. | 2026-11-13 15:52 |
| flat-glass exterior: the crease where the band meets the taller block | Six tries to replace the crease by one smooth blend failed (the modelling kernel's own blend dents the walls or fails; a blend built by offset is smooth across the band, 0.041 degrees, but cannot be joined to valid corners; exact corner sections build but every cut and join through the offset surfaces breaks). The lead stops this route: no further try with the same method. The exterior of version 1 is the flat-glass shape with the crease as measured (8.9 to 20.6 degrees by ring size) and the owner's three-window slits. The owner judges the crease on the pictures of the 7 sizes; if it must go, the junction is redesigned as a deliberate shape (a new design question), not blended again. | `design/look/s1/merged417flat-notes.md` (items on the fold, exp1 to exp7). | 2026-11-13 16:03 |
| side windows, the metal behind them and how they are measured | The two blind windows of the owner's pick "2: three windows" stay 0.20 mm deep at every ring size. The metal left behind a blind window is its own wall class with a limit of 0.70 mm at every size (thinnest found: 0.792 mm at US 7, 0.904 mm at US 8; US 9 to 13 are 0.935 mm or more). It is no longer compared with the older body's side wall class (0.925 mm), which had no window; every other wall point keeps the rule 'not thinner than the older body'. Basis: the body's thinnest machined wall is 0.5 mm (body.md line 59). The measure is corrected in two places, each with a broken copy that must still fail: the fold measure leaves out the windows' own edges and reports them apart; the window depth is read as the wall without the window minus the wall with it at the same point (0.20 within 0.02). | `design/look/s1/merged417flat-notes.md` item 3 (diagnosis of measure-w-us7.log, 16:11 to 16:18); `design/mfg/specs/body.md` line 59. | 2026-11-13 16:24 |
| case item 95 (straight lift-out; old pictures) | The straight lift-out of the ring from the case is test 17 of the case check: the ring is lifted straight up in steps of 0.25 mm until clear, at every ring size, with no contact and at least 0.1 mm free to every case part except the seat contacts. Steps of 0.25 mm are accepted as the lift-out check; no separate motion simulation is made. The four older pictures (side, underside, in-hand, compare) are not re-rendered now: the case is refitted to the 4.17 mm ring next and every case picture is rendered again then. | `design/case/case_check.py` line 676; `design/case/r4/final_check.log` lines 157 to 160 (US 7: 0 to 33.75 mm in 136 steps, smallest free space 0.172 mm), last line exit 0. | 2026-11-13 16:25 |
| design risks of the circuit notes (deferred item 27) | The 17 risks still open in the ring's and the case's circuit notes are reviewed against the maker documents on disk: 13 closed, 4 need a measurement on the first unit (antenna match M1, 32 MHz accuracy M2, case input current with a ring charging M3, USB over the spring pins M4). Four changes follow and are applied: the screen's start order in the ring software follows the screen maker's drawing (the screen's own chip starts the panel supply 66.7 ms or more after 'display on'); open software item 23 closes; the case software cuts the ring supply when it reads above 5.5 V; the case's production never burns two set-once option bits of its radio module. The lead read the maker's drawing (sheet page 9) himself before accepting the first change. | `design/ecad/risk-review.md` (52 maker quotes, all found again: `risk-review-work/quotes-verify.log`); `design/firmware.md` lines 381 and 1158; `design/case/case-architecture.md` rows IO3 and IO5. | 2026-11-13 16:44 |
| sim finding 2, correction of one clause | In the row 'sim finding 2 (case risk 8)' the words 'the resistor R21 goes to the charger's own REGN supply' are wrong. R21 goes to 3.3 V, as the row 'sim findings 2 and 3, as built into the case circuit' and the case netlist say. | `design/ecad/case/netlist.csv` lines 14 and 45; `design/ecad/risk-review.md` (case 8 conflict). | 2026-11-13 16:44 |
| ground lands of the two ribbons (wiring review 4, fault H2) | Each ribbon has two ground lands that the ribbon's own copper joins: A6 and A8 on FLEX1, B2 and B7 on FLEX2. They are a redundant pair by decision: the design needs at least one joint of each pair, and the electrical test of guide step 14 proves the pair, not each land. One land is enough for the current: the supply side of the same current runs through ONE land (VBUS on B4, the cell + on B1, the motor + on A7). No X-ray is asked. Each of the 15 lands still passes the visual accept rule of the hot-bar sheet. Every file that said B2 and B7 are proven one by one is corrected. Not chosen: splitting the ground on the 14 ribbons so that a meter proves each land; it would change 14 finished boards and the net rules of three checks for a joint the product does not need. | `design/wiring/wiring-review-4.md` fault H2 and its log `review4-work/gnd-islands2.log`; `design/ecad/ring/netlist.csv` (J_BAND_A and J_BAND_B rows). | 2026-11-13 17:30 |
| fallen 0201 part on the screen face (wiring review 4, note N5) | A ring board on which one of the eight 0201 parts of the screen face fell, tilted or moved in the second oven pass is not repaired: it is marked, set aside and the next board is used. Reason: no maker document on disk gives an iron setting for these parts, and the board may not pass the oven a third time (the screen connector allows 2 passes). The screen connector itself may be put right with an iron as its maker allows. | `design/mfg/assembly/process.md` line 116 and its hand soldering table (lines 148 to 155: no row for 0201 parts); `design/mfg/assembly/assembly.md` line 103. | 2026-11-13 17:56 |
| ground lands of the two ribbons, correction of one sentence | The row 'ground lands of the two ribbons' says each of the 15 lands still passes the visual accept rule of the hot-bar sheet. That is wrong: after the press every land lies wholly under the ribbon's foot (measured on the 14 ribbon boards), so the eye judges the foot as a whole (flat, no lifted corner, not moved, no solder ball beside it). Before the press the eye sees each land's own solder dome. The meter proves each ground pair. Nothing else changes in that decision. | `design/mfg/assembly/guide-fix4-notes.md` section H2 and its log `guide-fix4-work/logs/foot_cover2.log`. | 2026-11-13 17:56 |
| case thermistor TH1 leads, correction of the spacing | The row 'case thermistor TH1 leads (joint C3) and bead size' says the leads stay 2.54 mm apart over their whole length. The two holes on the case main board are 2.0 mm apart (footprint pads at -1 and +1 mm), so the leads come a little closer at the board; they must not touch (case step 10 says so). | `design/ecad/case/pcb/case_main.kicad_pcb` (footprint NTC_wired); `design/mfg/assembly/guide-fix4-notes.md` section H3. | 2026-11-13 17:56 |
| dam of the joystick pocket (deferred items 112 and 115; K-A3, K-A12, K15) | Shape: option A of inside model v10: one bead, 0.56 mm high, dispensed round the switch stack before the single resin cast and bonded to the pocket walls and the stack's edge; no two-shot cast. Material: Dymax 9422-SC, a light-cure paste whose maker's sheet says 'Highly Thixotropic' with 'Minimal Movement After Dispense', 38,000 cP nominal, cure in seconds under UV and visible light, linear shrinkage 1.6 percent. Why this one of five sheets read: a bead that slumps is the failure the model names, and this is the only sheet with a no-movement claim and no heat step. What its sheet does NOT state: a cure for shadowed areas (the bead is lit from the bore side through its own 0.56 mm), polyimide or titanium by name, bonding of an epoxy over it, a package size or order code. So bench test B9 decides before any ring is cast: on a dummy pocket the bead holds 0.56 mm for 60 s, cures through from the bore side, and the liner resin bonds to it. Fallback if a shaded zone stays uncured: Dymax 9014 (light plus moisture cure, names Kapton; no thixotropy claim). | `design/mech/thin/model-v10-notes.md` point 6; `design/mfg/assembly/dam-work/dam-material-notes.md` (156 quotes found again); `design/datasheets/dam_dymax_9422-sc.txt` page 1. | 2026-11-13 20:03 |
| screen: custom full-face panel; ring back to the thin block (owner, 13 Nov evening) | Three owner answers on cards, in order. (1) On the side slit that runs into the motor's pocket: 'Sealed opening (Recommended)': slit and motor pocket are one opening closed by the slit's black sealant, a barrier bead over the motor first, a bench test that the motor still runs. (2) On the black border of the turned stock screen: 'we can have custom panel for a wide screen with no black border', then on the card that asked how to read it: 'Switch to a custom panel now'. (3) On which ring the custom panel serves: 'Thin ring, 3.20 mm block (Recommended)'. So: the stock screen (Tailor 0.95 inch with its own connector) is no longer the design's screen; the screen is a custom full-face panel whose size, thickness, cable and connection come from a panel maker's answer to our requirement page; the ring returns to the thin block of 12 November (3.20 mm block; flat glass as chosen on 13 Nov, carried over by the lead: say so if the curved glass is wanted). The row 'block height 4.17 mm: what follows' is REPLACED by this row: the 4.17 mm exterior (merged417flat, merged417flatw) and inside model v10 are kept as the fallback for a stock screen. What follows, in order: the custom panel's requirement page with the way it connects to the board in the thin block; the main board's screen connector area follows that; thin exterior with flat glass, the three side windows and the sealed opening; inside model on the thin block; body files, cover glass, guide, parts list, case check, app. Until each is done its files describe either the 12 November thin ring without slits or the 4.17 mm ring. | The owner's card answers of 2026-11-13 (work list diary, three DECISION notes); `design/mech/thin/model-v10-notes.md` section 'The -Y slit against the motor pocket: options'; `design/wiring/screen-cable-study.md` section 4.3 item 6. | 2026-11-13 20:27 |
| capacitors C76 and C77 (deferred item 129) | The two 1.0 nF capacitors from the power chip's system rail VSYS to ground get a part number: Murata GRM0335C1H102JE01 (1000 pF, +/-5 percent, 50 V, C0G, size 0201), packaging code D (180 mm reel) by the sheet's part-number system. Why: VSYS reaches 5.5 V at most, so 50 V is far above twice that; C0G keeps its value with voltage and temperature; the design's other small capacitors are Murata. Their value comes from Nordic's kit design for the sister chip and from no datasheet requirement; they stay as fitted on the routed board. The part number goes into the circuit files and the parts list with the next circuit pass (the screen connection of the custom panel). Not found: a second maker's part (no maker page could be read). | `design/ecad/ring/c76-c77-work/c76-c77-notes.md` (70 quotes found again); `design/datasheets/c76_murata_GRM0335C1H102JE01.txt` lines 28 and 60. | 2026-11-13 20:32 |
| screen connection in the thin block (lead, 13 Nov evening) | Option A of design/mfg/specs/screen-panel-work/connection-options.md: the panel's tail, 5.0 mm wide at most, folds round the board's hand end into connector J1 (Hirose FH35C-15S-0.3SHW) on the board's under face at X -11.650, Y -0.150, turned 270 (inside model v9, design/mech/thin/out/v10/before/placement.csv line 18). J1 cannot stay on the screen face at any panel thickness (design/mfg/specs/screen-panel-work/logs/calc.log line 62). Two boards follow from the panel maker's answer on thickness. Board A1: only J1 moves; the eight 0201 parts C1, C2, C5, C7, C14, FB1, R71, R72 stay on the screen face; it needs a panel of 0.5 mm or less (calc.log line 59). Board A2: the eight parts go under the board too; the panel may be 0.80 mm; this placement has not routed closed so far (design/ecad/ring-route-c/notes.md line 72). Order of work: A1 is routed first in design/ecad/ring-route-g, then A2 is tried from A1's board. The board of the 4.17 mm fallback, design/ecad/ring/pcb/ring.kicad_pcb, stays as it is until one of the two is promoted. Why A over hot-bar lands: the panel can be tested before it goes in and swapped without heat, and no lit length is lost. |
| main board of the thin ring: version A2 (lead, 13 Nov, 22:20) | Board A2 (design/ecad/ring-route-h/pcb/ring-thin-a2.kicad_pcb, commit 284a7770) is the thin ring's main board: screen connector J1 on the under face at the hand end and the eight 0201 parts C1, C2, C5, C7, C14, FB1, R71, R72 under the board, so the screen face holds only 12 flat test pads and a panel of up to 0.80 mm fits. Rules check: 0 violations, 0 unconnected (lead's rerun of design/ecad/ring-route-h/scripts/check_final.sh). It replaces the row above on one point: the panel no longer has to be 0.5 mm or thinner, and board A1 is kept only as the step toward A2. Known cost, accepted: C5 (100 nF on VDD_1V8) sits 3.922 mm from its ball U1 A4 and FB1's DECD pad 3.534 mm from U1 A6, because no free place is nearer; C7 keeps its limit (2.328 mm to U1 A8, limit 3.0). Supply noise at those balls is a measurement on the first built board; the design has no limit for C5 or FB1 (design/ecad/ring/pcb/board-notes-r2.md step 13: only C7 has one). Next: A2 is applied to design/ecad/ring/pcb (placement table, fabrication files, checks); the board of the 4.17 mm fallback is kept beside it. |
| main board of the thin ring: A2b replaces A2 (lead, 13 Nov, 23:00) | Correction of the row above. Board A2 passed its rules check but broke 3 of the 8 controlled-line limits of design/ecad/ring/pcb/board-notes-r4.md (ground under the antenna line 94.092 percent; crystal line XC2 gap 0.1900 mm; a via 0.0862 mm from crystal line XL2): the lead's brief for A2 had left those limits out of its pass criteria. Board A2b (design/ecad/ring-route-i/pcb/ring-thin-a2b.kicad_pcb) changes copper of DECA and VDD_1V8 only, moves no part, and meets all 8 (design/ecad/ring-route-i/logs/lines_check-final.log, last result line RESULT PASS). A2b is the board in design/ecad/ring/pcb since commit d3aba653; the 8-limit check is bar 6 of design/ecad/ring-apply-a2/check_all.sh. The distances of the row above (C5 3.922 mm, FB1 3.534 mm, C7 2.328 mm) are unchanged. Rule for every later board change: the 8 limits are in the pass criteria. |
| side slits of the thin exterior: mouth and top (lead, 13 Nov, 23:40) | Two rulings on the thin exterior with flat glass (design/look/s1, variant merged32flatw). (1) No metal thinner than 0.40 mm may remain between a ribbon slit and the band's outer skin. The first measure found a knife edge of 0.000 to 0.036 mm at the slit floor and at the slit face at the motor end, just before the slit exits (design/look/s1/thin-flat-notes.md). Where the metal would be thinner than 0.40 mm the slit's mouth is cut out to the skin; the black sealant closes it. The measure script checks it and a copy with the old mouth must fail. Why: a sliver that thin cannot be machined or moulded and would break off. (2) The slit top stays at Z 1.53 for every panel thickness: the main board stays at Z 1.45 to 1.75 and a panel thinner than 0.80 mm gets a thicker foam frame. Why: the routed board, the body pocket and the ribbon neck then do not depend on the panel maker's answer. |
| side slits of the thin exterior: how the mouth is opened (lead, 14 Nov, morning) | Step back on the method, the rule of the row above unchanged (no metal under 0.40 mm between a slit and the outside). Four forms of a cut that follows the thin metal exactly all failed to build one valid body: the files of run 5 hold 93 to 294 body pieces and two are turned inside out, so its four passes are withdrawn (design/look/s1/thin-flat-notes.md, work-thin/gate-run5.log). New method: one plain box per slit. In the outer zone (from about 7.5 mm off the centre line out to the skin, the slit's full height) the slit's hand-end face moves from X -3.55 to X -4.10, past the band's side face at X -4.0; the slit is open to that side face there and the black sealant closes it. A gate runs before every measure: one valid solid, inside the ring's box, black fill present, STEP file under 50 MB. Rejected: accepting the knife edge (the model would not describe a makeable part); moving the whole slit 0.40 mm toward the fingertip (it moves the floor slot, the ribbon neck and the first window). Trade-off: the sealed opening on each side is about 0.55 mm longer and reaches the band's edge. |
| side slits of the thin exterior: the hand-end wall is a named exception (lead, 14 Nov, morning) | Replaces the two rows above on one point: the slit's mouth is NOT cut out. The plain box of the row above was built at US 9 in two forms and left metal of 0.0012 mm beside it and 0.0959 mm under it (design/look/s1/thin-flat-notes.md). Cause: each slit's hand-end face (X -3.55) runs 0.45 mm beside the band's side face (X -4.0); the band's 0.4 mm edge rounding and the block-to-band blend thin that wall to nothing, and every plain cut that opens it exposes the blend's thin edge again. Ruling: the slit stays plain. The rule 'at least 0.40 mm of metal between a slit and any outside or window surface' holds everywhere except one named zone per slit, the hand-end wall (between the slit's hand-end face and the band's side face and edge rounding, inside the slit's height, from 7.40 mm off the centre line outward). The measure reports that zone per ring size and fails when thin metal shows anywhere else or when the zone is larger than its stated bound. For the maker: metal thinner than 0.2 mm at the slit's mouth is broken back and the black sealant fills the slit flush to the skin; the maker is asked whether it can hold the 0.45 mm wall. Alternative kept for the owner's eye, not built: leave the band's hand-end edge unrounded over the slit's height, which makes the wall 0.45 mm everywhere and adds a crisp edge about 1.8 mm long on each side. Not chosen: moving the slit (the ribbon's neck is 1.8 mm wide in a 2.1 mm slot, so the slit cannot be narrowed, and moving it moves the 14 band circuits' necks). |
