NexusGPT/openring/firmware/docs/step7-review-4.md

# Step 7 review 4: fix round 3 of the ring's board files (independent judge)

Started: sam. 14 nov. 2026 09:10:31 CET (first `date`, `review4-work/start-date.txt`). Limit 75 minutes.
Raw outputs: `firmware/build-logs/step7/review4-work/` (named below by file name only). I wrote none of the code, the fixes or the three earlier reviews; the brief holds no verdict of the author or the lead on this round.

## Version

- `git diff --stat 8bb60559 92b8c6ac -- firmware/modules firmware/tools firmware/boards firmware/app firmware/docs firmware/README.md`: ` 6 files changed, 406 insertions(+), 57 deletions(-)`: `board-notes.md`, `step7-fix3-brief.md`, `step7-review-3.md`, `rhw.h`, `rst_hw_real.c`, `build_all.sh` (`diffstat.txt`). No board, app or README file changed.
- Each of the 6 working files against `git show 92b8c6ac:<path> | shasum -a 256`: 6 `SAME` (`version-proof.txt`).
- `git diff --stat 8bb60559 92b8c6ac -- firmware/tests`: empty (`diffstat-tests.txt`, 0 lines).
- The cited run read this code: `rst_hw_real.c` last changed 08:49:50, `build_all.sh` 09:02:25, run start 09:02:31 (`pm-mtimes.txt`; `f3-stages3.console` l.4). `rhw.h` was changed at 09:09:16, after the run (S7F-04).
- Only the read commands named in the brief were run (plus `git diff --stat 8bb60559 92b8c6ac -- firmware/build-logs/step7`, the allowed diff form, for S7T-06: `diffstat-buildlogs.txt`).

## Bar

| Bar | Verdict | Evidence |
|---|---|---|
| F1 The mechanism | NOT PROVEN | (a) PASS: `rst_hw_real.c:84` to `:90` reads no variable; its two calls take only the static `sd_cs` (l.79) and `spi00_pins` (l.80, l.81, devicetree only); the check's text rule also holds (`f3-stages3.console` l.1418). (b) Legal in all four states for the pin control half: `PINCTRL_DT_DEV_CONFIG_GET` is an address (`f3-explore1.console` l.49 = pinctrl.h l.265), `pinctrl_apply_state` does a lookup and `pinctrl_configure_pins` with no device (l.11 to 23, l.34 to 48 = l.345 to 357, l.319 to 332). Effect: NOT PROVEN. The saved nRF `pinctrl_configure_pins` stops at l.175 (`f3-explore1.console` l.71 to 83), before the `low-power-enable` branch. `gpio_nrfx` with `GPIO_DISCONNECTED` was not saved. In the failed-init state an enabled SPIM00 peripheral may remain (S7F-03). (c) Devicetree PASS: `spi00_sleep` has SCK P2.01, MOSI P2.02, MISO P2.04, `low-power-enable`, no bias (`board-pins.txt`, pinctrl.dtsi l.35 to 41). `cs-gpios = <&gpio2 5 ...>` (dts l.267). In this file the default state comes back only through the driver's resume from `resume_inner` l.160 and from the first `device_init` l.109. Both run after VDD_SD is on (`rst.c:345` to `:349`). No PM runtime and no `CONFIG_PM` in the ring confs (`pm-mtimes.txt`: only `CONFIG_PM_DEVICE=y`, conf l.36). The built `.config` was not read. (d) By code: SD_CS is driven again at l.155 before the driver resume at l.160. That the driver's resume applies the default state is not in the saved SDK source (NOT PROVEN) |
| F2 Every way to VDD_SD off | PASS (hardware parts NOT PROVEN, listed in the notes) | My search (`f2-search.txt`, `f2-search2.txt`): VDD_SD goes off only at `rst.c:166` (`power_down`, after the hook at :165) and `rst.c:485` (`unmount_locked`, after the hook at :484). Both are unconditional and do not depend on the deinit result (`rst-c-reads.txt`). `power_down` is called at `rst.c:360` and `:459`. `regulator_disable` appears only at `rpw_hw_real.c:101`, inside `r_rail_set` (`f2-power-reads.txt`). `b_suspend` has one return (l.169), after `lines_safe` (l.167). `bus_first_init`'s one failure exit (l.113) returns through `resume_inner` l.152 to `b_resume` l.177 to 178. `resume_inner`'s failure exits l.158 and l.160 do the same. Exceptions: (1) ship: `rrec.c:424` calls `ship_unmount`. When both tries return `-EBUSY` (`rrec.c:343` to `:352`), ship mode goes on with the store mounted, VDD_SD on and the four lines driven. `rpw.c:627` `ship_task` then cuts every supply together. The main chip loses power together with VDD_SD, so the rule holds unless the nPM1304 drops LDO2 before the main chip's supply (hardware; the notes' tracing is incomplete: S7F-02). (2) nPM1304 resets: all supplies are cut (hardware). (3) Boot: LDO2 has `regulator-boot-off` (dts l.366). spi00 is deferred and the lines are in their reset state (chip fact). After a main-chip reset (`rsy_hw_real.c:80` `sys_reboot`) VDD_SD may stay on while the pins are reset, which is safe |
| F3 S7T-02 | PASS | `rst_hw_real.c:108` to `:117`: the `device_init` returns are ignored and success needs `device_is_ready` of all three. Kit: a failed init sets `init_res`, then `initialized = true` (`f3-explore2.console` l.33, l.38), and `device_is_ready` is `initialized && init_res == 0` (l.61). So a failed bus stays failed and every later power-on returns `-ENODEV` and runs `lines_safe`. The error going up: `card_up` ignores the resume (`rst.c:349`), runs the disk init 3 times 200 ms apart (`rst.c:350`; `rrec_spec.h:184`, `:185`), then `power_down` (`rst.c:360`) and `-EIO` (`rst.c:361`). At boot `rrec_boot.c:92` to `:95` logs `RREC_LOG_FAULT_STORAGE_INIT` and raises `RC_EV_STORAGE_INIT_FAILED`. That is FW l.138 ("storage init fails 3 times, 200 ms apart" to `ERR_STORAGE_FAULT`, `design-reads.txt`). That the disk init fails on that bus is by reading (SD_CS disconnected); the kit's return value is NOT PROVEN |
| F4 Static check | FAIL | Sees: the text of `rst_hw_real.c` with comments removed (`build_all.sh`, diff l.102 to 137 in `diff-rhw-buildall.txt`). Does not see: `rst.c` (order of hook and rail), the devicetree sleep state, macros, other tables, kit behaviour. Planted copies each fail on their own function only: l.1440 `failing: b_suspend`, l.1453 `failing: lines_safe`, l.1466 `failing: b_resume`, stage end exit 0 l.1468. I ran four faulty copies through the same check code, extracted unchanged from `build_all.sh` (`fakes/make_fakes.py`, `fakes/expected.txt`, `fakes/fakes-run.txt`). All 4 pass with exit 0 and `RESULT PASS`: `macro-noop` (`#define lines_safe() 0` after the function), `cs-driven-high` (SD_CS `GPIO_OUTPUT_ACTIVE` with `(void)GPIO_DISCONNECTED;` kept), `default-after-sleep` (the default state applied after the sleep state in `lines_safe`), `second-table` (a second sdbus table with a suspend that skips `lines_safe`, registered instead). The honest control also passes. A devicetree change that removes `low-power-enable` passes too, by reading, since the check reads only that file (diff l.155) and the pin check does not read pin-state settings (notes l.531). S7F-01 |
| F5 S7T-04 | PASS | New copies: l.5448 `uart-mcuboot: self test ok` (planted `CONFIG_UART_CONSOLE=y` l.5429, refused l.5430) and l.5472 `uart20-on: self test ok: refused with "failing=unexpected-pins(2)"` (l.5468 to 5470). The pull-down self test compares the whole list: `[ "$got" != "${want#failing=}" ]` on the text after `failing: ` (diff l.69 to 76). l.5420 `failing: DBG_TX`, l.5422 `self test ok`. Stage end exit 0 l.5473 |
| F6 No regression | PASS | 12 stage end lines, 12 of them `exit 0` (`last-lines.txt`, two `grep -c`). Stages are listed in `stages3-greps.txt` (l.1343 to 5473). `STAGES7 FAILED:none`, remote exit 0, `.exit` 0. `ring-drivers: rst_hw_real.c.obj text 522 bytes: real code` l.2934. Ring application `FLASH: 643288 B 982896 B 65.45%`, `RAM: 471904 B 510 KB 90.36%` l.2821, l.2822. No test changed. Among the modules only `rst_hw_real.c` and `rhw.h` changed. The `rhw.h` change is comment only (`diff-rhw-buildall.txt` l.9 to 14: `int32_t ua;` unchanged). It is true: the real file negates (`rpw_hw_real.c:167`, used :192) and passes the value on with only a unit change (:305, :316; `f6-gauge-lines.txt`, `f6-rhw-comment.txt`). See S7F-04 for timing |
| F7 The notes | PASS | `board-notes.md` l.439 to 550: rows S7R-01 to S7R-09 (l.454 to 462), S7T-01 to S7T-06 (l.489 to 494). The step-by-step account of the four lines with source lines (l.507 to 522), the hardware list (l.524 to 527), the blind spots (l.529 to 534), and the RESULT line (l.550). Statements by reading are marked as such. Gaps: the ship path is "not traced" (l.500, 501; S7F-02), and step 4's "the disk inits fail" (l.518) is by reading (F3) |
| F8 One row per finding | PASS | Table below |

### F8: the third review's findings

| Finding | Status | Evidence or ruling |
|---|---|---|
| S7T-01 partial first init leaves SD_CS high | closed (hardware parts NOT PROVEN) | F1, F2: `lines_safe` ends every exit of the hook and every failed resume or first init |
| S7T-02 `-EALREADY` taken as success | closed | F3 |
| S7T-03 notes section missing | closed | F7 |
| S7T-04 production self tests | closed | F5 |
| S7T-05 rhw.h comment | closed by the lead | F6: comment only, matches the code |
| S7T-06 logs not committed | closed for fix 2 | `diffstat-buildlogs.txt`: 17 `fix2/` additions, 215 `review2-work/scratch` deletions (`s7t06-counts.txt`). The fix 3 logs are not in the commit (S7F-05) |

## Findings

| Id | Severity | File:line | Specification or ruling | What is wrong |
|---|---|---|---|---|
| S7F-01 | minor | `tools/build_all.sh` `ring_lines_check` (diff l.115 to 132) | ruling 3 "a static check ... with a planted copy that fails"; "say what the check sees and what it does not" | `lines_safe` is checked by substrings (`GPIO_DISCONNECTED`, the sleep call) and the table by a substring. Nothing checks that the wrappers' `lines_safe()` is that function. Four faulty copies pass with exit 0 (`fakes/fakes-run.txt`), and so does a devicetree change to the sleep state. The three likely regressions (an early return, gating on `bus_up`, a removed call) are caught (l.1440, 1453, 1466). I rate this minor, not major: the check can fail on the shape it names. Its stated limit ("the text of the file only") does not say that its content rules can be passed by a cast or a macro |
| S7F-02 | minor | `rrec.c:343` to `:352`, `:424`, `:451`; `board-notes.md` l.499 to 501 | ruling 1 "If one way to VDD_SD off does not pass the hook (ship mode ...), report it" | Traced here: when both unmount tries return `-EBUSY`, ship mode proceeds with the store mounted, VDD_SD on and SD_CS driven high until `TASKENTERSHIPMODE`. The rule then rests only on the nPM1304 cutting LDO2 no earlier than the main chip's supply. The notes say this "was not traced". The hardware list (l.526) names "the lines at ship mode" but not this case |
| S7F-03 | note | `rst.c:349`; `rst_hw_real.c:139` to `:141` | FW l.506 | Double fault, unverified. If the first init fails with the disk registered, `card_up` still runs the disk init. If that reaches the SPIM driver and enables SPIM00, `power_down`'s `suspend_inner` returns 0 without the driver's suspend (`bus_up` is false), so the peripheral may stay enabled when VDD_SD goes off. Two things are not in the saved reads: whether the disk init gets there, and whether an enabled SPIM00 drives pins whose GPIO is a disconnected input (chip) |
| S7F-04 | note | `modules/ring_rhw/include/ring_rhw/rhw.h:97` to `:100` | brief F6 | Changed at 09:09:16, after the targeted run started at 09:02:31 (`pm-mtimes.txt`, `f3-stages3.console` l.4). It is comment only, so the compiled code is the code that ran. The lead's whole run covers it |
| S7F-05 | note | commit 92b8c6ac | brief standing rules (logs) | `build-logs/step7/fix3/` is not in the commit (0 `fix3/` paths in `diffstat-buildlogs.txt`). This review read the working-folder copies |
| S7F-06 | note | `fix3/f3-explore1.console` l.71 to 83 | brief F1 (b) to (d) | These SDK lines were not saved: the nRF pin control branch for `low-power-enable`, `gpio_nrfx` with `GPIO_DISCONNECTED`, the SPIM driver's PM actions (suspend, and resume re-applying the default state), and `pm_device_action_run` on an already active device. F1 stays NOT PROVEN for these |
| S7F-07 | note | `rst_hw_real.c:143` to `:145`, `:160` | FW l.506 | If the driver's suspend fails, its PM state stays active while `lines_safe` sets the sleep pins. The next resume may then answer an error, so that power-on fails safe (`ERR_STORAGE_FAULT` path), and the following `power_down` suspends normally. This is not a safety fault; the return value is not in the saved source |

Counts: blocker 0, major 0, minor 2, note 5.

## What I could not check

- Hardware: the pins' reset state, the effect of `low-power-enable` and `GPIO_DISCONNECTED` on nRF54LM20A, whether an enabled SPIM00 drives pins whose GPIO is an input, and the nPM1304's order of supply cut in ship mode and at its resets.
- SDK source not saved by the author (S7F-06), the build server (out of bounds), and the built `.config` files.
- Running the bash entry point of the static check: I ran its Python body, extracted unchanged, with `python3 -I` on my copies (`fakes/ring_lines_check.py`, `fakes/real.log` `RESULT PASS`, exit 0).
- Whether a unit test guards the order "hook, then rail off" in `rst.c`: unverified.

## Last lines of the cited proof files

- `fix3/f3-stages3.console`: `# local log: firmware/build-logs/step7/fix3/20261114-090231-f3-stages3.log`
- `fix3/f3-explore1.console`: `# local log: firmware/build-logs/step7/fix3/20261114-084837-f3-explore1.log`
- `fix3/f3-explore2.console`: `# local log: firmware/build-logs/step7/fix3/20261114-084856-f3-explore2.log`
- `review4-work/fakes/fakes-run.txt`: `honest-control: exit 0: ring-lines-safe: RESULT PASS`

Verdict: PASS. No blocker and no major open. Bar: 6 of 8 PASS (F2, F3, F5, F6, F7, F8), F1 NOT PROVEN (SDK and hardware facts), F4 FAIL (S7F-01, minor).

RESULT: done, PASS: lines_safe now ends every way to VDD_SD off that the code controls and S7T-01 to S7T-06 are closed, with a minor weakness in the static check (four faulty copies pass it) and the ship path's double-busy case left to hardware.
