NexusGPT/openring/design/firmware-v7-evidence/broken-mic-at-step5.md

# AI ring recorder: firmware architecture

Version F6, with F7 part 1 (2026-11-11): rulings R1 to R8 of firmware/docs/core-delta-1.md and R9 to R14 of firmware/docs/core-delta-2.md and R15, R16 in sections 1 and 2, and F7 part 2 (2026-11-11): section 7 rewritten for three paired devices and keyboard, media and pointer control; and F7 part 3 (2026-11-12, after design review 3): rulings R17 (the control session and the screens for control modes and paired devices: sections 2.1, 2.2, 3.3, 3.4, 7.4, 7.5), R18 (the microphone factory tests run only with the screen fitted: section 9.3) and R19 (the recording current reads 2.6 mA plus a 1.5 mA allowance for the lit sign: section 8.5); 2026-11-11. Follows `design/architecture.md` version A5-draft, sections 17.11 to 17.26 (read 2026-11-11: section 17 is the current ring; where sections disagree, the later section wins: 17.26 over 17.25 and so on down to 17.11, then 17.10, then 17.8 over 17.7, then 17.1 to 17.6, then 16, then the rest), `design/ecad/ring/sch-notes.md` section 12 (wiring A7) with `design/ecad/ring/netlist.csv`, `design/ecad/motor-drive/motor-drive.md` section 2, `design/mfg/assembly/assembly.md`, the nPM1304 Product Specification v1.0 (`design/datasheets/npm1304_datasheet_v1_0.txt`, page numbers are the document's own, written [NPM pN]), `design/case/case-architecture.md` (this file was written against case version C1; the case is now C5d, and its pad order VBUS, D-, D+, GND is the one this file uses; the rest of C5d was not re-read for this file) and `requirements.md`. The hardware is fixed; where it blocks a requirement, the conflict is in "Hardware issues found" at the end. The owner's rule that never changes: "The ring shouldn't CONSTANTLY record, only when a long press on it. Then you have a live storing audio". Ring sizes of version 1: "US 7 to 13" (owner, 2026-11-11).

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

Changes from F2 to F3 (architecture A5-draft; each item names its architecture section):
1. **Two microphones on one stereo input** (16.4, 16.6): two Infineon IM68D128B, mic 1 on the left channel and mic 2 on the right channel of the one PDM instance `pdm20` (MIC_A_CLK, MIC_A_DATA). MIC_B_CLK P1.24 and MIC_B_DATA P1.25 are unused test pads. Removed: the second instance, the block pairing between instances, the PDM skew field and its test T-SKEW, microphone tests 3 and 4.
2. **Audio format** (16.6): 2 channels, 16 kHz, 16 bits, raw: 2 x 16,000 x 2 = 64,000 bytes per second, 230.4 MB per hour. A chunk keeps its 512 ms (8,192 frames) and so every time value of F2 (flush interval, 1.536 s worst-case loss, S30 at 3,516 chunks); its bytes halve: 1 header sector + 64 payload sectors = 33,280 bytes (was 129 sectors, 66,048 bytes). Sections 4.3, 5.2, 5.3, 5.4, 5.6, 6.3, 6.4 and 7.2 carry the new numbers. RAM budget 305,408 bytes (was 411,904).
3. **Storage 4 GB, about 16 hours** (16.4): CS Semiconductor CSNP32GCR01-BOW, SD NAND in SPI mode, 3.7 GB usable; 16.9 hours on 4,000,000,000 bytes and 15.6 hours on 3.7 GB (section 5.6). The wiring and the driver stack are those of F2.
4. **Joystick = four switches** (16.5, 16.6, 17.3): SW1 up on JOY_UP, SW3 down on JOY_DOWN, SW4 toward the hand on JOY_LEFT, SW5 toward the fingertip on JOY_RIGHT. A centre press is read when the two switches of an opposite pair close within 40 ms (section 2.2). The JOY_CENTER pin P0.03 is unused. Screens and menu keep their mapping.
5. **Record button = its own switch SW2 on BTN_REC** (17.3, 17.8): same gestures as F2 (long press 1.0 s starts, long press 1.0 s stops, short press marks a highlight, double press does nothing). [v7: the record button is gone since 17.11 and the rectangular nub is removed in v7; the one control is the round joystick (architecture 17.29), centre switch SW2 (net BTN_REC)]
6. **Vibration motor VC0720B088L** at full duty from the 3.0 V rail through Q1 (17.4): same patterns M1, M2, M3, MH, MT, MF; 85 mA maximum (section 3.1; the cell rate is hardware issue H7). **Replaced 2026-11-11 by architecture 17.16: the motor is the Jinlong W0525AB001D, below 80 mA running and below 175 mA at each start; the patterns and the pin are unchanged.**
7. **Battery about 15 to 20 mAh** (17.10, which corrects 17.8): thresholds B15, B5, B2 recomputed in minutes (section 1.1); recording hours at 4.0 mA: 3.8 to 5.0, and 1.2 to 1.5 hours at a Plaud's 13 mA (section 8.5). The 10-hour target (requirement P2) is not met (architecture 17.5).
8. **Charge current blocked** (17.5, 17.6): the power chip's minimum charge current, 32 mA, is above 1 C for this cell (1.6 to 2.1 C on 15 to 20 mAh). The charging states stay; the charge-current setting and the T-CHARGE limits are BLOCKED on open item S12 and no value is set (section 8.1). The charge voltage is 4.35 V, the cell's type (architecture section 2 and S12).
9. **Four pads on the band** (17.3, 17.8): the ring charges and transfers through VBUS, D-, D+, GND, 1.0 mm pads on the outside of the band (at -150 degrees in 17.8). The states `CHARGING` and `TRANSFER` stay; their text follows (sections 1.1, 6.1).
10. `firmware-check.py` checks the F3 rules that can be checked (section 10.6). Nothing else changes: no state, transition, gesture or pattern was redesigned.
11. **Correction of 2026-11-10 (21:30 work), architecture 17.10 wins over 17.8**: the cell is about 15 to 20 mAh (1.6 x 6.0 x 28.4 mm), not 19 to 25 mAh. Recomputed from it: recording 3.8 to 5.0 hours at 4.0 mA and 1.2 to 1.5 hours at 13 mA; capacity left and minutes at B15, B5, B2 (section 1.1); the 85 mA pulse is 4.3 to 5.7 C (section 3.1, H7); the charge minimum of 32 mA is 1.6 to 2.1 C (section 8.1, H8); standby 500 to 670 hours, 21 to 28 days (section 8.5); motor at +51 degrees (section 4.7).

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

| Function | Instance | Pins (architecture section 7) | Why this instance |
|---|---|---|---|
| Microphones 1 and 2 (one stereo input) | `pdm20` | MIC_A_CLK P1.13, MIC_A_DATA P1.11 | one instance serves both microphones on one clock and one data line (architecture 16.6); the chip's second PDM instance is not used [SRC 1] |
| Unused pins | none | MIC_B_CLK P1.24, MIC_B_DATA P1.25, JOY_CENTER P0.03 | test pads since architecture 16.6: unused, the firmware never configures or reads them |
| Storage | `spi00` (SPIM) | SD_SCK P2.01, SD_MOSI P2.02, SD_MISO P2.04, SD_CS P2.05 | only fast SPIM, 32 MHz maximum [SRC 1, SRC 3]; the development kit uses the same SCK, MOSI, MISO pins for `spi00` [SRC 9] |
| Screen | `spi21` (SPIM) | LCD_SCK P1.03, LCD_MOSI P1.04, LCD_CS P1.05, LCD_DCX P1.06 | port P1 instance; SPIM21 maximum data rate 8 Mbit/s [SRC 3] |
| Power chip | `i2c22` (TWIM) | PMIC_SDA P1.26, PMIC_SCL P1.27 | `i2c21` shares address 0xc7000 with `spi21` and cannot run at the same time [SRC 1]; `i2c22` is free |
| Debug log | `uart20` (UARTE) | DBG_TX P1.15, DBG_RX P1.16 | `uart20` shares 0xc6000 with `spi20`/`i2c20`, both unused |
| Joystick (round, five switches; architecture 17.29) | GPIO with the chip's internal pull-up (`GPIO_PULL_UP \| GPIO_ACTIVE_LOW`, architecture W1), Zephyr `gpio-keys` input driver | BTN_REC P0.04 (SW2), JOY_UP P0.06 (SW1), JOY_DOWN P0.07 (SW3), JOY_LEFT P0.08 (SW4), JOY_RIGHT P1.31 (SW5) | `gpio-keys` has `debounce-interval-ms` [SRC 14]; BTN_REC is the net of the centre switch SW2 (net BTN_REC) under the round cap when `CENTRE_SOURCE` is `SW2`, and unused (left as an input with the pull-up) when it is `PAIR` |
| Motor | GPIO output, active high | MOTOR P3.01 | the pin switches the motor regulator U11 on and off through R61 (net MOT_EN), so patterns in ms need no PWM (motor-drive.md, regulator U11) |
| Screen extras | GPIO | LCD_RST P1.07 (output), LCD_TE P1.22 (input, rising edge), OLED_PWR_EN P1.29 (output) | |
| Power chip interrupt | GPIO input | PMIC_INT P1.28 | driven by the nPM1304's GPIO0 (ball D6, netlist.csv); `host-int-gpios` of the power chip node (property name TO CONFIRM, section 8.1) |
| USB | `usbhs` (DWC2 core, `nordic,nrf-usbhs-nrf54l`) | dedicated D+, D-, VBUS | [SRC 1, SRC 5] |
| 32.768 kHz crystal | LFXO | XL1 P1.20, XL2 P1.21 | |
| Time base | `grtc` | none | [SRC 1] |
| Watchdog | `wdt31` | none | [SRC 1] |

## 1. State machine

### 1.1 States

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

### 1.2 Transitions

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

| From | Event | To | Actions |
|---|---|---|---|
| `SHIP` | VBUS appears (case contact) | `BOOT` | the nPM1304 leaves ship mode (VBUS above VBUSPOR, 3.9 V [NPM p17, p116]) and powers the bucks; the chip starts; charge on |
| `OFF` | VBUS appears | `BOOT` | as above, including charge on |
| `BOOT` | init done, superblock open flag clear, no VBUS, battery above B5 | `STANDBY` | VDD_SD off |
| `BOOT` | init done, superblock open flag set | `RECOVERY` | keep VDD_SD on |
| `BOOT` | init done, VBUS present | `CHARGING` | VDD_SD off; charge on |
| `BOOT` | storage init fails 3 times, 200 ms apart | `ERR_STORAGE_FAULT` | log event; MF |
| `BOOT` | battery at B2 and no VBUS | `OFF` | enter ship mode (section 8.4) |
| `BOOT` | battery at B5 and no VBUS | `ERR_BATTERY_LOW` | VDD_SD off; M3 (ruling R13) |
| `RECOVERY` | scan done, no VBUS | `STANDBY` | write index CLOSE record with state RECOVERED; clear open flag; VDD_SD off |
| `RECOVERY` | scan done, VBUS present | `CHARGING` | same actions; charge on |
| `RECOVERY` | read error during scan | `ERR_STORAGE_FAULT` | log event; MF |
| `STANDBY` | long press of the joystick centre | `RECORDING` | only with the superblock open flag clear, the battery above B5, free space above SFULL and the recording sign drawn (rulings R1, R4b; rule R-SIGN, section 3.2; otherwise the next four rows, in their order): open; M1 |
| `STANDBY` | long press, superblock open flag set | `RECOVERY` | no recording starts (ruling R4b: a recording never starts while the open flag is set); VDD_SD on; mount; `RECOVERY` scans and closes the unfinished recording; the wearer presses again |
| `STANDBY` | long press of the joystick centre, battery at B5 | `STANDBY` | no recording starts; screen "Battery low" 3 s (ruling R1) |
| `STANDBY` | long press of the joystick centre, free space at SFULL | `STANDBY` | no recording starts; screen "Storage full" 3 s (ruling R1) |
| `STANDBY` | long press of the joystick centre, recording sign not drawn | `STANDBY` | no recording starts: the screen did not accept the red dot and the timer (rule R-SIGN, section 3.2); VDD_MIC stays off; M3; event log record |
| `STANDBY` | short press of the joystick centre | `STANDBY` | screen off: screen on, status screen, 5 s; screen on: the centre action of the screen (section 2.2), then MT (ruling R6) |
| `STANDBY` | double press of the joystick centre | `STANDBY` | nothing; with a control session open it closes the session (ruling R17, section 3.4) |
| `STANDBY` | menu "Power off" confirmed | `OFF` | save settings and time; M2; ship mode |
| `STANDBY` | VBUS appears | `CHARGING` | charge on |
| `STANDBY` | battery reaches B15 | `STANDBY` | M3 once per discharge; status screen 5 s |
| `STANDBY` | battery reaches B5 | `ERR_BATTERY_LOW` | M3 |
| `STANDBY` | battery reaches B2 | `OFF` | save settings and time; ship mode |
| `STANDBY` | free space at SFULL | `ERR_STORAGE_FULL` | M3 |
| `STANDBY` | storage fault set at entry (rule R-STB) | `ERR_STORAGE_FAULT` | none; the 60 s retry starts (ruling R11) |
| `RECORDING` | long press of the joystick centre | `STANDBY` | close; M2 |
| `RECORDING` | short press of the joystick centre | `RECORDING` | highlight marker; MH; screen 3 s with highlight count |
| `RECORDING` | double press of the joystick centre | `RECORDING` | nothing (no highlight, no stop); with a control session open it closes the session (ruling R17, section 3.4) |
| `RECORDING` | BLE control "highlight" from a bonded phone | `RECORDING` | highlight marker; MH |
| `RECORDING` | VBUS appears (case insertion during a recording) | `CHARGING` | close; M2; charge on |
| `RECORDING` | battery reaches B15 | `RECORDING` | M3 once per discharge |
| `RECORDING` | battery reaches B5 | `ERR_BATTERY_LOW` | close; M3 |
| `RECORDING` | battery reaches B2 | `OFF` | close; ship mode |
| `RECORDING` | free space reaches S30 | `RECORDING` | M3 once; screen 3 s "30 min left" |
| `RECORDING` | free space at SFULL | `ERR_STORAGE_FULL` | close; M3 |
| `RECORDING` | chunk write fails 3 times | `ERR_STORAGE_FAULT` | stop PDM; clocks low; VDD_MIC off; superblock left open (RECOVERY at next boot); MF |
| `RECORDING` | the PDM instance gives no block for 100 ms | `ERR_MIC_FAULT` | close; MF |
| `RECORDING` | sudden power loss (cell cut, short, brown-out) during a write | `BOOT` | nothing runs; at the next power-on the open flag leads to `RECOVERY`; loss bounded in section 5.5 |
| `CHARGING` | USB configured by the case (`USBD_MSG_CONFIGURATION`) | `TRANSFER` | VDD_SD on; mount; charge on stays |
| `CHARGING` | VBUS removed, free space above SFULL, battery above B5 | `STANDBY` | none |
| `CHARGING` | VBUS removed, free space at SFULL, battery above B5 | `ERR_STORAGE_FULL` | none (ruling R2: with the battery at B5 the next row applies) |
| `CHARGING` | VBUS removed, battery at B2 | `OFF` | save settings and time; ship mode (ruling R10) |
| `CHARGING` | VBUS removed, battery at B5 | `ERR_BATTERY_LOW` | none |
| `CHARGING` | nPM1304 event charge error | `ERR_CHARGER` | log BCHGERRREASON and BCHGERRSENSOR [NPM p41]; charge off; MF |
| `CHARGING` | long press | `CHARGING` | refused: M3; screen "In case" 3 s; charge on stays |
| `TRANSFER` | USB suspended or unconfigured by the case | `CHARGING` | finish the current command; VDD_SD off; charge on |
| `TRANSFER` | VBUS removed | `STANDBY` | abort the command; VDD_SD off |
| `TRANSFER` | command FW_END accepted | `BOOT` | `boot_request_upgrade(BOOT_UPGRADE_TEST)`; reboot (section 9.2) |
| `TRANSFER` | command FACTORY_ENTER with the factory flag set | `FACTORY_TEST` | section 9.3 |
| `TRANSFER` | long press | `TRANSFER` | refused: M3 |
| `ERR_STORAGE_FULL` | VBUS appears | `CHARGING` | charge on |
| `ERR_STORAGE_FULL` | long press | `ERR_STORAGE_FULL` | refused: M3; screen "Storage full" 3 s |
| `ERR_STORAGE_FULL` | battery reaches B5 | `ERR_BATTERY_LOW` | M3 |
| `ERR_STORAGE_FULL` | battery reaches B2 | `OFF` | ship mode |
| `ERR_BATTERY_LOW` | VBUS appears | `CHARGING` | charge on |
| `ERR_BATTERY_LOW` | long press | `ERR_BATTERY_LOW` | refused: M3; screen "Battery low" 3 s |
| `ERR_BATTERY_LOW` | battery reaches B2 | `OFF` | save settings and time; ship mode |
| `ERR_STORAGE_FAULT` | VBUS appears | `CHARGING` | charge on; the case reads the event log (GET_LOG) |
| `ERR_STORAGE_FAULT` | 60 s elapsed | `ERR_STORAGE_FAULT` | retry storage: the caller runs the storage init and reports the result as an event (ruling R3; every 60 s while in this state; ruling R14: at most one try per call of the tick, whatever the delay, the next one 60 s after it) |
| `ERR_STORAGE_FAULT` | storage retry succeeds, superblock open flag set | `RECOVERY` | keep VDD_SD on; `RECOVERY` scans and closes the unfinished recording (ruling R9) |
| `ERR_STORAGE_FAULT` | storage retry succeeds, superblock open flag clear | `STANDBY` | none (rule R-STB applies) |
| `ERR_STORAGE_FAULT` | storage retry fails | `ERR_STORAGE_FAULT` | none; the next try comes 60 s later (ruling R3) |
| `ERR_STORAGE_FAULT` | battery reaches B2 | `OFF` | ship mode |
| `ERR_MIC_FAULT` | 5 s elapsed | `STANDBY` | the fault is in the event log |
| `ERR_MIC_FAULT` | VBUS appears | `CHARGING` | charge on |
| `ERR_MIC_FAULT` | battery reaches B2 | `OFF` | save settings and time; ship mode (ruling R15) |
| `ERR_CHARGER` | VBUS removed | `STANDBY` | none |
| `ERR_CHARGER` | battery reaches B2 | `OFF` | save settings and time; ship mode (ruling R15) |
| `FACTORY_TEST` | command FACTORY_EXIT | `BOOT` | reboot |
| `FACTORY_TEST` | command SHIP_ENTER | `SHIP` | clear the factory flag; ship mode (waits for VBUS removal, section 8.4) |
| `FACTORY_TEST` | command SHIP_SAMPLE (sample rings only) | `SHIP` | keep the factory flag; ship mode (waits for VBUS removal, section 8.4) |
| `FACTORY_TEST` | VBUS removed, no ship command accepted | `BOOT` | reboot |

The table has 72 transitions.

Rules that apply to every state:
- Only a long press of the joystick centre starts or stops a recording. A short press, a double press and a joystick direction (up, down, toward the hand, toward the fingertip) never start and never stop one; neither does Bluetooth or the case (the case only closes a recording by its VBUS, row "case insertion").
- **R-CHG (charging):** in every state where VBUS is present the charger is on at `CHARGE_CURRENT`. It is turned on by the first VBUS event (on first power, in `BOOT`, before storage is mounted) and by every row into `CHARGING`; the firmware turns it off only in the row `CHARGING` to `ERR_CHARGER`; otherwise only the charger itself stops it (full, thermistor limits, die temperature) or VBUS removal. The charge setting is in section 8.1. Ruling R8: charge on is sent on every appearance of VBUS, in every state, also where no row changes the state (`BOOT`, `RECOVERY`).
- **R-STB (entry into `STANDBY`, rulings R1, R11, R15):** every row from another state into `STANDBY` checks the facts first, in this order: battery at B2 with no VBUS goes to `OFF` (ruling R15); the storage fault set goes to `ERR_STORAGE_FAULT` (and so back to the 60 s retry); battery at B5 to `ERR_BATTERY_LOW`; free space at SFULL to `ERR_STORAGE_FULL`. It does so through the row of `STANDBY` for that fact ("battery reaches B2", "storage fault set at entry", "battery reaches B5", "free space at SFULL"), with that row's actions. This covers the rows `TRANSFER` VBUS removed, `ERR_STORAGE_FAULT` storage retry succeeds with the open flag clear, `ERR_MIC_FAULT` 5 s elapsed, `ERR_CHARGER` VBUS removed and `RECOVERY` scan done, no VBUS. The same order (B2 before B5) holds for every row that leaves `CHARGING` or `TRANSFER` when VBUS goes (ruling R10).
- **R15 (B2 with no VBUS, the lead's ruling):** with no VBUS, a battery at B2 always ends in `OFF`. The level is a fact, not only an event: on entry into any state (`STANDBY` through R-STB, `ERR_STORAGE_FAULT`, `ERR_STORAGE_FULL`, `ERR_BATTERY_LOW`, `ERR_MIC_FAULT`, `ERR_CHARGER`, and at "init done" or a failed storage init in `BOOT`) the core checks it first and, at B2 with no VBUS, takes that state's "battery reaches B2" row to `OFF` (a state without such a row gets one, with the same actions as the other B2 rows). The order of the entry checks is: B2, then the storage fault, then B5, then storage full. `RECOVERY` is the one exception already ruled (R4b: at B2 the ring goes `OFF` without recovery and the open flag stays set).
- **R16 (B2 when VBUS goes, the lead's ruling):** R15 holds at two moments, not one: on entry into a state, and whenever VBUS is removed, in every state. When VBUS goes and the battery is at B2, the ring takes that state's "battery reaches B2" row to `OFF`. This covers a ring that entered `ERR_STORAGE_FAULT` (or any state) in its case and is then taken out. A state that reacts to "VBUS removed" with its own row keeps that row; the B2 check comes first. In `CHARGING` the row "VBUS removed, battery at B2" is that check. A state with no "battery reaches B2" row (`TRANSFER`, `RECOVERY`, `FACTORY_TEST`) takes its own "VBUS removed" row, or none, and reaches `OFF` through the B2 check of the state it enters (R15, R-STB) or at the end of the scan (`RECOVERY`).
- **Storage fault (ruling R11):** the storage fault is a fact the core keeps. It is set on entering `ERR_STORAGE_FAULT` and cleared only by a successful storage init ("init done", "storage retry succeeds"). Leaving the case does not hide a broken storage.
- **Open flag (ruling R9):** the open flag is cleared only by two things: a successful close of a recording ("close") and "scan done" at the end of `RECOVERY` ("clear open flag"). Asking for recovery clears nothing. A read error during the scan goes to `ERR_STORAGE_FAULT` with the flag still set.
- **Order at "init done" (rulings R4, R5, R12, correction R4b):** battery events that arrive in `BOOT` before "init done" are not applied at once: the level is kept and this order decides; at B2 (no VBUS) the row "battery at B2 and no VBUS" (to `OFF`, no recovery: the open flag stays set and the next start-up recovers); else a start-up with an unfinished recording takes the row "init done, superblock open flag set" first (`RECOVERY`); at the end of the scan the battery rule applies: "scan done, VBUS present" goes to `CHARGING`, "scan done, no VBUS" enters `STANDBY` through rule R-STB (at B5 to `ERR_BATTERY_LOW`); else at B5 (no VBUS) the row "battery at B5 and no VBUS" (to `ERR_BATTERY_LOW`); else the row "init done, superblock open flag clear, no VBUS, battery above B5" or "init done, VBUS present". If the storage init fails instead (row "storage init fails 3 times"), a kept B2 with no VBUS runs the row "`ERR_STORAGE_FAULT`, battery reaches B2" (to `OFF`) on entering `ERR_STORAGE_FAULT` (ruling R15).
- **R4b (open flag):** a recording never starts while the superblock open flag is set. A long press in `STANDBY` with the flag set takes the row "long press, superblock open flag set" (to `RECOVERY`); the wearer presses again after the recovery.
- The watchdog (`wdt31`, 8 s) resets the chip when the main loop stops; a reset during a recording leaves the open flag set, so `BOOT` goes to `RECOVERY`.
- Only one recording is open at a time. A storage operation never runs while the case reads (USB `BUSY` status, section 6).

## 2. Controls

### 2.1 Record gesture: the centre press of the joystick (the one control; architecture 17.11)

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

Screens are listed in section 3.3. Mapping per screen:

| Screen | Up | Down | Left | Right | Centre |
|---|---|---|---|---|---|
| SCR_STATUS | none | none | none | open SCR_MENU | open SCR_MENU |
| SCR_RECORDING | none | none | none | none | highlight marker (section 2.1; collision C1) |
| SCR_MENU | previous item | next item | close menu, back to SCR_STATUS | open item | open item |
| SCR_RECORDINGS | previous recording | next recording | back to SCR_MENU | open SCR_RECORDING_INFO | open SCR_RECORDING_INFO |
| SCR_RECORDING_INFO | none | none | back to SCR_RECORDINGS | none | none |
| SCR_SETTINGS | previous setting | next setting | back to SCR_MENU | change value | change value |
| SCR_MODES | previous mode | next mode | back to SCR_MENU | open a control session in that mode (SCR_CONTROL) | open a control session in that mode (SCR_CONTROL) |
| SCR_CONTROL (control session, section 3.4) | sent to the active device (section 7.5) | sent to the active device | sent to the active device | sent to the active device | sent to the active device; in `RECORDING` the highlight marker, and nothing is sent |
| SCR_DEVICES | previous device | next device | back to SCR_MENU | open SCR_DEVICE for that device | open SCR_DEVICE for that device |
| SCR_DEVICE | previous item | next item | back to SCR_DEVICES | do the item | do the item |
| SCR_CONFIRM | none | none | "No" (back) | none | "Yes" |
| SCR_PAIR | none | none | cancel pairing | none | none |
| SCR_MESSAGE | dismiss | dismiss | dismiss | dismiss | dismiss |
| SCR_CHARGING, SCR_TRANSFER, SCR_ERROR | none | none | none | none | turn screen off |
| SCR_FACTORY | reported to the jig | reported to the jig | reported to the jig | reported to the jig | reported to the jig |

The Centre column is the action of a short press of the centre (section 2.1) when the screen is on. Menu items in SCR_MENU, in this order: "Recordings", "Control", "Devices", "Pair device", "Settings", "Power off" (F6 had four items; "Control" and "Devices" are new in F7 part 3 and "Pair phone" is renamed "Pair device"). Settings in SCR_SETTINGS, in this order: "Screen brightness" (3 levels), "Vibration" (on/off; off disables MH and joystick ticks only, never M1, M2, M3, MF, MW), "Time format" (24 h / 12 h), "About" (firmware version, serial).

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

## 3. Feedback

### 3.1 Motor (MOTOR, P3.01, high = on)

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

- The 1, 2 and 3 pulse counts follow requirement U4 and architecture section 9. MW is new in F4: one 60 ms pulse **[CHOICE]**, between MT (25 ms) and M1 (80 ms), felt at the thumb that rests on the round cap; **[BENCH]** test F1 also judges it. It sounds only while the centre is held, so no other pattern can run at the same time.
- A pulse draws below 80 mA while the motor runs and up to 175 mA at its start, from the cell through U11, outside the power chip's 100 mA battery limit (motor-drive.md). On the smallest cell, 17.6 mAh at US 7, that is 4.5 C running and 9.9 C at the start; on the largest, 31.9 mAh at US 13, 2.5 C and 5.5 C [CALC: 80 / 17.6 = 4.55, 175 / 17.6 = 9.94, 80 / 31.9 = 2.51, 175 / 31.9 = 5.49; architecture 17.16, 17.26]; whether the cell and its protection circuit allow it is hardware issue H7.
- **Motor charge for the fuel gauge** (motor-drive.md section 2.8 change F3): the power chip measures the battery current inside its own path [NPM p99] and does not see the motor. The firmware adds, for every ON pulse of a pattern, the charge t_on x 80 mA + 10 ms x 175 mA (the second term is the start allowance, an **[ESTIMATE]** until bench step B-M3 of motor-drive.md section 2.9 measures the start; each pulse is counted as a start **[CHOICE]**: an over-count if the motor still turns after a gap of 120 ms or more, which no file states). Per pattern [CALC, `design/firmware-f5-notes.md`]: M1 8.15 mA.s, M2 16.30, M3 24.45, MH 4.95, MT 3.75, MW 6.55, MF 51.50 mA.s. How the sum enters the gauge is section 8.3.
- Every motor pulse during audio capture is marked in the chunk headers, from MOTOR high to 50 ms after MOTOR low (section 4.7), so later cleanup can mute it. The pattern start time is also logged as an event.
- MT is the shortest pulse; whether 25 ms is felt is **[BENCH]** test F1 (wear test: 5 people feel or do not feel MT; if fewer than 4 feel it, MT becomes 40 ms).

### 3.2 Recording sign on the screen (architecture 17.30)

- **No recording light:** removed in v7 (architecture 17.30): LED1, R41, Q2, the light guide LG1, the light pipe LP1, the light window in the glass print and its plug are out of the design. The firmware had no light code before and has none now. The sign that a recording runs is the screen, drawn by the firmware.
- **R-SIGN, the screen is never dark while recording** (the lead's rule of 17.30): in `RECORDING` the screen is on from the start of the recording to its close and shows at least the red dot and the timer of this recording. Any input (any switch of the joystick) shows the full recording picture SCR_RECORDING for 3 s; 3 s after the last input it dims to SCR_REC_DIM (section 3.3) until the next input.
- **Dimmed** **[CHOICE]**: SCR_REC_DIM draws only the red dot and the timer HH:MM:SS on true black, at the lowest of the three levels of the setting "Screen brightness" (section 2.2); the timer is redrawn once per second.
- **One code path:** the function `rec_mics_on()` is the only code that enables VDD_MIC (section 4.5, start step 2). It first powers the screen if it is off (sequence of section 3.3) and draws the red dot and the timer at 00:00:00; it enables VDD_MIC only when the screen driver has accepted that frame (`display_write()` returned 0 and the display is not blanked). If it fails, VDD_MIC stays off and the row "long press of the joystick centre, recording sign not drawn" applies (section 1.2). The close turns VDD_MIC off before the screen may leave the recording pictures. Nothing in `RECORDING` blanks the screen or drives OLED_PWR_EN low: the screen-off timer, the lock of section 2.2 and the current-limit action of section 8.7 dim to SCR_REC_DIM instead.
- **Test SIGN-1** (proves that no state records with the screen dark), one of the state-machine tests of W12 (section 10.2): for every row of the table of 1.2, run from its From state with a screen stub that records blanking, OLED_PWR_EN and every frame; after the row, and at every 100 ms tick of a 10 s idle run after it, VDD_MIC on must mean OLED_PWR_EN high, the screen not blanked and the last frame holding the red dot pixels. A forced draw failure at the start must leave VDD_MIC off. One failing case fails the build. Factory test T-SIGN (section 9.3) checks the same on each ring with the jig camera.
- **Cost: a bench item, no number.** The always-lit red dot and timer draw current from the screen for the whole recording; the cost is measured on the new panel (bench, architecture 17.30) and is not counted in section 8.5. The 1.5 mA once counted for the recording light, removed in v7, is out of the budget (section 8.5).
- **What is lost** (architecture 17.30): the sign is drawn by software and is no longer wired to the microphone supply; a firmware fault or a panel that fails during a recording can leave a recording without a visible sign. SIGN-1 tests the firmware and T-SIGN the panel at the factory; nothing tests the panel during use.

### 3.3 Screen

Screen: 120 x 240 pixels, RGB565, portrait. The screen is off in every state except for the times stated (requirement P6); in `RECORDING` it is never dark (rule R-SIGN, section 3.2). Font: one bitmap font at 16 px and one at 32 px (for the timer). Colours: white text on black; red for the recording dot; amber for warnings.

| Screen | Shown in | Fields, top to bottom |
|---|---|---|
| SCR_STATUS | `STANDBY`, error states after their message | time (HH:MM), battery % with icon, "Ready", storage left as hours and minutes of audio, Bluetooth icon when bonded and connected |
| SCR_RECORDING | `RECORDING` (3 s after input) | red dot and "REC", timer HH:MM:SS of this recording, highlight count, battery %, storage left, "Hold 1 s to stop" |
| SCR_REC_DIM | `RECORDING`, from 3 s after the last input to the next input | red dot and timer HH:MM:SS only, true black elsewhere, lowest brightness level (section 3.2) |
| SCR_MENU | joystick from SCR_STATUS | 6 items of section 2.2, selected item highlighted |
| SCR_RECORDINGS | menu "Recordings" | list of the 20 newest: date, start time, duration, transferred tick |
| SCR_RECORDING_INFO | from SCR_RECORDINGS | date, start, duration, channels, highlights, size in MB, state (new, transferred, recovered) |
| SCR_SETTINGS | menu "Settings" | 4 settings of section 2.2 with their values |
| SCR_CONFIRM | "Power off", "Remove" on SCR_DEVICE | question, "Yes: short press centre", "No: left" |
| SCR_PAIR | menu "Pair device", when a slot is free | "Pair", 6-digit passkey (section 7.4), time left of 60 s |
| SCR_MODES | menu "Control" | the four control modes of section 7.5 in the order Media, Presenter, Pointer, Agent; the last used mode highlighted |
| SCR_CONTROL | an open control session in `STANDBY` (section 3.4) | mode name, name of the active device, "Not connected" while the active device has no level 4 link, "Press twice to leave" |
| SCR_DEVICES | menu "Devices" | the paired devices in slot order by name, the active one marked; "No device" when none is paired |
| SCR_DEVICE | from SCR_DEVICES | the device name, then two items: "Use", "Remove" |
| SCR_MESSAGE | refused actions, warnings | one line of text, 3 s ("Battery low", "Storage full", "30 min left", "In case", "Remove a device first") |
| SCR_CHARGING | `CHARGING` (5 s after insertion, 5 s after any input) | battery % and icon, "Charging" or "Full", time to full in minutes from the fuel gauge |
| SCR_TRANSFER | `TRANSFER` (5 s after start, 5 s after any input) | "Transfer", recordings left to send, percent of the current recording |
| SCR_ERROR | error states | error name, error code (event log code, section 9.4), "Put in case" for storage faults |
| SCR_RECOVERY | `RECOVERY` | "Recovering", chunks scanned |
| SCR_FACTORY | `FACTORY_TEST` | test name, step, result |

Screen power sequence (sch-notes sections 2 and 7 item 2, and section 9 item 1). VCI (VDD_3V0) and IOVCC (VDD_1V8) are on whenever the bucks run. The SGM38046 is in shutdown only when AVDDEN (OLED_PWR_EN) and SWIRE are both low; SWIRE is driven by the SH8501A, not by the nRF.
- On: (1) LCD_RST low; (2) OLED_PWR_EN high; (3) wait 10 ms; (4) LCD_RST high, wait 120 ms; (5) send the vendor start-up code, which makes the SH8501A drive SWIRE and so sets ELVDD and ELVSS; (6) DCS "sleep out", wait 120 ms, DCS "display on".
- Off: (1) DCS "display off"; (2) DCS "sleep in", wait 120 ms (the SH8501A stops SWIRE); (3) OLED_PWR_EN low; (4) LCD_RST low. The SGM38046 is then in shutdown (both inputs low).
- While the screen is off, OLED_PWR_EN is low in every state; LCD_SCK, LCD_MOSI, LCD_CS and LCD_DCX stay at their idle levels (IOVCC is on, so no line back-powers the screen).
- The waits and the SWIRE level of the SH8501A at reset come from the vendor start-up code (architecture action 12.1) and are listed in section 10.5.

### 3.4 Control session and device screens (F7 part 3, ruling R17)

- **Modes.** The menu item "Control" opens SCR_MODES. Right or Centre on a mode opens a **control session** in that mode and shows SCR_CONTROL. The first time, Media is highlighted.
- **Session.** The ring sends keys and pointer moves only in an open control session (section 7.5). In a session, Up, Down, Left, Right and a short press of the centre are sent to the active device as the mode's table says, and they do nothing else on the ring.
- **Leaving.** A double press of the centre closes the session and shows SCR_MODES (in `RECORDING`: SCR_RECORDING). The session also closes by itself after 30 minutes with no joystick action **[CHOICE]**, when the ring enters any state other than `STANDBY` and `RECORDING`, and when the active device is removed.
- **Screen.** SCR_CONTROL follows the normal rule: the screen turns off 5 s after the last input. The lock of section 2.2 does not apply in a session: with the screen off, an action is sent at once and also turns the screen on.
- **Recording.** A long press records as always (section 2.1) and does not close the session: this is the one exception to collision C2, which discards every other open screen. In `RECORDING` the screen shows SCR_RECORDING and SCR_REC_DIM as rule R-SIGN says, and SCR_RECORDING adds the mode's name. The four directions are sent, also from SCR_REC_DIM, and each shows SCR_RECORDING for 3 s. A short press of the centre is the highlight marker and is not sent.
- **No link.** While the active device has no level 4 link (section 7.4), an action sends nothing and SCR_CONTROL shows "Not connected". The ring advertises to the active device as section 7.3 says.
- **Devices.** The menu item "Devices" opens SCR_DEVICES. A device's name is the first 16 characters of its Bluetooth device name, read once after pairing and stored with its slot; a device with no name is shown as "Device 1", "Device 2" or "Device 3" by its slot. Right or Centre opens SCR_DEVICE. "Use" makes the device the active one (section 7.4) and returns to SCR_DEVICES. "Remove" asks on SCR_CONFIRM, then removes the device (section 7.4).
- **Pairing.** The menu item "Pair device" opens SCR_PAIR for the lowest free slot. With three paired devices it shows SCR_MESSAGE "Remove a device first". The first paired device becomes the active one; a later one becomes active only through "Use".
- **Core.** The states and the table of section 1.2 do not change. The session is a flag of the screens part that the control part reads. Software step 2 built the flag and the key tables; the screens come with software step 4.

## 4. Audio pipeline

### 4.1 PDM settings

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

### 4.2 Channel alignment (one PDM instance)

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

### 4.3 Buffers

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

### 4.4 Recording start and stop timing

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

### 4.5 Microphone power sequencing

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

### 4.6 RAM budget

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

### 4.7 Motor noise in the audio

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

## 5. Storage

### 5.1 Driver stack

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

### 5.2 Layout: raw, append-only log (no file system)

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

Sector map (512-byte sectors, LBA = sector number):

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

Chunk with sequence number s starts at LBA 81,920 + (s mod `chunk_count_total`) x 65.

### 5.3 Recording format, byte by byte

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

Chunk header:

| Offset | Size | Field | Value |
|---|---|---|---|
| 0 | 4 | magic | 0x4B435252 (ASCII "RRCK") |
| 4 | 2 | header_version | 1 |
| 6 | 2 | header_size | 512 |
| 8 | 4 | chunk_seq | global, starts at 1, +1 per chunk, never reused |
| 12 | 4 | recording_id | starts at 1, +1 per recording, never reused |
| 16 | 4 | chunk_in_recording | 0 for the first chunk |
| 20 | 2 | flags | bit 0 first chunk; bit 1 last chunk; bit 2 reserved (0); bit 3 a motor interval (section 4.7) touches this chunk; bit 4 a sample clipped (-32768 or 32767); bit 5 time not set; bit 6 battery at B15 or under; bit 7 dropout (a PDM block replaced by zeros); bits 8 to 15 zero |
| 22 | 1 | recording_type | 1 recording (the only type); 2 factory test recording (section 9.3) |
| 23 | 1 | channels | 2 |
| 24 | 4 | sample_rate_hz | 16,000 |
| 28 | 1 | sample_format | 1 = signed 16-bit little-endian, interleaved |
| 29 | 1 | mic_mask | 0x03 (bit n set = mic n+1 present, channel order ascending) |
| 30 | 2 | reserved | 0 |
| 32 | 4 | frames | valid frames in this payload |
| 36 | 4 | payload_bytes | frames x channels x 2 |
| 40 | 8 | first_frame_index | frames since the first kept frame of this recording |
| 48 | 8 | utc_ms | Unix time in ms of the first frame, signed; 0 when time is not set |
| 56 | 8 | uptime_ns | ns since boot of the first frame (cycle counter based) |
| 64 | 4 | reserved | 0 (F2 held the PDM skew here; one instance has none) |
| 68 | 4 | pdm_clock_hz | 1,280,000 |
| 72 | 2 | pdm_ratio | 80 |
| 74 | 1 | gain_code | 0x28 (the PDM gain register, 0 dB, section 4.1) |
| 75 | 1 | reserved | 0 |
| 76 | 2 | highlight_count | highlights in this chunk, 0 to 8 |
| 78 | 2 | reserved | 0 |
| 80 | 32 | highlight_frame | 8 x 4 bytes: frame offset inside this chunk of each highlight; 0xFFFFFFFF when unused |
| 112 | 2 | battery_mv | battery voltage at the chunk start |
| 114 | 2 | temp_c_x10 | nPM1304 die temperature [NPM p99], 0.1 °C, signed |
| 116 | 4 | boot_count | from the superblock |
| 120 | 4 | dropout_blocks | PDM blocks replaced by zeros in this chunk |
| 124 | 4 | fw_version | major << 24, minor << 16, patch |
| 128 | 4 | reserved | 0 |
| 132 | 4 | cycle_hz | `sys_clock_hw_cycles_per_sec()` used for the ns fields |
| 136 | 4 | reserved | 0 |
| 140 | 4 | reserved | 0 |
| 144 | 4 | motor_count | motor intervals in this chunk, 0 to 4; a fifth interval is merged into the fourth (end frame moved) |
| 148 | 32 | motor_frames | 4 x (start frame u32, end frame u32, exclusive) inside this chunk, end = MOTOR low + 50 ms; 0xFFFFFFFF pairs when unused |
| 180 | 324 | reserved | 0 |
| 504 | 4 | payload_crc32 | CRC-32 over the 32,768 payload bytes |
| 508 | 4 | header_crc32 | CRC-32 over header bytes 0 to 507 |

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

### 5.4 Superblock and index records

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

Index record (1 per sector at LBA 8,192 + (record number mod 65,536)):

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

A recording's state is its last record: CLOSE = new, CONFIRM = transferred, DELETE = deleted.

### 5.5 Write strategy and power loss

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

### 5.6 Free-space accounting

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

### 5.7 Deletion after confirmed transfer

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

## 6. Transfer protocol over USB (in the case)

### 6.1 Device class

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

### 6.2 Message layout

Every request and every response starts with this 16-byte header, followed by `length` payload bytes:

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

### 6.3 Commands

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

### 6.4 Resume and integrity

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

## 7. Bluetooth

F7 part 2 (2026-11-11). Standard Bluetooth services come first (`design/software/os/design.md` section 2): the ring is a Bluetooth keyboard, media remote and pointer for up to three paired devices, one of them active. The home-made link protocol (design/protocol/) stays paused; nothing of it is here. The iPhone services (notifications, media, time) enter this section with software step 3. What the software has built and tested of this section is listed in `firmware/docs/devices-control-notes.md` and `firmware/docs/step2-round3.md`; this section is the rule, built or not.

### 7.1 Stack and role

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

### 7.2 Services and characteristics

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

### 7.3 Advertising

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

### 7.4 Pairing, bonding, security

- LE Secure Connections only (`CONFIG_BT_SMP_SC_ONLY` [SRC 15]). IO capability: display only. The ring shows a 6-digit passkey on SCR_PAIR; the user types it on the other device. Result: authenticated, encrypted link = security mode 1, level 4.
- Pairing is accepted only while SCR_PAIR is open (60 s, opened from the menu, for one free slot; `CONFIG_BT_SMP_APP_PAIRING_ACCEPT`). Outside it, pairing requests are rejected.
- Paired devices: at most 3 (`CONFIG_BT_MAX_PAIRED=3`, `CONFIG_BT_ID_MAX=3`). Each has its own slot 0, 1 or 2, with one local Bluetooth identity and one bond per slot, stored with Zephyr settings in RRAM. F6 had 2 bonds and removed the oldest; F7 removes nothing by itself.
- With three paired devices SCR_PAIR does not open and a fourth pairing is refused. The wearer first removes a device on SCR_DEVICE (section 3.4).
- Removing a paired device deletes its bond (the keys of both sides) and ends its link.
- Active device: exactly one slot is active; the wearer picks it on SCR_DEVICE (section 3.4). A change of the active device ends the link, changes the local identity and advertises to the chosen device (section 7.3). A key or a pointer move is sent only over a level 4 link of the active device; from the change until that link is up, nothing is sent.
- Privacy on (`CONFIG_BT_PRIVACY` [SRC 15]), resolvable private address renewed every 15 minutes (`CONFIG_BT_RPA_TIMEOUT=900` [SRC 15]).

### 7.5 Control modes

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

## 8. Power management

### 8.1 nPM1304 settings (devicetree, Zephyr nPM13xx drivers)

The power chip is the Nordic nPM1304, U2, order code nPM1304-CAAA-R7 (architecture 17.13 and 17.18). Drivers: the Zephyr nPM13xx family `drivers/mfd/mfd_npm13xx.c`, `drivers/regulator/regulator_npm13xx.c`, `drivers/sensor/nordic/npm13xx_charger/npm13xx_charger.c` [SRC 11]. Fuel gauge: nRF Connect SDK library `nrf_fuel_gauge` [SRC 12]. The only nPM1304 binding text on disk is the charger page as quoted in `design/parts/research-npm1304.md` [SRC 17]; it confirms the compatible `"nordic,npm1304-charger"` and the properties `current-microamp`, `term-microvolt` and `term-current-percent`. Every other property name below is the F4 name of the same nPM13xx driver family and is marked **TO CONFIRM**: the firmware designer reads the nPM1304 binding files of the nRF Connect SDK version the build pins before work item W1 (section 10.5, item 3). Where the chip function behind a property is confirmed by the specification, the page is given. No property is added that F4 did not have, except the charger's compatible, which [SRC 17] confirms.

| Block | Setting | Value | Source of the property |
|---|---|---|---|
| Power chip node | `compatible`, bus, address | compatible of the MFD node TO CONFIRM; on `i2c22` at 400 kHz; 7-bit address 0x6B (110 1011) | address and "I2C compatible up to 400 kHz" [NPM p120]; compatible TO CONFIRM |
| | `host-int-gpios` | P1.28 (PMIC_INT), active high | TO CONFIRM |
| | `pmic-int-pin` | 0 (nPM1304 GPIO0, ball D6, drives PMIC_INT, netlist.csv) | TO CONFIRM |
| | `ship-to-active-time-ms` | 96 (the chip's default SHPHLD press time tshipToActive [NPM p117]; SHPHLD is on test pad TP19 and is not used in the field) | TO CONFIRM |
| BUCK1 (VDD_1V8) | `regulator-init-microvolt`, `regulator-boot-on`, `regulator-always-on` | 1,800,000; on; on (VSET1 47 kilo-ohm sets 1.8 V in hardware, architecture 17.18) | TO CONFIRM |
| | `regulator-initial-mode` | `NPM13XX_BUCK_MODE_AUTO` | TO CONFIRM |
| BUCK2 (VDD_3V0) | `regulator-init-microvolt`, `regulator-boot-on`, `regulator-always-on` | 3,000,000; on; on (VSET2 150 kilo-ohm sets 3.0 V in hardware, architecture 17.18) | TO CONFIRM |
| | `regulator-initial-mode` | `NPM13XX_BUCK_MODE_AUTO` | TO CONFIRM |
| LDSW1 (VDD_MIC, ball A4 LSOUT1) | `regulator-initial-mode` | `NPM13XX_LDSW_MODE_LDSW` (load switch) | TO CONFIRM |
| | `soft-start-microamp`, `active-discharge`, `regulator-boot-off` | 25,000; on; off at boot | soft-start levels 25, 50, 75, 100 mA and active discharge exist [NPM p77]; names TO CONFIRM |
| LDSW2 (VDD_SD, ball A5 LSOUT2) | `regulator-initial-mode` | `NPM13XX_LDSW_MODE_LDSW` | TO CONFIRM |
| | `soft-start-microamp`, `active-discharge`, `regulator-boot-off` | 50,000; on; off at boot | as LDSW1 [NPM p77]; names TO CONFIRM |
| Charger | `compatible` | `"nordic,npm1304-charger"` | [SRC 17] |
| | `term-microvolt` | 4,350,000 (4.35 V, the cell's type: architecture section 2; register BCHGVTERM value 9 = 4.35 V [NPM p36]; range 3.60, 3.65 and 4.00 to 4.65 V in 50 mV steps [NPM p29]) | [SRC 17] |
| | `current-microamp` | `CHARGE_CURRENT` = 15,000 (15 mA, architecture 17.13: 1 C of the smallest cell of the range, kept until the cell's maker states its own limit, open item S12). The chip takes 4 to 100 mA in 0.5 mA steps [NPM p24, p29]. On the smallest cell, 17.6 mAh (US 7, architecture 17.26), 15 mA is 0.85 C; on the largest, 31.9 mAh (US 13), 0.47 C [CALC: 15 / 17.6 = 0.852, 15 / 31.9 = 0.470]. With the chip's accuracy of plus or minus 10 % [NPM p29] the current is 13.5 to 16.5 mA, at most 0.94 C on 17.6 mAh [CALC: 16.5 / 17.6 = 0.9375] | [SRC 17] |
| | `term-current-percent` | 10 (charging ends when the current falls under 10 % of `CHARGE_CURRENT`, 1.5 mA [CALC: 0.10 x 15]; the chip offers 10 %, the default, or 5 % [NPM p37, register BCHGITERMSEL]) | [SRC 17] |
| | `trickle-microvolt` | 2,900,000 (the default; the other value is 2.5 V [NPM p37, BCHGVTRICKLESEL]) | TO CONFIRM |
| | `vbus-limit-microamp` | 500,000 (VBUS input current limit; the chip limits at 100 mA or 500 mA, 95 mA and 495 mA minimum [NPM p17]) | TO CONFIRM |
| | `thermistor-ohms`, `thermistor-beta` | 10,000 (RT1, 10 kilo-ohm, on the nPM1304 NTC pin, ball D3, netlist.csv; where RT1 sits is hardware issue H12), 3,380 (B25/50 of the 10 kilo-ohm type the chip supports [NPM p24, Table 10]; the RT1 part must match it, section 10.5) | TO CONFIRM |
| | `thermistor-cold-millidegrees` | 0 (no charging at or under 0 °C) | limits settable from -20 to +60 °C [NPM p24]; TO CONFIRM |
| | `thermistor-cool-millidegrees` | 10,000 (cool region from 0 to 10 °C; the chip halves the charge current there, to 7.5 mA [NPM p25, Table 12; CALC: 0.5 x 15]) | TO CONFIRM |
| | `thermistor-warm-millidegrees` | 40,000 (warm region from 40 to 45 °C; full current, reduced termination voltage [NPM p25, Table 12]) | TO CONFIRM |
| | `thermistor-hot-millidegrees` | 45,000 (no charging at or over 45 °C) | TO CONFIRM |
| | `term-warm-microvolt` | 4,100,000 (charge voltage in the warm region, register BCHGVTERMR [NPM p36]) | TO CONFIRM |
| | `charging-enable` | on whenever VBUS is present (rule R-CHG, section 1.2; action "charge on" in every row into `CHARGING`; register BCHGENABLESET [NPM p22]) | TO CONFIRM |
| | `dietemp-stop-millidegrees`, `dietemp-resume-millidegrees` | 90,000, 80,000 (kept from F4; the chip's defaults are 110 °C and 100 °C [NPM p29]; 90 and 80 °C are rows of its example table [NPM p26, Table 13]) | TO CONFIRM |
| Battery discharge limit | none | the nPM1304 has no setting for it: its battery current limit IBATLIM is fixed (section 8.7). F4's discharge-limit row belonged to the older chip and is removed (architecture 17.22) | [NPM p28 to p30, p40] |

Charger rules (F5):
1. **Charging turns on.** Charging is on in every state where VBUS is present (R-CHG, section 1.2). First power: the nPM1304 leaves ship mode on VBUS (section 8.4) and `BOOT` turns the charger on before it mounts storage, so a ring leaving the factory charges the first time it sits in the case.
2. **`CHARGE_CURRENT` is one named constant**, set in one place, in microamps: 15,000. A build fails to compile when it is unset, above 17,600 (1 C of the smallest cell, 17.6 mAh, architecture 17.26), under 4,000 or over 100,000, or not a multiple of 500 [NPM p24]. The firmware disables the charger before it writes the current register and enables it after [NPM p24: "CHARGER must be disabled before changing the current setting in register BCHGISET"].
3. **Charge time per ring size** [CALC: capacity / 15 mA; this is the constant-current time, a lower bound: the constant-voltage end adds time until the current falls to 1.5 mA, and in the cool region the current is 7.5 mA and the time doubles]. The chip's charge timeout, 7 hours for constant current and constant voltage together [NPM p30], is above every row.

| Ring size | Battery (architecture 17.26, measured) | Charge time at 15 mA from empty [CALC] |
|---|---|---|
| US 7 | 17.6 to 23.5 mAh | 1.17 to 1.57 hours |
| US 8 | 18.9 to 25.3 mAh | 1.26 to 1.69 hours |
| US 9 | 20.3 to 27.1 mAh | 1.35 to 1.81 hours |
| US 10 | 21.2 to 28.3 mAh | 1.41 to 1.89 hours |
| US 11 | 22.1 to 29.5 mAh | 1.47 to 1.97 hours |
| US 12 | 23.0 to 30.7 mAh | 1.53 to 2.05 hours |
| US 13 | 23.9 to 31.9 mAh | 1.59 to 2.13 hours |

4. **Leaving ship mode on first power stays** (row `SHIP`, VBUS appears, section 8.4): the exit is by VBUS only.
5. The thermistor limits and the die-temperature limits stop and resume charging by themselves (rows above); they are not a reason to hold the charger off.

### 8.2 What is on in each state

| State | VDD_1V8 | VDD_3V0 | VDD_MIC | VDD_SD | Screen supply (OLED_PWR_EN) | HFXO | Radio | Wake sources |
|---|---|---|---|---|---|---|---|---|
| `SHIP`, `OFF` | off | off | off | off | off | off | off | VBUS only (section 8.4) |
| `BOOT`, `RECOVERY` | on | on | off | on | on in `RECOVERY` | on | off | runs to completion |
| `STANDBY` | on | on | off | off | when the screen is on | when the radio runs | advertising | the 4 direction inputs (JOY_UP, JOY_DOWN, JOY_LEFT, JOY_RIGHT) and BTN_REC when `CENTRE_SOURCE` is `SW2`, PMIC_INT, GRTC timer, radio |
| `RECORDING` | on | on | on | on | on for the whole recording (rule R-SIGN, section 3.2) | on | advertising | PDM blocks every 16 ms, as `STANDBY` |
| `CHARGING` | on | on | off | off | when the screen is on | when USB runs | off | PMIC_INT (VBUS removed, charge events), USB, inputs |
| `TRANSFER` | on | on | off | on | when the screen is on | on | off | USB, PMIC_INT, inputs |
| error states | on | on | off | off | when the screen is on | when the radio runs | per section 7.3 | as `STANDBY` |

Between events the application core sleeps in System ON idle (Zephyr idle thread); System OFF is not used, because the GRTC time and Bluetooth must keep running. The motor supply VMOT (U11) is on only while MOTOR is high, in any state; U11 stays on the cell and draws at most 1 µA when off, ship mode included (motor-drive.md section 2.7).

### 8.3 Battery measurement

- The nPM1304's system monitor measures the battery voltage, the battery current and the thermistor [NPM p99, section 7.1]. The charger sensor driver gives voltage, current and temperature channels (`SENSOR_CHAN_GAUGE_VOLTAGE`, `SENSOR_CHAN_GAUGE_AVG_CURRENT`, `SENSOR_CHAN_GAUGE_TEMP`) [SRC 11; that the family driver serves the nPM1304 is TO CONFIRM, section 10.5 item 3]. Each sample feeds `nrf_fuel_gauge_process()`, which returns the state of charge [SRC 12]; `nrf_fuel_gauge_tte_get()` and `nrf_fuel_gauge_ttf_get()` give time to empty and to full [SRC 12].
- **The motor's charge is added.** The chip measures the battery current inside its own path [NPM p99]; the motor draws from the cell through U11, outside that path (section 3.1). The motor player sums the charge of every pulse since the last sample (t_on x 80 mA + 10 ms x 175 mA per pulse, section 3.1; the allowance is an **[ESTIMATE]** until bench step B-M3 measures the start). The current fed to the gauge is I_fed = I_measured + Q_motor / t_sample, counted as a discharge [CALC example: one MF, 51.50 mA.s, in a 1 s sample adds 51.5 mA to that sample]. The sign the library expects for a discharge is TO CONFIRM (section 10.5, item 32). U11 is a linear regulator, so its input current equals the motor current within its own small ground current (motor-drive.md section 2.5).
- Sampling: every 1 s in the recording states (thresholds use the mean of the last 10), every 60 s in the other awake states (thresholds use the single sample). Every sample also reads the battery current limit status (section 8.7).
- The battery current during a discharge has a full scale of 140 mA [NPM p99]; the chip path stays at or under 55.7 mA with every load on (architecture 17.22).
- The fuel gauge needs a battery model of the actual cells; Nordic makes it with its nPM PowerUP application [NPM p99]. One model per ring size or one for all is open (section 10.5, item 4).

### 8.4 Ship mode entry and exit (nPM1304 ship task after VBUS removal, [NPM p116])

The nPM1304 enters ship mode through its task register TASKENTERSHIPMODE [NPM p118]. Its specification states: "When VBUS is not present, the device enters Ship mode immediately. The host software must wait until EVENTSVBUSIN0SET on page 136 to ensure VBUS is disconnected and discharged before writing to the register" [NPM p116]. EVENTSVBUSIN0SET holds the event EVENTVBUSREMOVED, "VBUS removed" [NPM p136]. There is no timer: the firmware does not use hibernate (TASKENTERHIBERNATE), and F4's timed hibernate is removed.

Entry, in this order, for `SHIP` (FACTORY sub-commands SHIP_ENTER and SHIP_SAMPLE, section 9.3) and for `OFF` (menu "Power off", or B2):
1. Close everything (recording, storage, USB, radio, screen); save the settings and the time in RRAM. SHIP_ENTER first clears the factory flag; SHIP_SAMPLE keeps it at 1.
2. Write SHPHLDCONFIG with the default press time (96 ms) and trigger TASKSHPHLDCFGSTROBE: the specification requires both before ship mode [NPM p116, p118].
3. If VBUS is present, wait for the event EVENTVBUSREMOVED (register EVENTSVBUSIN0SET, [NPM p136]), reported on PMIC_INT. While it waits the ring does nothing else: no screen, no radio, no storage, the USB stack is disabled on `UDC_EVT_VBUS_REMOVED` (section 8.6). Only the factory commands reach this step with VBUS present: every row into `OFF` starts from a state without VBUS (section 1.2).
4. Write TASKENTERSHIPMODE = 1 [NPM p118]. The chip isolates the battery and the main chip loses its supply.
5. If the main chip still runs 1 s after step 4 **[CHOICE]**, it logs the event and goes back to step 3 once; the jig of section 9.3 sees advertising stop or not and reports a fail.

Exit: a voltage on VBUS above VBUSPOR, 3.9 V [NPM p17, p116]. Holding SHPHLD low for 96 ms also wakes the chip [NPM p116, p117], but SHPHLD sits on test pad TP19 (netlist.csv), which is closed under the board after assembly step 17, so in use only the case wakes the ring. After a wake the chip resets and sets the bit SHIPMODEEXIT in RSTCAUSE [NPM p146]; `BOOT` logs it (section 8.7).

Current in ship mode: 370 nA typical for the nPM1304 [NPM p11] plus U11, at most 1 µA (motor-drive.md section 2.7). The cell protection circuit's own drain is not stated (S12).

### 8.5 Expected current per state (architecture 17.15, 17.19 and 17.26, the current ring)

| | Recording | Standby |
|---|---|---|
| From the cell | about 4.1 mA [CALC: 4.0 + 2 x (0.63 - 0.58)] | about 0.03 mA |
| Hours on the smallest cell, 17.6 mAh at US 7 [CALC] | 4.3 | 587 (24.4 days) |
| Hours across US 7 to 13, 17.6 to 31.9 mAh [CALC] | 4.3 to 7.8 | 587 to 1,063 (24.4 to 44.3 days) |
| Hours at a Plaud's 13 mA, 17.6 to 31.9 mAh [CALC] | 1.4 to 2.5 | |

Recording current: architecture 17.15 and 17.17 used 4.0 mA, which counts the old microphones at 2 x 0.58 mA; the SPK0641HT4H-1 draws 0.63 mA at 1.8 V [DS line 97], so F5 uses 4.0 + 2 x (0.63 - 0.58) = 4.1 mA. This counts the 0.10 mA rise as if drawn from the cell, an over-count: through the 1.8 V rail it is 2 x 0.05 x 1.8 / (3.8 x 0.9) = 0.05 mA from the cell [CALC]. Recording hours: 17.6 / 4.1 = 4.29 and 31.9 / 4.1 = 7.78. At 13 mA: 17.6 / 13 = 1.35 and 31.9 / 13 = 2.45. Standby at 0.03 mA: 17.6 / 0.03 = 587 hours = 24.4 days and 31.9 / 0.03 = 1,063 hours = 44.3 days. Per ring size at 4.1 mA [CALC, `design/firmware-f6-notes.md`]:

| Ring size | Battery (architecture 17.26, measured) | Recording hours at 4.1 mA |
|---|---|---|
| US 7 | 17.6 to 23.5 mAh | 4.29 to 5.73 |
| US 8 | 18.9 to 25.3 mAh | 4.61 to 6.17 |
| US 9 | 20.3 to 27.1 mAh | 4.95 to 6.61 |
| US 10 | 21.2 to 28.3 mAh | 5.17 to 6.90 |
| US 11 | 22.1 to 29.5 mAh | 5.39 to 7.20 |
| US 12 | 23.0 to 30.7 mAh | 5.61 to 7.49 |
| US 13 | 23.9 to 31.9 mAh | 5.83 to 7.78 |

Architecture 17.26 gives the same hours at 4.1 mA, rounded to one decimal (4.3 to 7.8 across the sizes).

Caveat, from architecture section 4 and 16.8: the main-chip, storage, radio and power-chip lines are estimates, not datasheet values, and bench test B2 replaces them; the microphone line is from the Knowles datasheet copy at its 2.4 MHz test clock, not at the ring's 1.280 MHz (section 10.5, item 6). The recording light is removed in v7 (architecture 17.30): the 4.0 mA of architecture 17.15 counted 1.5 mA for it, so without the light the computed recording figure is 4.1 - 1.5 = 2.6 mA [CALC] plus the always-lit red dot and timer of section 3.2, whose cost is a bench item on the new panel (architecture 17.30) with no number yet. The thresholds of 1.1 and the hours of this section stay computed at 4.1 mA, the figure of architecture 17.26, until that bench result and a restated architecture figure **[CHOICE]**; 4.1 mA no longer counts a light. It excludes the motor (section 3.1) and the screen. **Requirement P2 (10 hours of recording) is NOT met by this ring**: the owner chose thinness over hours on 2026-11-10 (architecture 17.5). In every state other than `RECORDING` the microphones are off.

**R19 (the recording figure after v7, the lead's ruling after design review 3).** The 4.1 mA of this section stays the planning figure and now reads: 2.6 mA computed for the ring with the light removed, plus an allowance of 1.5 mA for the lit sign of section 3.2 (the red dot and the timer at the lowest brightness level). The allowance equals the removed light's 1.5 mA and is not measured. Bench test B2 measures the recording current with the sign shown. If the sign costs more than 1.5 mA, the hours of this section and the thresholds of section 1.1 are computed again from the measured figure (hours = cell capacity / current).

### 8.6 Pads on the inside of the band touch the skin (architecture 17.12)

The four pads are on the inside face of the band and touch the finger whenever the ring is worn, with no case present. What the firmware does:
1. **VBUS is an input only.** No GPIO, no regulator and no charger function of the firmware drives a voltage onto VBUS; nothing is driven onto any pad when no case is present. The only source of voltage on VBUS is the case.
2. **D+ and D- are not driven while worn.** The USB device stack is enabled (`usbd_enable()`) only after the power chip reports VBUS (`UDC_EVT_VBUS_READY`) and disabled (`usbd_disable()`) on `UDC_EVT_VBUS_REMOVED`; with VBUS absent the stack is off and the firmware sets no level on D+ or D- (what the chip's USB pins do when the peripheral is off is listed in section 10.5, item 29).
3. **A case is recognised only by VBUS** as reported by the power chip: no test pulse, no probing of the pads, no resistance measurement.
4. GND: nothing.
What the firmware does not do:
- It cannot tell skin or sweat from a case except through the power chip's own VBUS detection: VBUS counts as valid at 210 mV above VBAT, rising [NPM p17, VBUSVALIDR], and wakes the chip from ship mode above 3.9 V [NPM p17, VBUSPOR] (section 10.5, item 30). A voltage that high on the pads is treated as a case: in `RECORDING` it closes the recording (row `RECORDING`, VBUS appears).
- It does not protect the pads from corrosion or leakage through sweat: that is the wiring notes and the plating (17.12: gold-plated, flush with the liner), hardware issue H14.
- It has no switch of its own that opens the pads: whether a hardware switch is needed is for the wiring notes (17.12).

### 8.7 Battery current limit and reset causes of the nPM1304

- **The limit is fixed.** The nPM1304 limits the current it draws from the battery: IBATLIM, "Discharging battery current limit", 100 mA in the minimum column, "Validated through simulation" [NPM p29 and its footnote, p30]; the maximum VSYS load from the battery is also 100 mA [NPM p11]. No register sets it. Nordic: "It has not been designed for accurate current limiting", and "If the system load exceeds the discharge current limit, VSYS voltage drops below VSYSPOF causing the device to reset" [NPM p28].
- **What passes it.** Since 17.22 the motor does not. With the screen at full white, the radio, recording and a storage write together, the chip path stays at or under 55.7 mA down to 3.1 V (architecture 17.22; motor-drive.md section 2.4).
- **The status bit and what the firmware does.** Register BCHGILIMSTATUS, field BCHGILIMBATACTIVE, "Discharge current limiter active" [NPM p40]. The specification read names no interrupt for it, so the firmware reads it with every battery sample (section 8.3: every 1 s in `RECORDING`, every 60 s in the other awake states). When it reads ACTIVE:
  1. an event log record "battery current limit active" with battery_mv, the state and whether the screen is on;
  2. the screen goes off at once and stays off for 10 s, except in `RECORDING`, where it shows SCR_REC_DIM for those 10 s and never goes dark (rule R-SIGN, section 3.2) **[CHOICE]**: the screen is the largest load on the chip's path (motor-drive.md section 4);
  3. a recording goes on: nothing is closed and nothing is refused, because only a long press stops a recording (owner's rule) and a reset would end in `RECOVERY` anyway (section 5.5);
  4. no motor pattern is played for it.
  When it reads ACTIVE again with the screen already off, the event is logged once more with a count and nothing else changes.
- **Reset causes.** `BOOT` reads the nPM1304 register RSTCAUSE [NPM p146] (bits SHIPMODEEXIT, BOOTMONITORTIMEOUT, WATCHDOGTIMEOUT, LONGPRESSTIMEOUT, THERMALSHUTDOWN, VSYSLOW, SWRESET) and the charger error log CHARGERERRREASON and CHARGERERRSENSOR [NPM p146], writes them into the event log beside the main chip's own reset reason (section 9.4), then clears them with TASKCLRERRLOG [NPM p145]. VSYSLOW means a power-fail reset (VSYS under VSYSPOF): a load above the limit or an empty cell. After a thermal shutdown VSYSLOW can be set instead of THERMALSHUTDOWN [NPM p144].
- **Power-fail warning: not used** **[CHOICE]**. POFCONFIG stays at its reset value (warning off) and VSYSPOF at its default falling threshold, 2.7 V [NPM p109]. The warning needs a power-chip GPIO wired to the main chip [NPM p107, p108]; the only one wired is GPIO0, which is PMIC_INT (netlist.csv). B2 at 3.30 V closes the files first (section 1.1).

## 9. Time keeping, firmware update, factory test, logging

### 9.1 Time keeping

- Base: the GRTC system timer of the nRF54LM20A [SRC 1] running from the 32.768 kHz crystal (20 ppm, architecture section 2: up to 1.73 s per day [CALC: 20e-6 x 86,400]).
- Wall time = GRTC uptime + a UTC offset. The offset is set by USB SET_TIME at every case insertion and by the Bluetooth Time characteristic.
- In `SHIP` and `OFF` the chip has no power and time is lost. The last time is saved in RRAM on entry; after the next boot the ring uses it as a guess, marks the time "not set" (chunk flag bit 5, `utc_ms` = 0) and shows "--:--" until the next SET_TIME. Since every wake comes from VBUS, the case sets the time at once.

### 9.2 Firmware update over USB, with rollback

- Boot loader: MCUboot, with the Zephyr image API `boot_request_upgrade()`, `boot_is_img_confirmed()`, `boot_write_img_confirmed()` [SRC 13] and image writing through `subsys/dfu/img_util/flash_img.c` [SRC 10].
- RRAM layout, 2,036 KB in total [SRC 1]: MCUboot 64 KB at 0x00000000; slot 0 (running image) 976 KB at 0x00010000; slot 1 (update) 976 KB at 0x00104000; settings (bonds, user settings, saved time, factory flag) 20 KB at 0x001F8000 [CALC: 64 + 976 + 976 + 20 = 2,036].
- MCUboot mode: swap using move, so an image that is not confirmed is swapped back at the next reset.
- **Boot loader locked against USB writes** (assembly conflict K-A1, applied). After assembly step 17 only the four pads reach the chip, and a broken boot loader would scrap the ring. Rules: (1) the USB update path (FW_BEGIN, FW_DATA, FW_END) writes only slot 1, 0x00104000 to 0x001F7FFF: FW_BEGIN refuses an `image_size` above 976 KB (999,424 bytes) and FW_DATA refuses an offset plus length past it, both with BAD_ARG; (2) no command writes the MCUboot area (0x00000000 to 0x0000FFFF) or slot 0, so MCUboot itself is never updated in the field; (3) the settings area is written only by the settings subsystem; (4) the MCUboot area is also write-protected by the chip's own memory protection, set over SWD at assembly step 5 before the board leaves its test pads. The nRF54LM20A mechanism for (4) and its register are TO CONFIRM (section 10.5, item 33); until it is confirmed, rules (1) to (3) carry the lock [CALC: 0x00104000 + 976 x 1,024 = 0x001F8000].
- Sequence: the case sends FW_BEGIN (erase slot 1), FW_DATA blocks of 4,096 bytes, FW_END. The ring checks the image CRC-32, calls `boot_request_upgrade(BOOT_UPGRADE_TEST)` and reboots. MCUboot checks the signature and swaps.
- Self-test of the new image, at most 30 s after boot: storage mounts, Bluetooth enables, USB enumerates again if VBUS is present. The microphones are not powered in the self-test (they are on only while a recording is stored); a PDM fault in the first recording after an update leads to `ERR_MIC_FAULT` and an event log record. All pass: `boot_write_img_confirmed()`. Any fails, or 30 s pass: reboot without confirming, and MCUboot restores the old image.
- Update allowed only with the battery above 30 % or VBUS present (always true in the case).

### 9.3 Factory test mode

- Entry: USB FACTORY sub-command 0x01 (ENTER) while the factory flag in settings is 1. The flag is written when the factory first programs the ring (assembly step 5), and cleared only by SHIP_ENTER (sub-command 0x7F). SHIP_SAMPLE (0x7E) enters ship mode and keeps the flag, for sample rings only, so a ring woken for a sample check can be tested again (assembly conflict K-A7). With the flag clear, FACTORY returns NOT_ALLOWED.
- Each test is a FACTORY sub-command; the response is result u8 (0 pass, 1 fail, 2 timeout) plus the measured values. The jig decides pass or fail with the limits below.

| Sub | Test | Part | Method | Pass |
|---|---|---|---|---|
| 0x10 | T-MIC1, T-MIC2 (argument 1 or 2) | each microphone | a 2 s test recording (recording_type 2) through the normal path while the jig speaker plays 1 kHz; report RMS level of each channel in dBFS and the count of identical consecutive samples | the tested channel within 3 dB of the mean of the 2; no channel stuck (no run of 1,000 equal samples); tapping only mic n raises channel n first (checks the channel map, section 4.1) |
| 0x20 | T-SCREEN | screen | full red, green, blue, white, black, 1 s each, then a grid | jig camera sees each colour, no dead row or column |
| 0x30 | T-JOY | joystick, 4 directions and the centre | the jig presses up (SW1), down (SW3), left (SW4), right (SW5) in turn; then the centre by the build's `CENTRE_SOURCE`: case `SW2`, SW2 alone; case `PAIR`, SW1 with SW3 and then SW4 with SW5, each pair closed within 20 ms of each other; then a roll test: centre held, SW4 closed 300 ms later, everything released after 1,200 ms | each direction within 1 s of its press, no other event; the centre reported once per press (twice in case `PAIR`), a centre press gives no up, down, left or right; the roll test gives one held centre of about 1,200 ms and no direction |
| 0x31 | T-CENTRE | the centre press as the record gesture | jig presses the centre once, twice (200 ms gap), and long (1,500 ms) | ring reports single, double, long, and the pulse MW at 500 ms of the long press; factory test mode reports the events and never starts a recording |
| 0x40 | T-MOTOR | motor | the power chip's ADC reads VBAT once before MOTOR goes high; MOTOR on 500 ms; VBAT read again 250 ms into the pulse; the ring reports both and the dip. The chip's battery current is not used: the motor's current does not pass the chip (section 3.1; motor-drive.md change F5) | jig accelerometer sees vibration; VBAT drops during the pulse by 20 mV or more **[ESTIMATE]**: 80 mA through 0.25 ohm of cell, protection circuit and ribbon; bench step B-M5 of motor-drive.md section 2.9 measures the real dip and then fixes this line |
| 0x41 | T-SIGN | recording sign on the screen (rule R-SIGN, section 3.2; replaces the light test, the light is removed in v7) | two 1 s test recordings 1 s apart; the ring reports the times VDD_MIC went on and off; the jig camera films the screen | in every camera frame between VDD_MIC on and VDD_MIC off the red dot is lit; no such frame shows a dark screen |
| 0x50 | T-STORE | storage | VDD_SD on, init, write 65 sectors at LBA 4,096, read back, compare CRC; time both; then delete every test recording (recording_type 2) the jig made | data equal; write at least 0.5 MB/s; read at least 1.0 MB/s; no test recording left |
| 0x60 | T-RADIO | radio | advertise 10 s at 0 dBm, 100 ms interval | jig RSSI at 20 cm at or above -60 dBm |
| 0x70 | T-CHARGE | charger | with VBUS, read the charge state (BCHGCHARGESTATUS [NPM p40, p41]), the latched errors (BCHGERRREASON [NPM p41]) and the battery current; the result is fail when the state is off or an error is latched (rule R-CHG) | state trickle, constant current, constant voltage or completed; in constant current the current is 13.5 to 16.5 mA [CALC: 15 mA plus or minus 10 %, NPM p29]. At the board stage (assembly step 5) the jig's battery source sets what is seen, so only the state is judged there |
| 0x71 | T-XTAL | 32.768 kHz crystal | count GRTC against the USB start-of-frame count over 10 s | within 50 ppm |
| 0x7E | SHIP_SAMPLE | | sample rings only: keep the factory flag; ship mode: the ring waits for VBUS removal, then writes TASKENTERSHIPMODE (section 8.4) | VBUS removed: no advertising for 60 s; VBUS back: the ring wakes and FACTORY ENTER works again |
| 0x7F | SHIP_ENTER | | clear the factory flag; ship mode: the ring waits for VBUS removal, then writes TASKENTERSHIPMODE (section 8.4) | VBUS removed: no advertising for 60 s (assembly step 27) |

Sub-command 0x11 (the F2 skew test) is removed in F3: the ring answers BAD_ARG. Sub-command 0x41 is T-SIGN: the light and its test are removed in v7 (architecture 17.30).

Factory flow, step by step of `design/mfg/assembly/assembly.md` (the jig is work item W13):

| Assembly step | Stage | Access | What the firmware is asked to do or pass | Not tested here, and why |
|---|---|---|---|---|
| 5 | board | SWD on test pads TP3 SWDCLK, TP4 SWDIO, TP5 NRESET; USB on the J_BAND_B lands; the jig feeds a battery voltage on the cell lands and 10 kilo-ohm on the thermistor land | write and read back MCUboot, the image and the settings with the factory flag 1; set the boot loader lock (section 9.2); GET_INFO; T-STORE, T-XTAL, T-RADIO, T-MIC1, T-MIC2, T-CHARGE (state only) | T-SCREEN, T-SIGN, T-JOY, T-CENTRE, T-MOTOR: the screen, the switches and the motor are not joined yet. T-MIC1, T-MIC2: ruling R18 below. This is the last SWD access of the ring's life |
| 16 | ribbons joined, cell live | USB through the pads CP1 to CP4 | the ring boots to `STANDBY` on its cell (no VBUS); with VBUS on the pads it goes to `CHARGING`, enumerates and GET_INFO answers | |
| 18 | open ring | USB through the pads; FACTORY ENTER | every test: T-SCREEN, T-JOY, T-CENTRE, T-MOTOR, T-MIC1, T-MIC2, T-SIGN, T-STORE, T-RADIO, T-XTAL, T-CHARGE | |
| 20 | joystick pocket dammed | as step 18 | T-JOY, T-CENTRE | |
| 21 | liner cast | as step 18 | USB enumerates; T-JOY, T-CENTRE, T-MOTOR | |
| 24 | after the leak dip | as step 18 | T-MIC1, T-MIC2, T-SCREEN; USB enumerates | |
| 25 | closed ring | as step 18 | every test again, then the cell-only check below | |
| 26 | first charge | VBUS on the pads | charge to 50 percent before ship mode **[PROPOSED]** (below) | |
| 27 | ship | VBUS on the pads, then removed | SHIP_ENTER, then the jig removes VBUS; sample rings get SHIP_SAMPLE instead | |

- **R18 (microphones in the factory, the lead's ruling after design review 3):** a microphone gets power only through `rec_mics_on()`, after the screen shows the recording sign (rule R-SIGN, section 3.2). Factory test mode has no other path. At step 5 no screen is joined, so T-MIC1 and T-MIC2 do not run there; they run first at step 18 and again at steps 24 and 25. Cost: a microphone fault is found at step 18, after the ribbons are joined, and no longer on the bare board.
- Cell-only check of step 25 **[PROPOSED by assembly step 25]**: the jig sends FACTORY_EXIT (the ring reboots into `CHARGING`) and reads `boot_count` n with GET_INFO; it removes VBUS (`CHARGING` to `STANDBY`, no reboot); a long press starts a recording with M1 and a second long press stops it with M2; it puts VBUS back (`STANDBY` to `CHARGING`); GET_INFO must give n again, and GET_LOG must show no power-chip reset cause (section 8.7). Then the jig lists the recording, confirms it with its digest and deletes it (section 5.7), so the ring ships empty. FACTORY_EXIT comes first because removing VBUS in `FACTORY_TEST` reboots the ring (section 1.2), which would add 1 to the count.
- First charge of step 26 **[PROPOSED by assembly step 26]**: the charger runs at `CHARGE_CURRENT`, 15 mA, to 4.35 V; the jig reads GET_BATTERY until the state of charge reaches 50 percent (500 in `soc_percent_x10`), then goes to step 27. From an empty cell that takes about 0.59 to 1.06 hours across US 7 to 13 [CALC: 0.5 x 17.6 / 15 = 0.587 and 0.5 x 31.9 / 15 = 1.063]. The cell's maker may set another storage level (S12); the reading depends on the battery model (section 10.5, item 4).
- Ship of step 27: SHIP_ENTER, then VBUS removed; the ring writes TASKENTERSHIPMODE only after the event EVENTVBUSREMOVED (section 8.4). The jig checks that no advertising is seen for 60 s.

### 9.4 Logging and crash capture

- Development builds: Zephyr logging to `uart20` on DBG_TX P1.15 / DBG_RX P1.16 at 115,200 baud. Production builds: no UART output; DBG_TX and DBG_RX are inputs with pull-down.
- Event log (both builds): each state change, fault, battery threshold and transfer command becomes a 512-byte record: magic 0x474C5252 ("RRLG") u32, record seq u32, uptime_ns u64, utc_ms i64, code u16, state u8, reserved u8, 16 bytes of arguments, crash block (below, zero when not a crash), CRC-32 in the last 4 bytes. Records wait in the 4 KB RAM log buffer (8 records) and are written to the log area (LBA 2 to 2,047) at the next time VDD_SD is on; when the buffer is full, the oldest unwritten record is dropped and a "dropped" count is kept.
- Crash capture: `k_sys_fatal_error_handler()` is overridden to write a crash block (fault reason u32, PC u32, LR u32, PSR u32, thread name 16 bytes, 64 words of the faulting stack) into 1 KB of retained RAM (`zephyr,retained-ram`, `drivers/retained_mem/retained_mem_zephyr_ram.c` [SRC 10]) and the reset reason code into `gpregret1` [SRC 1], then reboot. `BOOT` copies a valid crash block into the event log and clears it.
- Power-chip reset causes: `BOOT` writes the nPM1304's RSTCAUSE and charger error log into the event log, then clears them (section 8.7).
- Watchdog: `wdt31`, 8 s timeout, fed every 1 s by the main loop only when the audio and storage threads have reported progress in the last 2 s.

## 10. Work breakdown

### 10.1 What exists in the SDK

| Module | SDK part | Source |
|---|---|---|
| PDM capture, 1 instance (`pdm20`) | `drivers/audio/dmic_nrfx_pdm.c` with nrfx `nrfx_pdm` | SRC 2, SRC 4 |
| SD card over SPI | `drivers/sdhc/sdhc_spi.c`, `drivers/disk/sdmmc_subsys.c`, disk access API | SRC 6, SRC 7 |
| USB device, high speed | `drivers/usb/udc/udc_dwc2.c` + nRF54L glue, USB device stack "device_next" | SRC 5, SRC 8 |
| Power chip | nPM13xx MFD, regulator and charger drivers | SRC 11 |
| Fuel gauge | `nrf_fuel_gauge` library (nRF Connect SDK, nrfxlib) | SRC 12 |
| Joystick (five switches) | `gpio-keys` input driver | SRC 14 |
| Bluetooth | Zephyr host, BAS, DIS services | SRC 10, SRC 15 |
| Boot loader, update | MCUboot image API, `flash_img` | SRC 10, SRC 13 |
| Retained RAM, reset reason | `retained_mem_zephyr_ram.c`, `gpregret1` | SRC 1, SRC 10 |
| Display bus | MIPI DBI over SPI (`drivers/mipi_dbi/mipi_dbi_spi.c`), display library (LVGL module) | SRC 10 |
| Board start point | `boards/nordic/nrf54lm20dk` (nRF54LM20A application core) | SRC 9 |

### 10.2 What must be written

| Id | Module | Work |
|---|---|---|
| W1 | Board files `ring_nrf54lm20a` | devicetree with the pins of the table at the top, peripheral instances, nPM1304 node of section 8.1 (property names TO CONFIRM first), partitions of section 9.2; based on `nrf54lm20dk` |
| W2 | Screen driver `display_sh8501a.c` | **No Zephyr driver exists for the SH8501A**: `drivers/display/` (167 entries) and `dts/bindings/display/` (132 entries) list none [SRC 10]. Write a Zephyr display driver on MIPI DBI over SPI in 4-wire mode (LCD_DCX as data/command), RGB565, 120 x 240, with reset on LCD_RST, tear-effect input on LCD_TE, panel supply on OLED_PWR_EN, `display_write()` of partial areas, `display_blanking_on/off()`, brightness. Model: the AMOLED driver `display_rm67162.c`, which uses MIPI DBI and a TE GPIO [SRC 10]. Needs the SH8501A datasheet and the vendor start-up code (architecture action 12.1). SPI clock 8 MHz (the SPIM21 maximum [SRC 3]): a full frame of 57,600 bytes takes 57.6 ms [CALC] |
| W3 | Pin sleep states | patch to the dmic driver that applies the pin sleep state at boot and after stop, so MIC_A_CLK is low whenever VDD_MIC is off (section 4.5); `spi00` suspend and resume around VDD_SD (section 5.1) |
| W4 | Audio service | 2-channel chunk fill from the one PDM instance, dropout fill, motor interval marking |
| W5 | Storage service | raw log of section 5: chunk writer, superblock, index, recovery scan, free-space accounting, deletion |
| W6 | USB vendor class and protocol | class of section 6.1 with `USBD_DEFINE_CLASS`, command handlers, firmware update path |
| W7 | Bluetooth ring service | section 7.2 characteristics, fetch flow, pairing window UI |
| W8 | Power service | thresholds, fuel gauge loop with the motor's charge added (section 8.3), rail control, ship entry by TASKENTERSHIPMODE after VBUS removal (section 8.4), the battery current limit status and the reset causes (section 8.7) |
| W9 | Input gestures | centre key and both `CENTRE_SOURCE` cases (sections 2.1 and 2.2), gesture recogniser of section 2.1, warning pulse MW, joystick repeat, collisions C1 to C4, screen lock |
| W10 | Feedback | motor pattern player with the limits of section 3.1, the motor charge per pulse for the gauge (section 8.3), and the MOTOR edge times for section 4.7; the recording sign of section 3.2 with test SIGN-1 (no light code: the light is removed in v7) |
| W11 | User interface | the screens of section 3.3 |
| W12 | State machine | section 1, one table-driven module; every row of 1.2 is one test case |
| W13 | Factory test | section 9.3 sub-commands (SHIP_SAMPLE included), the factory flow by assembly step, the boot loader lock of section 9.2, jig protocol |
| W14 | Logging and crash | section 9.4 |
| W15 | Case-side reference tool | a host program that speaks section 6 over USB, for bench use before the case exists |

### 10.3 Order of work

W1, W12, W9, W10 on the development kit first; then W4 with the microphone evaluation boards on the kit; W5 with an SD NAND breakout on `spi00`; W6; W8 with Nordic's nPM1304-EK kit (architecture 17.18) and the motor adapter of motor-drive.md section 2.9; W2 when the screen samples and start-up code arrive; W7, W11, W13, W14 last.

### 10.4 Sources read for this document

| Id | Source (fetched 2026-11-10) |
|---|---|
| SRC 1 | Zephyr `dts/vendor/nordic/nrf54lm20_a_b.dtsi`, main branch: `pdm20` 0xd0000, `pdm21` 0xd1000, `spi00` 32 MHz, `spi21`/`i2c21` both 0xc7000, `usbhs` "nordic,nrf-usbhs-nrf54l", `grtc`, `tdm`, `wdt30`/`wdt31`, `gpregret1`/`gpregret2`, `cpuapp_sram` 511 KB, `cpuapp_rram` 2,036 KB |
| SRC 2 | Zephyr `drivers/audio/dmic_nrfx_pdm.c` and `include/zephyr/audio/dmic.h`, main |
| SRC 3 | nrfx `bsp/stable/mdk/nrf54l/nrf54lm20a/nrf54lm20a_types.h` (PDM ratios 48 to 192, PRESCALER divisor 4 to 126, GAINL 0x00 / 0x28 / 0x50, CLKSELECT PCLK32M / ACLK) and `nrf54lm20a_application_peripherals.h` (SPIM00 32 Mbit/s and 128 MHz core with divisor 4 to 126; SPIM20 to SPIM22 8 Mbit/s; USBHS present) |
| SRC 4 | nrfx `drivers/src/nrfx_pdm.c` (`nrfx_pdm_prescalers_calc()`) and `hal/nrf_pdm.h` |
| SRC 5 | Zephyr `drivers/usb/udc/udc_dwc2.c` and `drivers/usb/udc/udc_dwc2_nrf_usbhs_nrf54l.h` |
| SRC 6 | Zephyr `drivers/disk/sdmmc_subsys.c` (`zephyr,sdmmc-disk`, `DISK_IOCTL_CTRL_INIT`, `DISK_IOCTL_CTRL_DEINIT`) |
| SRC 7 | Zephyr `drivers/sdhc/sdhc_spi.c` and `drivers/sdhc/Kconfig.spi` (`zephyr,sdhc-spi-slot`, 400 kHz start, multi-block, CRC-16, `spi-max-frequency`) |
| SRC 8 | Zephyr `include/zephyr/usb/usbd.h`, `include/zephyr/usb/usbd_msg.h`, `subsys/usb/device_next/class/` listing |
| SRC 9 | Zephyr `boards/nordic/nrf54lm20dk/` listing, `nrf54lm20_a_b_cpuapp_common.dtsi`, `nrf54lm20dk_nrf54lm20_a_b-pinctrl.dtsi` |
| SRC 10 | Zephyr tree listing (GitHub API, main) and contents listings of `drivers/display` and `dts/bindings/display`; `drivers/display/display_rm67162.c` |
| SRC 11 | Zephyr `drivers/mfd/mfd_npm13xx.c`, `drivers/regulator/regulator_npm13xx.c`, `drivers/sensor/nordic/npm13xx_charger/npm13xx_charger.c`, bindings `nordic,npm13xx-common.yaml`, `nordic,npm13xx-charger-common.yaml`, `nordic,npm13xx-regulator-common.yaml`, `include/zephyr/dt-bindings/regulator/npm13xx.h` (fetched 2026-11-10 for F4; the chip-specific charger binding read then was that of the older chip, see the change list F4 to F5) |
| SRC 12 | nrfxlib `nrf_fuel_gauge/include/nrf_fuel_gauge.h`, main |
| SRC 13 | Zephyr `include/zephyr/dfu/mcuboot.h` |
| SRC 14 | Zephyr `dts/bindings/input/gpio-keys.yaml` |
| SRC 15 | Zephyr `subsys/bluetooth/host/Kconfig` and `subsys/bluetooth/common/Kconfig` |
| DS | Knowles SPK0641HT4H-1 datasheet Rev A, third-party copy, text `design/mech/mic-path/datasheets/knowles-spk0641ht4h-1_chipsmall.txt` (read 2026-11-11) |
| NPM | Nordic nPM1304 Product Specification v1.0, 173 pages, `design/datasheets/npm1304_datasheet_v1_0.txt` (read 2026-11-11: pages 8 to 11, 17, 22 to 30, 36, 37, 40, 41, 69, 77, 99, 107 to 109, 116 to 120, 130, 136, 144 to 146) |
| SRC 17 | `design/parts/research-npm1304.md` section 1, source [Z]: Nordic's nRF Connect SDK binding page `nordic,npm1304-charger` (processed text, not a raw copy): `current-microamp` 4 to 100 mA in 0.5 mA steps, `term-microvolt` 3.6 to 3.65 V and 4.0 to 4.65 V in 50 mV steps, `term-current-percent` default 10 |
| SRC 16 | Zephyr `drivers/usb/udc/udc_dwc2.c` (`udc_dwc2_device_speed()`, DSTS ENUMSPD), `subsys/usb/device_next/usbd_core.c` (`status.speed`), `usbd_ch9.c` (`fs_desc` / `hs_desc`), `usbd_device.c` (`usbd_bus_speed()`), `class/loopback.c`, main, fetched 2026-11-10 |
| DOC | `design/architecture.md` A5-draft (sections 2, 7, 9, 14, 16.4 to 16.6, 17.3 to 17.8 read 2026-11-10; 17.10 to 17.23 read 2026-11-11), `design/case/case-architecture.md` C1 (sections 1, 5, 6), `design/ecad/ring/sch-notes.md` (sections 2, 7, 8, 9; section 12 read 2026-11-11), `design/ecad/ring/netlist.csv` and `parts.csv` (2026-11-11), `design/ecad/motor-drive/motor-drive.md` section 2, `design/mfg/assembly/assembly.md`, `design/mech/mic-path/mic-path.md` sections 3 and 9 (2026-11-11) |

### 10.5 Facts not verified from a primary source

1. The nRF Connect SDK Bluetooth controller (SoftDevice Controller) supports the nRF54LM20A; only the Zephyr device file was read.
2. MCUboot "swap using move" works on the nRF54LM20A RRAM in the nRF Connect SDK, and which signature type the SDK uses by default there.
3. Devicetree names for the nPM1304: every property of section 8.1 marked TO CONFIRM (the compatible of the MFD and regulator nodes, `host-int-gpios`, `pmic-int-pin`, `ship-to-active-time-ms`, the regulator, load switch, thermistor, die-temperature, trickle, VBUS-limit and charging-enable properties), whether the nPM13xx family drivers of SRC 11 serve the nPM1304 (charger sensor channels, register read and write calls), and the driver call that writes a task register. Who answers: the firmware designer, from the nPM1304 binding files and drivers of the nRF Connect SDK version the build pins (not on disk), before work item W1. Closed by the nPM1304 specification: the I2C address 0x6B [NPM p120], the ship task and its VBUS rule [NPM p116, p118], the ship current 370 nA typical [NPM p11].
4. The fuel gauge needs a battery model of the actual Grepow cells; Nordic makes it with the nPM PowerUP application [NPM p99]. Whether one model serves the seven cell lengths of US 7 to 13 or each needs its own: the firmware designer with the cell maker (S12).
5. Which nRF PDM channel (left or right) receives U5 (SELECT on GND) and U6 (SELECT on VDD_MIC) under the driver's default map: the Knowles text copy shows the timing figure without naming the edge in words [DS Figure 1]. Factory test T-MIC checks it on every ring; the firmware designer reads the figure on the PDF page and confirms it on the development kit.
6. Microphone current at 1.280 MHz: the Knowles datasheet gives 630 µA typical at its 2.4 MHz test clock [DS line 97] and no figure at 1.280 MHz; bench test B2 measures it. The 0.58 mA of the old part in the subtraction of section 8.5 comes from F4 (architecture 16.8), not from a datasheet.
7. Closed in F3: one PDM instance has no start skew (bench test A1 and the F2 skew test are removed).
8. Closed in F3: one PDM instance, no drift between instances to verify.
9. The PDM clock pin level after `nrfx_pdm_stop()` (work item W3 makes it defined).
10. The SD SPI-mode clock limit of 25 MHz and the card start-up sequence (SD Physical Layer specification, not read).
11. Card start-up time and charge, write stall times, read and write speed in SPI mode, usable size and power-loss behaviour of the CSNP32GCR01-BOW (architecture 16.4; bench tests S1 and S2).
12. Whether the Zephyr SD stack issues one CMD25 for a multi-sector `disk_access_write()`; the SPI host driver supports it [SRC 7].
13. SH8501A command set, start-up code, timing of reset and sleep-out, and support of the standard DCS commands (architecture action 12.1).
14. Whether 25 ms motor pulses are felt (bench test F1), the motor spin-up time and the start allowance of 10 ms at 175 mA used for the fuel gauge (section 8.3): bench step B-M3 of motor-drive.md section 2.9. The T-MOTOR pass line of 20 mV is an estimate until bench step B-M5.
15. RAM use of the Bluetooth stack, the display library, thread stacks and the kernel (allocations in section 4.6; the first build's linker map checks them).
16. The cycle counter rate behind `k_cycle_get_32()` on this chip (stored in each chunk as `cycle_hz`, so the files stay correct whatever it is).
17. USB vendor id and product id for production (question for the owner).
18. Zephyr API names used here but not opened in this run: `k_sys_fatal_error_handler()`, `k_cycle_get_32()`, `k_cyc_to_ns_floor64()`, `sys_clock_hw_cycles_per_sec()`, `irq_lock()`, `crc32_ieee()`, `regulator_enable()`, `regulator_disable()`, `disk_access_write()`, `disk_access_read()`, `disk_access_ioctl()`, `DISK_IOCTL_GET_SECTOR_COUNT`, the compatible string `zephyr,retained-ram` (only the driver file name was seen), and the unit (seconds) of `CONFIG_BT_RPA_TIMEOUT` (only the option name was seen).
19. That the nRF54LM20A USBHS PHY completes enumeration at full speed with a full-speed host (case supplier item S2, case bench test B1); the Zephyr stack side is read [SRC 16].
20. The 1.216 MB/s full-speed bulk ceiling (USB 2.0 figure, not read here; taken from the case document).
21. Closed for the chip: in the cool region the nPM1304 halves the charge current, in the warm region it charges to the reduced voltage [NPM p25, Table 12]. Still open: the charge temperature range of the Grepow cell (the cell maker, S12) and the RT1 part, which must have B25/50 = 3,380 K to match the chip's 10 kilo-ohm type [NPM p24] (the schematic owner).
22. That suspending `spi00` with the Zephyr device power-management call applies its pin sleep state, and that the sleep state can set the pins as inputs with no pull.
23. The SWIRE level of the SH8501A at reset and after "sleep in" (sch-notes section 9 item 1).
24. Closed in F5: the microphone of 17.19 has a datasheet copy on disk; its clock range, power-up time and current are cited from it (sections 4.1, 4.5). The copy is a third-party host's copy of Knowles Rev A (2016): Knowles or a distributor confirms the part is still made (S23).
25. The SD-mode clock limit of the CSNP32GCR01-BOW in SPI mode (16 MHz is used) and that its 3.7 GB usable size is what `DISK_IOCTL_GET_SECTOR_COUNT` returns.
26. The fuel-gauge battery model for the curved cells of 17.6 to 31.9 mAh (architecture 17.26), the accuracy of its state of charge at 4.1 mA with the motor's charge added, and the cell's discharge limit against the motor start of 175 mA (hardware issue H7). Who answers: the cell maker (S12), then the bench.
27. Whether the centre key of section 2.2 reads a centre press reliably on the real round cap in both cases (bench item B6, architecture 16.5), whether the real switch SW2 fits under the centre of the round cap (architecture 17.11, 17.12), and whether the F4 values 30 ms release hold-off, 40 ms decision window in case `SW2`, MW at 500 ms and the 450 ms short-press ceiling suit a thumb at rest (all marked [CHOICE]).
28. How the 120 x 240 screen, whose long side lies along the finger (architecture 16.1), is rotated by the display driver; F3 keeps the screen layouts of section 3.3.

29. What the nRF54LM20A's USB pins do when the USB peripheral is disabled and no VBUS is present (section 8.6, item 2); only the Zephyr stack side is stated.
30. Read in F5: VBUS is valid at 210 mV above VBAT and wakes the chip above 3.9 V [NPM p17]. Not read: whether any nPM1304 function drives VBUS (its VBUSOUT pin, ball C3, is on a net of its own with nothing else on it, netlist.csv); the schematic owner confirms with the specification's VBUSOUT section.
31. The cell's highest charge current (open item S12): `CHARGE_CURRENT` 15 mA, 0.85 C of the smallest cell (17.6 mAh), stays until the cell's maker answers.
32. The sign the `nrf_fuel_gauge` library expects for a discharge current, and its call for an added current (section 8.3): the firmware designer, from SRC 12 at the pinned SDK version.
33. The nRF54LM20A's own write protection for the MCUboot area (section 9.2, K-A1 rule 4) and the register or UICR setting that holds it: the firmware designer, from Nordic's nRF54LM20A product specification (not on disk).
34. What the nPM1304 does when TASKENTERSHIPMODE is written while VBUS is still present: the specification asks the host to wait for VBUS removal first [NPM p116], which section 8.4 does; the case itself is not described. Nordic answers if it matters.

### 10.6 What `firmware-check.py` checks

Run: `design/.venv/bin/python -I design/firmware-check.py` (exit 0 = pass, 1 = a rule fails). It reads `design/architecture.md`, `design/ecad/ring/netlist.csv` and the Knowles datasheet copy `design/mech/mic-path/datasheets/knowles-spk0641ht4h-1_chipsmall.txt`. Kept from F2 to F4: sections 1 to 10 present; every state of a transition is in the state list, every listed state has a transition out and, except `SHIP` and `BOOT`, one in, and the number of transition rows equals the number stated under the table; every pin and signal name is in architecture section 7, no spare pin is used, and each signal-pin pair matches; the RAM lines sum to the total, at most 512 KB; the charge voltage equals the cell's type in architecture section 2; each PDM clock line divides 32 MHz by a whole prescaler of 4 to 126, uses a ratio of the chip and gives 16,000 or 8,000 Hz; 64-byte bulk packets at full speed (6.1); the motor marking rule (4.7); the schematic rules for the microphone clock (4.5), the storage lines (5.1) and the screen sequence (3.3); thermistor value and ordered limits (8.1); none of the removed names outside the change lists; VDD_MIC on in exactly one state (1.1) and one power-table row (8.2), the recording state; only a long press starts or stops a recording, a short or double press never changes state, and no direction, button or other event touches the recording state; the gesture, centre-source, warning-pulse, hold-off and collision rules of F4; the audio format and chunk arithmetic; one PDM instance; the joystick switches against architecture 17.3 and the 40 ms rule against 16.5; unused pins only on lines that say unused; four pads in order; every row into `CHARGING` and both ship-exit rows say "charge on", `charging-enable` is on whenever VBUS is present, R-CHG stated; section 8.6 states VBUS is an input only; `questions_for_owner` and the RESULT line. Changed in F5 (each replaces an F4 check that asserted what F5 changes): the header says Version F5, follows A5 sections 17.11 to 17.23 and has the list "Changes from F4 to F5" with 8 items; the removed-name rule runs from that list to "How to read this" and now also bans the older power chip's name, the F3 battery range, the old microphone and datasheet names and the discharge-limit property; `CHARGE_CURRENT` is 15,000 µA in `current-microamp`, a multiple of 500 inside 4,000 to 100,000 and at most 1 C of the smallest cell of architecture 17.17, and T-CHARGE has a pass limit (in F4 both were BLOCKED on S12); the microphone mode range is read from the Knowles datasheet copy (F4 used fixed numbers of the older part), the microphone part name is in 4.1 and 8.5, and the gain is 0 dB, the register 0x28 (2 x 0 + 0x28), the header `gain_code` equal to it, and the stored full scale (94 dB SPL minus the sensitivity read from the Knowles copy) equal to the acoustic overload point read from the same copy; section 3.1 names U11, MOT_EN, VMOT and the 0.55 ms delay and never Q1, and architecture 17.22 names U11 (F4 checked Q1 and full duty on VDD_3V0); the battery minutes of 1.1 and the hours of 8.5 are recomputed from the smallest and largest cells of architecture 17.17 and the recording current 4.0 + 2 x (0.63 - 0.58) mA (F4 checked a single range against architecture 17.10); the ship section 8.4 names TASKENTERSHIPMODE, the VBUS removal and EVENTVBUSREMOVED and no timed hibernate; SHIP_SAMPLE keeps the factory flag in 9.3 and in 1.2; section 7 starts with the protocol sentence. New in F5: every "SIGNAL Pn.nn" pair and every chip pin of firmware.md is checked against the U1 rows of `netlist.csv`, and the power chip, microphone and motor nets this file names (GPIO0 on PMIC_INT, LSOUT1 on VDD_MIC, LSOUT2 on VDD_SD, U5 and U6 SELECT, U11 EN, OUT and IN, R61 and R62) against their netlist rows. Changed in F6: the cells per size are read from the measured table of architecture 17.26 (no longer 17.17); the compile limit of 8.1 must equal 1 C of the smallest cell, 17,600 µA; the header says Version F6 with sections 17.11 to 17.26 and the list "Changes from F5 to F6" has 4 items; and no line outside the change lists may name a value of the calculated cells (18.2, 24.3 or 32.9 mAh, or 18,200 µA) unless the word "before" stands within 60 characters of it. Changed in v7 (architecture 17.29 and 17.30): the netlist fact "Q2 whose gate is VDD_MIC" is no longer required; any line naming LED1, R41, Q2, LG1, LP1, T-LIGHT, "recording light", "light window", "hard-wired", "record button" or "nub" fails unless it says "removed in v7"; section 3.2 must state rule R-SIGN (never dark, red dot and timer, dimmed after 3 s, full picture on any input, the one function `rec_mics_on()`, test SIGN-1, the dot's cost a bench item); the `RECORDING` screen cell of 1.1 must say never dark and its 8.2 row must keep the screen on; 4.5 must enable VDD_MIC only after the sign is drawn; the refusal row "recording sign not drawn" must stay in `STANDBY`; 9.3 must hold T-SIGN and no T-LIGHT row; 8.5 must not count a light and must name the dot's cost as a bench item; the centre switch is written "centre switch SW2 (net BTN_REC)"; the 2.2 heading names the round joystick with five switches. Rules it cannot check (timing values, protocol layouts, the meaning of text) are checked by review.

## Hardware issues found

Status in F5 of the issues raised in F1 to F4, after architecture A5-draft sections 17.13 to 17.23 (H8 and H9 close in F5; H16 to H19 are new):

| Id | Conflict | Status | Firmware choice | Who acts |
|---|---|---|---|---|
| H1 | Architecture A1 and A2 section 5 fixed the PDM clock at 1.536 MHz with ratio 96. The chip's PDM divides 32 MHz by an integer 4 to 126 [SRC 3, SRC 4]: 1.536 MHz needs 20.83, so 16 kHz cannot be made at 1.536 MHz. | closed: architecture A3 section 5 now gives 1.280 MHz, ratio 80 | 1.280 MHz, ratio 80, exactly 16 kHz, inside the 1.000 to 4.800 MHz performance mode of the microphone of 17.19 [DS line 95] | bench B2 measures the current |
| H2 | F1: microphones 1 and 2 share MIC_A_CLK, so a one-microphone low-power state of F1 clocked both. | closed: the owner removed that state (change list); every recording clocks all 4 | none | none |
| H3 | F1: the light follows VDD_MIC and was on all day in a state the owner has now removed. | closed: VDD_MIC is on only while audio is stored, so the light is on exactly then; [v7: removed in v7 (architecture 17.30): the recording light, LED1, R41, Q2, the light guide LG1, the light pipe LP1 and the light window are out; the recording sign is the screen, section 3.2] | none | none |
| H4 | F1: the light circuit of architecture sections 7 and 9 contradicted itself. | closed by architecture A2: no chip pin touches the light; [v7: removed in v7 (architecture 17.30): the recording light, LED1, R41, Q2, the light guide LG1, the light pipe LP1 and the light window are out; the recording sign is the screen, section 3.2] | no light code | none |
| H5 | F1: no thermistor on the cell. | closed: RT1, 10 kilo-ohm, on the power chip's NTC pin (nPM1304 ball D3, netlist.csv) | charger limits of section 8.1 | schematic owner: the RT1 part, with B25/50 = 3,380 K for the chip's 10 kilo-ohm type [NPM p24] |
| H6 | F1: PMIC_INT GPIO and SHPHLD not named. | closed: PMIC_INT on nPM1304 GPIO0 (ball D6), SHPHLD on test pad TP19 (netlist.csv); VBUS above 3.9 V ends ship mode [NPM p116, p17] | `pmic-int-pin = 0`; wake from `SHIP` and `OFF` only by VBUS | none |
| H7 | The motor draws below 80 mA running and up to 175 mA at each start (architecture 17.16), now straight from the cell through U11 (17.22): 4.5 C running and 9.9 C at the start on the smallest cell, 17.6 mAh, and 2.5 C and 5.5 C on the largest, 31.9 mAh [CALC, section 3.1; architecture 17.26]. A start takes up to 228 mA from the cell with every other load on (17.22). No cell discharge limit and no protection-circuit trip current is on file. | open | the patterns are unchanged; B15 and B5 stop recording before the cell is low, but a trip of the protection circuit in a motor start would cut power in a pulse | cell maker (Grepow), through open item S12: maximum pulse current of the cell and its protection circuit |
| H8 | F4: the power chip of F4 could not charge under 32 mA, above 1 C of the cell. | closed by architecture 17.13: the nPM1304 charges from 4 mA [NPM p24] | `CHARGE_CURRENT` = 15 mA, 0.85 C of the smallest cell (17.6 mAh); T-CHARGE passes at 13.5 to 16.5 mA | Grepow states the cell's own limit (S12); the value changes in one place |
| H9 | F4: the microphone had no datasheet on disk. | closed by architecture 17.19: the Knowles SPK0641HT4H-1 has a datasheet copy | 1.280 MHz, ratio 80 and the 50 ms discard, now from that copy (sections 4.1, 4.5) | Knowles or a distributor confirms the part is made (S23) |
| H10 | The pad order: architecture section 8 says "from -Y to +Y"; 17.3 lists the pads at X = -2.4, -0.8, +0.8, +2.4 mm, and 17.8 puts them at -150 degrees. | open, same name order in both | VBUS, D-, D+, GND in that order | architecture owner: state the axis of the order on the band; case owner: the case pins |
| H11 | Architecture section 8 and the case document still give 6.3 minutes per recorded hour (four channels of audio, 461 MB). | open | 3.21 minutes per recorded hour with 2 channels (section 6.4) | architecture owner and case owner |
| H12 | Architecture 17.3 and 17.8 put the cell's temperature sensor in the band's flex tail (other side); sch-notes and bom-notes (conflict 5) put RT1 on the main board beside the cell. | open | RT1 on the nPM1304 NTC pin, 10 kilo-ohm, limits of section 8.1 | schematic owner: where RT1 sits and its part; the limits apply to the cell, not the board |
| H13 | Architecture sections 1, 3, 4, 5, 6, 7 and 9 and the rows of the section 2 table for the joystick (+38 degrees) and the second control (+62 degrees) still describe the A3 or earlier ring (four microphones, the flat A3 cell, 68 mA charge, 4.40 V); section 17.8 wins by the architecture's own rule. | open | F3 follows 17.8, then 17.1 to 17.6, then 16 | architecture owner: rewrite when the open items of 16.9 close |
| H14 | Architecture 17.12 puts the four pads on the inside of the band, touching the skin; whether any voltage or leakage path reaches them without a case, and how sweat is kept from corroding them, is to be stated in the wiring notes (17.12). | open | VBUS is an input, nothing is driven onto the pads, USB off without VBUS (section 8.6) | wiring notes owner (schematic), then the case owner |
| H15 | Architecture section 9 (first two bullets), 16.5 (the line on the record button), 17.3 (the table row for the record button and the line "SW2 = record button") and 17.8 still describe a separate record button and a joystick that never starts a recording; 17.11 removes the button and puts the record gesture on the centre press. [v7: the record button is gone since 17.11 and the rectangular nub is removed in v7; the one control is the round joystick (architecture 17.29), centre switch SW2 (net BTN_REC)] | open | F4 and F5 follow 17.11 (later sections win); BTN_REC is the centre switch in case `SW2` | architecture owner: rewrite those lines |
| H16 | The first F5 brief asked the gain to drop by 11 dB for the more sensitive microphone. At -11 dB the microphone's own noise, -26 - 64.5 - 11 = -101.5 dBFS(A), falls under the noise of a 16-bit sample, -(6.02 x 16 + 1.76) = -98.1 dBFS; the stored signal-to-noise at 94 dB SPL would drop from about 63.8 dB at 0 dB gain to about 59.5 dB [CALC, `design/firmware-f5-notes.md`; assumes the PDM truncates to 16 bits after the gain; not A-weighted]. At 0 dB the store clips at 94 + 26 = 120 dB SPL, the microphone's own overload point [DS line 105]. | closed by the lead's decision of 2026-11-11: gain 0 dB | gain 0 dB (0x28), section 4.1 | none; bench B7 can measure the floor |
| H17 | Architecture section 3 still says "the power chip stops discharge at 3.1 V" and section 2 and 3 still name the older power chip; motor-drive.md section 2.4 uses that 3.1 V. The nPM1304 specification read gives a power-fail reset at VSYSPOF, 2.7 V by default (2.5 to 3.4 V) [NPM p109], and a brownout at 2.4 V [NPM p29]; no 3.1 V cut-off was found. | open | B2 at 3.30 V and B5 at 3.45 V stay; VSYSPOF stays at its default (section 8.7) | architecture owner: rewrite section 3; the cell maker: the protection circuit's undervoltage limit (S12) |
| H18 | Architecture 17.15 and 17.17 gave the recording hours at 4.0 mA; with the microphones of 17.19 the current is 4.1 mA. | closed by architecture 17.26, which computes the hours at 4.1 mA on the measured cells (4.3 to 7.8 hours) | 4.1 mA (section 8.5) | none |
| H19 | Assembly step 25 reads the boot count after FACTORY ENTER and expects the same count after VBUS is removed and put back; removing VBUS in `FACTORY_TEST` reboots the ring (section 1.2), so the count rises by 1. Its stated reason (a motor start over the 100 mA limit) is also out of date since 17.22, and its step 2 still lists Q1 and D1 (17.23 says 17.22 wins). | open | section 9.3 sends FACTORY_EXIT before the count is read; the check stays as a proof of no reset | assembly owner: update steps 2 and 25 |

## questions_for_owner

1. USB ids: the ring needs a USB vendor id and product id before production. Buy a vendor id from the USB-IF, or use a product id under a vendor that lends them (for prototypes the firmware uses the Zephyr project's test ids)?

RESULT: done, F5 follows architecture 17.11 to 17.23, wiring A7 and the assembly order; the check runs and their exit codes are listed in design/firmware-f5-notes.md.
