NexusGPT/openring/design/wiring/case-marks-2-notes.md

# Case marks, solder order, labels, gauge step (wiring review 2, F5, F6, N1, N2, N3)

Written 2026-11-13 (clock from `date`: start 12:26:17 CET, last check 12:30 CET). ROOT = .. W = ROOT/design/wiring/case-marks-2-work/ (all logs; copies of every file before the change in W before/). I ran no git command and no check_band.py, wrote nothing in the ring board folders, used no browser.

## Changes (file, before, after, source, proof)

1. F5, ROOT/design/ecad/case/pcb/case_main.kicad_pcb: 5 silkscreen texts before, 8 after. New, all B.SilkS, mirrored, height 1.0, width 0.60, stroke 0.15 (same as W1 to W4, W7): "W5 +" at 115.55, 81.25 (1.35 mm from hole W5); "W6 -" at 108.8, 82.8 (1.45 mm from W6); "TH1" at 120.25, 83.15 (1.45 mm below the two TH1 holes). Place: nearest free spot by the first round's search (ROOT/design/ecad/case/pcb/evidence/marks/search_marks.py; W search_B.log), 0.15 mm to every pad opening, 0.2 mm to the edge. Bottom face like the first round's five labels; the top face spots are 1.69 to 2.82 mm away (W search_F.log), so the bottom face was kept. Added by W add_marks_2.py (add only, my own script; the first round's add_marks.py would also rewrite the pin board, so I did not run it). Proof: text dump before and after W silk_before.log, silk_after.log (diff shows only the 3 new lines); diff of the board file has 0 removed lines (W diff_case_main.txt, 36 added).
2. F5, fabrication output ROOT/design/ecad/case/pcb/fab/case_main/: made again with export_fab.sh main, all 8 steps exit 0 (W fab_export_main.log). Against the copy before (W compare_fab.log): 15 of 16 Gerber and drill files equal except the creation-date lines; only case_main-B_Silkscreen.gbr differs (35688 to 38538 bytes); same file list (W fab_list_before.txt, fab_list_after.txt). make_bom.py not run: the parts list does not depend on silkscreen.
3. F5, ROOT/design/ecad/case/pcb/board-notes.md: the case procedure heading now covers the gauge step and the cell leads; new step 9 gives the marks, the lead colours (red lead + to "W5 +", cut 13.0 mm; black lead - to "W6 -", cut 15.2 mm; from ROOT/design/wiring/lead-decisions.md rows "case cell BT1 leads" and "case thermistor TH1 leads"), the polarity measurement and the thermistor (bare, no polarity, 10 mm, 5 mm from the bead).
4. N3, board-notes.md: new numbered step 4 (depth gauge) between the old step 3 (press the pin board in, form the stakes) and the old step 4; the old steps 4 to 7 are now 5 to 8, the references inside the file follow ("order of step 5", "step 7 of the soldering order", "numbered steps 1 to 9"). Source quoted in the step: case-architecture.md line 219 (P2, P3 1.170 mm +-0.04; P1, P4 1.021 mm +-0.03; shim 0.025 steps or lap on 600-grit). I added one sentence that is mine and marked so: a shim or lap needs the stake heads cut (case-architecture.md line 238).
5. N2, ROOT/design/case/case-architecture.md line 151: "2.28 to 2.42 mm" now "1.98 to 2.15 mm (28 values ... ring-case-contact.csv)". Source: all 28 rows of ring-case-contact.csv, min 1.98 (P2, US 13), max 2.15 (P4, US 10) (W contact_range.log). Line 219: a pointer to board-notes step 4 added in the same line (no line moved). Line 152 (E1 distance 2.28 to 2.42 mm from the band, bench B3) is another quantity and was left.
6. F6, ROOT/design/wiring/build_wiring.py (case_lines): column solder_first of the 5 case wires is now read from board-notes.md steps "Which end first" (line 295) and "Order inside each end" (line 297) and written per wire; both lines are added to column proof_carrier. Rebuilt ROOT/design/wiring/product-wiring.csv with `python3 design/wiring/build_wiring.py` (W build_after_fix.log). Before the change the same script reproduced the old csv byte for byte (W base_build.log, cmp "SAME_AS_COMMITTED"), so the only csv differences are lines 64 to 68 (solder_first and proof_carrier of W063 to W067). Result, e.g. W063: "pin board end first (all five wires), then the main board end; at each end W1 is no. 5 of 5 in the order W4, W2, W3, W7, W1"; W064 no. 2, W065 no. 3, W066 no. 1, W067 no. 4.
7. N1, ROOT/design/wiring/draw_wiring.py, rebuilt product-wiring.svg and .pdf (W draw_after.log: 66 conductors drawn, 1 gap). Labels now (W svg_labels_after.log, the svg holds text as comments, 0 `<text` elements before and after): W028 "inside the cell pack" (was "inside the switch"); W023, W024 "cut 1.07-1.44 mm" (was 1.12-1.39; true min and max over the 7 sizes of cut_mm_us7 to us13); case wire colours shown, e.g. W063 "wire 30 AWG stranded, red insulation, cut 15.6 mm", W064 white, W065 green, W066 black, W067 yellow; W059 and W060 already showed "red +" and "black -"; W061 and W062 now say "bare, no polarity". Same fault found in the copper labels of W025, W026, W027 (not monotonic in size): now W025 5.995-6.799 (was 6.207-6.799), W026 7.233-8.037 (was 7.445-8.037), W027 6.505-7.310 (was 6.718-7.310). The footnote of the drawing says "smallest to largest over US 7 to 13". Only these 14 comment lines differ from the old svg (W svgc_diff.txt: 14 removed, 14 added).
8. ROOT/design/wiring/system-joints.csv: not changed. No cited line moved: case-architecture.md and board-notes.md cites in it are to lines I did not move (case-architecture lines 64, 152, 235; board-notes: none).

## Bars

1. Rules check of case_main, run in its own folder: before `Found 0 violations`, `Found 0 unconnected items` (W drc_before.log); after, same two lines (W drc_after.log; the check_boards run below repeats it). Pad nets unchanged: pad dump by evidence/marks/dump_pins.py before and after (W dump_before.log, dump_after.log); the PAD, TRK and ZONE lines, sorted, are equal (cmp exit 0): `CU IDENTICAL pads 306 trk 737 zones 5` (W cu_compare.log); Edge.Cuts 8 lines before and after. The dump lists each pad's net, so equal lines mean equal nets.
2. Silkscreen text items: 5 before (W1 +, W2 D-, W3 D+, W7 TCH, W4 GND), 8 after (adds W6 -, W5 +, TH1): W silk_before.log, silk_after.log.
3. `design/.venv/bin/python design/wiring/check_wiring.py --require-complete`, exit 0 (W check_wiring_after.log). Last two lines: `COMPLETE 66 of 66 conductors (100 percent)` and `RESULT PASS lines 67 (66 conductors, 1 sensing gap), drawn and routed 25, specified and landed 41, drawn, not routed 0, stated in text only 1, not drawn 0, complete 66 of 66 conductors (100 percent), problems 0`.
4. csv lines 64 to 68 show the order (item 6). Svg label hits are in item 7.
5. Check scripts run: ROOT/design/ecad/case/pcb/check_boards.py (temporary reports sent to W cb_tmp with CHECK_BOARDS_TMP): last line `RESULT PASS check_boards case_main.kicad_pcb case_pins.kicad_pcb`, exit 0 (W check_boards_after.log, check_boards_after.exit). ROOT/design/case/check_case_docs.py: last line `RESULT PASS (0 findings)` (W check_case_docs_after.log, exit 0). check_netlist.py not run: netlist.csv and the schematic files were not changed.

## Not done, left for the lead

- The final automatic claim audit of this reply (rule 4) was not run; every number above was read from the logs by hand at the time of writing.
- Nothing was built on a real board: silkscreen colour (white) and the face on which the wire joints are made are still not fixed by any file (board-notes Round 3).
- check_boards.py (not mine) has a "marks" check that tests W1 to W4 and W7 only; it does not fail if "W5 +", "W6 -" or "TH1" is missing. Owner of that file: add the three marks.
- The before copy of fab/case_main is in W before/fab_case_main (the first round's evidence folder was not touched).
- board-notes.md steps 4 and 9 contain two readings of mine, marked "my reading": the shim or lap needs the stake heads cut; step 9 comes after step 8.
- The lead commits; ROOT/design/ecad/case/pcb/fab/case_main/ is a regenerated folder (creation dates changed in every file).

questions_for_owner: none

RESULT: done, F5 (marks W5 +, W6 -, TH1 and fab files), F6 (solder order built into the csv), N1, N2, N3 closed; case_main 0 violations and 0 unconnected with 306 pads, 737 tracks and 5 zones unchanged, check_wiring 66 of 66 and problems 0, check_boards and check_case_docs pass.
