NexusGPT/openring/design/wiring/screen-alternatives.md

# Screen alternatives: stock 0.95 inch 120 x 240 AMOLED modules and their cables

Written 2026-11-13, clock read at 04:30 CET (`date`). Writer: the screen-alternatives helper (task of the lead). Web: 22 requests of 25 (WebSearch, WebFetch and curl only; no browser; no form, account or message to any maker or reseller). No design file was changed. No git command was run.

Question: which stock AMOLED (or other self-lit) modules have a glass that fits about 12.8 x 27.4 mm, and what does each maker's drawing say about its flat cable?

Room in the ring (lead's brief, `screen-cable-study.md` section 3): a pocket 5.4 mm wide at one end of the glass, a connector 3.5 mm of path away.

Document paths are in `ROOT/design/datasheets/`. "p." is the PDF page (checked with `pdftotext -f N -l N`). `[not sourced]` marks a value from a search snippet or a web summary, never used as a value.

## Result in one view

Two modules in the saved files print the cable outline on their drawing page (Tailor Pixels, BOE/Panox). Both cables fail the 5.4 mm pocket as they are. Truly TR095A120SPC has no drawing page in the saved copy, and no other reachable copy has one. BuyDisplay, Densitron and Gesight were blocked or gated, so their cables are "cable not drawn" in every copy I could open. No stock module with a cable narrower than 5.4 mm at the glass was found.

## Module Tailor Pixels TOH095XVT-01

Documents: `design/datasheets/display_TOH095XVT-01.pdf` (saved earlier) and `design/datasheets/w14_tailor_toh095xvt-01_2025.pdf` (fetched 2026-11-13 from `https://tailorpixels.com/wp-content/uploads/2025/04/TOH095XVT-01_0.95-inch-Small-AMOLED-Display-Bar-Type-120x240-SPI.pdf`). The two files are byte-identical (md5 b4318928c9a755f1ce4b6a73e6978261), so the saved copy is the maker's current upload.

1. Glass and module size, active area, pixels:
   - Module outline 12.8 (H) x 27.35 (V) x 0.8 (T) mm; p.4, module parameter table.
   - Active area 10.8 x 21.6 mm; p.4.
   - 120 x 240 RGB; p.4.
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
