NexusGPT/openring/design/mech/thin/out/thin-assembled.png

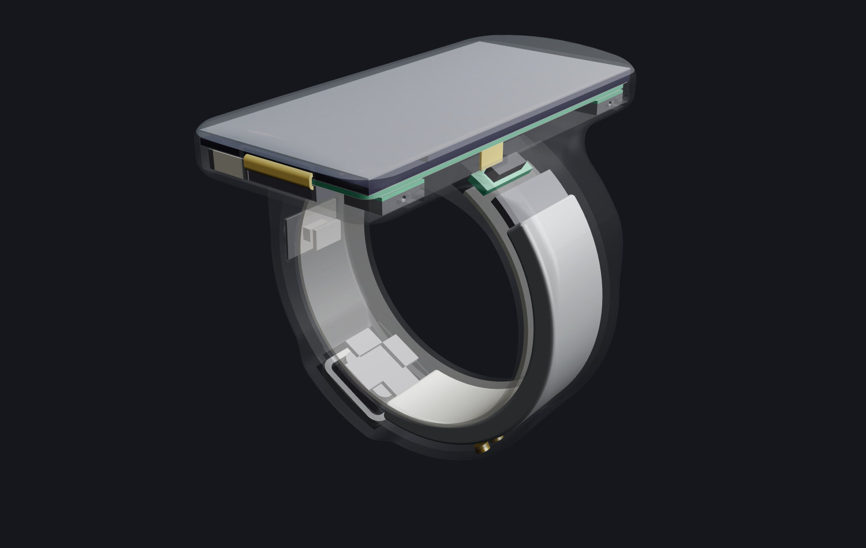
design/mech/thin/out/thin-assembled.png
