NexusGPT/openring/design/mfg/assembly/hotbar-work/logs/hotbar-fixture-render2.png

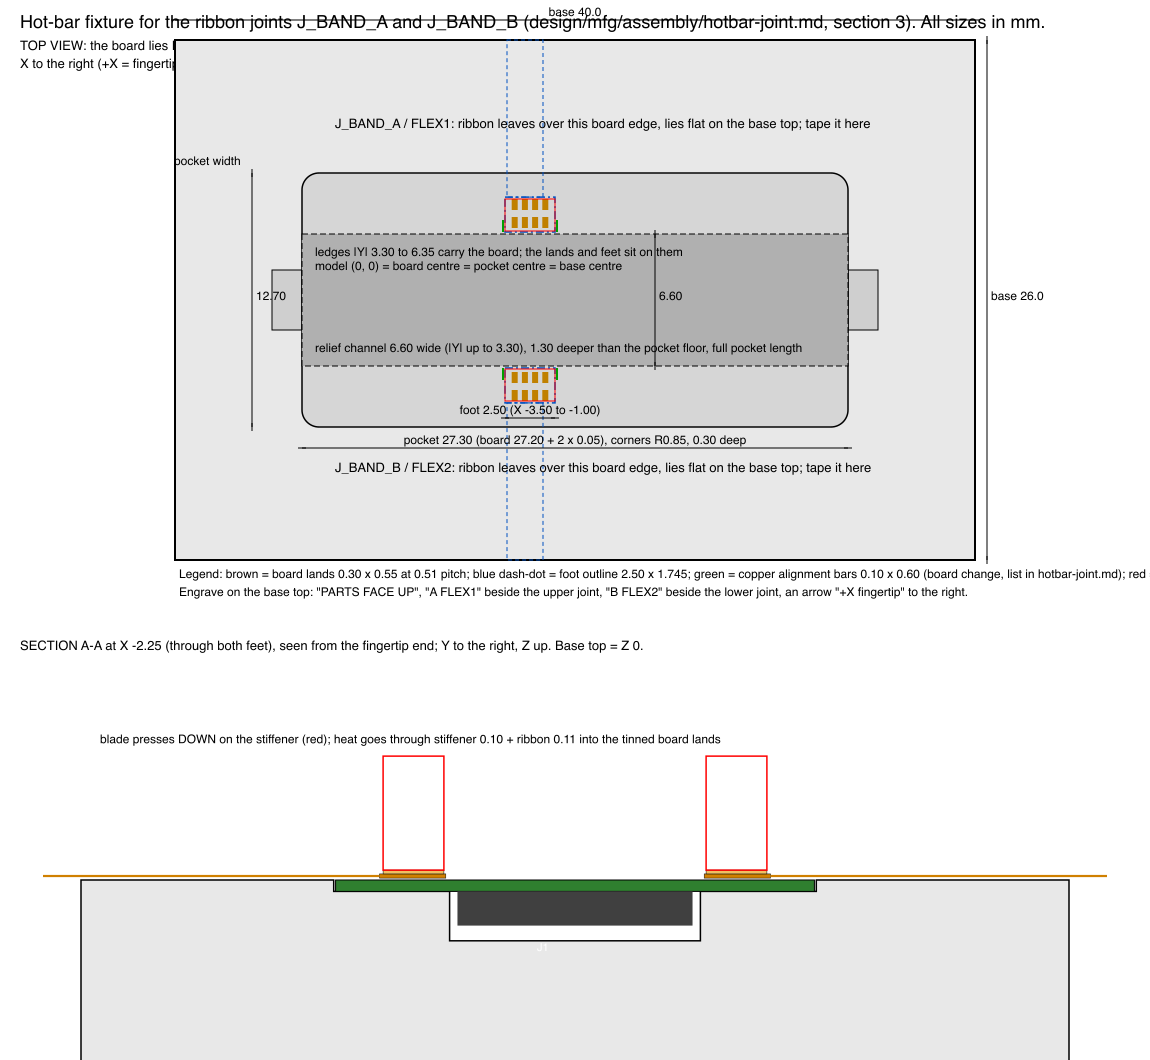
design/mfg/assembly/hotbar-work/logs/hotbar-fixture-render2.png
