NexusGPT/openring/design/mfg/assembly/hotbar-work/logs/hotbar-fixture-render.png

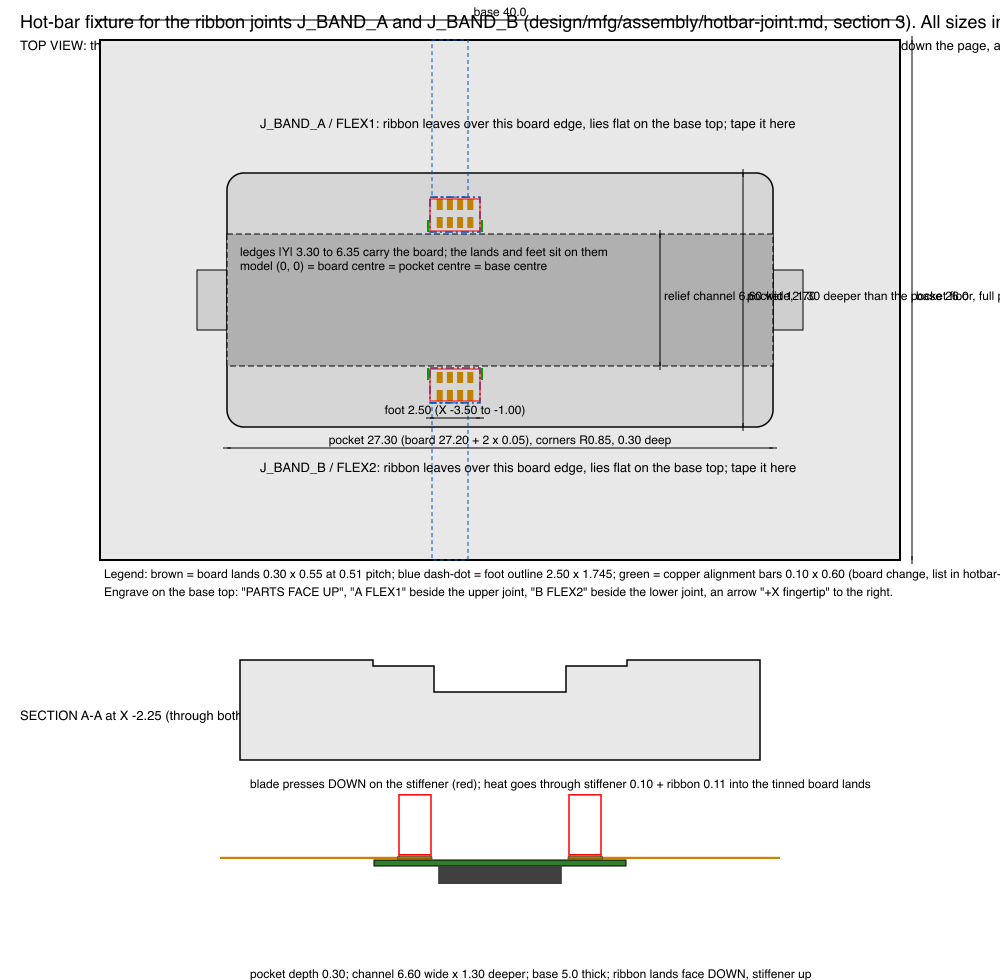
design/mfg/assembly/hotbar-work/logs/hotbar-fixture-render.png
