NexusGPT/openring/design/mfg/tools/testdata/ring_assembly.png

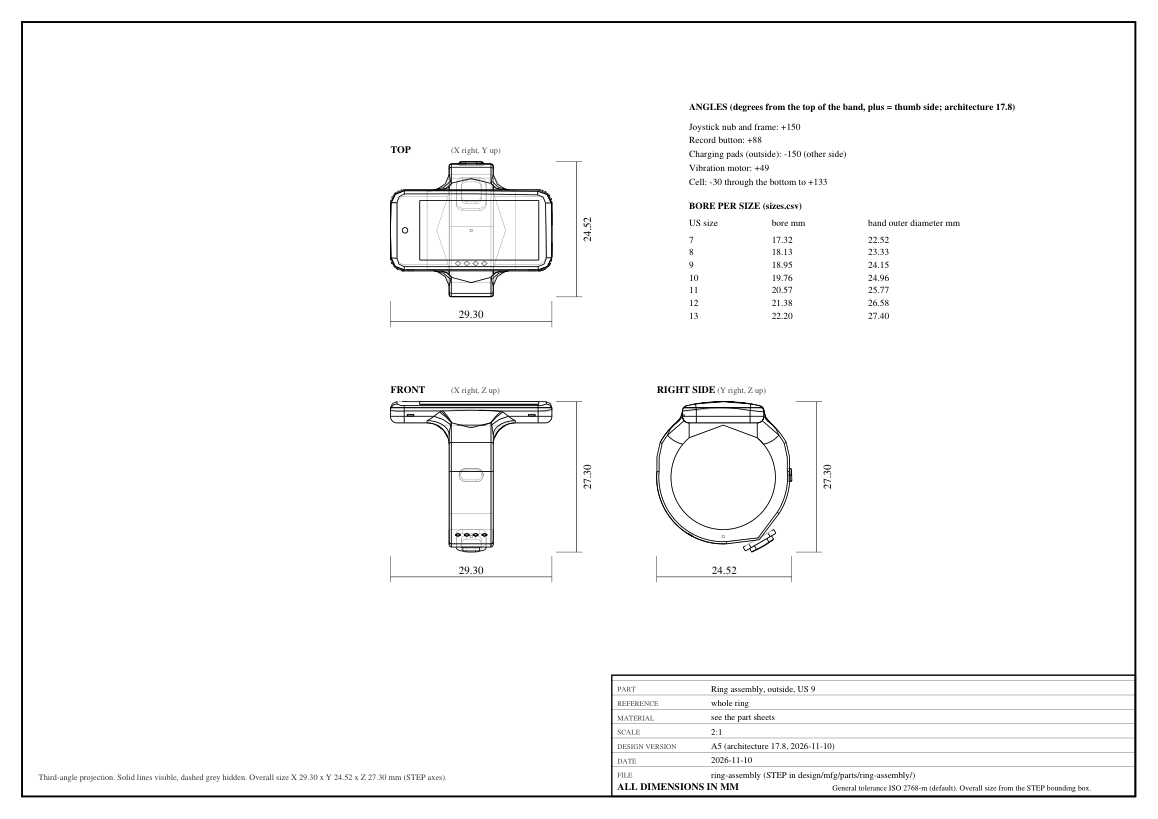
design/mfg/tools/testdata/ring_assembly.png
