NexusGPT/openring/design/wiring/deferred-work/docs-pass/onepager-preview-en.png

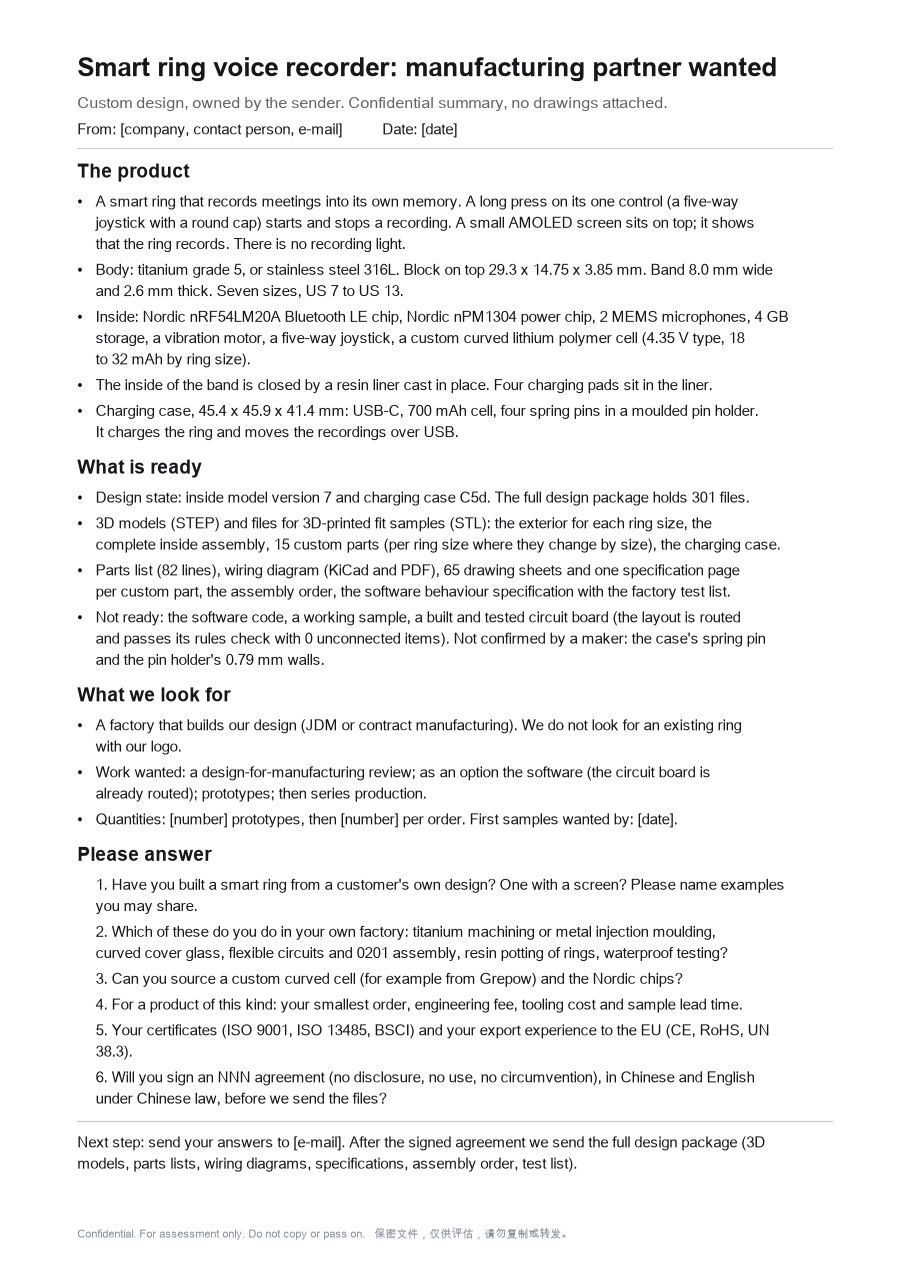
design/wiring/deferred-work/docs-pass/onepager-preview-en.png
