NexusGPT/openring/design/wiring/deferred-work/docs-pass/onepager-preview-zh.png

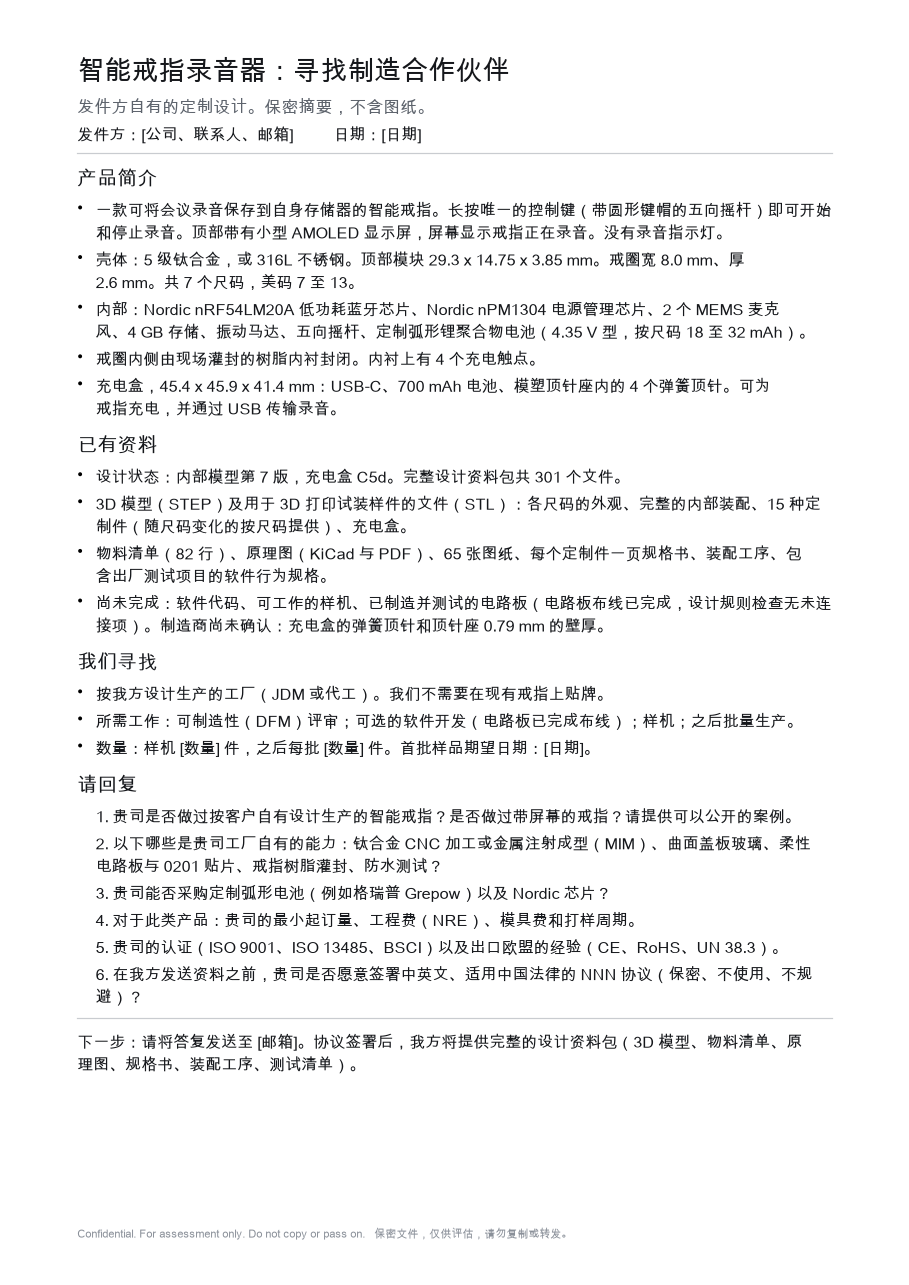
design/wiring/deferred-work/docs-pass/onepager-preview-zh.png
