NexusGPT/openring/design/wiring/g9-g11-work/final2-1.png

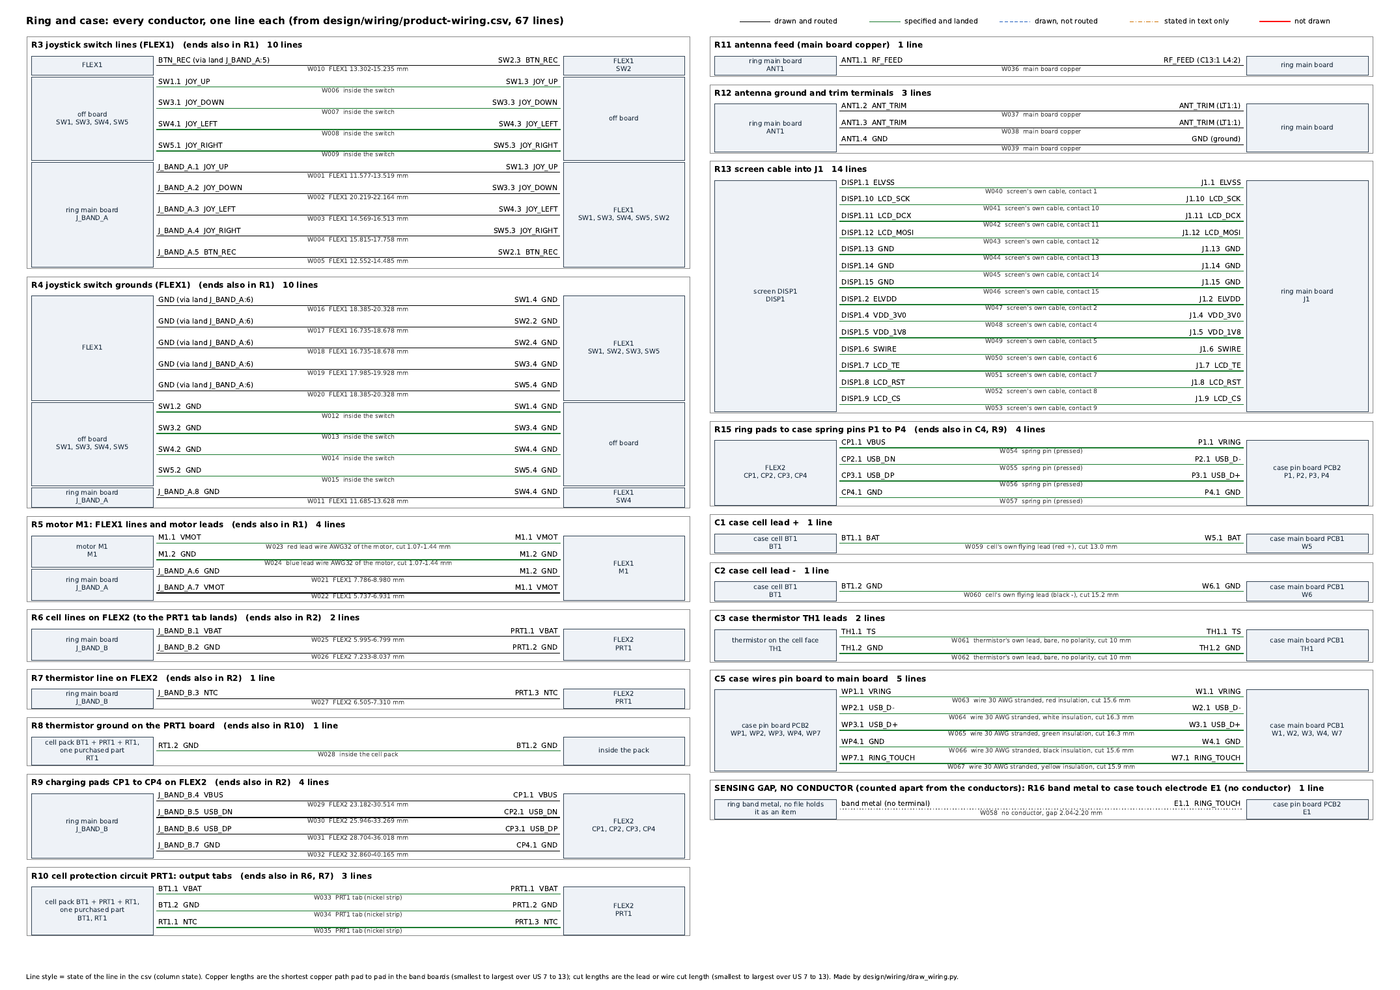
design/wiring/g9-g11-work/final2-1.png
