NexusGPT/openring/design/wiring/g9-g11-work/r8final-1.png

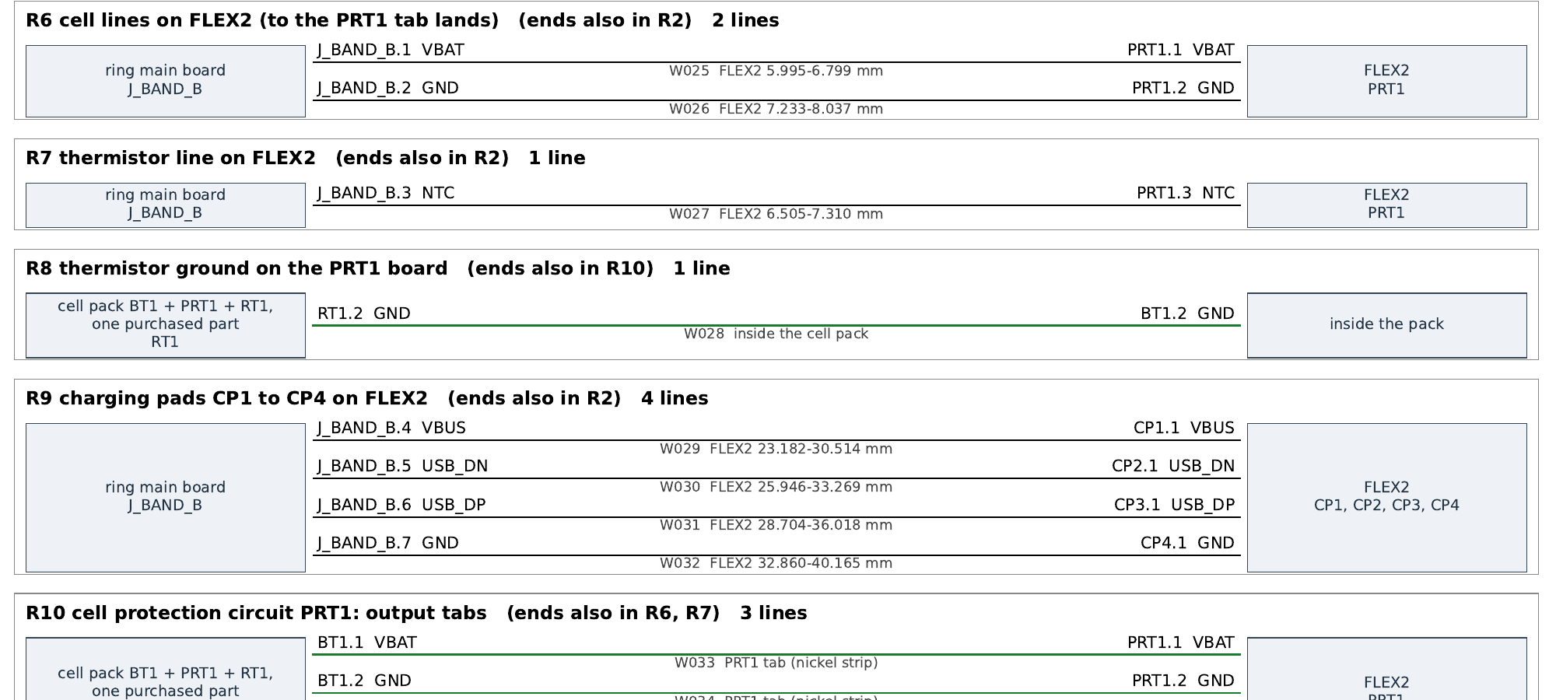
design/wiring/g9-g11-work/r8final-1.png
