NexusGPT/openring/design/wiring/review3-work/png/flex2-us9-drawing-1.png

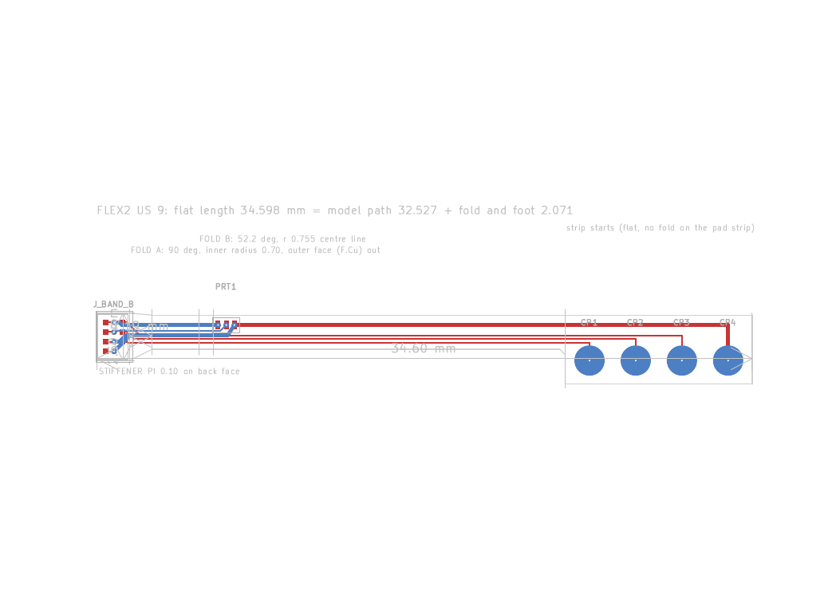
design/wiring/review3-work/png/flex2-us9-drawing-1.png
