NexusGPT/openring/design/wiring/review3-work/png/pw-1.png

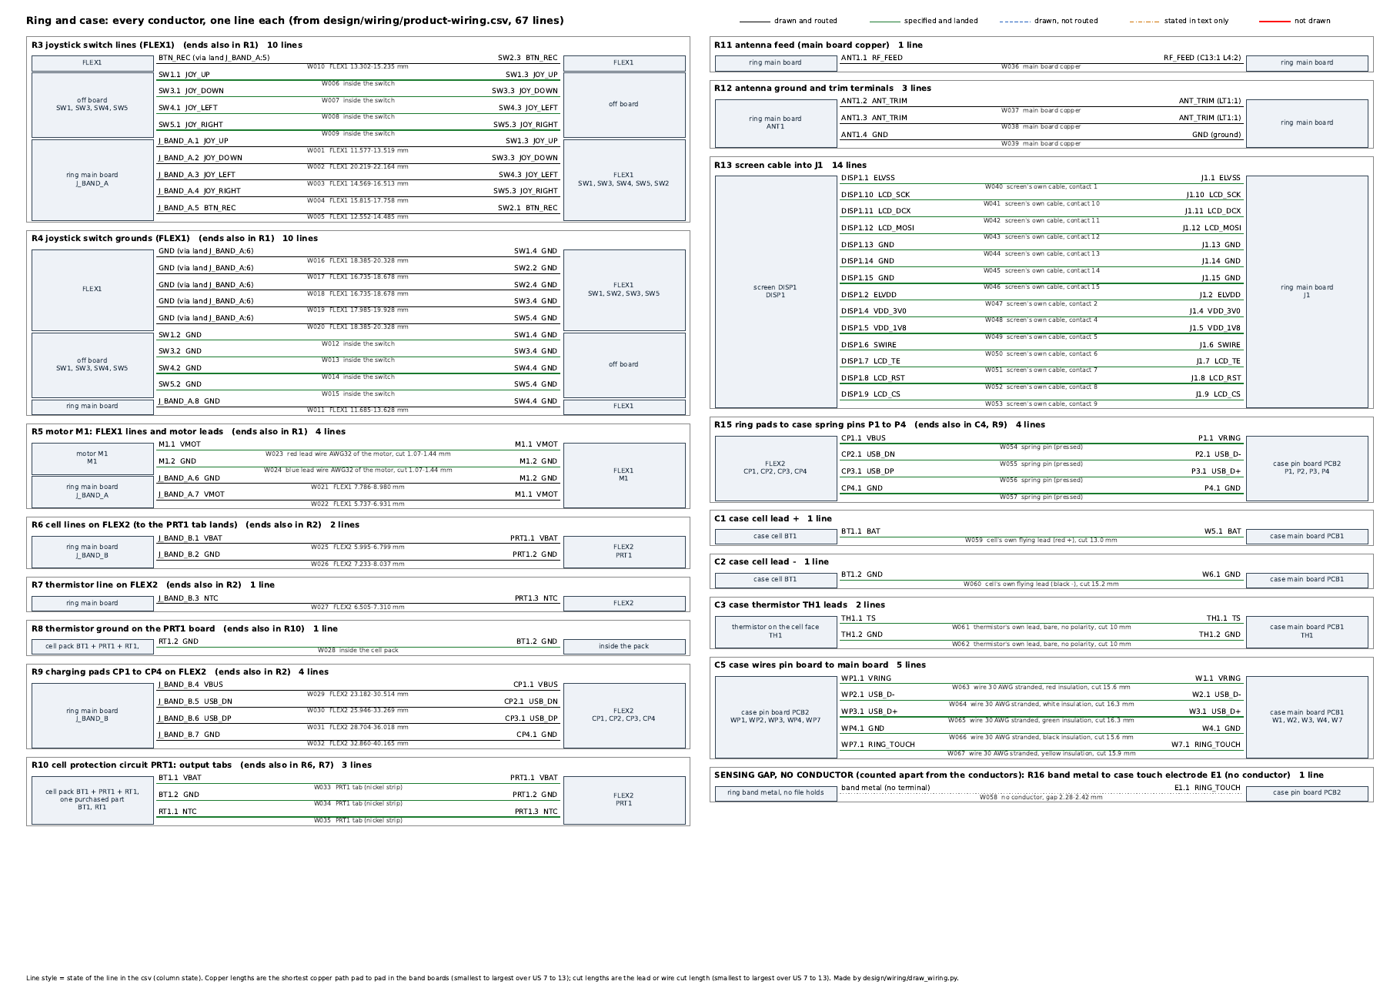
design/wiring/review3-work/png/pw-1.png
