NexusGPT/openring/design/wiring/wiring-work/pictures/draw1-pdf-1.png

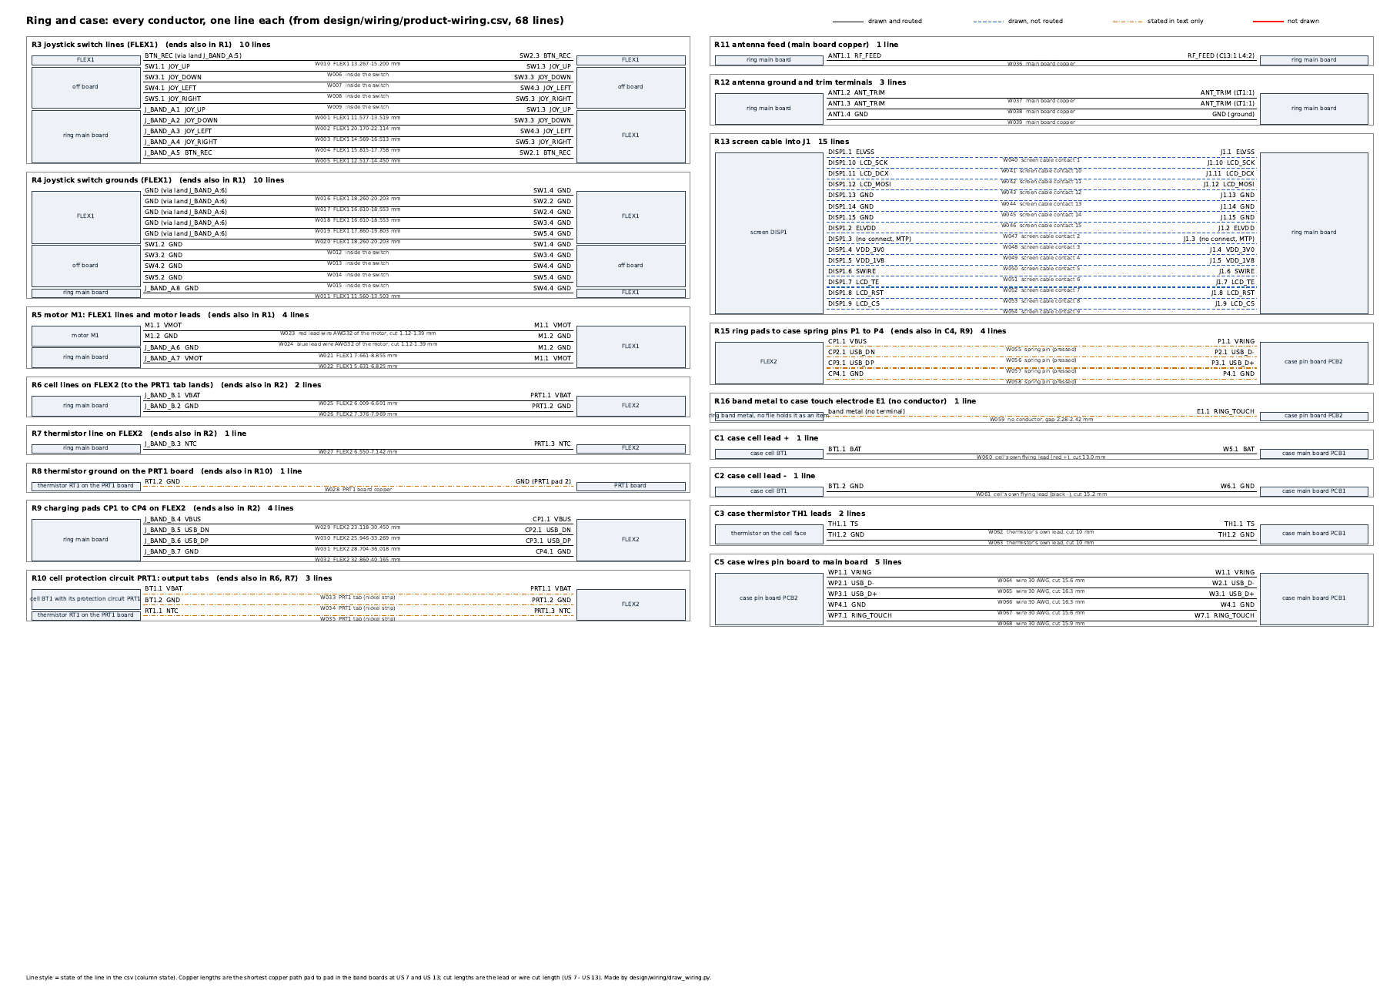
design/wiring/wiring-work/pictures/draw1-pdf-1.png
