NexusGPT/openring/design/wiring/wiring-work/pictures/draw2-pdf-1.png

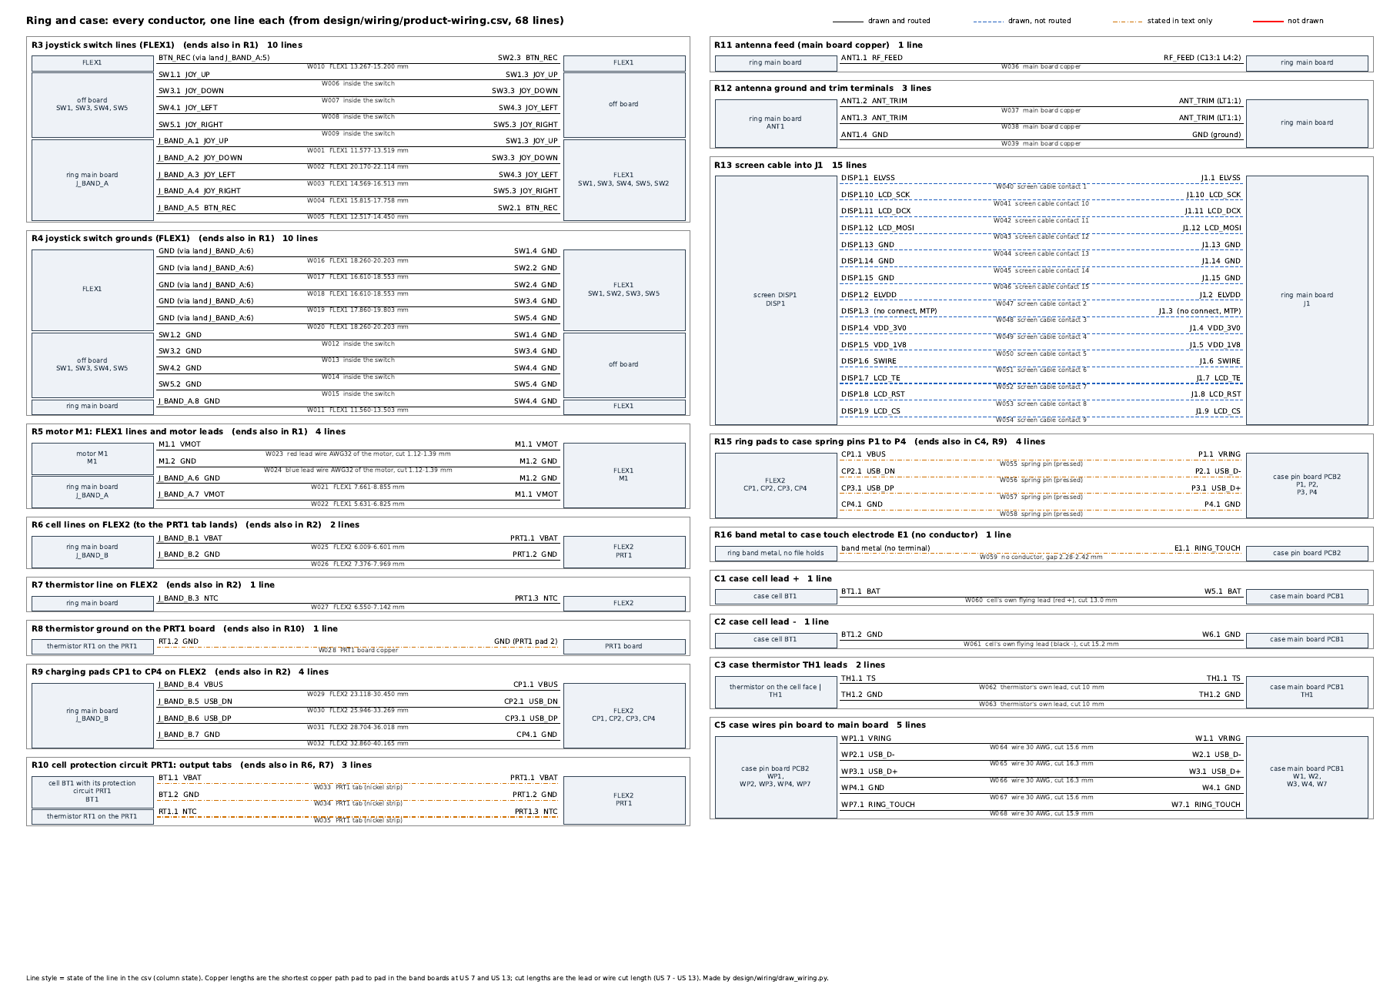
design/wiring/wiring-work/pictures/draw2-pdf-1.png
