NexusGPT/openring/design/wiring/wiring-work/pictures/final3-pdf-1.png

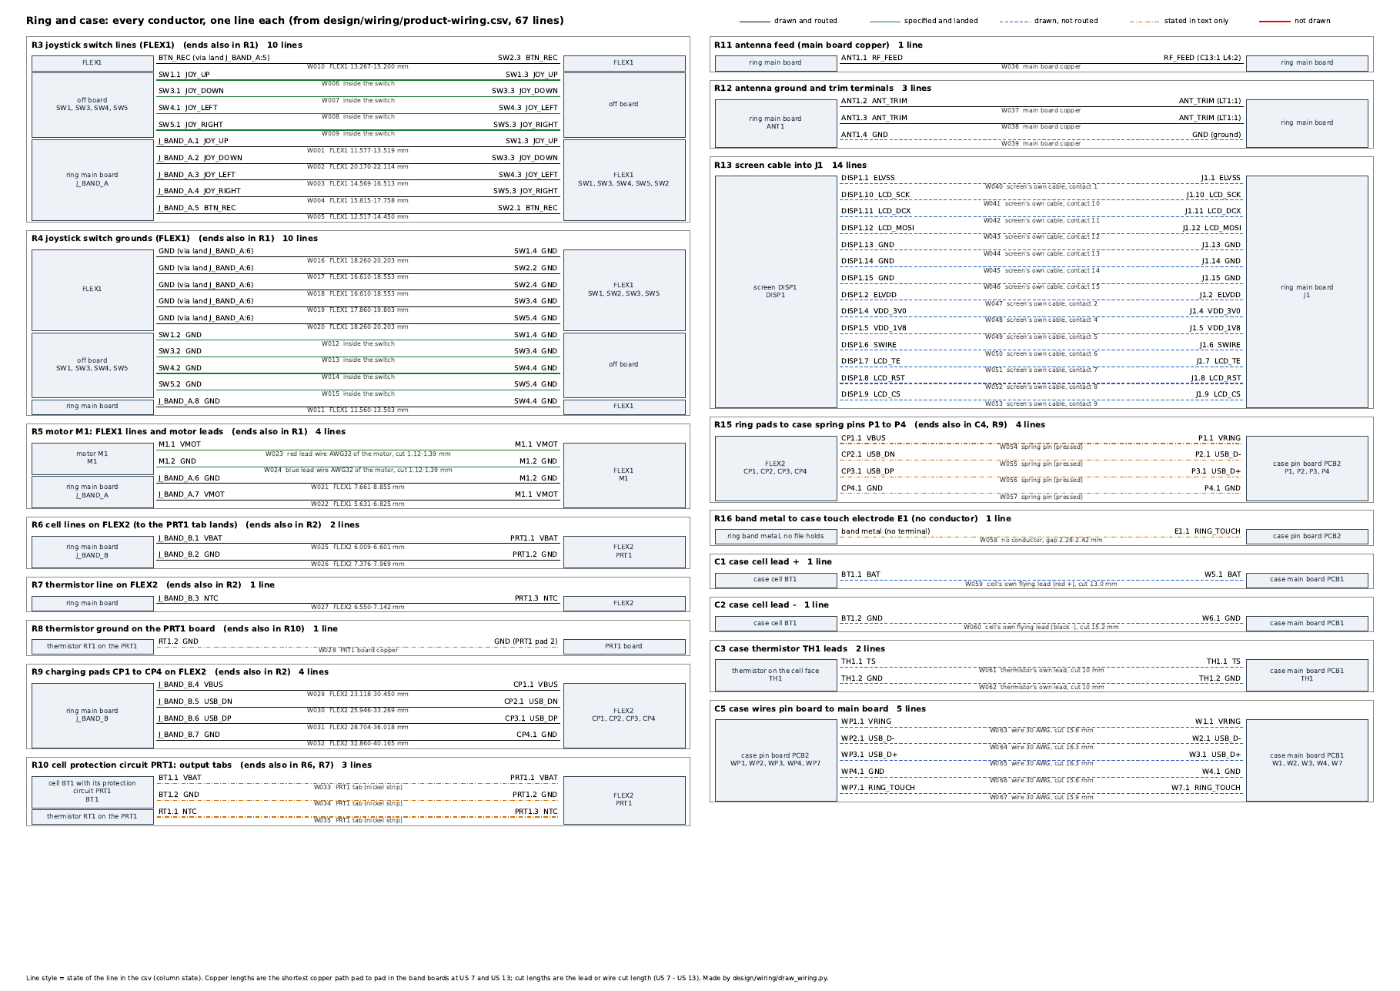
design/wiring/wiring-work/pictures/final3-pdf-1.png
