NexusGPT/openring/design/wiring/wiring-work/pictures/final3-svg.png

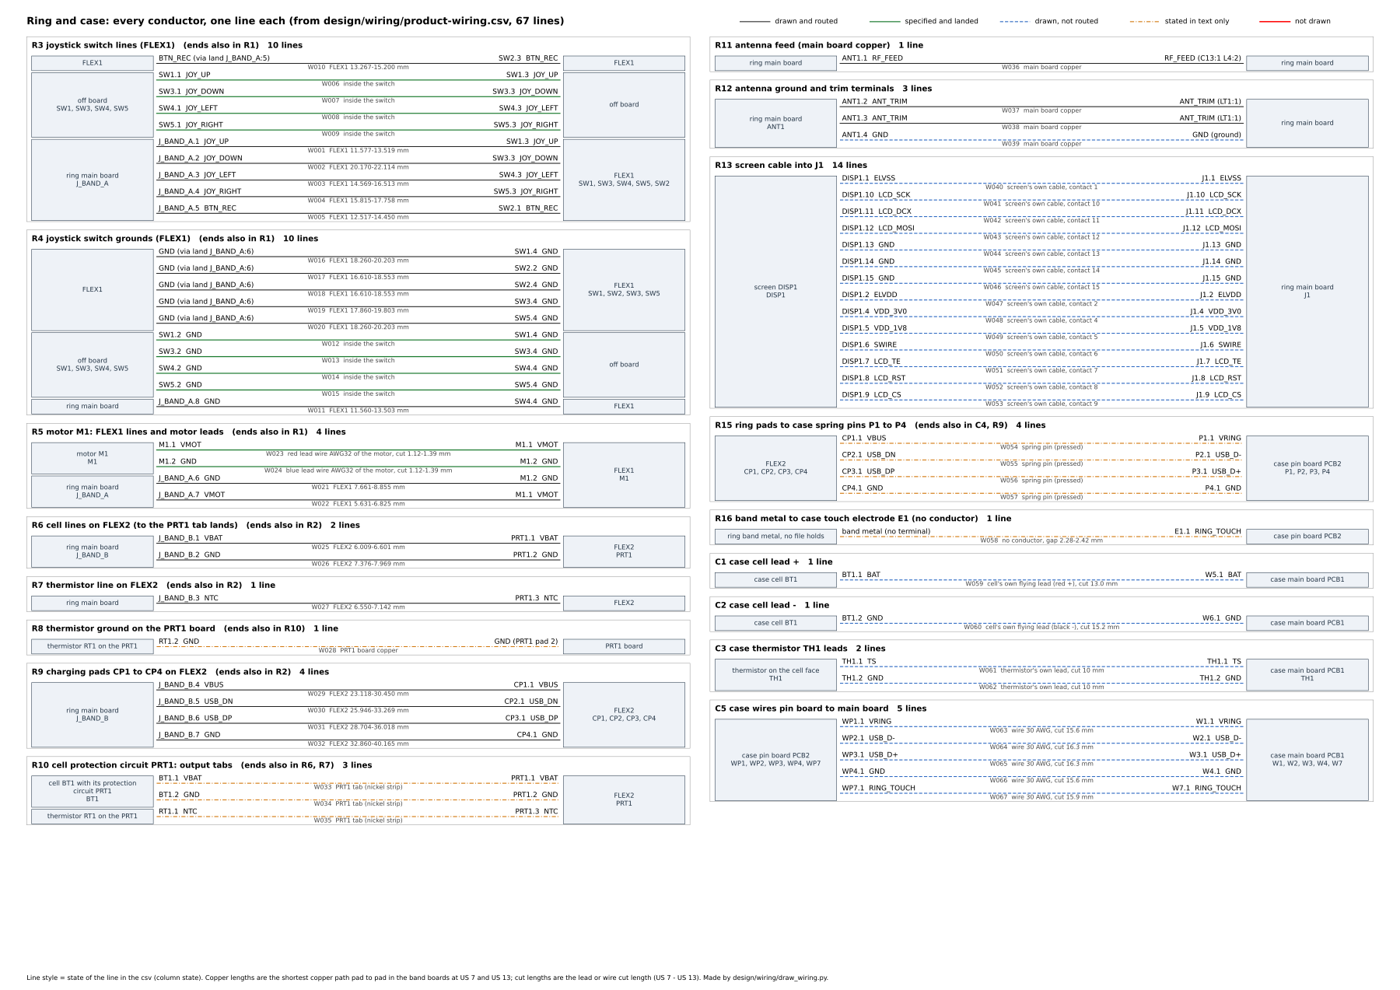
design/wiring/wiring-work/pictures/final3-svg.png
