NexusGPT/openring/design/wiring/wiring-work/pictures/final6-pdf-1.png

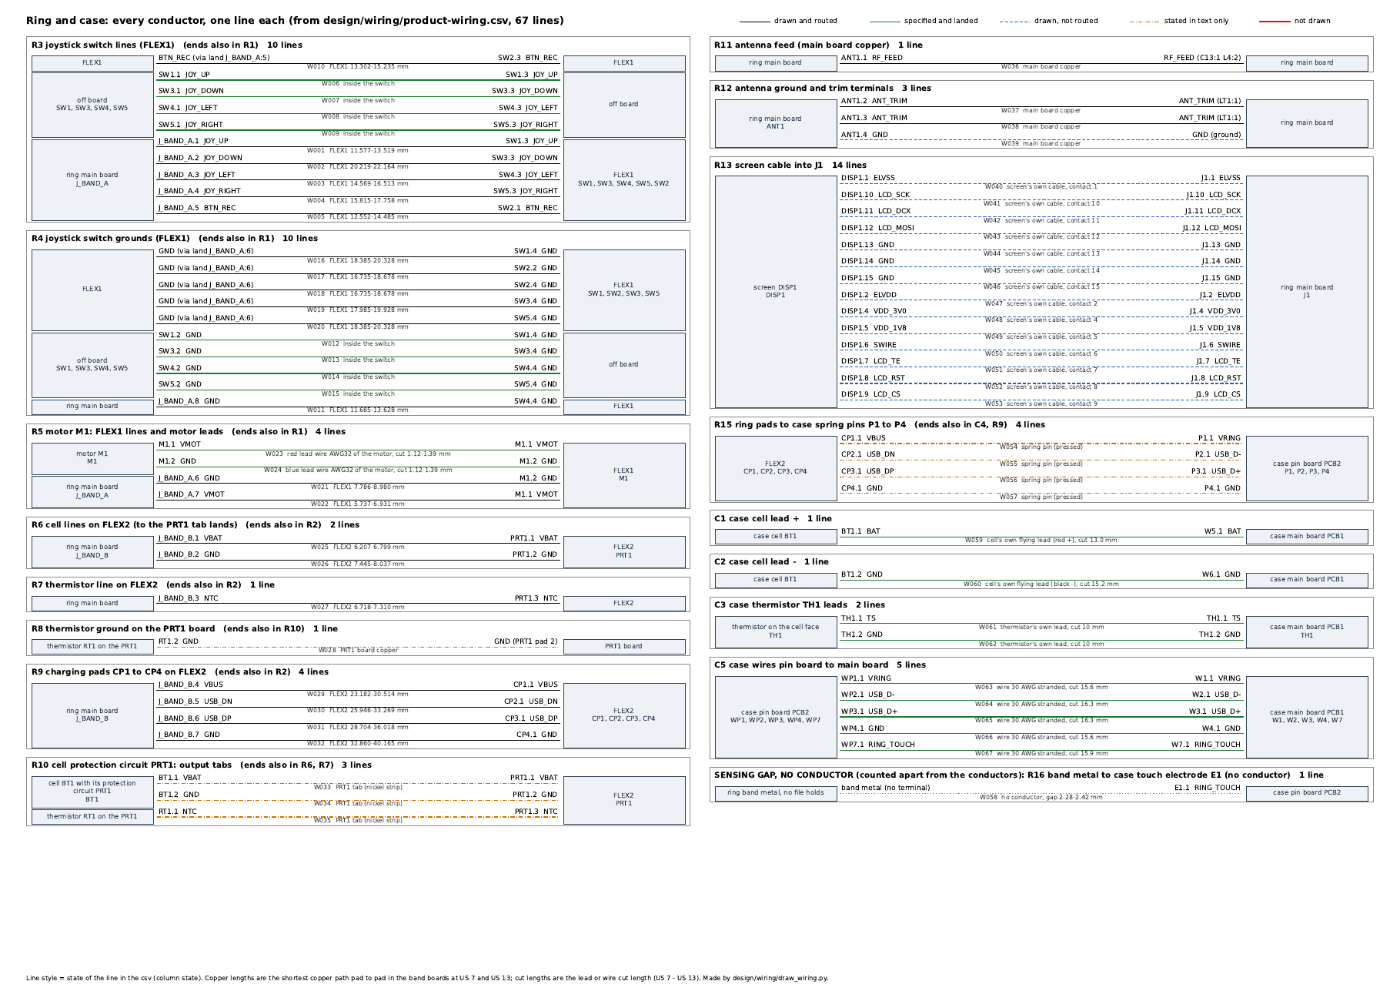
design/wiring/wiring-work/pictures/final6-pdf-1.png
