NexusGPT/openring/design/wiring/wiring-work/pictures/final6-svg.png

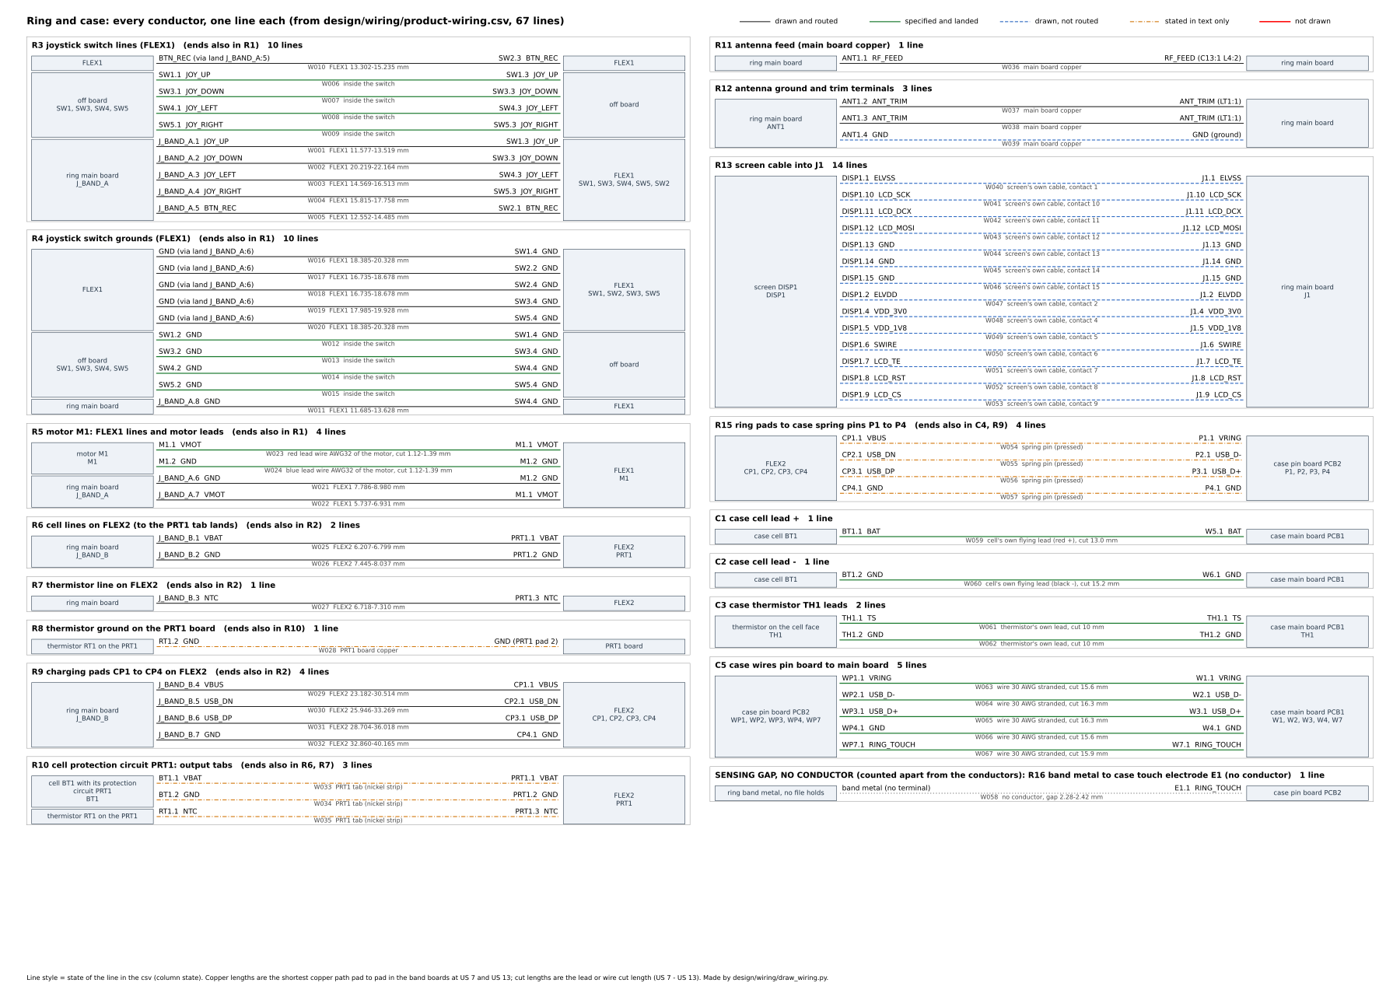
design/wiring/wiring-work/pictures/final6-svg.png
