NexusGPT/openring/design/mech/antenna/expected_measure.txt

Expected before the first run of measure_antenna.py (written from probe_chains.log lines 22-26 and thin.py lines 283-367):
- -X hand-end wall gap 0.225 (pocket half length 13.725)
- +Y thumb wall gap 0.45 (pocket half width 6.45)
- floor gap 0.05, floor metal 0.40
- -Y: first thing is the screen connector housing at 0.2 (J1 to Y 2.6)
- up: no board over the antenna (notch), foam frame over part of it, screen lower glass 0.4 (ledge), driver IC over part (X > -12.075, Y < 4.0), adhesive 0.1, cover glass
- screen panel covers the antenna footprint fully; lit area does not
- RESULT measured
mer. 11 nov. 2026 00:32:14 CET
