NexusGPT/openring/design/wiring/text-pass-work/result.txt

done, 199 edits in 18 files (and 80 redrawn sheets); six checks end in their pass lines (check_bom fails only on RC1, as before); the test pad face wording in assembly.md is left for the lead's later rewrite, listed in section 6.
