NexusGPT/openring/design/mfg/tools/testdata/body_final.png

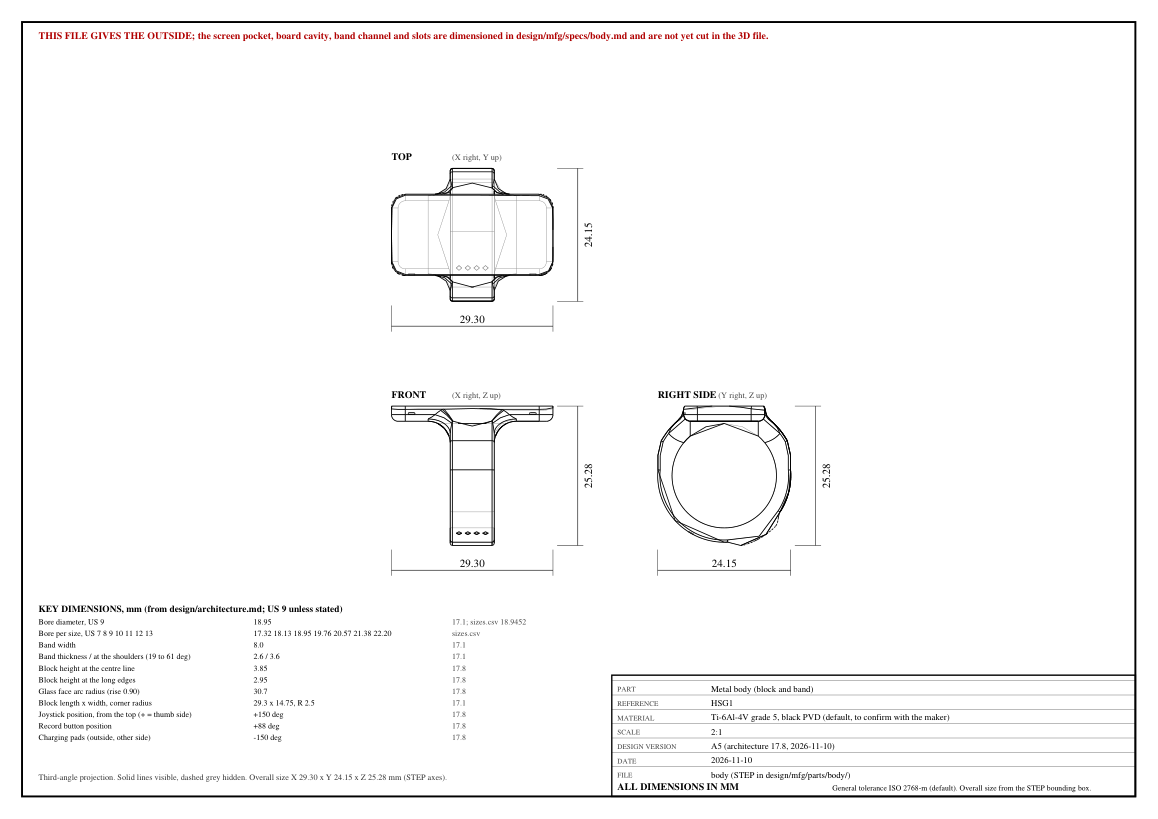
design/mfg/tools/testdata/body_final.png
