NexusGPT/openring/design/mfg/tools/testdata/drawings/body_test2.png

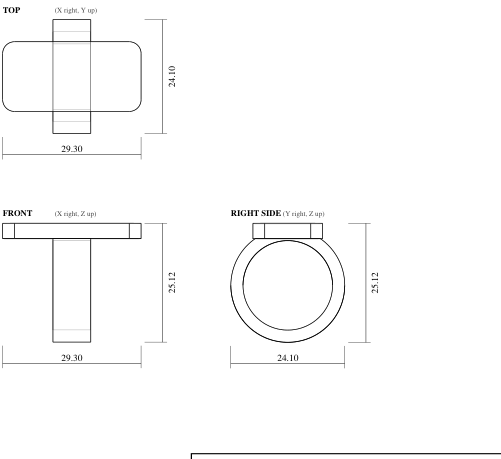
design/mfg/tools/testdata/drawings/body_test2.png
