NexusGPT/openring/design/mfg/tools/testdata/ring_final.png

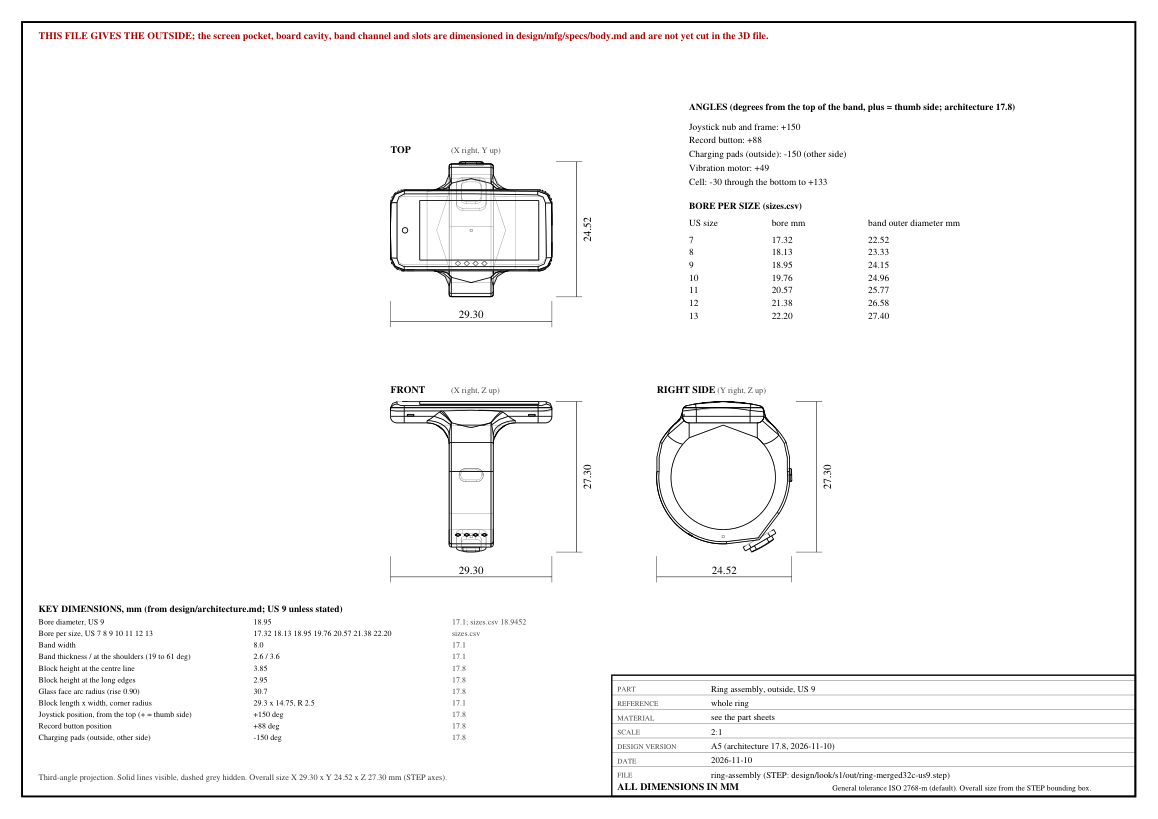
design/mfg/tools/testdata/ring_final.png
