NexusGPT/openring/design/mfg/tools/testdata/sheet1.png

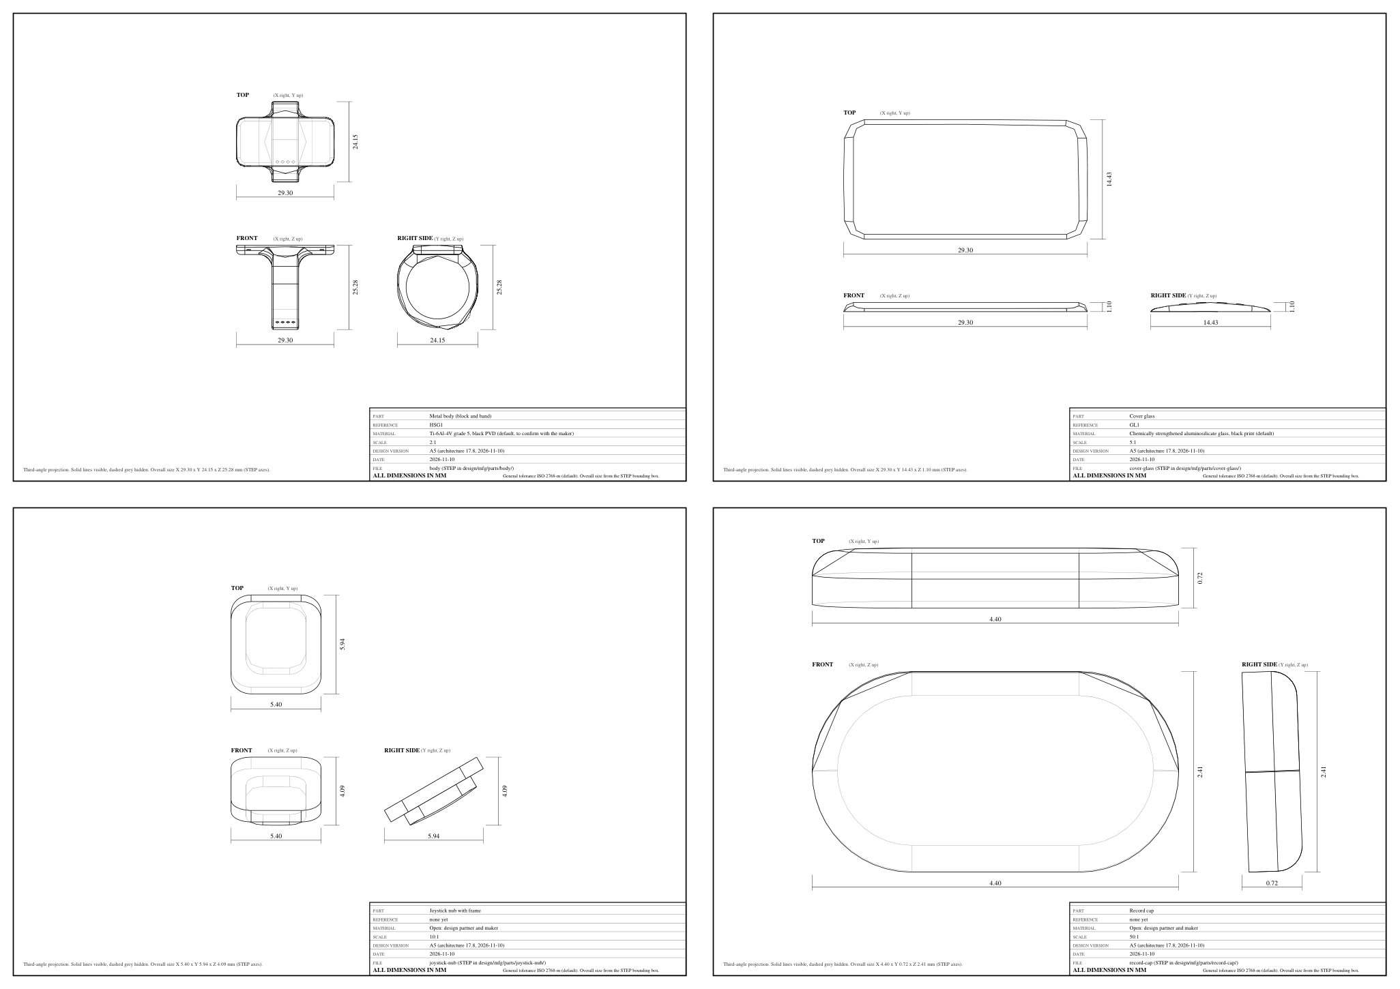
design/mfg/tools/testdata/sheet1.png
