NexusGPT/openring/design/mfg/tools/testdata/sheet2.png

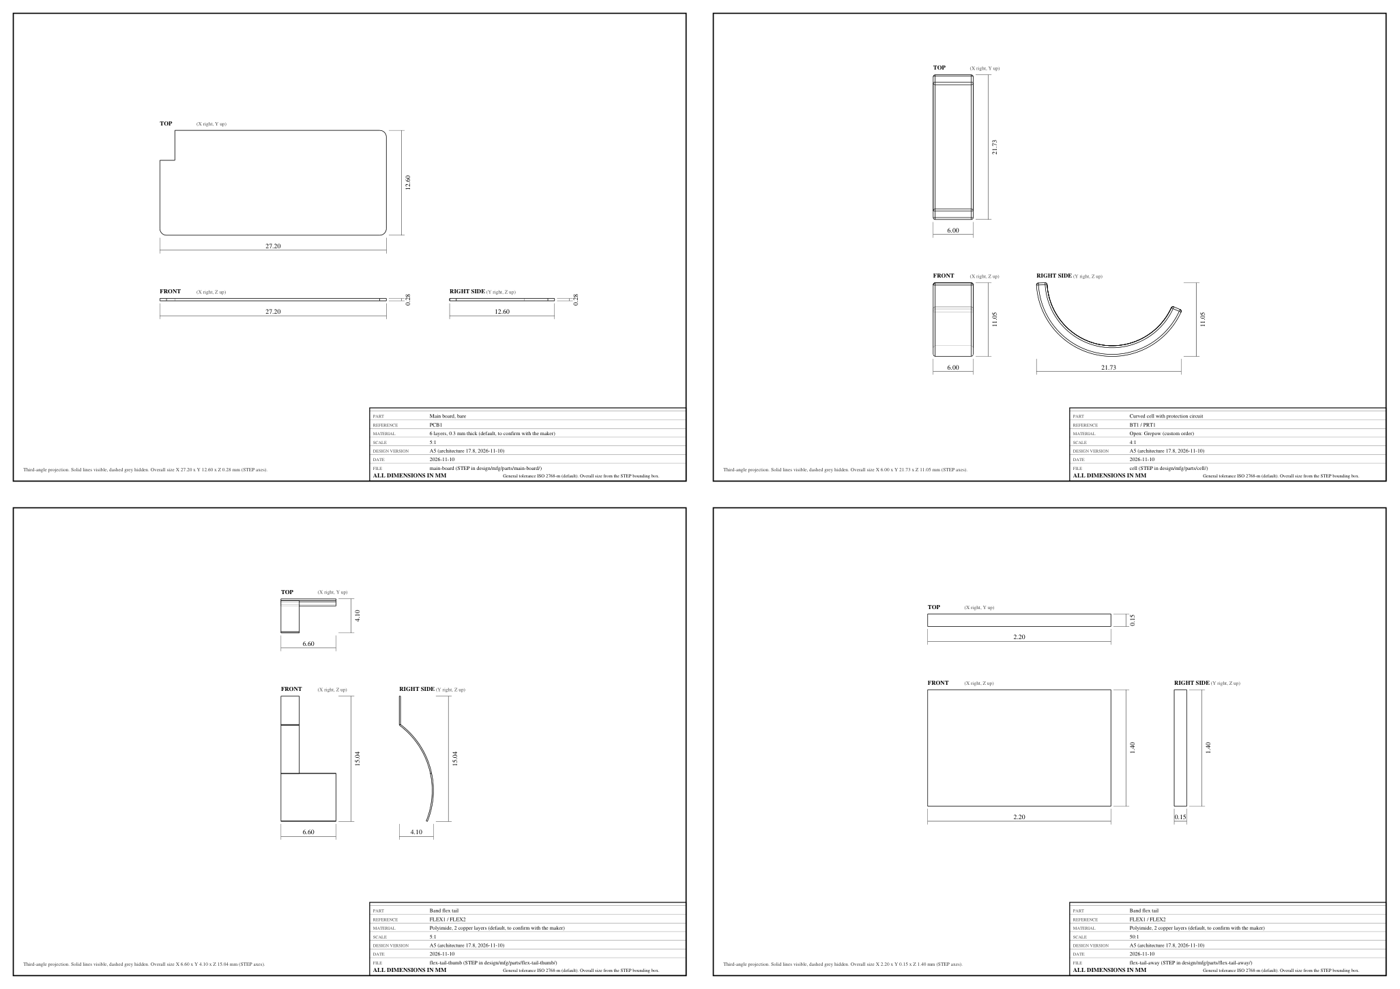
design/mfg/tools/testdata/sheet2.png
