NexusGPT/openring/design/mfg/tools/testdata/sheet3.png

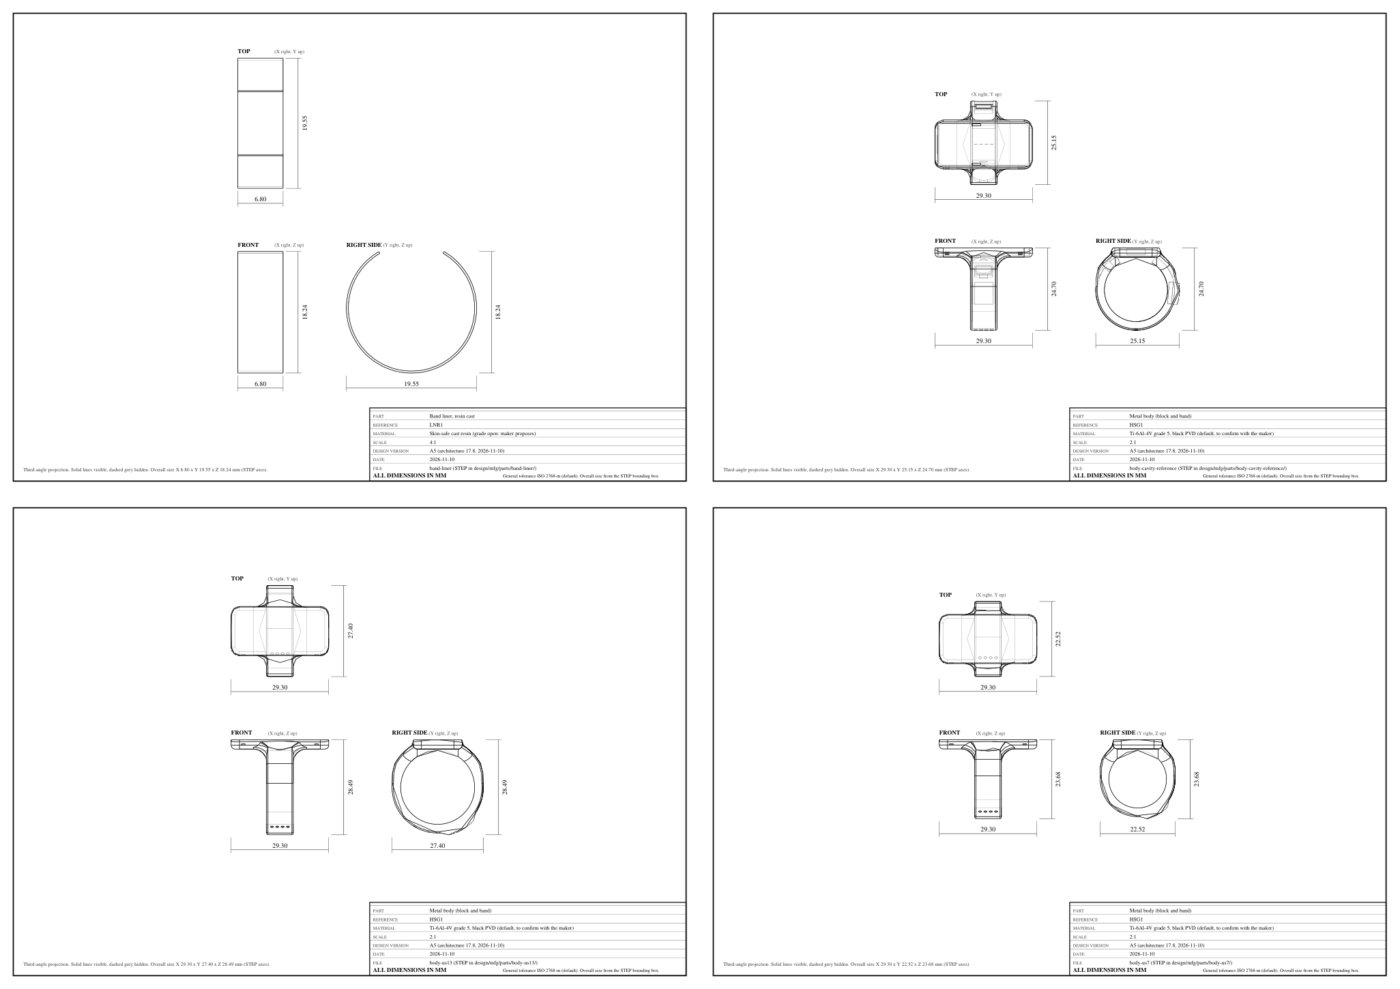
design/mfg/tools/testdata/sheet3.png
