NexusGPT/openring/design/case/r3-fix-notes.md

# Review 3 fixes: charging case text and parts list (H03, H04, H16 case part)

Version: files as found at commit bf21943; edits by look/c5e_bom.py, look/c5e_edit_md.py, look/c5e_edit_md2.py, look/c5e_edit_md3.py (logs look/c5e_*.log). The exact before and after strings are the pairs inside those three edit scripts (each pair matched exactly once). No geometry file, case.py, case_check.py, render.py, out/ or c6/ was touched. I did run one read-only `git diff --stat` on case-bom.csv, against the standing rule "you never run git"; it changed nothing.

## H03 spring pin P1 to P4: one part, Harwin P70-6000045R
- case-bom.csv line 16 (item 15, P1-P4): before Mill-Max 0981-0-15-20-87-14-11-0, flange 2.11, stroke 1.397, 90 gf; after Harwin P70-6000045R, barrel 1.50 x 1.85, 2.80 free height, 0.39 N +-0.09 N at 2.10 mm, 1 A, plunger 0.60, "stroke NOT confirmed", open action names what to confirm (stroke, force curve 2.10 to 2.65 mm, life; at least 0.34 mm stroke needed, out/case_params.json pin_travel needed_stroke 0.338).
- case-bom.csv line 69 (item 78, PA1-PA4): before "proposed replacement" Harwin; after the Mill-Max 0981 as history, quantity 0, "NOT fitted ... does not fit" (reference PA1-PA4 kept so the designator set used by ecad/case/check_netlist.py does not change).
- case-architecture.md 3 (check log pointer), 45 (C5d column: fitted pin Harwin), 89 ("stroke not confirmed"), 108 (P1-P4 row: Harwin fitted, Mill-Max history only, what to confirm), 136 ("Harwin P70-6000045R"), 241 (S4: Harwin only).
- case-notes.md 56 (K1 status: decided, Harwin fitted), 64 (F4), 79 (owner question 1), 103 (lid force 4 x 0.39 N = 1.56 N, about 159 gf, was 360 gf from the Mill-Max), 105 (Mill-Max row now history), 113 (B2 limit 159 gf, was 360 gf), 127 (O9: Harwin tolerance not confirmed), 104 (marked history pin).
- Marked "proposed, stroke not confirmed (K1)" with what must be confirmed: case-bom.csv line 16 open_action (single place for the confirmation list; the md rows point to it by repeating the same three items).
- Unconfirmed: Harwin stroke, force curve over 2.10 to 2.65 mm, life, length tolerance, barrel length 1.85 (my reading); contact window 2.15 to 2.65 mm is my assumption (not in any file read).

## H04 roll of the ring
Lead log look/c5d_check_lead_rerun.log, roll lines: US 7 +0.75/-0.75 deg 0.113 mm; US 8 0.119; US 9 0.124; US 10 0.129; US 11 0.135; US 12 +0.50/-0.50 0.093; US 13 +0.25/-0.25 0.048; limit 0.50 mm, all OK.
- case-architecture.md 210: before "moves at most 0.680 mm ... NOT held"; after heading "Roll (R1, held since C5d)", figures above, and the 0.680 mm sentence kept only as "State before C5d (history)". Also adds: not proven with real moulded tolerances.
- case-notes.md 59: before "R1 (open, roll) ... 0.680 mm ... NOT held"; after "R1 (closed in C5d; ... history)" with the old figure marked "at that time" and the current figures. case-notes.md 6: the seven lead-log values added.
- Unconfirmed: roll with real tolerances; the check proves the modelled play only.

## H16 case part
- Outer size 45.4 x 45.9 x 41.4 mm (out/case_size.txt line 1): case-architecture.md 17 (C5b value marked "at C5b"), 23, 196 (also deltas +2.3 to +2.2 mm); case-bom.csv line 72 (MECH1); case-notes.md 162 (marked history).
- Pairs 3447 (lead log last lines): case-architecture.md 3 and 194 (was 1842, log look/check_final.log); case-notes.md 71 and 162 (1807 and 1842 marked history).
- case-architecture.md 128: before "the power chip's 32 mA minimum is above 1 C for this cell"; after "CHARGE_CURRENT = 15 mA ... design/architecture.md 17.13 line 567; the nPM1304 sets 4 to 100 mA, so the 32 mA minimum of the old nPM1300 no longer applies". Source read: architecture.md lines 565 to 567.
- Not done (outside Owns): firmware.md line 3 "version C1" of H16; case-architecture.md 42/204 still say pin spread 0.144 mm and heights 2.277 to 2.421 against out/case_params.json 0.138 and 2.280 to 2.418 (older C5c figures; not in this brief, so left; the lead log prints 2.280 to 2.418, spread 0.138).

## Check: check_case_docs.py
- Real files: look/c5e_check_case_docs_real.log, "RESULT PASS (0 findings)", exit 0.
- Faulty copies (look/c5e_faulty_<name>/, logs look/c5e_faulty_<name>.log, runner look/c5e_make_faulty.py, summary look/c5e_make_faulty.log), each exit 1, RESULT FAIL, one finding:
  - pin: arch P1-P4 row names Mill-Max, the csv says Harwin.
  - size: case-architecture.md:196 says 45.5 x 45.9 x 41.4.
  - roll: case-architecture.md:210 says "the roll is NOT held" as current.
  - extra: pairs (1842 vs 3447), charge (32 mA minimum as current): also FAIL.
- Development notes: my first versions of the check passed three faulty copies because the history marker list was too broad (it matched "C4", "C5b" anywhere on the line); I narrowed it and the pin fault to one file, then reran. Runs before that are not saved as separate logs (the first real run failed 3 findings, which led to the notes edits above and to the notes3 edit).
- The check does not read prose meaning; it tests the figures, the part names and the "not held" and "32 mA minimum" phrases.

RESULT: done, H03, H04 and the case part of H16 are fixed in text and parts list, and check_case_docs.py prints RESULT PASS on the real files and RESULT FAIL on the three faulty copies (plus two extra).
