NexusGPT/openring/design/ecad/ring/c76-c77-work/notes-fix-lines.txt

51:| A | Murata (same maker as the design's 0201 family) | GRM0335C1H102JE01 (sheet title "GRM0335C1H102JE01_(0603M(0201), C0G(EIA), 1000pF, DC 50V)"; sheet id "GRM0335C1H102JE01-01A") | 1000pF, "+/-5%" | "DC 50V" | "C0G(EIA)", "0+/-30 ppm/℃" | "0.6+/-0.03" x "0.3+/-0.03" x "0.3+/-0.03" | "D" = "φ180mm Reel PAPER Tape W8P2", "15000 pcs./Reel". The part-number system example reads "J            E01              D" (txt line 39). The full string with "D" is not written out on any quoted line. | design/datasheets/c76_murata_GRM0335C1H102JE01.pdf and .txt; txt lines 28, 39, 49, 51, 60, 66 | 9 of 9 for this row, verify-quotes log |
52:| B | Murata (same maker) | GRM033R71H102KA12 (sheet title "GRM033R71H102KA12_(0603M(0201), X7R(EIA), 1000pF, DC 50V)"; sheet id "GRM033R71H102KA12-01A") | 1000pF, "+/-10%" | "DC 50V" | "X7R(EIA)", capacitance change "-15 to 15 %", "-55 to 125℃" | "0.6+/-0.03" x "0.3+/-0.03" x "0.3+/-0.03" | "D" = "φ180mm Reel PAPER Tape W8P2", "15000 pcs./Reel". Packaging code is the same letter scheme as A (txt line 66). | design/datasheets/c76_murata_GRM033R71H102KA12.pdf and .txt; txt lines 28, 51, 60, 66 | 9 of 9 for this row, verify-quotes log |
59:- Values the sheet does not state: "not stated" for ESR, mounting land pattern for 0201 beyond the sheet's land page (not read), and any lot or AEC-Q grade (neither sheet mentions one).
74:- The design's own statement of C76 and C77's rating: not in any design file (pmic-caps-facts.md:238). The datasheet has no 1 nF value (grep "nF" over npm1304_datasheet_v1_0.txt: the only capacitor values are 100 nF and 10 uF rows).
79:- P2, datasheet candidate code is not on the maker site as the design or search named it: GRM033R71H102KA01 gives "could not be found" (saved). Decided: the saved "A12" sheet is the candidate. The lead decides which code is fitted.
