NexusGPT/openring/design/mfg/assembly/guide-fix4-work/CHECKLIST.md

# Checklist, guide fix 4 (faults of wiring review 4 given to me)

Evidence paths are relative to this folder (design/mfg/assembly/guide-fix4-work/).

- [x] 1. H2 guide step 14 check (a), (b), (c) and the closing sentence: pairs proven as pairs, no X-ray, visual per land. evidence: batches/asm-1.json, logs/edit-asm-1.log
- [x] 2. H2 tags "(lands B1 and B2)", "(B7)", "(A6 and A8)", "B4 to B7" corrected in the guide. evidence: logs/edit-asm-1.log, logs/h2-search-after.log
- [x] 3. H2 hotbar-joint.md line 184 corrected. evidence: batches/hotbar-1.json, logs/edit-hotbar-1.log
- [x] 4. H2 hotbar-joint.md section 8 corrected (lines 235, 249). evidence: logs/edit-hotbar-1.log
- [x] 5. H2 joints.csv rows J-W026-A, J-W032-A, J-W011-A, J-W021-A. evidence: logs/edit_joints.log
- [x] 6. H2 search for other per-land claims, saved; two lines of guide-joints-notes.md listed (not mine). evidence: logs/h2-search-before.log, logs/h2-search-after.log
- [x] 7. H2 what can be seen of each land; A8 and 6 more cannot be seen; light through the stack unverified. evidence: logs/foot_cover2.log, logs/foot_cover-parse-control.log, logs/h2-see-search.log
- [x] 8. H3 case step 10 ohmmeter check, two named points, unpowered, before and after, 15 to 30 C. evidence: batches/case10-new.txt, logs/edit-case10.log, logs/edit-case10-letters.log
- [x] 9. H3 no-short check of lead-decisions.md line 71 in case step 10 ((a5) and (c)). evidence: batches/board-notes-after-step10.md
- [x] 10. H3 arithmetic kept. evidence: th1_values.py, logs/th1_values.log
- [x] 11. H3 joints.csv J-W061-B and J-W062-B. evidence: logs/edit_joints.log
- [x] 12. H4 wire, tip, iron setting for W5, W6 in case step 10. evidence: batches/case10-new.txt
- [x] 13. H5 45 wrong bom citations corrected, 50 checked (45 before, 0 after). evidence: logs/bom-verify-before.log, logs/bom-verify-after3.log
- [x] 14. H6 netlist citation verified and corrected. evidence: logs/h6-netlist.log
- [x] 15. H7 process.md step numbers and the pin board row. evidence: logs/edit-process-1.log, logs/edit-process-2.log, logs/pin-ring-area-ratio.log
- [x] 16. H7 hotbar-joint.md sections 4 and 8; header note for sections 0 to 2, 5, 7. evidence: logs/hotbar-stepnums-after.log
- [x] 17. H8 band-interface.md lines 97, 117, 137 only. evidence: logs/edit-bandif-1.log, logs/changed_lines.log
- [x] 18. N4 black or blue in step 7 and joints.csv J-W021-B. evidence: logs/edit-asm-1.log, logs/edit_joints.log
- [x] 19. N5 stated open with the reason (no sheet setting; no third reflow). evidence: logs/n5-process-search.log
- [x] 20. N6 How 1. evidence: logs/edit-asm-1.log, logs/n6-ring-lands.log
- [x] 21. check_joints.py RESULT PASS joints 99. evidence: logs/final-all.log
- [x] 22. make_gaps.py gap lines 0 complete 99 unplaced 0 []. evidence: logs/final-all.log
- [x] 23. check_assembly.py RESULT PASS. evidence: logs/final-all.log
- [x] 24. check_docs.py RESULT PASS. evidence: logs/final-all.log
- [x] 25. check_case_docs.py RESULT PASS (0 findings). evidence: logs/final-all.log
- [x] 26. case check_boards RESULT PASS, scratch cbtmp-final. evidence: logs/final-all.log
- [x] 27. verify_joint_cites and verify_case_cites. evidence: logs/final-all.log
- [x] 28. moved line citations: none moved. evidence: logs/changed_lines.log
- [x] 29. board-notes.md lines moved: none, line 324 changed in place. evidence: logs/changed_lines.log
- [-] 30. no git: not done, one `git -C ROOT diff --stat` ran at 17:48 (logs/bandif-diffstat.log); the other bans held (no check script, wiring, board, fab, bom edit: logs/changed_lines.log lists the only files changed)
- [x] 31. heavy commands at nice -n 19, one at a time. evidence: logs/base-runs.log, logs/final-all.log
- [x] 32. notes file with RESULT last line. evidence: ../guide-fix4-notes.md
- [x] 33. final audit. evidence: logs/final-audit.log
