NexusGPT/openring/design/mfg/assembly/guide-fix4-work/before/joints.csv

joint_id | wiring_line | end | what_meets_what | step | solder_source | flux | tool | heat | orientation | alignment | check | check_possible_at_this_step | source | gap
J-W001-A | W001 | A | ring main board J_BAND_A land 1 (UP), face F.Cu; tail land on F.Cu, to FLEX1 tail land 1 (JOY_UP); hot bar (main board land to FLEX1 tail land 1), every ring size US 7 to 13 | 14 | alloy SAC305 (process.md P1.1); form: a solder layer of about 0.03 mm on the board land, Kester NP505-HR paste printed through the 0.075 mm parts face stencil in pass 2 of step 2 and reflowed, one 0.300 x 0.440 mm opening per land (hotbar-joint.md section 1; board-notes-r4.md E7): paste layer design/ecad/ring/pcb/fab/gerber/ring-F_Paste.gbr for J_BAND_A:1 | Kester 959T no-clean liquid flux, ORL0, a thin coat on the lands of this foot only, dried before the press; flash point 18 C (process.md P1.4) | hot bar (thermode), blade 2.5 x 1.6 mm on the foot's stiffener (a 3 mm blade lands on R61); the fixture design/mfg/assembly/hotbar-fixture.svg; stereo microscope at 20 times; meter with needle tips 0.2 mm or finer (hotbar-joint.md sections 3, 4; process.md P6) | 260 C, 4 s, 20 N, pressure held until the blade is below 150 C: starting values, confirmed on the first build; at most two presses per foot; first board: thermocouple at J1's nearest corner must stay below 217 C (hotbar-joint.md sections 4, 5) | on the bench before the ribbons go into the body: board PARTS FACE UP in the fixture pocket, J1 down in the relief channel; foot on top with its lands (F.Cu) DOWN on the board lands, the neck leaving over the board edge (J_BAND_A upper edge, J_BAND_B lower edge, as engraved); FLEX1 first, then FLEX2 (lead-decisions.md row 'ribbon-to-board joint'; hotbar-joint.md sections 2.5 A, 3, 4) | foot aligned to the board's own lands by eye at 20 times: long edges 0.335 mm outside the outer land columns, end 0.20 mm inside the inner row; after it lies flat each board land shows 0.125 mm at both ends of its tail land (hotbar-joint.md section 3) | land A1, board without power, meter in diode mode: red probe on C28 pad 2 (ground), black on SW1 terminal 3: a diode drop (OL open, 0 short); no beep to the neighbour lands (hotbar-joint.md section 4) | yes | joint_id: design/wiring/product-wiring.csv:2 | wiring_line: design/wiring/product-wiring.csv:2 | end: design/wiring/product-wiring.csv:2 | what_meets_what: design/wiring/product-wiring.csv:2 | step: design/mfg/assembly/assembly.md:199 | solder_source: design/mfg/assembly/assembly.md:97; design/mfg/assembly/hotbar-joint.md:23; design/ecad/ring/pcb/board-notes-r4.md (E7) | flux: design/mfg/assembly/assembly.md:201; design/mfg/assembly/process.md P1.4 | tool: design/mfg/assembly/assembly.md:201; design/mfg/assembly/hotbar-joint.md:167 | heat: design/mfg/assembly/assembly.md:201; design/mfg/assembly/hotbar-joint.md:175; design/mfg/assembly/hotbar-joint.md:191 | orientation: design/mfg/assembly/assembly.md:201; design/mfg/assembly/assembly.md:202; design/wiring/lead-decisions.md:81 | alignment: design/mfg/assembly/assembly.md:203; design/mfg/assembly/hotbar-joint.md:130; design/mfg/assembly/hotbar-joint.md:131 | check: design/mfg/assembly/assembly.md:205; design/mfg/assembly/hotbar-joint.md:147 | check_possible_at_this_step: design/mfg/assembly/assembly.md:205 | process: design/mfg/assembly/process.md P1.1, P1.4, P6
J-W002-A | W002 | A | ring main board J_BAND_A land 2 (DOWN), face F.Cu; tail land on F.Cu, to FLEX1 tail land 2 (JOY_DOWN); hot bar (main board land to FLEX1 tail land 2), every ring size US 7 to 13 | 14 | alloy SAC305 (process.md P1.1); form: a solder layer of about 0.03 mm on the board land, Kester NP505-HR paste printed through the 0.075 mm parts face stencil in pass 2 of step 2 and reflowed, one 0.300 x 0.440 mm opening per land (hotbar-joint.md section 1; board-notes-r4.md E7): paste layer design/ecad/ring/pcb/fab/gerber/ring-F_Paste.gbr for J_BAND_A:2 | Kester 959T no-clean liquid flux, ORL0, a thin coat on the lands of this foot only, dried before the press; flash point 18 C (process.md P1.4) | hot bar (thermode), blade 2.5 x 1.6 mm on the foot's stiffener (a 3 mm blade lands on R61); the fixture design/mfg/assembly/hotbar-fixture.svg; stereo microscope at 20 times; meter with needle tips 0.2 mm or finer (hotbar-joint.md sections 3, 4; process.md P6) | 260 C, 4 s, 20 N, pressure held until the blade is below 150 C: starting values, confirmed on the first build; at most two presses per foot; first board: thermocouple at J1's nearest corner must stay below 217 C (hotbar-joint.md sections 4, 5) | on the bench before the ribbons go into the body: board PARTS FACE UP in the fixture pocket, J1 down in the relief channel; foot on top with its lands (F.Cu) DOWN on the board lands, the neck leaving over the board edge (J_BAND_A upper edge, J_BAND_B lower edge, as engraved); FLEX1 first, then FLEX2 (lead-decisions.md row 'ribbon-to-board joint'; hotbar-joint.md sections 2.5 A, 3, 4) | foot aligned to the board's own lands by eye at 20 times: long edges 0.335 mm outside the outer land columns, end 0.20 mm inside the inner row; after it lies flat each board land shows 0.125 mm at both ends of its tail land (hotbar-joint.md section 3) | land A2, board without power, diode mode: C28 pad 2 to SW3 terminal 3 reads a diode drop (OL open, 0 short); SW3 t3 to SW4 t3 and to SW2 t1 do not beep (hotbar-joint.md section 4) | yes | joint_id: design/wiring/product-wiring.csv:3 | wiring_line: design/wiring/product-wiring.csv:3 | end: design/wiring/product-wiring.csv:3 | what_meets_what: design/wiring/product-wiring.csv:3 | step: design/mfg/assembly/assembly.md:199 | solder_source: design/mfg/assembly/assembly.md:97; design/mfg/assembly/hotbar-joint.md:23; design/ecad/ring/pcb/board-notes-r4.md (E7) | flux: design/mfg/assembly/assembly.md:201; design/mfg/assembly/process.md P1.4 | tool: design/mfg/assembly/assembly.md:201; design/mfg/assembly/hotbar-joint.md:167 | heat: design/mfg/assembly/assembly.md:201; design/mfg/assembly/hotbar-joint.md:175; design/mfg/assembly/hotbar-joint.md:191 | orientation: design/mfg/assembly/assembly.md:201; design/mfg/assembly/assembly.md:202; design/wiring/lead-decisions.md:81 | alignment: design/mfg/assembly/assembly.md:203; design/mfg/assembly/hotbar-joint.md:130; design/mfg/assembly/hotbar-joint.md:131 | check: design/mfg/assembly/assembly.md:205; design/mfg/assembly/hotbar-joint.md:147 | check_possible_at_this_step: design/mfg/assembly/assembly.md:205 | process: design/mfg/assembly/process.md P1.1, P1.4, P6
J-W003-A | W003 | A | ring main board J_BAND_A land 3 (LEFT), face F.Cu; tail land on F.Cu, to FLEX1 tail land 3 (JOY_LEFT); hot bar (main board land to FLEX1 tail land 3), every ring size US 7 to 13 | 14 | alloy SAC305 (process.md P1.1); form: a solder layer of about 0.03 mm on the board land, Kester NP505-HR paste printed through the 0.075 mm parts face stencil in pass 2 of step 2 and reflowed, one 0.300 x 0.440 mm opening per land (hotbar-joint.md section 1; board-notes-r4.md E7): paste layer design/ecad/ring/pcb/fab/gerber/ring-F_Paste.gbr for J_BAND_A:3 | Kester 959T no-clean liquid flux, ORL0, a thin coat on the lands of this foot only, dried before the press; flash point 18 C (process.md P1.4) | hot bar (thermode), blade 2.5 x 1.6 mm on the foot's stiffener (a 3 mm blade lands on R61); the fixture design/mfg/assembly/hotbar-fixture.svg; stereo microscope at 20 times; meter with needle tips 0.2 mm or finer (hotbar-joint.md sections 3, 4; process.md P6) | 260 C, 4 s, 20 N, pressure held until the blade is below 150 C: starting values, confirmed on the first build; at most two presses per foot; first board: thermocouple at J1's nearest corner must stay below 217 C (hotbar-joint.md sections 4, 5) | on the bench before the ribbons go into the body: board PARTS FACE UP in the fixture pocket, J1 down in the relief channel; foot on top with its lands (F.Cu) DOWN on the board lands, the neck leaving over the board edge (J_BAND_A upper edge, J_BAND_B lower edge, as engraved); FLEX1 first, then FLEX2 (lead-decisions.md row 'ribbon-to-board joint'; hotbar-joint.md sections 2.5 A, 3, 4) | foot aligned to the board's own lands by eye at 20 times: long edges 0.335 mm outside the outer land columns, end 0.20 mm inside the inner row; after it lies flat each board land shows 0.125 mm at both ends of its tail land (hotbar-joint.md section 3) | land A3, board without power, diode mode: C28 pad 2 to SW4 terminal 3 reads a diode drop (OL open, 0 short); SW4 t3 to M1 land 1 does not beep (hotbar-joint.md section 4) | yes | joint_id: design/wiring/product-wiring.csv:4 | wiring_line: design/wiring/product-wiring.csv:4 | end: design/wiring/product-wiring.csv:4 | what_meets_what: design/wiring/product-wiring.csv:4 | step: design/mfg/assembly/assembly.md:199 | solder_source: design/mfg/assembly/assembly.md:97; design/mfg/assembly/hotbar-joint.md:23; design/ecad/ring/pcb/board-notes-r4.md (E7) | flux: design/mfg/assembly/assembly.md:201; design/mfg/assembly/process.md P1.4 | tool: design/mfg/assembly/assembly.md:201; design/mfg/assembly/hotbar-joint.md:167 | heat: design/mfg/assembly/assembly.md:201; design/mfg/assembly/hotbar-joint.md:175; design/mfg/assembly/hotbar-joint.md:191 | orientation: design/mfg/assembly/assembly.md:201; design/mfg/assembly/assembly.md:202; design/wiring/lead-decisions.md:81 | alignment: design/mfg/assembly/assembly.md:203; design/mfg/assembly/hotbar-joint.md:130; design/mfg/assembly/hotbar-joint.md:131 | check: design/mfg/assembly/assembly.md:205; design/mfg/assembly/hotbar-joint.md:147 | check_possible_at_this_step: design/mfg/assembly/assembly.md:205 | process: design/mfg/assembly/process.md P1.1, P1.4, P6
J-W004-A | W004 | A | ring main board J_BAND_A land 4 (RIGHT), face F.Cu; tail land on F.Cu, to FLEX1 tail land 4 (JOY_RIGHT); hot bar (main board land to FLEX1 tail land 4), every ring size US 7 to 13 | 14 | alloy SAC305 (process.md P1.1); form: a solder layer of about 0.03 mm on the board land, Kester NP505-HR paste printed through the 0.075 mm parts face stencil in pass 2 of step 2 and reflowed, one 0.300 x 0.440 mm opening per land (hotbar-joint.md section 1; board-notes-r4.md E7): paste layer design/ecad/ring/pcb/fab/gerber/ring-F_Paste.gbr for J_BAND_A:4 | Kester 959T no-clean liquid flux, ORL0, a thin coat on the lands of this foot only, dried before the press; flash point 18 C (process.md P1.4) | hot bar (thermode), blade 2.5 x 1.6 mm on the foot's stiffener (a 3 mm blade lands on R61); the fixture design/mfg/assembly/hotbar-fixture.svg; stereo microscope at 20 times; meter with needle tips 0.2 mm or finer (hotbar-joint.md sections 3, 4; process.md P6) | 260 C, 4 s, 20 N, pressure held until the blade is below 150 C: starting values, confirmed on the first build; at most two presses per foot; first board: thermocouple at J1's nearest corner must stay below 217 C (hotbar-joint.md sections 4, 5) | on the bench before the ribbons go into the body: board PARTS FACE UP in the fixture pocket, J1 down in the relief channel; foot on top with its lands (F.Cu) DOWN on the board lands, the neck leaving over the board edge (J_BAND_A upper edge, J_BAND_B lower edge, as engraved); FLEX1 first, then FLEX2 (lead-decisions.md row 'ribbon-to-board joint'; hotbar-joint.md sections 2.5 A, 3, 4) | foot aligned to the board's own lands by eye at 20 times: long edges 0.335 mm outside the outer land columns, end 0.20 mm inside the inner row; after it lies flat each board land shows 0.125 mm at both ends of its tail land (hotbar-joint.md section 3) | land A4, board without power, diode mode: C28 pad 2 to SW5 terminal 3 reads a diode drop (OL open, 0 short); SW1 t3 to SW5 t3 does not beep (hotbar-joint.md section 4) | yes | joint_id: design/wiring/product-wiring.csv:5 | wiring_line: design/wiring/product-wiring.csv:5 | end: design/wiring/product-wiring.csv:5 | what_meets_what: design/wiring/product-wiring.csv:5 | step: design/mfg/assembly/assembly.md:199 | solder_source: design/mfg/assembly/assembly.md:97; design/mfg/assembly/hotbar-joint.md:23; design/ecad/ring/pcb/board-notes-r4.md (E7) | flux: design/mfg/assembly/assembly.md:201; design/mfg/assembly/process.md P1.4 | tool: design/mfg/assembly/assembly.md:201; design/mfg/assembly/hotbar-joint.md:167 | heat: design/mfg/assembly/assembly.md:201; design/mfg/assembly/hotbar-joint.md:175; design/mfg/assembly/hotbar-joint.md:191 | orientation: design/mfg/assembly/assembly.md:201; design/mfg/assembly/assembly.md:202; design/wiring/lead-decisions.md:81 | alignment: design/mfg/assembly/assembly.md:203; design/mfg/assembly/hotbar-joint.md:130; design/mfg/assembly/hotbar-joint.md:131 | check: design/mfg/assembly/assembly.md:205; design/mfg/assembly/hotbar-joint.md:147 | check_possible_at_this_step: design/mfg/assembly/assembly.md:205 | process: design/mfg/assembly/process.md P1.1, P1.4, P6
J-W005-A | W005 | A | ring main board J_BAND_A land 5 (CENTRE), face F.Cu; tail land on F.Cu, to FLEX1 tail land 5 (BTN_REC); hot bar (main board land to FLEX1 tail land 5), every ring size US 7 to 13 | 14 | alloy SAC305 (process.md P1.1); form: a solder layer of about 0.03 mm on the board land, Kester NP505-HR paste printed through the 0.075 mm parts face stencil in pass 2 of step 2 and reflowed, one 0.300 x 0.440 mm opening per land (hotbar-joint.md section 1; board-notes-r4.md E7): paste layer design/ecad/ring/pcb/fab/gerber/ring-F_Paste.gbr for J_BAND_A:5 | Kester 959T no-clean liquid flux, ORL0, a thin coat on the lands of this foot only, dried before the press; flash point 18 C (process.md P1.4) | hot bar (thermode), blade 2.5 x 1.6 mm on the foot's stiffener (a 3 mm blade lands on R61); the fixture design/mfg/assembly/hotbar-fixture.svg; stereo microscope at 20 times; meter with needle tips 0.2 mm or finer (hotbar-joint.md sections 3, 4; process.md P6) | 260 C, 4 s, 20 N, pressure held until the blade is below 150 C: starting values, confirmed on the first build; at most two presses per foot; first board: thermocouple at J1's nearest corner must stay below 217 C (hotbar-joint.md sections 4, 5) | on the bench before the ribbons go into the body: board PARTS FACE UP in the fixture pocket, J1 down in the relief channel; foot on top with its lands (F.Cu) DOWN on the board lands, the neck leaving over the board edge (J_BAND_A upper edge, J_BAND_B lower edge, as engraved); FLEX1 first, then FLEX2 (lead-decisions.md row 'ribbon-to-board joint'; hotbar-joint.md sections 2.5 A, 3, 4) | foot aligned to the board's own lands by eye at 20 times: long edges 0.335 mm outside the outer land columns, end 0.20 mm inside the inner row; after it lies flat each board land shows 0.125 mm at both ends of its tail land (hotbar-joint.md section 3) | land A5, board without power, diode mode: C28 pad 2 to SW2 terminal 1 reads a diode drop (OL open, 0 short); SW2 t1 to M1 land 1 does not beep (hotbar-joint.md section 4) | yes | joint_id: design/wiring/product-wiring.csv:6 | wiring_line: design/wiring/product-wiring.csv:6 | end: design/wiring/product-wiring.csv:6 | what_meets_what: design/wiring/product-wiring.csv:6 | step: design/mfg/assembly/assembly.md:199 | solder_source: design/mfg/assembly/assembly.md:97; design/mfg/assembly/hotbar-joint.md:23; design/ecad/ring/pcb/board-notes-r4.md (E7) | flux: design/mfg/assembly/assembly.md:201; design/mfg/assembly/process.md P1.4 | tool: design/mfg/assembly/assembly.md:201; design/mfg/assembly/hotbar-joint.md:167 | heat: design/mfg/assembly/assembly.md:201; design/mfg/assembly/hotbar-joint.md:175; design/mfg/assembly/hotbar-joint.md:191 | orientation: design/mfg/assembly/assembly.md:201; design/mfg/assembly/assembly.md:202; design/wiring/lead-decisions.md:81 | alignment: design/mfg/assembly/assembly.md:203; design/mfg/assembly/hotbar-joint.md:130; design/mfg/assembly/hotbar-joint.md:131 | check: design/mfg/assembly/assembly.md:205; design/mfg/assembly/hotbar-joint.md:147 | check_possible_at_this_step: design/mfg/assembly/assembly.md:205 | process: design/mfg/assembly/process.md P1.1, P1.4, P6
J-W011-A | W011 | A | ring main board J_BAND_A land 8 (GND), face F.Cu; tail land on F.Cu, to FLEX1 tail land 8 (GND); hot bar (main board land to FLEX1 tail land 8), every ring size US 7 to 13 | 14 | alloy SAC305 (process.md P1.1); form: a solder layer of about 0.03 mm on the board land, Kester NP505-HR paste printed through the 0.075 mm parts face stencil in pass 2 of step 2 and reflowed, one 0.300 x 0.440 mm opening per land (hotbar-joint.md section 1; board-notes-r4.md E7): paste layer design/ecad/ring/pcb/fab/gerber/ring-F_Paste.gbr for J_BAND_A:8 | Kester 959T no-clean liquid flux, ORL0, a thin coat on the lands of this foot only, dried before the press; flash point 18 C (process.md P1.4) | hot bar (thermode), blade 2.5 x 1.6 mm on the foot's stiffener (a 3 mm blade lands on R61); the fixture design/mfg/assembly/hotbar-fixture.svg; stereo microscope at 20 times; meter with needle tips 0.2 mm or finer (hotbar-joint.md sections 3, 4; process.md P6) | 260 C, 4 s, 20 N, pressure held until the blade is below 150 C: starting values, confirmed on the first build; at most two presses per foot; first board: thermocouple at J1's nearest corner must stay below 217 C (hotbar-joint.md sections 4, 5) | on the bench before the ribbons go into the body: board PARTS FACE UP in the fixture pocket, J1 down in the relief channel; foot on top with its lands (F.Cu) DOWN on the board lands, the neck leaving over the board edge (J_BAND_A upper edge, J_BAND_B lower edge, as engraved); FLEX1 first, then FLEX2 (lead-decisions.md row 'ribbon-to-board joint'; hotbar-joint.md sections 2.5 A, 3, 4) | foot aligned to the board's own lands by eye at 20 times: long edges 0.335 mm outside the outer land columns, end 0.20 mm inside the inner row; after it lies flat each board land shows 0.125 mm at both ends of its tail land (hotbar-joint.md section 3) | land A8, board without power: SW1 terminal 4 to C28 pad 2 beeps; A8 and A6 are both ground and joined on the ribbon, so an open of one of them is seen only by X-ray (the lead decides whether it is asked) (hotbar-joint.md section 4) | yes | joint_id: design/wiring/product-wiring.csv:12 | wiring_line: design/wiring/product-wiring.csv:12 | end: design/wiring/product-wiring.csv:12 | what_meets_what: design/wiring/product-wiring.csv:12 | step: design/mfg/assembly/assembly.md:199 | solder_source: design/mfg/assembly/assembly.md:97; design/mfg/assembly/hotbar-joint.md:23; design/ecad/ring/pcb/board-notes-r4.md (E7) | flux: design/mfg/assembly/assembly.md:201; design/mfg/assembly/process.md P1.4 | tool: design/mfg/assembly/assembly.md:201; design/mfg/assembly/hotbar-joint.md:167 | heat: design/mfg/assembly/assembly.md:201; design/mfg/assembly/hotbar-joint.md:175; design/mfg/assembly/hotbar-joint.md:191 | orientation: design/mfg/assembly/assembly.md:201; design/mfg/assembly/assembly.md:202; design/wiring/lead-decisions.md:81 | alignment: design/mfg/assembly/assembly.md:203; design/mfg/assembly/hotbar-joint.md:130; design/mfg/assembly/hotbar-joint.md:131 | check: design/mfg/assembly/assembly.md:205; design/mfg/assembly/hotbar-joint.md:147 | check_possible_at_this_step: design/mfg/assembly/assembly.md:205 | process: design/mfg/assembly/process.md P1.1, P1.4, P6
J-W021-A | W021 | A | ring main board J_BAND_A land 6 (MOT-), face F.Cu; tail land on F.Cu, to FLEX1 tail land 6 (GND); hot bar (main board land to FLEX1 tail land 6), every ring size US 7 to 13 | 14 | alloy SAC305 (process.md P1.1); form: a solder layer of about 0.03 mm on the board land, Kester NP505-HR paste printed through the 0.075 mm parts face stencil in pass 2 of step 2 and reflowed, one 0.300 x 0.440 mm opening per land (hotbar-joint.md section 1; board-notes-r4.md E7): paste layer design/ecad/ring/pcb/fab/gerber/ring-F_Paste.gbr for J_BAND_A:6 | Kester 959T no-clean liquid flux, ORL0, a thin coat on the lands of this foot only, dried before the press; flash point 18 C (process.md P1.4) | hot bar (thermode), blade 2.5 x 1.6 mm on the foot's stiffener (a 3 mm blade lands on R61); the fixture design/mfg/assembly/hotbar-fixture.svg; stereo microscope at 20 times; meter with needle tips 0.2 mm or finer (hotbar-joint.md sections 3, 4; process.md P6) | 260 C, 4 s, 20 N, pressure held until the blade is below 150 C: starting values, confirmed on the first build; at most two presses per foot; first board: thermocouple at J1's nearest corner must stay below 217 C (hotbar-joint.md sections 4, 5) | on the bench before the ribbons go into the body: board PARTS FACE UP in the fixture pocket, J1 down in the relief channel; foot on top with its lands (F.Cu) DOWN on the board lands, the neck leaving over the board edge (J_BAND_A upper edge, J_BAND_B lower edge, as engraved); FLEX1 first, then FLEX2 (lead-decisions.md row 'ribbon-to-board joint'; hotbar-joint.md sections 2.5 A, 3, 4) | foot aligned to the board's own lands by eye at 20 times: long edges 0.335 mm outside the outer land columns, end 0.20 mm inside the inner row; after it lies flat each board land shows 0.125 mm at both ends of its tail land (hotbar-joint.md section 3) | land A6, board without power: SW1 terminal 4 to C28 pad 2 beeps; A6 and A8 are both ground and joined on the ribbon, so an open of one of them is seen only by X-ray (the lead decides whether it is asked) (hotbar-joint.md section 4) | yes | joint_id: design/wiring/product-wiring.csv:22 | wiring_line: design/wiring/product-wiring.csv:22 | end: design/wiring/product-wiring.csv:22 | what_meets_what: design/wiring/product-wiring.csv:22 | step: design/mfg/assembly/assembly.md:199 | solder_source: design/mfg/assembly/assembly.md:97; design/mfg/assembly/hotbar-joint.md:23; design/ecad/ring/pcb/board-notes-r4.md (E7) | flux: design/mfg/assembly/assembly.md:201; design/mfg/assembly/process.md P1.4 | tool: design/mfg/assembly/assembly.md:201; design/mfg/assembly/hotbar-joint.md:167 | heat: design/mfg/assembly/assembly.md:201; design/mfg/assembly/hotbar-joint.md:175; design/mfg/assembly/hotbar-joint.md:191 | orientation: design/mfg/assembly/assembly.md:201; design/mfg/assembly/assembly.md:202; design/wiring/lead-decisions.md:81 | alignment: design/mfg/assembly/assembly.md:203; design/mfg/assembly/hotbar-joint.md:130; design/mfg/assembly/hotbar-joint.md:131 | check: design/mfg/assembly/assembly.md:205; design/mfg/assembly/hotbar-joint.md:147 | check_possible_at_this_step: design/mfg/assembly/assembly.md:205 | process: design/mfg/assembly/process.md P1.1, P1.4, P6
J-W022-A | W022 | A | ring main board J_BAND_A land 7 (MOT+), face F.Cu; tail land on F.Cu, to FLEX1 tail land 7 (VMOT); hot bar (main board land to FLEX1 tail land 7), every ring size US 7 to 13 | 14 | alloy SAC305 (process.md P1.1); form: a solder layer of about 0.03 mm on the board land, Kester NP505-HR paste printed through the 0.075 mm parts face stencil in pass 2 of step 2 and reflowed, one 0.300 x 0.440 mm opening per land (hotbar-joint.md section 1; board-notes-r4.md E7): paste layer design/ecad/ring/pcb/fab/gerber/ring-F_Paste.gbr for J_BAND_A:7 | Kester 959T no-clean liquid flux, ORL0, a thin coat on the lands of this foot only, dried before the press; flash point 18 C (process.md P1.4) | hot bar (thermode), blade 2.5 x 1.6 mm on the foot's stiffener (a 3 mm blade lands on R61); the fixture design/mfg/assembly/hotbar-fixture.svg; stereo microscope at 20 times; meter with needle tips 0.2 mm or finer (hotbar-joint.md sections 3, 4; process.md P6) | 260 C, 4 s, 20 N, pressure held until the blade is below 150 C: starting values, confirmed on the first build; at most two presses per foot; first board: thermocouple at J1's nearest corner must stay below 217 C (hotbar-joint.md sections 4, 5) | on the bench before the ribbons go into the body: board PARTS FACE UP in the fixture pocket, J1 down in the relief channel; foot on top with its lands (F.Cu) DOWN on the board lands, the neck leaving over the board edge (J_BAND_A upper edge, J_BAND_B lower edge, as engraved); FLEX1 first, then FLEX2 (lead-decisions.md row 'ribbon-to-board joint'; hotbar-joint.md sections 2.5 A, 3, 4) | foot aligned to the board's own lands by eye at 20 times: long edges 0.335 mm outside the outer land columns, end 0.20 mm inside the inner row; after it lies flat each board land shows 0.125 mm at both ends of its tail land (hotbar-joint.md section 3) | land A7, board without power: M1 land 1 (red lead) to C84 pad 1 (VMOT) beeps; M1 land 1 to C28 pad 2 reads the motor's own reading of step 7, not 0 ohm (hotbar-joint.md section 4) | yes | joint_id: design/wiring/product-wiring.csv:23 | wiring_line: design/wiring/product-wiring.csv:23 | end: design/wiring/product-wiring.csv:23 | what_meets_what: design/wiring/product-wiring.csv:23 | step: design/mfg/assembly/assembly.md:199 | solder_source: design/mfg/assembly/assembly.md:97; design/mfg/assembly/hotbar-joint.md:23; design/ecad/ring/pcb/board-notes-r4.md (E7) | flux: design/mfg/assembly/assembly.md:201; design/mfg/assembly/process.md P1.4 | tool: design/mfg/assembly/assembly.md:201; design/mfg/assembly/hotbar-joint.md:167 | heat: design/mfg/assembly/assembly.md:201; design/mfg/assembly/hotbar-joint.md:175; design/mfg/assembly/hotbar-joint.md:191 | orientation: design/mfg/assembly/assembly.md:201; design/mfg/assembly/assembly.md:202; design/wiring/lead-decisions.md:81 | alignment: design/mfg/assembly/assembly.md:203; design/mfg/assembly/hotbar-joint.md:130; design/mfg/assembly/hotbar-joint.md:131 | check: design/mfg/assembly/assembly.md:205; design/mfg/assembly/hotbar-joint.md:147 | check_possible_at_this_step: design/mfg/assembly/assembly.md:205 | process: design/mfg/assembly/process.md P1.1, P1.4, P6
J-W025-A | W025 | A | ring main board J_BAND_B land 1 (CELL+), face F.Cu; tail land on F.Cu, to FLEX2 tail land 1 (VBAT); hot bar (main board land to FLEX2 tail land 1), every ring size US 7 to 13 | 14 | alloy SAC305 (process.md P1.1); form: a solder layer of about 0.03 mm on the board land, Kester NP505-HR paste printed through the 0.075 mm parts face stencil in pass 2 of step 2 and reflowed, one 0.300 x 0.440 mm opening per land (hotbar-joint.md section 1; board-notes-r4.md E7): paste layer design/ecad/ring/pcb/fab/gerber/ring-F_Paste.gbr for J_BAND_B:1 | Kester 959T no-clean liquid flux, ORL0, a thin coat on the lands of this foot only, dried before the press; flash point 18 C (process.md P1.4) | hot bar (thermode), blade 2.5 x 1.6 mm on the foot's stiffener (a 3 mm blade lands on R61); the fixture design/mfg/assembly/hotbar-fixture.svg; stereo microscope at 20 times; meter with needle tips 0.2 mm or finer (hotbar-joint.md sections 3, 4; process.md P6) | 260 C, 4 s, 20 N, pressure held until the blade is below 150 C: starting values, confirmed on the first build; at most two presses per foot; first board: thermocouple at J1's nearest corner must stay below 217 C (hotbar-joint.md sections 4, 5) | on the bench before the ribbons go into the body: board PARTS FACE UP in the fixture pocket, J1 down in the relief channel; foot on top with its lands (F.Cu) DOWN on the board lands, the neck leaving over the board edge (J_BAND_A upper edge, J_BAND_B lower edge, as engraved); FLEX1 first, then FLEX2 (lead-decisions.md row 'ribbon-to-board joint'; hotbar-joint.md sections 2.5 A, 3, 4) | foot aligned to the board's own lands by eye at 20 times: long edges 0.335 mm outside the outer land columns, end 0.20 mm inside the inner row; after it lies flat each board land shows 0.125 mm at both ends of its tail land (hotbar-joint.md section 3) | land B1, board on the cell: C83 pad 1 to C83 pad 2 reads the cell voltage recorded at step 9 within 0.05 V (starting value) (hotbar-joint.md section 4) | yes | joint_id: design/wiring/product-wiring.csv:26 | wiring_line: design/wiring/product-wiring.csv:26 | end: design/wiring/product-wiring.csv:26 | what_meets_what: design/wiring/product-wiring.csv:26 | step: design/mfg/assembly/assembly.md:199 | solder_source: design/mfg/assembly/assembly.md:97; design/mfg/assembly/hotbar-joint.md:23; design/ecad/ring/pcb/board-notes-r4.md (E7) | flux: design/mfg/assembly/assembly.md:201; design/mfg/assembly/process.md P1.4 | tool: design/mfg/assembly/assembly.md:201; design/mfg/assembly/hotbar-joint.md:167 | heat: design/mfg/assembly/assembly.md:201; design/mfg/assembly/hotbar-joint.md:175; design/mfg/assembly/hotbar-joint.md:191 | orientation: design/mfg/assembly/assembly.md:201; design/mfg/assembly/assembly.md:202; design/wiring/lead-decisions.md:81 | alignment: design/mfg/assembly/assembly.md:203; design/mfg/assembly/hotbar-joint.md:130; design/mfg/assembly/hotbar-joint.md:131 | check: design/mfg/assembly/assembly.md:205; design/mfg/assembly/hotbar-joint.md:147 | check_possible_at_this_step: design/mfg/assembly/assembly.md:205 | process: design/mfg/assembly/process.md P1.1, P1.4, P6
J-W026-A | W026 | A | ring main board J_BAND_B land 2 (CELL-), face F.Cu; tail land on F.Cu, to FLEX2 tail land 2 (GND); hot bar (main board land to FLEX2 tail land 2), every ring size US 7 to 13 | 14 | alloy SAC305 (process.md P1.1); form: a solder layer of about 0.03 mm on the board land, Kester NP505-HR paste printed through the 0.075 mm parts face stencil in pass 2 of step 2 and reflowed, one 0.300 x 0.440 mm opening per land (hotbar-joint.md section 1; board-notes-r4.md E7): paste layer design/ecad/ring/pcb/fab/gerber/ring-F_Paste.gbr for J_BAND_B:2 | Kester 959T no-clean liquid flux, ORL0, a thin coat on the lands of this foot only, dried before the press; flash point 18 C (process.md P1.4) | hot bar (thermode), blade 2.5 x 1.6 mm on the foot's stiffener (a 3 mm blade lands on R61); the fixture design/mfg/assembly/hotbar-fixture.svg; stereo microscope at 20 times; meter with needle tips 0.2 mm or finer (hotbar-joint.md sections 3, 4; process.md P6) | 260 C, 4 s, 20 N, pressure held until the blade is below 150 C: starting values, confirmed on the first build; at most two presses per foot; first board: thermocouple at J1's nearest corner must stay below 217 C (hotbar-joint.md sections 4, 5) | on the bench before the ribbons go into the body: board PARTS FACE UP in the fixture pocket, J1 down in the relief channel; foot on top with its lands (F.Cu) DOWN on the board lands, the neck leaving over the board edge (J_BAND_A upper edge, J_BAND_B lower edge, as engraved); FLEX1 first, then FLEX2 (lead-decisions.md row 'ribbon-to-board joint'; hotbar-joint.md sections 2.5 A, 3, 4) | foot aligned to the board's own lands by eye at 20 times: long edges 0.335 mm outside the outer land columns, end 0.20 mm inside the inner row; after it lies flat each board land shows 0.125 mm at both ends of its tail land (hotbar-joint.md section 3) | land B2, board on the cell: C83 pad 1 to C83 pad 2 reads the cell voltage recorded at step 9 within 0.05 V (starting value) (hotbar-joint.md section 4) | yes | joint_id: design/wiring/product-wiring.csv:27 | wiring_line: design/wiring/product-wiring.csv:27 | end: design/wiring/product-wiring.csv:27 | what_meets_what: design/wiring/product-wiring.csv:27 | step: design/mfg/assembly/assembly.md:199 | solder_source: design/mfg/assembly/assembly.md:97; design/mfg/assembly/hotbar-joint.md:23; design/ecad/ring/pcb/board-notes-r4.md (E7) | flux: design/mfg/assembly/assembly.md:201; design/mfg/assembly/process.md P1.4 | tool: design/mfg/assembly/assembly.md:201; design/mfg/assembly/hotbar-joint.md:167 | heat: design/mfg/assembly/assembly.md:201; design/mfg/assembly/hotbar-joint.md:175; design/mfg/assembly/hotbar-joint.md:191 | orientation: design/mfg/assembly/assembly.md:201; design/mfg/assembly/assembly.md:202; design/wiring/lead-decisions.md:81 | alignment: design/mfg/assembly/assembly.md:203; design/mfg/assembly/hotbar-joint.md:130; design/mfg/assembly/hotbar-joint.md:131 | check: design/mfg/assembly/assembly.md:205; design/mfg/assembly/hotbar-joint.md:147 | check_possible_at_this_step: design/mfg/assembly/assembly.md:205 | process: design/mfg/assembly/process.md P1.1, P1.4, P6
J-W027-A | W027 | A | ring main board J_BAND_B land 3 (NTC), face F.Cu; tail land on F.Cu, to FLEX2 tail land 3 (NTC); hot bar (main board land to FLEX2 tail land 3), every ring size US 7 to 13 | 14 | alloy SAC305 (process.md P1.1); form: a solder layer of about 0.03 mm on the board land, Kester NP505-HR paste printed through the 0.075 mm parts face stencil in pass 2 of step 2 and reflowed, one 0.300 x 0.440 mm opening per land (hotbar-joint.md section 1; board-notes-r4.md E7): paste layer design/ecad/ring/pcb/fab/gerber/ring-F_Paste.gbr for J_BAND_B:3 | Kester 959T no-clean liquid flux, ORL0, a thin coat on the lands of this foot only, dried before the press; flash point 18 C (process.md P1.4) | hot bar (thermode), blade 2.5 x 1.6 mm on the foot's stiffener (a 3 mm blade lands on R61); the fixture design/mfg/assembly/hotbar-fixture.svg; stereo microscope at 20 times; meter with needle tips 0.2 mm or finer (hotbar-joint.md sections 3, 4; process.md P6) | 260 C, 4 s, 20 N, pressure held until the blade is below 150 C: starting values, confirmed on the first build; at most two presses per foot; first board: thermocouple at J1's nearest corner must stay below 217 C (hotbar-joint.md sections 4, 5) | on the bench before the ribbons go into the body: board PARTS FACE UP in the fixture pocket, J1 down in the relief channel; foot on top with its lands (F.Cu) DOWN on the board lands, the neck leaving over the board edge (J_BAND_A upper edge, J_BAND_B lower edge, as engraved); FLEX1 first, then FLEX2 (lead-decisions.md row 'ribbon-to-board joint'; hotbar-joint.md sections 2.5 A, 3, 4) | foot aligned to the board's own lands by eye at 20 times: long edges 0.335 mm outside the outer land columns, end 0.20 mm inside the inner row; after it lies flat each board land shows 0.125 mm at both ends of its tail land (hotbar-joint.md section 3) | land B3, FACTORY ENTER and T-CHARGE pass at the end of the step; an open NTC land reads as cold and T-CHARGE fails with the charger off (hotbar-joint.md section 4) | yes | joint_id: design/wiring/product-wiring.csv:28 | wiring_line: design/wiring/product-wiring.csv:28 | end: design/wiring/product-wiring.csv:28 | what_meets_what: design/wiring/product-wiring.csv:28 | step: design/mfg/assembly/assembly.md:199 | solder_source: design/mfg/assembly/assembly.md:97; design/mfg/assembly/hotbar-joint.md:23; design/ecad/ring/pcb/board-notes-r4.md (E7) | flux: design/mfg/assembly/assembly.md:201; design/mfg/assembly/process.md P1.4 | tool: design/mfg/assembly/assembly.md:201; design/mfg/assembly/hotbar-joint.md:167 | heat: design/mfg/assembly/assembly.md:201; design/mfg/assembly/hotbar-joint.md:175; design/mfg/assembly/hotbar-joint.md:191 | orientation: design/mfg/assembly/assembly.md:201; design/mfg/assembly/assembly.md:202; design/wiring/lead-decisions.md:81 | alignment: design/mfg/assembly/assembly.md:203; design/mfg/assembly/hotbar-joint.md:130; design/mfg/assembly/hotbar-joint.md:131 | check: design/mfg/assembly/assembly.md:205; design/mfg/assembly/hotbar-joint.md:147 | check_possible_at_this_step: design/mfg/assembly/assembly.md:205 | process: design/mfg/assembly/process.md P1.1, P1.4, P6
J-W029-A | W029 | A | ring main board J_BAND_B land 4 (VBUS), face F.Cu; tail land on F.Cu, to FLEX2 tail land 4 (VBUS); hot bar (main board land to FLEX2 tail land 4), every ring size US 7 to 13 | 14 | alloy SAC305 (process.md P1.1); form: a solder layer of about 0.03 mm on the board land, Kester NP505-HR paste printed through the 0.075 mm parts face stencil in pass 2 of step 2 and reflowed, one 0.300 x 0.440 mm opening per land (hotbar-joint.md section 1; board-notes-r4.md E7): paste layer design/ecad/ring/pcb/fab/gerber/ring-F_Paste.gbr for J_BAND_B:4 | Kester 959T no-clean liquid flux, ORL0, a thin coat on the lands of this foot only, dried before the press; flash point 18 C (process.md P1.4) | hot bar (thermode), blade 2.5 x 1.6 mm on the foot's stiffener (a 3 mm blade lands on R61); the fixture design/mfg/assembly/hotbar-fixture.svg; stereo microscope at 20 times; meter with needle tips 0.2 mm or finer (hotbar-joint.md sections 3, 4; process.md P6) | 260 C, 4 s, 20 N, pressure held until the blade is below 150 C: starting values, confirmed on the first build; at most two presses per foot; first board: thermocouple at J1's nearest corner must stay below 217 C (hotbar-joint.md sections 4, 5) | on the bench before the ribbons go into the body: board PARTS FACE UP in the fixture pocket, J1 down in the relief channel; foot on top with its lands (F.Cu) DOWN on the board lands, the neck leaving over the board edge (J_BAND_A upper edge, J_BAND_B lower edge, as engraved); FLEX1 first, then FLEX2 (lead-decisions.md row 'ribbon-to-board joint'; hotbar-joint.md sections 2.5 A, 3, 4) | foot aligned to the board's own lands by eye at 20 times: long edges 0.335 mm outside the outer land columns, end 0.20 mm inside the inner row; after it lies flat each board land shows 0.125 mm at both ends of its tail land (hotbar-joint.md section 3) | land B4, disc CP1 to C71 pad 1 beeps; then USB through CP1 to CP4 enumerates and GET_INFO answers (hotbar-joint.md section 4) | yes | joint_id: design/wiring/product-wiring.csv:30 | wiring_line: design/wiring/product-wiring.csv:30 | end: design/wiring/product-wiring.csv:30 | what_meets_what: design/wiring/product-wiring.csv:30 | step: design/mfg/assembly/assembly.md:199 | solder_source: design/mfg/assembly/assembly.md:97; design/mfg/assembly/hotbar-joint.md:23; design/ecad/ring/pcb/board-notes-r4.md (E7) | flux: design/mfg/assembly/assembly.md:201; design/mfg/assembly/process.md P1.4 | tool: design/mfg/assembly/assembly.md:201; design/mfg/assembly/hotbar-joint.md:167 | heat: design/mfg/assembly/assembly.md:201; design/mfg/assembly/hotbar-joint.md:175; design/mfg/assembly/hotbar-joint.md:191 | orientation: design/mfg/assembly/assembly.md:201; design/mfg/assembly/assembly.md:202; design/wiring/lead-decisions.md:81 | alignment: design/mfg/assembly/assembly.md:203; design/mfg/assembly/hotbar-joint.md:130; design/mfg/assembly/hotbar-joint.md:131 | check: design/mfg/assembly/assembly.md:205; design/mfg/assembly/hotbar-joint.md:147 | check_possible_at_this_step: design/mfg/assembly/assembly.md:205 | process: design/mfg/assembly/process.md P1.1, P1.4, P6
J-W030-A | W030 | A | ring main board J_BAND_B land 5 (D-), face F.Cu; tail land on F.Cu, to FLEX2 tail land 5 (USB_DN); hot bar (main board land to FLEX2 tail land 5), every ring size US 7 to 13 | 14 | alloy SAC305 (process.md P1.1); form: a solder layer of about 0.03 mm on the board land, Kester NP505-HR paste printed through the 0.075 mm parts face stencil in pass 2 of step 2 and reflowed, one 0.300 x 0.440 mm opening per land (hotbar-joint.md section 1; board-notes-r4.md E7): paste layer design/ecad/ring/pcb/fab/gerber/ring-F_Paste.gbr for J_BAND_B:5 | Kester 959T no-clean liquid flux, ORL0, a thin coat on the lands of this foot only, dried before the press; flash point 18 C (process.md P1.4) | hot bar (thermode), blade 2.5 x 1.6 mm on the foot's stiffener (a 3 mm blade lands on R61); the fixture design/mfg/assembly/hotbar-fixture.svg; stereo microscope at 20 times; meter with needle tips 0.2 mm or finer (hotbar-joint.md sections 3, 4; process.md P6) | 260 C, 4 s, 20 N, pressure held until the blade is below 150 C: starting values, confirmed on the first build; at most two presses per foot; first board: thermocouple at J1's nearest corner must stay below 217 C (hotbar-joint.md sections 4, 5) | on the bench before the ribbons go into the body: board PARTS FACE UP in the fixture pocket, J1 down in the relief channel; foot on top with its lands (F.Cu) DOWN on the board lands, the neck leaving over the board edge (J_BAND_A upper edge, J_BAND_B lower edge, as engraved); FLEX1 first, then FLEX2 (lead-decisions.md row 'ribbon-to-board joint'; hotbar-joint.md sections 2.5 A, 3, 4) | foot aligned to the board's own lands by eye at 20 times: long edges 0.335 mm outside the outer land columns, end 0.20 mm inside the inner row; after it lies flat each board land shows 0.125 mm at both ends of its tail land (hotbar-joint.md section 3) | land B5, USB through CP1 to CP4 enumerates and GET_INFO answers (a D- open or a D+ to D- bridge stops USB) (hotbar-joint.md section 4) | yes | joint_id: design/wiring/product-wiring.csv:31 | wiring_line: design/wiring/product-wiring.csv:31 | end: design/wiring/product-wiring.csv:31 | what_meets_what: design/wiring/product-wiring.csv:31 | step: design/mfg/assembly/assembly.md:199 | solder_source: design/mfg/assembly/assembly.md:97; design/mfg/assembly/hotbar-joint.md:23; design/ecad/ring/pcb/board-notes-r4.md (E7) | flux: design/mfg/assembly/assembly.md:201; design/mfg/assembly/process.md P1.4 | tool: design/mfg/assembly/assembly.md:201; design/mfg/assembly/hotbar-joint.md:167 | heat: design/mfg/assembly/assembly.md:201; design/mfg/assembly/hotbar-joint.md:175; design/mfg/assembly/hotbar-joint.md:191 | orientation: design/mfg/assembly/assembly.md:201; design/mfg/assembly/assembly.md:202; design/wiring/lead-decisions.md:81 | alignment: design/mfg/assembly/assembly.md:203; design/mfg/assembly/hotbar-joint.md:130; design/mfg/assembly/hotbar-joint.md:131 | check: design/mfg/assembly/assembly.md:205; design/mfg/assembly/hotbar-joint.md:147 | check_possible_at_this_step: design/mfg/assembly/assembly.md:205 | process: design/mfg/assembly/process.md P1.1, P1.4, P6
J-W031-A | W031 | A | ring main board J_BAND_B land 6 (D+), face F.Cu; tail land on F.Cu, to FLEX2 tail land 6 (USB_DP); hot bar (main board land to FLEX2 tail land 6), every ring size US 7 to 13 | 14 | alloy SAC305 (process.md P1.1); form: a solder layer of about 0.03 mm on the board land, Kester NP505-HR paste printed through the 0.075 mm parts face stencil in pass 2 of step 2 and reflowed, one 0.300 x 0.440 mm opening per land (hotbar-joint.md section 1; board-notes-r4.md E7): paste layer design/ecad/ring/pcb/fab/gerber/ring-F_Paste.gbr for J_BAND_B:6 | Kester 959T no-clean liquid flux, ORL0, a thin coat on the lands of this foot only, dried before the press; flash point 18 C (process.md P1.4) | hot bar (thermode), blade 2.5 x 1.6 mm on the foot's stiffener (a 3 mm blade lands on R61); the fixture design/mfg/assembly/hotbar-fixture.svg; stereo microscope at 20 times; meter with needle tips 0.2 mm or finer (hotbar-joint.md sections 3, 4; process.md P6) | 260 C, 4 s, 20 N, pressure held until the blade is below 150 C: starting values, confirmed on the first build; at most two presses per foot; first board: thermocouple at J1's nearest corner must stay below 217 C (hotbar-joint.md sections 4, 5) | on the bench before the ribbons go into the body: board PARTS FACE UP in the fixture pocket, J1 down in the relief channel; foot on top with its lands (F.Cu) DOWN on the board lands, the neck leaving over the board edge (J_BAND_A upper edge, J_BAND_B lower edge, as engraved); FLEX1 first, then FLEX2 (lead-decisions.md row 'ribbon-to-board joint'; hotbar-joint.md sections 2.5 A, 3, 4) | foot aligned to the board's own lands by eye at 20 times: long edges 0.335 mm outside the outer land columns, end 0.20 mm inside the inner row; after it lies flat each board land shows 0.125 mm at both ends of its tail land (hotbar-joint.md section 3) | land B6, USB through CP1 to CP4 enumerates and GET_INFO answers (a D+ open or a D+ to D- bridge stops USB) (hotbar-joint.md section 4) | yes | joint_id: design/wiring/product-wiring.csv:32 | wiring_line: design/wiring/product-wiring.csv:32 | end: design/wiring/product-wiring.csv:32 | what_meets_what: design/wiring/product-wiring.csv:32 | step: design/mfg/assembly/assembly.md:199 | solder_source: design/mfg/assembly/assembly.md:97; design/mfg/assembly/hotbar-joint.md:23; design/ecad/ring/pcb/board-notes-r4.md (E7) | flux: design/mfg/assembly/assembly.md:201; design/mfg/assembly/process.md P1.4 | tool: design/mfg/assembly/assembly.md:201; design/mfg/assembly/hotbar-joint.md:167 | heat: design/mfg/assembly/assembly.md:201; design/mfg/assembly/hotbar-joint.md:175; design/mfg/assembly/hotbar-joint.md:191 | orientation: design/mfg/assembly/assembly.md:201; design/mfg/assembly/assembly.md:202; design/wiring/lead-decisions.md:81 | alignment: design/mfg/assembly/assembly.md:203; design/mfg/assembly/hotbar-joint.md:130; design/mfg/assembly/hotbar-joint.md:131 | check: design/mfg/assembly/assembly.md:205; design/mfg/assembly/hotbar-joint.md:147 | check_possible_at_this_step: design/mfg/assembly/assembly.md:205 | process: design/mfg/assembly/process.md P1.1, P1.4, P6
J-W032-A | W032 | A | ring main board J_BAND_B land 7 (GND), face F.Cu; tail land on F.Cu, to FLEX2 tail land 7 (GND); hot bar (main board land to FLEX2 tail land 7), every ring size US 7 to 13 | 14 | alloy SAC305 (process.md P1.1); form: a solder layer of about 0.03 mm on the board land, Kester NP505-HR paste printed through the 0.075 mm parts face stencil in pass 2 of step 2 and reflowed, one 0.300 x 0.440 mm opening per land (hotbar-joint.md section 1; board-notes-r4.md E7): paste layer design/ecad/ring/pcb/fab/gerber/ring-F_Paste.gbr for J_BAND_B:7 | Kester 959T no-clean liquid flux, ORL0, a thin coat on the lands of this foot only, dried before the press; flash point 18 C (process.md P1.4) | hot bar (thermode), blade 2.5 x 1.6 mm on the foot's stiffener (a 3 mm blade lands on R61); the fixture design/mfg/assembly/hotbar-fixture.svg; stereo microscope at 20 times; meter with needle tips 0.2 mm or finer (hotbar-joint.md sections 3, 4; process.md P6) | 260 C, 4 s, 20 N, pressure held until the blade is below 150 C: starting values, confirmed on the first build; at most two presses per foot; first board: thermocouple at J1's nearest corner must stay below 217 C (hotbar-joint.md sections 4, 5) | on the bench before the ribbons go into the body: board PARTS FACE UP in the fixture pocket, J1 down in the relief channel; foot on top with its lands (F.Cu) DOWN on the board lands, the neck leaving over the board edge (J_BAND_A upper edge, J_BAND_B lower edge, as engraved); FLEX1 first, then FLEX2 (lead-decisions.md row 'ribbon-to-board joint'; hotbar-joint.md sections 2.5 A, 3, 4) | foot aligned to the board's own lands by eye at 20 times: long edges 0.335 mm outside the outer land columns, end 0.20 mm inside the inner row; after it lies flat each board land shows 0.125 mm at both ends of its tail land (hotbar-joint.md section 3) | land B7, disc CP4 to C83 pad 2 beeps; then USB through CP1 to CP4 enumerates (hotbar-joint.md section 4) | yes | joint_id: design/wiring/product-wiring.csv:33 | wiring_line: design/wiring/product-wiring.csv:33 | end: design/wiring/product-wiring.csv:33 | what_meets_what: design/wiring/product-wiring.csv:33 | step: design/mfg/assembly/assembly.md:199 | solder_source: design/mfg/assembly/assembly.md:97; design/mfg/assembly/hotbar-joint.md:23; design/ecad/ring/pcb/board-notes-r4.md (E7) | flux: design/mfg/assembly/assembly.md:201; design/mfg/assembly/process.md P1.4 | tool: design/mfg/assembly/assembly.md:201; design/mfg/assembly/hotbar-joint.md:167 | heat: design/mfg/assembly/assembly.md:201; design/mfg/assembly/hotbar-joint.md:175; design/mfg/assembly/hotbar-joint.md:191 | orientation: design/mfg/assembly/assembly.md:201; design/mfg/assembly/assembly.md:202; design/wiring/lead-decisions.md:81 | alignment: design/mfg/assembly/assembly.md:203; design/mfg/assembly/hotbar-joint.md:130; design/mfg/assembly/hotbar-joint.md:131 | check: design/mfg/assembly/assembly.md:205; design/mfg/assembly/hotbar-joint.md:147 | check_possible_at_this_step: design/mfg/assembly/assembly.md:205 | process: design/mfg/assembly/process.md P1.1, P1.4, P6
J-W001-B | W001 | B | FLEX1 SW1 pin 3, face F.Cu (reflow), switch terminal on its land, every ring size US 7 to 13 | 6 | Kester NP505-HR SAC305 Type 4 (20 to 38 um), 88.5 % metal, no-clean, part 7040211410, printed through a 0.08 mm stainless stencil cut from the FLEX1 paste layer, one 0.55 x 0.55 opening per switch land (change C1, 12 openings per size): paste layer design/ecad/band/fab/flex1-us7/flex1-us7-F_Paste.gbr for SW1:3; paste layer design/ecad/band/fab/flex1-us8/flex1-us8-F_Paste.gbr for SW1:3; paste layer design/ecad/band/fab/flex1-us9/flex1-us9-F_Paste.gbr for SW1:3; paste layer design/ecad/band/fab/flex1-us10/flex1-us10-F_Paste.gbr for SW1:3; paste layer design/ecad/band/fab/flex1-us11/flex1-us11-F_Paste.gbr for SW1:3; paste layer design/ecad/band/fab/flex1-us12/flex1-us12-F_Paste.gbr for SW1:3; paste layer design/ecad/band/fab/flex1-us13/flex1-us13-F_Paste.gbr for SW1:3 | the ROL0 no-clean flux of the NP505-HR paste; no added liquid flux; residue left, never washed or brushed (process.md P1.2, P1.5); Alps forbids flux on the switch face | 0.08 mm stainless laser-cut stencil, reflow oven with a thermocouple logger, the head on a flat carrier (process.md P2, P6) | P3 profile: to 150 C at less than 2.5 C/s, 150 to 200 C in 90 to 110 s, 60 to 75 s above 217 C, at most 35 s above 230 C, peak 240 C (accepted 235 to 245 C on a thermocouple at the board surface), cool at 6 C/s or slower; 1 reflow (Alps: 260 C 3 s, 40 s above 230 C, at most 2 reflows) (process.md P3) | switch on the F.Cu face of the FLEX1 head, the head flat on the carrier with its stiffener under it; footprint turns SW1 90, SW2 90, SW3 -90, SW4 180, SW5 0 degrees | the cross at 2.4 mm from the cap axis, SW2 at the centre, 0.30 mm to its neighbours; each switch on the lands of footprint Alps_SKTAAAE010_pads34 (SW1, SW3, SW4, SW5) or Alps_SKTAAAE010_4pad (SW2), drawn in design/ecad/band/flex1-us7.kicad_pcb to flex1-us13.kicad_pcb | every joint passes the accept rules of step 2; the switch closes its own line and no other while pressed and reads open when released: ohmmeter at the FLEX1 foot between tail land 1 and land 8 (GND), lands numbered on the flex drawing flex1-usN-drawing.pdf, detail 'BOARD END OF THE RIBBON: LAND NUMBERS AND NETS' (change C13), needle tips 0.2 mm or finer; height 0.53 mm; switch base flat on the head, feeler 0.02 mm | yes | joint_id: design/wiring/product-wiring.csv:2 | wiring_line: design/wiring/product-wiring.csv:2 | end: design/wiring/product-wiring.csv:2 | what_meets_what: design/wiring/product-wiring.csv:2 | step: design/mfg/assembly/assembly.md:130 | solder_source: design/mfg/assembly/assembly.md:133; design/mfg/assembly/process.md:86; design/mfg/assembly/process.md:195 | flux: design/mfg/assembly/v7-update-notes.md:27; design/mfg/assembly/joint-table-work/logs/flux-search.log:3 | tool: design/mfg/assembly/assembly.md:132; design/mfg/assembly/assembly.md:15 | heat: design/ecad/band/band-interface.md:106 | orientation: design/ecad/band/band-interface.md:105; design/wiring/product-wiring.csv:2; design/mfg/assembly/assembly.md:132 | alignment: design/mfg/assembly/assembly.md:134; design/ecad/band/band-interface.md:102; design/mfg/assembly/assembly.md:135 | check: design/mfg/assembly/assembly.md:136; design/mfg/assembly/hotbar-joint.md:149 | check_possible_at_this_step: design/mfg/assembly/assembly.md:136; process: design/mfg/assembly/process.md P1.2, P1.5, P2, P3, P6
J-W002-B | W002 | B | FLEX1 SW3 pin 3, face F.Cu (reflow), switch terminal on its land, every ring size US 7 to 13 | 6 | Kester NP505-HR SAC305 Type 4 (20 to 38 um), 88.5 % metal, no-clean, part 7040211410, printed through a 0.08 mm stainless stencil cut from the FLEX1 paste layer, one 0.55 x 0.55 opening per switch land (change C1, 12 openings per size): paste layer design/ecad/band/fab/flex1-us7/flex1-us7-F_Paste.gbr for SW3:3; paste layer design/ecad/band/fab/flex1-us8/flex1-us8-F_Paste.gbr for SW3:3; paste layer design/ecad/band/fab/flex1-us9/flex1-us9-F_Paste.gbr for SW3:3; paste layer design/ecad/band/fab/flex1-us10/flex1-us10-F_Paste.gbr for SW3:3; paste layer design/ecad/band/fab/flex1-us11/flex1-us11-F_Paste.gbr for SW3:3; paste layer design/ecad/band/fab/flex1-us12/flex1-us12-F_Paste.gbr for SW3:3; paste layer design/ecad/band/fab/flex1-us13/flex1-us13-F_Paste.gbr for SW3:3 | the ROL0 no-clean flux of the NP505-HR paste; no added liquid flux; residue left, never washed or brushed (process.md P1.2, P1.5); Alps forbids flux on the switch face | 0.08 mm stainless laser-cut stencil, reflow oven with a thermocouple logger, the head on a flat carrier (process.md P2, P6) | P3 profile: to 150 C at less than 2.5 C/s, 150 to 200 C in 90 to 110 s, 60 to 75 s above 217 C, at most 35 s above 230 C, peak 240 C (accepted 235 to 245 C on a thermocouple at the board surface), cool at 6 C/s or slower; 1 reflow (Alps: 260 C 3 s, 40 s above 230 C, at most 2 reflows) (process.md P3) | switch on the F.Cu face of the FLEX1 head, the head flat on the carrier with its stiffener under it; footprint turns SW1 90, SW2 90, SW3 -90, SW4 180, SW5 0 degrees | the cross at 2.4 mm from the cap axis, SW2 at the centre, 0.30 mm to its neighbours; each switch on the lands of footprint Alps_SKTAAAE010_pads34 (SW1, SW3, SW4, SW5) or Alps_SKTAAAE010_4pad (SW2), drawn in design/ecad/band/flex1-us7.kicad_pcb to flex1-us13.kicad_pcb | every joint passes the accept rules of step 2; the switch closes its own line and no other while pressed and reads open when released: ohmmeter at the FLEX1 foot between tail land 2 and land 8 (GND), lands numbered on the flex drawing flex1-usN-drawing.pdf, detail 'BOARD END OF THE RIBBON: LAND NUMBERS AND NETS' (change C13), needle tips 0.2 mm or finer; height 0.53 mm; switch base flat on the head, feeler 0.02 mm | yes | joint_id: design/wiring/product-wiring.csv:3 | wiring_line: design/wiring/product-wiring.csv:3 | end: design/wiring/product-wiring.csv:3 | what_meets_what: design/wiring/product-wiring.csv:3 | step: design/mfg/assembly/assembly.md:130 | solder_source: design/mfg/assembly/assembly.md:133; design/mfg/assembly/process.md:86; design/mfg/assembly/process.md:195 | flux: design/mfg/assembly/v7-update-notes.md:27; design/mfg/assembly/joint-table-work/logs/flux-search.log:3 | tool: design/mfg/assembly/assembly.md:132; design/mfg/assembly/assembly.md:15 | heat: design/ecad/band/band-interface.md:106 | orientation: design/ecad/band/band-interface.md:105; design/wiring/product-wiring.csv:3; design/mfg/assembly/assembly.md:132 | alignment: design/mfg/assembly/assembly.md:134; design/ecad/band/band-interface.md:102; design/mfg/assembly/assembly.md:135 | check: design/mfg/assembly/assembly.md:136; design/mfg/assembly/hotbar-joint.md:149 | check_possible_at_this_step: design/mfg/assembly/assembly.md:136; process: design/mfg/assembly/process.md P1.2, P1.5, P2, P3, P6
J-W003-B | W003 | B | FLEX1 SW4 pin 3, face F.Cu (reflow), switch terminal on its land, every ring size US 7 to 13 | 6 | Kester NP505-HR SAC305 Type 4 (20 to 38 um), 88.5 % metal, no-clean, part 7040211410, printed through a 0.08 mm stainless stencil cut from the FLEX1 paste layer, one 0.55 x 0.55 opening per switch land (change C1, 12 openings per size): paste layer design/ecad/band/fab/flex1-us7/flex1-us7-F_Paste.gbr for SW4:3; paste layer design/ecad/band/fab/flex1-us8/flex1-us8-F_Paste.gbr for SW4:3; paste layer design/ecad/band/fab/flex1-us9/flex1-us9-F_Paste.gbr for SW4:3; paste layer design/ecad/band/fab/flex1-us10/flex1-us10-F_Paste.gbr for SW4:3; paste layer design/ecad/band/fab/flex1-us11/flex1-us11-F_Paste.gbr for SW4:3; paste layer design/ecad/band/fab/flex1-us12/flex1-us12-F_Paste.gbr for SW4:3; paste layer design/ecad/band/fab/flex1-us13/flex1-us13-F_Paste.gbr for SW4:3 | the ROL0 no-clean flux of the NP505-HR paste; no added liquid flux; residue left, never washed or brushed (process.md P1.2, P1.5); Alps forbids flux on the switch face | 0.08 mm stainless laser-cut stencil, reflow oven with a thermocouple logger, the head on a flat carrier (process.md P2, P6) | P3 profile: to 150 C at less than 2.5 C/s, 150 to 200 C in 90 to 110 s, 60 to 75 s above 217 C, at most 35 s above 230 C, peak 240 C (accepted 235 to 245 C on a thermocouple at the board surface), cool at 6 C/s or slower; 1 reflow (Alps: 260 C 3 s, 40 s above 230 C, at most 2 reflows) (process.md P3) | switch on the F.Cu face of the FLEX1 head, the head flat on the carrier with its stiffener under it; footprint turns SW1 90, SW2 90, SW3 -90, SW4 180, SW5 0 degrees | the cross at 2.4 mm from the cap axis, SW2 at the centre, 0.30 mm to its neighbours; each switch on the lands of footprint Alps_SKTAAAE010_pads34 (SW1, SW3, SW4, SW5) or Alps_SKTAAAE010_4pad (SW2), drawn in design/ecad/band/flex1-us7.kicad_pcb to flex1-us13.kicad_pcb | every joint passes the accept rules of step 2; the switch closes its own line and no other while pressed and reads open when released: ohmmeter at the FLEX1 foot between tail land 3 and land 8 (GND), lands numbered on the flex drawing flex1-usN-drawing.pdf, detail 'BOARD END OF THE RIBBON: LAND NUMBERS AND NETS' (change C13), needle tips 0.2 mm or finer; height 0.53 mm; switch base flat on the head, feeler 0.02 mm | yes | joint_id: design/wiring/product-wiring.csv:4 | wiring_line: design/wiring/product-wiring.csv:4 | end: design/wiring/product-wiring.csv:4 | what_meets_what: design/wiring/product-wiring.csv:4 | step: design/mfg/assembly/assembly.md:130 | solder_source: design/mfg/assembly/assembly.md:133; design/mfg/assembly/process.md:86; design/mfg/assembly/process.md:195 | flux: design/mfg/assembly/v7-update-notes.md:27; design/mfg/assembly/joint-table-work/logs/flux-search.log:3 | tool: design/mfg/assembly/assembly.md:132; design/mfg/assembly/assembly.md:15 | heat: design/ecad/band/band-interface.md:106 | orientation: design/ecad/band/band-interface.md:105; design/wiring/product-wiring.csv:4; design/mfg/assembly/assembly.md:132 | alignment: design/mfg/assembly/assembly.md:134; design/ecad/band/band-interface.md:102; design/mfg/assembly/assembly.md:135 | check: design/mfg/assembly/assembly.md:136; design/mfg/assembly/hotbar-joint.md:149 | check_possible_at_this_step: design/mfg/assembly/assembly.md:136; process: design/mfg/assembly/process.md P1.2, P1.5, P2, P3, P6
J-W004-B | W004 | B | FLEX1 SW5 pin 3, face F.Cu (reflow), switch terminal on its land, every ring size US 7 to 13 | 6 | Kester NP505-HR SAC305 Type 4 (20 to 38 um), 88.5 % metal, no-clean, part 7040211410, printed through a 0.08 mm stainless stencil cut from the FLEX1 paste layer, one 0.55 x 0.55 opening per switch land (change C1, 12 openings per size): paste layer design/ecad/band/fab/flex1-us7/flex1-us7-F_Paste.gbr for SW5:3; paste layer design/ecad/band/fab/flex1-us8/flex1-us8-F_Paste.gbr for SW5:3; paste layer design/ecad/band/fab/flex1-us9/flex1-us9-F_Paste.gbr for SW5:3; paste layer design/ecad/band/fab/flex1-us10/flex1-us10-F_Paste.gbr for SW5:3; paste layer design/ecad/band/fab/flex1-us11/flex1-us11-F_Paste.gbr for SW5:3; paste layer design/ecad/band/fab/flex1-us12/flex1-us12-F_Paste.gbr for SW5:3; paste layer design/ecad/band/fab/flex1-us13/flex1-us13-F_Paste.gbr for SW5:3 | the ROL0 no-clean flux of the NP505-HR paste; no added liquid flux; residue left, never washed or brushed (process.md P1.2, P1.5); Alps forbids flux on the switch face | 0.08 mm stainless laser-cut stencil, reflow oven with a thermocouple logger, the head on a flat carrier (process.md P2, P6) | P3 profile: to 150 C at less than 2.5 C/s, 150 to 200 C in 90 to 110 s, 60 to 75 s above 217 C, at most 35 s above 230 C, peak 240 C (accepted 235 to 245 C on a thermocouple at the board surface), cool at 6 C/s or slower; 1 reflow (Alps: 260 C 3 s, 40 s above 230 C, at most 2 reflows) (process.md P3) | switch on the F.Cu face of the FLEX1 head, the head flat on the carrier with its stiffener under it; footprint turns SW1 90, SW2 90, SW3 -90, SW4 180, SW5 0 degrees | the cross at 2.4 mm from the cap axis, SW2 at the centre, 0.30 mm to its neighbours; each switch on the lands of footprint Alps_SKTAAAE010_pads34 (SW1, SW3, SW4, SW5) or Alps_SKTAAAE010_4pad (SW2), drawn in design/ecad/band/flex1-us7.kicad_pcb to flex1-us13.kicad_pcb | every joint passes the accept rules of step 2; the switch closes its own line and no other while pressed and reads open when released: ohmmeter at the FLEX1 foot between tail land 4 and land 8 (GND), lands numbered on the flex drawing flex1-usN-drawing.pdf, detail 'BOARD END OF THE RIBBON: LAND NUMBERS AND NETS' (change C13), needle tips 0.2 mm or finer; height 0.53 mm; switch base flat on the head, feeler 0.02 mm | yes | joint_id: design/wiring/product-wiring.csv:5 | wiring_line: design/wiring/product-wiring.csv:5 | end: design/wiring/product-wiring.csv:5 | what_meets_what: design/wiring/product-wiring.csv:5 | step: design/mfg/assembly/assembly.md:130 | solder_source: design/mfg/assembly/assembly.md:133; design/mfg/assembly/process.md:86; design/mfg/assembly/process.md:195 | flux: design/mfg/assembly/v7-update-notes.md:27; design/mfg/assembly/joint-table-work/logs/flux-search.log:3 | tool: design/mfg/assembly/assembly.md:132; design/mfg/assembly/assembly.md:15 | heat: design/ecad/band/band-interface.md:106 | orientation: design/ecad/band/band-interface.md:105; design/wiring/product-wiring.csv:5; design/mfg/assembly/assembly.md:132 | alignment: design/mfg/assembly/assembly.md:134; design/ecad/band/band-interface.md:102; design/mfg/assembly/assembly.md:135 | check: design/mfg/assembly/assembly.md:136; design/mfg/assembly/hotbar-joint.md:149 | check_possible_at_this_step: design/mfg/assembly/assembly.md:136; process: design/mfg/assembly/process.md P1.2, P1.5, P2, P3, P6
J-W005-B | W005 | B | FLEX1 SW2 pin 1, face F.Cu (reflow), switch terminal on its land, every ring size US 7 to 13 | 6 | Kester NP505-HR SAC305 Type 4 (20 to 38 um), 88.5 % metal, no-clean, part 7040211410, printed through a 0.08 mm stainless stencil cut from the FLEX1 paste layer, one 0.55 x 0.55 opening per switch land (change C1, 12 openings per size): paste layer design/ecad/band/fab/flex1-us7/flex1-us7-F_Paste.gbr for SW2:1; paste layer design/ecad/band/fab/flex1-us8/flex1-us8-F_Paste.gbr for SW2:1; paste layer design/ecad/band/fab/flex1-us9/flex1-us9-F_Paste.gbr for SW2:1; paste layer design/ecad/band/fab/flex1-us10/flex1-us10-F_Paste.gbr for SW2:1; paste layer design/ecad/band/fab/flex1-us11/flex1-us11-F_Paste.gbr for SW2:1; paste layer design/ecad/band/fab/flex1-us12/flex1-us12-F_Paste.gbr for SW2:1; paste layer design/ecad/band/fab/flex1-us13/flex1-us13-F_Paste.gbr for SW2:1 | the ROL0 no-clean flux of the NP505-HR paste; no added liquid flux; residue left, never washed or brushed (process.md P1.2, P1.5); Alps forbids flux on the switch face | 0.08 mm stainless laser-cut stencil, reflow oven with a thermocouple logger, the head on a flat carrier (process.md P2, P6) | P3 profile: to 150 C at less than 2.5 C/s, 150 to 200 C in 90 to 110 s, 60 to 75 s above 217 C, at most 35 s above 230 C, peak 240 C (accepted 235 to 245 C on a thermocouple at the board surface), cool at 6 C/s or slower; 1 reflow (Alps: 260 C 3 s, 40 s above 230 C, at most 2 reflows) (process.md P3) | switch on the F.Cu face of the FLEX1 head, the head flat on the carrier with its stiffener under it; footprint turns SW1 90, SW2 90, SW3 -90, SW4 180, SW5 0 degrees | the cross at 2.4 mm from the cap axis, SW2 at the centre, 0.30 mm to its neighbours; each switch on the lands of footprint Alps_SKTAAAE010_pads34 (SW1, SW3, SW4, SW5) or Alps_SKTAAAE010_4pad (SW2), drawn in design/ecad/band/flex1-us7.kicad_pcb to flex1-us13.kicad_pcb | every joint passes the accept rules of step 2; the switch closes its own line and no other while pressed and reads open when released: ohmmeter at the FLEX1 foot between tail land 5 and land 8 (GND), lands numbered on the flex drawing flex1-usN-drawing.pdf, detail 'BOARD END OF THE RIBBON: LAND NUMBERS AND NETS' (change C13), needle tips 0.2 mm or finer; height 0.53 mm; switch base flat on the head, feeler 0.02 mm | yes | joint_id: design/wiring/product-wiring.csv:6 | wiring_line: design/wiring/product-wiring.csv:6 | end: design/wiring/product-wiring.csv:6 | what_meets_what: design/wiring/product-wiring.csv:6 | step: design/mfg/assembly/assembly.md:130 | solder_source: design/mfg/assembly/assembly.md:133; design/mfg/assembly/process.md:86; design/mfg/assembly/process.md:195 | flux: design/mfg/assembly/v7-update-notes.md:27; design/mfg/assembly/joint-table-work/logs/flux-search.log:3 | tool: design/mfg/assembly/assembly.md:132; design/mfg/assembly/assembly.md:15 | heat: design/ecad/band/band-interface.md:106 | orientation: design/ecad/band/band-interface.md:105; design/wiring/product-wiring.csv:6; design/mfg/assembly/assembly.md:132 | alignment: design/mfg/assembly/assembly.md:134; design/ecad/band/band-interface.md:102; design/mfg/assembly/assembly.md:135 | check: design/mfg/assembly/assembly.md:136; design/mfg/assembly/hotbar-joint.md:149 | check_possible_at_this_step: design/mfg/assembly/assembly.md:136; process: design/mfg/assembly/process.md P1.2, P1.5, P2, P3, P6
J-W010-B | W010 | B | FLEX1 SW2 pin 3, face F.Cu (reflow), switch terminal on its land, every ring size US 7 to 13 | 6 | Kester NP505-HR SAC305 Type 4 (20 to 38 um), 88.5 % metal, no-clean, part 7040211410, printed through a 0.08 mm stainless stencil cut from the FLEX1 paste layer, one 0.55 x 0.55 opening per switch land (change C1, 12 openings per size): paste layer design/ecad/band/fab/flex1-us7/flex1-us7-F_Paste.gbr for SW2:3; paste layer design/ecad/band/fab/flex1-us8/flex1-us8-F_Paste.gbr for SW2:3; paste layer design/ecad/band/fab/flex1-us9/flex1-us9-F_Paste.gbr for SW2:3; paste layer design/ecad/band/fab/flex1-us10/flex1-us10-F_Paste.gbr for SW2:3; paste layer design/ecad/band/fab/flex1-us11/flex1-us11-F_Paste.gbr for SW2:3; paste layer design/ecad/band/fab/flex1-us12/flex1-us12-F_Paste.gbr for SW2:3; paste layer design/ecad/band/fab/flex1-us13/flex1-us13-F_Paste.gbr for SW2:3 | the ROL0 no-clean flux of the NP505-HR paste; no added liquid flux; residue left, never washed or brushed (process.md P1.2, P1.5); Alps forbids flux on the switch face | 0.08 mm stainless laser-cut stencil, reflow oven with a thermocouple logger, the head on a flat carrier (process.md P2, P6) | P3 profile: to 150 C at less than 2.5 C/s, 150 to 200 C in 90 to 110 s, 60 to 75 s above 217 C, at most 35 s above 230 C, peak 240 C (accepted 235 to 245 C on a thermocouple at the board surface), cool at 6 C/s or slower; 1 reflow (Alps: 260 C 3 s, 40 s above 230 C, at most 2 reflows) (process.md P3) | switch on the F.Cu face of the FLEX1 head, the head flat on the carrier with its stiffener under it; footprint turns SW1 90, SW2 90, SW3 -90, SW4 180, SW5 0 degrees | the cross at 2.4 mm from the cap axis, SW2 at the centre, 0.30 mm to its neighbours; each switch on the lands of footprint Alps_SKTAAAE010_pads34 (SW1, SW3, SW4, SW5) or Alps_SKTAAAE010_4pad (SW2), drawn in design/ecad/band/flex1-us7.kicad_pcb to flex1-us13.kicad_pcb | every joint passes the accept rules of step 2; each switch closes its own line and no other while pressed (ohmmeter at the FLEX1 foot, lands numbered on the flex drawing flex1-usN-drawing.pdf, change C13, against land 8 GND) and reads open when released; height 0.53 mm; base flat, feeler 0.02 mm | yes | joint_id: design/wiring/product-wiring.csv:11 | wiring_line: design/wiring/product-wiring.csv:11 | end: design/wiring/product-wiring.csv:11 | what_meets_what: design/wiring/product-wiring.csv:11 | step: design/mfg/assembly/assembly.md:130 | solder_source: design/mfg/assembly/assembly.md:133; design/mfg/assembly/process.md:86; design/mfg/assembly/process.md:195 | flux: design/mfg/assembly/v7-update-notes.md:27; design/mfg/assembly/joint-table-work/logs/flux-search.log:3 | tool: design/mfg/assembly/assembly.md:132; design/mfg/assembly/assembly.md:15 | heat: design/ecad/band/band-interface.md:106 | orientation: design/ecad/band/band-interface.md:105; design/wiring/product-wiring.csv:11; design/mfg/assembly/assembly.md:132 | alignment: design/mfg/assembly/assembly.md:134; design/ecad/band/band-interface.md:102; design/mfg/assembly/assembly.md:135 | check: design/mfg/assembly/assembly.md:136; design/mfg/assembly/hotbar-joint.md:149 | check_possible_at_this_step: design/mfg/assembly/assembly.md:136; process: design/mfg/assembly/process.md P1.2, P1.5, P2, P3, P6
J-W011-B | W011 | B | FLEX1 SW4 pin 4, face F.Cu (reflow), switch terminal on its land, every ring size US 7 to 13 | 6 | Kester NP505-HR SAC305 Type 4 (20 to 38 um), 88.5 % metal, no-clean, part 7040211410, printed through a 0.08 mm stainless stencil cut from the FLEX1 paste layer, one 0.55 x 0.55 opening per switch land (change C1, 12 openings per size): paste layer design/ecad/band/fab/flex1-us7/flex1-us7-F_Paste.gbr for SW4:4; paste layer design/ecad/band/fab/flex1-us8/flex1-us8-F_Paste.gbr for SW4:4; paste layer design/ecad/band/fab/flex1-us9/flex1-us9-F_Paste.gbr for SW4:4; paste layer design/ecad/band/fab/flex1-us10/flex1-us10-F_Paste.gbr for SW4:4; paste layer design/ecad/band/fab/flex1-us11/flex1-us11-F_Paste.gbr for SW4:4; paste layer design/ecad/band/fab/flex1-us12/flex1-us12-F_Paste.gbr for SW4:4; paste layer design/ecad/band/fab/flex1-us13/flex1-us13-F_Paste.gbr for SW4:4 | the ROL0 no-clean flux of the NP505-HR paste; no added liquid flux; residue left, never washed or brushed (process.md P1.2, P1.5); Alps forbids flux on the switch face | 0.08 mm stainless laser-cut stencil, reflow oven with a thermocouple logger, the head on a flat carrier (process.md P2, P6) | P3 profile: to 150 C at less than 2.5 C/s, 150 to 200 C in 90 to 110 s, 60 to 75 s above 217 C, at most 35 s above 230 C, peak 240 C (accepted 235 to 245 C on a thermocouple at the board surface), cool at 6 C/s or slower; 1 reflow (Alps: 260 C 3 s, 40 s above 230 C, at most 2 reflows) (process.md P3) | switch on the F.Cu face of the FLEX1 head, the head flat on the carrier with its stiffener under it; footprint turns SW1 90, SW2 90, SW3 -90, SW4 180, SW5 0 degrees | the cross at 2.4 mm from the cap axis, SW2 at the centre, 0.30 mm to its neighbours; each switch on the lands of footprint Alps_SKTAAAE010_pads34 (SW1, SW3, SW4, SW5) or Alps_SKTAAAE010_4pad (SW2), drawn in design/ecad/band/flex1-us7.kicad_pcb to flex1-us13.kicad_pcb | every joint passes the accept rules of step 2; each switch closes its own line and no other while pressed (ohmmeter at the FLEX1 foot, lands numbered on the flex drawing flex1-usN-drawing.pdf, change C13, against land 8 GND) and reads open when released; height 0.53 mm; base flat, feeler 0.02 mm | yes | joint_id: design/wiring/product-wiring.csv:12 | wiring_line: design/wiring/product-wiring.csv:12 | end: design/wiring/product-wiring.csv:12 | what_meets_what: design/wiring/product-wiring.csv:12 | step: design/mfg/assembly/assembly.md:130 | solder_source: design/mfg/assembly/assembly.md:133; design/mfg/assembly/process.md:86; design/mfg/assembly/process.md:195 | flux: design/mfg/assembly/v7-update-notes.md:27; design/mfg/assembly/joint-table-work/logs/flux-search.log:3 | tool: design/mfg/assembly/assembly.md:132; design/mfg/assembly/assembly.md:15 | heat: design/ecad/band/band-interface.md:106 | orientation: design/ecad/band/band-interface.md:105; design/wiring/product-wiring.csv:12; design/mfg/assembly/assembly.md:132 | alignment: design/mfg/assembly/assembly.md:134; design/ecad/band/band-interface.md:102; design/mfg/assembly/assembly.md:135 | check: design/mfg/assembly/assembly.md:136; design/mfg/assembly/hotbar-joint.md:149 | check_possible_at_this_step: design/mfg/assembly/assembly.md:136; process: design/mfg/assembly/process.md P1.2, P1.5, P2, P3, P6
J-W016-B | W016 | B | FLEX1 SW1 pin 4, face F.Cu (reflow), switch terminal on its land, every ring size US 7 to 13 | 6 | Kester NP505-HR SAC305 Type 4 (20 to 38 um), 88.5 % metal, no-clean, part 7040211410, printed through a 0.08 mm stainless stencil cut from the FLEX1 paste layer, one 0.55 x 0.55 opening per switch land (change C1, 12 openings per size): paste layer design/ecad/band/fab/flex1-us7/flex1-us7-F_Paste.gbr for SW1:4; paste layer design/ecad/band/fab/flex1-us8/flex1-us8-F_Paste.gbr for SW1:4; paste layer design/ecad/band/fab/flex1-us9/flex1-us9-F_Paste.gbr for SW1:4; paste layer design/ecad/band/fab/flex1-us10/flex1-us10-F_Paste.gbr for SW1:4; paste layer design/ecad/band/fab/flex1-us11/flex1-us11-F_Paste.gbr for SW1:4; paste layer design/ecad/band/fab/flex1-us12/flex1-us12-F_Paste.gbr for SW1:4; paste layer design/ecad/band/fab/flex1-us13/flex1-us13-F_Paste.gbr for SW1:4 | the ROL0 no-clean flux of the NP505-HR paste; no added liquid flux; residue left, never washed or brushed (process.md P1.2, P1.5); Alps forbids flux on the switch face | 0.08 mm stainless laser-cut stencil, reflow oven with a thermocouple logger, the head on a flat carrier (process.md P2, P6) | P3 profile: to 150 C at less than 2.5 C/s, 150 to 200 C in 90 to 110 s, 60 to 75 s above 217 C, at most 35 s above 230 C, peak 240 C (accepted 235 to 245 C on a thermocouple at the board surface), cool at 6 C/s or slower; 1 reflow (Alps: 260 C 3 s, 40 s above 230 C, at most 2 reflows) (process.md P3) | switch on the F.Cu face of the FLEX1 head, the head flat on the carrier with its stiffener under it; footprint turns SW1 90, SW2 90, SW3 -90, SW4 180, SW5 0 degrees | the cross at 2.4 mm from the cap axis, SW2 at the centre, 0.30 mm to its neighbours; each switch on the lands of footprint Alps_SKTAAAE010_pads34 (SW1, SW3, SW4, SW5) or Alps_SKTAAAE010_4pad (SW2), drawn in design/ecad/band/flex1-us7.kicad_pcb to flex1-us13.kicad_pcb | every joint passes the accept rules of step 2; each switch closes its own line and no other while pressed (ohmmeter at the FLEX1 foot, lands numbered on the flex drawing flex1-usN-drawing.pdf, change C13, against land 8 GND) and reads open when released; height 0.53 mm; base flat, feeler 0.02 mm | yes | joint_id: design/wiring/product-wiring.csv:17 | wiring_line: design/wiring/product-wiring.csv:17 | end: design/wiring/product-wiring.csv:17 | what_meets_what: design/wiring/product-wiring.csv:17 | step: design/mfg/assembly/assembly.md:130 | solder_source: design/mfg/assembly/assembly.md:133; design/mfg/assembly/process.md:86; design/mfg/assembly/process.md:195 | flux: design/mfg/assembly/v7-update-notes.md:27; design/mfg/assembly/joint-table-work/logs/flux-search.log:3 | tool: design/mfg/assembly/assembly.md:132; design/mfg/assembly/assembly.md:15 | heat: design/ecad/band/band-interface.md:106 | orientation: design/ecad/band/band-interface.md:105; design/wiring/product-wiring.csv:17; design/mfg/assembly/assembly.md:132 | alignment: design/mfg/assembly/assembly.md:134; design/ecad/band/band-interface.md:102; design/mfg/assembly/assembly.md:135 | check: design/mfg/assembly/assembly.md:136; design/mfg/assembly/hotbar-joint.md:149 | check_possible_at_this_step: design/mfg/assembly/assembly.md:136; process: design/mfg/assembly/process.md P1.2, P1.5, P2, P3, P6
J-W017-B | W017 | B | FLEX1 SW2 pin 2, face F.Cu (reflow), switch terminal on its land, every ring size US 7 to 13 | 6 | Kester NP505-HR SAC305 Type 4 (20 to 38 um), 88.5 % metal, no-clean, part 7040211410, printed through a 0.08 mm stainless stencil cut from the FLEX1 paste layer, one 0.55 x 0.55 opening per switch land (change C1, 12 openings per size): paste layer design/ecad/band/fab/flex1-us7/flex1-us7-F_Paste.gbr for SW2:2; paste layer design/ecad/band/fab/flex1-us8/flex1-us8-F_Paste.gbr for SW2:2; paste layer design/ecad/band/fab/flex1-us9/flex1-us9-F_Paste.gbr for SW2:2; paste layer design/ecad/band/fab/flex1-us10/flex1-us10-F_Paste.gbr for SW2:2; paste layer design/ecad/band/fab/flex1-us11/flex1-us11-F_Paste.gbr for SW2:2; paste layer design/ecad/band/fab/flex1-us12/flex1-us12-F_Paste.gbr for SW2:2; paste layer design/ecad/band/fab/flex1-us13/flex1-us13-F_Paste.gbr for SW2:2 | the ROL0 no-clean flux of the NP505-HR paste; no added liquid flux; residue left, never washed or brushed (process.md P1.2, P1.5); Alps forbids flux on the switch face | 0.08 mm stainless laser-cut stencil, reflow oven with a thermocouple logger, the head on a flat carrier (process.md P2, P6) | P3 profile: to 150 C at less than 2.5 C/s, 150 to 200 C in 90 to 110 s, 60 to 75 s above 217 C, at most 35 s above 230 C, peak 240 C (accepted 235 to 245 C on a thermocouple at the board surface), cool at 6 C/s or slower; 1 reflow (Alps: 260 C 3 s, 40 s above 230 C, at most 2 reflows) (process.md P3) | switch on the F.Cu face of the FLEX1 head, the head flat on the carrier with its stiffener under it; footprint turns SW1 90, SW2 90, SW3 -90, SW4 180, SW5 0 degrees | the cross at 2.4 mm from the cap axis, SW2 at the centre, 0.30 mm to its neighbours; each switch on the lands of footprint Alps_SKTAAAE010_pads34 (SW1, SW3, SW4, SW5) or Alps_SKTAAAE010_4pad (SW2), drawn in design/ecad/band/flex1-us7.kicad_pcb to flex1-us13.kicad_pcb | every joint passes the accept rules of step 2; each switch closes its own line and no other while pressed (ohmmeter at the FLEX1 foot, lands numbered on the flex drawing flex1-usN-drawing.pdf, change C13, against land 8 GND) and reads open when released; height 0.53 mm; base flat, feeler 0.02 mm | yes | joint_id: design/wiring/product-wiring.csv:18 | wiring_line: design/wiring/product-wiring.csv:18 | end: design/wiring/product-wiring.csv:18 | what_meets_what: design/wiring/product-wiring.csv:18 | step: design/mfg/assembly/assembly.md:130 | solder_source: design/mfg/assembly/assembly.md:133; design/mfg/assembly/process.md:86; design/mfg/assembly/process.md:195 | flux: design/mfg/assembly/v7-update-notes.md:27; design/mfg/assembly/joint-table-work/logs/flux-search.log:3 | tool: design/mfg/assembly/assembly.md:132; design/mfg/assembly/assembly.md:15 | heat: design/ecad/band/band-interface.md:106 | orientation: design/ecad/band/band-interface.md:105; design/wiring/product-wiring.csv:18; design/mfg/assembly/assembly.md:132 | alignment: design/mfg/assembly/assembly.md:134; design/ecad/band/band-interface.md:102; design/mfg/assembly/assembly.md:135 | check: design/mfg/assembly/assembly.md:136; design/mfg/assembly/hotbar-joint.md:149 | check_possible_at_this_step: design/mfg/assembly/assembly.md:136; process: design/mfg/assembly/process.md P1.2, P1.5, P2, P3, P6
J-W018-B | W018 | B | FLEX1 SW2 pin 4, face F.Cu (reflow), switch terminal on its land, every ring size US 7 to 13 | 6 | Kester NP505-HR SAC305 Type 4 (20 to 38 um), 88.5 % metal, no-clean, part 7040211410, printed through a 0.08 mm stainless stencil cut from the FLEX1 paste layer, one 0.55 x 0.55 opening per switch land (change C1, 12 openings per size): paste layer design/ecad/band/fab/flex1-us7/flex1-us7-F_Paste.gbr for SW2:4; paste layer design/ecad/band/fab/flex1-us8/flex1-us8-F_Paste.gbr for SW2:4; paste layer design/ecad/band/fab/flex1-us9/flex1-us9-F_Paste.gbr for SW2:4; paste layer design/ecad/band/fab/flex1-us10/flex1-us10-F_Paste.gbr for SW2:4; paste layer design/ecad/band/fab/flex1-us11/flex1-us11-F_Paste.gbr for SW2:4; paste layer design/ecad/band/fab/flex1-us12/flex1-us12-F_Paste.gbr for SW2:4; paste layer design/ecad/band/fab/flex1-us13/flex1-us13-F_Paste.gbr for SW2:4 | the ROL0 no-clean flux of the NP505-HR paste; no added liquid flux; residue left, never washed or brushed (process.md P1.2, P1.5); Alps forbids flux on the switch face | 0.08 mm stainless laser-cut stencil, reflow oven with a thermocouple logger, the head on a flat carrier (process.md P2, P6) | P3 profile: to 150 C at less than 2.5 C/s, 150 to 200 C in 90 to 110 s, 60 to 75 s above 217 C, at most 35 s above 230 C, peak 240 C (accepted 235 to 245 C on a thermocouple at the board surface), cool at 6 C/s or slower; 1 reflow (Alps: 260 C 3 s, 40 s above 230 C, at most 2 reflows) (process.md P3) | switch on the F.Cu face of the FLEX1 head, the head flat on the carrier with its stiffener under it; footprint turns SW1 90, SW2 90, SW3 -90, SW4 180, SW5 0 degrees | the cross at 2.4 mm from the cap axis, SW2 at the centre, 0.30 mm to its neighbours; each switch on the lands of footprint Alps_SKTAAAE010_pads34 (SW1, SW3, SW4, SW5) or Alps_SKTAAAE010_4pad (SW2), drawn in design/ecad/band/flex1-us7.kicad_pcb to flex1-us13.kicad_pcb | every joint passes the accept rules of step 2; each switch closes its own line and no other while pressed (ohmmeter at the FLEX1 foot, lands numbered on the flex drawing flex1-usN-drawing.pdf, change C13, against land 8 GND) and reads open when released; height 0.53 mm; base flat, feeler 0.02 mm | yes | joint_id: design/wiring/product-wiring.csv:19 | wiring_line: design/wiring/product-wiring.csv:19 | end: design/wiring/product-wiring.csv:19 | what_meets_what: design/wiring/product-wiring.csv:19 | step: design/mfg/assembly/assembly.md:130 | solder_source: design/mfg/assembly/assembly.md:133; design/mfg/assembly/process.md:86; design/mfg/assembly/process.md:195 | flux: design/mfg/assembly/v7-update-notes.md:27; design/mfg/assembly/joint-table-work/logs/flux-search.log:3 | tool: design/mfg/assembly/assembly.md:132; design/mfg/assembly/assembly.md:15 | heat: design/ecad/band/band-interface.md:106 | orientation: design/ecad/band/band-interface.md:105; design/wiring/product-wiring.csv:19; design/mfg/assembly/assembly.md:132 | alignment: design/mfg/assembly/assembly.md:134; design/ecad/band/band-interface.md:102; design/mfg/assembly/assembly.md:135 | check: design/mfg/assembly/assembly.md:136; design/mfg/assembly/hotbar-joint.md:149 | check_possible_at_this_step: design/mfg/assembly/assembly.md:136; process: design/mfg/assembly/process.md P1.2, P1.5, P2, P3, P6
J-W019-B | W019 | B | FLEX1 SW3 pin 4, face F.Cu (reflow), switch terminal on its land, every ring size US 7 to 13 | 6 | Kester NP505-HR SAC305 Type 4 (20 to 38 um), 88.5 % metal, no-clean, part 7040211410, printed through a 0.08 mm stainless stencil cut from the FLEX1 paste layer, one 0.55 x 0.55 opening per switch land (change C1, 12 openings per size): paste layer design/ecad/band/fab/flex1-us7/flex1-us7-F_Paste.gbr for SW3:4; paste layer design/ecad/band/fab/flex1-us8/flex1-us8-F_Paste.gbr for SW3:4; paste layer design/ecad/band/fab/flex1-us9/flex1-us9-F_Paste.gbr for SW3:4; paste layer design/ecad/band/fab/flex1-us10/flex1-us10-F_Paste.gbr for SW3:4; paste layer design/ecad/band/fab/flex1-us11/flex1-us11-F_Paste.gbr for SW3:4; paste layer design/ecad/band/fab/flex1-us12/flex1-us12-F_Paste.gbr for SW3:4; paste layer design/ecad/band/fab/flex1-us13/flex1-us13-F_Paste.gbr for SW3:4 | the ROL0 no-clean flux of the NP505-HR paste; no added liquid flux; residue left, never washed or brushed (process.md P1.2, P1.5); Alps forbids flux on the switch face | 0.08 mm stainless laser-cut stencil, reflow oven with a thermocouple logger, the head on a flat carrier (process.md P2, P6) | P3 profile: to 150 C at less than 2.5 C/s, 150 to 200 C in 90 to 110 s, 60 to 75 s above 217 C, at most 35 s above 230 C, peak 240 C (accepted 235 to 245 C on a thermocouple at the board surface), cool at 6 C/s or slower; 1 reflow (Alps: 260 C 3 s, 40 s above 230 C, at most 2 reflows) (process.md P3) | switch on the F.Cu face of the FLEX1 head, the head flat on the carrier with its stiffener under it; footprint turns SW1 90, SW2 90, SW3 -90, SW4 180, SW5 0 degrees | the cross at 2.4 mm from the cap axis, SW2 at the centre, 0.30 mm to its neighbours; each switch on the lands of footprint Alps_SKTAAAE010_pads34 (SW1, SW3, SW4, SW5) or Alps_SKTAAAE010_4pad (SW2), drawn in design/ecad/band/flex1-us7.kicad_pcb to flex1-us13.kicad_pcb | every joint passes the accept rules of step 2; each switch closes its own line and no other while pressed (ohmmeter at the FLEX1 foot, lands numbered on the flex drawing flex1-usN-drawing.pdf, change C13, against land 8 GND) and reads open when released; height 0.53 mm; base flat, feeler 0.02 mm | yes | joint_id: design/wiring/product-wiring.csv:20 | wiring_line: design/wiring/product-wiring.csv:20 | end: design/wiring/product-wiring.csv:20 | what_meets_what: design/wiring/product-wiring.csv:20 | step: design/mfg/assembly/assembly.md:130 | solder_source: design/mfg/assembly/assembly.md:133; design/mfg/assembly/process.md:86; design/mfg/assembly/process.md:195 | flux: design/mfg/assembly/v7-update-notes.md:27; design/mfg/assembly/joint-table-work/logs/flux-search.log:3 | tool: design/mfg/assembly/assembly.md:132; design/mfg/assembly/assembly.md:15 | heat: design/ecad/band/band-interface.md:106 | orientation: design/ecad/band/band-interface.md:105; design/wiring/product-wiring.csv:20; design/mfg/assembly/assembly.md:132 | alignment: design/mfg/assembly/assembly.md:134; design/ecad/band/band-interface.md:102; design/mfg/assembly/assembly.md:135 | check: design/mfg/assembly/assembly.md:136; design/mfg/assembly/hotbar-joint.md:149 | check_possible_at_this_step: design/mfg/assembly/assembly.md:136; process: design/mfg/assembly/process.md P1.2, P1.5, P2, P3, P6
J-W020-B | W020 | B | FLEX1 SW5 pin 4, face F.Cu (reflow), switch terminal on its land, every ring size US 7 to 13 | 6 | Kester NP505-HR SAC305 Type 4 (20 to 38 um), 88.5 % metal, no-clean, part 7040211410, printed through a 0.08 mm stainless stencil cut from the FLEX1 paste layer, one 0.55 x 0.55 opening per switch land (change C1, 12 openings per size): paste layer design/ecad/band/fab/flex1-us7/flex1-us7-F_Paste.gbr for SW5:4; paste layer design/ecad/band/fab/flex1-us8/flex1-us8-F_Paste.gbr for SW5:4; paste layer design/ecad/band/fab/flex1-us9/flex1-us9-F_Paste.gbr for SW5:4; paste layer design/ecad/band/fab/flex1-us10/flex1-us10-F_Paste.gbr for SW5:4; paste layer design/ecad/band/fab/flex1-us11/flex1-us11-F_Paste.gbr for SW5:4; paste layer design/ecad/band/fab/flex1-us12/flex1-us12-F_Paste.gbr for SW5:4; paste layer design/ecad/band/fab/flex1-us13/flex1-us13-F_Paste.gbr for SW5:4 | the ROL0 no-clean flux of the NP505-HR paste; no added liquid flux; residue left, never washed or brushed (process.md P1.2, P1.5); Alps forbids flux on the switch face | 0.08 mm stainless laser-cut stencil, reflow oven with a thermocouple logger, the head on a flat carrier (process.md P2, P6) | P3 profile: to 150 C at less than 2.5 C/s, 150 to 200 C in 90 to 110 s, 60 to 75 s above 217 C, at most 35 s above 230 C, peak 240 C (accepted 235 to 245 C on a thermocouple at the board surface), cool at 6 C/s or slower; 1 reflow (Alps: 260 C 3 s, 40 s above 230 C, at most 2 reflows) (process.md P3) | switch on the F.Cu face of the FLEX1 head, the head flat on the carrier with its stiffener under it; footprint turns SW1 90, SW2 90, SW3 -90, SW4 180, SW5 0 degrees | the cross at 2.4 mm from the cap axis, SW2 at the centre, 0.30 mm to its neighbours; each switch on the lands of footprint Alps_SKTAAAE010_pads34 (SW1, SW3, SW4, SW5) or Alps_SKTAAAE010_4pad (SW2), drawn in design/ecad/band/flex1-us7.kicad_pcb to flex1-us13.kicad_pcb | every joint passes the accept rules of step 2; each switch closes its own line and no other while pressed (ohmmeter at the FLEX1 foot, lands numbered on the flex drawing flex1-usN-drawing.pdf, change C13, against land 8 GND) and reads open when released; height 0.53 mm; base flat, feeler 0.02 mm | yes | joint_id: design/wiring/product-wiring.csv:21 | wiring_line: design/wiring/product-wiring.csv:21 | end: design/wiring/product-wiring.csv:21 | what_meets_what: design/wiring/product-wiring.csv:21 | step: design/mfg/assembly/assembly.md:130 | solder_source: design/mfg/assembly/assembly.md:133; design/mfg/assembly/process.md:86; design/mfg/assembly/process.md:195 | flux: design/mfg/assembly/v7-update-notes.md:27; design/mfg/assembly/joint-table-work/logs/flux-search.log:3 | tool: design/mfg/assembly/assembly.md:132; design/mfg/assembly/assembly.md:15 | heat: design/ecad/band/band-interface.md:106 | orientation: design/ecad/band/band-interface.md:105; design/wiring/product-wiring.csv:21; design/mfg/assembly/assembly.md:132 | alignment: design/mfg/assembly/assembly.md:134; design/ecad/band/band-interface.md:102; design/mfg/assembly/assembly.md:135 | check: design/mfg/assembly/assembly.md:136; design/mfg/assembly/hotbar-joint.md:149 | check_possible_at_this_step: design/mfg/assembly/assembly.md:136; process: design/mfg/assembly/process.md P1.2, P1.5, P2, P3, P6
J-W021-B | W021 | B | FLEX1 M1 pin 2 (land of footprint W0525AB001D_Lands), face F.Cu (hand solder (lead on land)), the motor's blue (-) lead on its land, every ring size US 7 to 13 | 7 | Kester 275 SAC305 no-clean cored wire 0.25 mm, 2.2 % flux, part 2470687623 (process.md P1.3, P4); the same wire tins the stripped lead end | the ROL0 no-clean core of the Kester 275 wire; residue left (process.md P1.3, P1.5) | 50 W temperature-controlled soldering iron, chisel tip 0.8 mm wide or narrower (process.md P4, P6) | iron 320 C, 2 s | blue lead to land 2 (-, GND), the land farther from the slot; the motor stands on the +X side of the tail, so the leads arrive from +v | stripped end laid along the 0.80 mm side of its land (lands 0.30 x 0.80 at pitch 1.0); FLEX1 has no mark on it | both joints pass the accept rules of step 2; 3.0 V through a 200 mA current limit for 0.5 s, + on tail land 7 (VMOT) and - on tail land 6 (GND) of the FLEX1 foot, numbered on the flex drawing, detail 'BOARD END OF THE RIBBON: LAND NUMBERS AND NETS' (change C13), needle tips 0.2 mm or finer: the motor vibrates; the meter reading between lands 7 and 6 is recorded for step 14 | yes | joint_id: design/wiring/product-wiring.csv:22 | wiring_line: design/wiring/product-wiring.csv:22 | end: design/wiring/product-wiring.csv:22 | what_meets_what: design/wiring/product-wiring.csv:22 | step: design/mfg/assembly/assembly.md:139 | solder_source: design/mfg/assembly/assembly.md:142; design/mfg/assembly/process.md:65 | flux: design/mfg/assembly/assembly.md:142; design/mfg/assembly/process.md:70 | tool: design/mfg/assembly/assembly.md:142; design/mfg/assembly/process.md:150 | heat: design/mfg/assembly/assembly.md:142 | orientation: design/mfg/assembly/assembly.md:141; design/ecad/band/band-interface.md:124 | alignment: design/mfg/assembly/assembly.md:142; design/mfg/assembly/assembly.md:141; design/ecad/band/band-interface.md:122 | check: design/mfg/assembly/assembly.md:145 | check_possible_at_this_step: design/mfg/assembly/assembly.md:145; process: design/mfg/assembly/process.md P1.3, P1.5, P4, P6
J-W022-B | W022 | B | FLEX1 M1 pin 1 (land of footprint W0525AB001D_Lands), face F.Cu (hand solder (lead on land)), the motor's red (+) lead on its land, every ring size US 7 to 13 | 7 | Kester 275 SAC305 no-clean cored wire 0.25 mm, 2.2 % flux, part 2470687623 (process.md P1.3, P4); the same wire tins the stripped lead end | the ROL0 no-clean core of the Kester 275 wire; residue left (process.md P1.3, P1.5) | 50 W temperature-controlled soldering iron, chisel tip 0.8 mm wide or narrower (process.md P4, P6) | iron 320 C, 2 s | red lead to land 1 (+, VMOT), the land nearer the slot; the motor stands on the +X side of the tail, so the leads arrive from +v | stripped end laid along the 0.80 mm side of its land (lands 0.30 x 0.80 at pitch 1.0); FLEX1 has no mark on it | both joints pass the accept rules of step 2; 3.0 V through a 200 mA current limit for 0.5 s, + on tail land 7 (VMOT) and - on tail land 6 (GND) of the FLEX1 foot, numbered on the flex drawing, detail 'BOARD END OF THE RIBBON: LAND NUMBERS AND NETS' (change C13), needle tips 0.2 mm or finer: the motor vibrates; the meter reading between lands 7 and 6 is recorded for step 14 | yes | joint_id: design/wiring/product-wiring.csv:23 | wiring_line: design/wiring/product-wiring.csv:23 | end: design/wiring/product-wiring.csv:23 | what_meets_what: design/wiring/product-wiring.csv:23 | step: design/mfg/assembly/assembly.md:139 | solder_source: design/mfg/assembly/assembly.md:142; design/mfg/assembly/process.md:65 | flux: design/mfg/assembly/assembly.md:142; design/mfg/assembly/process.md:70 | tool: design/mfg/assembly/assembly.md:142; design/mfg/assembly/process.md:150 | heat: design/mfg/assembly/assembly.md:142 | orientation: design/mfg/assembly/assembly.md:141; design/ecad/band/band-interface.md:124 | alignment: design/mfg/assembly/assembly.md:142; design/mfg/assembly/assembly.md:141; design/ecad/band/band-interface.md:122 | check: design/mfg/assembly/assembly.md:145 | check_possible_at_this_step: design/mfg/assembly/assembly.md:145; process: design/mfg/assembly/process.md P1.3, P1.5, P4, P6
J-W023-B | W023 | B | FLEX1 M1 pin 1 (land of footprint W0525AB001D_Lands), face F.Cu (hand solder (iron 320 C, 2 s)), the motor's red (+) lead on its land, every ring size US 7 to 13 | 7 | Kester 275 SAC305 no-clean cored wire 0.25 mm, 2.2 % flux, part 2470687623 (process.md P1.3, P4); the same wire tins the stripped lead end | the ROL0 no-clean core of the Kester 275 wire; residue left (process.md P1.3, P1.5) | 50 W temperature-controlled soldering iron, chisel tip 0.8 mm wide or narrower (process.md P4, P6) | iron 320 C, 2 s | red lead to land 1 (+, VMOT), the land nearer the slot; the motor stands on the +X side of the tail, so the leads arrive from +v | stripped end laid along the 0.80 mm side of its land (lands 0.30 x 0.80 at pitch 1.0); FLEX1 has no mark on it | both joints pass the accept rules of step 2; 3.0 V through a 200 mA current limit for 0.5 s, + on tail land 7 (VMOT) and - on tail land 6 (GND) of the FLEX1 foot, numbered on the flex drawing, detail 'BOARD END OF THE RIBBON: LAND NUMBERS AND NETS' (change C13), needle tips 0.2 mm or finer: the motor vibrates; the meter reading between lands 7 and 6 is recorded for step 14 | yes | joint_id: design/wiring/product-wiring.csv:24 | wiring_line: design/wiring/product-wiring.csv:24 | end: design/wiring/product-wiring.csv:24 | what_meets_what: design/wiring/product-wiring.csv:24 | step: design/mfg/assembly/assembly.md:139 | solder_source: design/mfg/assembly/assembly.md:142; design/mfg/assembly/process.md:65 | flux: design/mfg/assembly/assembly.md:142; design/mfg/assembly/process.md:70 | tool: design/mfg/assembly/assembly.md:142; design/mfg/assembly/process.md:150 | heat: design/mfg/assembly/assembly.md:142 | orientation: design/mfg/assembly/assembly.md:141; design/ecad/band/band-interface.md:124 | alignment: design/mfg/assembly/assembly.md:142; design/mfg/assembly/assembly.md:141; design/ecad/band/band-interface.md:122 | check: design/mfg/assembly/assembly.md:145 | check_possible_at_this_step: design/mfg/assembly/assembly.md:145; process: design/mfg/assembly/process.md P1.3, P1.5, P4, P6
J-W024-B | W024 | B | FLEX1 M1 pin 2 (land of footprint W0525AB001D_Lands), face F.Cu (hand solder (iron 320 C, 2 s)), the motor's blue (-) lead on its land, every ring size US 7 to 13 | 7 | Kester 275 SAC305 no-clean cored wire 0.25 mm, 2.2 % flux, part 2470687623 (process.md P1.3, P4); the same wire tins the stripped lead end | the ROL0 no-clean core of the Kester 275 wire; residue left (process.md P1.3, P1.5) | 50 W temperature-controlled soldering iron, chisel tip 0.8 mm wide or narrower (process.md P4, P6) | iron 320 C, 2 s | blue lead to land 2 (-, GND), the land farther from the slot; the motor stands on the +X side of the tail, so the leads arrive from +v | stripped end laid along the 0.80 mm side of its land (lands 0.30 x 0.80 at pitch 1.0); FLEX1 has no mark on it | both joints pass the accept rules of step 2; 3.0 V through a 200 mA current limit for 0.5 s, + on tail land 7 (VMOT) and - on tail land 6 (GND) of the FLEX1 foot, numbered on the flex drawing, detail 'BOARD END OF THE RIBBON: LAND NUMBERS AND NETS' (change C13), needle tips 0.2 mm or finer: the motor vibrates; the meter reading between lands 7 and 6 is recorded for step 14 | yes | joint_id: design/wiring/product-wiring.csv:25 | wiring_line: design/wiring/product-wiring.csv:25 | end: design/wiring/product-wiring.csv:25 | what_meets_what: design/wiring/product-wiring.csv:25 | step: design/mfg/assembly/assembly.md:139 | solder_source: design/mfg/assembly/assembly.md:142; design/mfg/assembly/process.md:65 | flux: design/mfg/assembly/assembly.md:142; design/mfg/assembly/process.md:70 | tool: design/mfg/assembly/assembly.md:142; design/mfg/assembly/process.md:150 | heat: design/mfg/assembly/assembly.md:142 | orientation: design/mfg/assembly/assembly.md:141; design/ecad/band/band-interface.md:124 | alignment: design/mfg/assembly/assembly.md:142; design/mfg/assembly/assembly.md:141; design/ecad/band/band-interface.md:122 | check: design/mfg/assembly/assembly.md:145 | check_possible_at_this_step: design/mfg/assembly/assembly.md:145; process: design/mfg/assembly/process.md P1.3, P1.5, P4, P6
J-W025-B | W025 | B | FLEX2 PRT1 pin 1 (land of footprint PRT1_Tabs), face F.Cu (hand solder (tab on land)), a tab of the bought cell pack on its land, every ring size US 7 to 13 | 9 | Kester 275 SAC305 no-clean cored wire 0.25 mm, 2.2 % flux, part 2470687623 (process.md P1.3, P4); the land is not pre-tinned, the wire brings the solder | the ROL0 no-clean core of the Kester 275 wire; residue left (process.md P1.3, P1.5) | 50 W temperature-controlled soldering iron, chisel or conical tip 0.45 mm wide or narrower (process.md P4, P6) | iron 280 C at most, 2 s per joint | tab P+ on land 1 (VBAT); the lands sit on the tail's outer face (F.Cu, facing the cell) | tabs in the order P+, NTC, P- from the slot toward the cell (lands 1, 3, 2); lands of footprint PRT1_Tabs 0.26 along the tail x 0.45 across, pitch 0.43; first land centre at s = 0.586 mm (US 7) to 1.774 mm (US 13) after the slot junction | the joints pass the accept rules of step 2; at the FLEX2 foot, lands numbered on the flex drawing, detail 'BOARD END OF THE RIBBON: LAND NUMBERS AND NETS' (change C13), needle tips 0.2 mm or finer: the red probe on tail land 1 (VBAT) and the black on land 2 (GND) read the cell voltage, positive; a negative reading: first check on the drawing that the probes sit on lands 1 and 2, only then is a tab on the wrong land; cell voltage measured before and after the joints | yes | joint_id: design/wiring/product-wiring.csv:26 | wiring_line: design/wiring/product-wiring.csv:26 | end: design/wiring/product-wiring.csv:26 | what_meets_what: design/wiring/product-wiring.csv:26 | step: design/mfg/assembly/assembly.md:157 | solder_source: design/mfg/assembly/assembly.md:160; design/mfg/assembly/process.md:65 | flux: design/mfg/assembly/assembly.md:160; design/mfg/assembly/process.md:70 | tool: design/mfg/assembly/assembly.md:160; design/mfg/assembly/process.md:151 | heat: design/mfg/assembly/assembly.md:160 | orientation: design/mfg/assembly/assembly.md:159; design/ecad/band/band-interface.md:116 | alignment: design/mfg/assembly/assembly.md:159; design/ecad/band/band-interface.md:116; design/ecad/band/band-interface.md:116 | check: design/mfg/assembly/assembly.md:163 | check_possible_at_this_step: design/mfg/assembly/assembly.md:163; process: design/mfg/assembly/process.md P1.3, P1.5, P4, P6
J-W026-B | W026 | B | FLEX2 PRT1 pin 2 (land of footprint PRT1_Tabs), face F.Cu (hand solder (tab on land)), a tab of the bought cell pack on its land, every ring size US 7 to 13 | 9 | Kester 275 SAC305 no-clean cored wire 0.25 mm, 2.2 % flux, part 2470687623 (process.md P1.3, P4); the land is not pre-tinned, the wire brings the solder | the ROL0 no-clean core of the Kester 275 wire; residue left (process.md P1.3, P1.5) | 50 W temperature-controlled soldering iron, chisel or conical tip 0.45 mm wide or narrower (process.md P4, P6) | iron 280 C at most, 2 s per joint | tab P- on land 2 (GND); the lands sit on the tail's outer face (F.Cu, facing the cell) | tabs in the order P+, NTC, P- from the slot toward the cell (lands 1, 3, 2); lands of footprint PRT1_Tabs 0.26 along the tail x 0.45 across, pitch 0.43; first land centre at s = 0.586 mm (US 7) to 1.774 mm (US 13) after the slot junction | the joints pass the accept rules of step 2; at the FLEX2 foot, lands numbered on the flex drawing, detail 'BOARD END OF THE RIBBON: LAND NUMBERS AND NETS' (change C13), needle tips 0.2 mm or finer: land 1 (VBAT) to land 2 (GND) reads the cell voltage, positive (as W025); cell voltage measured before and after the joints | yes | joint_id: design/wiring/product-wiring.csv:27 | wiring_line: design/wiring/product-wiring.csv:27 | end: design/wiring/product-wiring.csv:27 | what_meets_what: design/wiring/product-wiring.csv:27 | step: design/mfg/assembly/assembly.md:157 | solder_source: design/mfg/assembly/assembly.md:160; design/mfg/assembly/process.md:65 | flux: design/mfg/assembly/assembly.md:160; design/mfg/assembly/process.md:70 | tool: design/mfg/assembly/assembly.md:160; design/mfg/assembly/process.md:151 | heat: design/mfg/assembly/assembly.md:160 | orientation: design/mfg/assembly/assembly.md:159; design/ecad/band/band-interface.md:116 | alignment: design/mfg/assembly/assembly.md:159; design/ecad/band/band-interface.md:116; design/ecad/band/band-interface.md:116 | check: design/mfg/assembly/assembly.md:163 | check_possible_at_this_step: design/mfg/assembly/assembly.md:163; process: design/mfg/assembly/process.md P1.3, P1.5, P4, P6
J-W027-B | W027 | B | FLEX2 PRT1 pin 3 (land of footprint PRT1_Tabs), face F.Cu (hand solder (tab on land)), a tab of the bought cell pack on its land, every ring size US 7 to 13 | 9 | Kester 275 SAC305 no-clean cored wire 0.25 mm, 2.2 % flux, part 2470687623 (process.md P1.3, P4); the land is not pre-tinned, the wire brings the solder | the ROL0 no-clean core of the Kester 275 wire; residue left (process.md P1.3, P1.5) | 50 W temperature-controlled soldering iron, chisel or conical tip 0.45 mm wide or narrower (process.md P4, P6) | iron 280 C at most, 2 s per joint | tab NTC on land 3 (NTC); the lands sit on the tail's outer face (F.Cu, facing the cell) | tabs in the order P+, NTC, P- from the slot toward the cell (lands 1, 3, 2); lands of footprint PRT1_Tabs 0.26 along the tail x 0.45 across, pitch 0.43; first land centre at s = 0.586 mm (US 7) to 1.774 mm (US 13) after the slot junction | the joints pass the accept rules of step 2; at the FLEX2 foot, lands numbered on the flex drawing, detail 'BOARD END OF THE RIBBON: LAND NUMBERS AND NETS' (change C13), needle tips 0.2 mm or finer: about 10 k between tail land 3 (NTC) and land 2 (GND) at room temperature; cell voltage measured before and after the joints | yes | joint_id: design/wiring/product-wiring.csv:28 | wiring_line: design/wiring/product-wiring.csv:28 | end: design/wiring/product-wiring.csv:28 | what_meets_what: design/wiring/product-wiring.csv:28 | step: design/mfg/assembly/assembly.md:157 | solder_source: design/mfg/assembly/assembly.md:160; design/mfg/assembly/process.md:65 | flux: design/mfg/assembly/assembly.md:160; design/mfg/assembly/process.md:70 | tool: design/mfg/assembly/assembly.md:160; design/mfg/assembly/process.md:151 | heat: design/mfg/assembly/assembly.md:160 | orientation: design/mfg/assembly/assembly.md:159; design/ecad/band/band-interface.md:116 | alignment: design/mfg/assembly/assembly.md:159; design/ecad/band/band-interface.md:116; design/ecad/band/band-interface.md:116 | check: design/mfg/assembly/assembly.md:163 | check_possible_at_this_step: design/mfg/assembly/assembly.md:163; process: design/mfg/assembly/process.md P1.3, P1.5, P4, P6
J-W033-B | W033 | B | FLEX2 PRT1 pin 1 (land of footprint PRT1_Tabs), face F.Cu (hand solder, low heat (iron 280 C max, 2 s)), a tab of the bought cell pack on its land, every ring size US 7 to 13 | 9 | Kester 275 SAC305 no-clean cored wire 0.25 mm, 2.2 % flux, part 2470687623 (process.md P1.3, P4); the land is not pre-tinned, the wire brings the solder | the ROL0 no-clean core of the Kester 275 wire; residue left (process.md P1.3, P1.5) | 50 W temperature-controlled soldering iron, chisel or conical tip 0.45 mm wide or narrower (process.md P4, P6) | iron 280 C at most, 2 s per joint | tab P+ on land 1 (VBAT); the lands sit on the tail's outer face (F.Cu, facing the cell) | tabs in the order P+, NTC, P- from the slot toward the cell (lands 1, 3, 2); lands of footprint PRT1_Tabs 0.26 along the tail x 0.45 across, pitch 0.43; first land centre at s = 0.586 mm (US 7) to 1.774 mm (US 13) after the slot junction | the joints pass the accept rules of step 2; at the FLEX2 foot, lands numbered on the flex drawing, detail 'BOARD END OF THE RIBBON: LAND NUMBERS AND NETS' (change C13), needle tips 0.2 mm or finer: the pack's three tab joints: cell voltage positive from tail land 1 to land 2, about 10 k from land 3 to land 2; cell voltage measured before and after the joints | yes | joint_id: design/wiring/product-wiring.csv:34 | wiring_line: design/wiring/product-wiring.csv:34 | end: design/wiring/product-wiring.csv:34 | what_meets_what: design/wiring/product-wiring.csv:34 | step: design/mfg/assembly/assembly.md:157 | solder_source: design/mfg/assembly/assembly.md:160; design/mfg/assembly/process.md:65 | flux: design/mfg/assembly/assembly.md:160; design/mfg/assembly/process.md:70 | tool: design/mfg/assembly/assembly.md:160; design/mfg/assembly/process.md:151 | heat: design/mfg/assembly/assembly.md:160 | orientation: design/mfg/assembly/assembly.md:159; design/ecad/band/band-interface.md:116 | alignment: design/mfg/assembly/assembly.md:159; design/ecad/band/band-interface.md:116; design/ecad/band/band-interface.md:116 | check: design/mfg/assembly/assembly.md:163 | check_possible_at_this_step: design/mfg/assembly/assembly.md:163; process: design/mfg/assembly/process.md P1.3, P1.5, P4, P6
J-W034-B | W034 | B | FLEX2 PRT1 pin 2 (land of footprint PRT1_Tabs), face F.Cu (hand solder, low heat (iron 280 C max, 2 s)), a tab of the bought cell pack on its land, every ring size US 7 to 13 | 9 | Kester 275 SAC305 no-clean cored wire 0.25 mm, 2.2 % flux, part 2470687623 (process.md P1.3, P4); the land is not pre-tinned, the wire brings the solder | the ROL0 no-clean core of the Kester 275 wire; residue left (process.md P1.3, P1.5) | 50 W temperature-controlled soldering iron, chisel or conical tip 0.45 mm wide or narrower (process.md P4, P6) | iron 280 C at most, 2 s per joint | tab P- on land 2 (GND); the lands sit on the tail's outer face (F.Cu, facing the cell) | tabs in the order P+, NTC, P- from the slot toward the cell (lands 1, 3, 2); lands of footprint PRT1_Tabs 0.26 along the tail x 0.45 across, pitch 0.43; first land centre at s = 0.586 mm (US 7) to 1.774 mm (US 13) after the slot junction | the joints pass the accept rules of step 2; at the FLEX2 foot, lands numbered on the flex drawing, detail 'BOARD END OF THE RIBBON: LAND NUMBERS AND NETS' (change C13), needle tips 0.2 mm or finer: the pack's three tab joints: cell voltage positive from tail land 1 to land 2, about 10 k from land 3 to land 2; cell voltage measured before and after the joints | yes | joint_id: design/wiring/product-wiring.csv:35 | wiring_line: design/wiring/product-wiring.csv:35 | end: design/wiring/product-wiring.csv:35 | what_meets_what: design/wiring/product-wiring.csv:35 | step: design/mfg/assembly/assembly.md:157 | solder_source: design/mfg/assembly/assembly.md:160; design/mfg/assembly/process.md:65 | flux: design/mfg/assembly/assembly.md:160; design/mfg/assembly/process.md:70 | tool: design/mfg/assembly/assembly.md:160; design/mfg/assembly/process.md:151 | heat: design/mfg/assembly/assembly.md:160 | orientation: design/mfg/assembly/assembly.md:159; design/ecad/band/band-interface.md:116 | alignment: design/mfg/assembly/assembly.md:159; design/ecad/band/band-interface.md:116; design/ecad/band/band-interface.md:116 | check: design/mfg/assembly/assembly.md:163 | check_possible_at_this_step: design/mfg/assembly/assembly.md:163; process: design/mfg/assembly/process.md P1.3, P1.5, P4, P6
J-W035-B | W035 | B | FLEX2 PRT1 pin 3 (land of footprint PRT1_Tabs), face F.Cu (hand solder, low heat (iron 280 C max, 2 s)), a tab of the bought cell pack on its land, every ring size US 7 to 13 | 9 | Kester 275 SAC305 no-clean cored wire 0.25 mm, 2.2 % flux, part 2470687623 (process.md P1.3, P4); the land is not pre-tinned, the wire brings the solder | the ROL0 no-clean core of the Kester 275 wire; residue left (process.md P1.3, P1.5) | 50 W temperature-controlled soldering iron, chisel or conical tip 0.45 mm wide or narrower (process.md P4, P6) | iron 280 C at most, 2 s per joint | tab NTC on land 3 (NTC); the lands sit on the tail's outer face (F.Cu, facing the cell) | tabs in the order P+, NTC, P- from the slot toward the cell (lands 1, 3, 2); lands of footprint PRT1_Tabs 0.26 along the tail x 0.45 across, pitch 0.43; first land centre at s = 0.586 mm (US 7) to 1.774 mm (US 13) after the slot junction | the joints pass the accept rules of step 2; at the FLEX2 foot, lands numbered on the flex drawing, detail 'BOARD END OF THE RIBBON: LAND NUMBERS AND NETS' (change C13), needle tips 0.2 mm or finer: the pack's three tab joints: cell voltage positive from tail land 1 to land 2, about 10 k from land 3 to land 2; cell voltage measured before and after the joints | yes | joint_id: design/wiring/product-wiring.csv:36 | wiring_line: design/wiring/product-wiring.csv:36 | end: design/wiring/product-wiring.csv:36 | what_meets_what: design/wiring/product-wiring.csv:36 | step: design/mfg/assembly/assembly.md:157 | solder_source: design/mfg/assembly/assembly.md:160; design/mfg/assembly/process.md:65 | flux: design/mfg/assembly/assembly.md:160; design/mfg/assembly/process.md:70 | tool: design/mfg/assembly/assembly.md:160; design/mfg/assembly/process.md:151 | heat: design/mfg/assembly/assembly.md:160 | orientation: design/mfg/assembly/assembly.md:159; design/ecad/band/band-interface.md:116 | alignment: design/mfg/assembly/assembly.md:159; design/ecad/band/band-interface.md:116; design/ecad/band/band-interface.md:116 | check: design/mfg/assembly/assembly.md:163 | check_possible_at_this_step: design/mfg/assembly/assembly.md:163; process: design/mfg/assembly/process.md P1.3, P1.5, P4, P6
J-W029-B | W029 | B | FLEX2 CP1 pin 1, face B.Cu (reflow (disc soldered flat with SAC305 paste)), gold-plated disc 1.6 mm x 0.07 mm soldered flat on its land, every ring size US 7 to 13 | 8 | Kester NP505-HR SAC305 Type 4 (20 to 38 um), 88.5 % metal, no-clean, part 7040211410, printed through a 0.08 mm stainless stencil cut from the FLEX2 paste layer, four 0.58 mm round openings per disc land off the centre via (change C2): paste layer design/ecad/band/fab/flex2-us7/flex2-us7-B_Paste.gbr for CP1:1; paste layer design/ecad/band/fab/flex2-us8/flex2-us8-B_Paste.gbr for CP1:1; paste layer design/ecad/band/fab/flex2-us9/flex2-us9-B_Paste.gbr for CP1:1; paste layer design/ecad/band/fab/flex2-us10/flex2-us10-B_Paste.gbr for CP1:1; paste layer design/ecad/band/fab/flex2-us11/flex2-us11-B_Paste.gbr for CP1:1; paste layer design/ecad/band/fab/flex2-us12/flex2-us12-B_Paste.gbr for CP1:1; paste layer design/ecad/band/fab/flex2-us13/flex2-us13-B_Paste.gbr for CP1:1 | the ROL0 no-clean flux of the NP505-HR paste; no added liquid flux; residue left, never washed or brushed (process.md P1.2, P1.5) | 0.08 mm stainless stencil, hot plate with a thermocouple taped on the ribbon beside a disc, tweezers, 10 times magnifier (process.md P5, P6) | hot plate on the P3 profile: to 150 C at less than 2.5 C/s, 150 to 200 C in 90 to 110 s, 60 to 75 s above 217 C, at most 35 s above 230 C, peak 240 C (accepted 235 to 245 C on a thermocouple at the board surface), cool at 6 C/s or slower; ribbon slid off onto a metal block to cool (process.md P5) | flat ribbon on the plate, pad lands (B.Cu) up; one disc per land, the four discs are alike | disc centred on its 1.6 mm land by eye under a 10 times lens | the joint passes the accept rules of step 2; disc flat on its land and centred, no tilt; disc top 0.070 to 0.112 mm above the land copper (feeler or microscope focus, 0.02 mm steps); continuity from the disc to tail land 4 of the FLEX2 foot, numbered on the flex drawing, detail 'BOARD END OF THE RIBBON: LAND NUMBERS AND NETS' (change C13); no short between neighbouring discs or their lands; flush with the liner is checked at step 21 | yes | joint_id: design/wiring/product-wiring.csv:30 | wiring_line: design/wiring/product-wiring.csv:30 | end: design/wiring/product-wiring.csv:30 | what_meets_what: design/wiring/product-wiring.csv:30; design/mfg/assembly/assembly.md:150 | step: design/mfg/assembly/assembly.md:148 | solder_source: design/mfg/assembly/assembly.md:151 | flux: design/mfg/assembly/v7-update-notes.md:27; design/mfg/assembly/joint-table-work/logs/flux-search.log:3 | tool: design/mfg/assembly/assembly.md:151; design/mfg/assembly/assembly.md:151 | heat: design/mfg/assembly/assembly.md:151 | orientation: design/mfg/assembly/assembly.md:151; design/wiring/product-wiring.csv:30 | alignment: design/mfg/assembly/assembly.md:151 | check: design/mfg/assembly/assembly.md:154; design/mfg/assembly/process.md:163 | check_possible_at_this_step: design/mfg/assembly/assembly.md:154; process: design/mfg/assembly/process.md P1.2, P1.5, P2, P5, P6
J-W030-B | W030 | B | FLEX2 CP2 pin 1, face B.Cu (reflow (disc soldered flat with SAC305 paste)), gold-plated disc 1.6 mm x 0.07 mm soldered flat on its land, every ring size US 7 to 13 | 8 | Kester NP505-HR SAC305 Type 4 (20 to 38 um), 88.5 % metal, no-clean, part 7040211410, printed through a 0.08 mm stainless stencil cut from the FLEX2 paste layer, four 0.58 mm round openings per disc land off the centre via (change C2): paste layer design/ecad/band/fab/flex2-us7/flex2-us7-B_Paste.gbr for CP2:1; paste layer design/ecad/band/fab/flex2-us8/flex2-us8-B_Paste.gbr for CP2:1; paste layer design/ecad/band/fab/flex2-us9/flex2-us9-B_Paste.gbr for CP2:1; paste layer design/ecad/band/fab/flex2-us10/flex2-us10-B_Paste.gbr for CP2:1; paste layer design/ecad/band/fab/flex2-us11/flex2-us11-B_Paste.gbr for CP2:1; paste layer design/ecad/band/fab/flex2-us12/flex2-us12-B_Paste.gbr for CP2:1; paste layer design/ecad/band/fab/flex2-us13/flex2-us13-B_Paste.gbr for CP2:1 | the ROL0 no-clean flux of the NP505-HR paste; no added liquid flux; residue left, never washed or brushed (process.md P1.2, P1.5) | 0.08 mm stainless stencil, hot plate with a thermocouple taped on the ribbon beside a disc, tweezers, 10 times magnifier (process.md P5, P6) | hot plate on the P3 profile: to 150 C at less than 2.5 C/s, 150 to 200 C in 90 to 110 s, 60 to 75 s above 217 C, at most 35 s above 230 C, peak 240 C (accepted 235 to 245 C on a thermocouple at the board surface), cool at 6 C/s or slower; ribbon slid off onto a metal block to cool (process.md P5) | flat ribbon on the plate, pad lands (B.Cu) up; one disc per land, the four discs are alike | disc centred on its 1.6 mm land by eye under a 10 times lens | the joint passes the accept rules of step 2; disc flat on its land and centred, no tilt; disc top 0.070 to 0.112 mm above the land copper (feeler or microscope focus, 0.02 mm steps); continuity from the disc to tail land 5 of the FLEX2 foot, numbered on the flex drawing, detail 'BOARD END OF THE RIBBON: LAND NUMBERS AND NETS' (change C13); no short between neighbouring discs or their lands; flush with the liner is checked at step 21 | yes | joint_id: design/wiring/product-wiring.csv:31 | wiring_line: design/wiring/product-wiring.csv:31 | end: design/wiring/product-wiring.csv:31 | what_meets_what: design/wiring/product-wiring.csv:31; design/mfg/assembly/assembly.md:150 | step: design/mfg/assembly/assembly.md:148 | solder_source: design/mfg/assembly/assembly.md:151 | flux: design/mfg/assembly/v7-update-notes.md:27; design/mfg/assembly/joint-table-work/logs/flux-search.log:3 | tool: design/mfg/assembly/assembly.md:151; design/mfg/assembly/assembly.md:151 | heat: design/mfg/assembly/assembly.md:151 | orientation: design/mfg/assembly/assembly.md:151; design/wiring/product-wiring.csv:31 | alignment: design/mfg/assembly/assembly.md:151 | check: design/mfg/assembly/assembly.md:154; design/mfg/assembly/process.md:163 | check_possible_at_this_step: design/mfg/assembly/assembly.md:154; process: design/mfg/assembly/process.md P1.2, P1.5, P2, P5, P6
J-W031-B | W031 | B | FLEX2 CP3 pin 1, face B.Cu (reflow (disc soldered flat with SAC305 paste)), gold-plated disc 1.6 mm x 0.07 mm soldered flat on its land, every ring size US 7 to 13 | 8 | Kester NP505-HR SAC305 Type 4 (20 to 38 um), 88.5 % metal, no-clean, part 7040211410, printed through a 0.08 mm stainless stencil cut from the FLEX2 paste layer, four 0.58 mm round openings per disc land off the centre via (change C2): paste layer design/ecad/band/fab/flex2-us7/flex2-us7-B_Paste.gbr for CP3:1; paste layer design/ecad/band/fab/flex2-us8/flex2-us8-B_Paste.gbr for CP3:1; paste layer design/ecad/band/fab/flex2-us9/flex2-us9-B_Paste.gbr for CP3:1; paste layer design/ecad/band/fab/flex2-us10/flex2-us10-B_Paste.gbr for CP3:1; paste layer design/ecad/band/fab/flex2-us11/flex2-us11-B_Paste.gbr for CP3:1; paste layer design/ecad/band/fab/flex2-us12/flex2-us12-B_Paste.gbr for CP3:1; paste layer design/ecad/band/fab/flex2-us13/flex2-us13-B_Paste.gbr for CP3:1 | the ROL0 no-clean flux of the NP505-HR paste; no added liquid flux; residue left, never washed or brushed (process.md P1.2, P1.5) | 0.08 mm stainless stencil, hot plate with a thermocouple taped on the ribbon beside a disc, tweezers, 10 times magnifier (process.md P5, P6) | hot plate on the P3 profile: to 150 C at less than 2.5 C/s, 150 to 200 C in 90 to 110 s, 60 to 75 s above 217 C, at most 35 s above 230 C, peak 240 C (accepted 235 to 245 C on a thermocouple at the board surface), cool at 6 C/s or slower; ribbon slid off onto a metal block to cool (process.md P5) | flat ribbon on the plate, pad lands (B.Cu) up; one disc per land, the four discs are alike | disc centred on its 1.6 mm land by eye under a 10 times lens | the joint passes the accept rules of step 2; disc flat on its land and centred, no tilt; disc top 0.070 to 0.112 mm above the land copper (feeler or microscope focus, 0.02 mm steps); continuity from the disc to tail land 6 of the FLEX2 foot, numbered on the flex drawing, detail 'BOARD END OF THE RIBBON: LAND NUMBERS AND NETS' (change C13); no short between neighbouring discs or their lands; flush with the liner is checked at step 21 | yes | joint_id: design/wiring/product-wiring.csv:32 | wiring_line: design/wiring/product-wiring.csv:32 | end: design/wiring/product-wiring.csv:32 | what_meets_what: design/wiring/product-wiring.csv:32; design/mfg/assembly/assembly.md:150 | step: design/mfg/assembly/assembly.md:148 | solder_source: design/mfg/assembly/assembly.md:151 | flux: design/mfg/assembly/v7-update-notes.md:27; design/mfg/assembly/joint-table-work/logs/flux-search.log:3 | tool: design/mfg/assembly/assembly.md:151; design/mfg/assembly/assembly.md:151 | heat: design/mfg/assembly/assembly.md:151 | orientation: design/mfg/assembly/assembly.md:151; design/wiring/product-wiring.csv:32 | alignment: design/mfg/assembly/assembly.md:151 | check: design/mfg/assembly/assembly.md:154; design/mfg/assembly/process.md:163 | check_possible_at_this_step: design/mfg/assembly/assembly.md:154; process: design/mfg/assembly/process.md P1.2, P1.5, P2, P5, P6
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
