NexusGPT/openring/design/ecad/ring/c76-c77-work/notes-fix-check.txt

51:| A | Murata (same maker as the design's 0201 family) | GRM0335C1H102JE01 (sheet title "GRM0335C1H102JE01_(0603M(0201
52:| B | Murata (same maker) | GRM033R71H102KA12 (sheet title "GRM033R71H102KA12_(0603M(0201), X7R(EIA), 1000pF, DC 50V)
59:- Not checked: ESR and any AEC-Q or lot data; the saved sheets were read only for the fields quoted in the table.
74:- The design's own statement of C76 and C77 rating: not in any design file (pmic-caps-facts.md:238). The datasheet ha
79:- P2, the "A01" code: the design does not name it; it was only in the search. GRM033R71H102KA01 gives "could not be f
