NexusGPT/openring/design/ecad/case/case-schematic.pdf

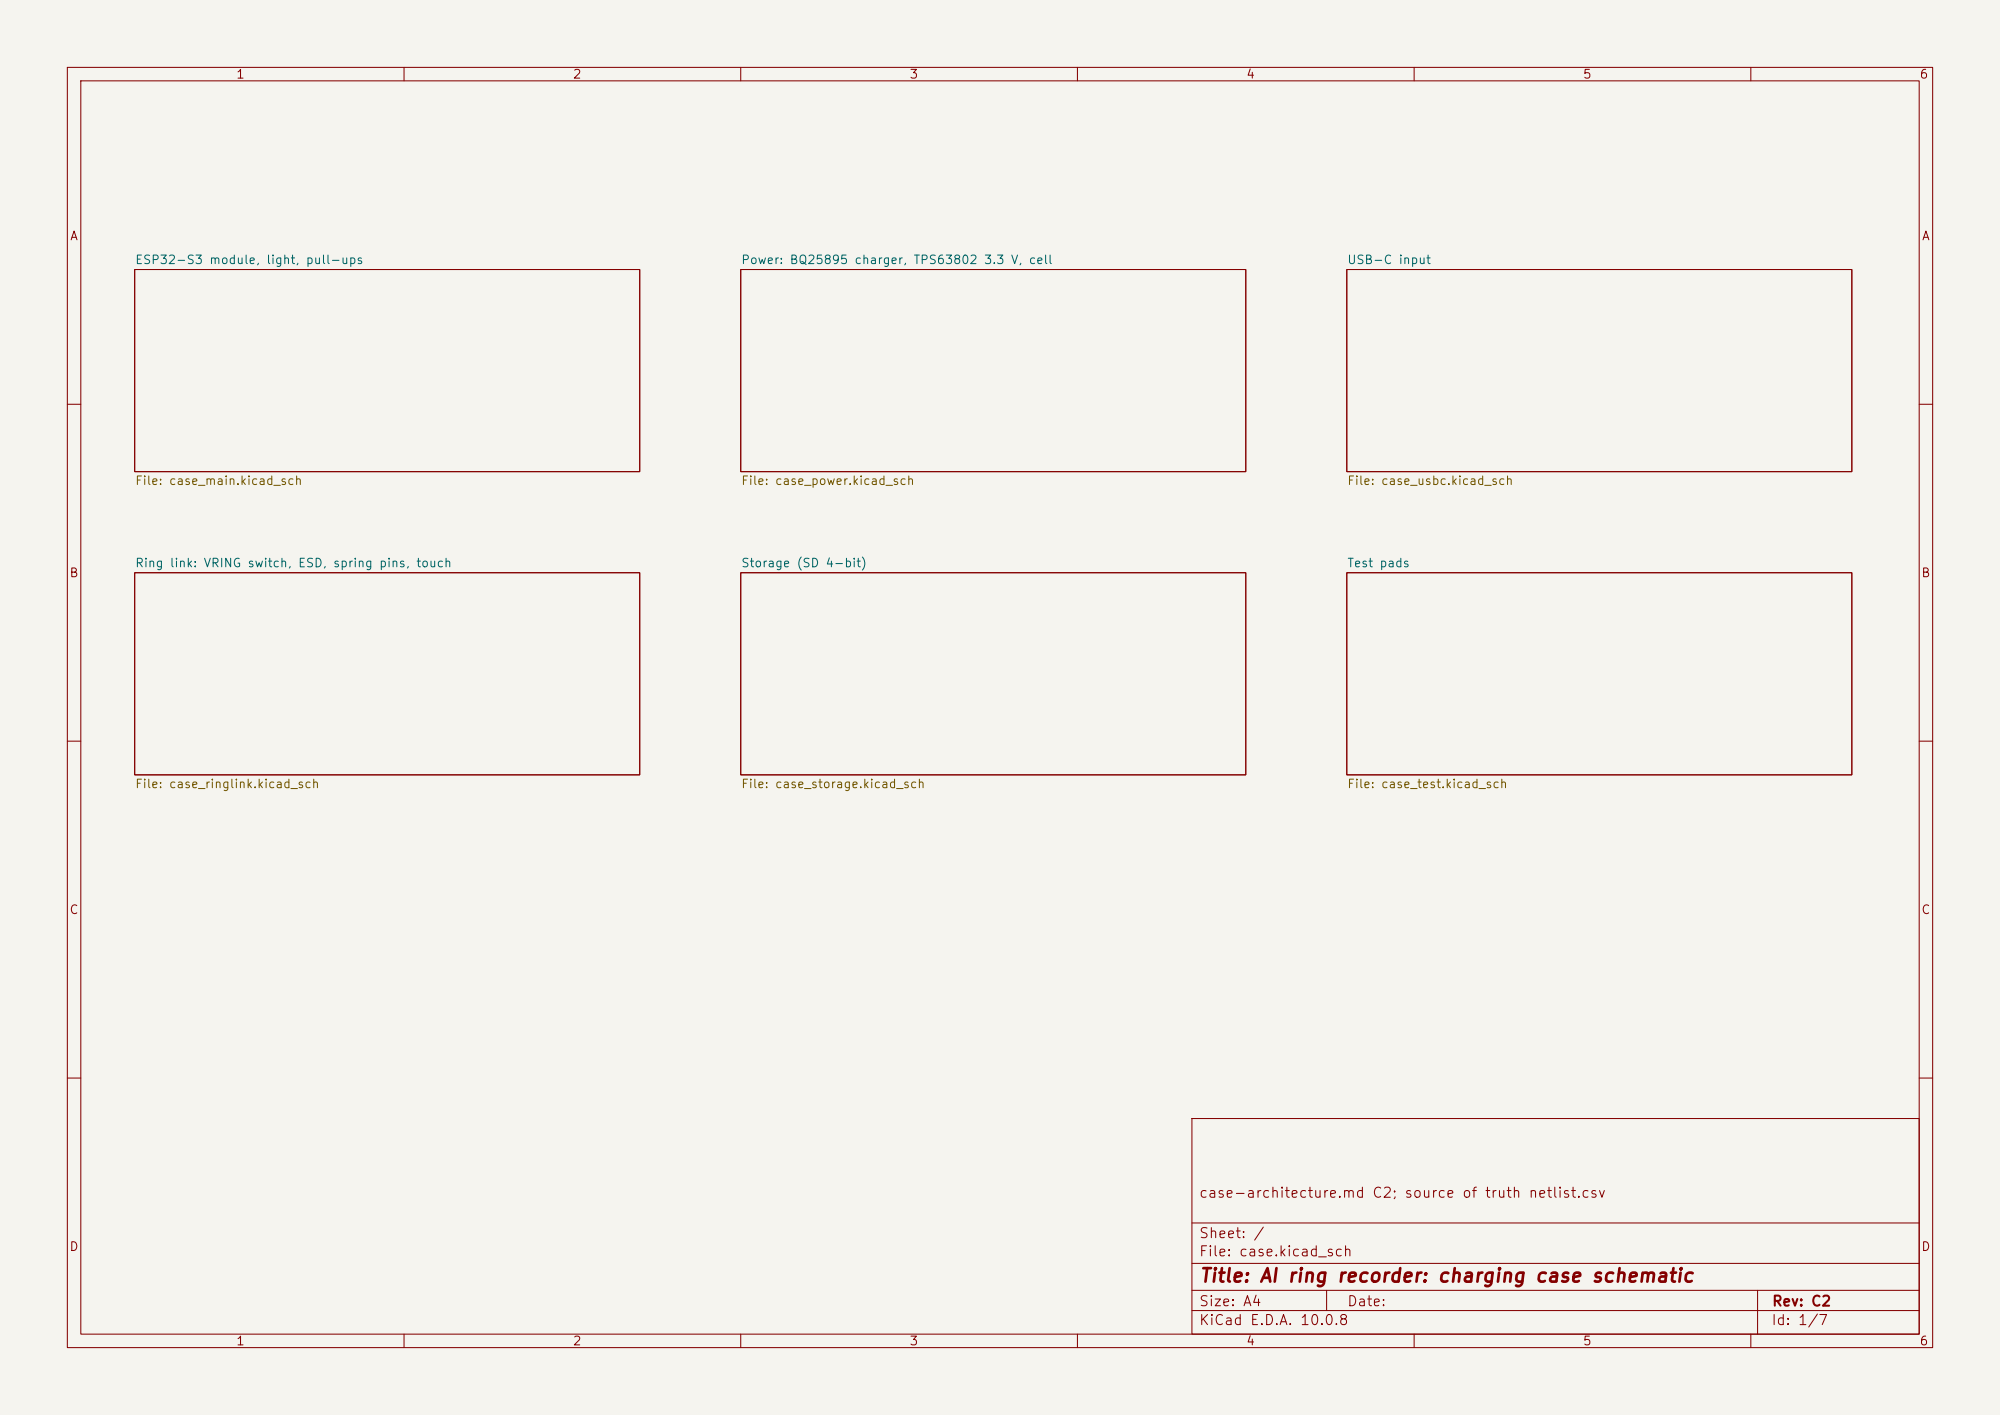
[picture p246: page 1]

Storage (SD 4-bit) File: case_storage.kicad_sch

case-architecture.md C2; source of truth netlist.csv

Sheet: /
File: case.kicad_sch
Title: AI ring recorder: charging case schematic

Size: A4 | Rev: C2
KiCad E.D.A. 10.0.8 | Id: 1/7

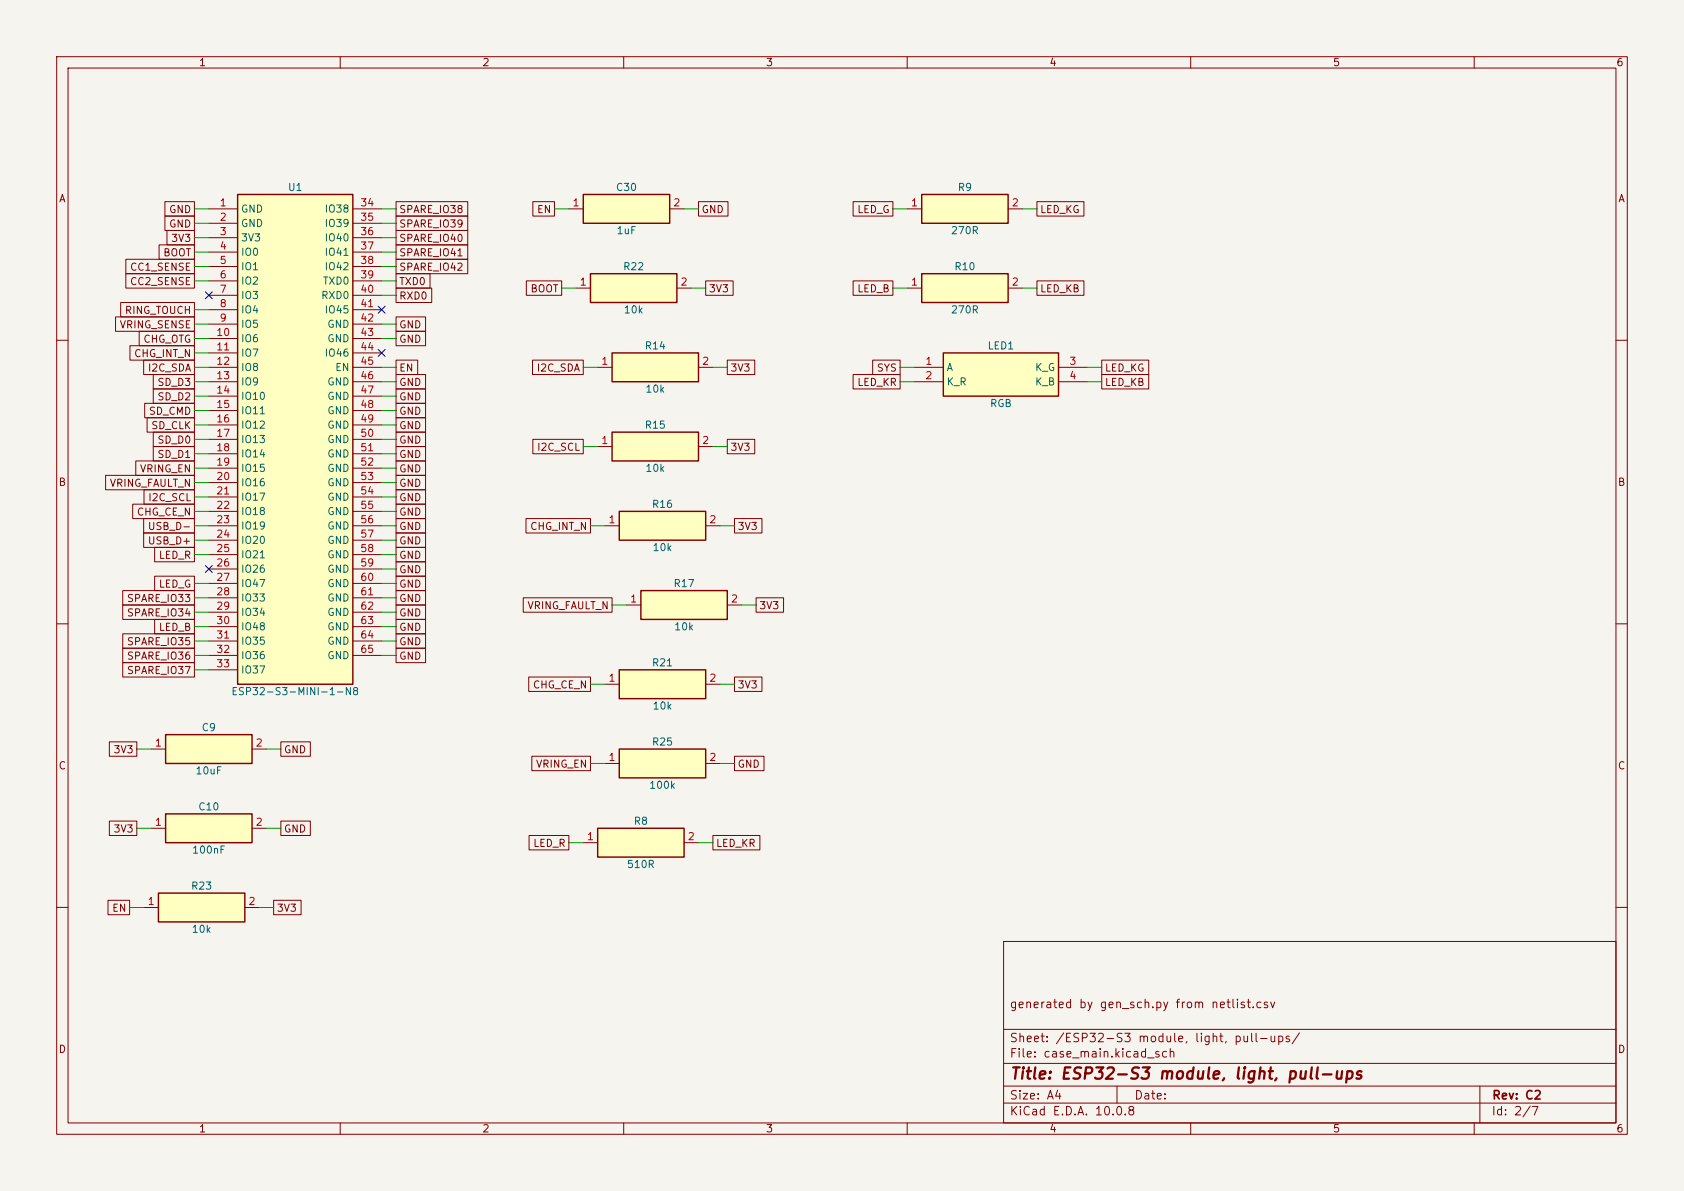
[picture p247: page 2]

generated by gen_sch.py from netlist.csv

Sheet: /ESP32-S3 module, light, pull-ups/
File: case_main.kicad_sch
Title: ESP32-S3 module, light, pull-ups

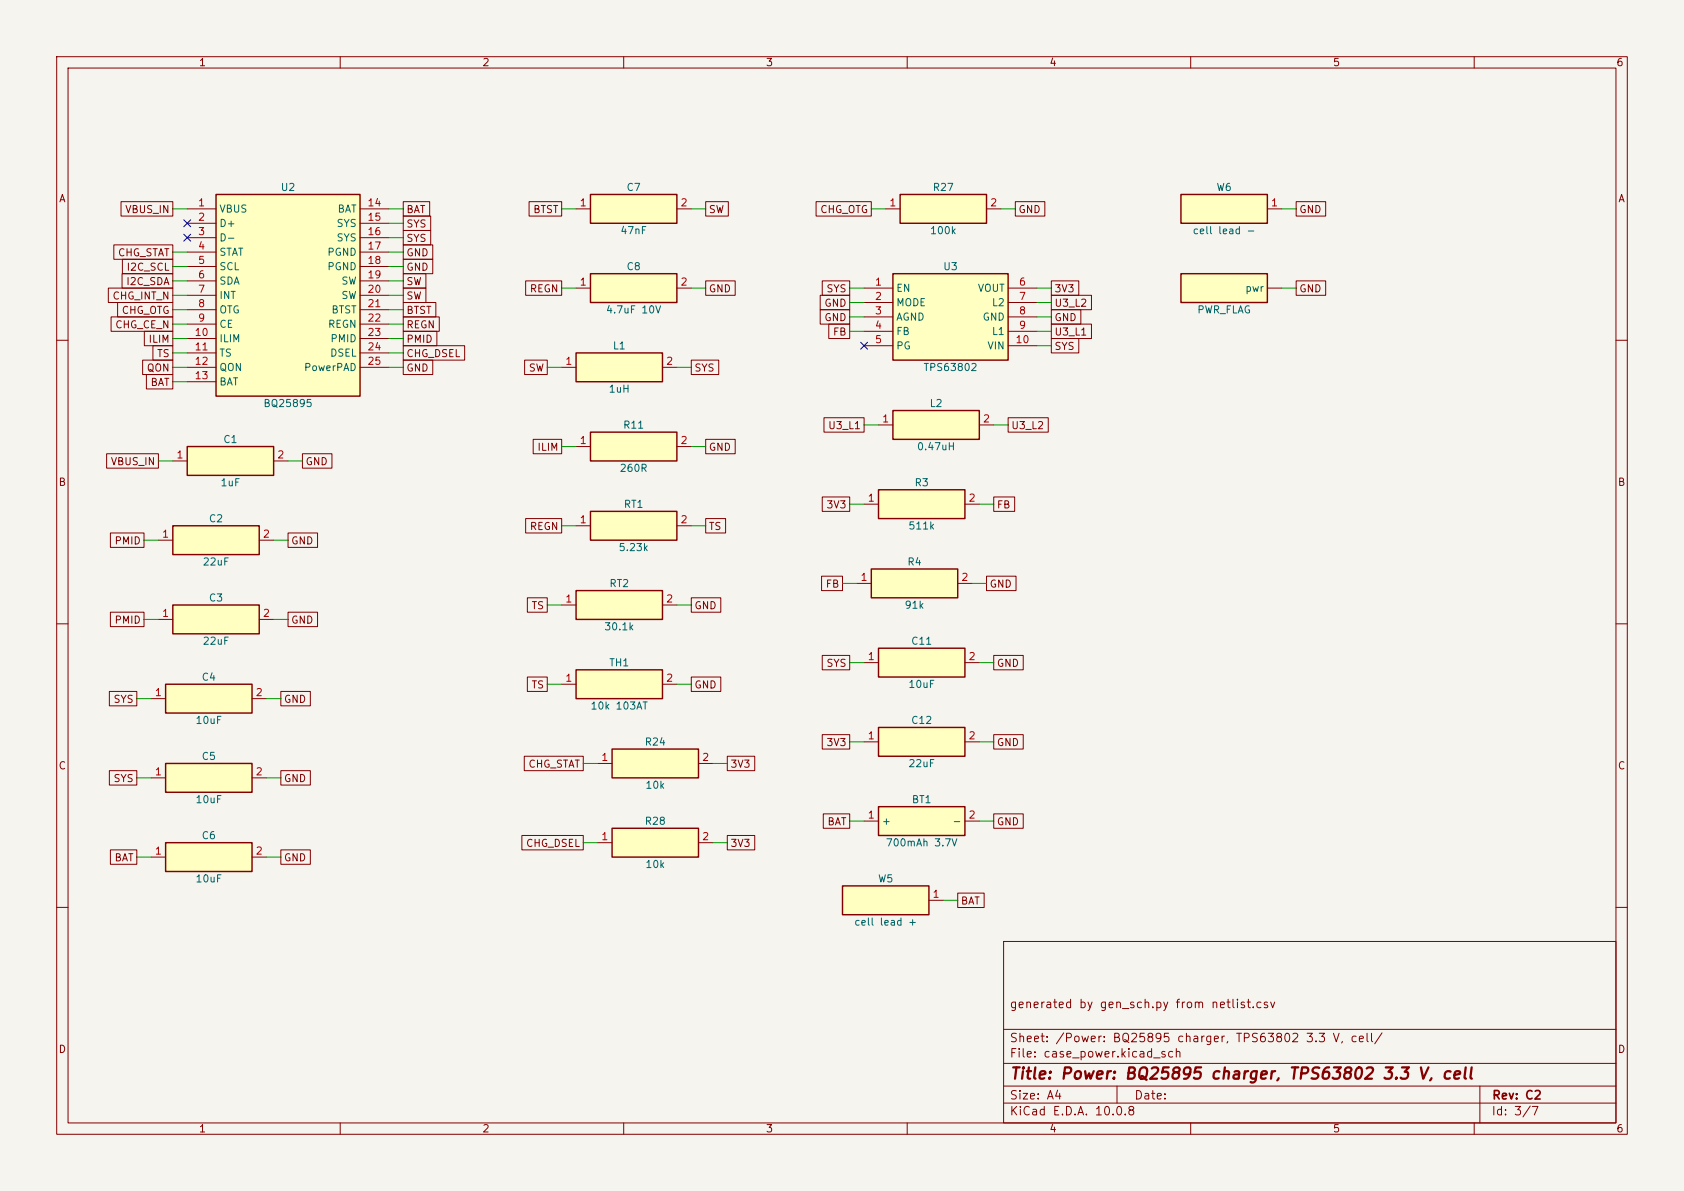
[picture p248: page 3]

Sheet: /Power: BQ25895 charger, TPS63802 3.3 V, cell/
File: case_power.kicad_sch
Title: Power: BQ25895 charger, TPS63802 3.3 V, cell

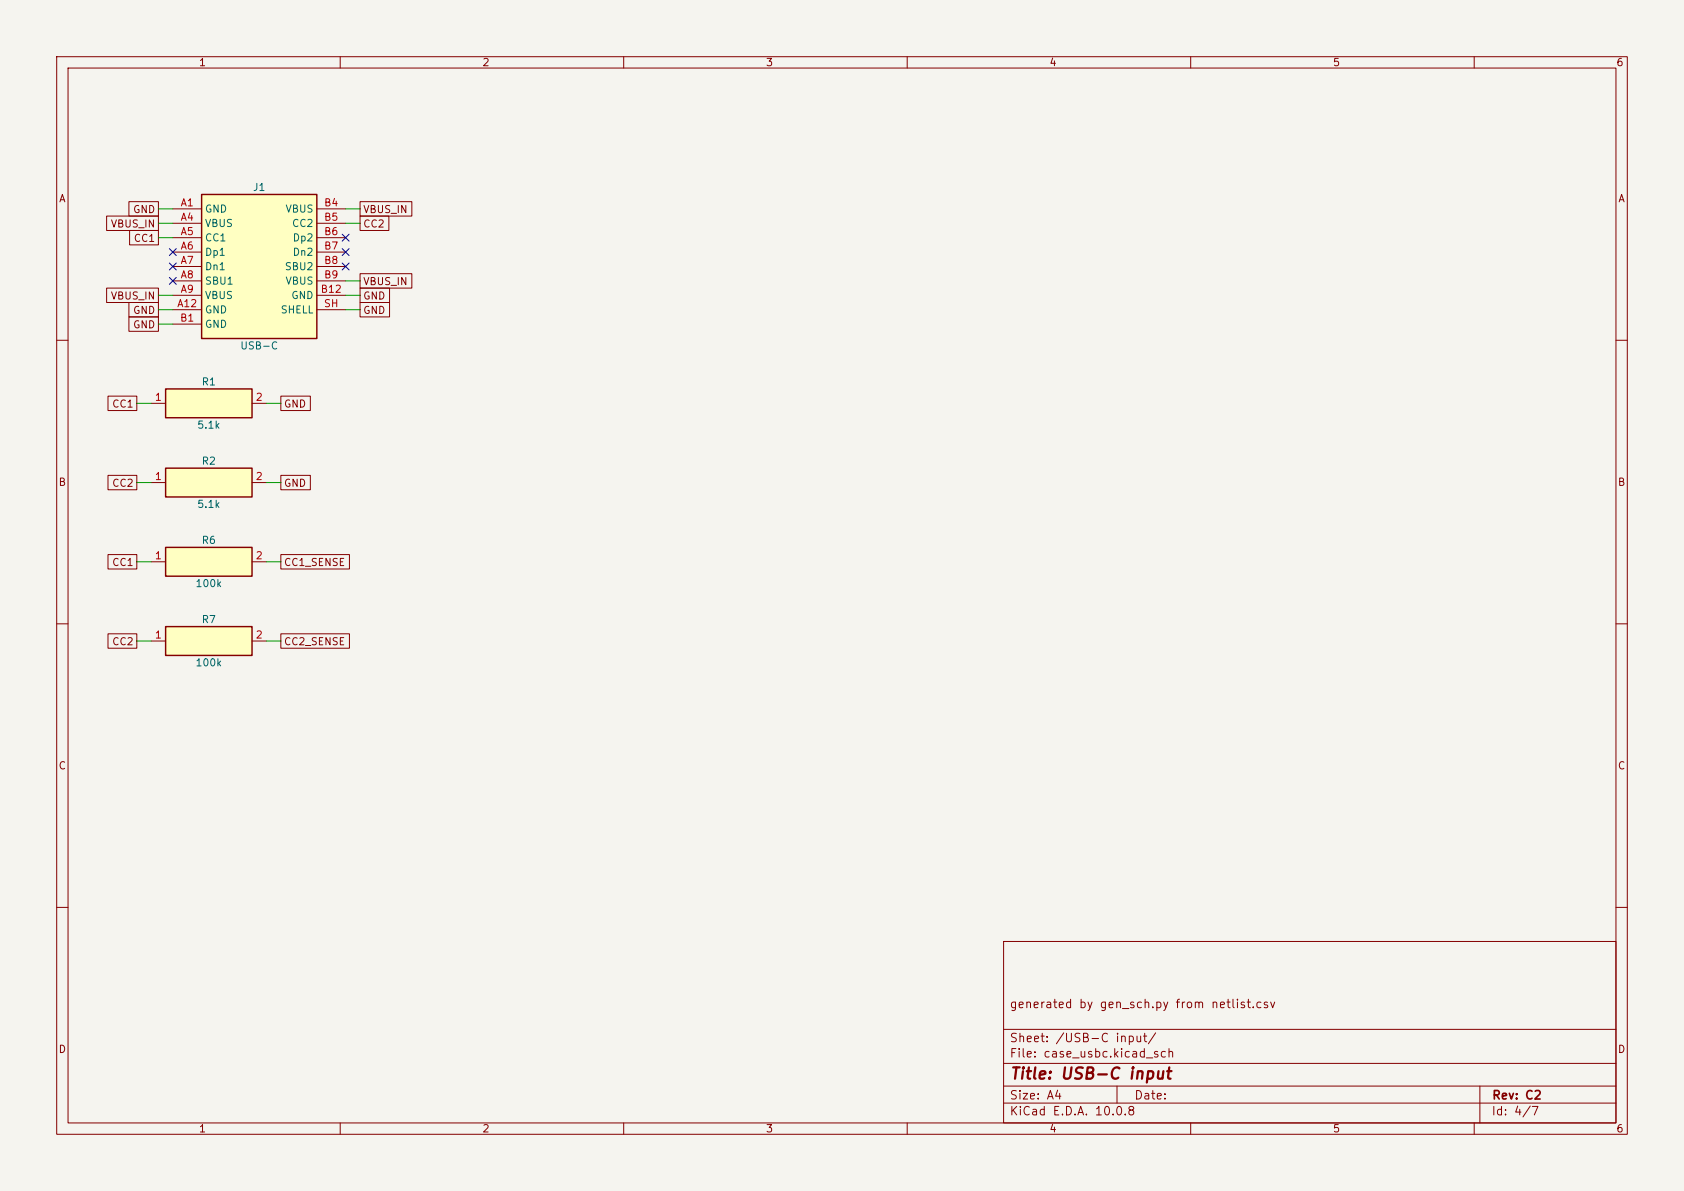
[picture p249: page 4]

generated by gen_sch.py from netlist.csv

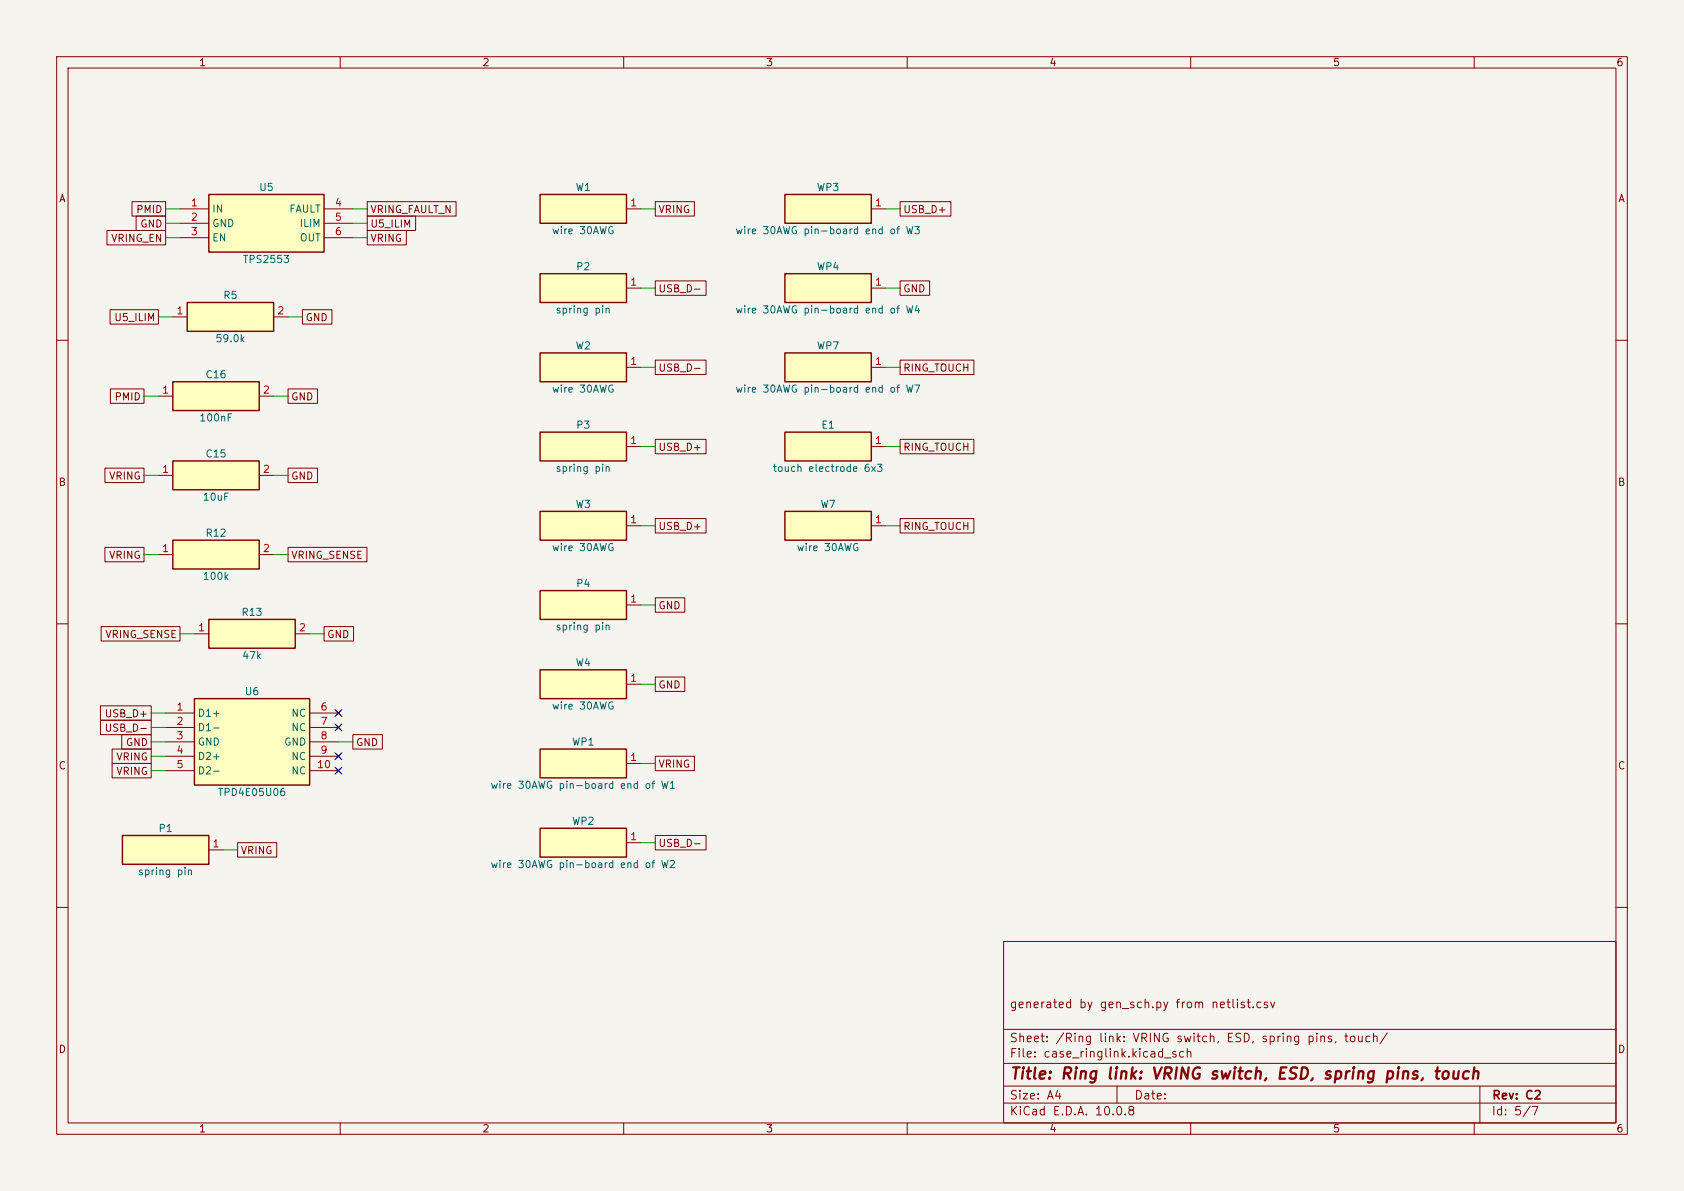
[picture p250: page 5]

1 WP3 wire 30AWG pin-board end of W3
VRING USB_D-

1 WP4 wire 30AWG pin-board end of W4

1 WP7 wire 30AWG pin-board end of W7

generated by gen_sch.py from netlist.csv 1 WP1 wire 30AWG pin-board end of W1

1 WP2 wire 30AWG pin-board end of W2

Sheet: /Ring link: VRING switch, ESD, spring pins, touch/
File: case_ringlink.kicad_sch
Title: Ring link: VRING switch, ESD, spring pins, touch

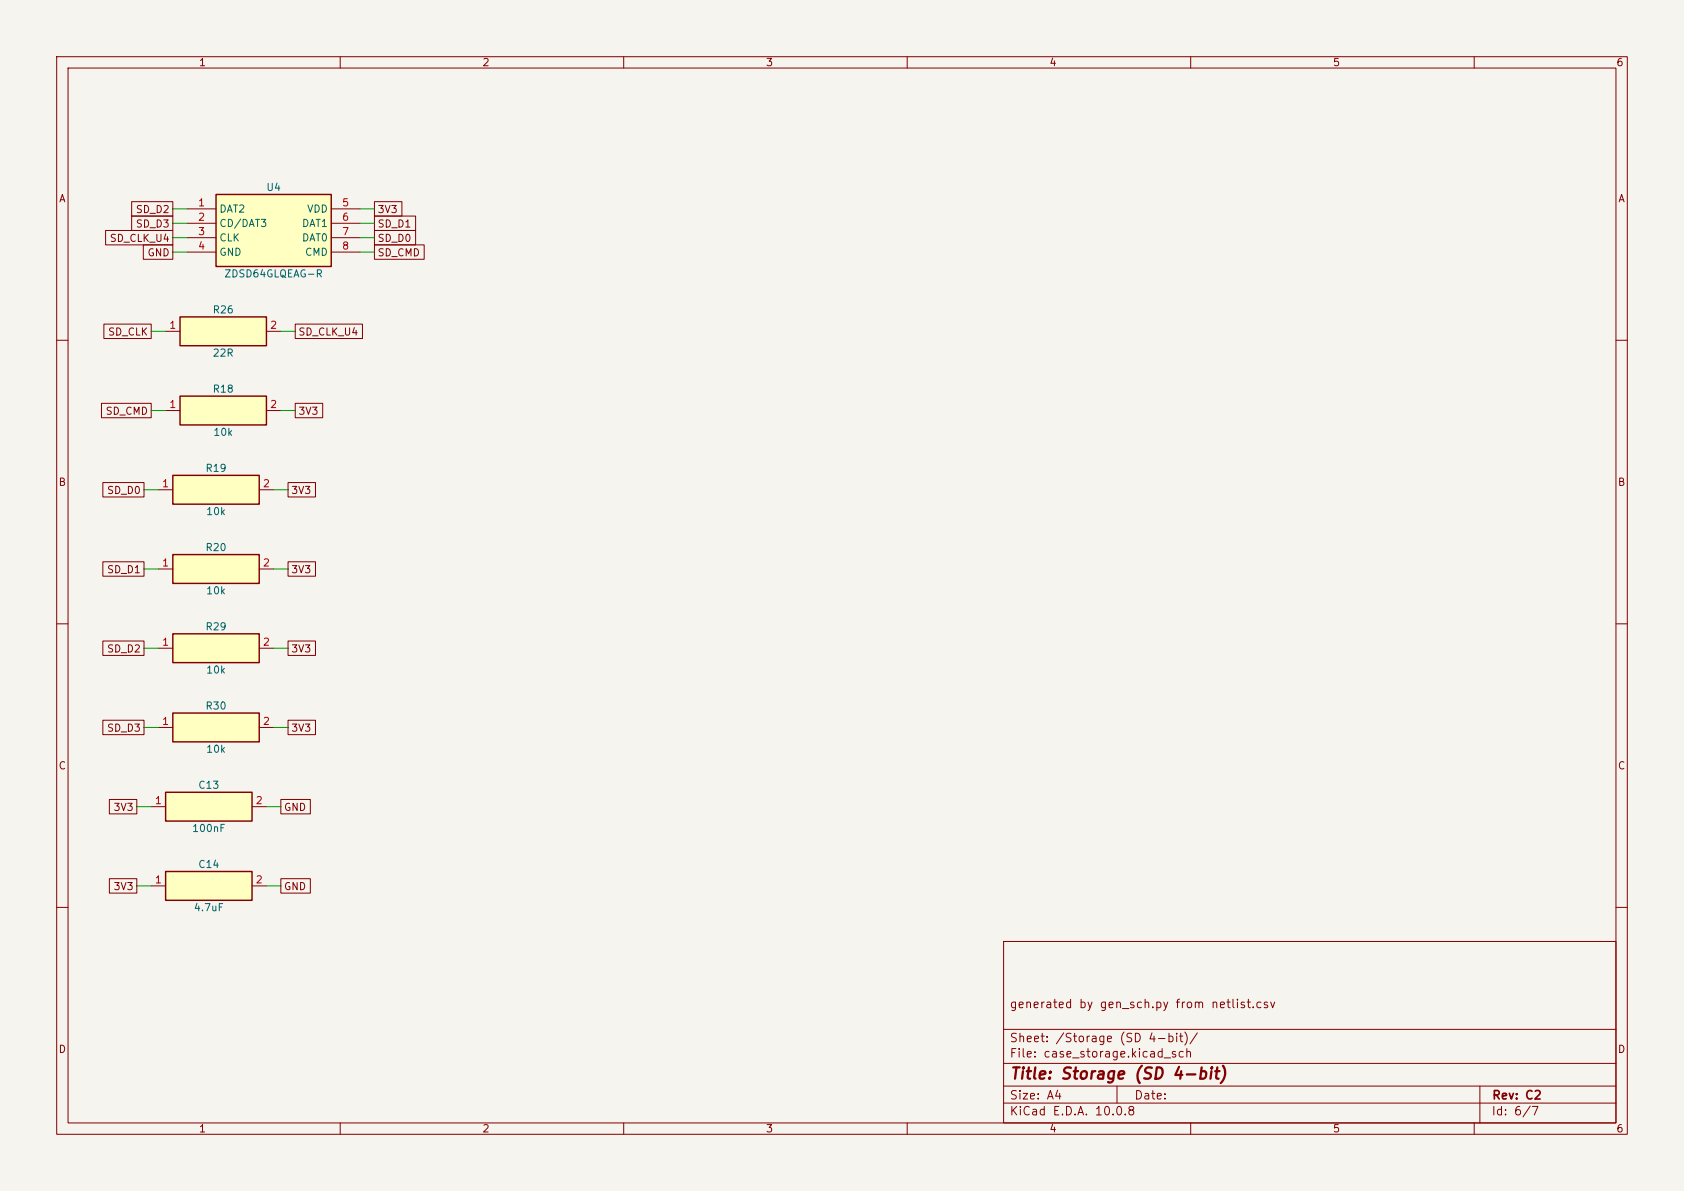
[picture p251: page 6]

Sheet: /Storage (SD 4-bit)/
File: case_storage.kicad_sch
Title: Storage (SD 4-bit)

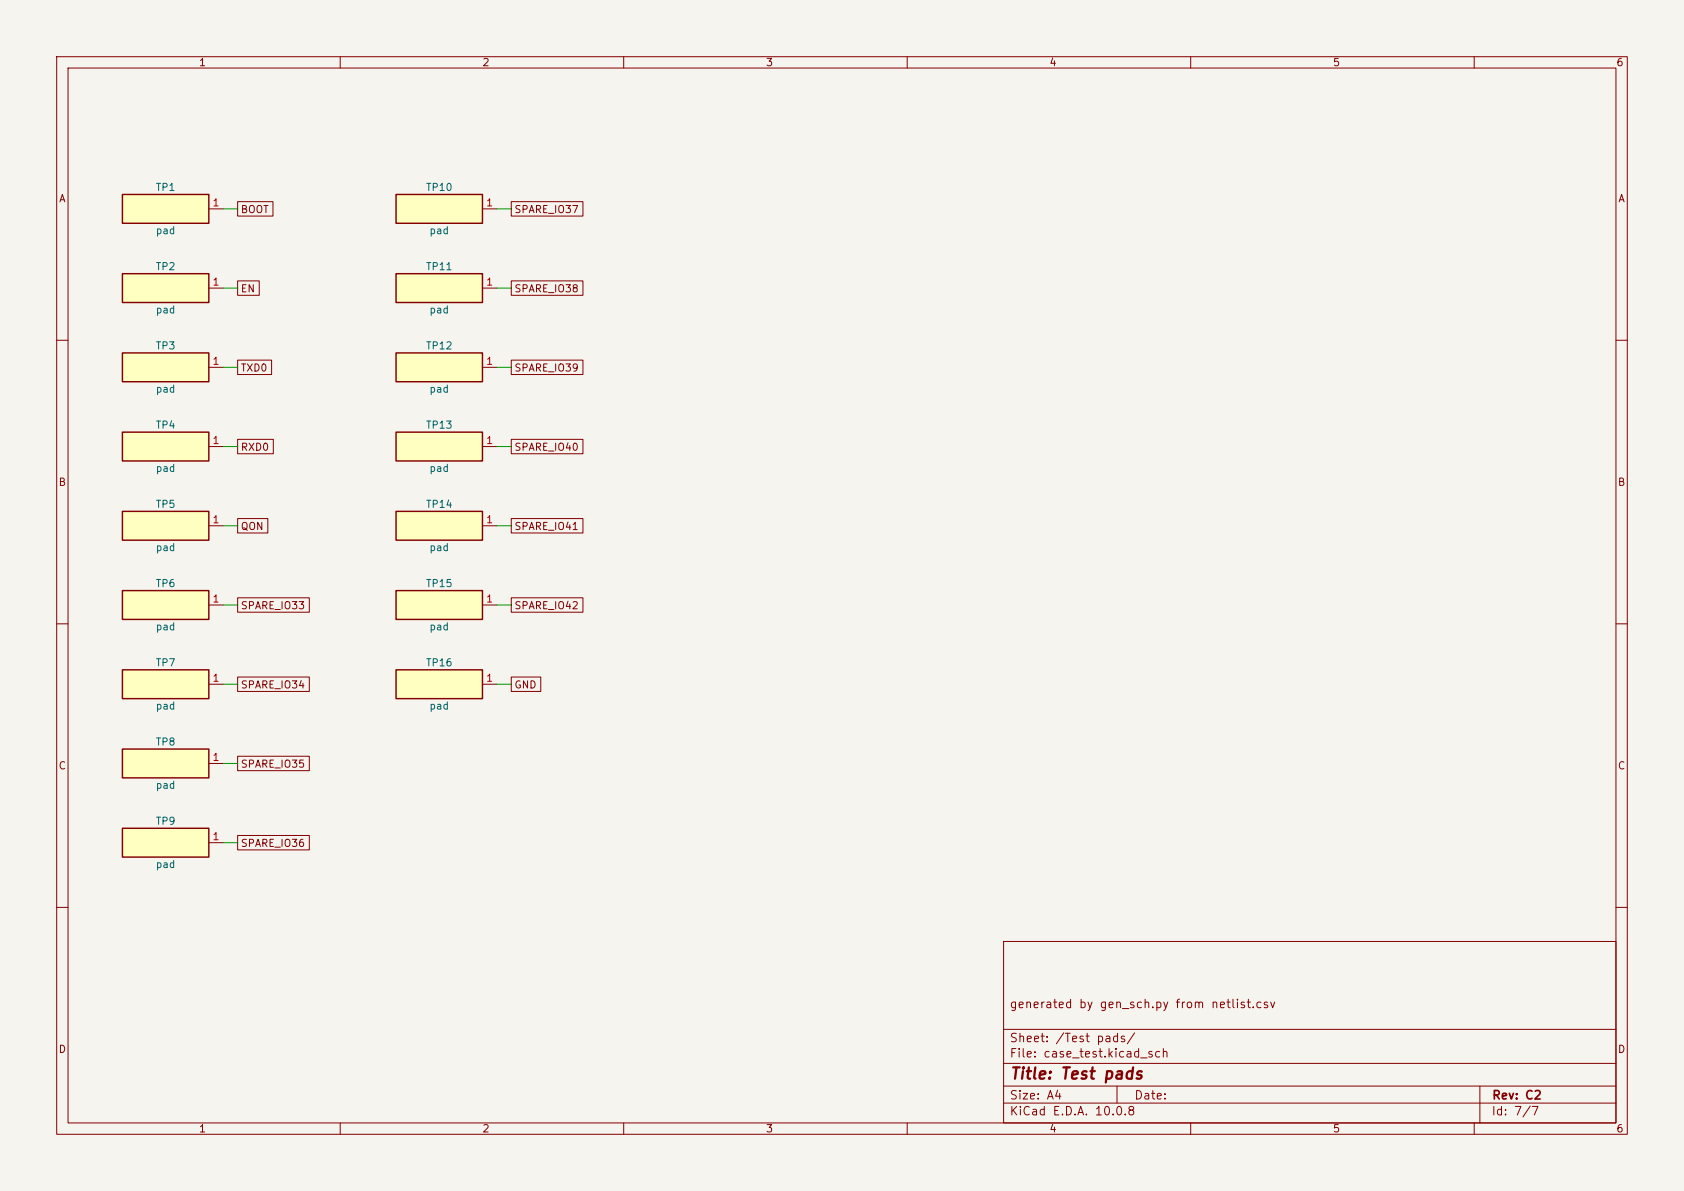
[picture p252: page 7]

generated by gen_sch.py from netlist.csv 1
