NexusGPT/openring/design/ecad/ring/ring-schematic.pdf

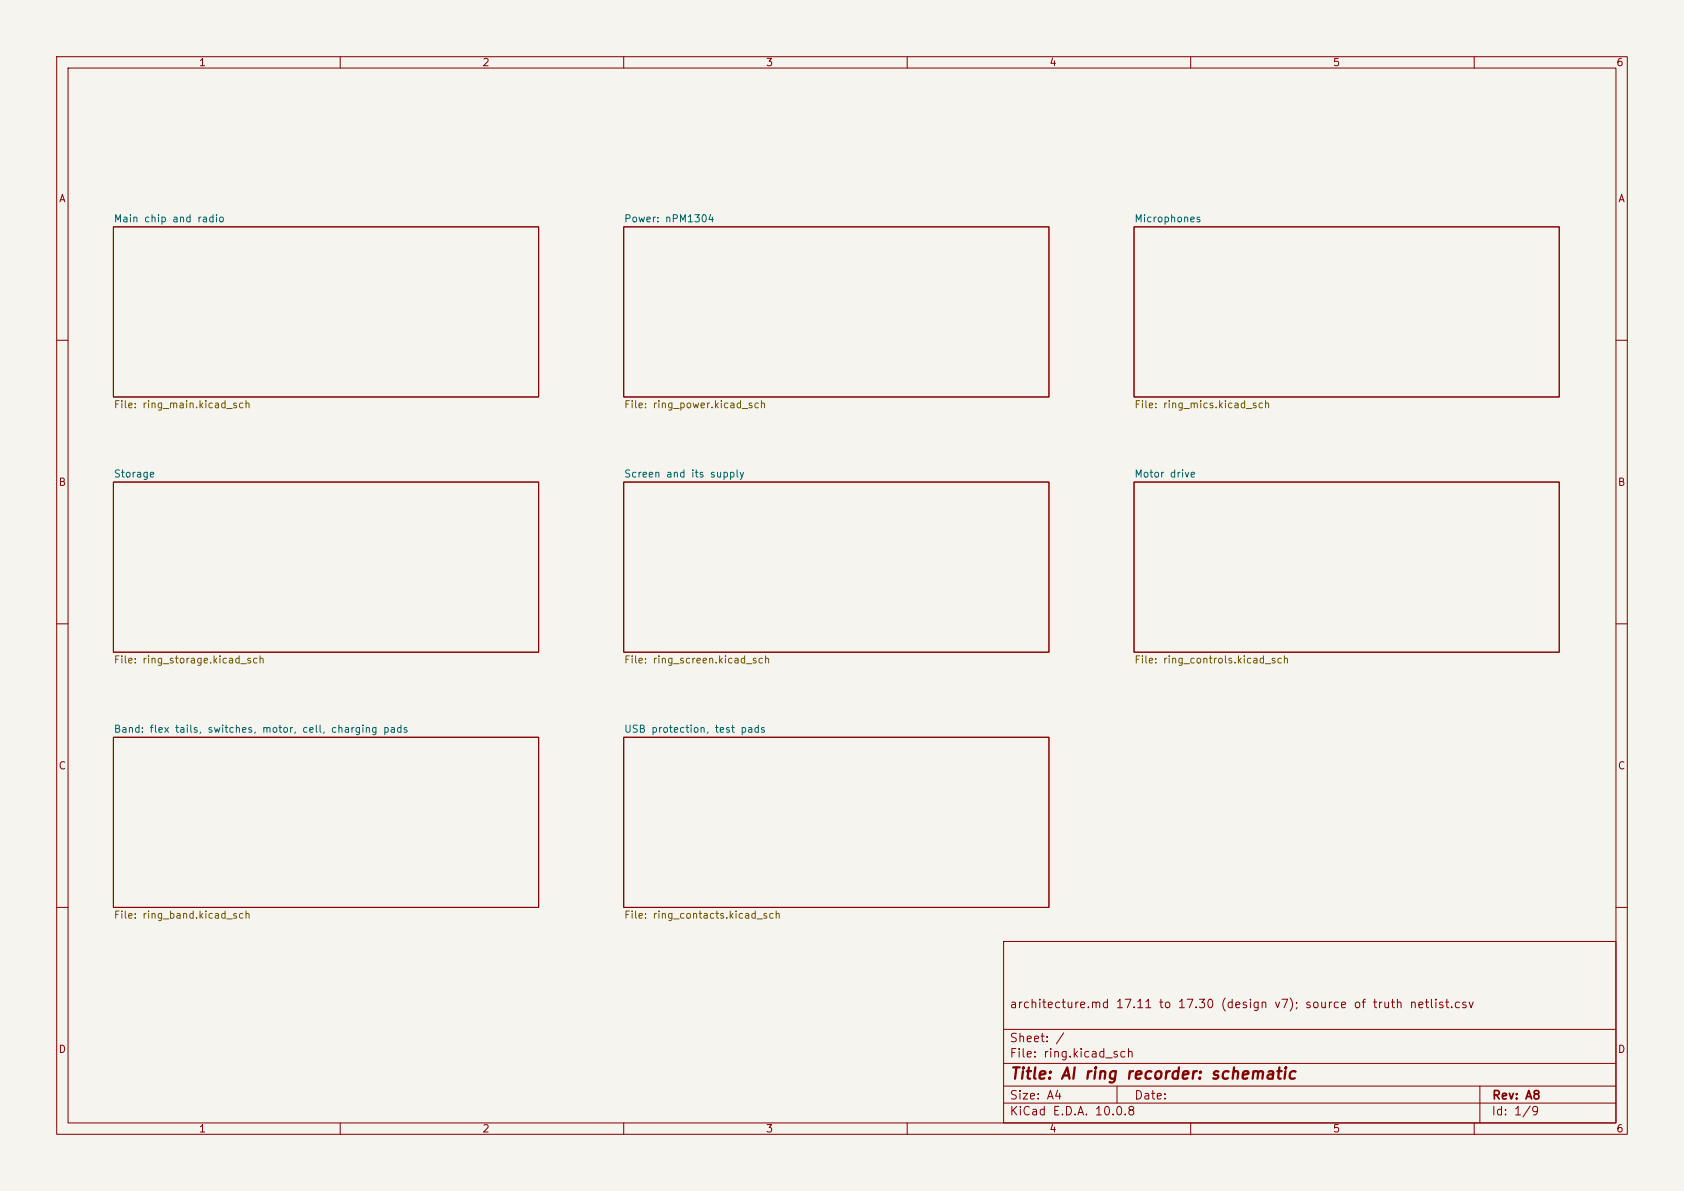
[picture p253: page 1]

Main chip and radio

architecture.md 17.11 to 17.30 (design v7); source of truth netlist.csv

Sheet: /
File: ring.kicad_sch
Title: AI ring recorder: schematic

Size: A4 | Rev: A8
KiCad E.D.A. 10.0.8 | Id: 1/9

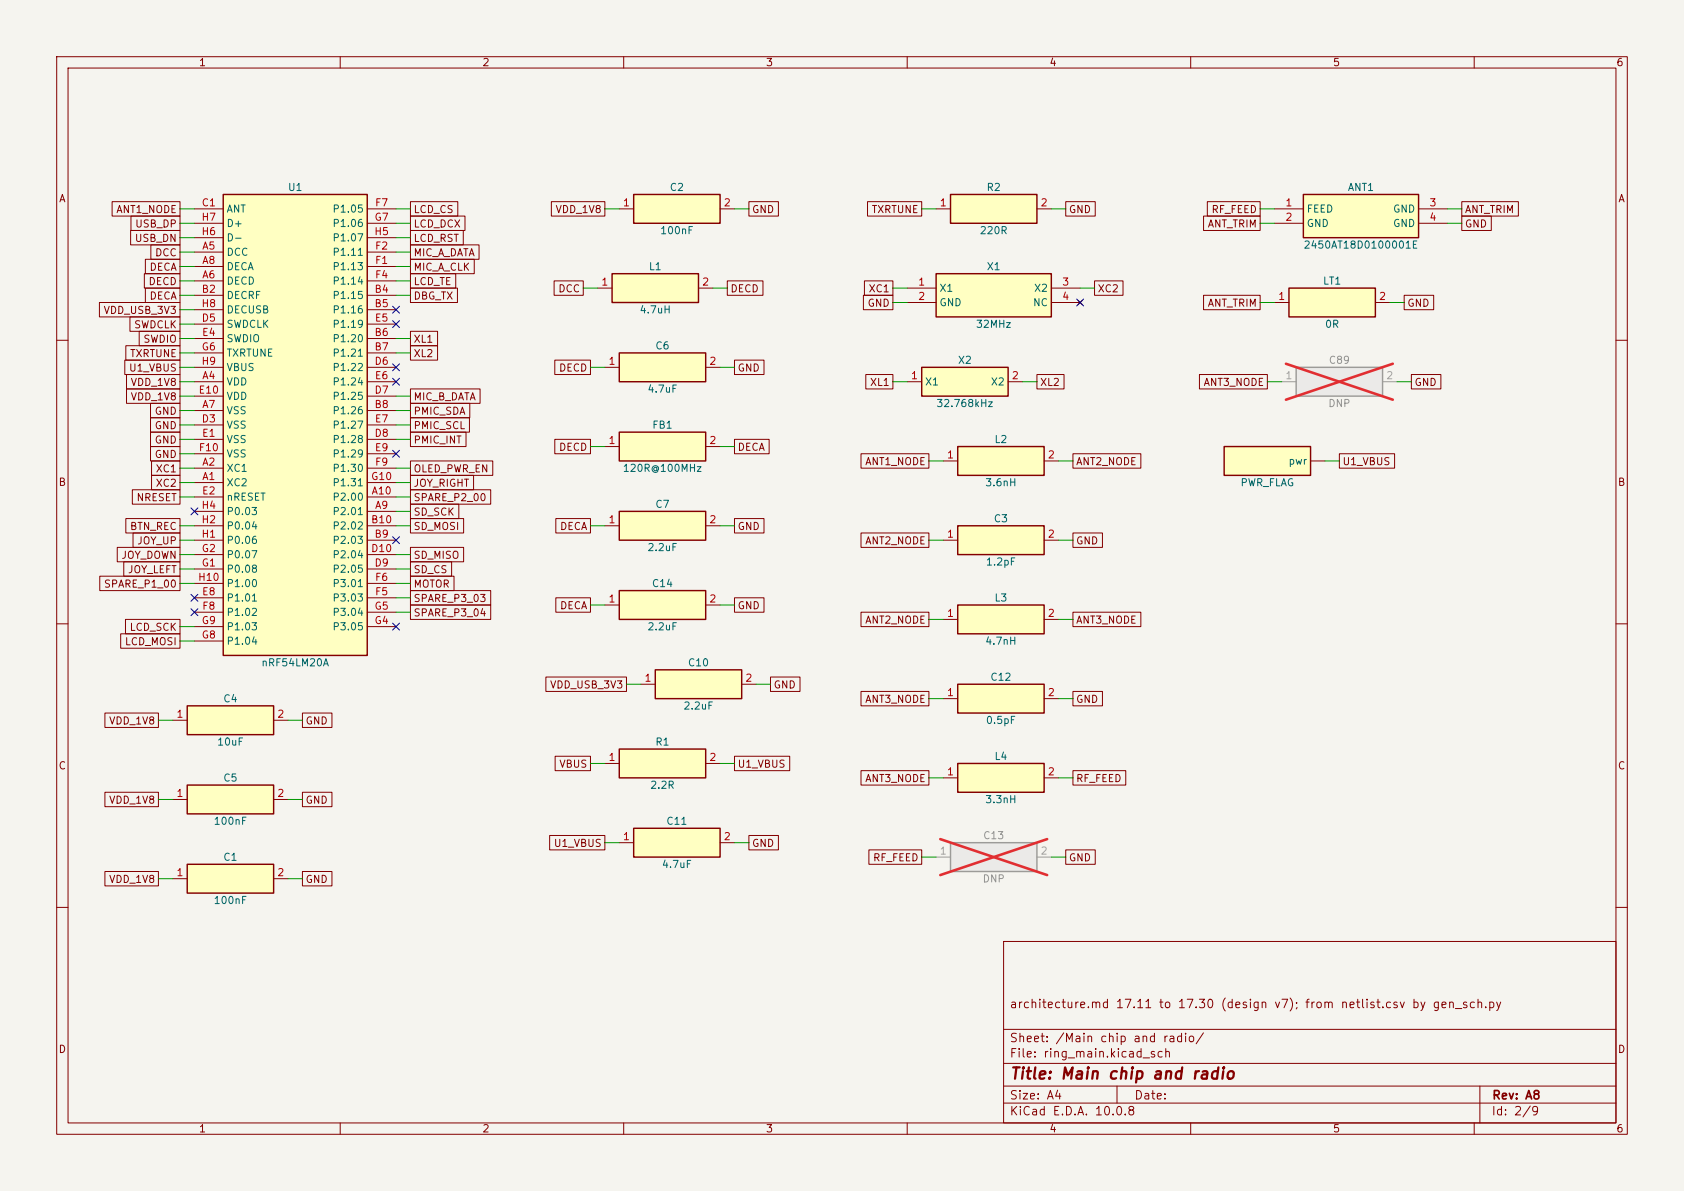
[picture p254: page 2]

Sheet: /Main chip and radio/
File: ring_main.kicad_sch
Title: Main chip and radio

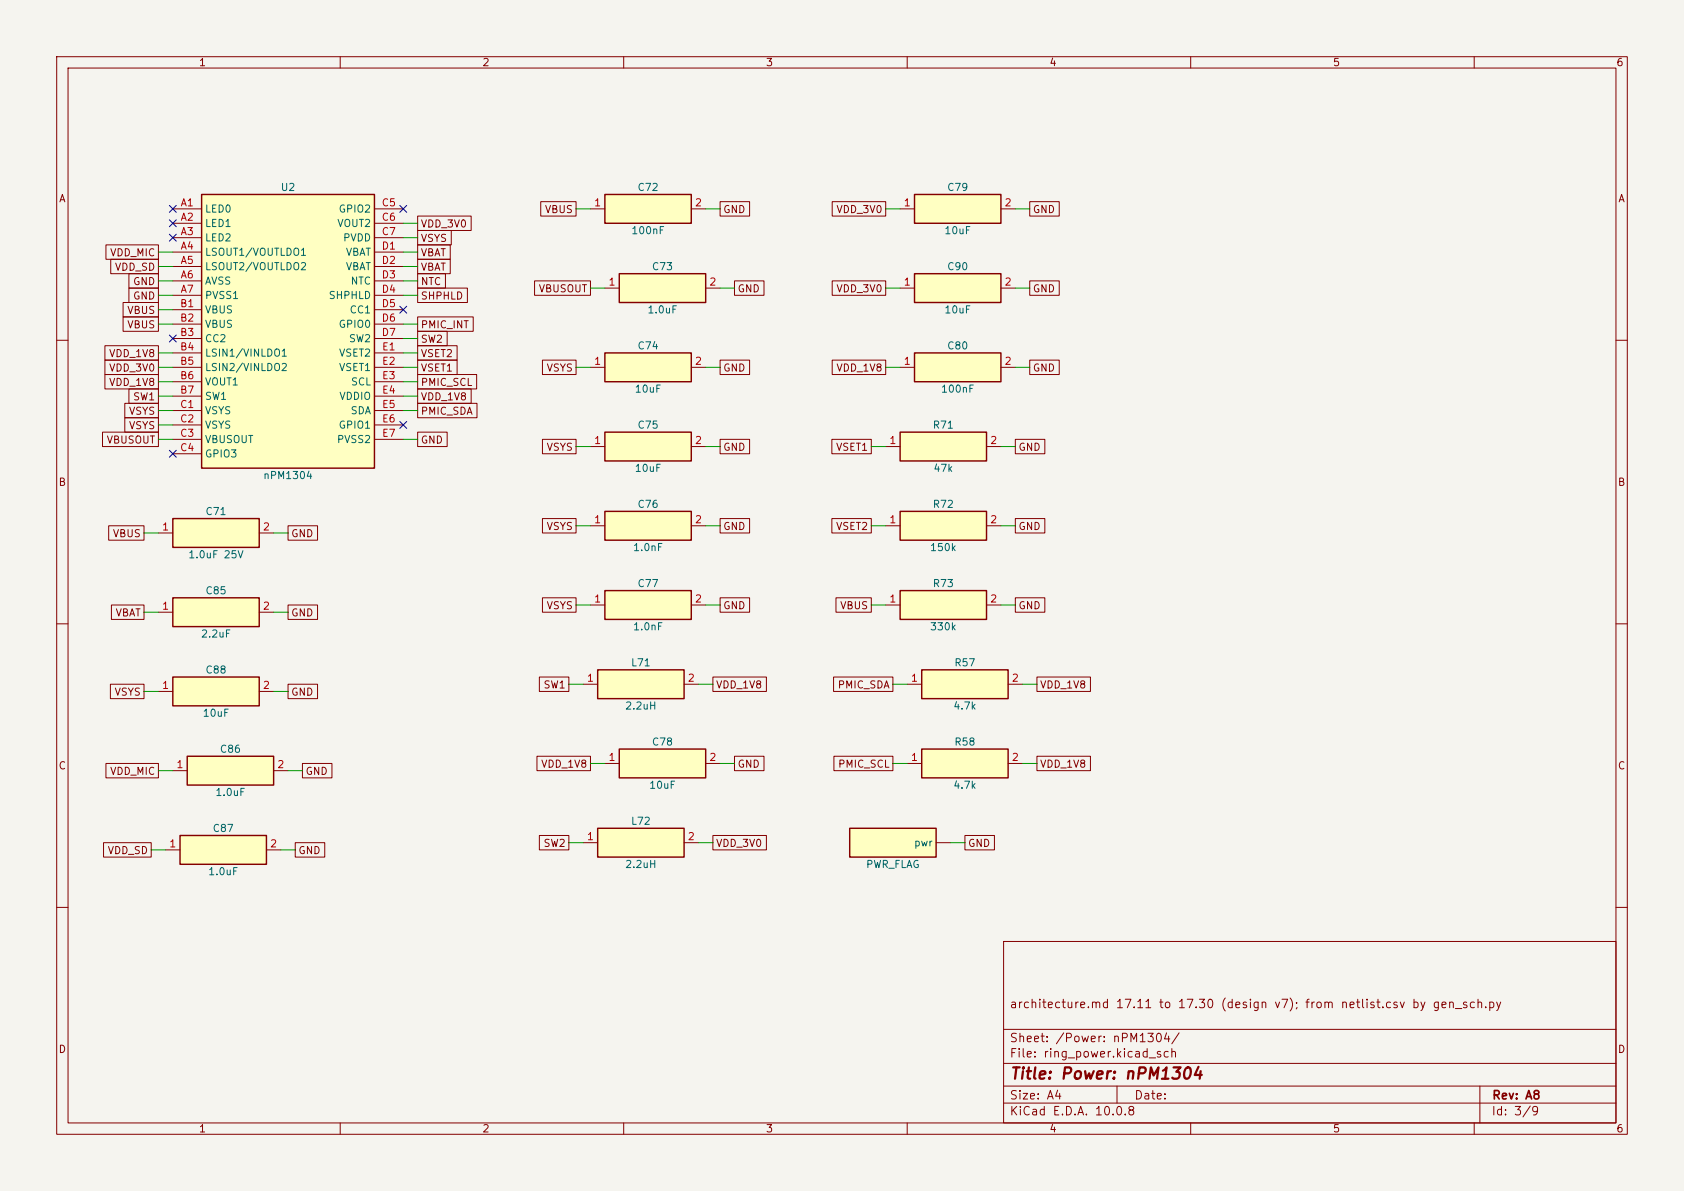
[picture p255: page 3]

architecture.md 17.11 to 17.30 (design v7); from netlist.csv by gen_sch.py pwr PWR_FLAG

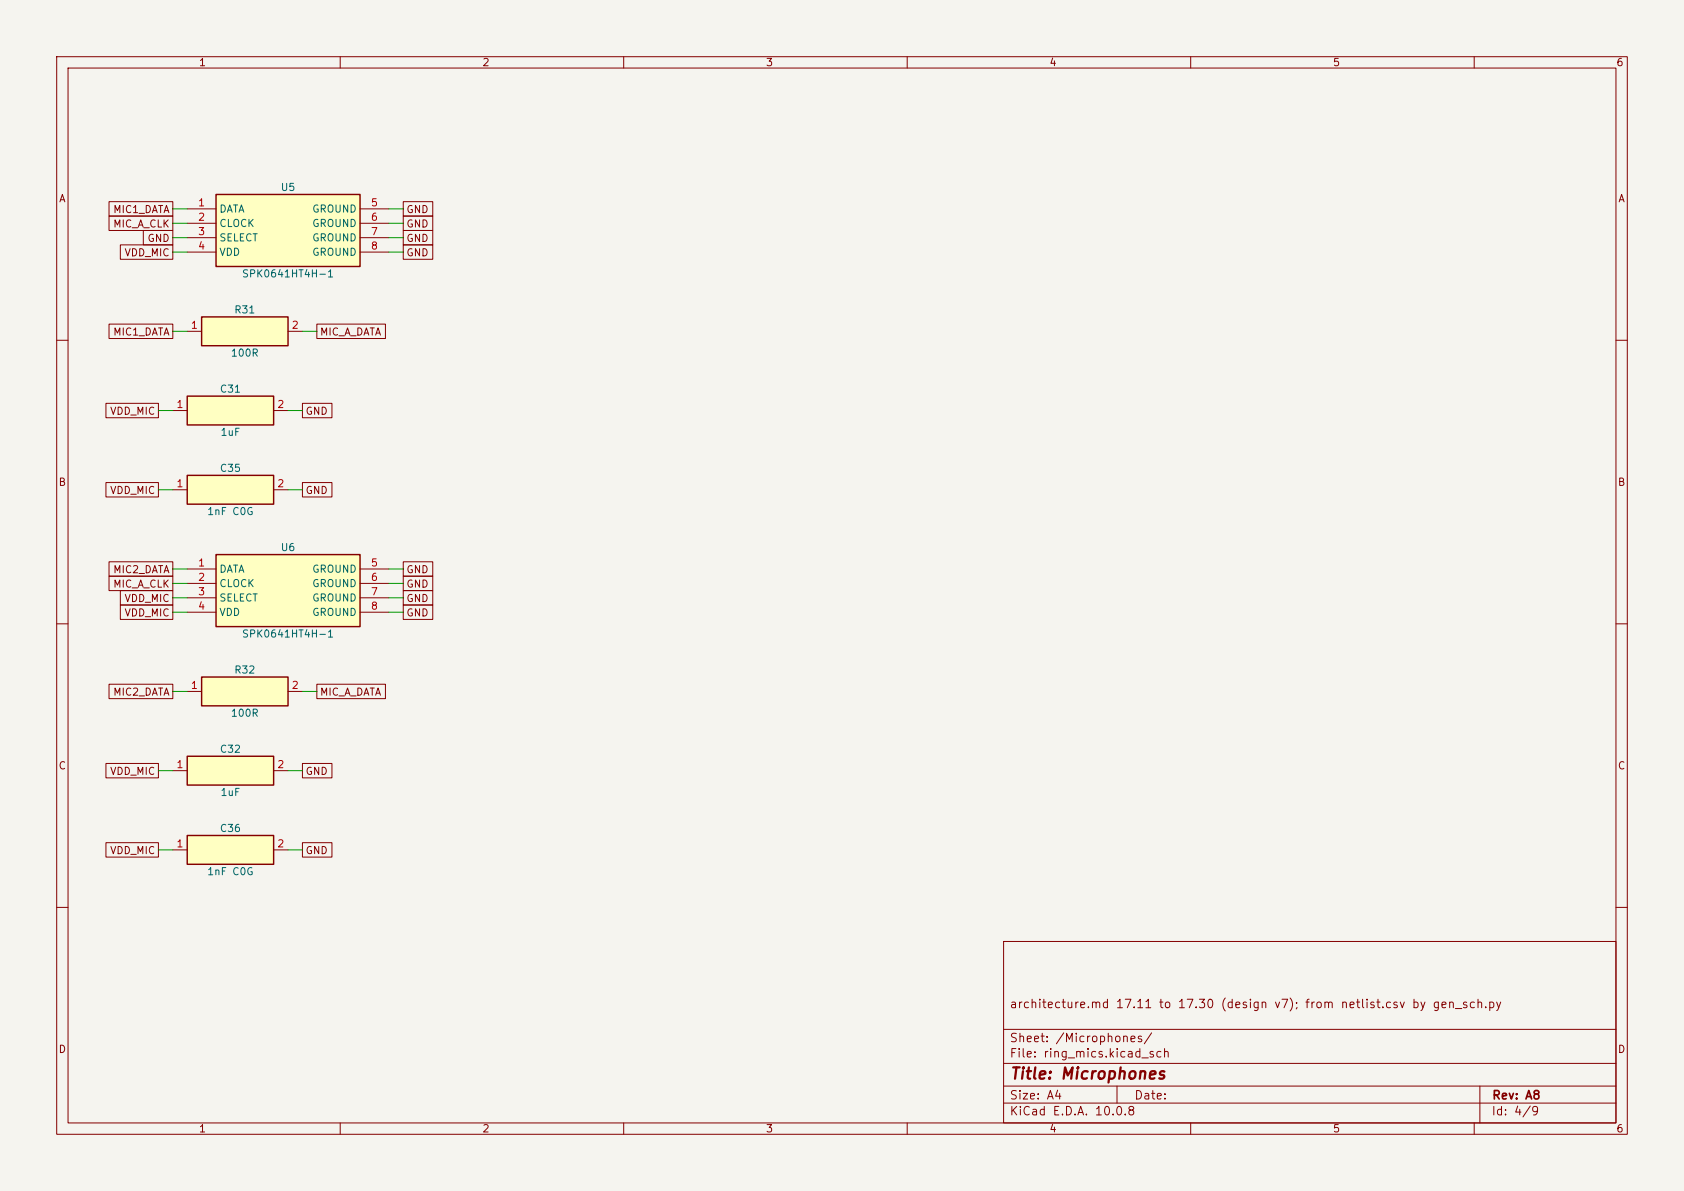
[picture p256: page 4]

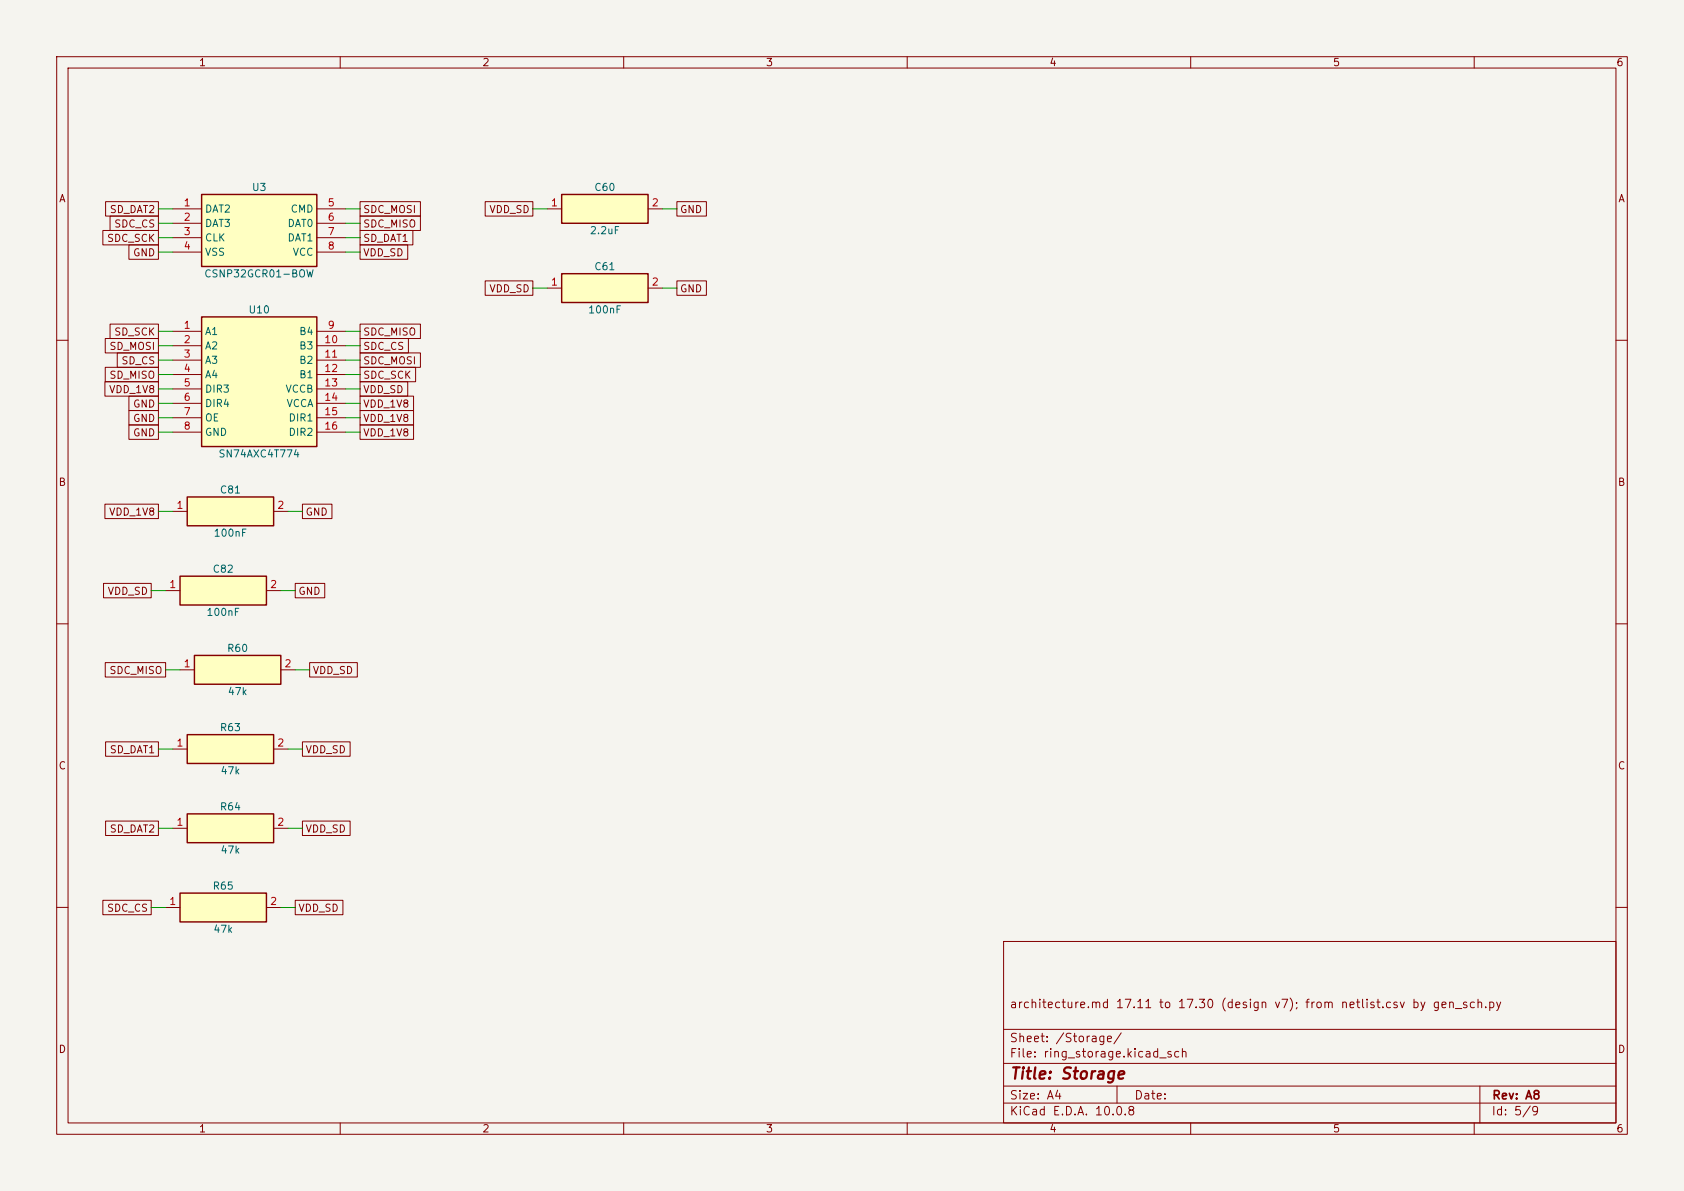
[picture p257: page 5]

architecture.md 17.11 to 17.30 (design v7); from netlist.csv by gen_sch.py

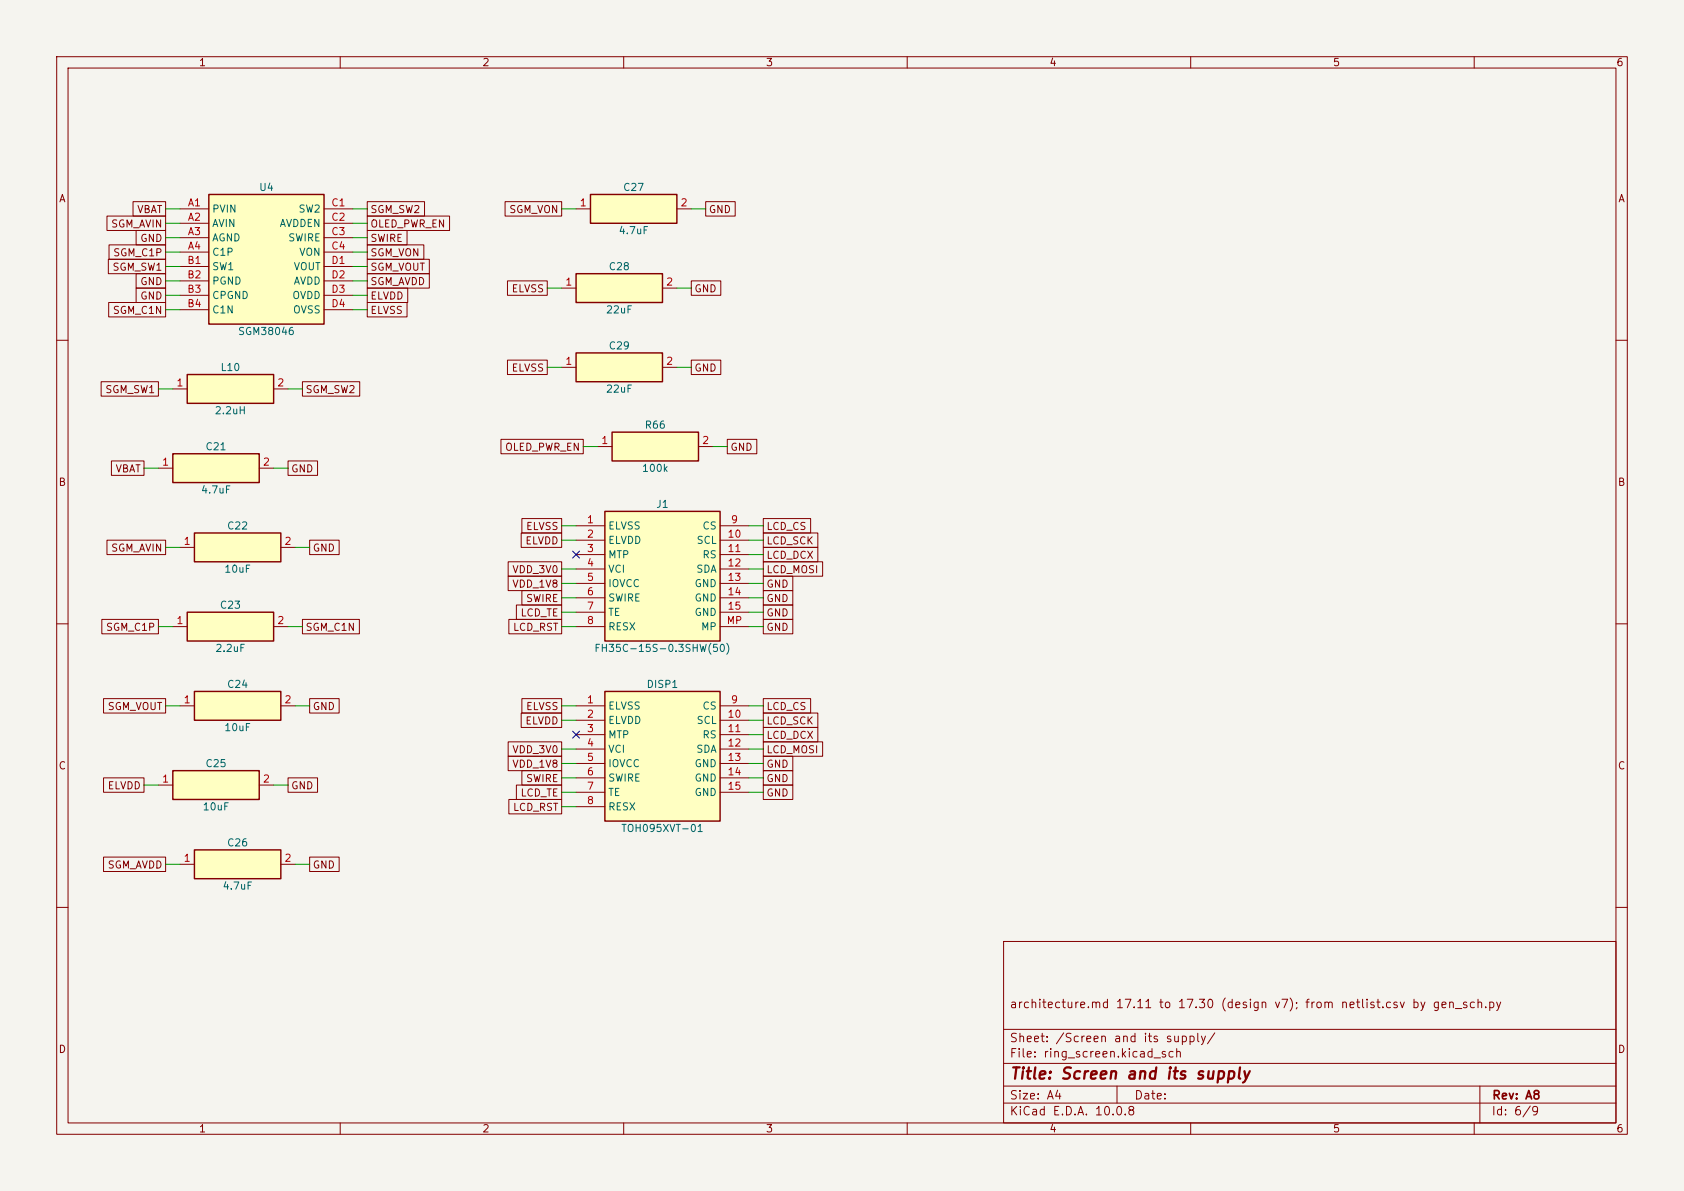
[picture p258: page 6]

Sheet: /Screen and its supply/
File: ring_screen.kicad_sch
Title: Screen and its supply

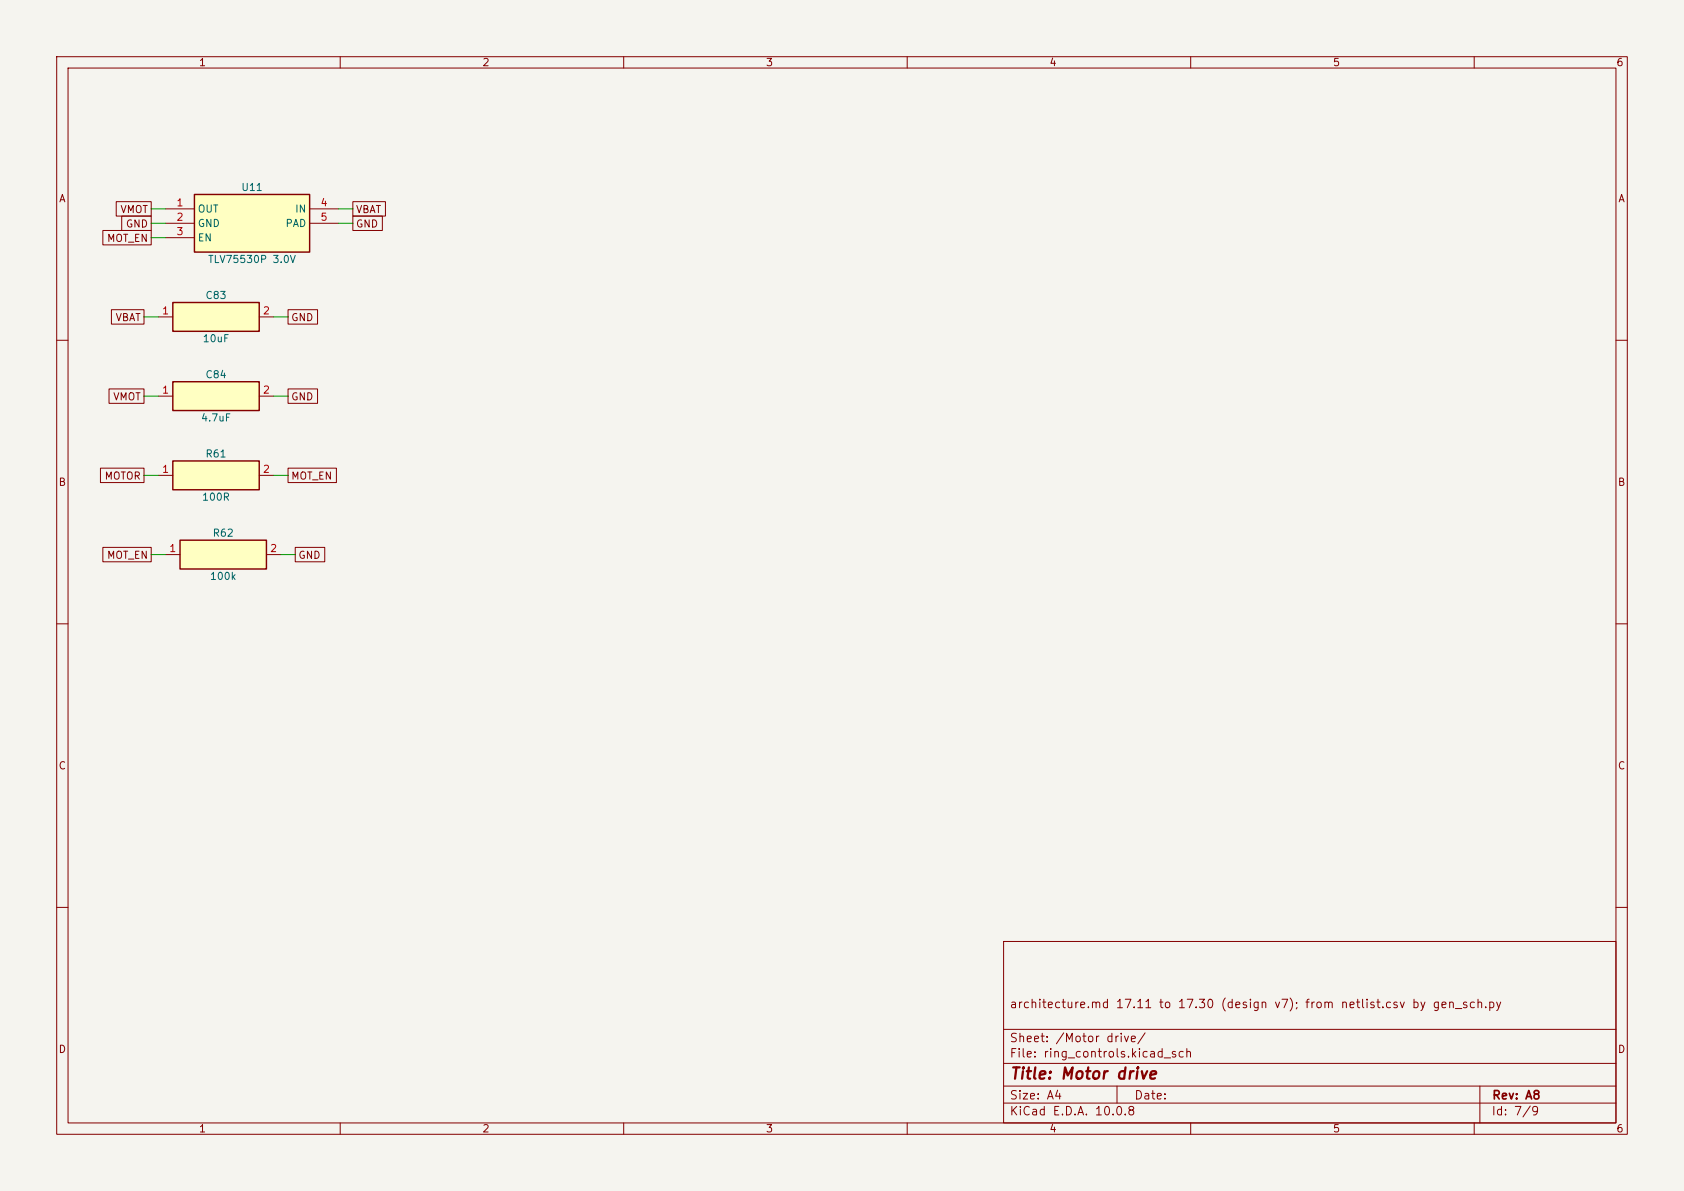
[picture p259: page 7]

architecture.md 17.11 to 17.30 (design v7); from netlist.csv by gen_sch.py

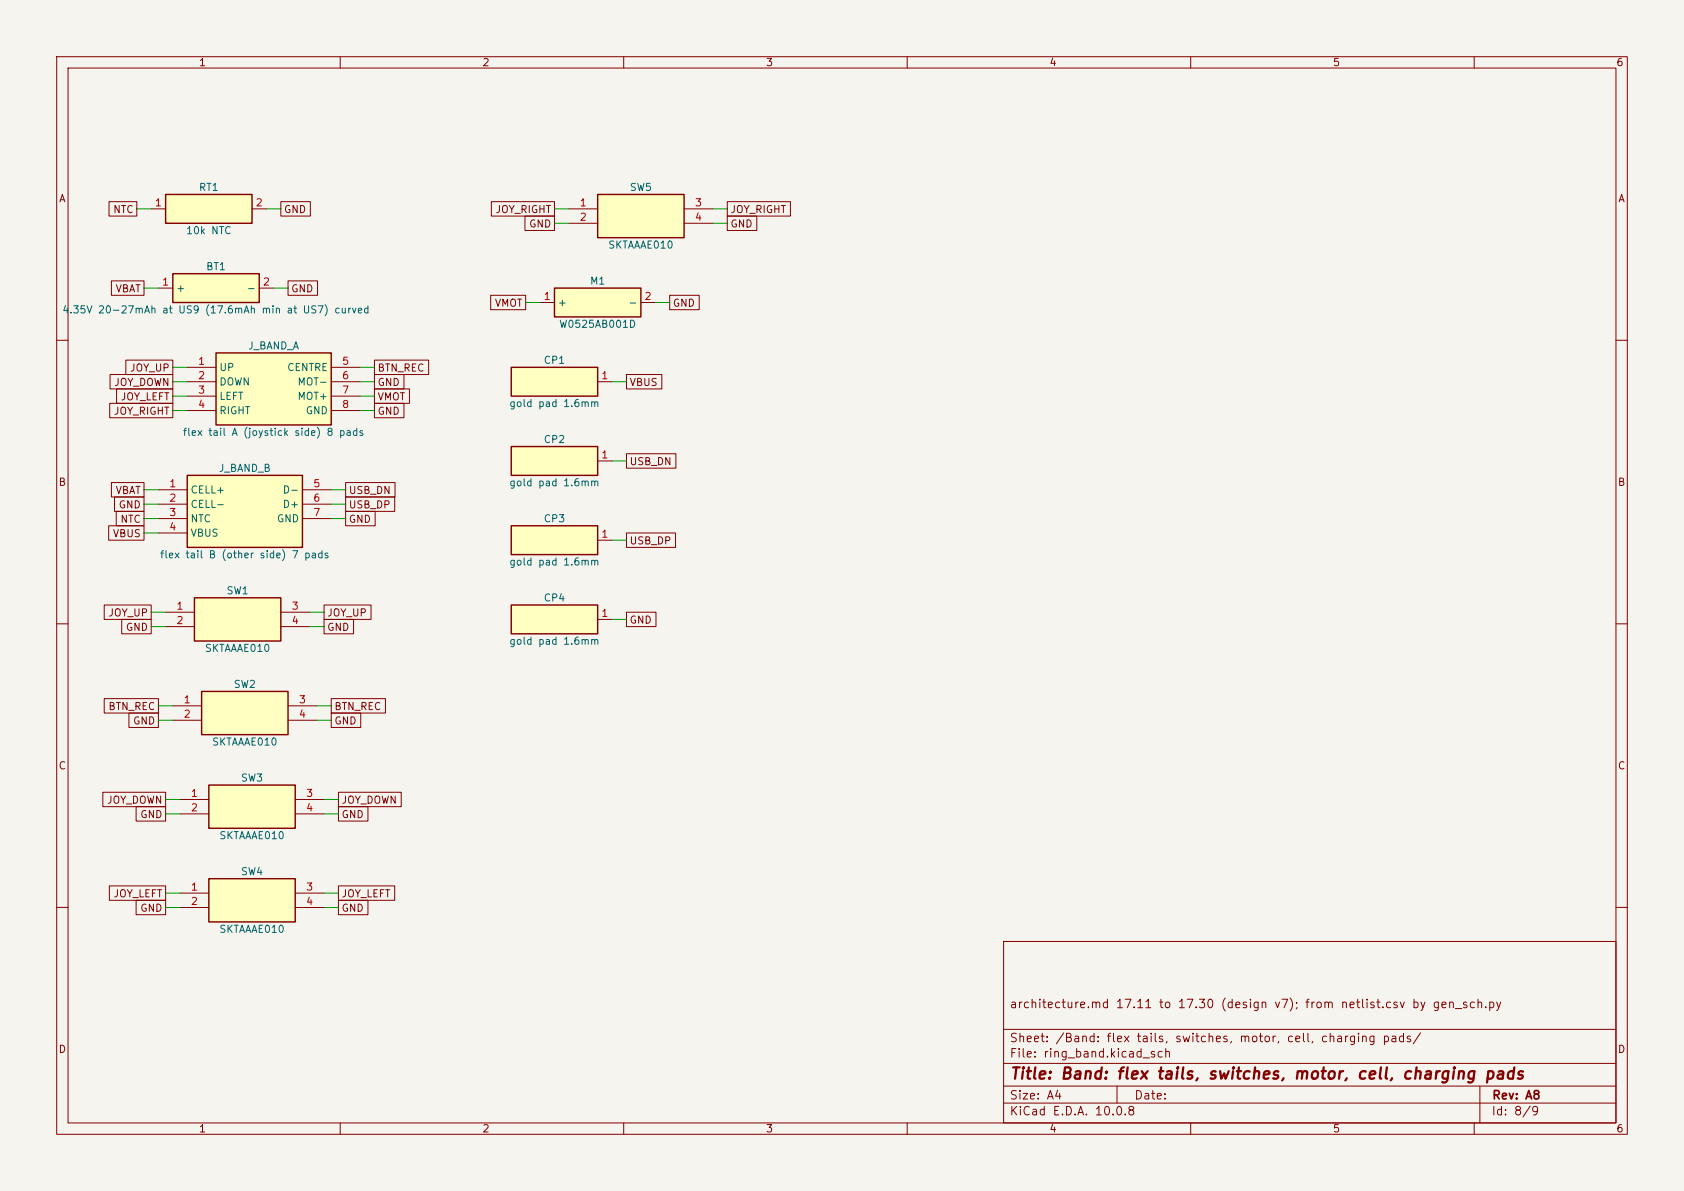
[picture p260: page 8]

flex tail B (other side) 7 pads 1

architecture.md 17.11 to 17.30 (design v7); from netlist.csv by gen_sch.py 1

Sheet: /Band: flex tails, switches, motor, cell, charging pads/
File: ring_band.kicad_sch
Title: Band: flex tails, switches, motor, cell, charging pads

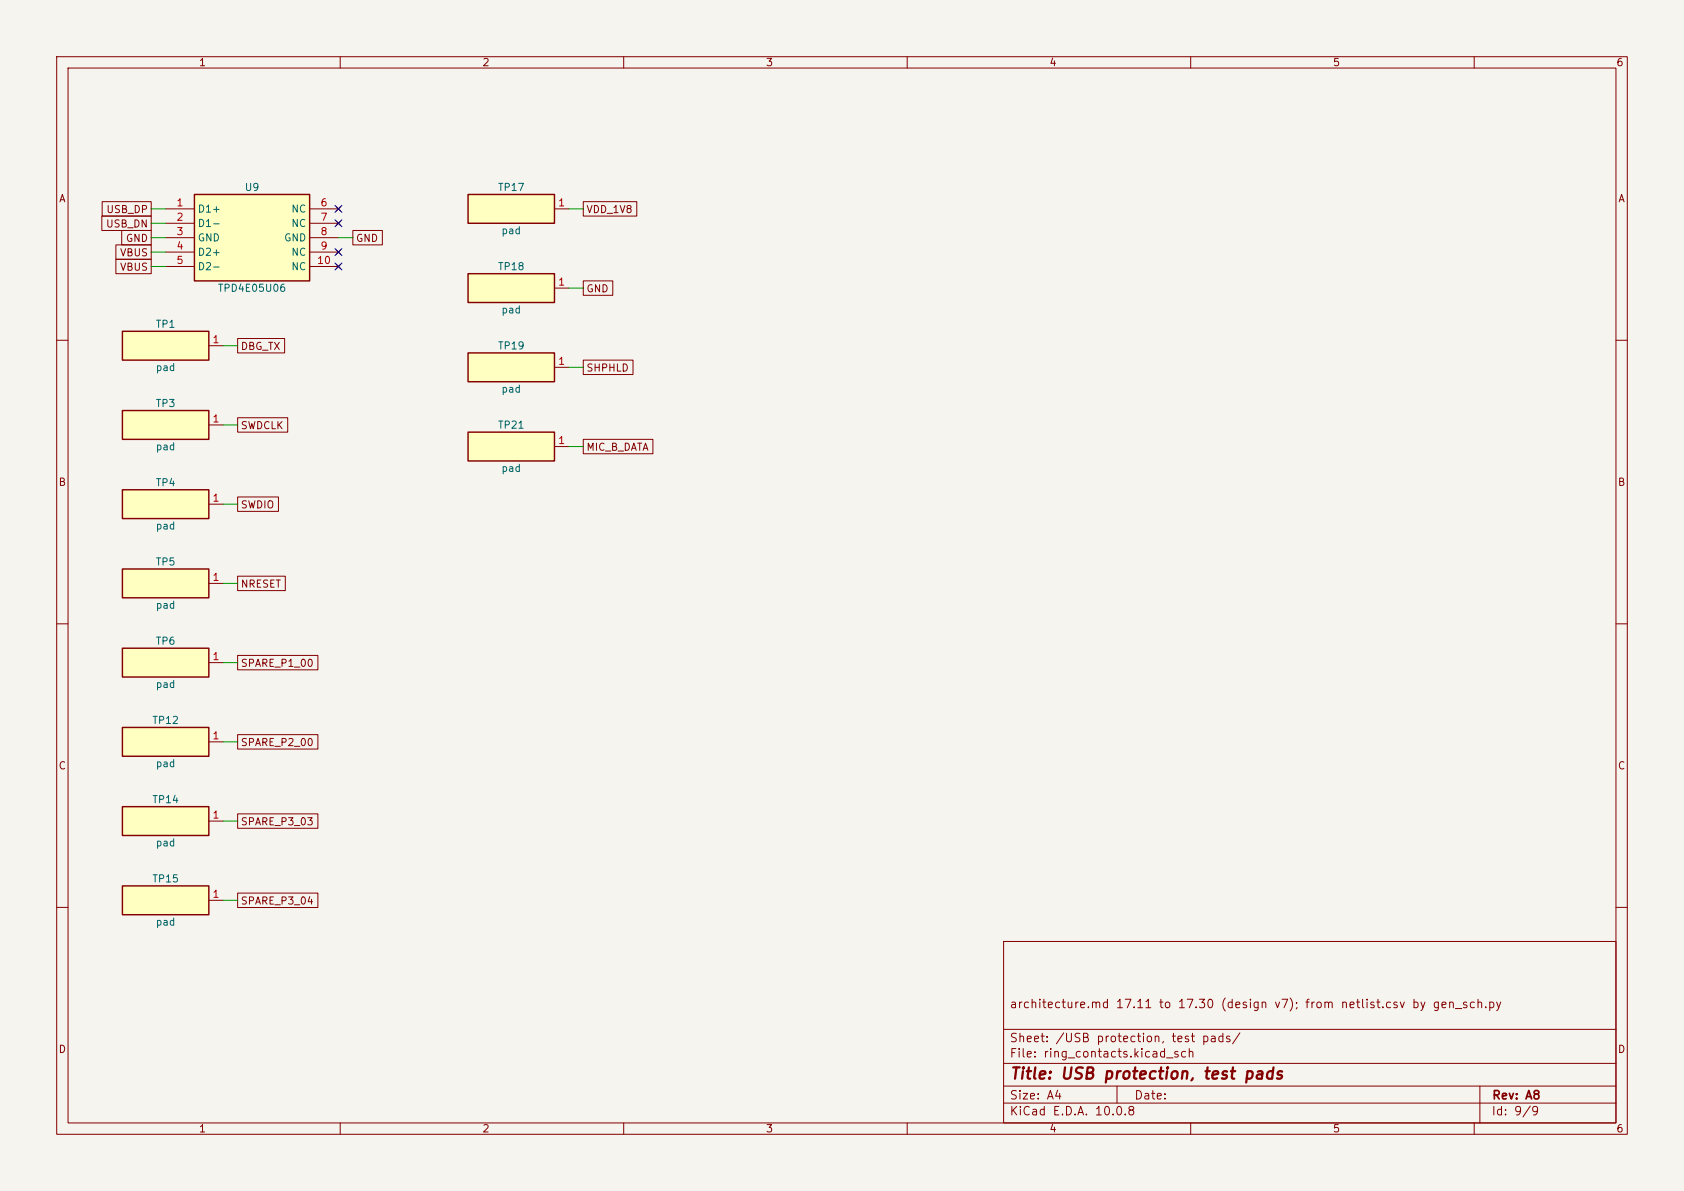
[picture p261: page 9]

architecture.md 17.11 to 17.30 (design v7); from netlist.csv by gen_sch.py

Sheet: /USB protection, test pads/
File: ring_contacts.kicad_sch
Title: USB protection, test pads
