NexusGPT/openring/design/mfg/drawings/band-liner-us10.pdf

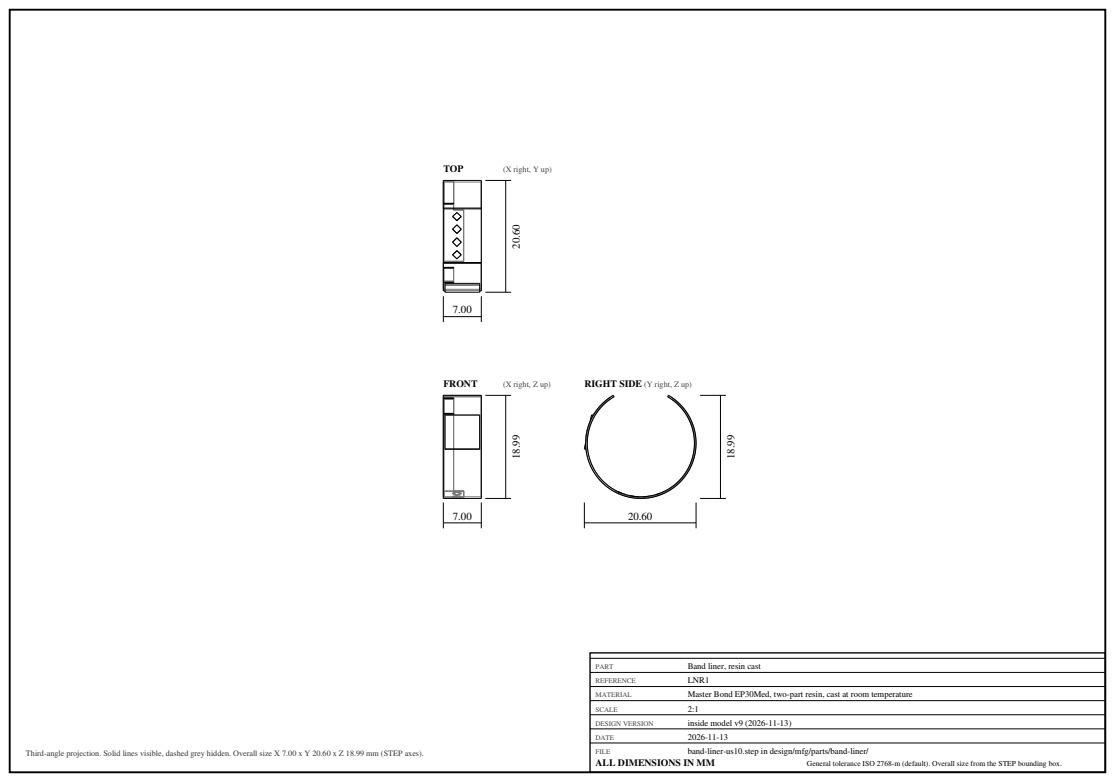
[picture p262: page 1]
TOP; (X right, Y up); FRONT; (X right, Z up); PART; Band liner, resin cast; REFERENCE; LNR1; MATERIAL; Master Bond EP30Med, two-part resin, cast at room temperature; SCALE; DESIGN VERSION; inside model v9 (2026-11-13); DATE; FILE; band-liner-us10.step in design/mfg/parts/band-liner/; ALL DIMENSIONS IN MM; General tolerance ISO 2768-m (default). Overall size from the STEP bounding box.

RIGHT SIDE (Y right, Z up)

Third-angle projection. Solid lines visible, dashed grey hidden. Overall size X 7.00 x Y 20.60 x Z 18.99 mm (STEP axes).
