NexusGPT/openring/design/mfg/drawings/cell-us10.pdf

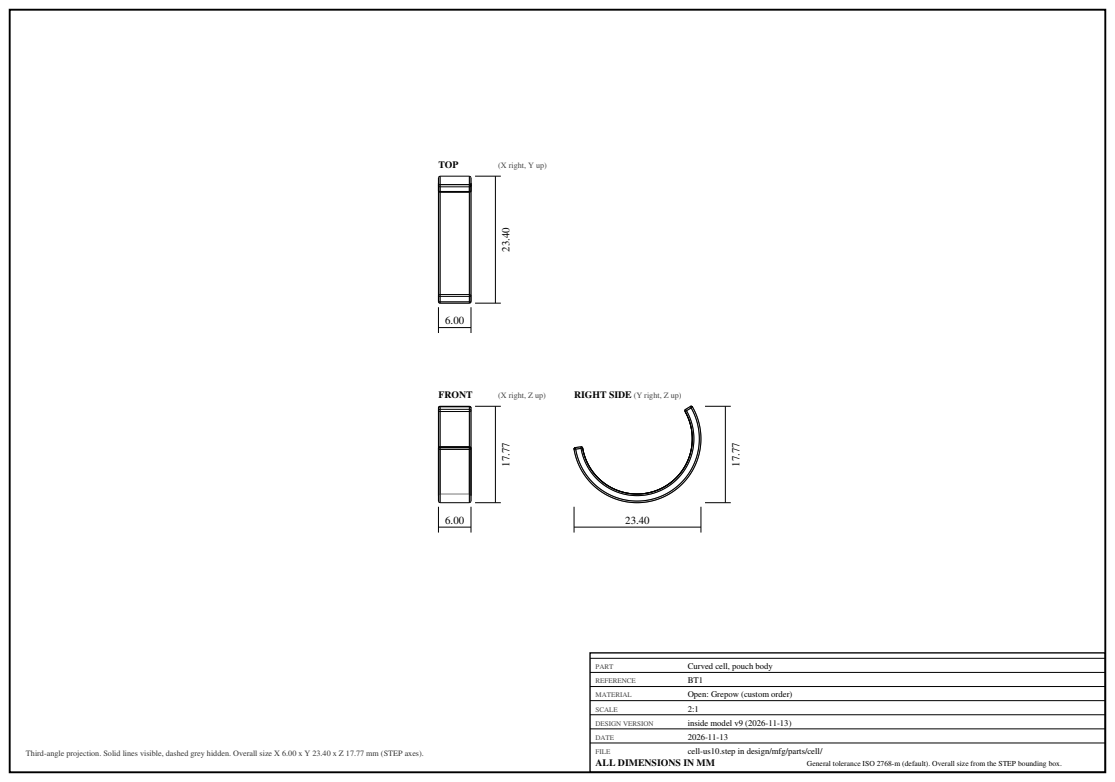
[picture p263: page 1]
TOP; (X right, Y up); FRONT; (X right, Z up); PART; Curved cell, pouch body; REFERENCE; MATERIAL; Open: Grepow (custom order); SCALE; DESIGN VERSION; inside model v9 (2026-11-13); DATE; FILE; cell-us10.step in design/mfg/parts/cell/; ALL DIMENSIONS IN MM; General tolerance ISO 2768-m (default). Overall size from the STEP bounding box.

RIGHT SIDE (Y right, Z up)

Third-angle projection. Solid lines visible, dashed grey hidden. Overall size X 6.00 x Y 23.40 x Z 17.77 mm (STEP axes).
