NexusGPT/openring/design/mfg/drawings/cover-glass.pdf

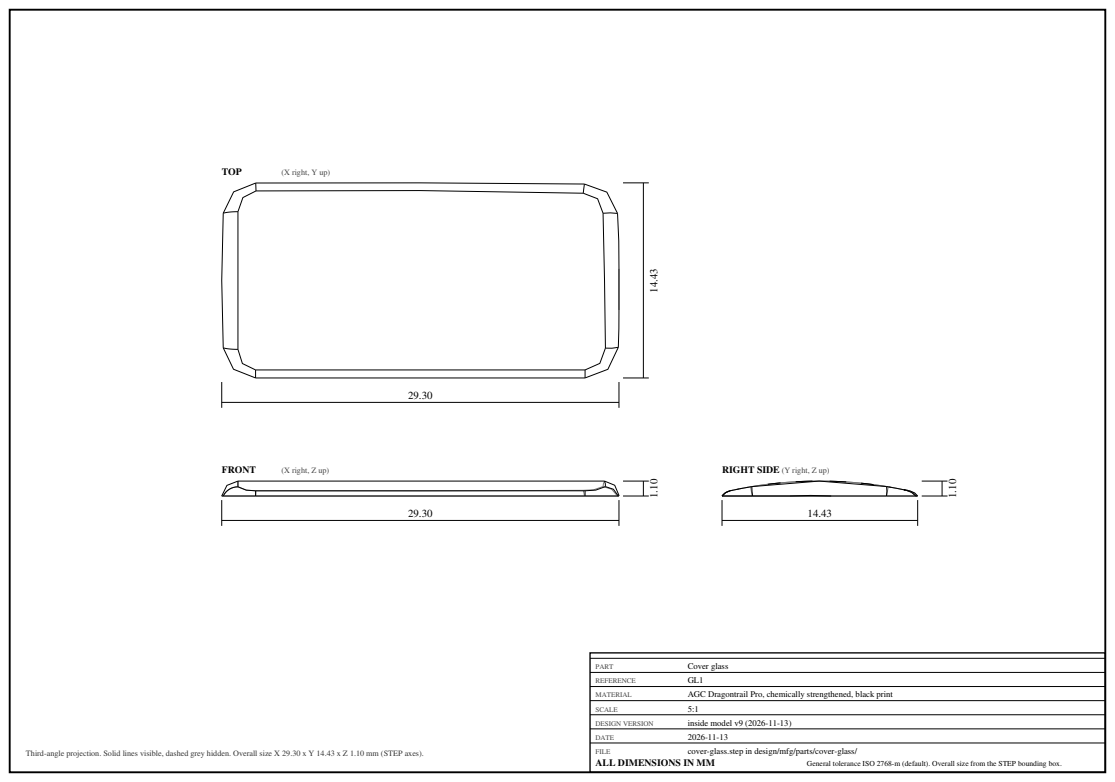
[picture p264: page 1]
TOP; (X right, Y up); FRONT; (X right, Z up); PART; Cover glass; REFERENCE; MATERIAL; AGC Dragontrail Pro, chemically strengthened, black print; SCALE; DESIGN VERSION; inside model v9 (2026-11-13); DATE; FILE; cover-glass.step in design/mfg/parts/cover-glass/; ALL DIMENSIONS IN MM; General tolerance ISO 2768-m (default). Overall size from the STEP bounding box.

RIGHT SIDE (Y right, Z up)

Third-angle projection. Solid lines visible, dashed grey hidden. Overall size X 29.30 x Y 14.43 x Z 1.10 mm (STEP axes).
