NexusGPT/openring/design/mfg/drawings/flex-tail-away-us10.pdf

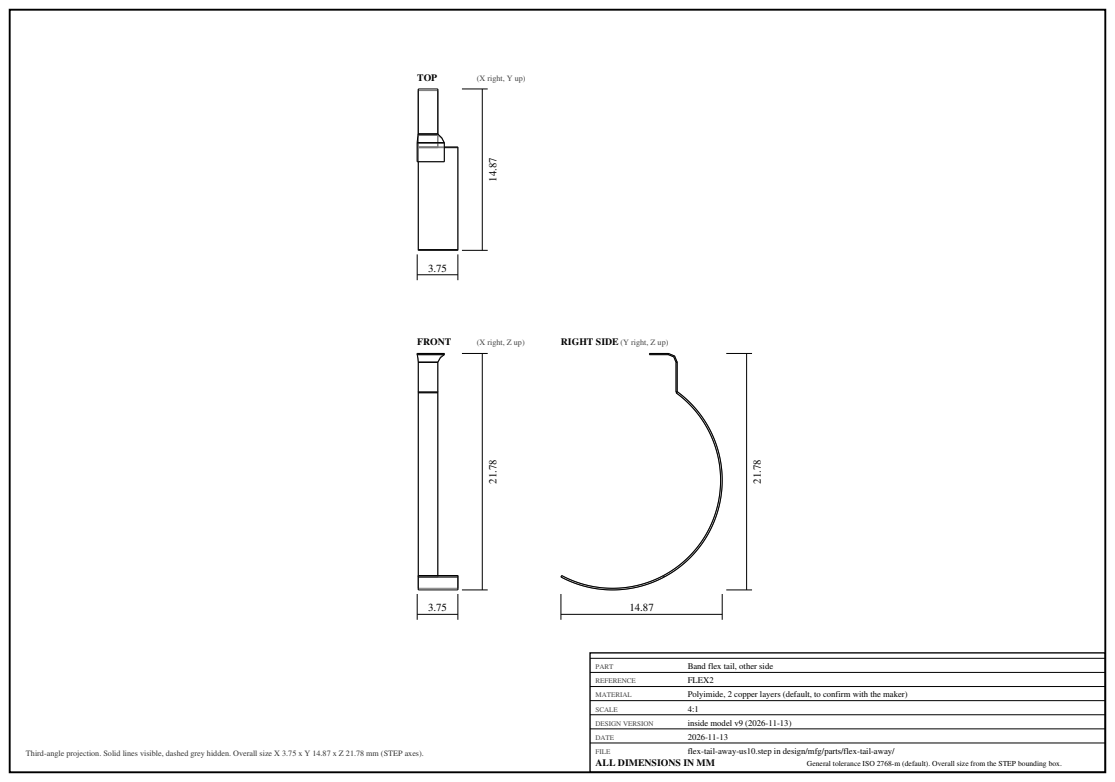
[picture p265: page 1]
TOP; (X right, Y up); FRONT; (X right, Z up); PART; Band flex tail, other side; REFERENCE; FLEX2; MATERIAL; Polyimide, 2 copper layers (default, to confirm with the maker); SCALE; DESIGN VERSION; inside model v9 (2026-11-13); DATE; FILE; flex-tail-away-us10.step in design/mfg/parts/flex-tail-away/; ALL DIMENSIONS IN MM; General tolerance ISO 2768-m (default). Overall size from the STEP bounding box.

RIGHT SIDE (Y right, Z up)

Third-angle projection. Solid lines visible, dashed grey hidden. Overall size X 3.75 x Y 14.87 x Z 21.78 mm (STEP axes).
