NexusGPT/openring/design/mfg/drawings/flex-tail-thumb-us10.pdf

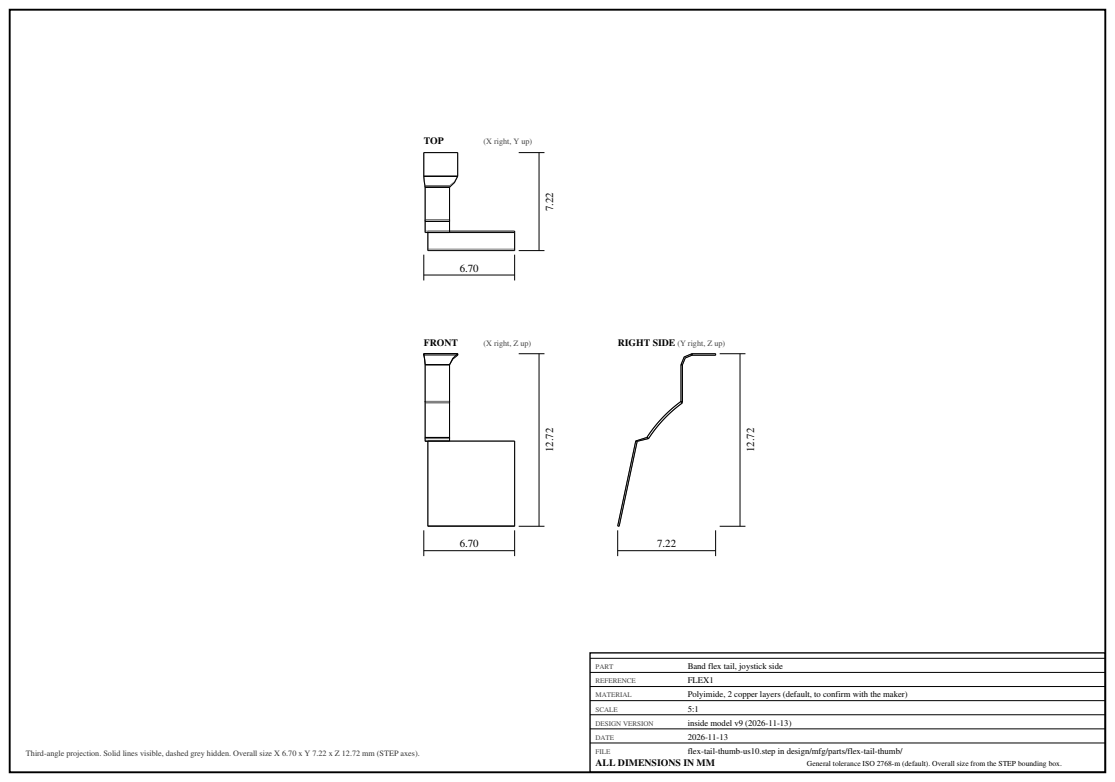
[picture p266: page 1]
TOP; (X right, Y up); FRONT; (X right, Z up); PART; Band flex tail, joystick side; REFERENCE; FLEX1; MATERIAL; Polyimide, 2 copper layers (default, to confirm with the maker); SCALE; DESIGN VERSION; inside model v9 (2026-11-13); DATE; FILE; flex-tail-thumb-us10.step in design/mfg/parts/flex-tail-thumb/; ALL DIMENSIONS IN MM; General tolerance ISO 2768-m (default). Overall size from the STEP bounding box.

RIGHT SIDE (Y right, Z up)

Third-angle projection. Solid lines visible, dashed grey hidden. Overall size X 6.70 x Y 7.22 x Z 12.72 mm (STEP axes).
