NexusGPT/openring/design/mfg/drawings/glass-seal-us10.pdf

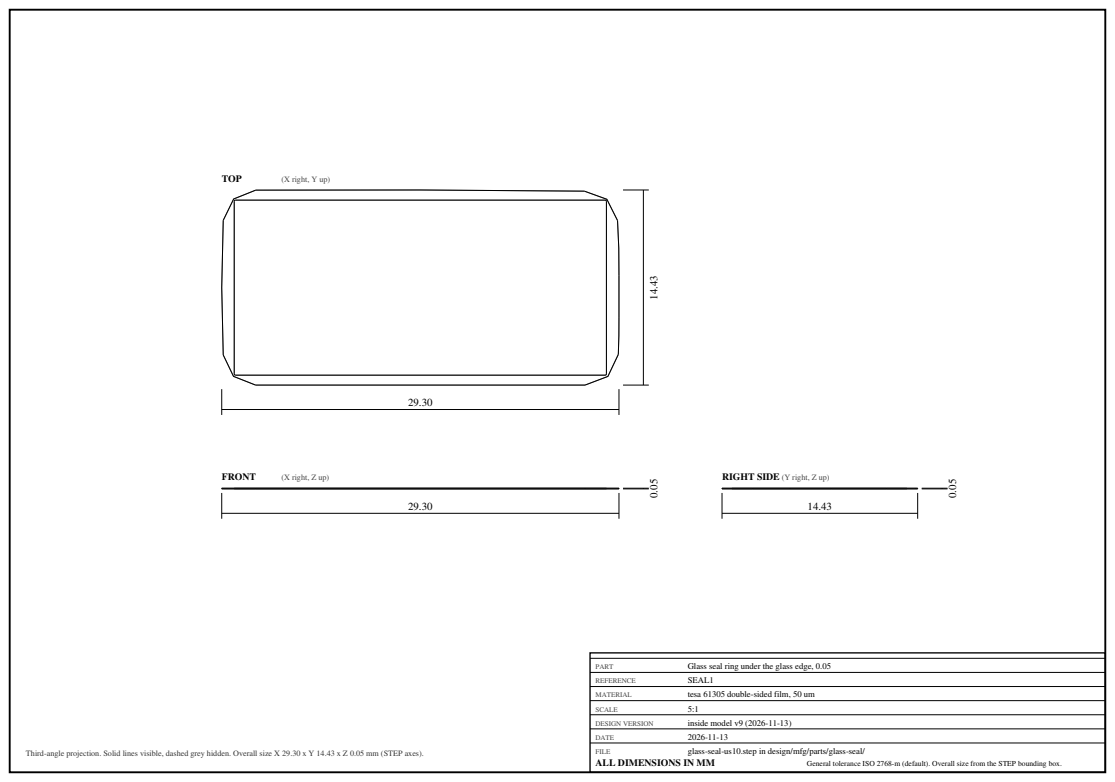
[picture p267: page 1]
TOP; (X right, Y up); FRONT; (X right, Z up); PART; Glass seal ring under the glass edge, 0.05; REFERENCE; SEAL1; MATERIAL; tesa 61305 double-sided film, 50 um; SCALE; DESIGN VERSION; inside model v9 (2026-11-13); DATE; FILE; glass-seal-us10.step in design/mfg/parts/glass-seal/; ALL DIMENSIONS IN MM; General tolerance ISO 2768-m (default). Overall size from the STEP bounding box.

RIGHT SIDE (Y right, Z up)

Third-angle projection. Solid lines visible, dashed grey hidden. Overall size X 29.30 x Y 14.43 x Z 0.05 mm (STEP axes).
