NexusGPT/openring/design/mfg/drawings/joystick-cap.pdf

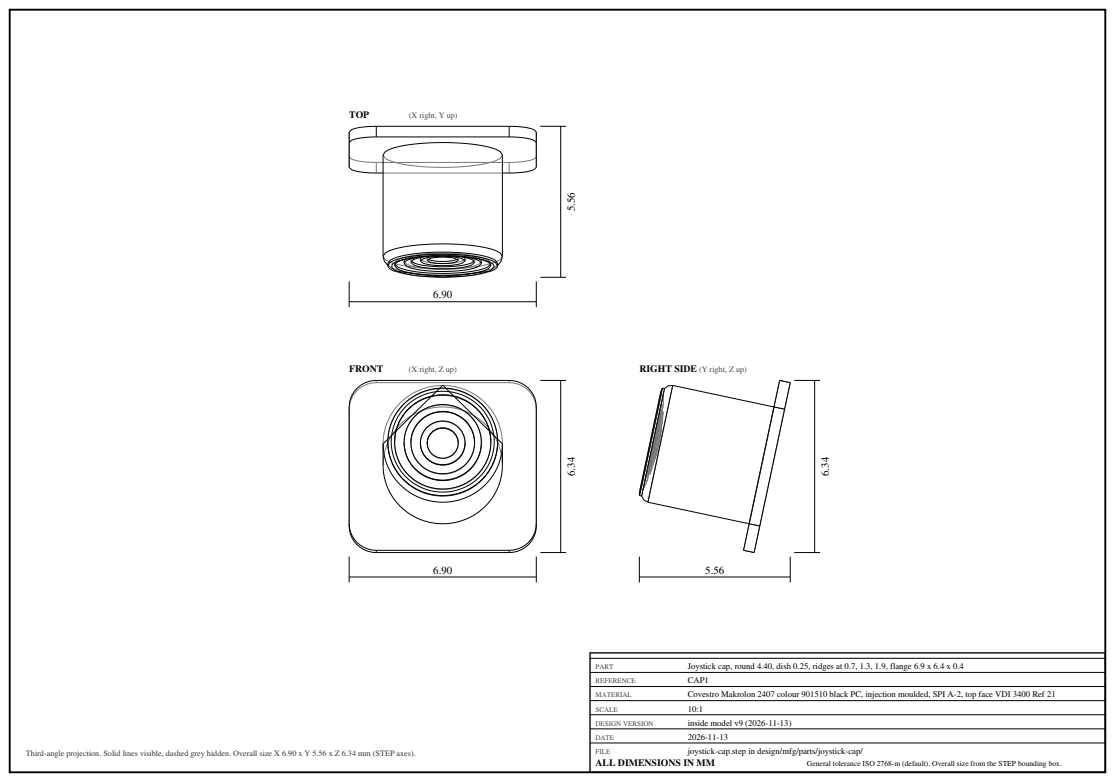
[picture p268: page 1]
TOP; (X right, Y up); FRONT; (X right, Z up); PART; Joystick cap, round 4.40, dish 0.25, ridges at 0.7, 1.3, 1.9, flange 6.9 x 6.4 x 0.4; REFERENCE; CAP1; MATERIAL; Covestro Makrolon 2407 colour 901510 black PC, injection moulded, SPI A-2, top face VDI 3400 Ref 21; SCALE; DESIGN VERSION; inside model v9 (2026-11-13); DATE; FILE; joystick-cap.step in design/mfg/parts/joystick-cap/; ALL DIMENSIONS IN MM; General tolerance ISO 2768-m (default). Overall size from the STEP bounding box.

RIGHT SIDE (Y right, Z up)

Third-angle projection. Solid lines visible, dashed grey hidden. Overall size X 6.90 x Y 5.56 x Z 6.34 mm (STEP axes).
