NexusGPT/openring/design/mfg/drawings/joystick-dam-us10.pdf

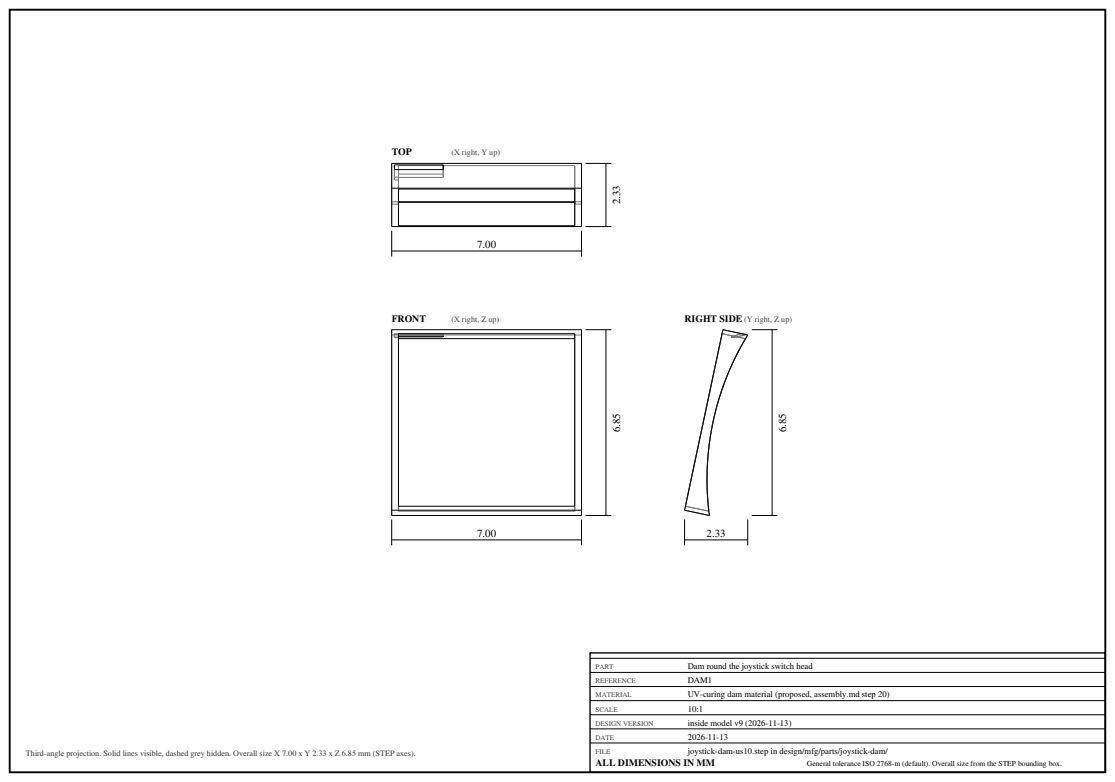
[picture p269: page 1]
TOP; (X right, Y up); FRONT; (X right, Z up); PART; Dam round the joystick switch head; REFERENCE; DAM1; MATERIAL; UV-curing dam material (proposed, assembly.md step 20); SCALE; DESIGN VERSION; inside model v9 (2026-11-13); DATE; FILE; joystick-dam-us10.step in design/mfg/parts/joystick-dam/; ALL DIMENSIONS IN MM; General tolerance ISO 2768-m (default). Overall size from the STEP bounding box.

RIGHT SIDE (Y right, Z up)

Third-angle projection. Solid lines visible, dashed grey hidden. Overall size X 7.00 x Y 2.33 x Z 6.85 mm (STEP axes).
