NexusGPT/openring/design/mfg/drawings/joystick-frame.pdf

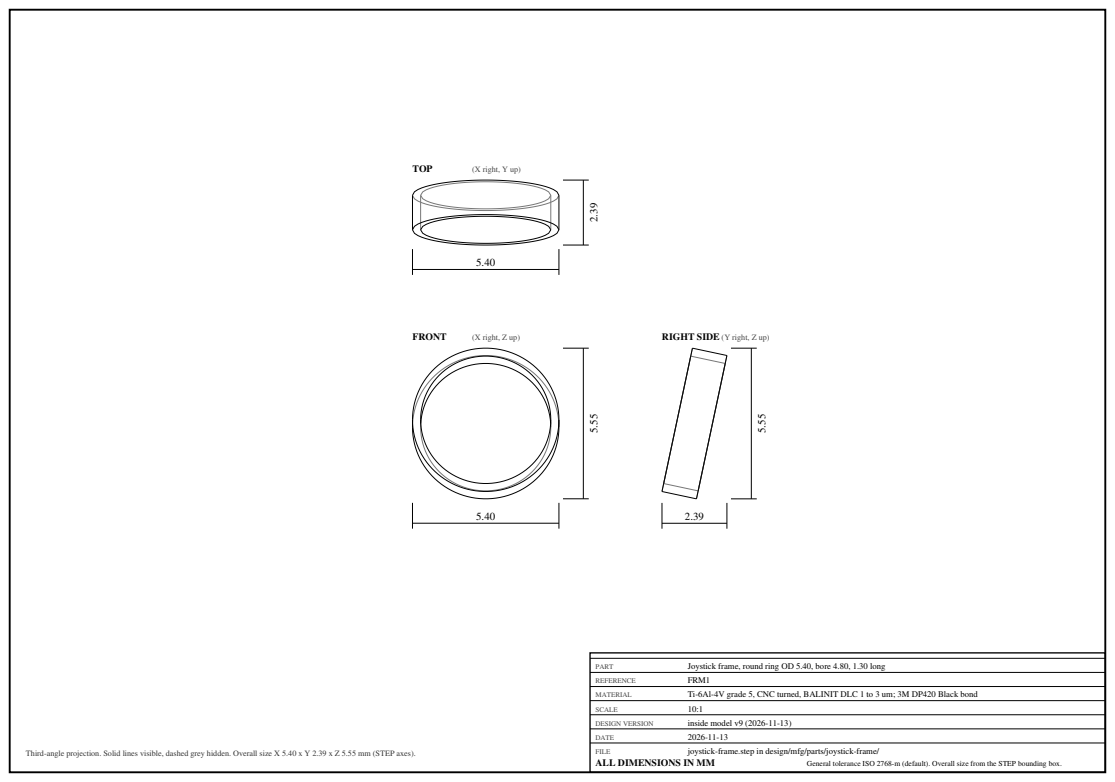
[picture p270: page 1]
TOP; (X right, Y up); FRONT; (X right, Z up); PART; Joystick frame, round ring OD 5.40, bore 4.80, 1.30 long; REFERENCE; FRM1; MATERIAL; Ti-6Al-4V grade 5, CNC turned, BALINIT DLC 1 to 3 um; 3M DP420 Black bond; SCALE; DESIGN VERSION; inside model v9 (2026-11-13); DATE; FILE; joystick-frame.step in design/mfg/parts/joystick-frame/; ALL DIMENSIONS IN MM; General tolerance ISO 2768-m (default). Overall size from the STEP bounding box.

RIGHT SIDE (Y right, Z up)

Third-angle projection. Solid lines visible, dashed grey hidden. Overall size X 5.40 x Y 2.39 x Z 5.55 mm (STEP axes).
