NexusGPT/openring/design/mfg/drawings/joystick-stiffener-us10.pdf

6.40

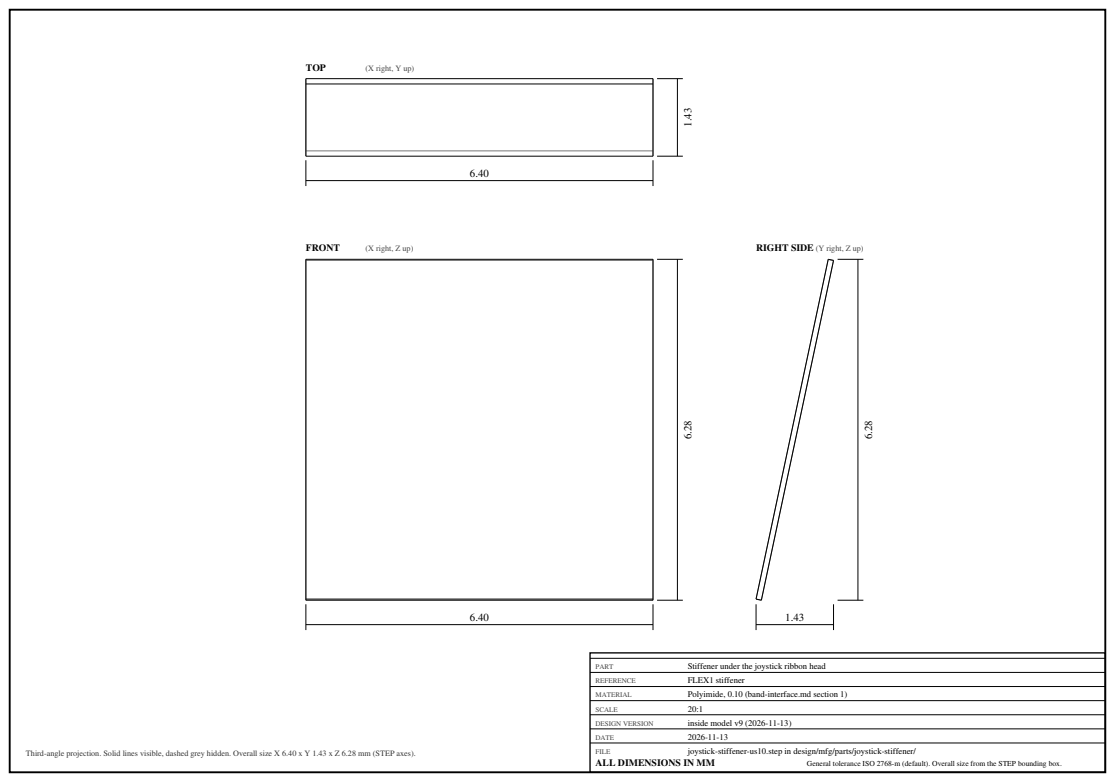
[picture p271: page 1]
TOP; (X right, Y up); FRONT; (X right, Z up); PART; Stiffener under the joystick ribbon head; REFERENCE; FLEX1 stiffener; MATERIAL; Polyimide, 0.10 (band-interface.md section 1); SCALE; DESIGN VERSION; inside model v9 (2026-11-13); DATE; FILE; joystick-stiffener-us10.step in design/mfg/parts/joystick-stiffener/; ALL DIMENSIONS IN MM; General tolerance ISO 2768-m (default). Overall size from the STEP bounding box.

RIGHT SIDE (Y right, Z up)

Third-angle projection. Solid lines visible, dashed grey hidden. Overall size X 6.40 x Y 1.43 x Z 6.28 mm (STEP axes).
