NexusGPT/openring/design/mfg/drawings/main-board.pdf

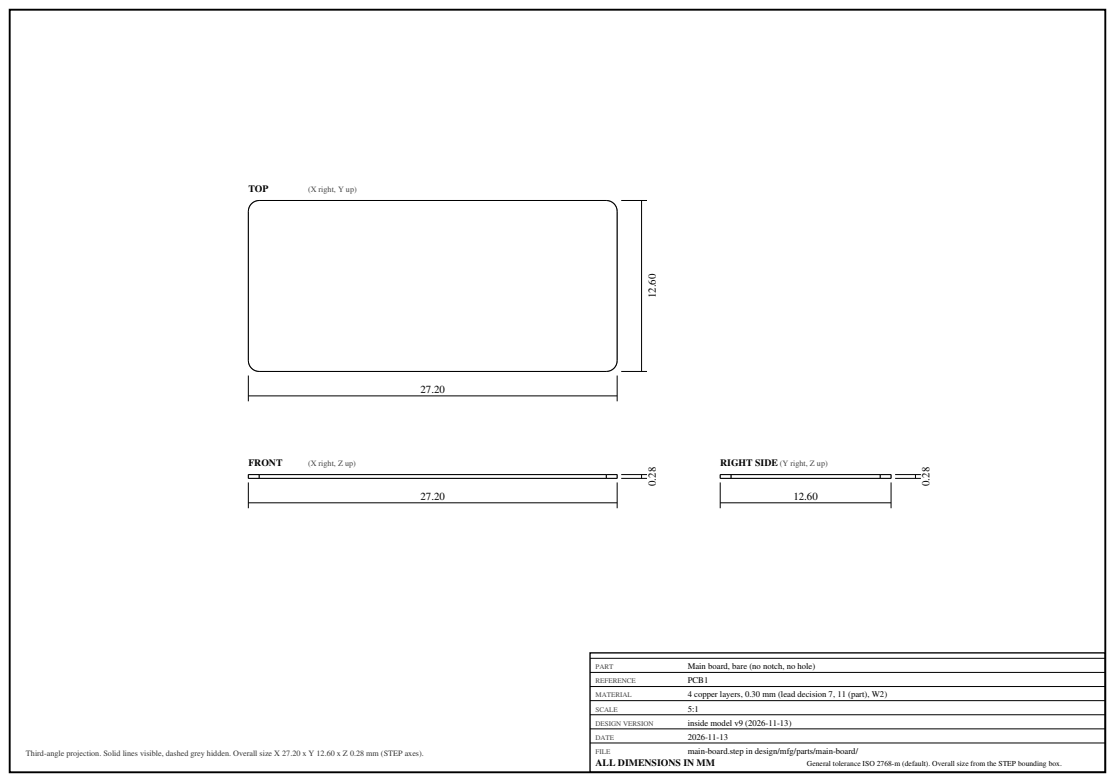
[picture p272: page 1]
TOP; (X right, Y up); FRONT; (X right, Z up); PART; Main board, bare (no notch, no hole); REFERENCE; PCB1; MATERIAL; 4 copper layers, 0.30 mm (lead decision 7, 11 (part), W2); SCALE; DESIGN VERSION; inside model v9 (2026-11-13); DATE; FILE; main-board.step in design/mfg/parts/main-board/; ALL DIMENSIONS IN MM; General tolerance ISO 2768-m (default). Overall size from the STEP bounding box.

RIGHT SIDE (Y right, Z up)

Third-angle projection. Solid lines visible, dashed grey hidden. Overall size X 27.20 x Y 12.60 x Z 0.28 mm (STEP axes).
