NexusGPT/openring/design/mfg/drawings/mic-gasket.pdf

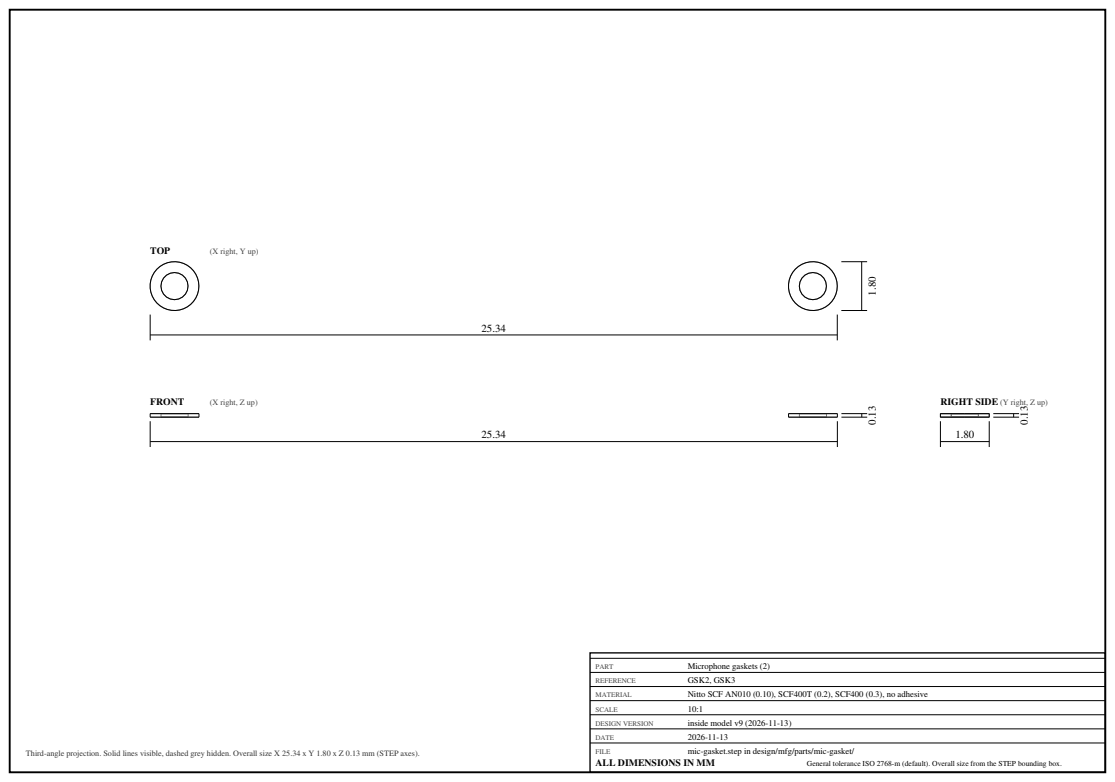
[picture p273: page 1]
TOP; (X right, Y up); FRONT; (X right, Z up); PART; Microphone gaskets (2); REFERENCE; GSK2, GSK3; MATERIAL; Nitto SCF AN010 (0.10), SCF400T (0.2), SCF400 (0.3), no adhesive; SCALE; DESIGN VERSION; inside model v9 (2026-11-13); DATE; FILE; mic-gasket.step in design/mfg/parts/mic-gasket/; ALL DIMENSIONS IN MM; General tolerance ISO 2768-m (default). Overall size from the STEP bounding box.

RIGHT SIDE (Y right, Z up)

Third-angle projection. Solid lines visible, dashed grey hidden. Overall size X 25.34 x Y 1.80 x Z 0.13 mm (STEP axes).
