NexusGPT/openring/design/mfg/drawings/mic-membrane.pdf

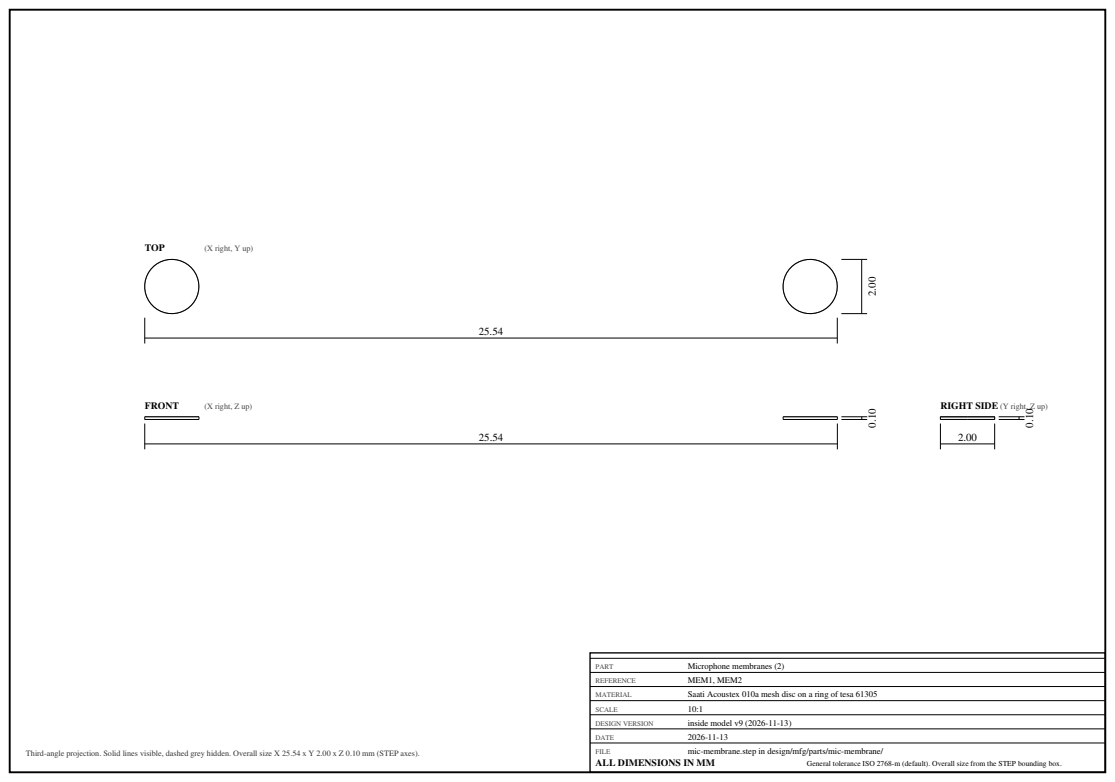
[picture p274: page 1]
TOP; (X right, Y up); FRONT; (X right, Z up); PART; Microphone membranes (2); REFERENCE; MEM1, MEM2; MATERIAL; Saati Acoustex 010a mesh disc on a ring of tesa 61305; SCALE; DESIGN VERSION; inside model v9 (2026-11-13); DATE; FILE; mic-membrane.step in design/mfg/parts/mic-membrane/; ALL DIMENSIONS IN MM; General tolerance ISO 2768-m (default). Overall size from the STEP bounding box.

RIGHT SIDE (Y right, Z up)

Third-angle projection. Solid lines visible, dashed grey hidden. Overall size X 25.54 x Y 2.00 x Z 0.10 mm (STEP axes).
