NexusGPT/openring/design/mfg/drawings/motor-window-seal-us7.pdf

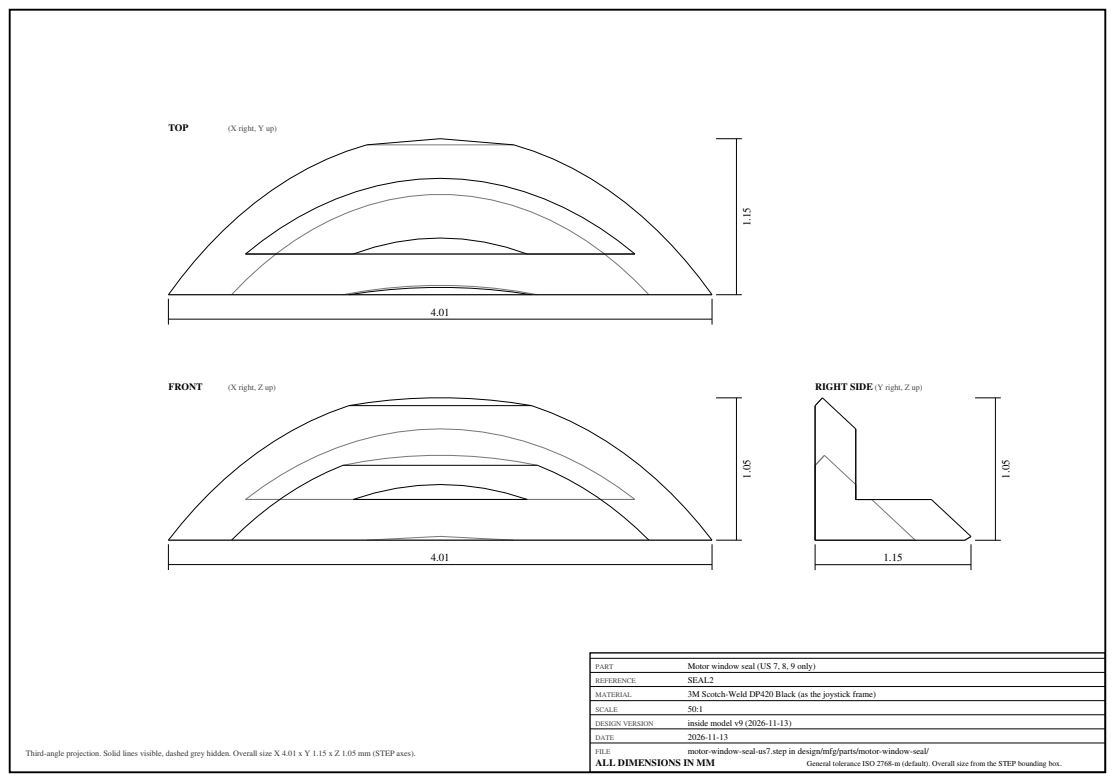
[picture p275: page 1]
TOP; (X right, Y up); FRONT; (X right, Z up); PART; Motor window seal (US 7, 8, 9 only); REFERENCE; SEAL2; MATERIAL; 3M Scotch-Weld DP420 Black (as the joystick frame); SCALE; DESIGN VERSION; inside model v9 (2026-11-13); DATE; FILE; motor-window-seal-us7.step in design/mfg/parts/motor-window-seal/; ALL DIMENSIONS IN MM; General tolerance ISO 2768-m (default). Overall size from the STEP bounding box.

RIGHT SIDE (Y right, Z up)

Third-angle projection. Solid lines visible, dashed grey hidden. Overall size X 4.01 x Y 1.15 x Z 1.05 mm (STEP axes).
