NexusGPT/openring/design/sim/circuit/decks/ring7_pads.cir

* ring test 7: voltage between the four charging pads after VBUS is removed
* generated by make_decks.py from design/ecad/ring
.include "design/sim/circuit/models/tlv755p30.lib"
.include "design/sim/circuit/models/tpd4e05u06.lib"
.include "design/sim/circuit/models/npm1304.lib"
.param ocv=3.8
.param rcell=1.0
.param rbleed=0
CC4 n_VDD_1V8 0 1e-05 ; 10uF
CC5 n_VDD_1V8 0 1e-07 ; 100nF
CC1 n_VDD_1V8 0 1e-07 ; 100nF
CC2 n_VDD_1V8 0 1e-07 ; 100nF
RR1 n_VBUS n_U1_VBUS 2.2 ; 2.2R
CC11 n_U1_VBUS 0 4.7e-06 ; 4.7uF
CC71 n_VBUS 0 1e-06 ; 1.0uF 25V
CC85 n_VBAT 0 2.2e-06 ; 2.2uF
CC88 n_VSYS 0 1e-05 ; 10uF
CC86 n_VDD_MIC 0 1e-06 ; 1.0uF
CC87 n_VDD_SD 0 1e-06 ; 1.0uF
CC72 n_VBUS 0 1e-07 ; 100nF
CC73 n_VBUSOUT 0 1e-06 ; 1.0uF
CC74 n_VSYS 0 1e-05 ; 10uF
CC75 n_VSYS 0 1e-05 ; 10uF
CC76 n_VSYS 0 1e-09 ; 1.0nF
CC77 n_VSYS 0 1e-09 ; 1.0nF
CC78 n_VDD_1V8 0 1e-05 ; 10uF
CC79 n_VDD_3V0 0 1e-05 ; 10uF
CC80 n_VDD_1V8 0 1e-07 ; 100nF
RR71 n_VSET1 0 47000 ; 47k
RR72 n_VSET2 0 150000 ; 150k
RRT1 n_NTC 0 10000 ; 10k NTC
CC31 n_VDD_MIC 0 1e-06 ; 1uF
CC35 n_VDD_MIC 0 1e-09 ; 1nF C0G
CC32 n_VDD_MIC 0 1e-06 ; 1uF
CC36 n_VDD_MIC 0 1e-09 ; 1nF C0G
CC81 n_VDD_1V8 0 1e-07 ; 100nF
CC82 n_VDD_SD 0 1e-07 ; 100nF
CC60 n_VDD_SD 0 2.2e-06 ; 2.2uF
CC61 n_VDD_SD 0 1e-07 ; 100nF
CC21 n_VBAT 0 4.7e-06 ; 4.7uF
CC83 n_VBAT 0 1e-05 ; 10uF
CC84 n_VMOT 0 1e-05 ; 10uF
RR61 n_MOTOR n_MOT_EN 100 ; 100R
RR62 n_MOT_EN 0 100000 ; 100k
* BT1 cell: 4.35V 20-27mAh at US9 (17.6mAh min at US7) curved ; its capacity (read from parts.csv) is not used by a DC or short test; open-circuit voltage and series resistance are parameters
Vocv cell_i 0 PWL(0 0 100u {ocv})
Rcellx cell_i n_VBAT {rcell}
.model swc SW(Ron=0.01 Roff=1e13 Vt=0.5 Vh=0.1)
Vcase vcase 0 PWL(0 0 1m 5)
Vsw ctl 0 PWL(0 1 0.05 1 0.050001 0) ; the ring leaves the case at 50 ms
Scase vcase n_VBUS ctl 0 swc ; the spring pin leaves the pad: open circuit
Vls1 ls1en 0 0
Vls2 ls2en 0 0
Vchg chgen 0 PWL(0 0 5m 0 5.001m 1)
XU2 n_VBUS n_VBUSOUT n_VSYS n_VBAT n_VDD_1V8 n_VDD_3V0 n_VDD_1V8 n_VDD_MIC n_VDD_3V0 n_VDD_SD n_VSET1 n_VSET2 ls1en ls2en chgen NPM1304
XU9 n_USB_DP n_USB_DN n_VBUS n_VBUS 0 TPD4E05U06
XU11 n_VBAT n_VMOT n_MOT_EN 0 TLV755P30
Vmotor n_MOTOR 0 0
Bu1 n_VDD_1V8 0 I = 5e-06 ; U1 standby, architecture.md line 89: main chip standby 0.005 mA, estimate
.if (rbleed > 0)
Rbleedx n_VBUS 0 {rbleed} ; WHAT-IF only: a bleeder on VBUS, not in the design
.endif
.options method=gear itl4=100 reltol=0.005 abstol=1e-10 vntol=1e-5
.tran 100u 10.06 0 20m uic
.control
run
meas tran v_vbus find v(n_VBUS) at=10.05
meas tran v_dn find v(n_USB_DN) at=10.05
meas tran v_dp find v(n_USB_DP) at=10.05
meas tran v_vbus_early find v(n_VBUS) at=0.049
meas tran v_vbus_1s find v(n_VBUS) at=1.05
let vbus_dp = abs(v_vbus - v_dp)
let vbus_dn = abs(v_vbus - v_dn)
echo RESULT pads.v_vbus = $&v_vbus
echo RESULT pads.v_dn = $&v_dn
echo RESULT pads.v_dp = $&v_dp
echo RESULT pads.vbus_dp = $&vbus_dp
echo RESULT pads.vbus_dn = $&vbus_dn
echo RESULT pads.v_vbus_early = $&v_vbus_early
echo RESULT pads.v_vbus_1s = $&v_vbus_1s
wrdata @WAVE@ v(n_VBUS) v(n_USB_DP) v(n_USB_DN)
quit
.endc
.end
* included: C4 C5 C1 C2 R1 C11 C71 C85 C88 C86 C87 C72 C73 C74 C75 C76 C77 C78 C79 C80 R71 R72 RT1 C31 C35 C32 C36 C81 C82 C60 C61 C21 C83 C84 R61 R62 BT1 U2 U9 U11
* excluded: L1(net outside this test: DCC,DECD) C6(net outside this test: DECD) FB1(net outside this test: DECA,DECD) C7(net outside this test: DECA) C14(net outside this test: DECA) C10(net outside this test: VDD_USB_3V3) R2(net outside this test: TXRTUNE) L2(net outside this test: ANT1_NODE,ANT2_NODE) C3(net outside this test: ANT2_NODE) L3(net outside this test: ANT2_NODE,ANT3_NODE) C12(net outside this test: ANT3_NODE) L4(net outside this test: ANT3_NODE,RF_FEED) C13(DNP) LT1(net outside this test: ANT_TRIM) C89(DNP) L71(net outside this test: SW1) L72(net outside this test: SW2) R57(net outside this test: PMIC_SDA) R58(net outside this test: PMIC_SCL) R31(net outside this test: MIC1_DATA,MIC_A_DATA) R32(net outside this test: MIC2_DATA,MIC_A_DATA) R60(net outside this test: SDC_MISO) R63(net outside this test: SD_DAT1) R64(net outside this test: SD_DAT2) R65(net outside this test: SDC_CS) L10(net outside this test: SGM_SW1,SGM_SW2) C22(net outside this test: SGM_AVIN) C23(net outside this test: SGM_C1N,SGM_C1P) C24(net outside this test: SGM_VOUT) C25(net outside this test: ELVDD) C26(net outside this test: SGM_AVDD) C27(net outside this test: SGM_VON) C28(net outside this test: ELVSS) C29(net outside this test: ELVSS) R66(net outside this test: OLED_PWR_EN)
