NexusGPT/openring/(list of files, drawings)

Other design files:
design/wiring/probe/ring-A.dsn
design/wiring/probe/ring-B.dsn
design/wiring/probe/ring-C.dsn
explorer/contract/schema/schematic-pages.schema.json
