NexusGPT/openring/design/ecad/ring-route-h/logs/s/q-c2-try.kicad_pcb

## KiCad design design/ecad/ring-route-h/logs/s/q-c2-try.kicad_pcb (2026-11-14)

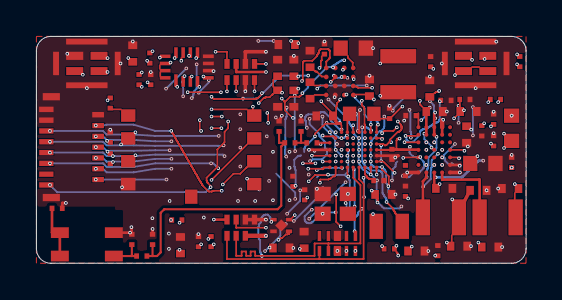
[picture p276: board q-c2-try.kicad_pcb from above]

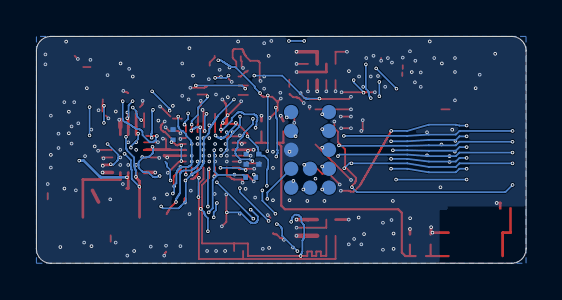
[picture p277: board q-c2-try.kicad_pcb from below]

Board: 4 copper layers, 27.2 x 12.6 mm, 99 parts (16 on the bottom side), 84 nets.

Parts:
ANT1: 2450AT18D0100001E; ANT_Johanson_2450AT18D0100001E_3.2x1.6
C1, C2, C5, C61, C72, C80, C81, C82: 100nF; Chip_0201
C3: 1.2pF; Chip_0201
C4, C22, C25, C74, C75, C78, C79, C83, C90: 10uF; Chip_0402
C6: 4.7uF; Chip_0201
C7, C10, C14: 2.2uF; Chip_0201
C11, C21, C26, C27, C84: 4.7uF; Chip_0402
C12: 0.5pF; Chip_0201
C13, C89: DNP; Chip_0201
C23, C60, C85: 2.2uF; Chip_0402
C24, C88: 10uF; Chip_0603
C28, C29: 22uF; Chip_0402
C31, C32: 1uF; Chip_0201
C35, C36: 1nF C0G; Chip_0402
C71: 1.0uF 25V; Chip_0402
C73: 1.0uF; Chip_0201
C76, C77: 1.0nF; Chip_0201
C86, C87: 1.0uF; Chip_0402
FB1: 120R@100MHz; Chip_0201
J1: FH35C-15S-0.3SHW(50); FPC_Hirose_FH35C-15S-0.3SHW
J_BAND_A: flex tail A (joystick side) 8 pads; J_BAND_A_BOARD
J_BAND_B: flex tail B (other side) 7 pads; J_BAND_B_BOARD
L1: 4.7uH; L_TDK_MLZ1608_1.6x0.8
L2: 3.6nH; Chip_0201
L3: 4.7nH; Chip_0201
L4: 3.3nH; Chip_0201
L10, L71, L72: 2.2uH; L_Murata_1269AS-H_2.5x2.0
LT1: 0R; Chip_0201
R1: 2.2R; Chip_0603
R2: 220R; Chip_0201
R31, R32, R61: 100R; Chip_0201
R57, R58: 4.7k; Chip_0201
R60, R63, R64, R65, R71: 47k; Chip_0201
R62, R66: 100k; Chip_0201
R72: 150k; Chip_0201
R73: 330k; Chip_0201
TP1, TP3, TP4, TP5, TP6, TP12, TP14, TP15, TP17, TP18, TP19, TP21: pad; TESTPAD_0.8
U1: nRF54LM20A; WLCSP-61_nRF54LM20A-CAAA
U2: nPM1304; WLCSP-35_nPM1304-CAAA
U3: CSNP32GCR01-BOW; LGA-9_CSNP32GCR01-BOW_8.0x6.2
U4: SGM38046; WLCSP-16_SGM38046_2.0x2.0_P0.5
U5, U6: SPK0641HT4H-1; LGA-8_Knowles_SPK0641HT4H-1_3.0x4.0
U9: TPD4E05U06; USON-10_TPD4E05U06DQA
U10: SN74AXC4T774; UQFN-16_SN74AXC4T774RSV_1.8x2.6
U11: TLV75530P 3.0V; X2SON-4_TLV755xxPDQN_1.0x1.0
X1: 32MHz; XTAL_Kyocera_CX2016DB_2.0x1.6
X2: 32.768kHz; XTAL_TXC_9HT11_2.0x1.2

Connections:
ANT1_NODE: L2.1, U1.C1
ANT2_NODE: C3.1, L2.2, L3.1
ANT3_NODE: C12.1, C89.1, L3.2, L4.1
ANT_TRIM: ANT1.2, ANT1.3, LT1.1
BTN_REC: J_BAND_A.5, U1.H2
DBG_TX: TP1.1, U1.B4
DCC: L1.1, U1.A5
DECA: C7.1, C14.1, FB1.2, U1.A8, U1.B2
DECD: C6.1, FB1.1, L1.2, U1.A6
ELVDD: C25.1, J1.2, U4.D3
ELVSS: C28.1, C29.1, J1.1, U4.D4
GND: ANT1.4, C1.2, C2.2, C3.2, C4.2, C5.2, C6.2, C7.2, C10.2, C11.2, C12.2, C13.2, C14.2, C21.2, C22.2, C24.2, C25.2, C26.2, C27.2, C28.2, C29.2, C31.2, C32.2, C35.2, C36.2, C60.2, C61.2, C71.2, C72.2, C73.2, C74.2, C75.2, C76.2, C77.2, C78.2, C79.2, C80.2, C81.2, C82.2, C83.2, C84.2, C85.2, C86.2, C87.2, C88.2, C89.2, C90.2, J1.13, J1.14, J1.15, J1.MP, J_BAND_A.6, J_BAND_A.8, J_BAND_B.2, J_BAND_B.7, LT1.2, R2.2, R62.2, R66.2, R71.2, R72.2, R73.2, TP18.1, U1.A7, U1.D3, U1.E1, U1.F10, U2.A6, U2.A7, U2.E7, U3.4, U4.A3, U4.B2, U4.B3, U5.3, U5.5, U5.6, U5.7, U5.8, U6.5, U6.6, U6.7, U6.8, U9.3, U9.8, U10.6, U10.7, U10.8, U11.2, U11.5, X1.2
JOY_DOWN: J_BAND_A.2, U1.G2
JOY_LEFT: J_BAND_A.3, U1.G1
JOY_RIGHT: J_BAND_A.4, U1.G10
JOY_UP: J_BAND_A.1, U1.H1
LCD_CS: J1.9, U1.F7
LCD_DCX: J1.11, U1.G7
LCD_MOSI: J1.12, U1.G8
LCD_RST: J1.8, U1.H5
LCD_SCK: J1.10, U1.G9
LCD_TE: J1.7, U1.F4
MIC1_DATA: R31.1, U5.1
MIC2_DATA: R32.1, U6.1
MIC_A_CLK: U1.F1, U5.2, U6.2
MIC_A_DATA: R31.2, R32.2, U1.F2
MIC_B_DATA: TP21.1, U1.D7
MOTOR: R61.1, U1.F6
MOT_EN: R61.2, R62.1, U11.3
NRESET: TP5.1, U1.E2
NTC: J_BAND_B.3, U2.D3
OLED_PWR_EN: R66.1, U1.F9, U4.C2
PMIC_INT: U1.D8, U2.D6
PMIC_SCL: R58.1, U1.E7, U2.E3
PMIC_SDA: R57.1, U1.B8, U2.E5
RF_FEED: ANT1.1, C13.1, L4.2
SDC_CS: R65.1, U3.2, U10.10
SDC_MISO: R60.1, U3.6, U10.9
SDC_MOSI: U3.5, U10.11
SDC_SCK: U3.3, U10.12
SD_CS: U1.D9, U10.3
SD_DAT1: R63.1, U3.7
SD_DAT2: R64.1, U3.1
SD_MISO: U1.D10, U10.4
SD_MOSI: U1.B10, U10.2
SD_SCK: U1.A9, U10.1
SGM_AVDD: C26.1, U4.D2
SGM_AVIN: C22.1, U4.A2
SGM_C1N: C23.2, U4.B4
SGM_C1P: C23.1, U4.A4
SGM_SW1: L10.1, U4.B1
SGM_SW2: L10.2, U4.C1
SGM_VON: C27.1, U4.C4
SGM_VOUT: C24.1, U4.D1
SHPHLD: TP19.1, U2.D4
SPARE_P1_00: TP6.1, U1.H10
SPARE_P2_00: TP12.1, U1.A10
SPARE_P3_03: TP14.1, U1.F5
SPARE_P3_04: TP15.1, U1.G5
SW1: L71.1, U2.B7
SW2: L72.1, U2.D7
SWDCLK: TP3.1, U1.D5
SWDIO: TP4.1, U1.E4
SWIRE: J1.6, U4.C3
TXRTUNE: R2.1, U1.G6
U1_VBUS: C11.1, R1.2, U1.H9
USB_DN: J_BAND_B.5, U1.H6, U9.2
USB_DP: J_BAND_B.6, U1.H7, U9.1
VBAT: C21.1, C83.1, C85.1, J_BAND_B.1, U2.D1, U2.D2, U4.A1, U11.4
VBUS: C71.1, C72.1, J_BAND_B.4, R1.1, R73.1, U2.B1, U2.B2, U9.4, U9.5
VBUSOUT: C73.1, U2.C3
VDD_1V8: C1.1, C2.1, C4.1, C5.1, C78.1, C80.1, C81.1, J1.5, L71.2, R57.2, R58.2, TP17.1, U1.A4, U1.E10, U2.B4, U2.B6, U2.E4, U10.5, U10.14, U10.15, U10.16
VDD_3V0: C79.1, C90.1, J1.4, L72.2, U2.B5, U2.C6
VDD_MIC: C31.1, C32.1, C35.1, C36.1, C86.1, U2.A4, U5.4, U6.3, U6.4
VDD_SD: C60.1, C61.1, C82.1, C87.1, R60.2, R63.2, R64.2, R65.2, U2.A5, U3.8, U10.13
VDD_USB_3V3: C10.1, U1.H8
VMOT: C84.1, J_BAND_A.7, U11.1
VSET1: R71.1, U2.E2
VSET2: R72.1, U2.E1
VSYS: C74.1, C75.1, C76.1, C77.1, C88.1, U2.C1, U2.C2, U2.C7
XC1: U1.A2, X1.1
XC2: U1.A1, X1.3
XL1: U1.B6, X2.1
XL2: U1.B7, X2.2
