NexusGPT/openring/design/ecad/case/case_main.kicad_sch

## KiCad design design/ecad/case/case_main.kicad_sch (2026-11-13)

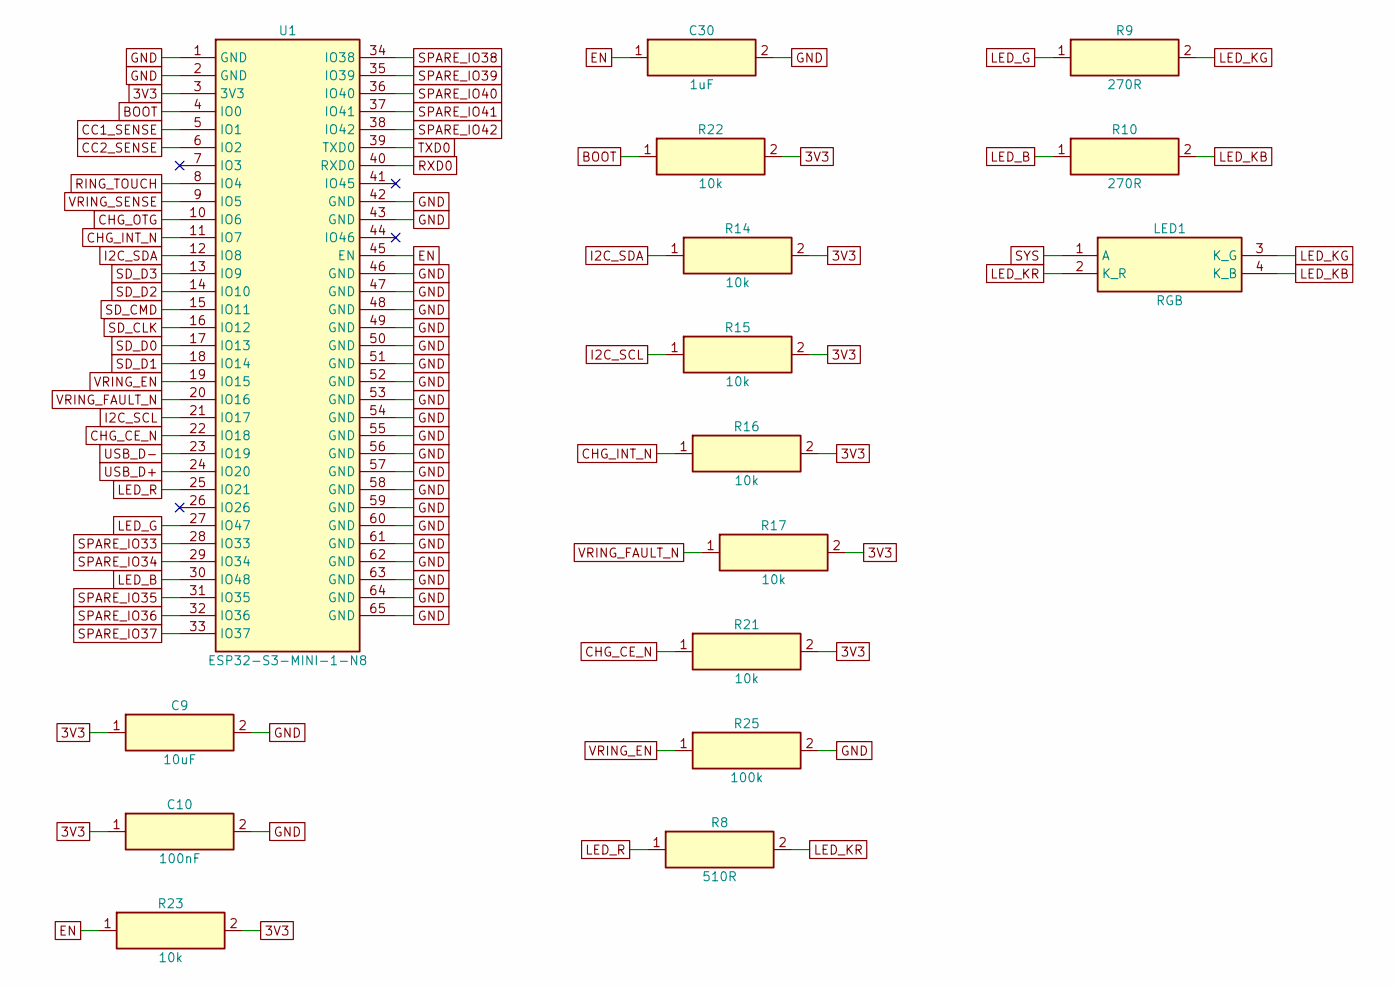
[picture p278: schematic case_main.kicad_sch]

Parts:
C9: 10uF; MPN GRM188R60J106ME47D
C10: 100nF; MPN GRM155R71C104KA88D
C30: 1uF; MPN GRM155R61A105KE15D
LED1: RGB; MPN APTF1616SEEZGQBDC
R8: 510R; MPN RC0402FR-07510RL
R9, R10: 270R; MPN RC0402FR-07270RL
R14, R15, R16, R17, R21, R22, R23: 10k; MPN RC0402FR-0710KL
R25: 100k; MPN RC0402FR-07100KL
U1: ESP32-S3-MINI-1-N8; MPN ESP32-S3-MINI-1-N8

Connections:
3V3: C9.1, C10.1, R14.2, R15.2, R16.2, R17.2, R21.2, R22.2, R23.2, U1.3 (3V3)
BOOT: R22.1, U1.4 (IO0)
CC1_SENSE: U1.5 (IO1)
CC2_SENSE: U1.6 (IO2)
CHG_CE_N: R21.1, U1.22 (IO18)
CHG_INT_N: R16.1, U1.11 (IO7)
CHG_OTG: U1.10 (IO6)
EN: C30.1, R23.1, U1.45 (EN)
GND: C9.2, C10.2, C30.2, R25.2, U1.1 (GND), U1.2 (GND), U1.42 (GND), U1.43 (GND), U1.46 (GND), U1.47 (GND), U1.48 (GND), U1.49 (GND), U1.50 (GND), U1.51 (GND), U1.52 (GND), U1.53 (GND), U1.54 (GND), U1.55 (GND), U1.56 (GND), U1.57 (GND), U1.58 (GND), U1.59 (GND), U1.60 (GND), U1.61 (GND), U1.62 (GND), U1.63 (GND), U1.64 (GND), U1.65 (GND)
I2C_SCL: R15.1, U1.21 (IO17)
I2C_SDA: R14.1, U1.12 (IO8)
LED_B: R10.1, U1.30 (IO48)
LED_G: R9.1, U1.27 (IO47)
LED_KB: LED1.4 (K_B), R10.2
LED_KG: LED1.3 (K_G), R9.2
LED_KR: LED1.2 (K_R), R8.2
LED_R: R8.1, U1.25 (IO21)
RING_TOUCH: U1.8 (IO4)
RXD0: U1.40 (RXD0)
SD_CLK: U1.16 (IO12)
SD_CMD: U1.15 (IO11)
SD_D0: U1.17 (IO13)
SD_D1: U1.18 (IO14)
SD_D2: U1.14 (IO10)
SD_D3: U1.13 (IO9)
SPARE_IO33: U1.28 (IO33)
SPARE_IO34: U1.29 (IO34)
SPARE_IO35: U1.31 (IO35)
SPARE_IO36: U1.32 (IO36)
SPARE_IO37: U1.33 (IO37)
SPARE_IO38: U1.34 (IO38)
SPARE_IO39: U1.35 (IO39)
SPARE_IO40: U1.36 (IO40)
SPARE_IO41: U1.37 (IO41)
SPARE_IO42: U1.38 (IO42)
SYS: LED1.1 (A)
TXD0: U1.39 (TXD0)
USB_D+: U1.24 (IO20)
USB_D-: U1.23 (IO19)
VRING_EN: R25.1, U1.19 (IO15)
VRING_FAULT_N: R17.1, U1.20 (IO16)
VRING_SENSE: U1.9 (IO5)
