NexusGPT/openring/design/ecad/case/case_power.kicad_sch

## KiCad design design/ecad/case/case_power.kicad_sch (2026-11-13)

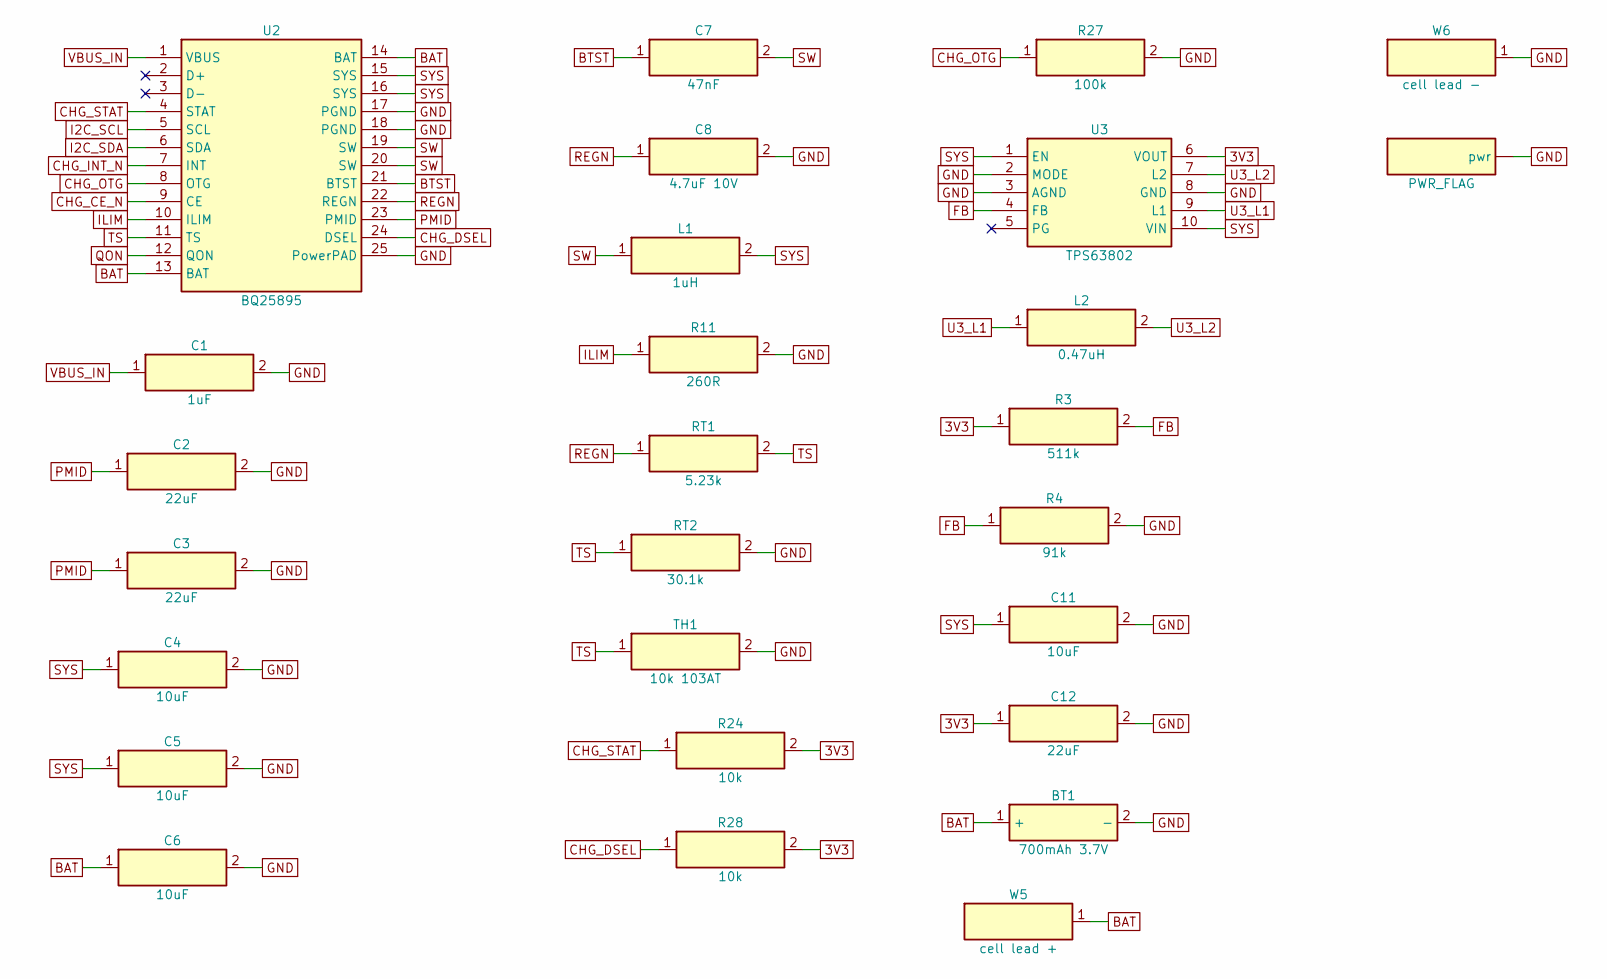
[picture p279: schematic case_power.kicad_sch]

Parts:
BT1: 700mAh 3.7V; MPN DNK852338
C1: 1uF; MPN GRM188R61A105KA61D
C2, C3: 22uF; MPN GRM21BR61A226ME44L
C4, C5, C6, C11: 10uF; MPN GRM188R61A106KE69D
C7: 47nF; MPN GRM155R71C473KA01D
C8: 4.7uF 10V; MPN GRM188R61A475KE15D
C12: 22uF; MPN GRM188R60J226MEA0D
L1: 1uH; MPN XFL4020-102MEC
L2: 0.47uH; MPN XFL4015-471MEC
R3: 511k; MPN RC0402FR-07511KL
R4: 91k; MPN RC0402FR-0791KL
R11: 260R; MPN RC0402FR-07261RL
R24, R28: 10k; MPN RC0402FR-0710KL
R27: 100k; MPN RC0402FR-07100KL
RT1: 5.23k; MPN RC0402FR-075K23L
RT2: 30.1k; MPN RC0402FR-0730K1L
TH1: 10k 103AT; MPN 103AT-2
U2: BQ25895; MPN BQ25895RTWR
U3: TPS63802; MPN TPS63802DLAR
W5: cell lead +
W6: cell lead -

Connections:
3V3: C12.1, R3.1, R24.2, R28.2, U3.6 (VOUT)
BAT: BT1.1 (+), C6.1, U2.13 (BAT), U2.14 (BAT), W5.1
BTST: C7.1, U2.21 (BTST)
CHG_CE_N: U2.9 (CE)
CHG_DSEL: R28.1, U2.24 (DSEL)
CHG_INT_N: U2.7 (INT)
CHG_OTG: R27.1, U2.8 (OTG)
CHG_STAT: R24.1, U2.4 (STAT)
FB: R3.2, R4.1, U3.4 (FB)
GND: BT1.2 (-), C1.2, C2.2, C3.2, C4.2, C5.2, C6.2, C8.2, C11.2, C12.2, R4.2, R11.2, R27.2, RT2.2, TH1.2, U2.17 (PGND), U2.18 (PGND), U2.25 (PowerPAD), U3.2 (MODE), U3.3 (AGND), U3.8 (GND), W6.1
I2C_SCL: U2.5 (SCL)
I2C_SDA: U2.6 (SDA)
ILIM: R11.1, U2.10 (ILIM)
PMID: C2.1, C3.1, U2.23 (PMID)
QON: U2.12 (QON)
REGN: C8.1, RT1.1, U2.22 (REGN)
SW: C7.2, L1.1, U2.19 (SW), U2.20 (SW)
SYS: C4.1, C5.1, C11.1, L1.2, U2.15 (SYS), U2.16 (SYS), U3.1 (EN), U3.10 (VIN)
TS: RT1.2, RT2.1, TH1.1, U2.11 (TS)
U3_L1: L2.1, U3.9 (L1)
U3_L2: L2.2, U3.7 (L2)
VBUS_IN: C1.1, U2.1 (VBUS)
