NexusGPT/openring/design/ecad/case/case_ringlink.kicad_sch

## KiCad design design/ecad/case/case_ringlink.kicad_sch (2026-11-13)

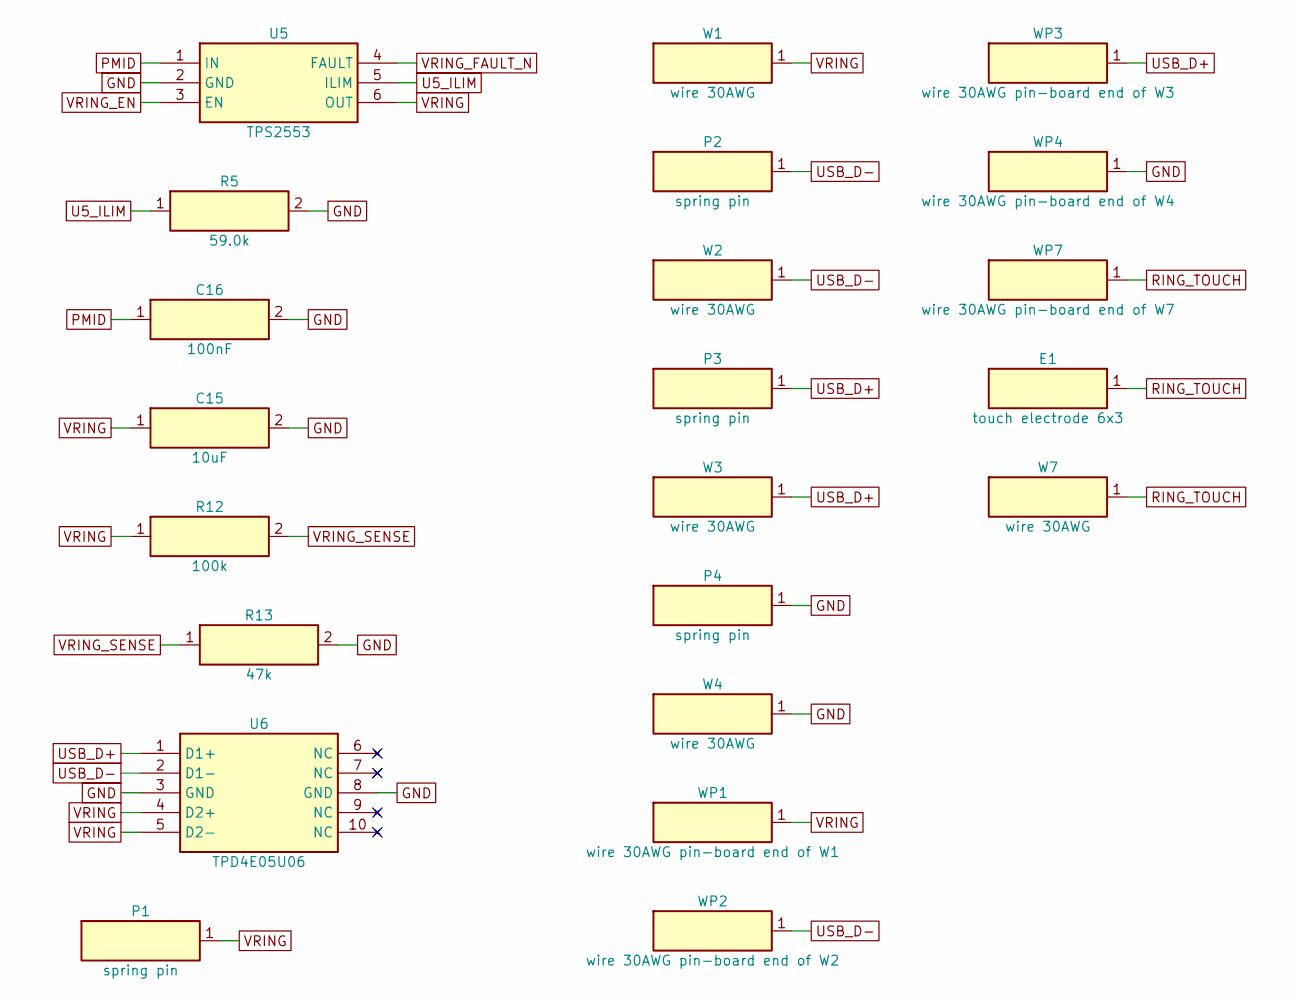
[picture p280: schematic case_ringlink.kicad_sch]

Parts:
C15: 10uF; MPN GRM188R61A106KE69D
C16: 100nF; MPN GRM155R71C104KA88D
E1: touch electrode 6x3
P1, P2, P3, P4: spring pin; MPN P70-6000045R
R5: 59.0k; MPN RC0402FR-0759KL
R12: 100k; MPN RC0402FR-07100KL
R13: 47k; MPN RC0402FR-0747KL
U5: TPS2553; MPN TPS2553DBVR
U6: TPD4E05U06; MPN TPD4E05U06DQAR
W1, W2, W3, W4, W7: wire 30AWG
WP1: wire 30AWG pin-board end of W1
WP2: wire 30AWG pin-board end of W2
WP3: wire 30AWG pin-board end of W3
WP4: wire 30AWG pin-board end of W4
WP7: wire 30AWG pin-board end of W7

Connections:
GND: C15.2, C16.2, P4.1, R5.2, R13.2, U5.2 (GND), U6.3 (GND), U6.8 (GND), W4.1, WP4.1
PMID: C16.1, U5.1 (IN)
RING_TOUCH: E1.1, W7.1, WP7.1
U5_ILIM: R5.1, U5.5 (ILIM)
USB_D+: P3.1, U6.1 (D1+), W3.1, WP3.1
USB_D-: P2.1, U6.2 (D1-), W2.1, WP2.1
VRING: C15.1, P1.1, R12.1, U5.6 (OUT), U6.4 (D2+), U6.5 (D2-), W1.1, WP1.1
VRING_EN: U5.3 (EN)
VRING_FAULT_N: U5.4 (FAULT)
VRING_SENSE: R12.2, R13.1
