NexusGPT/openring/design/ecad/case/case_storage.kicad_sch

## KiCad design design/ecad/case/case_storage.kicad_sch (2026-11-13)

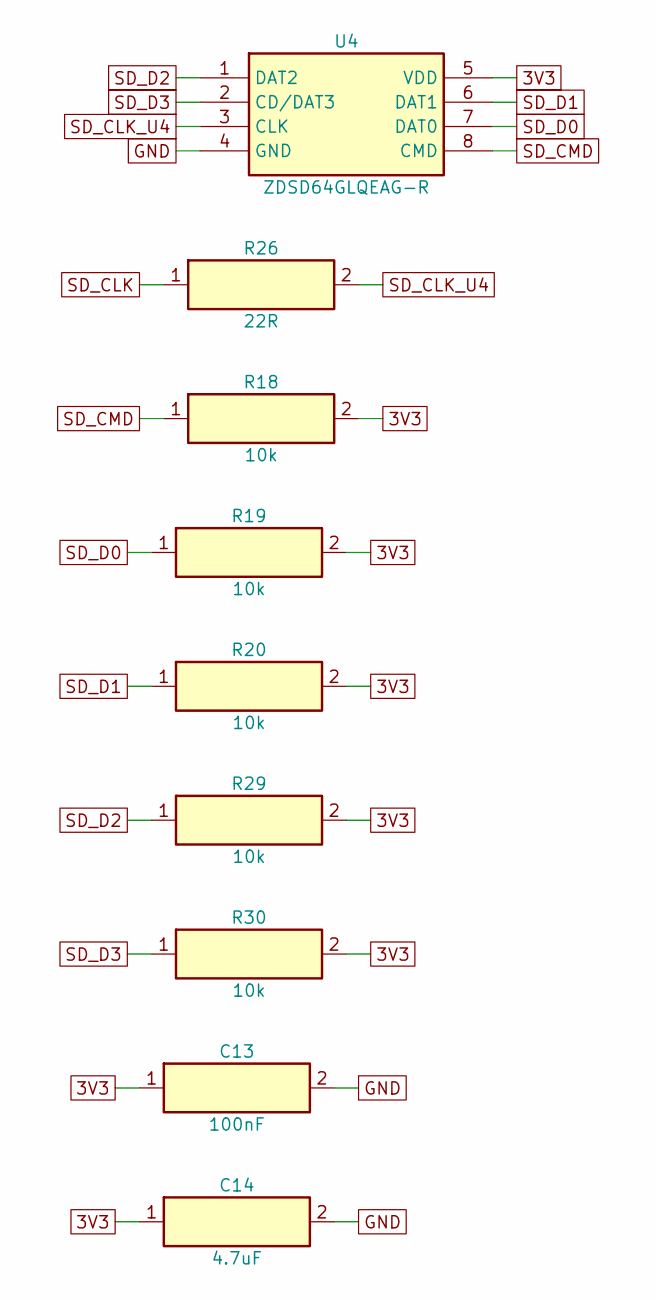
[picture p281: schematic case_storage.kicad_sch]

Parts:
C13: 100nF; MPN GRM155R71C104KA88D
C14: 4.7uF; MPN GRM188R61A475KE15D
R18, R19, R20, R29, R30: 10k; MPN RC0402FR-0710KL
R26: 22R; MPN RC0402FR-0722RL
U4: ZDSD64GLQEAG-R; MPN ZDSD64GLQEAG-R

Connections:
3V3: C13.1, C14.1, R18.2, R19.2, R20.2, R29.2, R30.2, U4.5 (VDD)
GND: C13.2, C14.2, U4.4 (GND)
SD_CLK: R26.1
SD_CLK_U4: R26.2, U4.3 (CLK)
SD_CMD: R18.1, U4.8 (CMD)
SD_D0: R19.1, U4.7 (DAT0)
SD_D1: R20.1, U4.6 (DAT1)
SD_D2: R29.1, U4.1 (DAT2)
SD_D3: R30.1, U4.2 (CD/DAT3)
