NexusGPT/openring/design/ecad/case/case_test.kicad_sch

## KiCad design design/ecad/case/case_test.kicad_sch (2026-11-13)

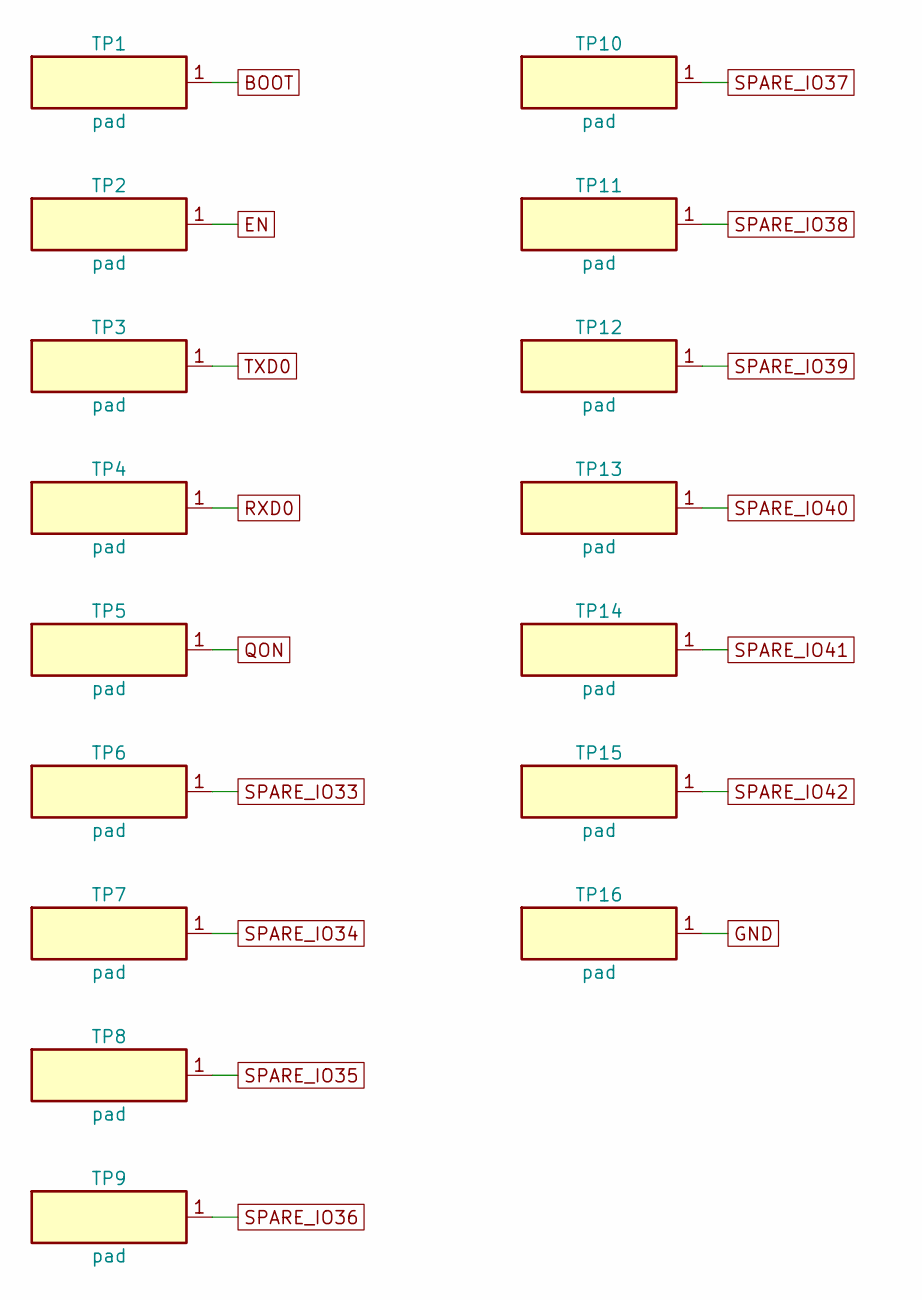
[picture p282: schematic case_test.kicad_sch]

Parts:
TP1, TP2, TP3, TP4, TP5, TP6, TP7, TP8, TP9, TP10, TP11, TP12, TP13, TP14, TP15, TP16: pad

Connections:
BOOT: TP1.1
EN: TP2.1
GND: TP16.1
QON: TP5.1
RXD0: TP4.1
SPARE_IO33: TP6.1
SPARE_IO34: TP7.1
SPARE_IO35: TP8.1
SPARE_IO36: TP9.1
SPARE_IO37: TP10.1
SPARE_IO38: TP11.1
SPARE_IO39: TP12.1
SPARE_IO40: TP13.1
SPARE_IO41: TP14.1
SPARE_IO42: TP15.1
TXD0: TP3.1
