NexusGPT/openring/design/ecad/case/case_usbc.kicad_sch

## KiCad design design/ecad/case/case_usbc.kicad_sch (2026-11-13)

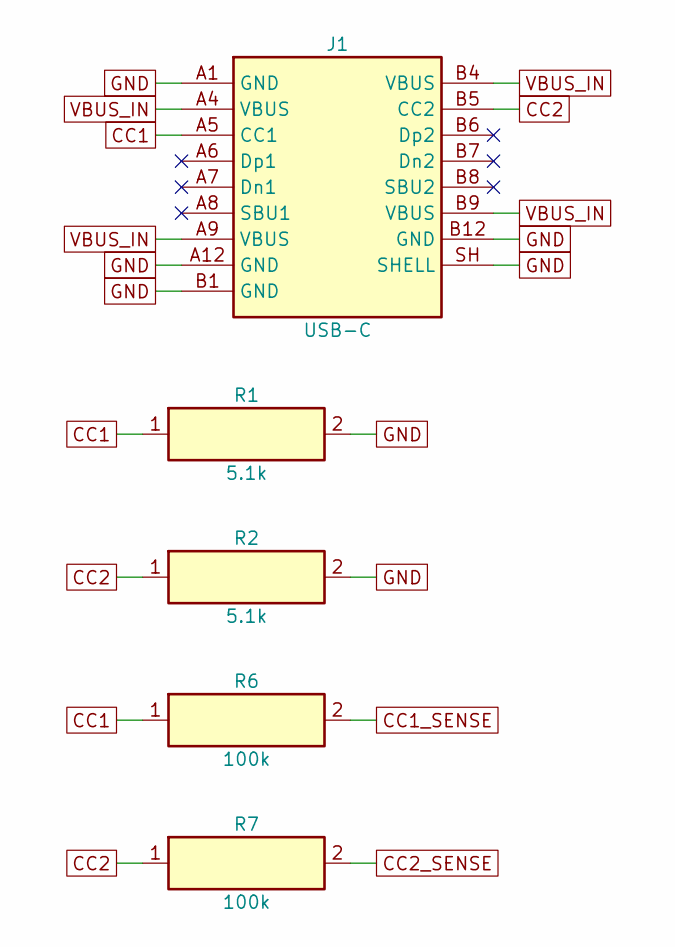
[picture p283: schematic case_usbc.kicad_sch]

Parts:
J1: USB-C; MPN USB4105-GF-A
R1, R2: 5.1k; MPN RC0402FR-075K1L
R6, R7: 100k; MPN RC0402FR-07100KL

Connections:
CC1: J1.A5 (CC1), R1.1, R6.1
CC1_SENSE: R6.2
CC2: J1.B5 (CC2), R2.1, R7.1
CC2_SENSE: R7.2
GND: J1.A1 (GND), J1.A12 (GND), J1.B1 (GND), J1.B12 (GND), J1.SH (SHELL), R1.2, R2.2
VBUS_IN: J1.A4 (VBUS), J1.A9 (VBUS), J1.B4 (VBUS), J1.B9 (VBUS)
