NexusGPT/openring/design/ecad/case/evidence/broken/erc_probe/case_storage.kicad_sch

## KiCad design design/ecad/case/evidence/broken/erc_probe/case_storage.kicad_sch (2026-11-13)

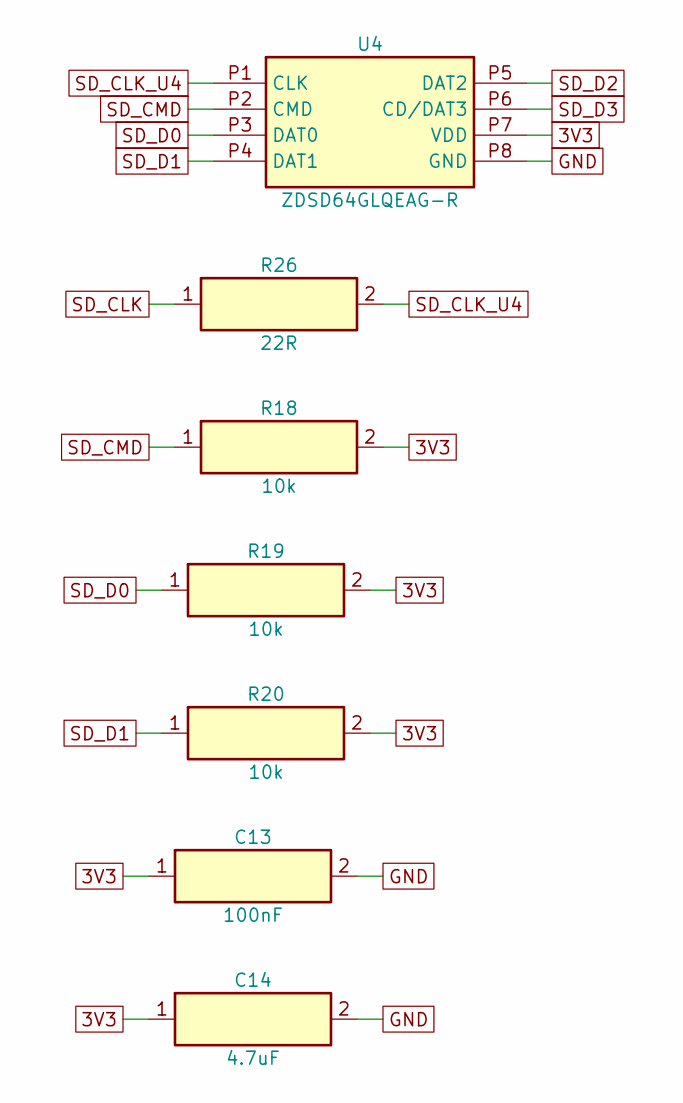
[picture p287: schematic case_storage.kicad_sch]

Parts:
C13: 100nF
C14: 4.7uF
R18, R19, R20: 10k
R26: 22R
U4: ZDSD64GLQEAG-R; MPN ZDSD64GLQEAG-R

Connections:
3V3: C13.1, C14.1, R18.2, R19.2, R20.2, U4.P7 (VDD)
GND: C13.2, C14.2, U4.P8 (GND)
SD_CLK: R26.1
SD_CLK_U4: R26.2, U4.P1 (CLK)
SD_CMD: R18.1, U4.P2 (CMD)
SD_D0: R19.1, U4.P3 (DAT0)
SD_D1: R20.1, U4.P4 (DAT1)
SD_D2: U4.P5 (DAT2)
SD_D3: U4.P6 (CD/DAT3)
