NexusGPT/openring/design/ecad/ring/evidence/broken/erc_probe/ring_contacts.kicad_sch

## KiCad design design/ecad/ring/evidence/broken/erc_probe/ring_contacts.kicad_sch (2026-11-13)

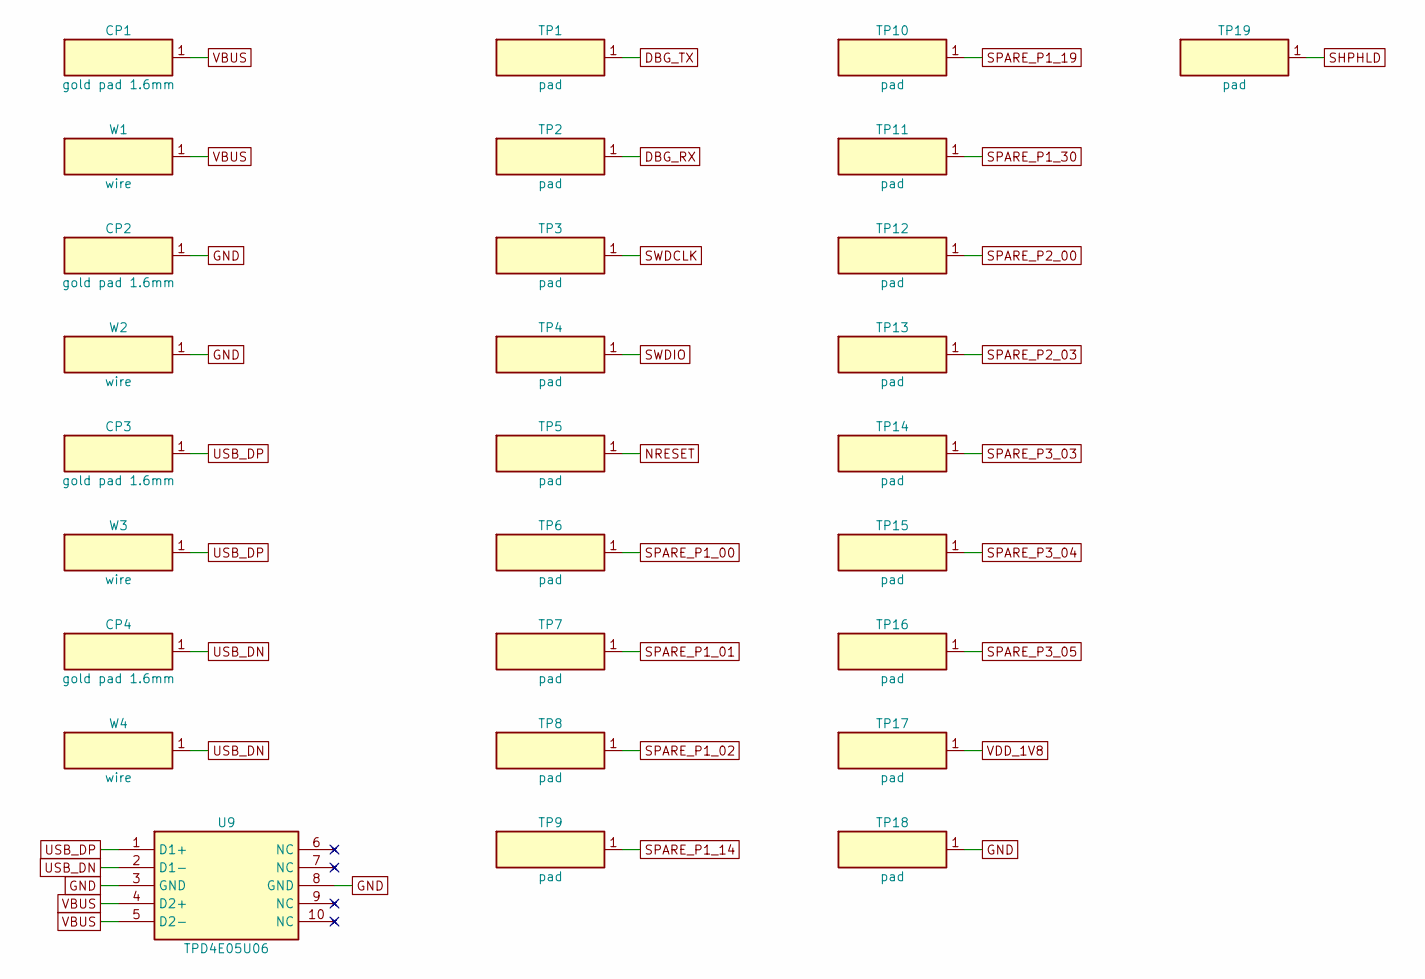
[picture p288: schematic ring_contacts.kicad_sch]

Parts:
CP1, CP2, CP3, CP4: gold pad 1.6mm
TP1, TP2, TP3, TP4, TP5, TP6, TP7, TP8, TP9, TP10, TP11, TP12, TP13, TP14, TP15, TP16, TP17, TP18, TP19: pad
U9: TPD4E05U06; MPN TPD4E05U06DQAR
W1, W2, W3, W4: wire; MPN 2841/1 BL001

Connections:
DBG_RX: TP2.1
DBG_TX: TP1.1
GND: CP2.1, TP18.1, U9.3 (GND), U9.8 (GND), W2.1
NRESET: TP5.1
SHPHLD: TP19.1
SPARE_P1_00: TP6.1
SPARE_P1_01: TP7.1
SPARE_P1_02: TP8.1
SPARE_P1_14: TP9.1
SPARE_P1_19: TP10.1
SPARE_P1_30: TP11.1
SPARE_P2_00: TP12.1
SPARE_P2_03: TP13.1
SPARE_P3_03: TP14.1
SPARE_P3_04: TP15.1
SPARE_P3_05: TP16.1
SWDCLK: TP3.1
SWDIO: TP4.1
USB_DN: CP4.1, U9.2 (D1-), W4.1
USB_DP: CP3.1, U9.1 (D1+), W3.1
VBUS: CP1.1, U9.4 (D2+), U9.5 (D2-), W1.1
VDD_1V8: TP17.1
