NexusGPT/openring/design/ecad/ring/evidence/broken/erc_probe/ring_controls.kicad_sch

## KiCad design design/ecad/ring/evidence/broken/erc_probe/ring_controls.kicad_sch (2026-11-13)

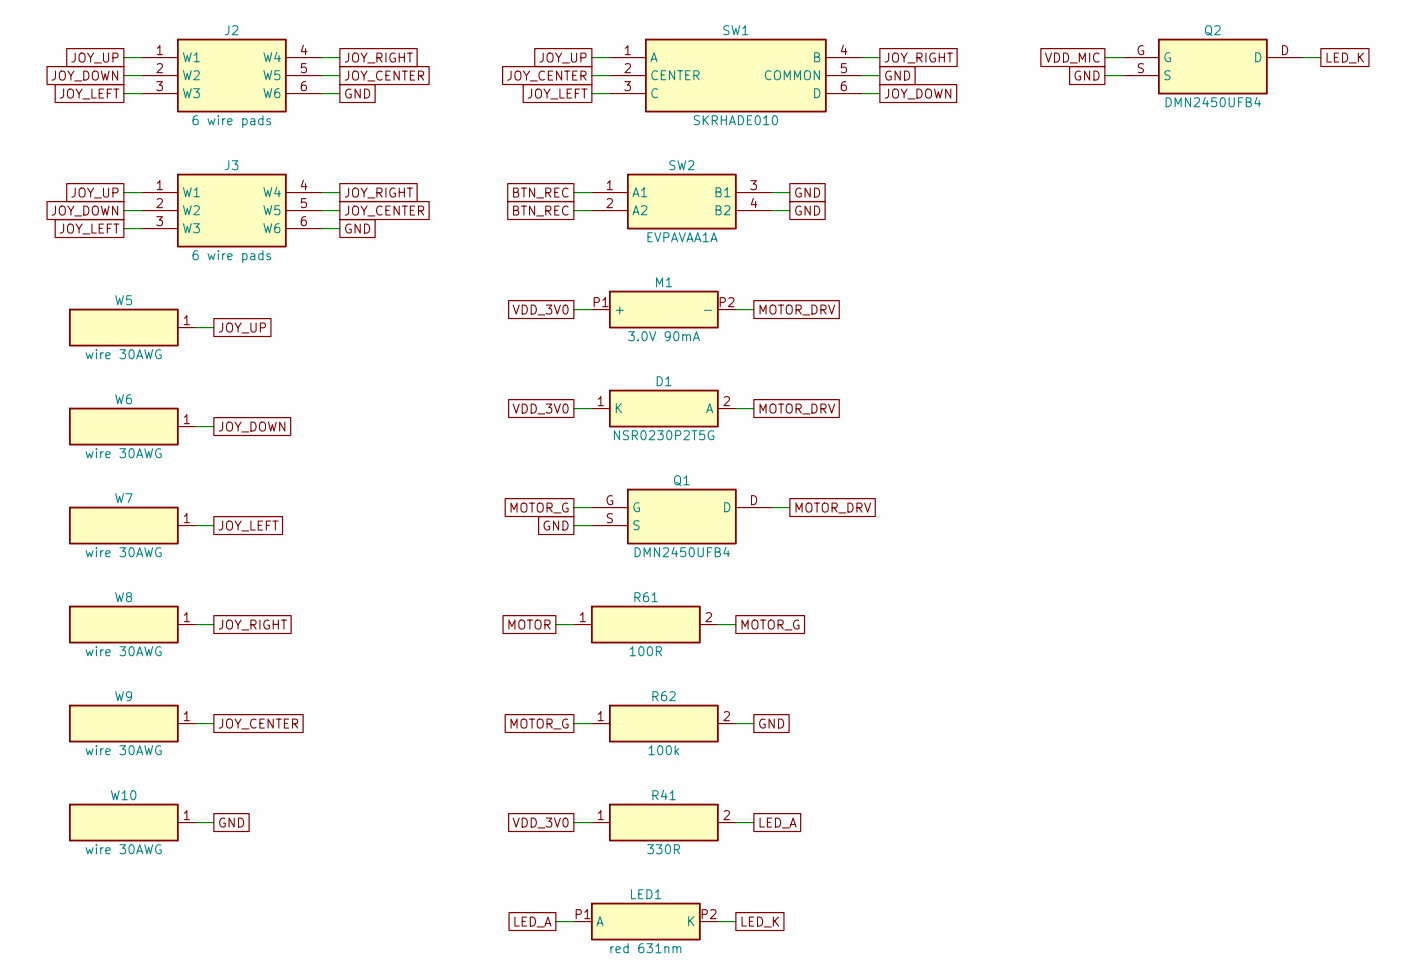
[picture p289: schematic ring_controls.kicad_sch]

Parts:
D1: NSR0230P2T5G; MPN NSR0230P2T5G
J2, J3: 6 wire pads
LED1: red 631nm; MPN KPG-1005SURC-TT
M1: 3.0V 90mA; MPN KPD3A-03208-05-05D-0
Q1, Q2: DMN2450UFB4; MPN DMN2450UFB4
R41: 330R; MPN RC0201FR-07330RL
R61: 100R
R62: 100k
SW1: SKRHADE010; MPN SKRHADE010
SW2: EVPAVAA1A; MPN EVPAVAA1A
W5, W6, W7, W8, W9, W10: wire 30AWG; MPN 2841/1 BL001

Connections:
BTN_REC: SW2.1 (A1), SW2.2 (A2)
GND: J2.6 (W6), J3.6 (W6), Q1.S, Q2.S, R62.2, SW1.5 (COMMON), SW2.3 (B1), SW2.4 (B2), W10.1
JOY_CENTER: J2.5 (W5), J3.5 (W5), SW1.2 (CENTER), W9.1
JOY_DOWN: J2.2 (W2), J3.2 (W2), SW1.6 (D), W6.1
JOY_LEFT: J2.3 (W3), J3.3 (W3), SW1.3 (C), W7.1
JOY_RIGHT: J2.4 (W4), J3.4 (W4), SW1.4 (B), W8.1
JOY_UP: J2.1 (W1), J3.1 (W1), SW1.1 (A), W5.1
LED_A: LED1.P1 (A), R41.2
LED_K: LED1.P2 (K), Q2.D
MOTOR: R61.1
MOTOR_DRV: D1.2 (A), M1.P2 (-), Q1.D
MOTOR_G: Q1.G, R61.2, R62.1
VDD_3V0: D1.1 (K), M1.P1 (+), R41.1
VDD_MIC: Q2.G
