NexusGPT/openring/design/ecad/ring/evidence/broken/erc_probe/ring_main.kicad_sch

## KiCad design design/ecad/ring/evidence/broken/erc_probe/ring_main.kicad_sch (2026-11-13)

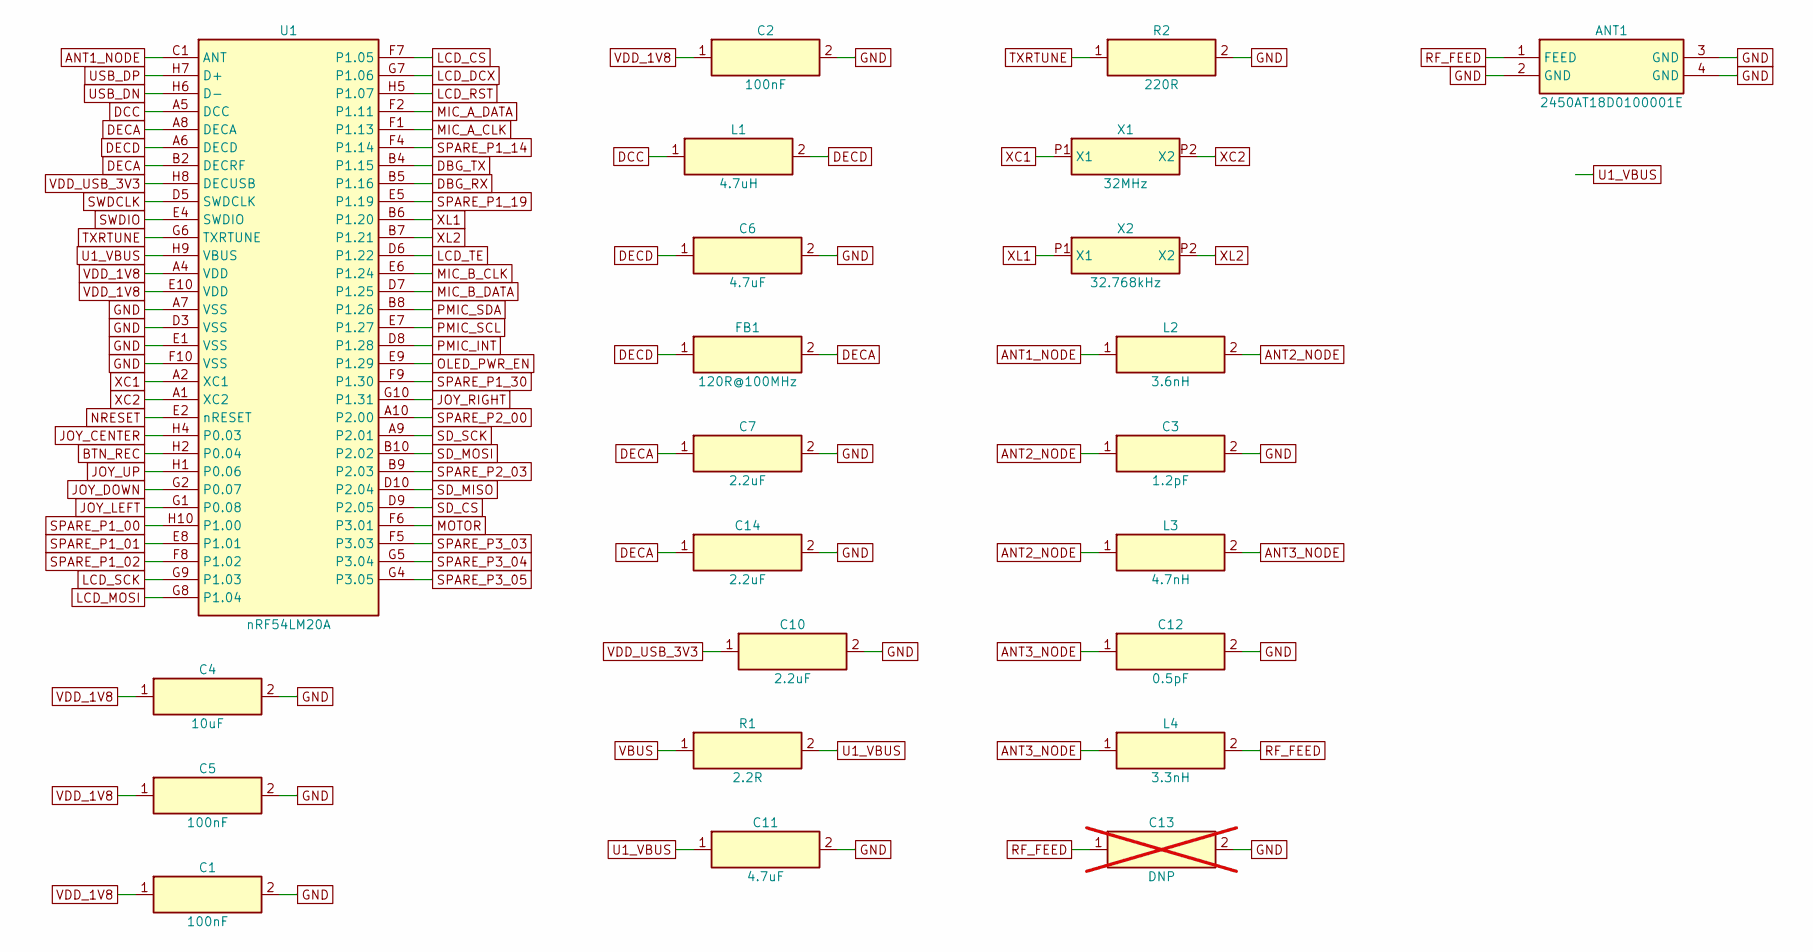
[picture p290: schematic ring_main.kicad_sch]

Parts:
ANT1: 2450AT18D0100001E; MPN 2450AT18D0100001E
C1, C2, C5: 100nF; MPN CL03A104KP3NNNC
C3: 1.2pF; MPN GJM0335C1H1R2WB01D
C4: 10uF; MPN GRM155R60J106ME15D
C6: 4.7uF; MPN GRM035R60J475ME15J
C7, C10, C14: 2.2uF; MPN GRM033D80E225ME47D
C11: 4.7uF; MPN GRM155R61A475MEAAD
C12: 0.5pF; MPN GJM0335C1ER50WB01D
C13: DNP; not fitted
FB1: 120R@100MHz; MPN BLM03AG121SN1D
L1: 4.7uH; MPN MLZ1608M4R7WT000
L2: 3.6nH; MPN LQP03HQ3N6B02
L3: 4.7nH; MPN LQP03HQ4N7H02
L4: 3.3nH; MPN LQP03HQ3N3B02
R1: 2.2R; MPN RC0603FR-072R2L
R2: 220R; MPN RC0201FR-07220RL
U1: nRF54LM20A; MPN NRF54LM20A-CAAA-R7
X1: 32MHz; MPN CX2016DB32000D0WZRC1
X2: 32.768kHz; MPN 9HT11-32.768KDZC-T

Connections:
ANT1_NODE: L2.1, U1.C1 (ANT)
ANT2_NODE: C3.1, L2.2, L3.1
ANT3_NODE: C12.1, L3.2, L4.1
BTN_REC: U1.H2 (P0.04)
DBG_RX: U1.B5 (P1.16)
DBG_TX: U1.B4 (P1.15)
DCC: L1.1, U1.A5 (DCC)
DECA: C7.1, C14.1, FB1.2, U1.A8 (DECA), U1.B2 (DECRF)
DECD: C6.1, FB1.1, L1.2, U1.A6 (DECD)
GND: ANT1.2 (GND), ANT1.3 (GND), ANT1.4 (GND), C1.2, C2.2, C3.2, C4.2, C5.2, C6.2, C7.2, C10.2, C11.2, C12.2, C13.2, C14.2, R2.2, U1.A7 (VSS), U1.D3 (VSS), U1.E1 (VSS), U1.F10 (VSS)
JOY_CENTER: U1.H4 (P0.03)
JOY_DOWN: U1.G2 (P0.07)
JOY_LEFT: U1.G1 (P0.08)
JOY_RIGHT: U1.G10 (P1.31)
JOY_UP: U1.H1 (P0.06)
LCD_CS: U1.F7 (P1.05)
LCD_DCX: U1.G7 (P1.06)
LCD_MOSI: U1.G8 (P1.04)
LCD_RST: U1.H5 (P1.07)
LCD_SCK: U1.G9 (P1.03)
LCD_TE: U1.D6 (P1.22)
MIC_A_CLK: U1.F1 (P1.13)
MIC_A_DATA: U1.F2 (P1.11)
MIC_B_CLK: U1.E6 (P1.24)
MIC_B_DATA: U1.D7 (P1.25)
MOTOR: U1.F6 (P3.01)
NRESET: U1.E2 (nRESET)
OLED_PWR_EN: U1.E9 (P1.29)
PMIC_INT: U1.D8 (P1.28)
PMIC_SCL: U1.E7 (P1.27)
PMIC_SDA: U1.B8 (P1.26)
RF_FEED: ANT1.1 (FEED), C13.1, L4.2
SD_CS: U1.D9 (P2.05)
SD_MISO: U1.D10 (P2.04)
SD_MOSI: U1.B10 (P2.02)
SD_SCK: U1.A9 (P2.01)
SPARE_P1_00: U1.H10 (P1.00)
SPARE_P1_01: U1.E8 (P1.01)
SPARE_P1_02: U1.F8 (P1.02)
SPARE_P1_14: U1.F4 (P1.14)
SPARE_P1_19: U1.E5 (P1.19)
SPARE_P1_30: U1.F9 (P1.30)
SPARE_P2_00: U1.A10 (P2.00)
SPARE_P2_03: U1.B9 (P2.03)
SPARE_P3_03: U1.F5 (P3.03)
SPARE_P3_04: U1.G5 (P3.04)
SPARE_P3_05: U1.G4 (P3.05)
SWDCLK: U1.D5 (SWDCLK)
SWDIO: U1.E4 (SWDIO)
TXRTUNE: R2.1, U1.G6 (TXRTUNE)
U1_VBUS: C11.1, R1.2, U1.H9 (VBUS)
USB_DN: U1.H6 (D-)
USB_DP: U1.H7 (D+)
VBUS: R1.1
VDD_1V8: C1.1, C2.1, C4.1, C5.1, U1.A4 (VDD), U1.E10 (VDD)
VDD_USB_3V3: C10.1, U1.H8 (DECUSB)
XC1: U1.A2 (XC1), X1.P1 (X1)
XC2: U1.A1 (XC2), X1.P2 (X2)
XL1: U1.B6 (P1.20), X2.P1 (X1)
XL2: U1.B7 (P1.21), X2.P2 (X2)
