NexusGPT/openring/design/ecad/ring/evidence/broken/erc_probe/ring_mics.kicad_sch

## KiCad design design/ecad/ring/evidence/broken/erc_probe/ring_mics.kicad_sch (2026-11-13)

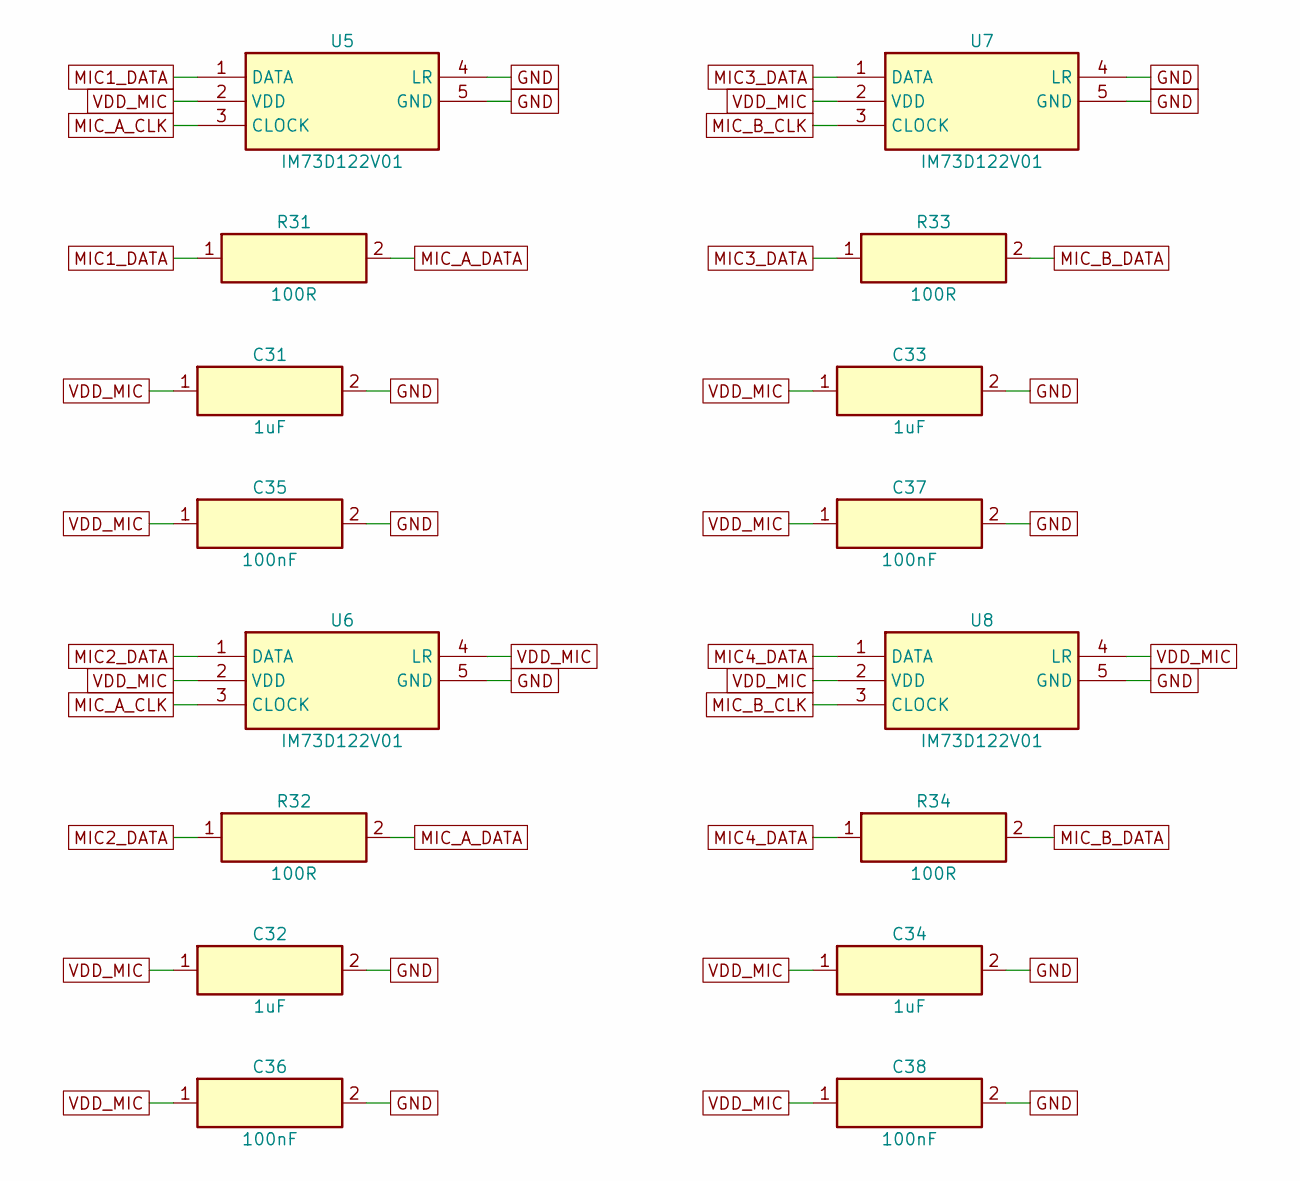
[picture p291: schematic ring_mics.kicad_sch]

Parts:
C31, C32, C33, C34: 1uF; MPN GRM033R60J105MEA2D
C35, C36, C37, C38: 100nF; MPN CL03A104KP3NNNC
R31, R32, R33, R34: 100R; MPN RC0201FR-07100RL
U5, U6, U7, U8: IM73D122V01; MPN IM73D122V01XTMA1

Connections:
GND: C31.2, C32.2, C33.2, C34.2, C35.2, C36.2, C37.2, C38.2, U5.4 (LR), U5.5 (GND), U6.5 (GND), U7.4 (LR), U7.5 (GND), U8.5 (GND)
MIC1_DATA: R31.1, U5.1 (DATA)
MIC2_DATA: R32.1, U6.1 (DATA)
MIC3_DATA: R33.1, U7.1 (DATA)
MIC4_DATA: R34.1, U8.1 (DATA)
MIC_A_CLK: U5.3 (CLOCK), U6.3 (CLOCK)
MIC_A_DATA: R31.2, R32.2
MIC_B_CLK: U7.3 (CLOCK), U8.3 (CLOCK)
MIC_B_DATA: R33.2, R34.2
VDD_MIC: C31.1, C32.1, C33.1, C34.1, C35.1, C36.1, C37.1, C38.1, U5.2 (VDD), U6.2 (VDD), U6.4 (LR), U7.2 (VDD), U8.2 (VDD), U8.4 (LR)
