NexusGPT/openring/design/ecad/ring/evidence/broken/erc_probe/ring_power.kicad_sch

## KiCad design design/ecad/ring/evidence/broken/erc_probe/ring_power.kicad_sch (2026-11-13)

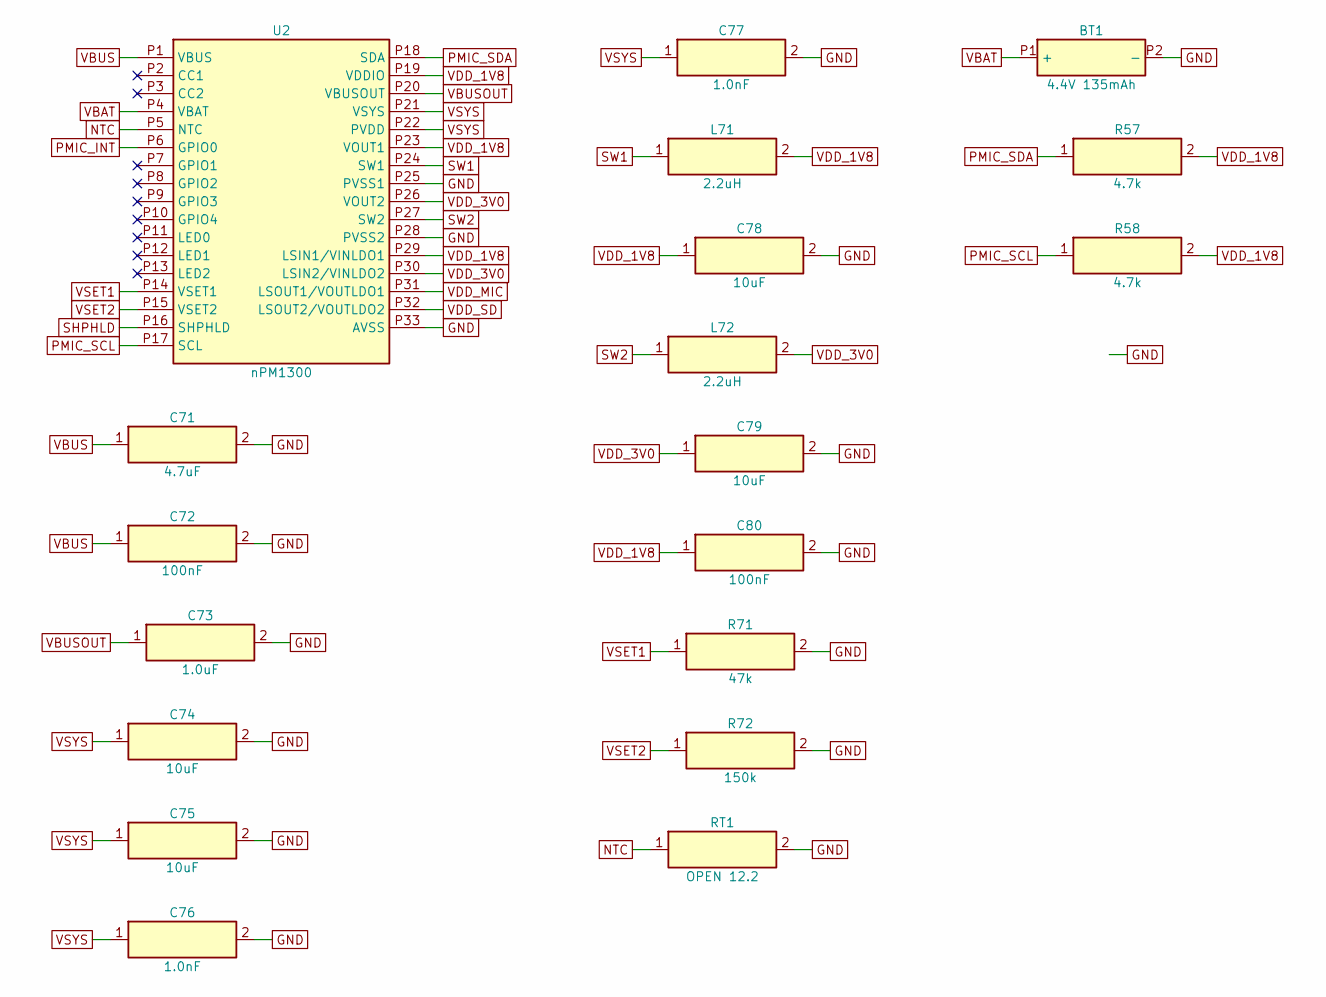
[picture p292: schematic ring_power.kicad_sch]

Parts:
BT1: 4.4V 135mAh; MPN Grepow custom
C71: 4.7uF
C72, C80: 100nF
C73: 1.0uF
C74, C75, C78, C79: 10uF
C76, C77: 1.0nF
L71, L72: 2.2uH; MPN OPEN 12.2
R57, R58: 4.7k; MPN RC0201FR-074K7L
R71: 47k; MPN RC0201FR-0747KL
R72: 150k; MPN RC0201FR-07150KL
RT1: OPEN 12.2; MPN OPEN 12.2
U2: nPM1300; MPN NPM1300-CAAA-R

Connections:
GND: BT1.P2 (-), C71.2, C72.2, C73.2, C74.2, C75.2, C76.2, C77.2, C78.2, C79.2, C80.2, R71.2, R72.2, RT1.2, U2.P25 (PVSS1), U2.P28 (PVSS2), U2.P33 (AVSS)
NTC: RT1.1, U2.P5 (NTC)
PMIC_INT: U2.P6 (GPIO0)
PMIC_SCL: R58.1, U2.P17 (SCL)
PMIC_SDA: R57.1, U2.P18 (SDA)
SHPHLD: U2.P16 (SHPHLD)
SW1: L71.1, U2.P24 (SW1)
SW2: L72.1, U2.P27 (SW2)
VBAT: BT1.P1 (+), U2.P4 (VBAT)
VBUS: C71.1, C72.1, U2.P1 (VBUS)
VBUSOUT: C73.1, U2.P20 (VBUSOUT)
VDD_1V8: C78.1, C80.1, L71.2, R57.2, R58.2, U2.P19 (VDDIO), U2.P23 (VOUT1), U2.P29 (LSIN1/VINLDO1)
VDD_3V0: C79.1, L72.2, U2.P26 (VOUT2), U2.P30 (LSIN2/VINLDO2)
VDD_MIC: U2.P31 (LSOUT1/VOUTLDO1)
VDD_SD: U2.P32 (LSOUT2/VOUTLDO2)
VSET1: R71.1, U2.P14 (VSET1)
VSET2: R72.1, U2.P15 (VSET2)
VSYS: C74.1, C75.1, C76.1, C77.1, U2.P21 (VSYS), U2.P22 (PVDD)
