NexusGPT/openring/design/ecad/ring/evidence/broken/erc_probe/ring_screen.kicad_sch

## KiCad design design/ecad/ring/evidence/broken/erc_probe/ring_screen.kicad_sch (2026-11-13)

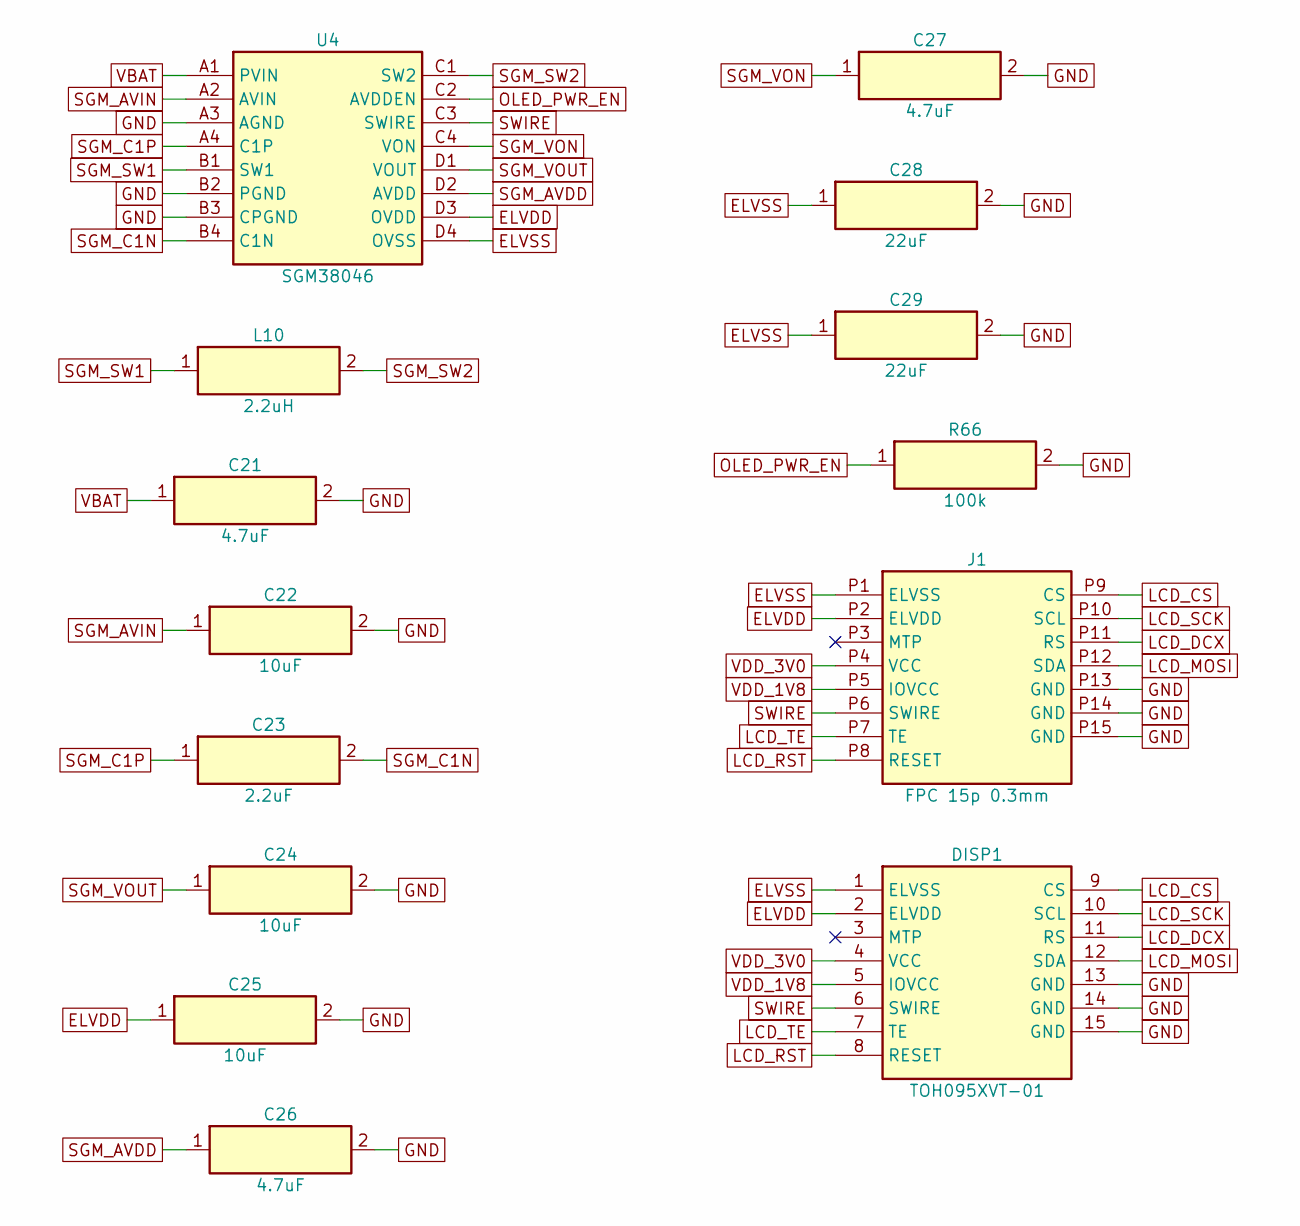
[picture p293: schematic ring_screen.kicad_sch]

Parts:
C21, C26, C27: 4.7uF; MPN GRM188R61C475KAAJD
C22: 10uF; MPN GRM155R60J106ME15
C23: 2.2uF; MPN GRM155R60J225ME15
C24, C25: 10uF; MPN GRM188R61C106KAALD
C28, C29: 22uF; MPN GRM155R60J226ME11D
DISP1: TOH095XVT-01; MPN TOH095XVT-01
J1: FPC 15p 0.3mm; MPN FH35C-15S-0.3SHW(50)
L10: 2.2uH; MPN 1269AS-H-2R2M=P2
R66: 100k
U4: SGM38046; MPN SGM38046YG/TR

Connections:
ELVDD: C25.1, DISP1.2 (ELVDD), J1.P2 (ELVDD), U4.D3 (OVDD)
ELVSS: C28.1, C29.1, DISP1.1 (ELVSS), J1.P1 (ELVSS), U4.D4 (OVSS)
GND: C21.2, C22.2, C24.2, C25.2, C26.2, C27.2, C28.2, C29.2, DISP1.13 (GND), DISP1.14 (GND), DISP1.15 (GND), J1.P13 (GND), J1.P14 (GND), J1.P15 (GND), R66.2, U4.A3 (AGND), U4.B2 (PGND), U4.B3 (CPGND)
LCD_CS: DISP1.9 (CS), J1.P9 (CS)
LCD_DCX: DISP1.11 (RS), J1.P11 (RS)
LCD_MOSI: DISP1.12 (SDA), J1.P12 (SDA)
LCD_RST: DISP1.8 (RESET), J1.P8 (RESET)
LCD_SCK: DISP1.10 (SCL), J1.P10 (SCL)
LCD_TE: DISP1.7 (TE), J1.P7 (TE)
OLED_PWR_EN: R66.1, U4.C2 (AVDDEN)
SGM_AVDD: C26.1, U4.D2 (AVDD)
SGM_AVIN: C22.1, U4.A2 (AVIN)
SGM_C1N: C23.2, U4.B4 (C1N)
SGM_C1P: C23.1, U4.A4 (C1P)
SGM_SW1: L10.1, U4.B1 (SW1)
SGM_SW2: L10.2, U4.C1 (SW2)
SGM_VON: C27.1, U4.C4 (VON)
SGM_VOUT: C24.1, U4.D1 (VOUT)
SWIRE: DISP1.6 (SWIRE), J1.P6 (SWIRE), U4.C3 (SWIRE)
VBAT: C21.1, U4.A1 (PVIN)
VDD_1V8: DISP1.5 (IOVCC), J1.P5 (IOVCC)
VDD_3V0: DISP1.4 (VCC), J1.P4 (VCC)
