NexusGPT/openring/design/ecad/ring/evidence/broken/erc_probe/ring_storage.kicad_sch

## KiCad design design/ecad/ring/evidence/broken/erc_probe/ring_storage.kicad_sch (2026-11-13)

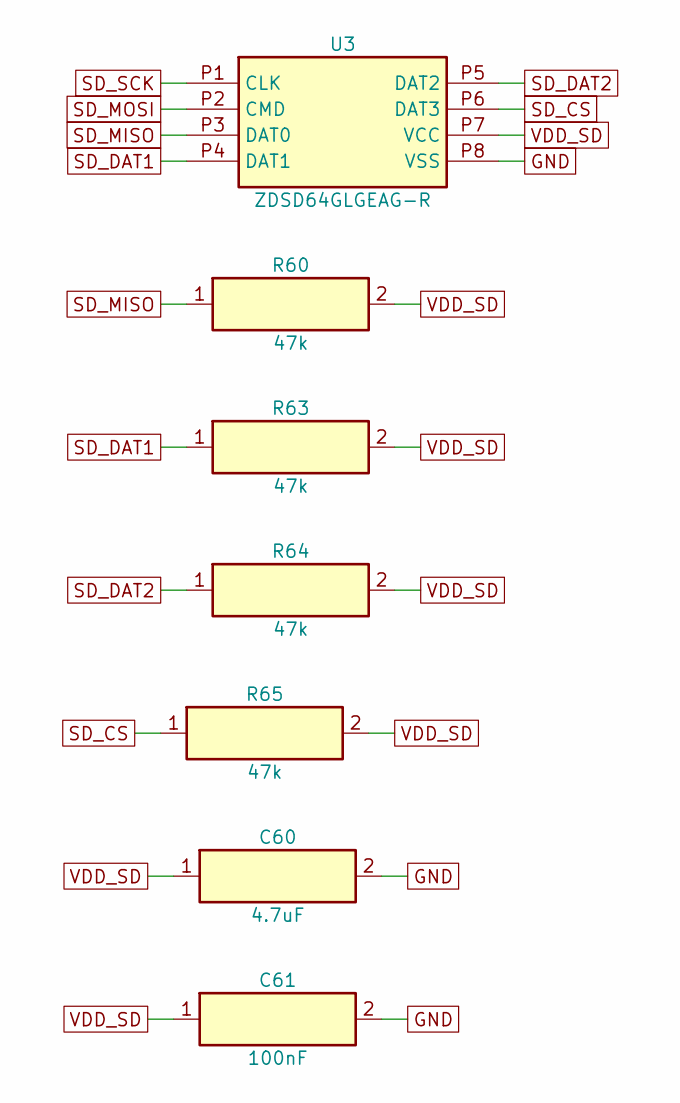
[picture p294: schematic ring_storage.kicad_sch]

Parts:
C60: 4.7uF
C61: 100nF
R60, R63, R64, R65: 47k
U3: ZDSD64GLGEAG-R; MPN ZDSD64GLGEAG-R

Connections:
GND: C60.2, C61.2, U3.P8 (VSS)
SD_CS: R65.1, U3.P6 (DAT3)
SD_DAT1: R63.1, U3.P4 (DAT1)
SD_DAT2: R64.1, U3.P5 (DAT2)
SD_MISO: R60.1, U3.P3 (DAT0)
SD_MOSI: U3.P2 (CMD)
SD_SCK: U3.P1 (CLK)
VDD_SD: C60.1, C61.1, R60.2, R63.2, R64.2, R65.2, U3.P7 (VCC)
