NexusGPT/openring/design/ecad/ring/evidence/v7/before/ring_controls.kicad_sch

## KiCad design design/ecad/ring/evidence/v7/before/ring_controls.kicad_sch (2026-11-13)

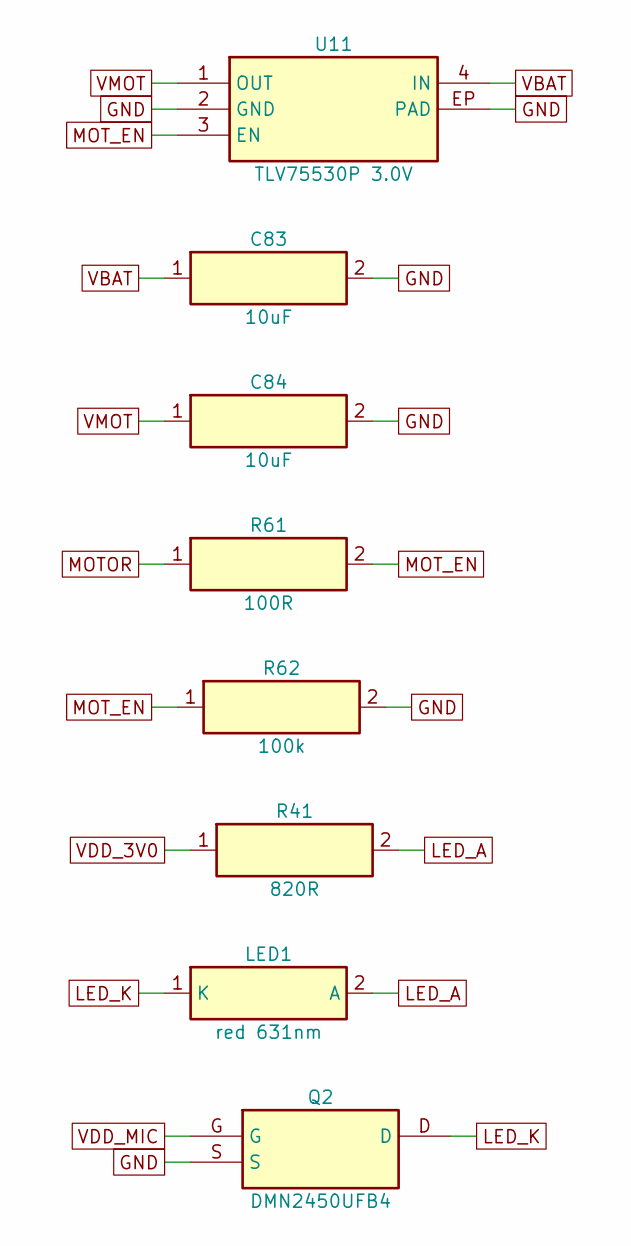
[picture p295: schematic ring_controls.kicad_sch]

Parts:
C83, C84: 10uF; MPN GRM155R60J106ME15
LED1: red 631nm; MPN KPG-1005SURC-TT
Q2: DMN2450UFB4; MPN DMN2450UFB4
R41: 820R
R61: 100R; MPN RC0201FR-07100RL
R62: 100k; MPN RC0201FR-07100KL
U11: TLV75530P 3.0V; MPN TLV75530PDQNR

Connections:
GND: C83.2, C84.2, Q2.S, R62.2, U11.2 (GND), U11.EP (PAD)
LED_A: LED1.2 (A), R41.2
LED_K: LED1.1 (K), Q2.D
MOTOR: R61.1
MOT_EN: R61.2, R62.1, U11.3 (EN)
VBAT: C83.1, U11.4 (IN)
VDD_3V0: R41.1
VDD_MIC: Q2.G
VMOT: C84.1, U11.1 (OUT)
