NexusGPT/openring/design/ecad/ring/evidence/a5/broken/title_a3/ring_band.kicad_sch

## KiCad design design/ecad/ring/evidence/a5/broken/title_a3/ring_band.kicad_sch (2026-11-13)

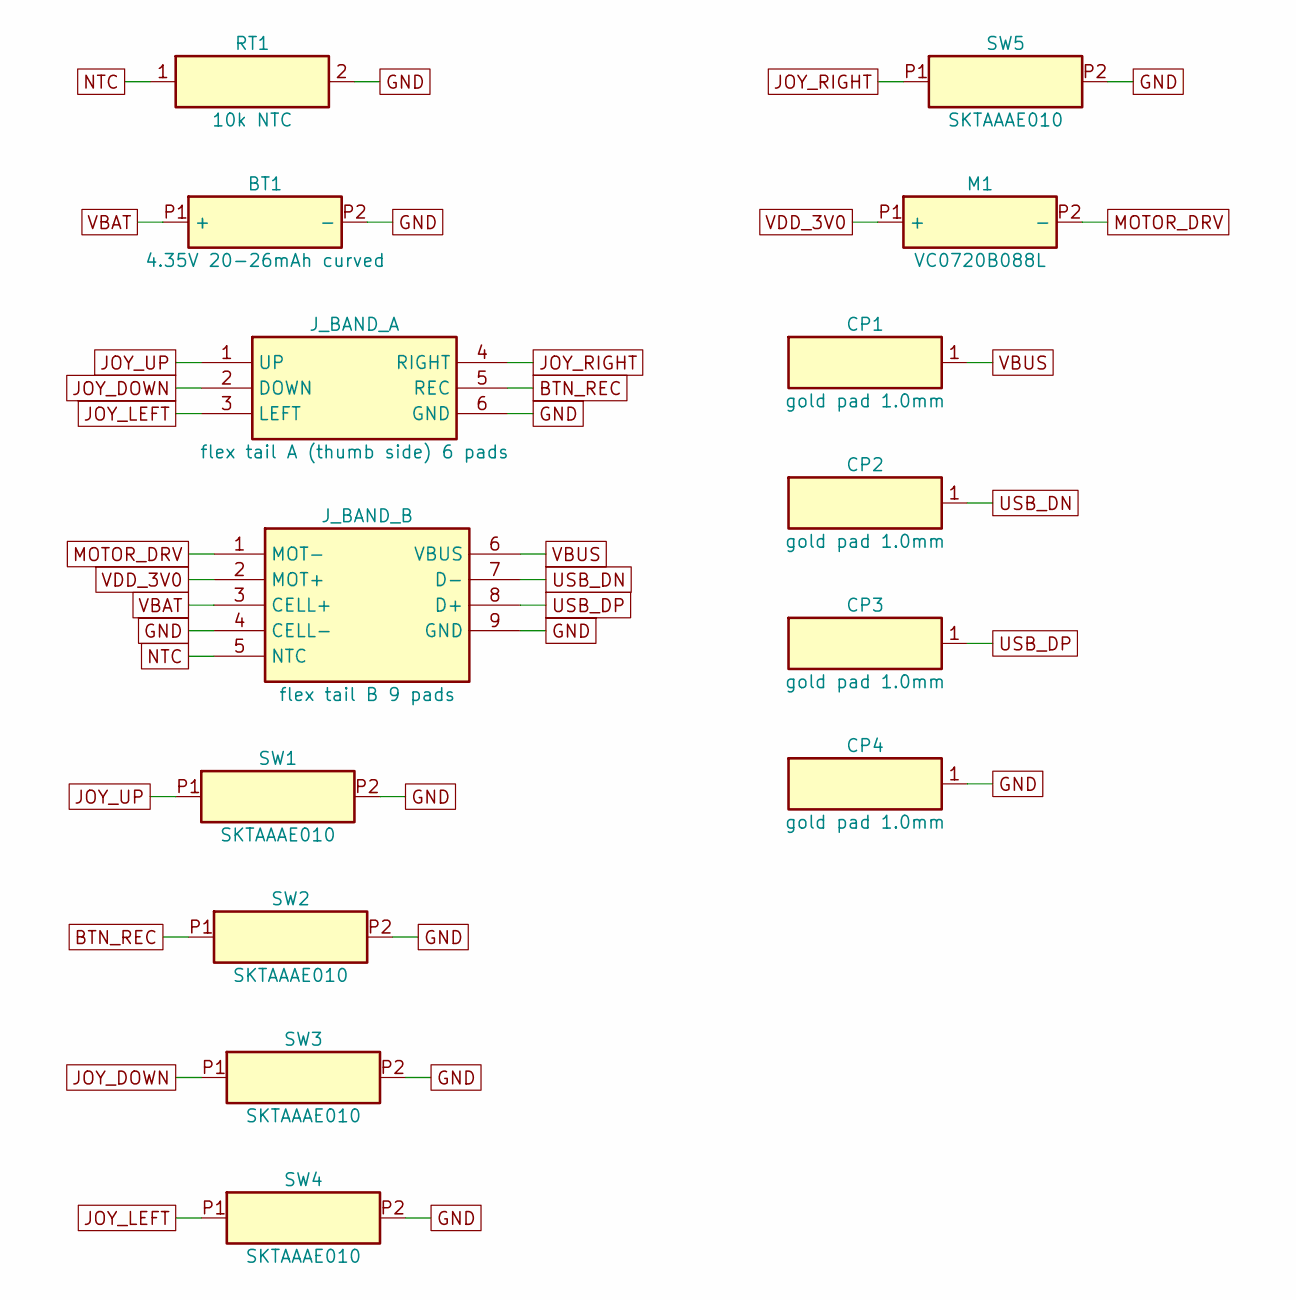
[picture p296: schematic ring_band.kicad_sch]

Parts:
BT1: 4.35V 20-26mAh curved; MPN Grepow custom
CP1, CP2, CP3, CP4: gold pad 1.0mm
J_BAND_A: flex tail A (thumb side) 6 pads
J_BAND_B: flex tail B 9 pads
M1: VC0720B088L; MPN VC0720B088L
RT1: 10k NTC; MPN OPEN 12.2
SW1, SW2, SW3, SW4, SW5: SKTAAAE010; MPN SKTAAAE010

Connections:
BTN_REC: J_BAND_A.5 (REC), SW2.P1
GND: BT1.P2 (-), CP4.1, J_BAND_A.6 (GND), J_BAND_B.4 (CELL-), J_BAND_B.9 (GND), RT1.2, SW1.P2, SW2.P2, SW3.P2, SW4.P2, SW5.P2
JOY_DOWN: J_BAND_A.2 (DOWN), SW3.P1
JOY_LEFT: J_BAND_A.3 (LEFT), SW4.P1
JOY_RIGHT: J_BAND_A.4 (RIGHT), SW5.P1
JOY_UP: J_BAND_A.1 (UP), SW1.P1
MOTOR_DRV: J_BAND_B.1 (MOT-), M1.P2 (-)
NTC: J_BAND_B.5 (NTC), RT1.1
USB_DN: CP2.1, J_BAND_B.7 (D-)
USB_DP: CP3.1, J_BAND_B.8 (D+)
VBAT: BT1.P1 (+), J_BAND_B.3 (CELL+)
VBUS: CP1.1, J_BAND_B.6 (VBUS)
VDD_3V0: J_BAND_B.2 (MOT+), M1.P1 (+)
