NexusGPT/openring/design/ecad/ring/evidence/a5/broken/title_a3/ring_contacts.kicad_sch

## KiCad design design/ecad/ring/evidence/a5/broken/title_a3/ring_contacts.kicad_sch (2026-11-13)

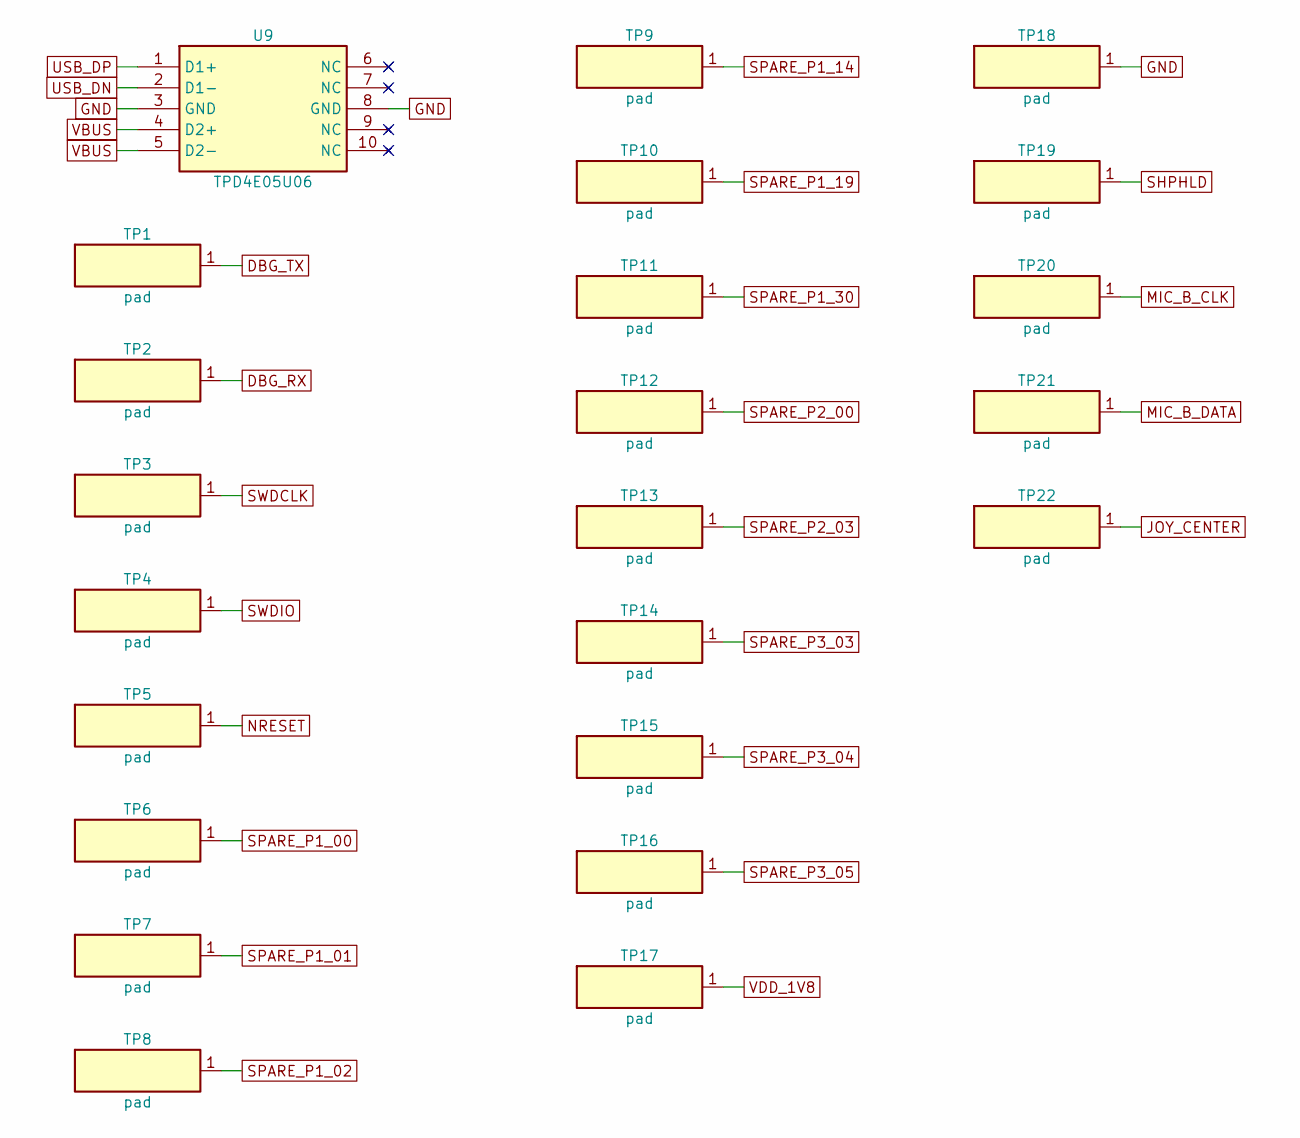
[picture p297: schematic ring_contacts.kicad_sch]

Parts:
TP1, TP2, TP3, TP4, TP5, TP6, TP7, TP8, TP9, TP10, TP11, TP12, TP13, TP14, TP15, TP16, TP17, TP18, TP19, TP20, TP21, TP22: pad
U9: TPD4E05U06; MPN TPD4E05U06DQAR

Connections:
DBG_RX: TP2.1
DBG_TX: TP1.1
GND: TP18.1, U9.3 (GND), U9.8 (GND)
JOY_CENTER: TP22.1
MIC_B_CLK: TP20.1
MIC_B_DATA: TP21.1
NRESET: TP5.1
SHPHLD: TP19.1
SPARE_P1_00: TP6.1
SPARE_P1_01: TP7.1
SPARE_P1_02: TP8.1
SPARE_P1_14: TP9.1
SPARE_P1_19: TP10.1
SPARE_P1_30: TP11.1
SPARE_P2_00: TP12.1
SPARE_P2_03: TP13.1
SPARE_P3_03: TP14.1
SPARE_P3_04: TP15.1
SPARE_P3_05: TP16.1
SWDCLK: TP3.1
SWDIO: TP4.1
USB_DN: U9.2 (D1-)
USB_DP: U9.1 (D1+)
VBUS: U9.4 (D2+), U9.5 (D2-)
VDD_1V8: TP17.1
