NexusGPT/openring/design/ecad/ring/evidence/a5/broken/title_a3/ring_controls.kicad_sch

## KiCad design design/ecad/ring/evidence/a5/broken/title_a3/ring_controls.kicad_sch (2026-11-13)

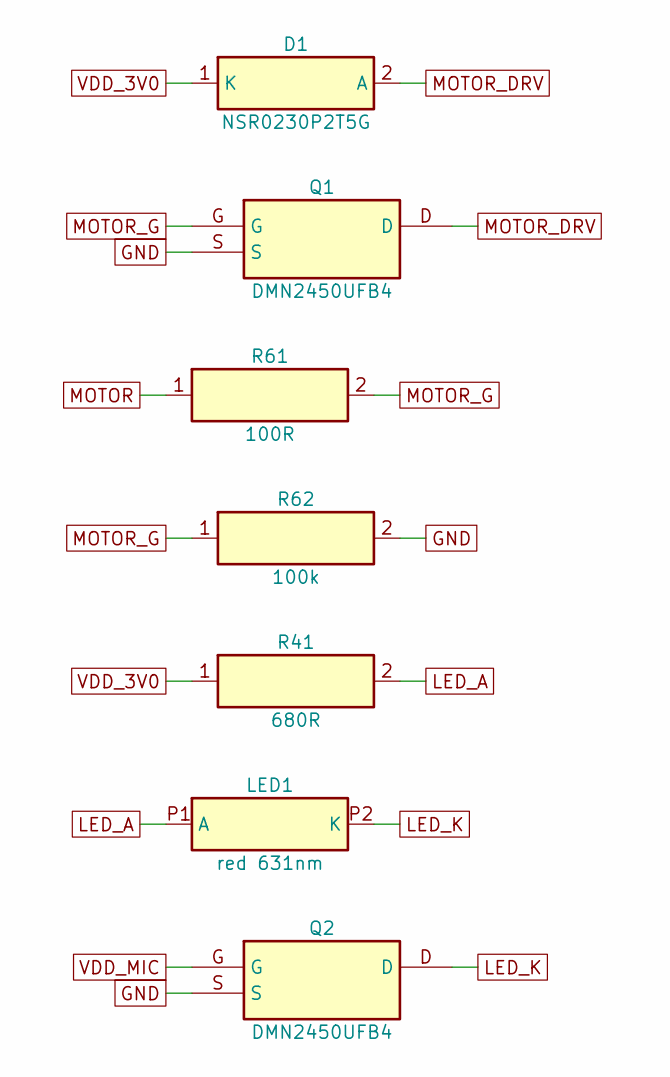
[picture p298: schematic ring_controls.kicad_sch]

Parts:
D1: NSR0230P2T5G; MPN NSR0230P2T5G
LED1: red 631nm; MPN KPG-1005SURC-TT
Q1, Q2: DMN2450UFB4; MPN DMN2450UFB4
R41: 680R
R61: 100R; MPN RC0201FR-07100RL
R62: 100k; MPN RC0201FR-07100KL

Connections:
GND: Q1.S, Q2.S, R62.2
LED_A: LED1.P1 (A), R41.2
LED_K: LED1.P2 (K), Q2.D
MOTOR: R61.1
MOTOR_DRV: D1.2 (A), Q1.D
MOTOR_G: Q1.G, R61.2, R62.1
VDD_3V0: D1.1 (K), R41.1
VDD_MIC: Q2.G
