NexusGPT/openring/design/ecad/ring/evidence/a5/broken/title_a3/ring_mics.kicad_sch

## KiCad design design/ecad/ring/evidence/a5/broken/title_a3/ring_mics.kicad_sch (2026-11-13)

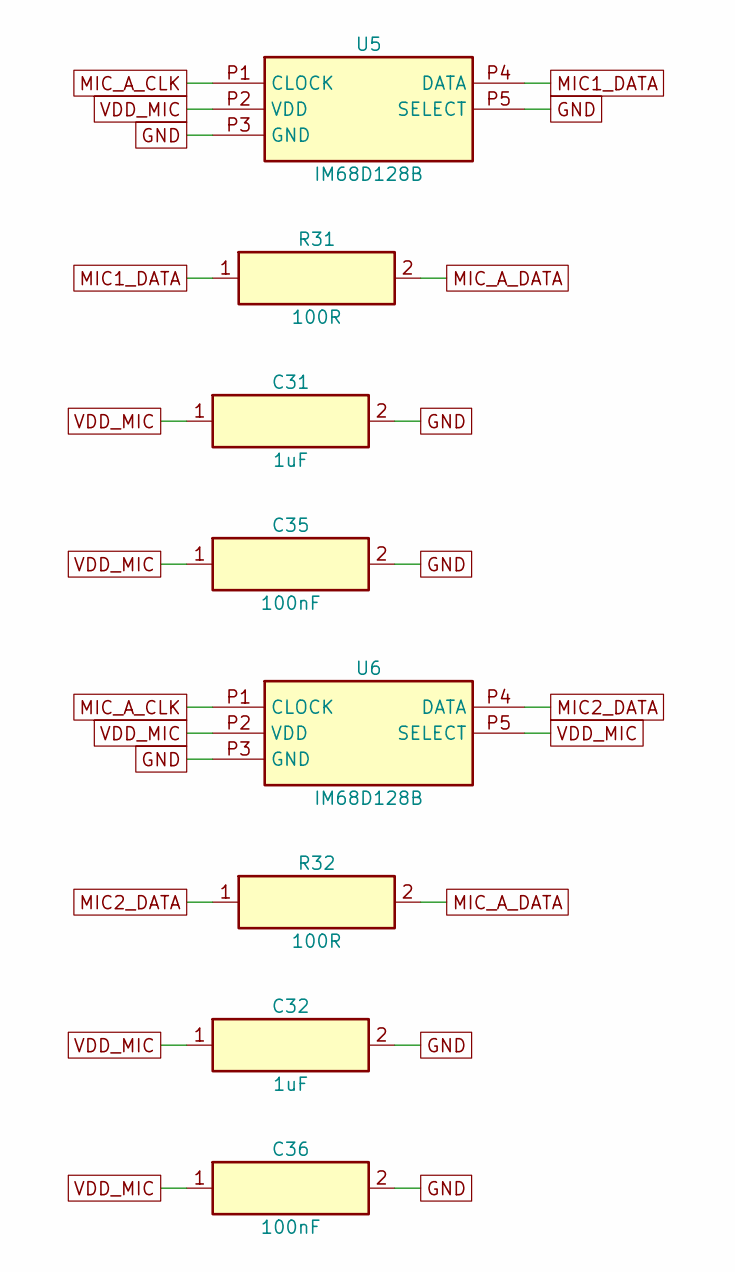
[picture p299: schematic ring_mics.kicad_sch]

Parts:
C31, C32: 1uF; MPN GRM033R60J105MEA2D
C35, C36: 100nF; MPN CL03A104KP3NNNC
R31, R32: 100R; MPN RC0201FR-07100RL
U5, U6: IM68D128B; MPN IM68D128BV01XTMA1

Connections:
GND: C31.2, C32.2, C35.2, C36.2, U5.P3 (GND), U5.P5 (SELECT), U6.P3 (GND)
MIC1_DATA: R31.1, U5.P4 (DATA)
MIC2_DATA: R32.1, U6.P4 (DATA)
MIC_A_CLK: U5.P1 (CLOCK), U6.P1 (CLOCK)
MIC_A_DATA: R31.2, R32.2
VDD_MIC: C31.1, C32.1, C35.1, C36.1, U5.P2 (VDD), U6.P2 (VDD), U6.P5 (SELECT)
