NexusGPT/openring/design/ecad/ring/pcb/evidence/r3/before/sch/ring_band.kicad_sch

## KiCad design design/ecad/ring/pcb/evidence/r3/before/sch/ring_band.kicad_sch (2026-11-13)

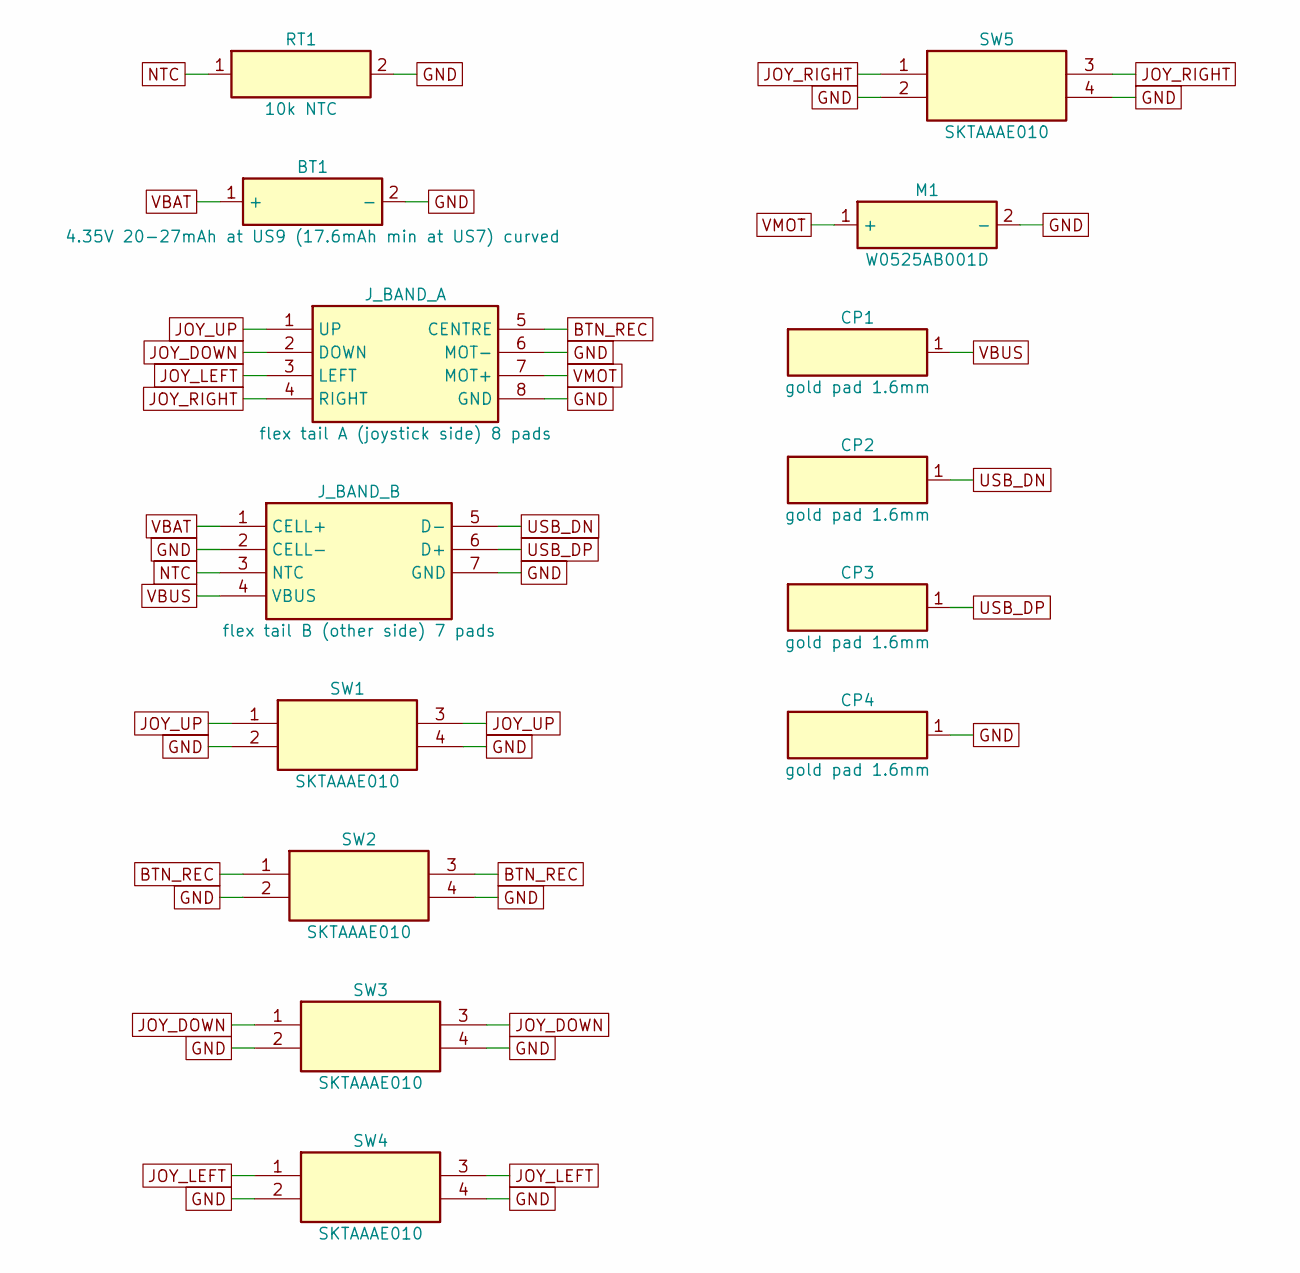
[picture p300: schematic ring_band.kicad_sch]

Parts:
BT1: 4.35V 20-27mAh at US9 (17.6mAh min at US7) curved; MPN Grepow custom
CP1, CP2, CP3, CP4: gold pad 1.6mm
J_BAND_A: flex tail A (joystick side) 8 pads
J_BAND_B: flex tail B (other side) 7 pads
M1: W0525AB001D; MPN W0525AB001D
RT1: 10k NTC; MPN NCP15XH103F03RC
SW1, SW2, SW3, SW4, SW5: SKTAAAE010; MPN SKTAAAE010

Connections:
BTN_REC: J_BAND_A.5 (CENTRE), SW2.1, SW2.3
GND: BT1.2 (-), CP4.1, J_BAND_A.6 (MOT-), J_BAND_A.8 (GND), J_BAND_B.2 (CELL-), J_BAND_B.7 (GND), M1.2 (-), RT1.2, SW1.2, SW1.4, SW2.2, SW2.4, SW3.2, SW3.4, SW4.2, SW4.4, SW5.2, SW5.4
JOY_DOWN: J_BAND_A.2 (DOWN), SW3.1, SW3.3
JOY_LEFT: J_BAND_A.3 (LEFT), SW4.1, SW4.3
JOY_RIGHT: J_BAND_A.4 (RIGHT), SW5.1, SW5.3
JOY_UP: J_BAND_A.1 (UP), SW1.1, SW1.3
NTC: J_BAND_B.3 (NTC), RT1.1
USB_DN: CP2.1, J_BAND_B.5 (D-)
USB_DP: CP3.1, J_BAND_B.6 (D+)
VBAT: BT1.1 (+), J_BAND_B.1 (CELL+)
VBUS: CP1.1, J_BAND_B.4 (VBUS)
VMOT: J_BAND_A.7 (MOT+), M1.1 (+)
