NexusGPT/openring/design/ecad/ring/pcb/evidence/r3/before/sch/ring_controls.kicad_sch

## KiCad design design/ecad/ring/pcb/evidence/r3/before/sch/ring_controls.kicad_sch (2026-11-13)

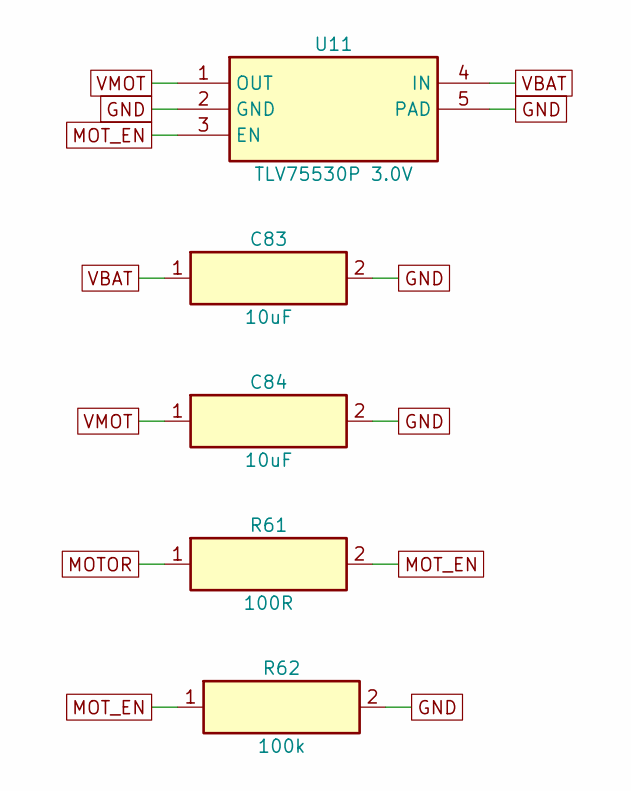
[picture p302: schematic ring_controls.kicad_sch]

Parts:
C83, C84: 10uF; MPN GRM155R60J106ME15
R61: 100R; MPN RC0201FR-07100RL
R62: 100k; MPN RC0201FR-07100KL
U11: TLV75530P 3.0V; MPN TLV75530PDQNR

Connections:
GND: C83.2, C84.2, R62.2, U11.2 (GND), U11.5 (PAD)
MOTOR: R61.1
MOT_EN: R61.2, R62.1, U11.3 (EN)
VBAT: C83.1, U11.4 (IN)
VMOT: C84.1, U11.1 (OUT)
