NexusGPT/openring/design/ecad/ring/pcb/evidence/r3/before/sch/ring_mics.kicad_sch

## KiCad design design/ecad/ring/pcb/evidence/r3/before/sch/ring_mics.kicad_sch (2026-11-13)

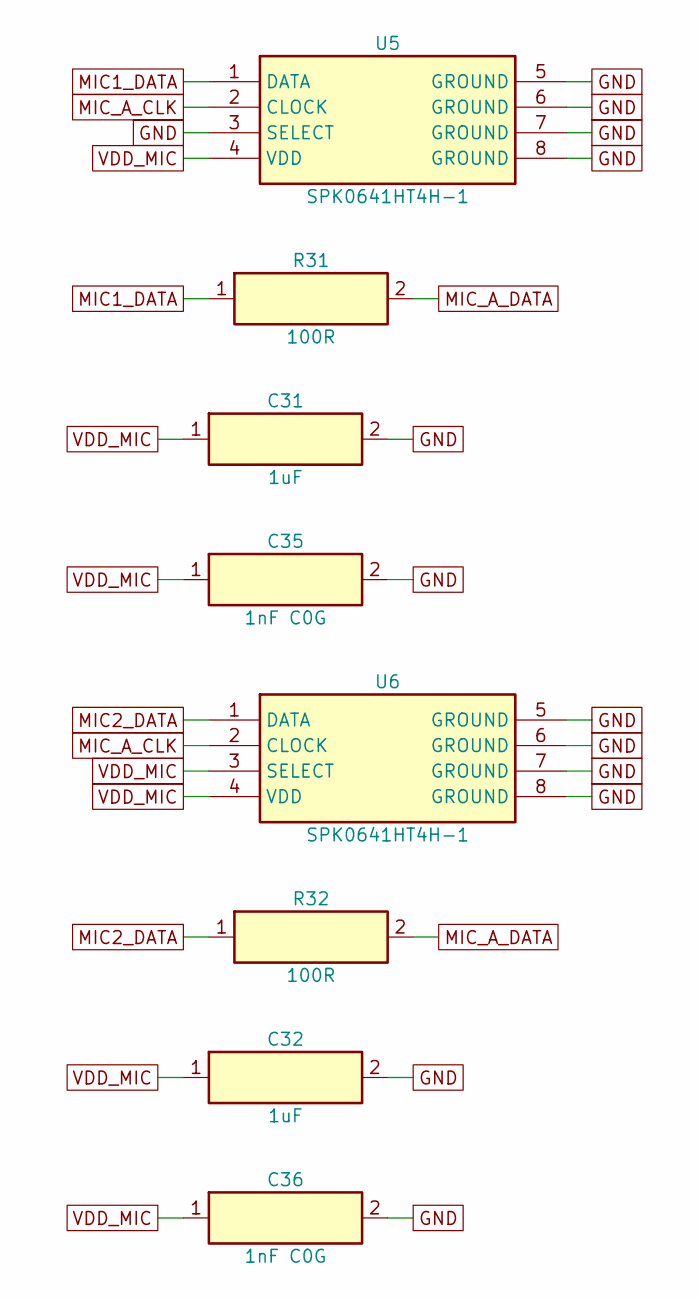
[picture p303: schematic ring_mics.kicad_sch]

Parts:
C31, C32: 1uF; MPN GRM033R60J105MEA2D
C35, C36: 1nF C0G; MPN 04025A102JAT2A
R31, R32: 100R; MPN RC0201FR-07100RL
U5, U6: SPK0641HT4H-1; MPN SPK0641HT4H-1

Connections:
GND: C31.2, C32.2, C35.2, C36.2, U5.3 (SELECT), U5.5 (GROUND), U5.6 (GROUND), U5.7 (GROUND), U5.8 (GROUND), U6.5 (GROUND), U6.6 (GROUND), U6.7 (GROUND), U6.8 (GROUND)
MIC1_DATA: R31.1, U5.1 (DATA)
MIC2_DATA: R32.1, U6.1 (DATA)
MIC_A_CLK: U5.2 (CLOCK), U6.2 (CLOCK)
MIC_A_DATA: R31.2, R32.2
VDD_MIC: C31.1, C32.1, C35.1, C36.1, U5.4 (VDD), U6.3 (SELECT), U6.4 (VDD)
