NexusGPT/openring/design/ecad/ring/pcb/evidence/r3/before/sch/ring_power.kicad_sch

## KiCad design design/ecad/ring/pcb/evidence/r3/before/sch/ring_power.kicad_sch (2026-11-13)

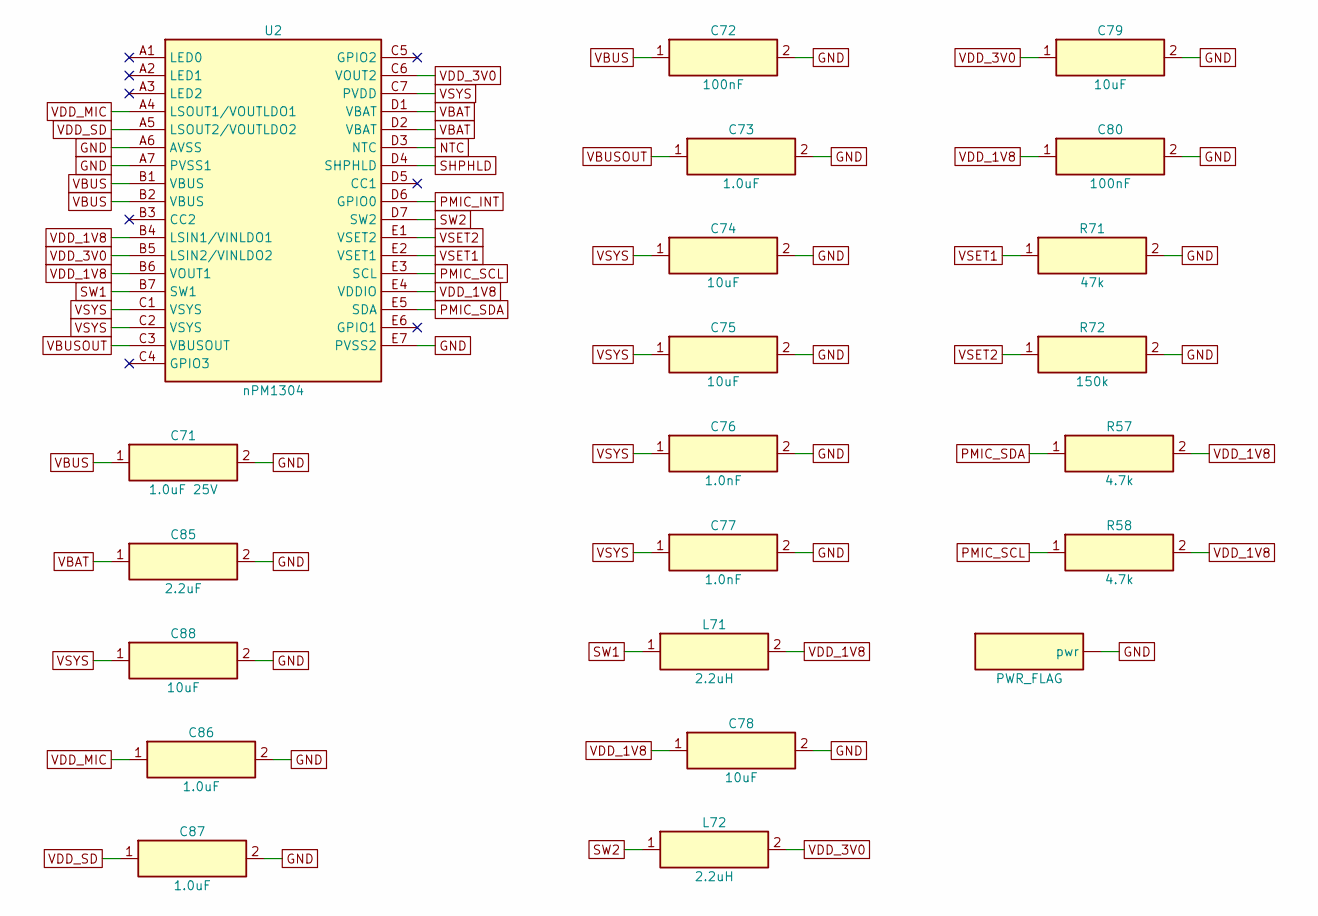
[picture p304: schematic ring_power.kicad_sch]

Parts:
C71: 1.0uF 25V; MPN GRM155R61E105KA12D
C72, C80: 100nF; MPN CL03A104KP3NNNC
C73: 1.0uF; MPN GRM033R60J105MEA2D
C74, C75, C78, C79: 10uF; MPN GRM155R60J106ME15D
C76, C77: 1.0nF
C85: 2.2uF; MPN 0402ZC225KAT2A
C86, C87: 1.0uF; MPN GRM155R61E105KA12D
C88: 10uF; MPN GRT188R61A106KE13D
L71, L72: 2.2uH; MPN 1269AS-H-2R2M=P2
R57, R58: 4.7k; MPN RC0201FR-074K7L
R71: 47k; MPN RC0201FR-0747KL
R72: 150k; MPN RC0201FR-07150KL
U2: nPM1304; MPN nPM1304-CAAA-R7

Connections:
GND: C71.2, C72.2, C73.2, C74.2, C75.2, C76.2, C77.2, C78.2, C79.2, C80.2, C85.2, C86.2, C87.2, C88.2, R71.2, R72.2, U2.A6 (AVSS), U2.A7 (PVSS1), U2.E7 (PVSS2)
NTC: U2.D3 (NTC)
PMIC_INT: U2.D6 (GPIO0)
PMIC_SCL: R58.1, U2.E3 (SCL)
PMIC_SDA: R57.1, U2.E5 (SDA)
SHPHLD: U2.D4 (SHPHLD)
SW1: L71.1, U2.B7 (SW1)
SW2: L72.1, U2.D7 (SW2)
VBAT: C85.1, U2.D1 (VBAT), U2.D2 (VBAT)
VBUS: C71.1, C72.1, U2.B1 (VBUS), U2.B2 (VBUS)
VBUSOUT: C73.1, U2.C3 (VBUSOUT)
VDD_1V8: C78.1, C80.1, L71.2, R57.2, R58.2, U2.B4 (LSIN1/VINLDO1), U2.B6 (VOUT1), U2.E4 (VDDIO)
VDD_3V0: C79.1, L72.2, U2.B5 (LSIN2/VINLDO2), U2.C6 (VOUT2)
VDD_MIC: C86.1, U2.A4 (LSOUT1/VOUTLDO1)
VDD_SD: C87.1, U2.A5 (LSOUT2/VOUTLDO2)
VSET1: R71.1, U2.E2 (VSET1)
VSET2: R72.1, U2.E1 (VSET2)
VSYS: C74.1, C75.1, C76.1, C77.1, C88.1, U2.C1 (VSYS), U2.C2 (VSYS), U2.C7 (PVDD)
