NexusGPT/openring/design/ecad/ring/pcb/evidence/r3/before/sch/ring_storage.kicad_sch

## KiCad design design/ecad/ring/pcb/evidence/r3/before/sch/ring_storage.kicad_sch (2026-11-13)

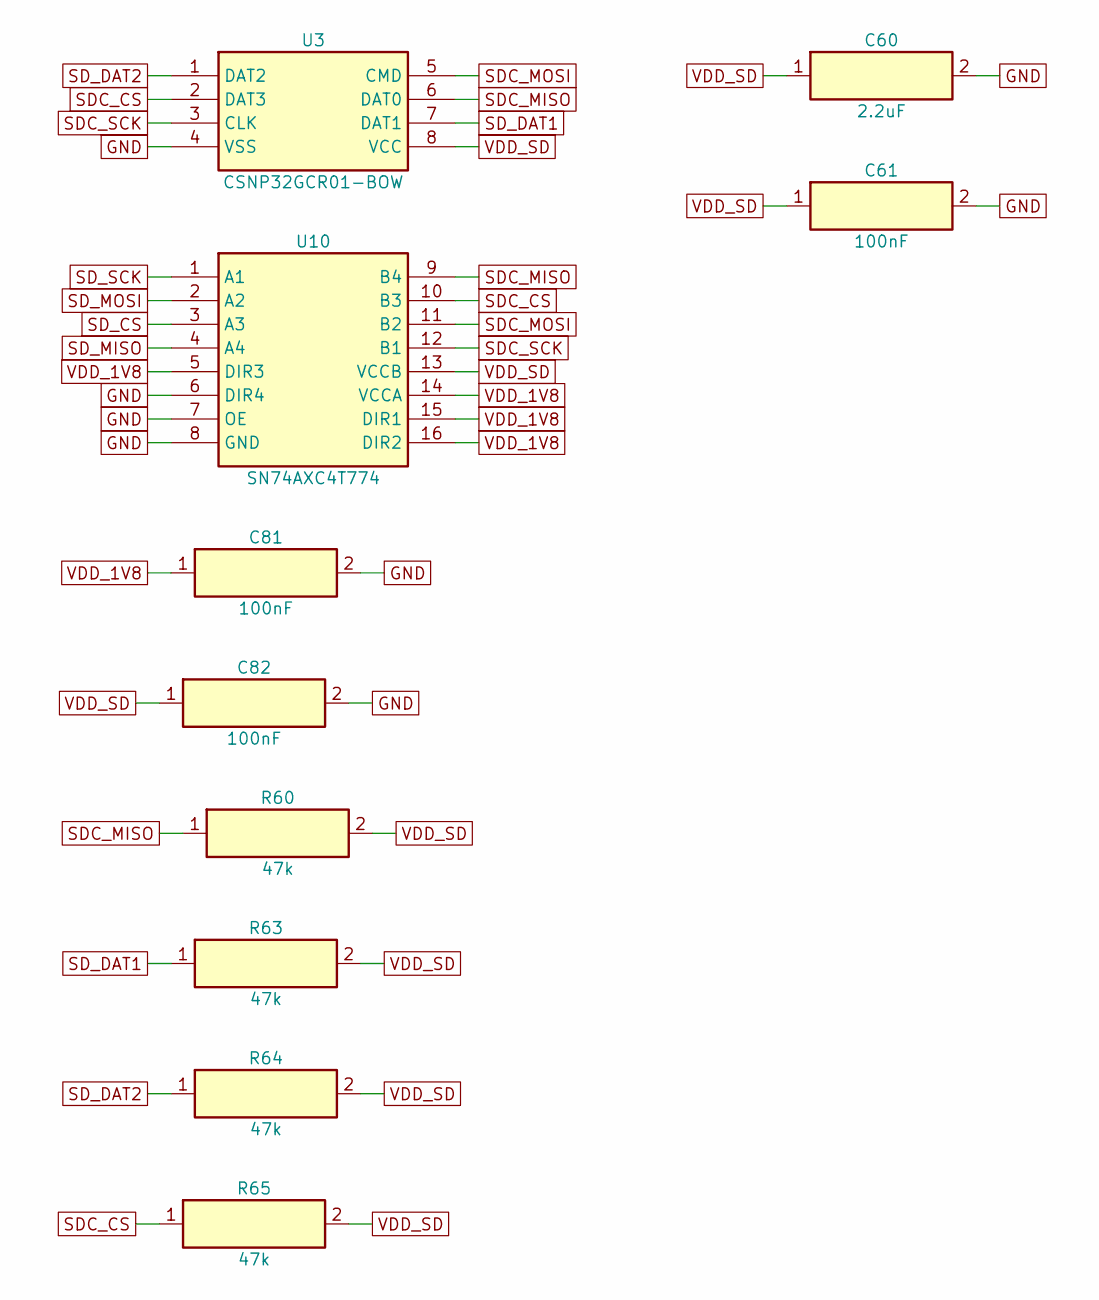
[picture p305: schematic ring_storage.kicad_sch]

Parts:
C60: 2.2uF; MPN 0402ZC225KAT2A
C61, C81, C82: 100nF; MPN CL03A104KP3NNNC
R60, R63, R64, R65: 47k; MPN RC0201FR-0747KL
U3: CSNP32GCR01-BOW; MPN CSNP32GCR01-BOW
U10: SN74AXC4T774; MPN SN74AXC4T774RSVR

Connections:
GND: C60.2, C61.2, C81.2, C82.2, U3.4 (VSS), U10.6 (DIR4), U10.7 (OE), U10.8 (GND)
SDC_CS: R65.1, U3.2 (DAT3), U10.10 (B3)
SDC_MISO: R60.1, U3.6 (DAT0), U10.9 (B4)
SDC_MOSI: U3.5 (CMD), U10.11 (B2)
SDC_SCK: U3.3 (CLK), U10.12 (B1)
SD_CS: U10.3 (A3)
SD_DAT1: R63.1, U3.7 (DAT1)
SD_DAT2: R64.1, U3.1 (DAT2)
SD_MISO: U10.4 (A4)
SD_MOSI: U10.2 (A2)
SD_SCK: U10.1 (A1)
VDD_1V8: C81.1, U10.5 (DIR3), U10.14 (VCCA), U10.15 (DIR1), U10.16 (DIR2)
VDD_SD: C60.1, C61.1, C82.1, R60.2, R63.2, R64.2, R65.2, U3.8 (VCC), U10.13 (VCCB)
