NexusGPT/openring/design/firmware-check.py

#!/usr/bin/env python3
"""Check design/firmware.md against its own rules and design/architecture.md.

Usage: firmware-check.py [firmware.md] [--arch architecture.md]
Exit 0 when every check passes, 1 when any fails, 2 when a file cannot be read.

Checks:
  1. Numbered sections "## 1." to "## 10." are all present.
  2. Every state named (in backticks) in the From and To columns of the
     transition table (section 1.2) is in the state list (section 1.1), and
     every listed state appears in at least one transition.
  3. Every pin (Pn.nn) and every signal name used in firmware.md is in the
     pin plan of architecture.md section 7; a "SIGNAL Pn.nn" pair in
     firmware.md matches the pin the architecture gives that signal.
  4. The RAM budget lines (section 4.6) sum to the stated total, and the
     total is at most 512 KB (524,288 bytes).
  5. A "questions_for_owner" section exists and the last line starts with
     "RESULT: done," or "RESULT: blocked,".
  Added in F2:
  6. A pin used in firmware.md is not a spare pin of architecture section 7,
     and a signal-like name (prefixes of section 7 plus LED and MOTOR) is a
     signal of section 7 (so a light pin, which A2 removed, fails).
  7. Charge voltage and current in section 8.1 equal architecture section 3.
  8. Each "<clock>, prescaler N, ratio R" line: 32 MHz / N = clock, N in 4..126,
     R in the chip's ratios, clock / R = 16,000 or 8,000 Hz, and the clock
     inside the microphone mode range (normal 1.2-1.65 MHz, low power
     450-850 kHz, IM73D122V01 datasheet table 5).
  9. Section 6.1 sets 64-byte bulk packets for full speed.
 10. Section 4.7 marks motor pulses up to 50 ms after them.
 11. The schematic rules: mic clocks low while VDD_MIC is off (section 4.5),
     no storage line high while VDD_SD is off (section 5.1), screen sequence
     names OLED_PWR_EN and SWIRE (section 3.3).
 12. Thermistor: ohms in the binding's values, cold < cool < warm < hot.
  Added for the owner's decision (record only on a long press):
 13. None of the removed names (DAY_LISTEN, DAY_REC, VOICE_NOTE, MEETING_REC,
     speech detector, pre-roll, day mode, voice note, listening) appears
     outside the change list at the top.
 14. VDD_MIC is "on" for exactly one state in the state list (1.1) and in
     exactly one row of the power table (8.2), the same recording state.
 15. Every transition into the recording state from another state, and every
     button transition out of it, is a "long press"; a "short press" or
     "double press" transition never changes state; section 2.1 gives the
     long press as 1,000 ms for start and stop.
  Changed and added for F3 (architecture A5-draft section 17):
  2b. Every state has a transition out; every state except SHIP and BOOT has
      one in; the number of rows equals "The table has N transitions." under
      the table (a removed row fails).
  7.  (changed) The charge voltage equals the cell's type in architecture
      section 2 (4.35 V); the charge current is BLOCKED on S12, S12 is an open
      item of architecture 17.6, and the current is not a number.
  11. (changed) Only MIC_A_CLK is the microphone clock to hold low.
  13. (changed) The change lists run from "Changes from F2 to F3" to
      "Peripheral instances"; F2 values that F3 replaced (4 microphones,
      4 channels, 66,048, 129 sectors, Zetta, 135 mAh, T-SKEW, T-MIC3,
      T-MIC4, the F2 skew field) must not appear outside them.
  16. F3 rules: header version F3 and basis A5; audio format against
      architecture 16.6; chunk arithmetic; one PDM instance; joystick switches
      against architecture 17.3 and the 40 ms rule against 16.5; unused pins
      only on lines that say unused; motor part against 17.4; battery minutes
      and recording hours recomputed; four pads in order.
  Changed and added for F4 (architecture A5-draft sections 17.11 and 17.12):
  16. (changed) header version F4, basis A5, sections 17.11 and 17.12 named;
      the change list "Changes from F3 to F4" exists.
  13. (changed) the change lists run from "Changes from F3 to F4"; "record
      button" is a removed name outside them, the section 10.6 text and the
      hardware issues table.
  17. F4 rules. Record gesture: read from the transition table (1.2), the
      gesture table (2.1) and the joystick table (2.2): exactly one row enters
      the recording state and it is a long press of the joystick centre from
      STANDBY; the long press row in the recording state goes to STANDBY and
      closes; short press and double press rows in the recording state stay
      in it (highlight, nothing); no event naming a direction touches the
      recording state or changes any state; no gesture row but the long press
      starts or stops a recording; double press does nothing; no direction
      column of 2.2 starts or stops a recording. Centre source: both cases
      (`SW2`, `PAIR`) have an input and a debounce; warning pulse MW exists;
      short-press ceiling < warning time < long press; release hold-off between
      the debounce and the double-press gap; collisions C1 to C4 listed.
      Charging: every row into CHARGING, and the two rows that leave ship
      mode, say "charge on"; `charging-enable` is on whenever VBUS is present;
      CHARGE_CURRENT is named, BLOCKED, with the 1 C limit (15 to 20 mA) and
      the 32 mA minimum; R-CHG stated; section 8.6 says VBUS is an input only
      and nothing is driven onto the pads; architecture 17.11 and 17.12 still
      say what F4 relies on.
  Changed and added for F5 (architecture A5-draft sections 17.13 to 17.23,
  wiring A7, assembly order; each change replaces an F4 assertion that F5
  makes false):
  3.  (changed) the signal-name scan runs outside the change lists; a
      signal-like name not in architecture section 7 passes only when it is a
      net of netlist.csv that touches no main-chip pin (LED_A, LED_K, MOT_EN).
  7.  (changed) CHARGE_CURRENT is 15,000 uA in `current-microamp`, a multiple
      of 500 in 4,000..100,000 and at most 1 C of the smallest cell of
      architecture 17.17; T-CHARGE has a pass limit (F4: BLOCKED on S12).
  8.  (changed) the microphone mode ranges are read from the Knowles datasheet
      copy (F4: fixed IM73D122V01 ranges).
  13. (changed) the change lists run from "Changes from F4 to F5" to
      "How to read this:"; banned outside them also: the older power chip's
      name, the F3 battery range in mAh, the old microphone and datasheet
      names, the discharge-limit property, MOTOR_DRV, MOTOR_G.
  16. (changed) header Version F5, basis A5, sections 17.11 to 17.23 named;
      the list "Changes from F4 to F5" has 8 numbered items; motor section
      names U11, MOT_EN, VMOT, 0.55 ms, no PWM and no Q1 (F4: Q1, full duty,
      VDD_3V0); battery minutes and hours recomputed from architecture 17.17
      and the recording current 4.0 + 2 x (0.63 - 0.58) (F4: 17.10 range).
  17. (changed) the `current-microamp` row names CHARGE_CURRENT, 15,000,
      18.2 mAh and 0.82 C (F4: the 1 C limit of 15 to 20 mA and 32 mA).
  18. F5 rules: pin table and named nets against netlist.csv; microphone part
      and gain arithmetic; ship section (ship task, VBUS removal, no timed
      hibernate); SHIP_SAMPLE keeps the factory flag; no discharge-limit row;
      the motor charge rule; section 7 protocol sentence; per-size tables.
  Changed and added for F6 (architecture 17.26, measured cells):
  7, 16. (changed) the cells per size are read from the 17.26 table (F5: 17.17);
      the 8.1 compile limit equals 1 C of the smallest cell (17,600 uA);
      the current-microamp row names 17.6 mAh and 0.85 C (F5: 18.2 and 0.82).
  13, 16. (changed) the change lists run from "Changes from F5 to F6"; header
      Version F6 with sections 17.11 to 17.26; the F5 to F6 list has 4 items.
  19. F6 rule: outside the change lists no line names 18.2, 24.3 or 32.9 (mAh
      of the calculated cells of 17.17) or 18,200 (their compile limit) unless
      the word "before" stands within 60 characters of the value.
  Changed and added for v7 (architecture 17.29 round joystick, 17.30 no
  recording light; each replaces an assertion about the light):
  18a. (changed) the netlist fact "Q2 whose gate is VDD_MIC" is no longer
      required (Q2, R41 and LED1 left the design).
  21. v7 rules: any line naming LED1, R41, Q2, LG1, LP1, T-LIGHT, "recording
      light", "light window", "hard-wired", "record button" or "nub" fails
      unless it says "removed in v7"; section 3.2 states rule R-SIGN (never
      dark, red dot and timer, dimmed after 3 s, rec_mics_on() the only code
      that enables VDD_MIC, test SIGN-1, the dot's cost a bench item with no
      mA figure); the RECORDING screen cell of 1.1 starts "never dark" and its
      8.2 screen supply is on for the whole recording; 4.5 start step 2 enables
      VDD_MIC only after the sign is drawn; one STANDBY -> STANDBY refusal row
      "recording sign not drawn"; 9.3 holds T-SIGN and no T-LIGHT; 8.5 counts
      no light and names the dot as a bench item; "centre switch SW2 (net
      BTN_REC)" is written; the 2.2 heading names the round joystick with five
      switches; architecture 17.29 and 17.30 still say what v7 relies on.
"""
import os
import re
import sys

RAM_LIMIT = 512 * 1024


def follows(text):
    m = re.search(r"\bfollows\b[\s\S]{0,200}?\bversion\s+([A-Z]{1,2}\d+)", text, re.I)
    return m.group(1) if m else None


def read(path):
    try:
        with open(path, encoding="utf-8") as fh:
            return fh.read()
    except OSError as exc:
        print(f"ERROR cannot read {path}: {exc}")
        sys.exit(2)


def section(text, start_pat, end_pat):
    m = re.search(start_pat, text, re.M)
    if not m:
        return None
    rest = text[m.end():]
    e = re.search(end_pat, rest, re.M)
    return rest[: e.start()] if e else rest


def table_rows(block):
    rows = []
    for line in block.splitlines():
        s = line.strip()
        if not s.startswith("|") or re.match(r"^\|[\s\-|:]+\|$", s):
            continue
        cells = [c.strip() for c in s.strip("|").split("|")]
        rows.append(cells)
    return rows


def arch_pins(arch):
    sec = section(arch, r"^## 7\. ", r"^## \d+\. ")
    if sec is None:
        print("ERROR architecture.md has no section 7")
        sys.exit(2)
    signals, pins, pairs, spares = set(), set(), {}, set()
    for cells in table_rows(sec):
        if len(cells) < 2 or cells[0] in ("Signal",):
            continue
        sig_cell, pin_cell = cells[0], cells[1]
        cell_pins = re.findall(r"P\d\.\d{2}", pin_cell)
        pins.update(cell_pins)
        if sig_cell.lower().startswith("spare"):
            spares.update(cell_pins)
            continue
        names = [n.strip() for n in sig_cell.split("/")]
        for n in names:
            if n:
                signals.add(n)
        if len(names) == len(cell_pins):
            for n, p in zip(names, cell_pins):
                pairs[n] = p
    return signals, pins, pairs, spares


def read_netlist(path):
    rows = []
    for ln in read(path).splitlines()[1:]:
        parts = ln.split(",")
        if len(parts) >= 4:
            rows.append((parts[0], parts[1], parts[2], parts[3]))
    return rows


def change_list_span(fw):
    a = fw.find("Changes from F5 to F6")
    b = fw.find("\nHow to read this:")
    if a == -1 or b < a:
        return None
    return a, b


def main(argv):
    here = os.path.dirname(os.path.abspath(__file__))
    fw_path = os.path.join(here, "firmware.md")
    arch_path = os.path.join(here, "architecture.md")
    net_path = os.path.join(here, "ecad", "ring", "netlist.csv")
    kn_path = os.path.join(here, "mech", "mic-path", "datasheets", "knowles-spk0641ht4h-1_chipsmall.txt")
    old_mic_path = os.path.join(here, "datasheets", "mic-research", "im68d128b-brief.txt")
    args = list(argv)
    if "--arch" in args:
        i = args.index("--arch")
        arch_path = args[i + 1]
        del args[i : i + 2]
    if "--netlist" in args:
        i = args.index("--netlist")
        net_path = args[i + 1]
        del args[i : i + 2]
    if args:
        fw_path = args[0]
    fw = read(fw_path)
    if not fw.strip():
        print("FAIL the behaviour rules file is empty")
        print("1 failures")
        return 1
    arch = read(arch_path)
    netrows = read_netlist(net_path)
    knowles = read(kn_path)
    old_mic = read(old_mic_path)
    errors = []
    print(f"firmware: {fw_path}")
    print(f"architecture: {arch_path}")
    print(f"netlist: {net_path}")
    span = change_list_span(fw)
    if span is None:
        errors.append("change list 'Changes from F5 to F6' before 'How to read this:' not found")
        body = fw
    else:
        body = fw[: span[0]] + fw[span[1]:]

    # 1. sections
    found = {int(n) for n in re.findall(r"^## (\d+)\. ", fw, re.M)}
    missing = [n for n in range(1, 11) if n not in found]
    for n in missing:
        errors.append(f"section {n} missing")
    print(f"check 1 sections: found {sorted(n for n in found if 1 <= n <= 10)}, missing {missing}")

    # 2. states
    states_block = section(fw, r"^### 1\.1 ", r"^### ")
    trans_block = section(fw, r"^### 1\.2 ", r"^### |^## ")
    states, transitions = [], []
    if states_block is None:
        errors.append("state list (### 1.1) missing")
    else:
        for cells in table_rows(states_block):
            m = re.fullmatch(r"`([A-Z][A-Z0-9_]*)`", cells[0])
            if m:
                states.append(m.group(1))
    if trans_block is None:
        errors.append("transition table (### 1.2) missing")
    else:
        for cells in table_rows(trans_block):
            if len(cells) < 4 or cells[0] == "From":
                continue
            frm = re.findall(r"`([A-Z][A-Z0-9_]*)`", cells[0])
            to = re.findall(r"`([A-Z][A-Z0-9_]*)`", cells[2])
            if frm or to:
                transitions.append((frm, cells[1], to))
    state_set = set(states)
    used = set()
    for frm, ev, to in transitions:
        if len(frm) != 1 or len(to) != 1:
            errors.append(f"transition needs one From and one To state: {frm} / {ev} / {to}")
        for s in frm + to:
            used.add(s)
            if s not in state_set:
                errors.append(f"state `{s}` used in transition '{ev}' is not in the state list")
    for s in states:
        if s not in used:
            errors.append(f"state `{s}` is in the list but in no transition")
    if not transitions:
        errors.append("no transitions found")
    outs = {f for frm, ev, to in transitions for f in frm}
    ins = {t for frm, ev, to in transitions for t in to}
    for s_ in states:
        if s_ not in outs:
            errors.append(f"state `{s_}` has no transition out")
        if s_ not in ins and s_ not in ("SHIP", "BOOT"):
            errors.append(f"state `{s_}` has no transition in")
    mcount = re.search(r"^The table has (\d+) transitions\.$", fw, re.M)
    if not mcount:
        errors.append("the sentence 'The table has N transitions.' is missing under the transition table")
    elif int(mcount.group(1)) != len(transitions):
        errors.append(f"transition table has {len(transitions)} rows, the text says {mcount.group(1)}")
    print(f"check 2 states: {len(states)} listed, {len(transitions)} transitions, {len(used)} states used")

    # 3. pins and signals
    signals, pins, pairs, spares = arch_pins(arch)
    prefixes = sorted({s.split("_")[0] for s in signals if "_" in s} | {"LED", "MOTOR"})
    fw_pins = set(re.findall(r"P\d\.\d{2}", fw))
    for p in sorted(fw_pins - pins):
        errors.append(f"pin {p} is not in architecture section 7")
    for p in sorted(fw_pins & spares):
        errors.append(f"pin {p} is a spare pin in architecture section 7 but firmware.md uses it")
    sig_re = re.compile(r"(?<![A-Za-z0-9_])((?:" + "|".join(map(re.escape, prefixes)) + r")_[A-Z0-9_]+)(?![A-Za-z0-9_])")
    fw_sigs = set(sig_re.findall(body))
    board_nets = {n for n, r, pn, pname in netrows} - {n for n, r, pn, pname in netrows if r == "U1"}
    for s in sorted(fw_sigs - signals):
        if s in board_nets:
            continue
        errors.append(f"signal {s} is not in architecture section 7 and not a board net of netlist.csv")
    pair_count = 0
    for sig, pin in re.findall(r"(?<![A-Za-z0-9_])([A-Z][A-Z0-9_]+) (P\d\.\d{2})", fw):
        if sig in pairs:
            pair_count += 1
            if pairs[sig] != pin:
                errors.append(f"{sig} is {pin} in firmware.md but {pairs[sig]} in architecture section 7")
    print(f"check 3 pins: {len(fw_pins)} pins, {len(fw_sigs)} signal names, {pair_count} signal-pin pairs checked against {len(signals)} architecture signals")

    # 4. RAM budget
    ram_block = section(fw, r"^### 4\.6 ", r"^### |^## ")
    total = None
    items = []
    if ram_block is None:
        errors.append("RAM budget (### 4.6) missing")
    else:
        for cells in table_rows(ram_block):
            if len(cells) < 2 or cells[0] in ("Item",):
                continue
            num = re.fullmatch(r"\**([\d,]+)\**", cells[1])
            if not num:
                continue
            val = int(num.group(1).replace(",", ""))
            if "total" in cells[0].lower():
                total = val
            else:
                items.append(val)
        if total is None:
            errors.append("RAM budget has no Total line")
        else:
            s = sum(items)
            if s != total:
                errors.append(f"RAM lines sum to {s}, stated total is {total}")
            if total > RAM_LIMIT:
                errors.append(f"RAM total {total} exceeds 512 KB ({RAM_LIMIT})")
            print(f"check 4 RAM: {len(items)} lines sum {s}, stated total {total}, limit {RAM_LIMIT}")

    # 7. charger (F3): voltage = the cell's type, current blocked on S12
    a2 = section(arch, r"^## 2\. ", r"^## \d+\. ") or ""
    cellrow = next((ln for ln in a2.splitlines() if ln.startswith("| Cell |")), "")
    mv = re.search(r"([\d.]+) V type", cellrow)
    a176 = section(arch, r"^### 17\.6 ", r"^### |^## ") or ""
    s81 = section(fw, r"^### 8\.1 ", r"^### |^## ") or ""
    tv = re.search(r"`term-microvolt` \| ([\d,]+)", s81)
    cu = re.search(r"`current-microamp` \| ([^\n]*)", s81)
    if not (mv and tv and cu):
        errors.append("cell charge voltage (architecture section 2) or the charger rows of firmware 8.1 not found")
    else:
        fv = int(tv.group(1).replace(",", ""))
        if fv != round(float(mv.group(1)) * 1e6):
            errors.append(f"charge voltage {fv} uV differs from the cell type {mv.group(1)} V of architecture section 2")
        cur = cu.group(1)
        a1726 = section(arch, r"^### 17\.26 ", r"^### |^## ") or ""
        caps = [(float(a), float(b)) for u, a, b in re.findall(r"^\| US (\d+) \| [^|]+\| [^|]+\| [\d.]+ mm \| ([\d.]+) to ([\d.]+) mAh \|", a1726, re.M)]
        cmin = min(a for a, b in caps) if caps else None
        cc_m = re.match(r"`CHARGE_CURRENT` = ([\d,]+) ", cur)
        a1713 = section(arch, r"^### 17\.13 ", r"^### |^## ") or ""
        if not cc_m:
            errors.append("current-microamp does not give `CHARGE_CURRENT` = <microamps>")
            ua = None
        else:
            ua = int(cc_m.group(1).replace(",", ""))
            if ua != 15000:
                errors.append(f"CHARGE_CURRENT is {ua} uA, architecture 17.13 sets 15 mA (15,000 uA)")
            if "`CHARGE_CURRENT` = 15 mA" not in a1713:
                errors.append("architecture 17.13 no longer sets CHARGE_CURRENT = 15 mA")
            if ua % 500 or not 4000 <= ua <= 100000:
                errors.append(f"CHARGE_CURRENT {ua} uA is not a 0.5 mA step inside 4 to 100 mA (nPM1304)")
            if cmin is None or ua > cmin * 1000:
                errors.append(f"CHARGE_CURRENT {ua} uA is above 1 C of the smallest cell {cmin} mAh (architecture 17.26)")
        lim = re.search(r"A build fails to compile when it is unset, above ([\d,]+) \(1 C of the smallest cell, ([\d.]+) mAh", s81)
        if not lim or cmin is None or int(lim.group(1).replace(",", "")) != round(cmin * 1000) or float(lim.group(2)) != cmin:
            errors.append(f"8.1 compile limit {lim and lim.groups()} is not 1 C of the smallest cell {cmin} mAh of architecture 17.26")
        if not re.search(r"^\| S12 \|", a176, re.M):
            errors.append("open item S12 is not in architecture 17.6")
        tch = (re.search(r"\| 0x70 \| T-CHARGE[^\n]*", fw) or re.search("", "")).group(0)
        if "BLOCKED" in tch or "13.5 to 16.5 mA" not in tch:
            errors.append("T-CHARGE (section 9.3) must have the pass limit 13.5 to 16.5 mA and not be BLOCKED")
        print(f"check 7 charger: {fv} uV against the cell type {mv.group(1)} V; CHARGE_CURRENT {ua} uA, smallest cell {cmin} mAh")

    # 8. PDM clock arithmetic
    ratios = {48, 50, 64, 80, 96, 150, 192}
    pdm = re.findall(r"([\d.]+) (MHz|kHz), prescaler (\d+), ratio (\d+)", fw)
    if not pdm:
        errors.append("no '<clock>, prescaler N, ratio R' line found")
    kn_perf = re.search(r"Clock Frequency\s+Fclock\s+([\d.]+)\s+-\s+([\d.]+)\s+MHz", knowles)
    kn_lp = re.search(r"Clock Frequency\s+Fclock\s+(\d+)\s+-\s+(\d+)\s+kHz", knowles)
    if not (kn_perf and kn_lp):
        errors.append("Knowles datasheet copy: clock ranges not found")
        modes = []
    else:
        modes = [(float(kn_perf.group(1)) * 1e6, float(kn_perf.group(2)) * 1e6), (float(kn_lp.group(1)) * 1e3, float(kn_lp.group(2)) * 1e3)]
        print(f"check 8 microphone modes from the Knowles copy: {modes}")
    for val, unit, presc, ratio in pdm:
        clk = round(float(val) * (1e6 if unit == "MHz" else 1e3))
        n, r = int(presc), int(ratio)
        rate = clk / r
        mode_ok = any(lo <= clk <= hi for lo, hi in modes)
        if 32_000_000 / n != clk or not 4 <= n <= 126 or r not in ratios or rate not in (16000, 8000) or not mode_ok:
            errors.append(f"PDM line {val} {unit}, prescaler {n}, ratio {r}: 32 MHz / {n} = {32e6 / n:.0f}, rate {rate:.1f} Hz, mode range ok {mode_ok}")
    print(f"check 8 PDM: {len(pdm)} clock lines checked")

    # 9 to 11. rules stated
    rules = [
        (r"^### 6\.1 ", r"full speed, `wMaxPacketSize` = 64 bytes", "section 6.1 does not set 64-byte bulk packets for full speed"),
        (r"^### 4\.7 ", r"50 ms after", "section 4.7 does not mark motor pulses up to 50 ms after them"),
        (r"^### 4\.5 ", r"MIC_A_CLK is driven low whenever VDD_MIC is off", "section 4.5 lacks the rule: the mic clock low while VDD_MIC is off"),
        (r"^### 5\.1 ", r"no storage line is driven high while VDD_SD is off", "section 5.1 lacks the rule: no storage line high while VDD_SD is off"),
        (r"^### 3\.3 ", r"OLED_PWR_EN[\s\S]*SWIRE", "section 3.3 screen sequence does not name OLED_PWR_EN and SWIRE"),
    ]
    for start, pat, msg in rules:
        block = section(fw, start, r"^### |^## ")
        if block is None or not re.search(pat, block):
            errors.append(msg)
    print(f"check 9-11 rules: {len(rules)} stated rules checked")

    # 12. thermistor
    th = re.search(r"`thermistor-ohms`, `thermistor-beta` \| ([\d,]+)", s81)
    temps = [re.search(rf"`thermistor-{k}-millidegrees` \| ([\d,-]+)", s81) for k in ("cold", "cool", "warm", "hot")]
    if not th or not all(temps):
        errors.append("thermistor ohms or the four temperature limits missing in section 8.1")
    else:
        ohms = int(th.group(1).replace(",", ""))
        tv4 = [int(t.group(1).replace(",", "")) for t in temps]
        if ohms not in (0, 10000, 47000, 100000):
            errors.append(f"thermistor-ohms {ohms} not in the binding's values")
        if not tv4[0] < tv4[1] < tv4[2] < tv4[3]:
            errors.append(f"thermistor limits not ordered cold < cool < warm < hot: {tv4}")
        print(f"check 12 thermistor: {ohms} ohm, limits {tv4} m°C")

    # 13. removed names (F5: the change lists run from "Changes from F4 to F5" to "How to read this:")
    banned = ["DAY_LISTEN", "DAY_REC", "VOICE_NOTE", "MEETING_REC", "speech detector",
              "pre-roll", "day mode", "voice note", "voice-note", "listening",
              "4 microphones", "4-channel", "4 channels", "66,048", "129 sectors", "129-sector",
              "Zetta", "135 mAh", "T-SKEW", "T-MIC3", "T-MIC4", "pdm_skew", "record button", "T-BTN",
              "nPM1300", "15 to 20 mAh", "IM68D128B", "IM73D122", "IM68D121J", "dischg-limit",
              "MOTOR_DRV", "MOTOR_G", "mfd_npm13xx_hibernate"]
    hits = 0
    exempt_from = body.find("\nRun: `design/.venv")
    exempt_to = body.find("\n", exempt_from + 1) if exempt_from != -1 else -1
    for word in banned:
        for m in re.finditer(re.escape(word), body, re.I):
            if word in ("record button", "T-BTN"):
                ls = body.rfind("\n", 0, m.start()) + 1
                if body.startswith("| H1", ls) or ls == exempt_from + 1:
                    continue
            hits += 1
            line_no = body[: m.start()].count("\n") + 1
            errors.append(f"removed name '{word}' still used (line {line_no} outside the change list)")
    print(f"check 13 removed names: {len(banned)} names, {hits} uses outside the change list")

    # 14. microphone rail on in one state only
    mic_on = []
    if states_block is not None:
        for cells in table_rows(states_block):
            m = re.fullmatch(r"`([A-Z][A-Z0-9_]*)`", cells[0])
            if m and len(cells) > 2 and cells[2].lower().startswith("on"):
                mic_on.append(m.group(1))
    s82 = section(fw, r"^### 8\.2 ", r"^### |^## ")
    rows_on = []
    if s82 is None:
        errors.append("power table (### 8.2) missing")
    else:
        for cells in table_rows(s82):
            if len(cells) > 3 and cells[0] != "State" and cells[3].lower().startswith("on"):
                rows_on.append(cells[0])
    rec = mic_on[0] if len(mic_on) == 1 else None
    if len(mic_on) != 1:
        errors.append(f"VDD_MIC is on in {len(mic_on)} states of 1.1 (must be exactly 1): {mic_on}")
    if len(rows_on) != 1 or (rec and rows_on[0] != f"`{rec}`"):
        errors.append(f"VDD_MIC is on in 8.2 rows {rows_on}, expected only `{rec}`")
    print(f"check 14 microphone rail: on in 1.1 for {mic_on}, in 8.2 for {rows_on}")

    # 15. long press only
    lp_count = 0
    if rec:
        for frm, ev, to in transitions:
            if len(frm) != 1 or len(to) != 1:
                continue
            f0, t0, evl = frm[0], to[0], ev.lower()
            if t0 == rec and f0 != rec:
                lp_count += 1
                if not evl.startswith("long press"):
                    errors.append(f"transition {f0} -> {rec} on '{ev}': only a long press may start a recording")
            if f0 == rec and t0 != rec and "press" in evl and not evl.startswith("long press"):
                errors.append(f"transition {rec} -> {t0} on '{ev}': only a long press may stop a recording")
            if ("short press" in evl or "double press" in evl) and f0 != t0:
                errors.append(f"'{ev}' changes state {f0} -> {t0}")
    s21 = section(fw, r"^### 2\.1 ", r"^### |^## ") or ""
    if not re.search(r"\| Long press \| 1,000 ms hold, for start and for stop \|", s21):
        errors.append("section 2.1 does not give the long press as 1,000 ms for start and stop")
    print(f"check 15 long press: {lp_count} transitions into the recording state checked")

    # 20. Bluetooth never starts or stops a recording (owner rule, review 2 finding G18, fake W3)
    ble_word = re.compile(r"\b(ble|bluetooth|phone|gatt|att)\b", re.I)
    ble_rows = 0
    if rec:
        for frm, ev, to in transitions:
            if len(frm) != 1 or len(to) != 1 or not ble_word.search(ev):
                continue
            ble_rows += 1
            if (to[0] == rec) != (frm[0] == rec):
                errors.append(f"transition {frm[0]} -> {to[0]} on '{ev}': Bluetooth may not start or stop a recording")
    s7 = section(fw, r"^## 7\. ", r"^## ") or ""
    if not s7:
        errors.append("section 7 (Bluetooth) not found")
    ss_re = re.compile(r"\b(start|starts|started|starting|stop|stops|stopping|begin|begins)\b[^.;|]{0,40}\brecord", re.I)
    neg_re = re.compile(r"\b(cannot|can not|never|not|no|nothing|without)\b", re.I)
    ble_hits = 0
    for cell_text in re.split(r"[;|\n]|\. ", s7):
        if ss_re.search(cell_text):
            ble_hits += 1
            if not neg_re.search(cell_text):
                errors.append(f"section 7 lets Bluetooth start or stop a recording: {cell_text.strip()[:100]}")
    s63 = section(fw, r"^### 6\.3 ", r"^### |^## ") or ""
    for cells in table_rows(s63):
        if len(cells) > 1 and re.search(r"START|STOP", cells[1]):
            errors.append(f"command {cells[0]} {cells[1]} in section 6.3 starts or stops a recording")
    print(f"check 20 Bluetooth: {ble_rows} Bluetooth transition rows, {ble_hits} start or stop clauses in section 7 (each must be a refusal)")

    # 16. F3 rules
    f3 = 0
    head = "\n".join(fw.splitlines()[:4])
    if not re.match(r"^# .*\n\nVersion F6, ", fw):
        errors.append("header does not say Version F6")
    if follows(head) != "A5":
        errors.append(f"header follows {follows(head)}, expected architecture A5")
    if not re.search(r"follows[^\n]{0,80}sections 17\.11 to 17\.26", head, re.I):
        errors.append("header does not say it follows architecture sections 17.11 to 17.26")
    for lst in ("Changes from F5 to F6", "Changes from F4 to F5", "Changes from F3 to F4", "Changes from F2 to F3"):
        if lst not in fw:
            errors.append(f"the change list '{lst}' is missing")
    f5list = section(fw, r"^Changes from F4 to F5", r"^(?!\d+\. )\S") or ""
    items = re.findall(r"^(\d+)\. \*\*", f5list, re.M)
    if items != [str(i) for i in range(1, 9)]:
        errors.append(f"'Changes from F4 to F5' must hold 8 numbered items, one per point of the brief: {items}")
    f6list = section(fw, r"^Changes from F5 to F6", r"^(?!\d+\. )\S") or ""
    if re.findall(r"^(\d+)\. \*\*", f6list, re.M) != ["1", "2", "3", "4"]:
        errors.append("'Changes from F5 to F6' must hold 4 numbered items")
    f3 += 4
    a166 = section(arch, r"^### 16\.6 ", r"^### |^## ") or ""
    if "64,000 bytes per second, 230.4 MB per hour" not in a166:
        errors.append("architecture 16.6 no longer gives 64,000 bytes per second, 230.4 MB per hour")
    ch = re.search(r"\| 23 \| 1 \| channels \| (\d+) \|", fw)
    rate = re.search(r"\| 24 \| 4 \| sample_rate_hz \| ([\d,]+) \|", fw)
    if not (ch and rate):
        errors.append("chunk header rows channels or sample_rate_hz not found")
    else:
        bps = int(ch.group(1)) * int(rate.group(1).replace(",", "")) * 2
        if bps != 64000 or bps * 3600 != 230_400_000:
            errors.append(f"audio format gives {bps} bytes per second, architecture 16.6 says 64,000")
        mm = re.search(r"holds ([\d,]+) frames of (\d+) channels", fw)
        pay = re.search(r"\+ (\d+) payload sectors \(([\d,]+) bytes\) = ([\d,]+) bytes", fw)
        if not (mm and pay):
            errors.append("section 5.3 chunk size sentences not found")
        else:
            frames, nch = int(mm.group(1).replace(",", "")), int(mm.group(2))
            sectors, pbytes, cbytes = int(pay.group(1)), int(pay.group(2).replace(",", "")), int(pay.group(3).replace(",", ""))
            if nch != int(ch.group(1)) or frames * nch * 2 != pbytes or sectors * 512 != pbytes or (sectors + 1) * 512 != cbytes:
                errors.append(f"chunk arithmetic: {frames} frames x {nch} ch x 2 = {frames * nch * 2}, {sectors} sectors = {sectors * 512}, chunk {cbytes}")
            if frames / int(rate.group(1).replace(",", "")) != 0.512:
                errors.append("a chunk is not 512 ms")
            for pat, want in ((r"Chunk ring, 3 x ([\d,]+) \| ([\d,]+)", 3), (r"/ (\d+)\) chunks of (\d+) sectors", None)):
                m = re.search(pat, fw)
                if not m:
                    errors.append(f"pattern not found: {pat}")
                elif want == 3:
                    if int(m.group(1).replace(",", "")) != cbytes or int(m.group(2).replace(",", "")) != 3 * cbytes:
                        errors.append(f"chunk ring line {m.group(0)} does not match the chunk of {cbytes} bytes")
                elif int(m.group(1)) != sectors + 1 or int(m.group(2)) != sectors + 1:
                    errors.append(f"chunk area divides by {m.group(1)} / {m.group(2)}, a chunk is {sectors + 1} sectors")
    f3 += 1
    per = section(fw, r"^Peripheral instances", r"^## ") or ""
    mic_rows = [ln for ln in per.splitlines() if ln.startswith("| Microphones")]
    if len(mic_rows) != 1 or "`pdm20`" not in mic_rows[0] or "pdm21" in mic_rows[0]:
        errors.append(f"peripheral table must hold one microphone row on pdm20 only: {mic_rows}")
    if re.search(r"\| `pdm21`", per):
        errors.append("a peripheral table row uses pdm21")
    f3 += 1
    a173 = section(arch, r"^### 17\.3 ", r"^### |^## ") or ""
    names = re.search(r"SW1 = up \((JOY_UP)\), SW3 = down \((JOY_DOWN)\), SW4 = toward the hand \((JOY_LEFT)\), SW5 = toward the fingertip \((JOY_RIGHT)\), SW2 = the joystick's centre switch \(net (BTN_REC)", a173)  # wording of 2026-11-13: SW2 is no longer called "record button" (architecture 17.11); the net name is still demanded
    s22 = section(fw, r"^### 2\.2", r"^### |^## ") or ""
    s22h = fw[fw.index("### 2.2"):].splitlines()[0]
    if not names:
        errors.append("architecture 17.3 switch-name line not found")
    else:
        for sw, sig in zip(("SW1", "SW3", "SW4", "SW5"), names.groups()):
            if not re.search(rf"{sw} [a-z ]+ {sig} P\d\.\d{{2}}", s22h):
                errors.append(f"heading of 2.2 does not give {sw} on {sig}")
        if not re.search(r"BTN_REC P0\.04 \(SW2\)", fw):
            errors.append("BTN_REC is not given as SW2")
    a165 = section(arch, r"^### 16\.5 ", r"^### |^## ") or ""
    w16 = re.search(r"close within (\d+) ms", a165)
    w22 = re.search(r"close within (\d+) ms", s22)
    if not (w16 and w22) or w16.group(1) != w22.group(1):
        errors.append(f"centre press window: architecture 16.5 {w16 and w16.group(1)} ms, firmware 2.2 {w22 and w22.group(1)} ms")
    f3 += 2
    bad = 0
    for i, ln in enumerate(body.splitlines(), 1):
        if re.search(r"JOY_CENTER|MIC_B_|P0\.03|P1\.24|P1\.25", ln) and not re.search(r"unused|not used", ln):
            bad += 1
            errors.append(f"unused pin named on a line that does not say unused (body line {i}): {ln[:70]}")
    f3 += 1
    a174 = section(arch, r"^### 17\.4 ", r"^### |^## ") or ""
    s31 = section(fw, r"^### 3\.1 ", r"^### |^## ") or ""
    # F5: the motor runs from its own regulator U11 (architecture 17.22, motor-drive.md)
    for need in ("W0525AB001D", "U11", "MOT_EN", "VMOT", "R61", "R62", "0.55 ms", "no PWM"):
        if need not in s31:
            errors.append(f"section 3.1 lacks '{need}'")
    if re.search(r"\bQ1\b", s31):
        errors.append("section 3.1 still names Q1 (removed by architecture 17.22)")
    a1716 = section(arch, r"^### 17\.16 ", r"^### |^## ") or ""
    a1722 = section(arch, r"^### 17\.22 ", r"^### |^## ") or ""
    if "W0525AB001D" not in a1716:
        errors.append("architecture 17.16 no longer names W0525AB001D")
    if "U11" not in a1722 or "TLV75530PDQNR" not in a1722 or "MOTOR" not in a1722:
        errors.append("architecture 17.22 no longer names U11 TLV75530PDQNR switched by MOTOR")
    if not re.search(r"t_on x 80 mA \+ 10 ms x 175 mA", s31) or "[ESTIMATE]" not in s31:
        errors.append("section 3.1 lacks the motor charge rule t_on x 80 mA + 10 ms x 175 mA tagged [ESTIMATE]")
    s93 = section(fw, r"^### 9\.3 ", r"^### |^## ") or ""
    tm = (re.search(r"^\| 0x40 \| T-MOTOR[^\n]*", s93, re.M) or re.search("", "")).group(0)
    if "VBAT" not in tm or "rises by" in tm:
        errors.append("T-MOTOR must read the VBAT dip, not the chip's battery current")
    f3 += 1
    # F5: battery per ring size (architecture 17.17), recording current 4.0 + 2 x (0.63 - 0.58)
    a1726b = section(arch, r"^### 17\.26 ", r"^### |^## ") or ""
    size_rows = re.findall(r"^\| US (\d+) \| [^|]+\| [^|]+\| [\d.]+ mm \| ([\d.]+) to ([\d.]+) mAh \|", a1726b, re.M)
    s11 = section(fw, r"^### 1\.1 ", r"^### ") or ""
    s85 = section(fw, r"^### 8\.5 ", r"^### |^## ") or ""
    s81b = section(fw, r"^### 8\.1 ", r"^### |^## ") or ""
    pcts = {k: int(v) for k, v in re.findall(r"\*\*(B\d+)\*\*: state of charge at or under (\d+) %", s11)}
    rc = re.search(r"4\.0 \+ 2 x \(([\d.]+) - ([\d.]+)\) = ([\d.]+) mA", s85)
    kn_i = re.search(r"Supply Current\s+Idd\s+Vdd = 1\.8V\s+-\s+(\d+)\s+(\d+)\s+µA", knowles)
    pm = re.search(r"Time left at ([\d.]+) mA on ([\d.]+) mAh \[CALC[^\]]*\]: B15 (\d+) min, B5 (\d+) min, B2 (\d+) min", s11)
    pl = re.search(r"On the largest cell, ([\d.]+) mAh at US 13, the same shares give B15 (\d+) min, B5 (\d+) min, B2 (\d+) min", s11)
    if not (size_rows and rc and kn_i and pm and pl and set(pcts) == {"B15", "B5", "B2"}):
        errors.append("battery recomputation lines not found (architecture 17.26 table, firmware 8.5 current line, Knowles current, 1.1 minutes lines, three percentages)")
    else:
        cmin = min(float(a) for u, a, b in size_rows)
        cmax = max(float(b) for u, a, b in size_rows)
        i_new, i_old, i_rec = float(rc.group(1)), float(rc.group(2)), float(rc.group(3))
        if abs(i_new * 1000 - int(kn_i.group(1))) > 0.5:
            errors.append(f"microphone current {i_new} mA differs from the Knowles copy {kn_i.group(1)} uA")
        if abs(4.0 + 2 * (i_new - i_old) - i_rec) > 0.005:
            errors.append(f"recording current 4.0 + 2 x ({i_new} - {i_old}) is not {i_rec}")
        ma, lo = float(pm.group(1)), float(pm.group(2))
        if lo != cmin or ma != i_rec:
            errors.append(f"1.1 minutes use {lo} mAh at {ma} mA; smallest cell {cmin} mAh, recording {i_rec} mA")
        want = [int(pcts[k] / 100 * cmin / i_rec * 60 + 0.5) for k in ("B15", "B5", "B2")]
        got = [int(x) for x in pm.groups()[2:]]
        if want != got:
            errors.append(f"battery minutes on the smallest cell {got} differ from the computation {want}")
        want_l = [int(pcts[k] / 100 * cmax / i_rec * 60 + 0.5) for k in ("B15", "B5", "B2")]
        got_l = [int(x) for x in pl.groups()[1:]]
        if float(pl.group(1)) != cmax or want_l != got_l:
            errors.append(f"battery minutes on the largest cell {pl.group(1)}: {got_l}, computed {want_l} on {cmax}")
        hr = re.search(r"\| Hours across US 7 to 13, ([\d.]+) to ([\d.]+) mAh \[CALC\] \| ([\d.]+) to ([\d.]+) \| ([\d,]+) to ([\d,]+) ", s85)
        if not hr:
            errors.append("8.5 row 'Hours across US 7 to 13' not found")
        else:
            g = hr.groups()
            if (float(g[0]), float(g[1])) != (cmin, cmax):
                errors.append(f"8.5 range {g[0]} to {g[1]} mAh differs from architecture 17.26 {cmin} to {cmax}")
            if abs(float(g[2]) - cmin / i_rec) > 0.05 or abs(float(g[3]) - cmax / i_rec) > 0.05:
                errors.append(f"8.5 recording hours {g[2]} to {g[3]} differ from {cmin / i_rec:.2f} to {cmax / i_rec:.2f}")
            if abs(int(g[4].replace(",", "")) - cmin / 0.03) > 1 or abs(int(g[5].replace(",", "")) - cmax / 0.03) > 1:
                errors.append(f"8.5 standby hours {g[4]} to {g[5]} differ from {cmin / 0.03:.0f} to {cmax / 0.03:.0f}")
        rec_rows = {u: (a, b, x, y) for u, a, b, x, y in re.findall(r"^\| US (\d+) \| ([\d.]+) to ([\d.]+) mAh \| ([\d.]+) to ([\d.]+) \|$", s85, re.M)}
        chg_rows = {u: (a, b, x, y) for u, a, b, x, y in re.findall(r"^\| US (\d+) \| ([\d.]+) to ([\d.]+) mAh \| ([\d.]+) to ([\d.]+) hours \|$", s81b, re.M)}
        for u, a, b in size_rows:
            for name, rows, div in (("8.5 recording", rec_rows, i_rec), ("8.1 charge", chg_rows, 15.0)):
                r = rows.get(u)
                if not r or (r[0], r[1]) != (a, b) or abs(float(r[2]) - float(a) / div) > 0.006 or abs(float(r[3]) - float(b) / div) > 0.006:
                    errors.append(f"{name} row for US {u} {r} differs from {a} to {b} mAh / {div}")
        print(f"check 16 battery: smallest {cmin}, largest {cmax} mAh at {i_rec} mA; minutes {got} and {got_l}; {len(rec_rows)} recording rows, {len(chg_rows)} charge rows")
    f3 += 1
    s61 = section(fw, r"^### 6\.1 ", r"^### |^## ") or ""
    if not re.search(r"four pads.*VBUS, D-, D\+, GND", s61):
        errors.append("section 6.1 does not give four pads in the order VBUS, D-, D+, GND")
    if "VBUS, D-, D+, GND" not in a173:
        errors.append("architecture 17.3 pad order not found")
    f3 += 1
    print(f"check 16 F3 rules: {f3} rule groups checked")

    # 17. F4 rules
    f4 = 0
    clean = lambda s: s.replace("`", "")
    trows = []
    for cells in table_rows(trans_block or ""):
        if len(cells) >= 4 and cells[0] != "From":
            trows.append((clean(cells[0]), cells[1], clean(cells[2]), cells[3]))
    centre_ev = re.compile(r"(long|short|double) press of the joystick centre")
    dir_words = re.compile(r"\b(up|down|left|right|toward|direction|joystick|button)\b", re.I)
    if rec:
        starts = [r for r in trows if r[2] == rec and r[0] != rec]
        if len(starts) != 1 or starts[0][0] != "STANDBY" or not re.fullmatch(r"long press of the joystick centre", starts[0][1]):
            errors.append(f"the recording state must be entered by exactly one row, a long press of the joystick centre from STANDBY: {starts}")
        stops = [r for r in trows if r[0] == rec and r[1].lower().startswith("long press")]
        if len(stops) != 1 or stops[0][2] != "STANDBY" or "close" not in stops[0][3]:
            errors.append(f"a long press in {rec} must go to STANDBY and close the recording: {stops}")
        for r in trows:
            if r[0] == rec and "short press" in r[1].lower() and not (r[2] == rec and "highlight" in r[3]):
                errors.append(f"short press in {rec} must stay in it and mark a highlight: {r}")
            if r[0] == rec and "double press" in r[1].lower() and not (r[2] == rec and r[3].startswith("nothing")):
                errors.append(f"double press in {rec} must do nothing: {r}")
            if dir_words.search(r[1]) and not centre_ev.fullmatch(r[1]) and (rec in (r[0], r[2]) or r[0] != r[2]):
                errors.append(f"an event naming a direction, the joystick or a button touches the recording state or changes state: {r}")
            if centre_ev.fullmatch(r[1]) is None and re.search(r"press", r[1], re.I) and not r[1].lower().startswith(("long press", "short press", "double press")):
                errors.append(f"unknown press event: {r}")
    f4 += 1
    s21t = table_rows(s21)
    hdr = next((c for c in s21t if c[0] == "Gesture"), None)
    grows = {c[0]: c for c in s21t if len(c) >= 5 and c[0] != "Gesture"}
    if not hdr or not rec:
        errors.append("gesture table of 2.1 not found")
    else:
        ssr = re.compile(r"(start|stop|begin|end)\w*\s+(a |the )?recording", re.I)
        scols = [i for i, h in enumerate(hdr) if i > 1]
        i_rec = next((i for i, h in enumerate(hdr) if f"`{rec}`" in h), None)
        i_sb = next((i for i, h in enumerate(hdr) if "`STANDBY`" in h), None)
        lp = grows.get("Long press")
        if not lp or i_rec is None or i_sb is None or "stop the recording" not in lp[i_rec] or "start a recording" not in lp[i_sb]:
            errors.append("2.1 gesture table: the long press must stop the recording in the recording state and start one in STANDBY")
        for name in ("Short press", "Double press", "Graze", "Held 450 ms to 999 ms"):
            row = grows.get(name)
            if not row:
                errors.append(f"2.1 gesture table lacks the row {name}")
                continue
            for i in scols:
                if ssr.search(row[i]):
                    errors.append(f"2.1 gesture table: '{name}' starts or stops a recording: {row[i]}")
                if name == "Double press" and not row[i].startswith("does nothing"):
                    errors.append(f"2.1 gesture table: double press must do nothing: {row[i]}")
                if name in ("Graze", "Held 450 ms to 999 ms") and not row[i].startswith("ignored"):
                    errors.append(f"2.1 gesture table: '{name}' must be ignored: {row[i]}")
    f4 += 1
    m22 = table_rows(s22)
    h22 = next((c for c in m22 if c[0] == "Screen"), None)
    bad_dir = re.compile(r"(start|stop|begin)\w*\s+(a |the )?recording|highlight|long press", re.I)
    if not h22:
        errors.append("mapping table of 2.2 not found")
    else:
        ix = {h.lower(): i for i, h in enumerate(h22)}
        for c in m22:
            if c[0].startswith("SCR_"):
                for d in ("up", "down", "left", "right"):
                    if bad_dir.search(c[ix[d]]):
                        errors.append(f"2.2: a direction ({d}) on {c[0]} starts or stops a recording or marks a highlight: {c[ix[d]]}")
                if c[0] == "SCR_RECORDING" and "highlight" not in c[ix["centre"]]:
                    errors.append("2.2: the centre on SCR_RECORDING must mark the highlight (collision C1)")
    if not re.search(r"A direction never starts or stops a recording", s22):
        errors.append("2.2 does not say a direction never starts or stops a recording")
    colls = set(re.findall(r"^- \*\*(C\d)\*\*", s22, re.M))
    if colls != {"C1", "C2", "C3", "C4"}:
        errors.append(f"2.2 collisions listed {sorted(colls)}, expected C1 to C4")
    f4 += 1
    cs = {}
    for c in s21t:
        if len(c) >= 4 and c[0] in ("`SW2`", "`PAIR`"):
            cs[c[0]] = c
    if set(cs) != {"`SW2`", "`PAIR`"} or not all(c[1] and "ms" in c[2] and c[3] for c in cs.values()):
        errors.append(f"2.1 table 'Centre source' must give both cases with an input, a debounce in ms and a timing: {sorted(cs)}")
    elif "SW2 on BTN_REC" not in cs["`SW2`"][1] or "SW1 with SW3" not in cs["`PAIR`"][1]:
        errors.append("2.1 'Centre source': case SW2 must name SW2 on BTN_REC, case PAIR must name SW1 with SW3")
    if "CENTRE_SOURCE" not in s21:
        errors.append("2.1 does not name CENTRE_SOURCE")
    prm = {c[0]: c[1] for c in s21t if len(c) == 2}
    def pint(key, pat):
        mm = re.search(pat, prm.get(key, ""))
        return int(mm.group(1).replace(",", "")) if mm else None
    sh_hi = pint("Short press", r"40 ms to (\d+) ms")
    warn = pint("Warning pulse", r"at (\d+) ms")
    lng = pint("Long press", r"([\d,]+) ms hold")
    hold = pint("Release hold-off", r"^(\d+) ms")
    deb = pint("Debounce", r"(\d+) ms")
    gap = pint("Double-press window", r"starting (\d+) ms to")
    if None in (sh_hi, warn, lng, hold, deb, gap):
        errors.append(f"2.1 parameter table lacks a value: {(sh_hi, warn, lng, hold, deb, gap)}")
    else:
        if not sh_hi < warn < lng:
            errors.append(f"short-press ceiling {sh_hi} ms, warning {warn} ms and long press {lng} ms are not in order")
        if not deb < hold < gap:
            errors.append(f"release hold-off {hold} ms is not between the debounce {deb} ms and the double-press gap {gap} ms")
        if lng != 1000:
            errors.append(f"long press is {lng} ms, architecture 17.11 fixes 1.0 s")
    if not re.search(r"^\| MW \|[^\n]*\| \d+ on \| \d+ \|", s31, re.M):
        errors.append("the motor table (3.1) lacks the warning pattern MW")
    f4 += 1
    s12 = section(fw, r"^### 1\.2 ", r"^## ") or ""
    for r in trows:
        if r[2] == "CHARGING" and "charge on" not in r[3]:
            errors.append(f"the row into CHARGING does not turn the charger on: {r}")
        if r[0] in ("SHIP", "OFF") and r[2] == "BOOT" and "VBUS" in r[1] and "charge on" not in r[3]:
            errors.append(f"the ship-mode exit row does not turn the charger on: {r}")
    if not any(r[0] == "SHIP" and r[2] == "BOOT" and "VBUS" in r[1] for r in trows):
        errors.append("the row that leaves ship mode on VBUS is missing")
    ce = re.search(r"`charging-enable` \| ([^\n]*)", s81)
    if not ce or not ce.group(1).startswith("on whenever VBUS is present") or "off until" in ce.group(1):
        errors.append(f"`charging-enable` must be on whenever VBUS is present: {ce and ce.group(1)[:60]}")
    cc = re.search(r"`current-microamp` \| ([^\n]*)", s81)
    for need in ("CHARGE_CURRENT", "15,000", "17.6 mAh", "0.85 C", "S12"):
        if not cc or need not in cc.group(1):
            errors.append(f"`current-microamp` row lacks '{need}'")
    if "R-CHG" not in s12:
        errors.append("rule R-CHG is not stated in section 1.2")
    f4 += 1
    s86 = section(fw, r"^### 8\.6 ", r"^### |^## ") or ""
    for need in ("VBUS is an input only", "nothing is driven onto any pad when no case is present"):
        if need not in s86:
            errors.append(f"section 8.6 lacks '{need}'")
    a1711 = section(arch, r"^### 17\.11 ", r"^### |^## ") or ""
    a1712 = section(arch, r"^### 17\.12 ", r"^### |^## ") or ""
    for need in ("long press of 1.0 s on the joystick's centre starts a recording", "a real switch under the nub's centre", "two-opposite-switches reading"):
        if need not in a1711:
            errors.append(f"architecture 17.11 no longer says '{need}'")
    if "INSIDE face of the band" not in a1712 or "VBUS is an input only" not in a1712:
        errors.append("architecture 17.12 no longer puts the pads on the inside face with VBUS an input only")
    if "just have long press on joystick as recording button" not in fw:
        errors.append("the owner's words about the joystick are not quoted")
    f4 += 1
    print(f"check 17 F4 rules: {f4} rule groups checked, {len(trows)} transition rows read")

    # 18. F5 rules
    f5 = 0
    # 18a. pin table and named nets against netlist.csv (wiring A7)
    u1 = {(n, pname) for n, r, pn, pname in netrows if r == "U1"}
    u1_pins = {pname: n for n, r, pn, pname in netrows if r == "U1"}
    pairs5 = re.findall(r"(?<![A-Za-z0-9_])([A-Z][A-Z0-9_]+) (P\d\.\d{2})", fw)
    for sig, pin in pairs5:
        if (sig, pin) not in u1:
            errors.append(f"{sig} {pin} in firmware.md: netlist.csv gives {pin} the net {u1_pins.get(pin)}")
    allpins = set(re.findall(r"P\d\.\d{2}", fw))
    for pin in sorted(allpins):
        if pin not in u1_pins:
            errors.append(f"pin {pin} named in firmware.md is not a U1 pin in netlist.csv")
        elif u1_pins[pin] not in fw:
            errors.append(f"pin {pin} is net {u1_pins[pin]} in netlist.csv, a name firmware.md never uses")
    netset = set((n, r, pn) for n, r, pn, pname in netrows)
    facts = [
        ("PMIC_INT", "U2", "D6", r"GPIO0, ball D6"),
        ("VDD_MIC", "U2", "A4", r"VDD_MIC, ball A4"),
        ("VDD_SD", "U2", "A5", r"VDD_SD, ball A5"),
        ("NTC", "U2", "D3", r"NTC pin, ball D3"),
        ("SHPHLD", "TP19", "1", r"SHPHLD sits on test pad TP19"),
        ("GND", "U5", "3", r"U5, pin 3 SELECT on GND"),
        ("VDD_MIC", "U6", "3", r"U6, pin 3 SELECT on VDD_MIC"),
        ("MIC_A_CLK", "U5", "2", r"pin 2 CLOCK on MIC_A_CLK"),
        ("MIC_A_CLK", "U6", "2", r"pin 2 CLOCK on MIC_A_CLK"),
        ("VDD_MIC", "U5", "4", r"pin 4 Vdd on VDD_MIC"),
        ("MOTOR", "R61", "1", r"MOTOR drives U11's EN pin \(pin 3\) through R61"),
        ("MOT_EN", "R61", "2", r"through R61 100 ohm on the net MOT_EN"),
        ("MOT_EN", "R62", "1", r"R62 100 kilo-ohm from MOT_EN to ground"),
        ("GND", "R62", "2", r"R62 100 kilo-ohm from MOT_EN to ground"),
        ("MOT_EN", "U11", "3", r"U11's EN pin \(pin 3\)"),
        ("VMOT", "U11", "1", r"output is the net VMOT"),
        ("VBAT", "U11", "4", r"input is the cell \(net VBAT\)"),
        ("VMOT", "J_BAND_A", "7", r"pad 7 MOT\+ on VMOT"),
        ("GND", "J_BAND_A", "6", r"pad 6 MOT- on GND"),
        # v7 (architecture 17.30): Q2, R41 and LED1 left the design; no fact about them is required
    ]
    for net, ref, pn, pat in facts:
        if (net, ref, pn) not in netset:
            errors.append(f"netlist.csv has no row {net},{ref},{pn} that firmware.md states")
        if not re.search(pat, fw):
            errors.append(f"firmware.md no longer states '{pat}' (net {net} on {ref} pin {pn})")
    gone = sorted({r for n, r, pn, pname in netrows if r in ("Q1", "D1")})
    if gone:
        errors.append(f"netlist.csv still holds {gone}; F5 says they left the design")
    print(f"check 18a netlist: {len(pairs5)} signal-pin pairs, {len(allpins)} pins, {len(facts)} named nets checked against {len(netrows)} netlist rows")
    f5 += 1
    # 18b. microphone part and gain arithmetic
    s41 = section(fw, r"^### 4\.1 ", r"^### |^## ") or ""
    for blk, name in ((s41, "4.1"), (s85, "8.5")):
        if "SPK0641HT4H-1" not in blk:
            errors.append(f"section {name} does not name the microphone SPK0641HT4H-1")
    if "SPK0641HT4H-1" not in (section(arch, r"^### 17\.19 ", r"^### |^## ") or ""):
        errors.append("architecture 17.19 no longer names SPK0641HT4H-1")
    # gain rule (lead's decision 2026-11-11, H16): gain 0 dB, register 0x28, header equal,
    # stored full scale = 94 dB SPL - sensitivity = the AOP of the Knowles copy
    s_new = re.search(r"Sensitivity\s+S\s+94 dB SPL @ 1 kHz\s+-?\d+\s+(-\d+)\s+", knowles)
    aop = re.search(r"Acoustic Overload Point\s+AOP\s+10% THD @ 1 kHz, S = Typ\s+-\s+(\d+)\s+-\s+dB SPL", knowles)
    gm = re.search(r"`gain_db = (-?\d+)`, register value (0x[0-9A-F]{2})", s41)
    hdr_gain = re.search(r"\| 74 \| 1 \| gain_code \| (0x[0-9A-F]{2})", fw)
    fs41 = re.search(r"full scale \(a clipped sample, chunk flag bit 4\) is reached at 94 \+ (\d+) = (\d+) dB SPL", s41)
    if not (s_new and aop and gm and hdr_gain and fs41):
        errors.append("gain check: Knowles sensitivity or AOP, the gain row of 4.1, its full-scale line or the header gain_code not found")
    else:
        g, reg = int(gm.group(1)), int(gm.group(2), 16)
        sens, a_op = int(s_new.group(1)), int(aop.group(1))
        if g != 0:
            errors.append(f"gain {g} dB; the lead's decision (H16) is 0 dB")
        if reg != 2 * g + 0x28 or reg != 0x28:
            errors.append(f"gain register {gm.group(2)} is not 0x28 (2 x 0 + 0x28)")
        if hdr_gain.group(1) != gm.group(2):
            errors.append(f"chunk header gain_code {hdr_gain.group(1)} differs from the PDM register {gm.group(2)}")
        full = 94 - sens - g
        if full != a_op:
            errors.append(f"stored full scale 94 - ({sens}) - ({g}) = {full} dB SPL differs from the AOP {a_op} dB SPL")
        if int(fs41.group(1)) != -sens - g or int(fs41.group(2)) != full:
            errors.append(f"4.1 states full scale at 94 + {fs41.group(1)} = {fs41.group(2)} dB SPL, computed {full}")
        print(f"check 18b microphone: sensitivity {sens} dBFS, gain {g} dB, register {gm.group(2)}, full scale {full} dB SPL, AOP {a_op} dB SPL")
    f5 += 1
    # 18c. ship mode: the nPM1304 ship task after VBUS removal, no timed hibernate
    s84 = section(fw, r"^### 8\.4 ", r"^### |^## ") or ""
    for need in ("TASKENTERSHIPMODE", "VBUS removal", "EVENTVBUSREMOVED", "No timer", "[NPM p116]"):
        if need.lower() not in s84.lower():
            errors.append(f"section 8.4 lacks '{need}'")
    iw = s84.find("wait for the event EVENTVBUSREMOVED")
    it = s84.find("Write TASKENTERSHIPMODE = 1")
    if iw == -1 or it == -1 or iw > it:
        errors.append("section 8.4 must wait for the event EVENTVBUSREMOVED before it writes TASKENTERSHIPMODE")
    for bad_w in ("74.6", "longest timer", "hibernate()"):
        if bad_w in s84:
            errors.append(f"section 8.4 still holds the timed hibernate ('{bad_w}')")
    ss = (re.search(r"^\| 0x7E \| SHIP_SAMPLE[^\n]*", s93, re.M) or re.search("", "")).group(0)
    se = (re.search(r"^\| 0x7F \| SHIP_ENTER[^\n]*", s93, re.M) or re.search("", "")).group(0)
    if "keep the factory flag" not in ss or "VBUS removal" not in ss:
        errors.append("9.3 lacks SHIP_SAMPLE that keeps the factory flag and waits for VBUS removal")
    if "clear the factory flag" not in se or "VBUS removal" not in se:
        errors.append("9.3 SHIP_ENTER must clear the factory flag and wait for VBUS removal")
    if not any(r[0] == "FACTORY_TEST" and r[2] == "SHIP" and "SHIP_SAMPLE" in r[1] and "keep the factory flag" in r[3] for r in trows):
        errors.append("transition table lacks FACTORY_TEST -> SHIP on SHIP_SAMPLE keeping the factory flag")
    f5 += 1
    # 18d. battery current limit: no setting, fixed IBATLIM, status bit acted on
    if re.search(r"^\| \| `dischg", s81, re.M):
        errors.append("8.1 still sets a discharge limit (the nPM1304 has none)")
    s87 = section(fw, r"^### 8\.7 ", r"^### |^## ") or ""
    for need in ("IBATLIM", "100 mA", "BCHGILIMBATACTIVE", "RSTCAUSE", "[NPM p28]", "[NPM p40]"):
        if need not in s87:
            errors.append(f"section 8.7 lacks '{need}'")
    s83 = section(fw, r"^### 8\.3 ", r"^### |^## ") or ""
    if "Q_motor" not in s83:
        errors.append("section 8.3 does not add the motor's charge to the fuel gauge")
    f5 += 1
    # 18e. charge settings of the nPM1304
    if not re.search(r"`term-current-percent` \| 10 ", s81):
        errors.append("8.1 term-current-percent is not 10")
    if "value 9" not in s81 or "[NPM p36]" not in s81:
        errors.append("8.1 does not cite 4.35 V as register value 9 [NPM p36]")
    f5 += 1
    # 18f. section 7 sentence (no link protocol in F5) and the factory flow by assembly step
    s7 = section(fw, r"^## 7\. ", r"^### ") or ""
    if "The home-made link protocol (design/protocol/) stays paused; nothing of it is here." not in s7:
        errors.append("section 7 lacks the sentence on the link protocol at its top")
    for step in ("| 5 |", "| 18 |", "| 25 |", "| 26 |", "| 27 |"):
        if step not in s93:
            errors.append(f"9.3 factory flow lacks assembly step row {step}")
    if "[PROPOSED" not in s93 or "50 percent" not in s93:
        errors.append("9.3 does not mark the first charge to 50 percent as PROPOSED")
    s92 = section(fw, r"^### 9\.2 ", r"^### |^## ") or ""
    if "K-A1" not in s92:
        errors.append("9.2 does not answer assembly conflict K-A1")
    f5 += 1
    print(f"check 18 F5 rules: {f5} rule groups checked")

    # 19. F6: no value of the calculated cells of 17.17 as a current value
    stale = re.compile(r"(?<![\d.,])(18\.2|24\.3|32\.9)(?![\d])|18,200|(?<!\d)18200(?!\d)")
    nstale = 0
    for i, ln in enumerate(body.splitlines(), 1):
        # "before" must stand within 60 characters of the value (a "before" elsewhere on the line,
        # in another sense, does not make the value a former one)
        for m in stale.finditer(ln):
            near = ln[max(0, m.start() - 60):m.end() + 60].lower()
            if "before" not in near:
                nstale += 1
                errors.append(f"former cell value '{m.group(0)}' named as a current value (body line {i}, outside the change lists): {ln[max(0, m.start() - 30):m.end() + 30]}")
    print(f"check 19 former cell values: {nstale} uses of 18.2, 24.3, 32.9 or 18,200 without 'before' within 60 characters")

    # 21. v7 (architecture 17.29, 17.30): no recording light, the screen is the recording sign,
    #     the one control is the round joystick with the centre switch SW2 (net BTN_REC)
    v7 = 0
    gone_re = re.compile(r"\bLED1\b|\bR41\b|\bQ2\b|\bLG1\b|\bLP1\b|T-LIGHT|recording light|light window|hard-wired|record button|\bnub\b|\bnub's\b", re.I)
    ngone = 0
    for i, ln in enumerate(fw.splitlines(), 1):
        if gone_re.search(ln) and "removed in v7" not in ln:
            ngone += 1
            errors.append(f"v7: line {i} names a removed part or the old control without saying 'removed in v7': {ln[:90]}")
    v7 += 1
    s32 = section(fw, r"^### 3\.2 ", r"^### |^## ") or ""
    for need in ("R-SIGN", "never dark", "red dot and the timer", "3 s", "SCR_REC_DIM", "`rec_mics_on()`",
                 "only code that enables VDD_MIC", "Test SIGN-1", "no state records with the screen dark", "bench"):
        if need not in s32:
            errors.append(f"v7: section 3.2 lacks '{need}' (the recording sign rule of architecture 17.30)")
    if re.search(r"\d[\d.]* ?mA", s32.replace("1.5 mA once counted for the recording light", "")):
        errors.append("v7: section 3.2 gives the always-lit dot a current figure; it is a bench item with no number")
    v7 += 1
    rec_row = next((c for c in table_rows(states_block or "") if rec and c[0] == f"`{rec}`"), None)
    if not rec_row or len(rec_row) < 5 or not rec_row[4].startswith("never dark"):
        errors.append(f"v7: the screen cell of `{rec}` in 1.1 must start with 'never dark': {rec_row and rec_row[4]}")
    rec82 = next((c for c in table_rows(s82 or "") if rec and c[0] == f"`{rec}`"), None)
    if not rec82 or len(rec82) < 6 or not rec82[5].startswith("on for the whole recording"):
        errors.append(f"v7: the screen supply of `{rec}` in 8.2 must be on for the whole recording: {rec82 and rec82[5]}")
    s45 = section(fw, r"^### 4\.5 ", r"^### |^## ") or ""
    st2 = re.search(r"^2\. `regulator_enable\(\)`[^\n]*", s45, re.M)
    if not st2 or "`rec_mics_on()`" not in st2.group(0) or "after the screen accepted the red dot and the timer" not in st2.group(0):
        errors.append("v7: 4.5 start step 2 must enable VDD_MIC only from `rec_mics_on()` after the screen accepted the red dot and the timer")
    refuse = [r for r in trows if r[1] == "long press of the joystick centre, recording sign not drawn"]
    if len(refuse) != 1 or refuse[0][0] != "STANDBY" or refuse[0][2] != "STANDBY" or "VDD_MIC stays off" not in refuse[0][3]:
        errors.append(f"v7: 1.2 must hold one row STANDBY -> STANDBY 'long press of the joystick centre, recording sign not drawn' with VDD_MIC off: {refuse}")
    v7 += 1
    if re.search(r"^\| 0x41 \| T-LIGHT", s93, re.M) or not re.search(r"^\| 0x41 \| T-SIGN \|[^\n]*red dot is lit", s93, re.M):
        errors.append("v7: 9.3 must hold T-SIGN (the red dot lit while VDD_MIC is on) and no T-LIGHT row")
    if "includes the recording light" in s85 or not re.search(r"red dot and timer[^\n]*bench item", s85):
        errors.append("v7: 8.5 must not count the recording light and must name the dot's cost as a bench item")
    v7 += 1
    if "centre switch SW2 (net BTN_REC)" not in fw:
        errors.append("v7: firmware.md does not name the centre switch as 'centre switch SW2 (net BTN_REC)'")
    if not re.search(r"round joystick[^\n]*five switches", s22h):
        errors.append("v7: the heading of 2.2 must name the round joystick with five switches")
    v7 += 1
    a1729 = section(arch, r"^### 17\.29 ", r"^### |^## ") or ""
    a1730 = section(arch, r"^### 17\.30 ", r"^### |^## ") or ""
    if "**Joystick: round.**" not in a1729:
        errors.append("architecture 17.29 no longer makes the joystick round")
    for need in ("**Recording light: removed.**", "the screen never goes fully dark", "a test proves that no state records with the screen dark"):
        if need not in a1730:
            errors.append(f"architecture 17.30 no longer says '{need}'")
    left = sorted({r for n, r, pn, pname in netrows if r in ("LED1", "R41", "Q2")})
    v7 += 1
    print(f"check 21 v7: {v7} rule groups checked, {ngone} lines name a removed part without 'removed in v7'; netlist.csv still holds {left or 'none'} of LED1, R41, Q2 (reported, not judged: the wiring is another helper's file)")

    # 22. F7 part 2 (section 7): three paired devices, keyboard, media and pointer control
    s7all = section(fw, r"^## 7\. ", r"^## ") or ""
    s72 = section(fw, r"^### 7\.2 ", r"^### |^## ") or ""
    s73 = section(fw, r"^### 7\.3 ", r"^### |^## ") or ""
    s74 = section(fw, r"^### 7\.4 ", r"^### |^## ") or ""
    s75 = section(fw, r"^### 7\.5 ", r"^### |^## ") or ""
    if "CONFIG_BT_MAX_PAIRED=3" not in s74 or "CONFIG_BT_MAX_PAIRED=2" in s7all:
        errors.append("7.4 does not set three paired devices (CONFIG_BT_MAX_PAIRED=3)")
    if "a fourth pairing is refused" not in s74:
        errors.append("7.4 does not refuse a fourth pairing")
    if not re.search(r"deletes its bond \(the keys of both sides\)", s74):
        errors.append("7.4 does not delete both key sets when a paired device is removed")
    if "0x1812" not in s72 or "0x1812" not in s73:
        errors.append("the HID service 0x1812 is not in 7.2 and in the advertising data of 7.3")
    rid = {c[0]: c for c in table_rows(s72) if len(c) > 2 and c[0] in ("1", "2", "3")}
    for k, use, ln in (("1", "keyboard", "8 bytes"), ("2", "consumer control", "2 bytes"), ("3", "pointer", "3 bytes")):
        if k not in rid or rid[k][1] != use or rid[k][2] != ln:
            errors.append(f"7.2 report {k} is not '{use}', {ln}")
    modes = {c[0]: c for c in table_rows(s75) if len(c) == 6}
    for m in ("Media", "Presenter", "Pointer", "Agent"):
        if m not in modes:
            errors.append(f"7.5 has no row for the mode {m}")
    if "Presenter" in modes and modes["Presenter"][1] != "nothing":
        errors.append("7.5: the presenter's centre short press must send nothing")
    if "The centre long press sends nothing to any device in any mode" not in s75:
        errors.append("7.5 does not keep the centre long press away from every device")
    print(f"check 22 F7 part 2: {len(rid)} HID reports, {len([m for m in modes if m in ('Media', 'Presenter', 'Pointer', 'Agent')])} control modes")

    # 23. F7 part 3 (rulings R17, R18) and the holes design review 3 found in this check (H12)
    #  a. no sentence lets the screen go off or dark in RECORDING (reviewer's faulty files W2, W3)
    off_re = re.compile(r"\b(turns off|turn off|goes off|go off|stays off|goes dark|go dark|blanks|switches off)\b", re.I)
    neg2_re = re.compile(r"\b(never|not|no|nothing|except|instead|cannot|neither|nor)\b", re.I)
    dark = 0
    for i, ln in enumerate(fw.splitlines(), 1):
        for sent in re.split(r"(?<=[.;:])\s+|\s\|\s", ln):
            if "`RECORDING`" in sent and re.search(r"\bscreen\b", sent, re.I) and off_re.search(sent):
                dark += 1
                if not neg2_re.search(sent):
                    errors.append(f"line {i}: a sentence lets the screen go off in RECORDING: {sent.strip()[:110]}")
    #  b. no line fits a removed light part again, whatever else it says (W4)
    refit_re = re.compile(r"\b(LED1|R41|Q2|LG1|LP1)\b[^.]{0,80}\b(stay|stays|fitted|is fitted|are fitted|kept|second sign)\b", re.I)
    for i, ln in enumerate(fw.splitlines(), 1):
        if refit_re.search(ln) and not re.search(r"\b(out of the design|once|no longer|were|was|ball A2)\b", ln):
            errors.append(f"line {i}: a removed light part is fitted again: {ln.strip()[:110]}")
    #  c. R17: the control session and its screens
    s22b = section(fw, r"^### 2\.2 ", r"^### |^## ") or ""
    s33b = section(fw, r"^### 3\.3 ", r"^### |^## ") or ""
    s34b = section(fw, r"^### 3\.4 ", r"^### |^## ") or ""
    map_names = {c[0].split(" ")[0] for c in table_rows(s22b)}
    scr_names = {c[0] for c in table_rows(s33b)}
    for scr in ("SCR_MODES", "SCR_CONTROL", "SCR_DEVICES", "SCR_DEVICE"):
        if scr not in map_names:
            errors.append(f"2.2 has no joystick row for {scr}")
        if scr not in scr_names:
            errors.append(f"3.3 does not list {scr}")
    if 'in this order: "Recordings", "Control", "Devices", "Pair device", "Settings", "Power off"' not in s22b:
        errors.append("2.2 does not give the six menu items in order")
    for need in ("A double press of the centre closes the session", "does not close the session", "is the highlight marker and is not sent"):
        if need not in s34b:
            errors.append(f"3.4 lacks the rule: {need}")
    #  d. R18: no microphone test at assembly step 5 (no screen is joined there)
    s93b = section(fw, r"^### 9\.3 ", r"^### |^## ") or ""
    step5 = [c for c in table_rows(s93b) if c and c[0] == "5"]
    if not step5 or len(step5[0]) < 5:
        errors.append("9.3 factory flow has no row for assembly step 5")
    elif "T-MIC" in step5[0][3]:
        errors.append("9.3: assembly step 5 runs a microphone test with no screen joined (ruling R18)")
    if "**R18 (microphones in the factory" not in s93b:
        errors.append("9.3 lacks ruling R18")
    print(f"check 23 F7 part 3: {dark} sentences on the screen going off in RECORDING (each must be a refusal), 4 screens, step 5 without a microphone test")

    # 5. end matter
    if not re.search(r"^## questions_for_owner\s*$", fw, re.M):
        errors.append("section questions_for_owner missing")
    last = fw.rstrip("\n").splitlines()[-1] if fw.strip() else ""
    if not re.match(r"^RESULT: (done|blocked), ", last):
        errors.append(f"last line is not a RESULT line: {last[:60]!r}")
    print("check 5 end: questions_for_owner and RESULT line")

    for e in errors:
        print(f"FAIL {e}")
    print(f"{len(errors)} failures")
    return 1 if errors else 0


if __name__ == "__main__":
    sys.exit(main(sys.argv[1:]))
