NexusGPT/openring/firmware/build-logs/step6/review2-work/diff-regen.txt

diff --git a/design/firmware.md b/design/firmware.md
index fda3c27b..aeaa2030 100644
--- a/design/firmware.md
+++ b/design/firmware.md
@@ -215,7 +215,7 @@ Rules that apply to every state:
 - **Open flag (ruling R9):** the open flag is cleared only by two things: a successful close of a recording ("close") and "scan done" at the end of `RECOVERY` ("clear open flag"). Asking for recovery clears nothing. A read error during the scan goes to `ERR_STORAGE_FAULT` with the flag still set.
 - **Order at "init done" (rulings R4, R5, R12, correction R4b):** battery events that arrive in `BOOT` before "init done" are not applied at once: the level is kept and this order decides; at B2 (no VBUS) the row "battery at B2 and no VBUS" (to `OFF`, no recovery: the open flag stays set and the next start-up recovers); else a start-up with an unfinished recording takes the row "init done, superblock open flag set" first (`RECOVERY`); at the end of the scan the battery rule applies: "scan done, VBUS present" goes to `CHARGING`, "scan done, no VBUS" enters `STANDBY` through rule R-STB (at B5 to `ERR_BATTERY_LOW`); else at B5 (no VBUS) the row "battery at B5 and no VBUS" (to `ERR_BATTERY_LOW`); else the row "init done, superblock open flag clear, no VBUS, battery above B5" or "init done, VBUS present". If the storage init fails instead (row "storage init fails 3 times"), a kept B2 with no VBUS runs the row "`ERR_STORAGE_FAULT`, battery reaches B2" (to `OFF`) on entering `ERR_STORAGE_FAULT` (ruling R15).
 - **R4b (open flag):** a recording never starts while the superblock open flag is set. A long press in `STANDBY` with the flag set takes the row "long press, superblock open flag set" (to `RECOVERY`); the wearer presses again after the recovery.
-- The watchdog (`wdt31`, 8 s) resets the chip when the main loop stops; a reset during a recording leaves the open flag set, so `BOOT` goes to `RECOVERY`.
+- The watchdog (`wdt31`, 8 s) resets the chip when the system work queue that feeds it stops (section 9.4); a reset during a recording leaves the open flag set, so `BOOT` goes to `RECOVERY`.
 - Only one recording is open at a time. A storage operation never runs while the case reads (USB `BUSY` status, section 6).
 
 ## 2. Controls
@@ -1062,7 +1062,7 @@ Factory flow, step by step of `design/mfg/assembly/assembly.md` (the jig is work
 - Event log (both builds): each state change, fault, battery threshold and transfer command becomes a 512-byte record: magic 0x474C5252 ("RRLG") u32, record seq u32, uptime_ns u64, utc_ms i64, code u16, state u8, reserved u8, 16 bytes of arguments, crash block (below, zero when not a crash), CRC-32 in the last 4 bytes. Records wait in the 4 KB RAM log buffer (8 records) and are written to the log area (LBA 2 to 2,047) at the next time VDD_SD is on; when the buffer is full, the oldest unwritten record is dropped and a "dropped" count is kept. The codes are listed in the section "Event log codes" near the end of this document (ruling R23).
 - Crash capture: `k_sys_fatal_error_handler()` is overridden to write a crash block (fault reason u32, PC u32, LR u32, PSR u32, thread name 16 bytes, 64 words of the faulting stack) into 1 KB of retained RAM (`zephyr,retained-ram`, `drivers/retained_mem/retained_mem_zephyr_ram.c` [SRC 10]) and the reset reason code into `gpregret1` [SRC 1], then reboot. `BOOT` copies a valid crash block into the event log and clears it.
 - Power-chip reset causes: `BOOT` writes the nPM1304's RSTCAUSE and charger error log into the event log, then clears them (section 8.7).
-- Watchdog: `wdt31`, 8 s timeout, fed every 1 s by the main loop only when the audio and storage threads have reported progress in the last 2 s.
+- Watchdog: `wdt31`, 8 s timeout, fed every 1 s by a work item on the system work queue (the product has no main loop). While a recording runs it is fed only when the audio and storage threads have both reported progress in the last 2 s; with no recording it is fed at every turn. A stalled system work queue, or a recording thread without progress, ends in a reset after 8 s.
 
 ## 10. Work breakdown
 
@@ -1189,11 +1189,11 @@ Status in F5 of the issues raised in F1 to F4, after architecture A5-draft secti
 | H8 | F4: the power chip of F4 could not charge under 32 mA, above 1 C of the cell. | closed by architecture 17.13: the nPM1304 charges from 4 mA [NPM p24] | `CHARGE_CURRENT` = 15 mA, 0.85 C of the smallest cell (17.6 mAh); T-CHARGE passes at 13.5 to 16.5 mA | Grepow states the cell's own limit (S12); the value changes in one place |
 | H9 | F4: the microphone had no datasheet on disk. | closed by architecture 17.19: the Knowles SPK0641HT4H-1 has a datasheet copy | 1.280 MHz, ratio 80 and the 50 ms discard, now from that copy (sections 4.1, 4.5) | Knowles or a distributor confirms the part is made (S23) |
 | H10 | The pad order: architecture section 8 says "from -Y to +Y"; 17.3 lists the pads at X = -2.4, -0.8, +0.8, +2.4 mm, and 17.8 puts them at -150 degrees. | open, same name order in both | VBUS, D-, D+, GND in that order | architecture owner: state the axis of the order on the band; case owner: the case pins |
-| H11 | Architecture section 8 and the case document still give 6.3 minutes per recorded hour (four channels of audio, 461 MB). | open | 3.21 minutes per recorded hour with 2 channels (section 6.4) | architecture owner and case owner |
+| H11 | Architecture section 8 and the case document still give 6.3 minutes per recorded hour (four channels of audio, 461 MB). | closed 2026-11-13: `design/architecture.md` line 303 carries REPLACED and `design/case/case-architecture.md` line 88 gives 3.21 min | 3.21 minutes per recorded hour with 2 channels (section 6.4) | architecture owner and case owner |
 | H12 | Architecture 17.3 and 17.8 put the cell's temperature sensor in the band's flex tail (other side); sch-notes and bom-notes (conflict 5) put RT1 on the main board beside the cell. | closed 2026-11-11: RT1 sits on the cell, on its protection circuit PRT1 (`design/bom.csv` line 75; `design/wiring/lead-decisions.md` row 34) | RT1 on the nPM1304 NTC pin, 10 kilo-ohm, limits of section 8.1 | schematic owner: where RT1 sits and its part; the limits apply to the cell, not the board |
 | H13 | Architecture sections 1, 3, 4, 5, 6, 7 and 9 and the rows of the section 2 table for the joystick (+38 degrees) and the second control (+62 degrees) still describe the A3 or earlier ring (four microphones, the flat A3 cell, 68 mA charge, 4.40 V); section 17.8 wins by the architecture's own rule. | open | F3 follows 17.8, then 17.1 to 17.6, then 16 | architecture owner: rewrite when the open items of 16.9 close |
 | H14 | Architecture 17.12 puts the four pads on the inside of the band, touching the skin; whether any voltage or leakage path reaches them without a case, and how sweat is kept from corroding them, is to be stated in the wiring notes (17.12). | open | VBUS is an input, nothing is driven onto the pads, USB off without VBUS (section 8.6) | wiring notes owner (schematic), then the case owner |
-| H15 | Architecture section 9 (first two bullets), 16.5 (the line on the record button), 17.3 (the table row for the record button and the line "SW2 = record button") and 17.8 still describe a separate record button and a joystick that never starts a recording; 17.11 removes the button and puts the record gesture on the centre press. [v7: the record button is gone since 17.11 and the rectangular nub is removed in v7; the one control is the round joystick (architecture 17.29), centre switch SW2 (net BTN_REC)] | open | F4 and F5 follow 17.11 (later sections win); BTN_REC is the centre switch in case `SW2` | architecture owner: rewrite those lines |
+| H15 | Architecture section 9 (first two bullets), 16.5 (the line on the record button), 17.3 (the table row for the record button and the line "SW2 = record button") and 17.8 still describe a separate record button and a joystick that never starts a recording; 17.11 removes the button and puts the record gesture on the centre press. [v7: the record button is gone since 17.11 and the rectangular nub is removed in v7; the one control is the round joystick (architecture 17.29), centre switch SW2 (net BTN_REC)] | closed 2026-11-13: every record button line of `design/architecture.md` (23, 153, 229, 300, 356, 369, 433, 455, 482, 515) carries REPLACED by 17.11 or is reworded | F4 and F5 follow 17.11 (later sections win); BTN_REC is the centre switch in case `SW2` | architecture owner: rewrite those lines |
 | H16 | The first F5 brief asked the gain to drop by 11 dB for the more sensitive microphone. At -11 dB the microphone's own noise, -26 - 64.5 - 11 = -101.5 dBFS(A), falls under the noise of a 16-bit sample, -(6.02 x 16 + 1.76) = -98.1 dBFS; the stored signal-to-noise at 94 dB SPL would drop from about 63.8 dB at 0 dB gain to about 59.5 dB [CALC, `design/firmware-f5-notes.md`; assumes the PDM truncates to 16 bits after the gain; not A-weighted]. At 0 dB the store clips at 94 + 26 = 120 dB SPL, the microphone's own overload point [DS line 105]. | closed by the lead's decision of 2026-11-11: gain 0 dB | gain 0 dB (0x28), section 4.1 | none; bench B7 can measure the floor |
 | H17 | Architecture section 3 still says "the power chip stops discharge at 3.1 V" and section 2 and 3 still name the older power chip; motor-drive.md section 2.4 uses that 3.1 V. The nPM1304 specification read gives a power-fail reset at VSYSPOF, 2.7 V by default (2.5 to 3.4 V) [NPM p109], and a brownout at 2.4 V [NPM p29]; no 3.1 V cut-off was found. | open | B2 at 3.30 V and B5 at 3.45 V stay; VSYSPOF stays at its default (section 8.7) | architecture owner: rewrite section 3; the cell maker: the protection circuit's undervoltage limit (S12) |
 | H18 | Architecture 17.15 and 17.17 gave the recording hours at 4.0 mA; with the microphones of 17.19 the current is 4.1 mA. | closed by architecture 17.26, which computes the hours at 4.1 mA on the measured cells (4.3 to 7.8 hours) | 4.1 mA (section 8.5) | none |
@@ -1231,6 +1231,7 @@ The event log record of section 9.4 carries one of these codes (u16) and up to 1
 | 0x0260 | `RREC_LOG_TIME_GUESS` | the saved time at boot, used as a guess only (FW l.1005; ruling D18) | saved utc_ms i64 |
 | 0x0270 | `RREC_LOG_SELFTEST` | update self-test end (FW l.1014) | result u8 (0 pass, 1 fail, 2 timeout), items passed mask u8 (bit 0 storage, 1 Bluetooth, 2 USB) |
 | 0x0280 | `RREC_LOG_DROPPED` | records dropped from the full RAM buffer (FW l.1062) | count u32 |
+| 0x0290 | `RREC_LOG_UNMOUNT_FAILED` | storage could not be unmounted when a row asked for VDD_SD off (FW l.178, l.179); written at the first failed try of a step and once more when the retries of that step end, never once per try (rulings of 2026-11-13 after review finding R6-03: 27 codes) | errno i32 (at the end: 0 when the unmount then succeeded, else the last errno), state u8 (enum rc_state), try u8 (1 at the first failed try; at the end the number of tries made) |
 
 
 ## questions_for_owner
diff --git a/firmware/modules/ring_audio/src/rau.c b/firmware/modules/ring_audio/src/rau.c
index 97b0cd47..fcc38522 100644
--- a/firmware/modules/ring_audio/src/rau.c
+++ b/firmware/modules/ring_audio/src/rau.c
@@ -45,7 +45,9 @@ static int64_t cut_target;
 static struct rau_cut_result cut_result;
 static bool hfxo_held;
 static bool thread_started;
-static bool hook_added;
+#ifdef CONFIG_RING_RHW_SIM
+static bool hook_added;   /* simulation only (finding F2 of the units: guarded for the kit build) */
+#endif
 
 static K_SEM_DEFINE(run_sem, 0, 1);
 static K_SEM_DEFINE(halt_sem, 0, 1);
@@ -310,15 +312,21 @@ static void audio_thread(void *a, void *b, void *c)
 }
 
 /* ------------------------------------------------------------------ public */
+#ifdef CONFIG_RING_RHW_SIM
 static void clear_state(void)
 {
-	/* a simulated reboot: whatever runs stops, the RAM state is empty */
+	/* a simulated reboot: whatever runs stops, the RAM state is empty. The drivers were reset before this hook runs
+	 * (rhw_sim_reboot), so the capture loop sees its input fail and ends; this waits for that end (step 6 fix round 1,
+	 * finding F1 of the units: rau_init after the reboot must not find the old loop still running), with the same bound
+	 * as rau_halt. */
 	if (atomic_get(&capturing)) {
 		atomic_set(&halting, 1);
+		(void)k_sem_take(&halt_sem, K_MSEC(RREC_BLOCK_COUNT * RREC_BLOCK_MS));
 	}
 	atomic_set(&capturing, 0);
 	hfxo_held = false;
 }
+#endif
 
 int rau_init(const struct rau_cb *cb)
 {
diff --git a/firmware/modules/ring_devices/include/ring_devices/rdev.h b/firmware/modules/ring_devices/include/ring_devices/rdev.h
index 5b91ba85..80ac0836 100644
--- a/firmware/modules/ring_devices/include/ring_devices/rdev.h
+++ b/firmware/modules/ring_devices/include/ring_devices/rdev.h
@@ -82,6 +82,12 @@ struct bt_conn *rdev_active_conn(void);
 /* The peer address of a slot's pairing; -ENOENT when the slot is empty. */
 int rdev_slot_peer(uint8_t slot, bt_addr_le_t *addr);
 
+/* Ship mode step 1 (design/firmware.md l.937, "close ... radio"; added in step 6 fix round 1, review finding R6-02):
+ * stop this part's advertising, end the link, and never advertise again until the next boot. Other advertising (the
+ * factory ship beacon) is not touched. 0, or the error of bt_conn_disconnect(). Any thread; does not wait for the
+ * link to end. */
+int rdev_stop(void);
+
 #define RDEV_PAIR_WINDOW_MS 60000   /* FW 7.4: SCR_PAIR open for 60 s */
 
 #ifdef __cplusplus
diff --git a/firmware/modules/ring_devices/src/rdev.c b/firmware/modules/ring_devices/src/rdev.c
index fab5c28d..01431c72 100644
--- a/firmware/modules/ring_devices/src/rdev.c
+++ b/firmware/modules/ring_devices/src/rdev.c
@@ -43,6 +43,7 @@ static bool link_reported;
 static bool disconnecting;
 
 static bool inited;
+static bool stopped;   /* rdev_stop() (ship mode step 1): no advertising and no link from now on */
 static bool adv_on;
 static uint8_t adv_slot = RDEV_NONE;
 static bool adv_open;
@@ -190,6 +191,11 @@ static void update_fn(struct k_work *w)
 
 	ARG_UNUSED(w);
 	k_mutex_lock(&lk, K_FOREVER);
+	if (stopped) {
+		adv_stop();
+		k_mutex_unlock(&lk);
+		return;
+	}
 	st.active = list.active;
 	st.window = window;
 	st.window_slot = window_slot;
@@ -489,6 +495,24 @@ SETTINGS_STATIC_HANDLER_DEFINE(ring_dev, "ring/dev", NULL, settings_set_cb, NULL
 
 /* ---- public API ---- */
 
+/* Step 6 fix round 1 (review finding R6-02, FW l.937 "close ... radio"): ship mode step 1. Advertising stops, the link
+ * is ended, and nothing advertises again (update_fn returns at once). Advertising of another part (the factory ship
+ * beacon of ruling R20, rhw_beacon) is not touched: adv_stop() acts only on this part's own advertising. */
+int rdev_stop(void)
+{
+	int err = 0;
+
+	k_mutex_lock(&lk, K_FOREVER);
+	stopped = true;
+	adv_stop();
+	if (cur_conn != NULL && !disconnecting) {
+		err = bt_conn_disconnect(cur_conn, BT_HCI_ERR_REMOTE_USER_TERM_CONN);
+		disconnecting = (err == 0);
+	}
+	k_mutex_unlock(&lk);
+	return err;
+}
+
 int rdev_init(const struct rdev_callbacks *callbacks)
 {
 	bt_addr_le_t addrs[RDEV_SLOTS];
diff --git a/firmware/modules/ring_motor/src/rmo.c b/firmware/modules/ring_motor/src/rmo.c
index 519bd440..2b91ec17 100644
--- a/firmware/modules/ring_motor/src/rmo.c
+++ b/firmware/modules/ring_motor/src/rmo.c
@@ -92,6 +92,9 @@ static void on_expiry(struct k_timer *t)
 	k_spin_unlock(&lock, key);
 }
 
+#ifdef CONFIG_RING_RHW_SIM
+/* simulation only (rhw_sim_reboot); guarded so that the development kit build has no unused function (step 6 fix round 1,
+ * finding F2 of the units) */
 static void reboot_hook(void)
 {
 	k_spinlock_key_t key = k_spin_lock(&lock);
@@ -106,6 +109,7 @@ static void reboot_hook(void)
 	cb = (struct rmo_cb){ 0 };
 	k_spin_unlock(&lock, key);
 }
+#endif
 
 int rmo_init(const struct rmo_cb *c)
 {
diff --git a/firmware/modules/ring_recorder/src/rrec.c b/firmware/modules/ring_recorder/src/rrec.c
index 8843c6e2..28807691 100644
--- a/firmware/modules/ring_recorder/src/rrec.c
+++ b/firmware/modules/ring_recorder/src/rrec.c
@@ -25,6 +25,9 @@
 #if defined(CONFIG_RING_FACTORY)
 #include <ring_factory/rfa.h>
 #endif
+#if defined(CONFIG_RING_DEVICES)
+#include <ring_devices/rdev.h>
+#endif
 #if defined(CONFIG_RING_RHW_SIM)
 #include <ring_rhw/rhw_sim.h>
 #endif
@@ -35,6 +38,10 @@ struct rrec_state rrec_st = { .core_state = RC_ST_BOOT };
 
 #define HFXO_WAIT_MS   100   /* the join's limit for rau_prepare (FW l.428 gives no number) */
 #define FINISH_WAIT_MS 5000  /* rxf_finish: the command that runs may take this long (FW l.178 gives no number) */
+/* Ship mode (review finding R6-01): the wearer feels the whole M2 of FW l.151 before the motor is stopped: the join waits
+ * for rmo_playing() to end, at most RREC_PAT_M2_MS (280 ms, FW l.323) plus a margin of 100 ms for the timer and the
+ * threads (the margin is the join's choice). */
+#define SHIP_M2_MARGIN_MS 100
 
 static uint32_t last_closed_id;
 static bool last_closed_valid;
@@ -262,17 +269,121 @@ static void stop_after_write_fault(enum rc_action a)
 	}
 }
 
-/* ------------------------------------------------------------------ ship mode step 1 (FW l.937) */
-static void ship_mode(void)
+/* ------------------------------------------------------------------ VDD_SD off (FW l.178, l.179, l.912 to l.920) */
+/* Through the unmount that waits for a store call running on another thread (a transfer command, review finding R6-03),
+ * bounded by FINISH_WAIT_MS. The result is never dropped: a failed unmount (the call did not end in time) is tried again
+ * on the recorder's thread (RREC_JOB_UNMOUNT) until it succeeds. RREC_LOG_UNMOUNT_FAILED (errno, state, try; lead's ruling
+ * on the record) is written at the FIRST failed try (its errno, try 1) and once more when the tries end (errno 0 when the
+ * unmount then succeeded, else the last errno; try = the number of tries made), never once per try: on a stalling card
+ * the records must not lengthen the store's own work. */
+static uint8_t unmount_tries;   /* tries made since the first failed one (0: none failed) */
+
+static void unmount_record(int err, uint8_t tries)
 {
-	rmo_stop();                              /* no motor while the chip is cut */
-	if (rst_mounted()) {
-		(void)rst_unmount();             /* storage closed (the queued log records are written first) */
+	uint8_t args[6];
+
+	sys_put_le32((uint32_t)err, args);
+	args[4] = rrec_st.core_state;
+	args[5] = tries;
+	rrec_log(RREC_LOG_UNMOUNT_FAILED, args, sizeof(args));
+}
+
+/* the tries of a failed unmount end: the record with the result and the count */
+static void unmount_tries_end(int err)
+{
+	if (unmount_tries != 0) {
+		unmount_record(err, unmount_tries);
+		unmount_tries = 0;
+	}
+}
+
+static int unmount_now(void)
+{
+	int r;
+
+	if (!rst_mounted()) {
+		unmount_tries_end(0);   /* unmounted meanwhile: the tries ended with VDD_SD off */
+		return 0;
 	}
+	r = rst_unmount_wait(FINISH_WAIT_MS);
+	if (unmount_tries != 0 && unmount_tries < UINT8_MAX) {
+		unmount_tries++;        /* one more try of the same failed unmount */
+	}
+	if (r == -EBUSY) {
+		if (unmount_tries == 0) {
+			unmount_tries = 1;
+			unmount_record(r, 1);   /* the first failed try */
+		}
+		(void)rrec_post(RREC_JOB_UNMOUNT, 0);
+	} else {
+		unmount_tries_end(r);   /* 0, or -EIO (the rail went off anyway) */
+	}
+	return r;
+}
+
+static int unmount_last_err = -EBUSY;   /* the answer of the last try (rrec_unmount_retry) */
+
+/* ------------------------------------------------------------------ ship mode (FW 8.4, l.936 to l.941) */
+#if defined(CONFIG_RING_RECORDER_TEST_HOOKS)
+static void (*ship_hook)(void);
+static uint32_t radio_stops;
+static int radio_stop_rc;
+
+void rrec_test_set_ship_hook(void (*fn)(void))
+{
+	ship_hook = fn;
+}
+
+uint32_t rrec_test_radio_stops(void)
+{
+	return radio_stops;
+}
+
+int rrec_test_radio_stop_rc(void)
+{
+	return radio_stop_rc;
+}
+#endif
+
+/* The recorder's thread, after the step that asked for ship mode ended (RREC_JOB_SHIP): the screens were told the new
+ * state (SHIP or OFF) in that step, the menu's power off no longer holds the screens thread (R6-10). */
+void rrec_ship_now(void)
+{
+	int64_t end = rhw_clock()->now_ms() + RREC_PAT_M2_MS + SHIP_M2_MARGIN_MS;
+	int r;
+
+	/* the M2 of FW l.151 is felt whole (R6-01), then no motor while the chip is cut */
+	while (rmo_playing() && rhw_clock()->now_ms() < end) {
+		k_sleep(K_MSEC(5));
+	}
+	rmo_stop();
+	/* step 1 (FW l.937, R6-02): close everything: recording, storage, USB, radio, screen */
+	if (rrec_st.recording) {
+		(void)rrec_close(rhw_clock()->now_ms());   /* the rows close it before; kept as the last guard */
+	}
+	(void)unmount_now();                     /* storage closed (the queued log records are written first) */
+	(void)rxf_stop(FINISH_WAIT_MS);          /* USB: the command aborted, the stack disabled */
 	if (rrec_st.usb_hfxo) {
 		(void)rhw_hfxo()->release();
 		rrec_st.usb_hfxo = false;
 	}
+#if defined(CONFIG_RING_DEVICES)
+	r = rdev_stop();                         /* radio: this part's advertising and link; the ship beacon (R20) stays */
+#else
+	r = 0;
+#endif
+#if defined(CONFIG_RING_RECORDER_TEST_HOOKS)
+	radio_stops++;
+	radio_stop_rc = r;
+#else
+	ARG_UNUSED(r);
+#endif
+	rscr_sync();                             /* screen: the screens thread drew SCR_OFF (panel off) for SHIP or OFF */
+#if defined(CONFIG_RING_RECORDER_TEST_HOOKS)
+	if (ship_hook != NULL) {
+		ship_hook();
+	}
+#endif
 #if defined(CONFIG_RING_FACTORY)
 	(void)rpw_ship(rfa_beacon_stop);         /* steps 2 to 5; the beacon stops right before the ship task (R20) */
 #else
@@ -280,6 +391,20 @@ static void ship_mode(void)
 #endif
 }
 
+/* the recorder's thread: a failed unmount tried again (RREC_JOB_UNMOUNT) while the state still wants VDD_SD off */
+void rrec_unmount_retry(void)
+{
+	enum rc_state s = rrec_core_state();
+
+	if (s == RC_ST_RECOVERY || s == RC_ST_RECORDING || s == RC_ST_TRANSFER || s == RC_ST_BOOT ||
+	    s == RC_ST_FACTORY_TEST) {
+		/* the state wants the card (or runs its own sequence): the tries end with the last errno */
+		unmount_tries_end(unmount_last_err);
+		return;
+	}
+	unmount_last_err = unmount_now();
+}
+
 static void play(enum rrec_pattern p)
 {
 	(void)rmo_play(p);
@@ -326,9 +451,7 @@ void rrec_action(enum rc_action a, rc_ms_t t)
 		(void)mount_now();
 		break;
 	case RC_ACT_SD_OFF:
-		if (rst_mounted()) {
-			(void)rst_unmount();
-		}
+		(void)unmount_now();             /* FW l.178, l.179: the result is kept (R6-03) */
 		break;
 	case RC_ACT_STOP_PDM:
 	case RC_ACT_CLOCKS_LOW:
@@ -336,7 +459,7 @@ void rrec_action(enum rc_action a, rc_ms_t t)
 		stop_after_write_fault(a);
 		break;
 	case RC_ACT_SHIP_MODE:
-		ship_mode();
+		rrec_st.ship_pending = true;     /* on the recorder's thread after this step (rrec_glue_after) */
 		break;
 	case RC_ACT_SAVE_SETTINGS_TIME:
 		/* FW l.1005: the time is saved on entry into SHIP and OFF (0 when not set: nothing saved, ring_sys) */
@@ -380,7 +503,10 @@ void rrec_action(enum rc_action a, rc_ms_t t)
 		(void)rxf_finish(FINISH_WAIT_MS);
 		break;
 	case RC_ACT_ABORT_COMMAND:
+		/* FW l.179: abort the command, then wait for it to end (bounded as rxf_finish) so that VDD_SD goes off in this
+		 * step (R6-03) */
 		rxf_abort();
+		(void)rxf_finish(FINISH_WAIT_MS);
 		break;
 	default:
 		/* the screen actions: the screens part reads them in rrec_glue_after() */
@@ -401,19 +527,37 @@ static void usb_hfxo_running(void)
 	/* the USB part does not wait for the crystal: nothing to do when it runs */
 }
 
-static void rails_follow_state(enum rc_state s)
+/* HFXO held by the join per FW 8.2 (review finding R6-04): on in BOOT and RECOVERY (l.915), CHARGING "when USB runs"
+ * (l.918: VBUS is present in CHARGING), TRANSFER (l.919), FACTORY_TEST (driven over USB); RECORDING's is the audio
+ * part's (rau_prepare); STANDBY and the error states "when the radio runs" (the radio's own request) */
+static bool hfxo_wanted(enum rc_state s)
 {
-	bool usb = s == RC_ST_CHARGING || s == RC_ST_TRANSFER || s == RC_ST_FACTORY_TEST;
+	return s == RC_ST_BOOT || s == RC_ST_RECOVERY || s == RC_ST_CHARGING || s == RC_ST_TRANSFER || s == RC_ST_FACTORY_TEST;
+}
 
+void rrec_hfxo_follow_state(enum rc_state s)
+{
+	bool want = hfxo_wanted(s);
+
+	if (want && !rrec_st.usb_hfxo) {
+		rrec_st.usb_hfxo = rhw_hfxo()->request(usb_hfxo_running) == 0;
+	} else if (!want && rrec_st.usb_hfxo) {
+		(void)rhw_hfxo()->release();
+		rrec_st.usb_hfxo = false;
+	}
+}
+
+static void rails_follow_state(enum rc_state s)
+{
 	if (s != RC_ST_BOOT && s != RC_ST_FACTORY_TEST) {
 		if (sd_wanted(s)) {
 			(void)mount_now();
 		} else if (rst_mounted()) {
-			(void)rst_unmount();
+			(void)unmount_now();
 		}
 	}
 	/* VDD_MIC only in RECORDING (FW l.112): never needed when the actions ran as written; kept as the last guard */
-	if (s != RC_ST_RECORDING && !rrec_st.test_recording && rhw_pmic()->rail_get(RHW_RAIL_MIC)) {
+	if (s != RC_ST_RECORDING && atomic_get(&rrec_st.test_recording) == 0 && rhw_pmic()->rail_get(RHW_RAIL_MIC)) {
 		if (rau_capturing()) {
 			(void)rau_halt();
 		}
@@ -422,13 +566,7 @@ static void rails_follow_state(enum rc_state s)
 		rrec_st.recording = false;
 		rsy_recording(false);
 	}
-	/* HFXO with USB (FW l.917, l.918): CHARGING with VBUS, TRANSFER (and FACTORY_TEST, driven over USB) */
-	if (usb && !rrec_st.usb_hfxo) {
-		rrec_st.usb_hfxo = rhw_hfxo()->request(usb_hfxo_running) == 0;
-	} else if (!usb && rrec_st.usb_hfxo) {
-		(void)rhw_hfxo()->release();
-		rrec_st.usb_hfxo = false;
-	}
+	rrec_hfxo_follow_state(s);   /* FW 8.2, for the state that follows */
 }
 
 static enum rhw_reboot_reason reboot_reason(enum rc_event ev)
@@ -487,6 +625,7 @@ void rrec_factory_gesture(const struct rc_gev *e)
 bool rrec_glue_after(const struct rc_actions *a, enum rc_event last_event, enum rc_state state, rc_ms_t t)
 {
 	enum rc_state prev = (enum rc_state)rrec_st.core_state;
+	bool on;
 
 	if (state != prev) {
 		uint8_t sc[5];
@@ -513,7 +652,7 @@ bool rrec_glue_after(const struct rc_actions *a, enum rc_event last_event, enum
 			rau_highlight(a->highlight_ms >= 0 ? a->highlight_ms : t);   /* the time of CENTRE_DOWN (FW l.159) */
 		}
 	}
-	rpw_state(rrec_st.test_recording ? RC_ST_RECORDING : state);   /* ruling 8 of the root unit's notes */
+	rpw_state(atomic_get(&rrec_st.test_recording) != 0 ? RC_ST_RECORDING : state);   /* ruling 8 of the root unit's notes */
 	rails_follow_state(state);
 	if (state == RC_ST_RECOVERY && prev != RC_ST_RECOVERY) {
 		(void)rrec_post(RREC_JOB_RECOVER, 0);
@@ -522,7 +661,13 @@ bool rrec_glue_after(const struct rc_actions *a, enum rc_event last_event, enum
 		rrec_st.reboot_pending = false;
 		(void)rhw_image()->reboot(reboot_reason(last_event));
 	}
-	return rscr_glue_after(a, last_event, state, t);
+	on = rscr_glue_after(a, last_event, state, t);
+	if (rrec_st.ship_pending) {
+		/* ship mode after the screens learned SHIP or OFF (the screen closes, R6-02), on the recorder's thread (R6-10) */
+		rrec_st.ship_pending = false;
+		(void)rrec_post(RREC_JOB_SHIP, 0);
+	}
+	return on;
 }
 
 bool rrec_glue_screen_fact(void)
@@ -585,7 +730,7 @@ int rrec_test_recording(uint32_t ms, void (*on_block)(const int16_t *frames, uin
 		return r;
 	}
 	tr_block = on_block;
-	rrec_st.test_recording = true;
+	atomic_set(&rrec_st.test_recording, 1);
 	rsy_recording(true);
 	rpw_state(RC_ST_RECORDING);              /* ruling 8: sampling of the recording states in a test recording */
 	r = rau_prepare(HFXO_WAIT_MS);
@@ -630,7 +775,7 @@ int rrec_test_recording(uint32_t ms, void (*on_block)(const int16_t *frames, uin
 	(void)rst_unmount();
 out:
 	tr_block = NULL;
-	rrec_st.test_recording = false;
+	atomic_set(&rrec_st.test_recording, 0);
 	rsy_recording(false);
 	rpw_state(RC_ST_FACTORY_TEST);
 	return r;
@@ -644,5 +789,6 @@ void rrec_sim_reboot_hook(void)
 	rrec_st.core_state = RC_ST_BOOT;
 	last_closed_valid = false;
 	tr_block = NULL;
+	unmount_tries = 0;
 }
 #endif
diff --git a/firmware/modules/ring_recorder/src/rrec_boot.c b/firmware/modules/ring_recorder/src/rrec_boot.c
index f5ced309..fad57d90 100644
--- a/firmware/modules/ring_recorder/src/rrec_boot.c
+++ b/firmware/modules/ring_recorder/src/rrec_boot.c
@@ -49,6 +49,7 @@ int rrec_boot(void)
 	(void)rhw_sim_add_reboot_hook(rrec_sim_reboot_hook);
 #endif
 	rrec_st.core_state = RC_ST_BOOT;
+	rrec_hfxo_follow_state(RC_ST_BOOT);               /* FW l.915: HFXO on in BOOT (review finding R6-04) */
 	rrec_bridge_start();
 	(void)rsy_init(rrec_log);                         /* settings: factory flag, saved time (FW l.1010) */
 	if (rsy_crash_take(&crash, &gpreg) == 1) {
diff --git a/firmware/modules/ring_recorder/src/rrec_bridge.c b/firmware/modules/ring_recorder/src/rrec_bridge.c
index 8fcb2879..7acb0e03 100644
--- a/firmware/modules/ring_recorder/src/rrec_bridge.c
+++ b/firmware/modules/ring_recorder/src/rrec_bridge.c
@@ -37,23 +37,75 @@ static bool thread_up;
 static atomic_t posted;
 static atomic_t done;
 
+/* Review finding R6-08: a job of these kinds that does not fit the queue is kept as one latched bit per kind and queued
+ * when the queue has room again (after each job of the recorder's thread). No event is lost and none is doubled: a
+ * second one of the same kind while its bit is set is the same fact. */
+enum latch_bit {
+	LB_VBUS_OUT = 0,
+	LB_CHUNK_WRITE_FAILED,
+	LB_MIC_NO_BLOCK,
+	LB_SHIP,
+	LB_UNMOUNT,
+	LB_COUNT,
+};
+static const struct job latch_job[LB_COUNT] = {
+	[LB_VBUS_OUT] = { .kind = RREC_JOB_EVENT, .arg = RC_EV_VBUS_OUT },
+	[LB_CHUNK_WRITE_FAILED] = { .kind = RREC_JOB_EVENT, .arg = RC_EV_CHUNK_WRITE_FAILED },
+	[LB_MIC_NO_BLOCK] = { .kind = RREC_JOB_EVENT, .arg = RC_EV_MIC_NO_BLOCK },
+	[LB_SHIP] = { .kind = RREC_JOB_SHIP, .arg = 0 },
+	[LB_UNMOUNT] = { .kind = RREC_JOB_UNMOUNT, .arg = 0 },
+};
+static atomic_t latched;
+
+static int latch_of(const struct job *j)
+{
+	for (int b = 0; b < LB_COUNT; b++) {
+		if (latch_job[b].kind == j->kind && latch_job[b].arg == j->arg) {
+			return b;
+		}
+	}
+	return -1;
+}
+
 int rrec_post(enum rrec_job kind, uint32_t arg)
 {
 	struct job j = { .kind = (uint8_t)kind, .arg = arg };
 	int r;
+	int b;
 
 	(void)atomic_inc(&posted);
 	r = k_msgq_put(&job_q, &j, K_NO_WAIT);
 	if (r != 0) {
+		b = latch_of(&j);
+		if (b >= 0) {
+			/* kept: counted as done here, posted again from the latch (rrec_idle waits for the latch too) */
+			(void)atomic_or(&latched, BIT(b));
+		}
 		(void)atomic_inc(&done);   /* not queued: counted as done so a waiting test does not hang */
 	}
 	return r;
 }
 
+/* the recorder's thread: queue every latched job for which the queue has room now */
+static void latch_flush(void)
+{
+	for (int b = 0; b < LB_COUNT; b++) {
+		if ((atomic_get(&latched) & BIT(b)) == 0) {
+			continue;
+		}
+		(void)atomic_inc(&posted);
+		if (k_msgq_put(&job_q, &latch_job[b], K_NO_WAIT) == 0) {
+			(void)atomic_and(&latched, ~BIT(b));
+		} else {
+			(void)atomic_inc(&done);   /* still no room: the bit stays */
+		}
+	}
+}
+
 #if defined(CONFIG_RING_RECORDER_TEST_HOOKS)
 bool rrec_idle(void)
 {
-	return atomic_get(&posted) == atomic_get(&done);
+	return atomic_get(&posted) == atomic_get(&done) && atomic_get(&latched) == 0;
 }
 #endif
 
@@ -103,10 +155,14 @@ static void run_retry(void)
 	uint8_t args[4];
 	int r;
 
-	r = rst_mounted() ? 0 : rst_mount(false, &mi);
-	if (r == 0 && rst_mounted()) {
-		rrec_st.fact_open = mi.open_flag;
-		rrec_st.fact_open_pending = true;
+	if (rst_mounted()) {
+		r = 0;   /* already mounted: the open flag fact keeps its value (no mount info was read, R6-09) */
+	} else {
+		r = rst_mount(false, &mi);
+		if (r == 0) {
+			rrec_st.fact_open = mi.open_flag;
+			rrec_st.fact_open_pending = true;
+		}
 	}
 	sys_put_le32((uint32_t)r, args);
 	rrec_log(RREC_LOG_STORAGE_RETRY, args, sizeof(args));
@@ -121,7 +177,9 @@ static void rrec_thread_fn(void *p1, void *p2, void *p3)
 	ARG_UNUSED(p2);
 	ARG_UNUSED(p3);
 	for (;;) {
-		if (k_msgq_get(&job_q, &j, K_FOREVER) != 0) {
+		/* 100 ms at most between two looks at the latch: a bit set while this thread waited is queued then (R6-08) */
+		if (k_msgq_get(&job_q, &j, K_MSEC(100)) != 0) {
+			latch_flush();
 			continue;
 		}
 		switch (j.kind) {
@@ -137,10 +195,17 @@ static void rrec_thread_fn(void *p1, void *p2, void *p3)
 		case RREC_JOB_RETRY:
 			run_retry();
 			break;
+		case RREC_JOB_SHIP:
+			rrec_ship_now();
+			break;
+		case RREC_JOB_UNMOUNT:
+			rrec_unmount_retry();
+			break;
 		default:
 			break;
 		}
 		(void)atomic_inc(&done);
+		latch_flush();
 	}
 }
 
@@ -280,7 +345,7 @@ static void au_no_block(void)
 
 	sys_put_le32(0, args);
 	rrec_log(RREC_LOG_FAULT_MIC, args, sizeof(args));
-	if (!rrec_st.test_recording) {
+	if (atomic_get(&rrec_st.test_recording) == 0) {
 		(void)rrec_post(RREC_JOB_EVENT, RC_EV_MIC_NO_BLOCK);   /* FW l.169 */
 	}
 }
diff --git a/firmware/modules/ring_recorder/src/rrec_int.h b/firmware/modules/ring_recorder/src/rrec_int.h
index 223bd993..d1acac92 100644
--- a/firmware/modules/ring_recorder/src/rrec_int.h
+++ b/firmware/modules/ring_recorder/src/rrec_int.h
@@ -10,6 +10,8 @@
 #include <stddef.h>
 #include <stdint.h>
 
+#include <zephyr/sys/atomic.h>
+
 #include <ring_core/rc_types.h>
 #include <ring_rhw/rrec_spec.h>
 
@@ -43,7 +45,13 @@ enum rrec_job {
 	RREC_JOB_BATTERY,        /* arg: enum rc_batt, through rglue_battery() */
 	RREC_JOB_RECOVER,        /* RECOVERY entered: the scan (rst_recover), then SCAN_DONE or SCAN_READ_ERROR */
 	RREC_JOB_RETRY,          /* RC_ACT_RETRY_STORAGE: the storage init, then RETRY_OK or RETRY_FAILED (ruling R3) */
+	RREC_JOB_SHIP,           /* RC_ACT_SHIP_MODE, after the step that asked for it: ship mode steps 1 to 5 (FW 8.4) on
+	                          * the recorder's thread (rpw.h: "Join's thread"; review findings R6-01, R6-02, R6-10) */
+	RREC_JOB_UNMOUNT,        /* a failed unmount tried again (review finding R6-03) */
 };
+/* 0 when queued. A job that does not fit the queue: an event of the kinds VBUS_OUT, CHUNK_WRITE_FAILED and MIC_NO_BLOCK,
+ * and the jobs SHIP and UNMOUNT, are kept as one latched bit per kind and queued when the queue has room again (review
+ * finding R6-08); any other job is dropped (-ENOMSG). */
 int rrec_post(enum rrec_job job, uint32_t arg);
 struct rpw_cb;
 struct rst_cb;
@@ -69,11 +77,13 @@ const struct rfa_ops *rrec_factory_ops(void);
 struct rrec_state {
 	uint8_t core_state;      /* enum rc_state after the last core step */
 	bool recording;          /* a recording of type 1 is open (OPEN done, CLOSE not yet) */
-	bool test_recording;     /* a factory test recording runs (transfer thread; atomic flag) */
+	atomic_t test_recording; /* a factory test recording runs: 1 (written on the transfer thread, read on others) */
 	uint32_t rec_id;         /* the open recording */
 	rc_ms_t press_ms;        /* the long press of the open recording */
 	bool reboot_pending;     /* RC_ACT_REBOOT seen in this step: reboot in after, reason from the step's event */
-	bool usb_hfxo;           /* the join holds HFXO for USB (CHARGING with VBUS, TRANSFER; FW l.912 to l.920) */
+	bool usb_hfxo;           /* the join holds HFXO per FW 8.2 (l.915 BOOT and RECOVERY, l.918 CHARGING with USB, l.919
+	                          * TRANSFER; FACTORY_TEST, driven over USB); RECORDING's is the audio part's own */
+	bool ship_pending;       /* RC_ACT_SHIP_MODE seen in this step: the ship job is posted after the screens were told */
 	uint8_t chg_err_reason;  /* the last charge error (RC_ACT_LOG_CHARGE_ERROR) */
 	uint8_t chg_err_sensor;
 	/* facts the caller of the core owns, written by rrec_glue_screen_fact() under the lock */
@@ -104,6 +114,13 @@ void rrec_log_crash(const struct rrec_crash *c);
 /* rrec.c: a chunk of a factory test recording to the factory's block callback (256 frames at a time). */
 struct rst_chunk;
 void rrec_feed_test_blocks(const struct rst_chunk *c);
+/* rrec.c, the recorder's thread: ship mode (RREC_JOB_SHIP): wait for M2 to end (bounded), step 1 (recording, storage,
+ * USB, radio, screen closed), then rpw_ship() for steps 2 to 5 (FW 8.4). */
+void rrec_ship_now(void);
+/* rrec.c, the recorder's thread: a failed unmount tried again (RREC_JOB_UNMOUNT). */
+void rrec_unmount_retry(void);
+/* rrec.c: HFXO requested or released as FW 8.2 says for state s (also at the start of the boot sequence). */
+void rrec_hfxo_follow_state(enum rc_state s);
 #if defined(CONFIG_RING_RHW_SIM)
 /* rrec.c: the join's RAM state back to reset values on rhw_sim_reboot(). */
 void rrec_sim_reboot_hook(void);
@@ -124,8 +141,13 @@ uint32_t rrec_tap_count(void);
 bool rrec_tap_get(uint32_t i, struct rrec_tap_rec *out);
 uint32_t rrec_tap_count_code(uint16_t code);
 void rrec_tap_clear(void);
-/* true when the recorder's thread has no job queued and none running. */
+/* true when the recorder's thread has no job queued, none running and none latched. */
 bool rrec_idle(void);
+/* Called on the recorder's thread at the end of ship mode step 1, right before rpw_ship() (SHPHLDCONFIG); NULL clears. */
+void rrec_test_set_ship_hook(void (*fn)(void));
+/* rdev_stop() calls made by ship mode step 1 since boot (the radio, FW l.937), and the last one's answer */
+uint32_t rrec_test_radio_stops(void);
+int rrec_test_radio_stop_rc(void);
 #endif
 
 #ifdef __cplusplus
diff --git a/firmware/modules/ring_rhw/include/ring_rhw/rrec_spec.h b/firmware/modules/ring_rhw/include/ring_rhw/rrec_spec.h
index 2858ab2e..8a9f313d 100644
--- a/firmware/modules/ring_rhw/include/ring_rhw/rrec_spec.h
+++ b/firmware/modules/ring_rhw/include/ring_rhw/rrec_spec.h
@@ -326,6 +326,7 @@ enum rrec_pattern {                               /* FW l.320 to l.328 */
 	RREC_PAT_MF = 7,                      /* 300 on, 200 off, 300 on */
 };
 #define RREC_PAT_COUNT                7u
+#define RREC_PAT_M2_MS                280u        /* FW l.323: M2 = 80 on, 120 off, 80 on (lead ruling on R6-01) */
 #define RREC_MOTOR_RUN_MA             80u         /* FW l.332: charge per pulse t_on x 80 mA */
 #define RREC_MOTOR_START_MA           175u        /* FW l.332: + 10 ms x 175 mA per pulse */
 #define RREC_MOTOR_START_MS           10u         /* FW l.332 */
@@ -444,6 +445,10 @@ enum rrec_log_code {
 	RREC_LOG_SELFTEST = 0x0270,           /* update self-test end (FW l.1014). args: result u8 (0 pass, 1 fail,
 	                                       * 2 timeout), items passed mask u8 (bit 0 storage, 1 Bluetooth, 2 USB) */
 	RREC_LOG_DROPPED = 0x0280,            /* records dropped from the full RAM buffer (FW l.1062). args: count u32 */
+	RREC_LOG_UNMOUNT_FAILED = 0x0290,     /* storage not unmounted when a row asked for VDD_SD off (FW l.178, l.179); at
+	                                       * the first failed try of a step and once when its tries end, never once per
+	                                       * try (lead rulings on R6-03: 27 codes). args: errno i32, state u8
+	                                       * (enum rc_state), try u8 */
 };
 
 /* ------------------------------------------------------------------ shared types (used by several units) */
diff --git a/firmware/modules/ring_screens/src/rscr.c b/firmware/modules/ring_screens/src/rscr.c
index 30259899..510fe88c 100644
--- a/firmware/modules/ring_screens/src/rscr.c
+++ b/firmware/modules/ring_screens/src/rscr.c
@@ -541,7 +541,14 @@ static void screens_thread(void *p1, void *p2, void *p3)
 
 void rscr_sync(void)
 {
-	uint32_t want = ++gen_asked;
+	uint32_t want;
+
+	/* step 6 fix round 1 (lead's ruling 4 on the recorder's ship mode): before rscr_start there is no screens thread to
+	 * wait for, so a sync returns at once */
+	if (!started) {
+		return;
+	}
+	want = ++gen_asked;
 
 	wake_thread();
 	while ((int32_t)(gen_done - want) < 0) {
diff --git a/firmware/modules/ring_store/include/ring_store/rst.h b/firmware/modules/ring_store/include/ring_store/rst.h
index b8045e53..dd561f57 100644
--- a/firmware/modules/ring_store/include/ring_store/rst.h
+++ b/firmware/modules/ring_store/include/ring_store/rst.h
@@ -140,6 +140,12 @@ int rst_mount(bool boot, struct rst_mount_info *out);
  * and log records first. 0 or -EIO (the rail goes off anyway). */
 int rst_unmount(void);
 
+/* As rst_unmount, but a store call running on another thread is waited for, up to timeout_ms (added in step 6 fix
+ * round 1, review finding R6-03: VDD_SD off after an aborted or finished transfer command, FW l.178, l.179). 0, -EIO
+ * (the rail goes off anyway), -EBUSY when the running call did not end within timeout_ms (nothing changed).
+ * Blocks up to timeout_ms plus the unmount's own time. */
+int rst_unmount_wait(int32_t timeout_ms);
+
 /* true between a successful rst_mount and rst_unmount. Does not block. */
 bool rst_mounted(void);  /* FW l.640 */
 
diff --git a/firmware/modules/ring_store/src/rst.c b/firmware/modules/ring_store/src/rst.c
index 981207e4..9801f503 100644
--- a/firmware/modules/ring_store/src/rst.c
+++ b/firmware/modules/ring_store/src/rst.c
@@ -464,13 +464,11 @@ int rst_mount(bool boot, struct rst_mount_info *out)
 	return r;
 }
 
-int rst_unmount(void)
+/* the body of rst_unmount and rst_unmount_wait, with op_lock held by the caller */
+static int unmount_locked(void)
 {
 	int r = 0;
 
-	if (!op_take()) {
-		return -EBUSY;
-	}
 	if (!S.mounted) {
 		k_mutex_unlock(&op_lock);
 		return 0;
@@ -495,6 +493,24 @@ int rst_unmount(void)
 	return r;
 }
 
+int rst_unmount(void)
+{
+	if (!op_take()) {
+		return -EBUSY;
+	}
+	return unmount_locked();
+}
+
+/* Step 6 fix round 1 (review finding R6-03): the unmount that waits up to timeout_ms for the store call that runs on
+ * another thread (op_lock taken with a timeout instead of K_NO_WAIT), then the same body as rst_unmount. */
+int rst_unmount_wait(int32_t timeout_ms)
+{
+	if (k_mutex_lock(&op_lock, K_MSEC(MAX(timeout_ms, 0))) != 0) {
+		return -EBUSY;
+	}
+	return unmount_locked();
+}
+
 bool rst_mounted(void)
 {
 	return S.mounted;
diff --git a/firmware/modules/ring_xfer/include/ring_xfer/rxf.h b/firmware/modules/ring_xfer/include/ring_xfer/rxf.h
index 46d48479..2289158f 100644
--- a/firmware/modules/ring_xfer/include/ring_xfer/rxf.h
+++ b/firmware/modules/ring_xfer/include/ring_xfer/rxf.h
@@ -88,6 +88,12 @@ int rxf_finish(int32_t timeout_ms);
 /* true while a command runs (the store must not be used by another part then, FW l.219). Never blocks. */
 bool rxf_busy(void);
 
+/* Ship mode step 1 (FW l.937, "close ... USB"; added in step 6 fix round 1, review finding R6-02): stop reading and
+ * answering, abort the command that runs and wait up to timeout_ms for it to end, then disable the stack
+ * (rhw_usb()->disable()); the stack stays off until the next RHW_USB_VBUS_READY. 0; -ETIMEDOUT when the command did
+ * not end in time (the stack is disabled anyway). Join's thread; blocks up to timeout_ms. */
+int rxf_stop(int32_t timeout_ms);
+
 #ifdef __cplusplus
 }
 #endif
diff --git a/firmware/modules/ring_xfer/src/rxf_class.c b/firmware/modules/ring_xfer/src/rxf_class.c
index 85705790..aa78f6ed 100644
--- a/firmware/modules/ring_xfer/src/rxf_class.c
+++ b/firmware/modules/ring_xfer/src/rxf_class.c
@@ -46,6 +46,7 @@ static uint32_t busy_n;
 
 static atomic_t busy;               /* a request is queued or running (rxf_busy) */
 static atomic_t cancel_req;         /* rxf_abort(): drop the request that has not started */
+static atomic_t stopped;            /* rxf_stop() (ship mode step 1): the stack stays off until the next VBUS ready */
 static volatile bool vbus;
 K_MSGQ_DEFINE(itemq, sizeof(uint8_t), 16, 1);
 static K_MUTEX_DEFINE(tx_lock);
@@ -225,8 +226,11 @@ static void thread_fn(void *a, void *b, void *c)
 			run_request();
 			break;
 		case IT_VBUS_READY:
-			/* FW l.978: the stack starts only after the power chip reported VBUS */
-			(void)rhw_usb()->enable();
+			/* FW l.978: the stack starts only after the power chip reported VBUS (not after rxf_stop until VBUS
+			 * is reported again) */
+			if (atomic_get(&stopped) == 0) {
+				(void)rhw_usb()->enable();
+			}
 			break;
 		case IT_VBUS_REMOVED:
 			(void)rhw_usb()->disable();
@@ -252,6 +256,7 @@ static void on_event(enum rhw_usb_event ev)
 
 	switch (ev) {
 	case RHW_USB_VBUS_READY:
+		atomic_set(&stopped, 0);          /* VBUS reported again: the stack may start (after rxf_stop) */
 		vbus = true;
 		post(IT_VBUS_READY);
 		break;
@@ -302,6 +307,7 @@ int rxf_start(const struct rxf_backend *backend, const struct rxf_cb *callbacks)
 	k_spin_unlock(&lk, k);
 	atomic_set(&busy, 0);
 	atomic_set(&cancel_req, 0);
+	atomic_set(&stopped, 0);
 	tx_held = false;
 	vbus = false;
 	rxf_proto_init(&ctx, be);
@@ -343,3 +349,23 @@ bool rxf_busy(void)
 {
 	return atomic_get(&busy) != 0;
 }
+
+/* Step 6 fix round 1 (review finding R6-02): ship mode step 1 closes USB (FW l.937). Nothing more is read or answered
+ * (as on VBUS removed), the command that runs is aborted and waited for up to timeout_ms, then the stack is disabled on
+ * the caller's thread so that it is off when this returns. */
+int rxf_stop(int32_t timeout_ms)
+{
+	k_spinlock_key_t k;
+	int r;
+
+	atomic_set(&stopped, 1);
+	k = k_spin_lock(&lk);
+	vbus = false;                     /* on_rx drops, emit_cb cancels, no BUSY answer is sent */
+	rx_reset();
+	busy_n = 0u;
+	k_spin_unlock(&lk, k);
+	rxf_abort();
+	r = rxf_finish(timeout_ms);
+	(void)rhw_usb()->disable();
+	return r;
+}
diff --git a/firmware/tests/bsim/control/broken_edit.py b/firmware/tests/bsim/control/broken_edit.py
index 708dafd4..10f2ecdb 100644
--- a/firmware/tests/bsim/control/broken_edit.py
+++ b/firmware/tests/bsim/control/broken_edit.py
@@ -114,6 +114,10 @@ VARIANTS["fourth_slot"] = (
 VARIANTS["pair_takes_over"] = (
     "ring_devices", "B", r"RING CHECK B: after the second pairing the first device is still the active one.* FAIL",
     [("src/rdev.c", "\t\t\tif (list.active == RDEV_NONE) {\n\t\t\t\tlist.active = slot;", "\t\t\tif (true) {\n\t\t\t\tlist.active = slot;")])
+# step 6 fix round 1 (review finding R6-02): rdev_stop ends the link but advertising starts again after it
+VARIANTS["radio_not_stopped"] = (
+    "ring_devices", "C", r"HOST H1 CHECK C: no advertising after ship close FAIL",
+    [("src/rdev.c", "\tstopped = true;\n\tadv_stop();\n", "\tadv_stop();\n")])
 MUST_PASS = ("window_gate_only", "window_stranger_only")
 
 
diff --git a/firmware/tests/bsim/control/host_app/src/main.c b/firmware/tests/bsim/control/host_app/src/main.c
index babd6a5a..c7b10cc7 100644
--- a/firmware/tests/bsim/control/host_app/src/main.c
+++ b/firmware/tests/bsim/control/host_app/src/main.c
@@ -233,6 +233,12 @@ static int64_t resume_at;     /* scenario F: host 1 stays away until then */
 static bool connecting;
 static struct k_work_delayable scan_work;
 static struct k_work ready_work;
+/* scenario C, step 6 fix round 1 (R6-02): from 54 s the host only watches (never connects); advertising reports with the
+ * HID service seen from 56 s on (1 s after the ring's ship close at 55 s) are counted */
+#define C_WATCH_MS 54000
+#define C_COUNT_FROM_MS 56000
+static bool watch_only;
+static int adv_after_close;
 
 static void scan_start(void);
 
@@ -484,6 +490,16 @@ static void scan_cb(const bt_addr_le_t *addr, int8_t rssi, uint8_t type, struct
 	int err;
 
 	ARG_UNUSED(rssi);
+	if (watch_only) {
+		bt_data_parse(ad, ad_parse, &ai);
+		if (ai.hid && k_uptime_get() >= C_COUNT_FROM_MS) {
+			if (adv_after_close == 0) {
+				printk("HOST %s INFO advertising seen after the ship close (t=%lld)\n", name, k_uptime_get());
+			}
+			adv_after_close++;
+		}
+		return;   /* watching only: no link */
+	}
 	if (conn != NULL || connecting || type != BT_GAP_ADV_TYPE_ADV_IND) {
 		return;
 	}
@@ -616,6 +632,12 @@ int main(void)
 			(void)bt_conn_disconnect(conn, BT_HCI_ERR_REMOTE_USER_TERM_CONN);
 		}
 	}
+	if (scen == 'C') {
+		/* test C, step 6 fix round 1: watch only from 54 s (the ring closes its radio at 55 s) */
+		k_sleep(K_MSEC(C_WATCH_MS - k_uptime_get()));
+		watch_only = true;
+		scan_start();
+	}
 	if (scen == 'D') {
 		/* test D: write to the ring at 45 s: HID control point (suspend, exit suspend) and
 		 * the protocol mode. Nothing a host writes may start or stop a recording. */
@@ -650,6 +672,9 @@ int main(void)
 	case 'C':
 		CHECK("old keys were refused after the removal", stale_refused);
 		CHECK("paired twice (before the removal and again)", pairings == 2);
+		CHECK("C: the link ended after the ship close", conn == NULL);
+		printk("HOST %s INFO advertising reports after the ship close: %d\n", name, adv_after_close);
+		CHECK("C: no advertising after ship close", adv_after_close == 0);
 		evaluate(steps_c1, ARRAY_SIZE(steps_c1));
 		break;
 	case 'T':
diff --git a/firmware/tests/bsim/control/ring_app/src/main.c b/firmware/tests/bsim/control/ring_app/src/main.c
index a1fe0e3f..b4883d02 100644
--- a/firmware/tests/bsim/control/ring_app/src/main.c
+++ b/firmware/tests/bsim/control/ring_app/src/main.c
@@ -403,6 +403,13 @@ static void run_c(void)
 	CHECK("host pairs again, link ready", wait_ready(0, 25000));
 	CHECK("two pairings in total", paired_events == 2 && rdev_active() == 0);
 	act(RCTL_MEDIA, RCTL_CENTRE, 2, "after new pairing ");
+
+	/* step 6 fix round 1 (review finding R6-02, FW l.937 "close ... radio"): ship mode's step 1 closes the radio with
+	 * rdev_stop() at 55 s; host 1 sees the link end and no advertising after it (its check "C: no advertising after
+	 * ship close") */
+	sleep_until(55000);
+	printk("RING INFO ship close: rdev_stop at t=%lld\n", k_uptime_get());
+	CHECK("C: ship close stops the radio (rdev_stop answers 0)", rdev_stop() == 0);
 }
 
 /* D: a centre hold is a recording gesture in every mode; a failed release is sent later; a host
diff --git a/firmware/tests/bsim/control/run.sh b/firmware/tests/bsim/control/run.sh
index 490c7b11..ecc151db 100755
--- a/firmware/tests/bsim/control/run.sh
+++ b/firmware/tests/bsim/control/run.sh
@@ -48,7 +48,7 @@ RUN_ID=${RING_RUN_ID:-$(date -u +%Y%m%d-%H%M%S)-local}
 OUT=${RING_OUT:-/ws/out/$RUN_ID-bsim-control}
 SIM_MS=${SIM_MS:-75}   # simulated seconds
 MODS=$HERE/../../../modules
-VARIANTS="pair_takes_over keymap hold_key switch_gate window window_gate_only window_stranger_only host_write repeat_flood gate release_retry bond_kept wrong_link fourth_slot"
+VARIANTS="pair_takes_over keymap hold_key switch_gate window window_gate_only window_stranger_only host_write repeat_flood gate release_retry bond_kept wrong_link fourth_slot radio_not_stopped"
 
 BROKEN=0
 WHICH="A B C D F G T"
diff --git a/firmware/tests/factory/src/common.c b/firmware/tests/factory/src/common.c
index d530369c..abf7e694 100644
--- a/firmware/tests/factory/src/common.c
+++ b/firmware/tests/factory/src/common.c
@@ -8,6 +8,7 @@ uint8_t fx_rec_type = RREC_REC_TYPE_FACTORY;
 uint32_t fx_frames_seen;
 uint8_t fx_frame[FX_MAX_FRAMES];
 int64_t fx_frame_ms[FX_MAX_FRAMES];
+int64_t fx_frame_ticks[FX_MAX_FRAMES];
 uint32_t fx_frames;
 int fx_screen_rc;
 uint64_t fx_xtal_grtc;
@@ -130,6 +131,7 @@ int fx_screen_frame(uint8_t which)
 	if (fx_frames < FX_MAX_FRAMES) {
 		fx_frame[fx_frames] = which;
 		fx_frame_ms[fx_frames] = rhw_clock()->now_ms();
+		fx_frame_ticks[fx_frames] = k_uptime_ticks();
 	}
 	fx_frames++;
 	return fx_screen_rc;
diff --git a/firmware/tests/factory/src/common.h b/firmware/tests/factory/src/common.h
index 4ce53b9e..0d2449a0 100644
--- a/firmware/tests/factory/src/common.h
+++ b/firmware/tests/factory/src/common.h
@@ -53,6 +53,7 @@ int fx_test_recording(uint32_t ms, void (*on_block)(const int16_t *frames, uint3
 #define FX_MAX_FRAMES 16
 extern uint8_t fx_frame[FX_MAX_FRAMES];
 extern int64_t fx_frame_ms[FX_MAX_FRAMES];
+extern int64_t fx_frame_ticks[FX_MAX_FRAMES];   /* k_uptime_ticks() of each frame (fix round 1, R6-13) */
 extern uint32_t fx_frames;
 extern int fx_screen_rc;
 extern bool fx_real_screen;          /* test_screen.c: the real screens part draws */
diff --git a/firmware/tests/factory/src/test_screen.c b/firmware/tests/factory/src/test_screen.c
index 9db74985..851540a3 100644
--- a/firmware/tests/factory/src/test_screen.c
+++ b/firmware/tests/factory/src/test_screen.c
@@ -195,11 +195,24 @@ ZTEST(factory_screen, test_frame_sequence)
 	zassert_equal(n, 1);
 	zassert_equal(out[0], 0);
 	/* red 0, green 1, blue 2, white 3, black 4, grid 5 (rfa.h), 1 s apart */
+	for (uint32_t i = 0; i < fx_frames && i < FX_MAX_FRAMES; i++) {
+		TC_PRINT("T-SCREEN stamps: frame %u at %lld ms, %lld ticks (%u ticks/s), spacing %lld ms\n", i, fx_frame_ms[i],
+			 fx_frame_ticks[i], (unsigned)CONFIG_SYS_CLOCK_TICKS_PER_SEC, i > 0 ? fx_frame_ms[i] - fx_frame_ms[i - 1] : 0);
+	}
 	zassert_equal(fx_frames, 6);
 	for (uint32_t i = 0; i < 6; i++) {
 		zassert_equal(fx_frame[i], i, "frame %u", i);
 		if (i > 0) {
-			zassert_equal(fx_frame_ms[i] - fx_frame_ms[i - 1], 1000, "1 s each (FW l.1025)");
+			/* 1 s each (FW l.1025). Fix round 1 (review finding R6-13): the frames are spaced by k_sleep(1,000 ms) in
+			 * rfa.c (run_screen), not by a periodic timer: each wait is at least 1,000 ms and ends on the next kernel
+			 * tick (the kernel adds one tick to a relative timeout), so a frame comes 1,000 ms plus up to one tick
+			 * after the one before. Measured in ticks (not in whole ms, whose floor made the result depend on the
+			 * moment the earlier cases ended): at least 1,000,000 us and less than 1,000 ms + 1 ms (the tolerance:
+			 * one tick is 100 us at 10,000 ticks per second) */
+			int64_t us = k_ticks_to_us_floor64((uint64_t)(fx_frame_ticks[i] - fx_frame_ticks[i - 1]));
+
+			zassert_true(us >= 1000000 && us < 1001000, "1 s each (FW l.1025): frame %u came %lld us after the one "
+				     "before", i, us);
 		}
 	}
 	/* a refused frame ends the test with a fail */
diff --git a/firmware/tests/recorder/CMakeLists.txt b/firmware/tests/recorder/CMakeLists.txt
index 3eaf8b1c..cf054ed4 100644
--- a/firmware/tests/recorder/CMakeLists.txt
+++ b/firmware/tests/recorder/CMakeLists.txt
@@ -31,5 +31,9 @@ target_sources(app PRIVATE
   src/test_rails.c
   src/test_rules.c
   src/test_log.c
-  src/test_screens.c)
+  src/test_screens.c
+  src/test_ship.c
+  src/test_unmount.c
+  src/test_factory.c
+  src/test_noscreens.c)
 endif()
diff --git a/firmware/tests/recorder/broken_edit.py b/firmware/tests/recorder/broken_edit.py
index 2d9d404b..4e3f45b6 100644
--- a/firmware/tests/recorder/broken_edit.py
+++ b/firmware/tests/recorder/broken_edit.py
@@ -1,6 +1,6 @@
 """Edits for tests/recorder/broken_run.sh. Usage: python3 broken_edit.py <variant> <ring_recorder copy folder>
 Prints "<named case> <suite file>". One named fault per variant; the edit must match exactly once. The variants are those
-of firmware/docs/step6-plan.md, unit J "Broken copies"."""
+of firmware/docs/step6-plan.md, unit J "Broken copies", and the six of fix round 1 (review findings R6-01 to R6-06)."""
 import pathlib
 import sys
 
@@ -69,6 +69,32 @@ V = {
     "sd_on_in_standby": (REC, "recorder_rails.test_rails_per_state", "test_rails",
         "\treturn s == RC_ST_RECOVERY || s == RC_ST_RECORDING || s == RC_ST_TRANSFER;\n",
         "\treturn s == RC_ST_RECOVERY || s == RC_ST_RECORDING || s == RC_ST_TRANSFER || s == RC_ST_STANDBY;\n"),
+    # ----- step 6 fix round 1 (review findings R6-01 to R6-06), one copy each
+    # R6-01: ship mode stops the motor at once (M2 cut)
+    "ship_cuts_m2": (REC, "recorder_ship.test_ship_feels_whole_m2", "test_ship",
+        "\twhile (rmo_playing() && rhw_clock()->now_ms() < end) {\n",
+        "\twhile (false && rmo_playing() && rhw_clock()->now_ms() < end) {\n"),
+    # R6-02: ship mode runs before the screens learn the step (the reviewed order: the screen keeps its picture)
+    "ship_screen_on": (REC, "recorder_ship.test_ship_closes_each_part_first", "test_ship",
+        "\ton = rscr_glue_after(a, last_event, state, t);\n",
+        "\tif (rrec_st.ship_pending) {\n\t\trrec_ship_now();   /* broken: ship mode before the screens are told */\n\t}\n"
+        "\ton = rscr_glue_after(a, last_event, state, t);\n"),
+    # R6-03: the unmount does not wait for the running store call and its result is dropped
+    "unmount_result_dropped": (REC, "recorder_unmount.test_unconfigured_finish_times_out", "test_unmount",
+        "\tr = rst_unmount_wait(FINISH_WAIT_MS);\n",
+        "\t(void)rst_unmount();\n\tr = 0;\n"),
+    # R6-04: no HFXO in BOOT and RECOVERY
+    "no_hfxo_in_boot": (REC, "recorder_rails.test_hfxo_in_boot_and_recovery", "test_rails",
+        "\treturn s == RC_ST_BOOT || s == RC_ST_RECOVERY || s == RC_ST_CHARGING || s == RC_ST_TRANSFER || s == RC_ST_FACTORY_TEST;\n",
+        "\treturn s == RC_ST_CHARGING || s == RC_ST_TRANSFER || s == RC_ST_FACTORY_TEST;\n"),
+    # R6-05: the close drops the partial chunk
+    "close_drops_partial": (REC, "recorder_actions.test_close_order", "test_actions",
+        "\t(void)rst_close(cr.last, &cr.close);     /* partial chunk, CLOSE record, superblock with the flag clear */\n",
+        "\t(void)rst_close(NULL, &cr.close);        /* the partial chunk dropped */\n"),
+    # R6-06: the factory's test recording is opened as type 1
+    "test_recording_wrong_type": (REC, "recorder_factory.test_tmic_records_type_2_for_2s", "test_factory",
+        "\t\tr = rst_open(RREC_REC_TYPE_FACTORY, 0, &id);   /* type 2 (FW l.548, l.1024) */\n",
+        "\t\tr = rst_open(RREC_REC_TYPE_RECORDING, 0, &id);   /* type 1: wrong */\n"),
 }
 if len(sys.argv) == 2 and sys.argv[1] == "--list":
     print(" ".join(V))
diff --git a/firmware/tests/recorder/short_run.sh b/firmware/tests/recorder/short_run.sh
index 89c920f8..128e1200 100644
--- a/firmware/tests/recorder/short_run.sh
+++ b/firmware/tests/recorder/short_run.sh
@@ -29,7 +29,7 @@ for P in $BOARDS; do
 	west twister -T "$FW/tests/recorder" -p "$P" -O "$OUT/twister-$T" -j 8 --inline-logs -v "${ARGS[@]}" > "$OUT/twister-$T.log" 2>&1
 	R=$?
 	echo "twister exit code on $P: $R (log $OUT/twister-$T.log)"
-	grep -E "FAIL|PASS|passed|failed|Assertion|error:|CMake Error|warning:|ROW|RULES|RAILS|SIGN-1|stop|start|close|open order|boot|frame hash|M1 action" "$OUT/twister-$T.log" | cut -c1-300 | head -400
+	grep -E "FAIL|PASS|passed|failed|Assertion|error:|CMake Error|warning:|ROW|RULES|RAILS|SIGN-1|stop|start|close|open order|boot|frame hash|M1 action|ship|unmount|SCR_CHARGING|T-MIC|T-SIGN|latch|HFXO|close frames" "$OUT/twister-$T.log" | cut -c1-300 | head -400
 	[ "$R" -ne 0 ] && RC=1
 done
 echo "SHORT RUN exit $RC"
diff --git a/firmware/tests/recorder/src/rt.c b/firmware/tests/recorder/src/rt.c
index 4b75a38c..b7ac5367 100644
--- a/firmware/tests/recorder/src/rt.c
+++ b/firmware/tests/recorder/src/rt.c
@@ -133,7 +133,7 @@ static uint8_t o_paired(void)
 	if (me != rscr_thread_id() && (nm == NULL || strcmp(nm, "rpw") != 0)) {
 		screens_told++;
 		if (rc_core_state(rglue_core()) != RC_ST_RECORDING && rhw_pmic()->rail_get(RHW_RAIL_MIC) &&
-		    !rrec_st.test_recording) {
+		    atomic_get(&rrec_st.test_recording) == 0) {
 			mic_at_screens++;
 		}
 	}
@@ -204,16 +204,27 @@ void rt_settle(void)
 	}
 }
 
+static bool glue_started;
+bool rt_screens_started;
+
 void rt_setup(void)
 {
-	static bool started;
+	if (!rt_screens_started) {
+		rt_screens_started = true;
+		zassert_equal(rscr_start(&sops), 0, "screens start on the memory display");
+	}
+	if (!glue_started) {
+		glue_started = true;
+		rglue_init(&gops, RC_ST_BOOT);
+	}
+}
 
-	if (started) {
-		return;
+void rt_setup_no_screens(void)
+{
+	if (!glue_started) {
+		glue_started = true;
+		rglue_init(&gops, RC_ST_BOOT);
 	}
-	started = true;
-	zassert_equal(rscr_start(&sops), 0, "screens start on the memory display");
-	rglue_init(&gops, RC_ST_BOOT);
 }
 
 void rt_core_at(enum rc_state s)
@@ -240,12 +251,15 @@ static void apply(const struct rt_boot *b)
 	if (b->mv != 0) {
 		for (int i = 0; i < 2; i++) {
 			sc[i].mv = i == 0 ? b->mv : (b->mv_next != 0 ? b->mv_next : b->mv);
-			sc[i].ua = 3000;
+			sc[i].ua = b->ua != 0 ? b->ua : 3000;
 			sc[i].temp_c_x10 = 250;
 			sc[i].die_c_x10 = 300;
 		}
 		rhw_sim_pmic_script(sc, 2);
 	}
+	if (b->chg_forced != 0) {
+		rhw_sim_pmic_charge_state((int)b->chg_forced - 1);
+	}
 	if (b->gauge_uah != 0) {
 		rhw_sim_gauge_capacity(b->gauge_uah);
 	}
@@ -285,8 +299,7 @@ void rt_fresh(const struct rt_boot *b)
 	rscr_test_force_down(false);
 	rt_sleep(50);
 	rhw_sim_reset();
-	rhw_sim_reboot();   /* every unit's RAM state back to reset values */
-	rt_sleep(100);      /* the audio thread leaves a capture the reboot stopped before rau_init runs again (notes, finding F1) */
+	rhw_sim_reboot();   /* every unit's RAM state back to reset values (the audio part waits for its capture loop, F1) */
 	apply(b);
 	boot_now(b);
 }
@@ -294,8 +307,7 @@ void rt_fresh(const struct rt_boot *b)
 void rt_reboot(const struct rt_boot *b)
 {
 	rt_sleep(100);
-	rhw_sim_reboot();
-	rt_sleep(100);      /* as in rt_fresh (finding F1) */
+	rhw_sim_reboot();   /* the audio part waits for its capture loop (finding F1): no sleep after it */
 	apply(b);
 	boot_now(b);
 }
diff --git a/firmware/tests/recorder/src/rt.h b/firmware/tests/recorder/src/rt.h
index 4b6267a3..1cc70c30 100644
--- a/firmware/tests/recorder/src/rt.h
+++ b/firmware/tests/recorder/src/rt.h
@@ -38,9 +38,13 @@ struct rt_boot {
 	uint32_t chunks;          /* card with this many chunks (0 = the 4 GB card of FW l.654) */
 	bool factory_flag;        /* persistent factory flag */
 	bool unconfirmed;         /* the running image is not confirmed (the update self-test runs, FW l.1014) */
+	int32_t ua;               /* with mv: the battery current of the samples in µA (0 = 3,000 µA discharge; < 0 charging) */
+	uint8_t chg_forced;       /* 0 = the simulated charger's own state; else the charge state + 1 (RREC_CHG_* + 1) */
 };
 
 void rt_setup(void);                          /* once: screens and glue started */
+void rt_setup_no_screens(void);               /* the glue only (the screens part never started), for recorder_a_noscreens */
+extern bool rt_screens_started;               /* rt_setup started the screens part */
 void rt_fresh(const struct rt_boot *b);       /* empty world, then a boot through rrec_boot() (NULL = defaults) */
 void rt_reboot(const struct rt_boot *b);      /* rhw_sim_reboot(): the card, settings and retained memory kept */
 void rt_core_at(enum rc_state s);             /* the core (and the join's copy) put in state s directly */
diff --git a/firmware/tests/recorder/src/test_actions.c b/firmware/tests/recorder/src/test_actions.c
index d64b88cc..2915ff5d 100644
--- a/firmware/tests/recorder/src/test_actions.c
+++ b/firmware/tests/recorder/src/test_actions.c
@@ -38,18 +38,91 @@ static int64_t act_time(enum rc_action a)
 	return -1;
 }
 
+/* the frames of the closed recording against what the simulated input delivered (review finding R6-05): every kept frame
+ * is the input's frame counter (left) and its inverse (right) from frame 800 on (FW l.460: the first 50 ms dropped), none
+ * missing; the chunks' frames add up to the CLOSE record's duration; the last chunk is the partial one; and the duration
+ * is what was captured from the start to the mark */
+static void check_closed_frames(int64_t start_ms, int64_t mark_ms)
+{
+	static uint8_t chunk[RREC_CHUNK_BYTES];
+	struct rst_mount_info mi;
+	struct rst_rec_info info[8];
+	uint16_t n = 0;
+	uint64_t sum = 0;
+	uint32_t last_frames = 0;
+	uint32_t bad = 0;
+	int64_t want;
+
+	zassert_equal(rst_mount(false, &mi), 0, "mount");
+	zassert_equal(rst_list(0, 8, info, &n), 0, "list");
+	zassert_true(n >= 1, "the recording is listed");
+	for (uint32_t c = 0; c < info[n - 1].chunk_count; c++) {
+		uint32_t fr;
+		const uint8_t *pl = &chunk[RREC_CHUNK_HEADER_BYTES];
+
+		zassert_equal(rst_read_chunk(info[n - 1].recording_id, c, chunk), 0, "read chunk %u", c);
+		fr = sys_get_le32(&chunk[RREC_CH_OFF_FRAMES]);
+		for (uint32_t f = 0; f < fr; f++) {
+			uint16_t want_l = (uint16_t)((RREC_DISCARD_FRAMES + sum + f) & 0xFFFFu);
+			uint16_t l = sys_get_le16(&pl[f * 4]);
+			uint16_t r = sys_get_le16(&pl[f * 4 + 2]);
+
+			if (l != want_l || r != (uint16_t)~want_l) {
+				if (bad < 3) {
+					TC_PRINT("close frames: chunk %u frame %u: %u/%u, captured %u/%u\n", c, f, l, r, want_l,
+						 (uint16_t)~want_l);
+				}
+				bad++;
+			}
+		}
+		sum += fr;
+		last_frames = fr;
+	}
+	(void)rst_unmount();
+	/* FW l.443, l.460: 16 frames per ms; the kept frames run from the start + 50 ms to the mark */
+	want = (mark_ms - start_ms) * 16 - (int64_t)RREC_DISCARD_FRAMES;
+	TC_PRINT("close frames: %u chunks, %llu frames in the chunks, CLOSE duration %llu, last chunk %u frames, "
+		 "captured to the mark %lld (start %lld ms, mark %lld ms), %u frames not as captured\n", info[n - 1].chunk_count,
+		 sum, info[n - 1].duration_frames, last_frames, want, start_ms, mark_ms, bad);
+	zassert_equal(bad, 0, "every kept frame is the captured one (%u not)", bad);
+	zassert_equal(sum, info[n - 1].duration_frames, "the chunks hold the whole duration (%llu of %llu)", sum,
+		      info[n - 1].duration_frames);
+	zassert_true(last_frames > 0 && last_frames < RREC_CHUNK_FRAMES, "the last chunk is the partial one (%u)",
+		     last_frames);
+	/* one block (256 frames, FW l.443) plus one ms of each stamp: the mark and the start are ms times */
+	zassert_true(sum + RREC_BLOCK_FRAMES + 32 >= (uint64_t)want && sum <= (uint64_t)want + RREC_BLOCK_FRAMES + 32,
+		     "kept %llu, captured to the mark %lld", sum, want);
+}
+
 /* FW l.125: close = partial chunk, CLOSE record, superblock flag clear, stop PDM, clocks low, VDD_MIC off, VDD_SD off */
 ZTEST(recorder_actions, test_close_order)
 {
 	int32_t i_part, i_close, i_sb, i_stop, i_sleep, i_mic, i_sd;
+	int64_t start_ms, mark_ms;
 
 	rt_fresh(NULL);
+	rhw_sim_log_clear();
 	rt_long();
-	rt_sleep(1300);   /* the mark falls inside a chunk: a partial chunk exists */
+	start_ms = rt_ev_us(rt_find(RHW_EV_MIC_START, -1, -1, 0)) / 1000;
+	zassert_true(start_ms > 0, "the input started");
+	rt_sleep(1300);
+	/* the stop press so that its mark (1,000 ms after the press, FW l.128) falls in the middle of a chunk: a partial
+	 * chunk of about half a chunk exists (8,192 frames, FW l.535) */
+	for (int i = 0; i < 200; i++) {
+		int64_t at_mark = (k_uptime_get() + RREC_LONG_PRESS_MS - start_ms) * 16 - (int64_t)RREC_DISCARD_FRAMES;
+		int64_t in_chunk = at_mark % RREC_CHUNK_FRAMES;
+
+		if (in_chunk >= 3000 && in_chunk <= 5000) {
+			break;
+		}
+		rt_sleep(4);
+	}
 	rhw_sim_log_clear();
 	rt_steps_clear();
 	rt_long();
 	zassert_equal(rt_state(), RC_ST_STANDBY, "stopped");
+	mark_ms = act_time(RC_ACT_CLOSE);
+	zassert_true(mark_ms > start_ms, "CLOSE carried out");
 	i_part = find_write(RREC_LBA_CHUNK_FIRST, UINT32_MAX, 0);
 	i_close = find_write(RREC_LBA_INDEX_FIRST, RREC_LBA_INDEX_LAST, 0);
 	i_sb = find_write(RREC_LBA_SB_A, RREC_LBA_SB_B, i_close < 0 ? 0 : (uint32_t)i_close);
@@ -65,6 +138,7 @@ ZTEST(recorder_actions, test_close_order)
 	zassert_true(i_sleep > i_stop, "clocks low after the stop");
 	zassert_true(i_mic > i_sleep, "VDD_MIC off after the clocks are low");
 	zassert_true(i_sd > i_mic, "VDD_SD off last");
+	check_closed_frames(start_ms, mark_ms);
 }
 
 /* FW l.126: open = VDD_SD on, mount, superblock with the open flag, VDD_MIC on, PDM start (FW 4.5) */
@@ -289,6 +363,53 @@ ZTEST(recorder_actions, test_ship_closes_everything_first)
 	zassert_true(i_save >= 0 && i_cfg > i_save, "time saved before SHPHLDCONFIG (%d, %d)", i_save, i_cfg);
 }
 
+/* Review finding R6-08: an event of the kinds VBUS_OUT, MIC_NO_BLOCK, CHUNK_WRITE_FAILED that finds the recorder's queue
+ * full is latched and reaches the core when the queue has room (rows 40, 37, 36 of FW 1.2) */
+static int fill_queue_then_post(enum rc_event ev)
+{
+	int r;
+	int n = 0;
+
+	k_sched_lock();
+	while (n < 100 && rrec_post(RREC_JOB_EVENT, RC_EV_INIT_DONE) == 0) {   /* no row outside BOOT: dropped by the core */
+		n++;
+	}
+	r = rrec_post(RREC_JOB_EVENT, ev);
+	k_sched_unlock();
+	TC_PRINT("latch: %d jobs filled the queue, the post of event %d answered %d\n", n, ev, r);
+	return r;
+}
+
+ZTEST(recorder_actions, test_latched_events_not_lost)
+{
+	rt_fresh(NULL);
+	rt_vbus(true);
+	zassert_equal(rt_state(), RC_ST_CHARGING, "CHARGING");
+	rt_steps_clear();
+	zassert_not_equal(fill_queue_then_post(RC_EV_VBUS_OUT), 0, "the queue was full");
+	rt_settle();
+	zassert_true(rt_row_seen(40), "row 40: VBUS removed reached the core (FW l.172)");
+	zassert_equal(rt_state(), RC_ST_STANDBY, "STANDBY");
+
+	rt_fresh(NULL);
+	rt_long();
+	zassert_equal(rt_state(), RC_ST_RECORDING, "recording");
+	rt_steps_clear();
+	zassert_not_equal(fill_queue_then_post(RC_EV_MIC_NO_BLOCK), 0, "the queue was full");
+	rt_settle();
+	zassert_true(rt_row_seen(37), "row 37: no block reached the core (FW l.169)");
+	zassert_equal(rt_state(), RC_ST_ERR_MIC_FAULT, "ERR_MIC_FAULT");
+
+	rt_fresh(NULL);
+	rt_long();
+	zassert_equal(rt_state(), RC_ST_RECORDING, "recording");
+	rt_steps_clear();
+	zassert_not_equal(fill_queue_then_post(RC_EV_CHUNK_WRITE_FAILED), 0, "the queue was full");
+	rt_settle();
+	zassert_true(rt_row_seen(36), "row 36: the write fault reached the core (FW l.168)");
+	zassert_equal(rt_state(), RC_ST_ERR_STORAGE_FAULT, "ERR_STORAGE_FAULT");
+}
+
 /* FW l.218, l.1065 (C23, the join's part): during a recording the audio and storage threads report progress through the
  * join, so the watchdog is fed; the feed rule itself is the system unit's (sys_wdt.test_feed_only_with_progress) */
 ZTEST(recorder_actions, test_watchdog_fed_while_recording)
diff --git a/firmware/tests/recorder/src/test_factory.c b/firmware/tests/recorder/src/test_factory.c
new file mode 100644
index 00000000..a8efbfae
--- /dev/null
+++ b/firmware/tests/recorder/src/test_factory.c
@@ -0,0 +1,136 @@
+/*
+ * recorder_factory: the join's half of T-MIC and T-SIGN on the REAL rrec_test_recording (step 6 fix round 1, review
+ * finding R6-06): design/firmware.md l.1024 (T-MIC: "a 2 s test recording (recording_type 2) through the normal path")
+ * and l.1029 (T-SIGN: "two 1 s test recordings 1 s apart; the ring reports the times VDD_MIC went on and off"). The
+ * requests go over the simulated USB to the real factory part, which calls the join through its ops.
+ */
+#include <string.h>
+
+#include <zephyr/sys/byteorder.h>
+
+#include <ring_store/rst.h>
+
+#include "rt.h"
+
+#if defined(CONFIG_RING_FACTORY)
+static uint8_t resp[RREC_MSG_HEADER_BYTES + 256];
+
+static void to_factory(void)
+{
+	struct rt_boot b = { .factory_flag = true };
+	uint8_t st;
+	uint8_t sub = RREC_FAC_ENTER;
+
+	rt_fresh(&b);
+	rt_vbus(true);
+	rt_usb_configured();
+	(void)rt_usb(RREC_OP_FACTORY, &sub, 1, resp, sizeof(resp), &st);
+	zassert_equal(rt_state(), RC_ST_FACTORY_TEST, "FACTORY_TEST");
+}
+
+/* the newest recording on the card (mounted for the read) */
+static bool newest(struct rst_rec_info *out)
+{
+	struct rst_mount_info mi;
+	struct rst_rec_info info[8];
+	uint16_t n = 0;
+	bool was = rst_mounted();
+
+	if (!was && rst_mount(false, &mi) != 0) {
+		return false;
+	}
+	(void)rst_list(0, 8, info, &n);
+	if (!was) {
+		(void)rst_unmount();
+	}
+	if (n == 0) {
+		return false;
+	}
+	*out = info[n - 1];
+	return true;
+}
+#endif
+
+/* T-MIC1 (FW l.1024): one recording of type 2, 2 s long (32,000 frames at 16 kHz, FW l.443), through rec_mics_on */
+ZTEST(recorder_factory, test_tmic_records_type_2_for_2s)
+{
+#if defined(CONFIG_RING_FACTORY)
+	uint8_t pl[2] = { RREC_FAC_MIC, 1 };
+	struct rst_rec_info r;
+	uint8_t st = 0xFF;
+	int n;
+
+	memset(&r, 0, sizeof(r));
+
+	to_factory();
+	rhw_sim_log_clear();
+	n = rt_usb(RREC_OP_FACTORY, pl, sizeof(pl), resp, sizeof(resp), &st);
+	TC_PRINT("T-MIC1: response %d bytes, status %u, result %u\n", n, st, n > RREC_MSG_HEADER_BYTES ?
+		 resp[RREC_MSG_HEADER_BYTES] : 0xFF);
+	zassert_equal(st, RREC_ST_OK, "the request answered OK");
+	zassert_equal(resp[RREC_MSG_HEADER_BYTES], RREC_FAC_RESULT_PASS, "T-MIC1 passed on the counter input");
+	zassert_equal(rt_count_rail(RHW_RAIL_MIC, true), 1u, "VDD_MIC on once");
+	zassert_true(newest(&r), "the test recording is on the card");
+	TC_PRINT("T-MIC1: recording %u type %u, %llu frames, %u chunks\n", r.recording_id, r.type, r.duration_frames,
+		 r.chunk_count);
+	zassert_equal(r.type, 2, "recording_type 2 (FW l.1024)");
+	/* 2 s = 32,000 frames (FW l.1024, l.443); within one block of 256 frames (FW l.443): the cut is at a ms time */
+	zassert_true(r.duration_frames + 256 >= 32000 && r.duration_frames <= 32000 + 256, "2 s long (%llu frames)",
+		     r.duration_frames);
+	zassert_false(rt_mic(), "VDD_MIC off after the test");
+#else
+	ztest_test_skip();
+#endif
+}
+
+/* T-SIGN (FW l.1029): two 1 s test recordings 1 s apart; the reported VDD_MIC on and off times are the rail's own */
+ZTEST(recorder_factory, test_tsign_reports_mic_times)
+{
+#if defined(CONFIG_RING_FACTORY)
+	uint8_t sub = RREC_FAC_SIGN;
+	uint8_t st = 0xFF;
+	int64_t rep[4];
+	int64_t rail[4];
+	int32_t i = 0;
+	int n;
+
+	to_factory();
+	rhw_sim_log_clear();
+	n = rt_usb(RREC_OP_FACTORY, &sub, 1, resp, sizeof(resp), &st);
+	zassert_equal(st, RREC_ST_OK, "the request answered OK");
+	zassert_true(n >= RREC_MSG_HEADER_BYTES + 1 + 32, "result and four times (%d bytes)", n);
+	zassert_equal(resp[RREC_MSG_HEADER_BYTES], RREC_FAC_RESULT_PASS, "T-SIGN result pass");
+	for (int k = 0; k < 4; k++) {
+		rep[k] = (int64_t)sys_get_le64(&resp[RREC_MSG_HEADER_BYTES + 1 + 8 * k]);
+	}
+	/* the rail's own on, off, on, off times from the event log of the simulated power chip */
+	for (int k = 0; k < 4; k++) {
+		i = rt_find_rail(RHW_RAIL_MIC, (k % 2) == 0, k == 0 ? 0 : (uint32_t)i + 1);
+		rail[k] = i >= 0 ? rt_ev_us(i) / 1000 : -1;
+	}
+	TC_PRINT("T-SIGN: reported on %lld off %lld on %lld off %lld ms; rail on %lld off %lld on %lld off %lld ms\n", rep[0],
+		 rep[1], rep[2], rep[3], rail[0], rail[1], rail[2], rail[3]);
+	zassert_equal(rt_count_rail(RHW_RAIL_MIC, true), 2u, "two test recordings: VDD_MIC on twice");
+	for (int k = 0; k < 4; k++) {
+		zassert_true(rail[k] >= 0, "rail edge %d", k);
+		/* the time is read right after the rail call: the same ms or the next (1 ms, the rail wait of FW l.458) */
+		zassert_true(rep[k] >= rail[k] && rep[k] <= rail[k] + 1, "time %d reported %lld, rail %lld", k, rep[k],
+			     rail[k]);
+	}
+	/* each 1 s long (FW l.1029), the second 1 s after the first ended (FW l.1029) */
+	zassert_true(rep[1] - rep[0] >= 1000, "first recording 1 s (%lld ms)", rep[1] - rep[0]);
+	zassert_true(rep[3] - rep[2] >= 1000, "second recording 1 s (%lld ms)", rep[3] - rep[2]);
+	zassert_true(rep[2] - rep[1] >= 1000, "1 s apart (%lld ms)", rep[2] - rep[1]);
+	zassert_false(rt_mic(), "VDD_MIC off after the test");
+#else
+	ztest_test_skip();
+#endif
+}
+
+static void *setup(void)
+{
+	rt_setup();
+	return NULL;
+}
+
+ZTEST_SUITE(recorder_factory, NULL, setup, NULL, NULL, NULL);
diff --git a/firmware/tests/recorder/src/test_noscreens.c b/firmware/tests/recorder/src/test_noscreens.c
new file mode 100644
index 00000000..7691b60c
--- /dev/null
+++ b/firmware/tests/recorder/src/test_noscreens.c
@@ -0,0 +1,32 @@
+/*
+ * recorder_a_noscreens: ship mode when the screens part never started (step 6 fix round 1, lead's ruling 4 on the open
+ * point of rscr_sync() without a time limit). The suite's name sorts first, so ztest runs it before every suite that
+ * starts the screens (rt_setup); the case checks that the screens were indeed never started.
+ */
+#include "rt.h"
+
+/* FW l.151, l.936 to l.941: the menu's power off goes through all of ship mode although no screens thread exists */
+ZTEST(recorder_a_noscreens, test_ship_without_screens_ends)
+{
+	int64_t t0;
+
+	zassert_false(rt_screens_started, "this case runs before any suite started the screens part");
+	rt_fresh(NULL);
+	rhw_sim_log_clear();
+	t0 = k_uptime_get();
+	rglue_event(RC_EV_MENU_POWER_OFF);
+	rt_settle();
+	TC_PRINT("ship without screens: idle %d, SHPHLDCONFIG at %d, ship task at %d, %lld ms\n", rrec_idle(),
+		 rt_find(RHW_EV_PMIC_SHPHLD_CFG, -1, -1, 0), rt_find(RHW_EV_PMIC_SHIP, -1, -1, 0), k_uptime_get() - t0);
+	zassert_true(rrec_idle(), "ship mode ended (the recorder's thread is free)");
+	zassert_true(rt_find(RHW_EV_PMIC_SHPHLD_CFG, -1, -1, 0) >= 0, "SHPHLDCONFIG written (FW l.938)");
+	zassert_true(rhw_sim_shipped(), "the ship task written (FW l.940)");
+}
+
+static void *setup(void)
+{
+	rt_setup_no_screens();
+	return NULL;
+}
+
+ZTEST_SUITE(recorder_a_noscreens, NULL, setup, NULL, NULL, NULL);
diff --git a/firmware/tests/recorder/src/test_rails.c b/firmware/tests/recorder/src/test_rails.c
index 618b3df9..a8e5b810 100644
--- a/firmware/tests/recorder/src/test_rails.c
+++ b/firmware/tests/recorder/src/test_rails.c
@@ -3,8 +3,11 @@
  */
 #include "rt.h"
 
-/* FW l.912 to l.920: VDD_SD on in BOOT, RECOVERY, RECORDING, TRANSFER; VDD_MIC only in RECORDING; HFXO on in RECORDING and
- * TRANSFER, and with USB in CHARGING. FACTORY_TEST is "per test" and BOOT/RECOVERY are passed through (not checked). */
+/* FW l.912 to l.920 (the table of 8.2): VDD_SD on in BOOT, RECOVERY, RECORDING, TRANSFER; VDD_MIC only in RECORDING;
+ * HFXO on in BOOT and RECOVERY (l.915), RECORDING (l.917), TRANSFER (l.919), with USB in CHARGING (l.918: VBUS is present
+ * in CHARGING, so USB runs), and in STANDBY and the error states only when the radio runs (l.916, l.920; these suites
+ * do not run the radio, so off). After a row the ring rests in its new state; BOOT and RECOVERY are passed through, so
+ * their HFXO is checked by test_hfxo_in_boot_and_recovery from the event log; FACTORY_TEST is "per test". */
 static int check_rails(int row)
 {
 	enum rc_state s = rt_state();
@@ -69,6 +72,81 @@ ZTEST(recorder_rails, test_sd_rail_per_state)
 	zassert_equal(rt_count_rail(RHW_RAIL_SD, false), 2, "off once after the boot mount and once at the close");
 }
 
+/* the HFXO requests outstanding just after simulated event i (the a0 of the last HFXO request or release up to i) */
+static int64_t hfxo_at(uint32_t upto)
+{
+	struct rhw_sim_ev e;
+	int64_t n = 0;
+
+	for (uint32_t i = 0; i <= upto && rhw_sim_log_get(i, &e); i++) {
+		if (e.kind == RHW_EV_HFXO_REQUEST || e.kind == RHW_EV_HFXO_RELEASE) {
+			n = e.a0;
+		}
+	}
+	return n;
+}
+
+/* the first step whose state after it is s, at or after step `from`; -1 when none */
+static int32_t step_into(enum rc_state s, uint32_t from)
+{
+	for (uint32_t i = from; i < rt_steps(); i++) {
+		if (rt_step_get(i).state == s) {
+			return (int32_t)i;
+		}
+	}
+	return -1;
+}
+
+/* the HFXO count stays above 0 from simulated event `a` through every event before time t_end_us */
+static bool held_through(int32_t a, int64_t t_end_us)
+{
+	struct rhw_sim_ev e;
+	int64_t n = hfxo_at((uint32_t)a);
+
+	if (n < 1) {
+		return false;
+	}
+	for (uint32_t i = (uint32_t)a + 1; rhw_sim_log_get(i, &e) && e.t_us < t_end_us; i++) {
+		if ((e.kind == RHW_EV_HFXO_REQUEST || e.kind == RHW_EV_HFXO_RELEASE) && e.a0 < 1) {
+			return false;
+		}
+	}
+	return true;
+}
+
+/* FW l.915 (review finding R6-04): HFXO on in BOOT and RECOVERY, released when the state that follows does not want it
+ * (STANDBY, l.916: "when the radio runs"; these suites do not run the radio) */
+ZTEST(recorder_rails, test_hfxo_in_boot_and_recovery)
+{
+	int32_t i_init, i_rec, i_stb;
+	int64_t t_stb_us;
+
+	/* BOOT: the boot mount (the first card init) runs with HFXO held, until the step into STANDBY */
+	rt_fresh(NULL);
+	i_init = rt_find(RHW_EV_DISK_INIT, -1, -1, 0);
+	i_stb = step_into(RC_ST_STANDBY, 0);
+	zassert_true(i_init >= 0 && i_stb >= 0, "booted to STANDBY (%d, %d)", i_init, i_stb);
+	t_stb_us = rt_step_get((uint32_t)i_stb).t_ms * 1000;
+	TC_PRINT("HFXO BOOT: requests %lld at the boot card init (event %d), STANDBY step at %lld us, now %u\n",
+		 hfxo_at((uint32_t)i_init), i_init, t_stb_us, rhw_sim_hfxo_requests());
+	zassert_true(held_through(i_init, t_stb_us), "HFXO on in BOOT (FW l.915)");
+	zassert_equal(rhw_sim_hfxo_requests(), 0u, "released in STANDBY (FW l.916)");
+
+	/* RECOVERY (row 9: the open flag at boot, the scan, STANDBY): held from BOOT through RECOVERY */
+	zassert_equal(rt_run_row(9), 0, NULL);
+	zassert_true(rt_row_seen(9), "row 9");
+	i_rec = step_into(RC_ST_RECOVERY, 0);
+	i_stb = step_into(RC_ST_STANDBY, i_rec < 0 ? 0 : (uint32_t)i_rec);
+	zassert_true(i_rec >= 0 && i_stb > i_rec, "BOOT, RECOVERY, STANDBY (%d, %d)", i_rec, i_stb);
+	i_init = rt_find(RHW_EV_DISK_INIT, -1, -1, 0);
+	t_stb_us = rt_step_get((uint32_t)i_stb).t_ms * 1000;
+	TC_PRINT("HFXO RECOVERY: requests %lld at the boot card init (event %d), RECOVERY step at %lld ms, STANDBY at %lld us, "
+		 "now %u\n", hfxo_at((uint32_t)i_init), i_init, rt_step_get((uint32_t)i_rec).t_ms, t_stb_us,
+		 rhw_sim_hfxo_requests());
+	zassert_true(held_through(i_init, t_stb_us), "HFXO on in BOOT and RECOVERY (FW l.915)");
+	zassert_equal(rhw_sim_hfxo_requests(), 0u, "released in STANDBY (FW l.916)");
+}
+
 static void *setup(void)
 {
 	rt_setup();
diff --git a/firmware/tests/recorder/src/test_rows.c b/firmware/tests/recorder/src/test_rows.c
index b0ecc608..3317b035 100644
--- a/firmware/tests/recorder/src/test_rows.c
+++ b/firmware/tests/recorder/src/test_rows.c
@@ -17,7 +17,7 @@ static bool mic_rule_holds(void)
 	if (s == RC_ST_RECORDING) {
 		return true;   /* on is required while the recording runs; a failed open leaves the state through its row */
 	}
-	if (s == RC_ST_FACTORY_TEST && rrec_st.test_recording) {
+	if (s == RC_ST_FACTORY_TEST && atomic_get(&rrec_st.test_recording) != 0) {
 		return true;
 	}
 	return !on;
@@ -53,7 +53,7 @@ ZTEST(recorder_rows, test_mic_rail_only_in_recording)
 		}
 		for (int tick = 0; tick <= 100; tick++) {
 			checks++;
-			if (rrec_st.test_recording && rt_mic()) {
+			if (atomic_get(&rrec_st.test_recording) != 0 && rt_mic()) {
 				t_mic_seen_on = true;
 			}
 			if (!mic_rule_holds()) {
diff --git a/firmware/tests/recorder/src/test_screens.c b/firmware/tests/recorder/src/test_screens.c
index 87708301..7316325c 100644
--- a/firmware/tests/recorder/src/test_screens.c
+++ b/firmware/tests/recorder/src/test_screens.c
@@ -20,30 +20,57 @@ static uint64_t frame_hash(void)
 	return h;
 }
 
-static uint64_t charging_screen(uint16_t soc_x10)
+/* SCR_CHARGING after a boot with VBUS (row 5) on a set world: 1,000 µAh cell at 50.0 % (gauge start 500), charging at
+ * 1 mA (samples of -1,000 µA), the charger's state as given (0 = its own: constant current with VBUS) */
+static uint64_t charging_screen(uint8_t chg_forced)
 {
-	struct rt_boot b = { .soc_x10 = soc_x10 };
+	struct rt_boot b = { .vbus = true, .mv = 3900, .ua = -1000, .gauge_uah = 1000, .soc_x10 = 500,
+			     .chg_forced = chg_forced };
 	struct rscr s;
 
 	rt_fresh(&b);
-	rt_vbus(true);
+	zassert_equal(rt_state(), RC_ST_CHARGING, "CHARGING (row 5)");
 	rt_sleep(1500);   /* the battery values reach the screens once a second (rscr_set_battery) */
 	rscr_snapshot(&s);
 	zassert_equal(s.screen, SCR_CHARGING, "SCR_CHARGING for 5 s after insertion (FW l.103)");
 	return frame_hash();
 }
 
-/* FW l.374: SCR_CHARGING shows the battery from the gauge (C39): the same gauge value draws the same frame, another value
- * another frame */
+/* the same screen drawn from values the test gives the screens itself */
+static uint64_t ref_screen(uint8_t pct, bool charging, bool full, uint16_t to_full_min)
+{
+	rscr_set_battery(pct, charging, full, to_full_min);
+	return frame_hash();
+}
+
+/* FW l.374 (C39, review finding R6-14): SCR_CHARGING shows "battery % and icon, "Charging" or "Full", time to full in
+ * minutes from the fuel gauge". The values the screen received are those typed here: the picture the join's values drew
+ * equals the picture of the typed values, and differs when any one of them differs. */
 ZTEST(recorder_screens, test_battery_reaches_screens)
 {
-	uint64_t a1 = charging_screen(623);
-	uint64_t a2 = charging_screen(623);
-	uint64_t b1 = charging_screen(412);
+	/* 50 % (gauge 500 = 50.0 %); "Charging" (constant current with VBUS); time to full 30 min [CALC: 1,000 µAh x
+	 * (1,000 - 500) / 1,000 at 1 mA = 0.5 h = 30 min] */
+	uint64_t a = charging_screen(0);
+	uint64_t ok = ref_screen(50, true, false, 30);
+	uint64_t ttf31 = ref_screen(50, true, false, 31);
+	uint64_t pct51 = ref_screen(51, true, false, 30);
+	uint64_t full = ref_screen(50, false, true, 30);
+	uint64_t f, f_ok, f_chg;
 
-	TC_PRINT("SCR_CHARGING frame hash: 62.3 %% %016llx, again %016llx, 41.2 %% %016llx\n", a1, a2, b1);
-	zassert_equal(a1, a2, "the same gauge value, the same picture");
-	zassert_not_equal(a1, b1, "another gauge value, another picture: the value reaches the screen");
+	TC_PRINT("SCR_CHARGING frames: from the join %016llx; typed 50 %% Charging 30 min %016llx, 31 min %016llx, 51 %% "
+		 "%016llx, Full %016llx\n", a, ok, ttf31, pct51, full);
+	zassert_equal(a, ok, "the screen received 50 %%, Charging, 30 min");
+	zassert_not_equal(a, ttf31, "the time to full is in the picture");
+	zassert_not_equal(a, pct51, "the percent is in the picture");
+	zassert_not_equal(a, full, "Charging, not Full");
+	/* "Full": the charger reports charging completed (RREC_CHG_FULL) */
+	f = charging_screen(RREC_CHG_FULL + 1);
+	f_ok = ref_screen(50, false, true, 30);
+	f_chg = ref_screen(50, true, false, 30);
+	TC_PRINT("SCR_CHARGING frames (full): from the join %016llx; typed 50 %% Full %016llx, Charging %016llx\n", f, f_ok,
+		 f_chg);
+	zassert_equal(f, f_ok, "the screen received 50 %%, Full");
+	zassert_not_equal(f, f_chg, "Full, not Charging");
 }
 
 /* FW l.990 to l.995: the current limit reads ACTIVE in RECORDING: SCR_REC_DIM 10 s, never dark, the recording goes on,
diff --git a/firmware/tests/recorder/src/test_ship.c b/firmware/tests/recorder/src/test_ship.c
new file mode 100644
index 00000000..ab74fe14
--- /dev/null
+++ b/firmware/tests/recorder/src/test_ship.c
@@ -0,0 +1,157 @@
+/*
+ * recorder_ship: ship mode as the join carries it out (step 6 fix round 1, review findings R6-01, R6-02, R6-10):
+ * design/firmware.md 8.4 (l.936 to l.941), the menu's "Power off" row (l.151) and ruling R20 (l.1057).
+ * Orders are read from the one event log of the simulated drivers (rhw_sim.h).
+ */
+#include <string.h>
+
+#include "rt.h"
+
+/* ------------------------------------------------------------------ ship mode (fix round 1: R6-01, R6-02, R6-10) */
+static struct {
+	bool called;
+	uint32_t log_n;        /* the simulated event log's length when step 1 ended (SHPHLDCONFIG comes after it) */
+	bool mic, sd, usb, blanked, beacon_stopped;
+	uint32_t radio_stops;
+	char thread[16];
+} at_ship;
+
+static void ship_hook(void)
+{
+	const char *nm = k_thread_name_get(k_current_get());
+
+	at_ship.called = true;
+	at_ship.log_n = rhw_sim_log_count();
+	at_ship.mic = rt_mic();
+	at_ship.sd = rt_sd();
+	at_ship.usb = rhw_sim_usb_enabled();
+	at_ship.blanked = rt_blanked();
+	at_ship.beacon_stopped = rt_find(RHW_EV_BEACON_STOP, -1, -1, 0) >= 0;
+	at_ship.radio_stops = rrec_test_radio_stops();
+	strncpy(at_ship.thread, nm != NULL ? nm : "", sizeof(at_ship.thread) - 1);
+}
+
+/* FW l.151, l.323: menu "Power off": the whole M2 (80 on, 120 off, 80 on) on the MOTOR pin before SHPHLDCONFIG (R6-01) */
+ZTEST(recorder_ship, test_ship_feels_whole_m2)
+{
+	static const int32_t m2_ms[3] = { 80, 120, 80 };   /* FW l.323 */
+	struct rhw_sim_ev e;
+	int64_t t[4];
+	int lv[4];
+	int n = 0;
+	int32_t i_cfg;
+
+	rt_fresh(NULL);
+	rhw_sim_log_clear();
+	rglue_event(RC_EV_MENU_POWER_OFF);
+	rt_settle();
+	zassert_true(rt_row_seen(19), "row 19 (FW l.151)");
+	i_cfg = rt_find(RHW_EV_PMIC_SHPHLD_CFG, -1, -1, 0);
+	zassert_true(i_cfg >= 0, "SHPHLDCONFIG written");
+	for (int32_t i = 0; i < i_cfg && rhw_sim_log_get((uint32_t)i, &e); i++) {
+		if (e.kind == RHW_EV_MOTOR) {
+			if (n < 4) {
+				t[n] = e.t_us;
+				lv[n] = (int)e.a0;
+			}
+			n++;
+		}
+	}
+	TC_PRINT("ship: %d MOTOR edges before SHPHLDCONFIG (index %d)\n", n, i_cfg);
+	zassert_equal(n, 4, "M2 = 4 edges before SHPHLDCONFIG (%d)", n);
+	for (int i = 0; i < 4; i++) {
+		zassert_equal(lv[i], (i % 2) == 0 ? 1 : 0, "edge %d level", i);
+	}
+	for (int i = 0; i < 3; i++) {
+		int64_t d = t[i + 1] - t[i];
+
+		TC_PRINT("ship: M2 segment %d lasted %lld us (FW l.323: %d ms)\n", i, d, m2_ms[i]);
+		/* the motor unit's tolerance (tests/motor t_check_edges): -1 us to +1 ms */
+		zassert_true(d >= (int64_t)m2_ms[i] * 1000 - 1 && d < (int64_t)m2_ms[i] * 1000 + 1000,
+			     "segment %d: %lld us, FW l.323 %d ms", i, d, m2_ms[i]);
+	}
+	/* FW l.323: M2 lasts 280 ms from its first MOTOR high to its last MOTOR low, all before SHPHLDCONFIG */
+	TC_PRINT("ship: M2 lasted %lld us on the MOTOR pin (FW l.323: 280 ms)\n", t[3] - t[0]);
+	zassert_true(t[3] - t[0] >= 280 * 1000 - 1 && t[3] - t[0] < 280 * 1000 + 3000, "M2 280 ms (%lld us)", t[3] - t[0]);
+}
+
+/* FW l.937 step 1, ruling R20: before SHPHLDCONFIG the recording, storage, USB, radio and screen are closed; the ship
+ * beacon still runs; ship mode runs on the recorder's thread (R6-02, R6-10). The factory SHIP_ENTER (VBUS present, the
+ * ship waits for VBUS removal) and the menu's power off with the screen on. */
+ZTEST(recorder_ship, test_ship_closes_each_part_first)
+{
+#if defined(CONFIG_RING_FACTORY)
+	static uint8_t resp[64];
+	uint8_t st;
+	uint8_t sub = RREC_FAC_SHIP_ENTER;
+	struct rt_boot b = { .factory_flag = true };
+	int32_t i_cfg, i_usb_off, i_sd_off;
+	uint32_t radio0;
+
+	rt_fresh(&b);
+	rt_vbus(true);
+	rt_usb_configured();
+	(void)rt_usb(RREC_OP_FACTORY, (const uint8_t[]){ RREC_FAC_ENTER }, 1, resp, sizeof(resp), &st);
+	zassert_equal(rt_state(), RC_ST_FACTORY_TEST, "FACTORY_TEST");
+	zassert_true(rhw_sim_usb_enabled(), "USB runs");
+	zassert_false(rt_blanked(), "the screen is on (SCR_FACTORY)");
+	memset(&at_ship, 0, sizeof(at_ship));
+	radio0 = rrec_test_radio_stops();
+	rrec_test_set_ship_hook(ship_hook);
+	rhw_sim_log_clear();
+	(void)rt_usb_send(RREC_OP_FACTORY, &sub, 1);
+	for (int i = 0; i < 300 && !at_ship.called; i++) {
+		rt_sleep(10);
+	}
+	rt_sleep(200);   /* the ship waits for VBUS removal now (FW l.939) */
+	rrec_test_set_ship_hook(NULL);
+	i_cfg = rt_find(RHW_EV_PMIC_SHPHLD_CFG, -1, -1, 0);
+	i_usb_off = rt_find(RHW_EV_USB_DISABLE, -1, -1, 0);
+	i_sd_off = rt_find_rail(RHW_RAIL_SD, false, 0);
+	TC_PRINT("ship (factory): step 1 ended at log %u on thread %s; SHPHLDCONFIG %d, USB disable %d, VDD_SD off %d; "
+		 "at step 1's end: VDD_MIC %d, VDD_SD %d, USB %d, screen blanked %d, radio stops %u, beacon stopped %d\n",
+		 at_ship.log_n, at_ship.thread, i_cfg, i_usb_off, i_sd_off, at_ship.mic, at_ship.sd, at_ship.usb,
+		 at_ship.blanked, at_ship.radio_stops - radio0, at_ship.beacon_stopped);
+	zassert_true(at_ship.called, "ship mode step 1 ran");
+	zassert_true(i_cfg >= 0 && (uint32_t)i_cfg >= at_ship.log_n, "SHPHLDCONFIG after step 1");
+	zassert_false(at_ship.mic, "recording closed (VDD_MIC off)");
+	zassert_false(at_ship.sd, "storage closed (VDD_SD off)");
+	zassert_true(i_sd_off >= 0 && i_sd_off < i_cfg, "VDD_SD off before SHPHLDCONFIG");
+	zassert_false(at_ship.usb, "USB closed");
+	zassert_true(i_usb_off >= 0 && i_usb_off < i_cfg, "USB disabled before SHPHLDCONFIG");
+	zassert_equal(at_ship.radio_stops - radio0, 1u, "the radio stopped once (rdev_stop)");
+	zassert_true(at_ship.blanked, "the screen closed (panel off) before SHPHLDCONFIG");
+	zassert_false(at_ship.beacon_stopped, "the ship beacon still runs (ruling R20)");
+	zassert_equal(strcmp(at_ship.thread, "rrec"), 0, "on the recorder's thread (%s)", at_ship.thread);
+	rt_row_cleanup(70);
+	zassert_true(rhw_sim_shipped(), "the ship task after VBUS removal");
+
+	/* the menu's power off with the screen on (the status screen of a short press) */
+	rt_fresh(NULL);
+	rt_short();
+	zassert_false(rt_blanked(), "the screen is on");
+	memset(&at_ship, 0, sizeof(at_ship));
+	rrec_test_set_ship_hook(ship_hook);
+	rhw_sim_log_clear();
+	rglue_event(RC_EV_MENU_POWER_OFF);
+	rt_settle();
+	rrec_test_set_ship_hook(NULL);
+	i_cfg = rt_find(RHW_EV_PMIC_SHPHLD_CFG, -1, -1, 0);
+	TC_PRINT("ship (menu): step 1 ended at log %u on thread %s, SHPHLDCONFIG %d, screen blanked %d\n", at_ship.log_n,
+		 at_ship.thread, i_cfg, at_ship.blanked);
+	zassert_true(at_ship.called && i_cfg >= 0 && (uint32_t)i_cfg >= at_ship.log_n, "step 1, then SHPHLDCONFIG");
+	zassert_true(at_ship.blanked, "the screen closed before SHPHLDCONFIG");
+	zassert_equal(strcmp(at_ship.thread, "rrec"), 0, "on the recorder's thread (%s)", at_ship.thread);
+#else
+	ztest_test_skip();
+#endif
+}
+
+
+static void *setup(void)
+{
+	rt_setup();
+	return NULL;
+}
+
+ZTEST_SUITE(recorder_ship, NULL, setup, NULL, NULL, NULL);
diff --git a/firmware/tests/recorder/src/test_unmount.c b/firmware/tests/recorder/src/test_unmount.c
new file mode 100644
index 00000000..ba66ffc9
--- /dev/null
+++ b/firmware/tests/recorder/src/test_unmount.c
@@ -0,0 +1,154 @@
+/*
+ * recorder_unmount: VDD_SD off when TRANSFER is left while a command uses the store (step 6 fix round 1, review finding
+ * R6-03): design/firmware.md l.178 ("finish the current command; VDD_SD off"), l.179 ("abort the command; VDD_SD off"),
+ * and 8.2 (l.912 to l.920: VDD_SD off in STANDBY and CHARGING). The simulated card stalls only its writes
+ * (rhw_sim_disk_stall_ms); a stalled chunk READ is not simulated. The "read command" is GET_LOG (FW l.706, lead's ruling),
+ * whose store call first writes the queued event log records, so with queued records and a stalled card it holds the
+ * store for the stall times the records.
+ * The transfer part runs its bus events on the transfer thread after the command that runs (rxf_class.c), so "unconfigured
+ * while a command runs" does not reach the core through the class until the command ended; the cases of l.178 give the
+ * core the event themselves (rglue_event, as the cases of the Bluetooth highlight do) while GET_LOG holds the store.
+ */
+#include <string.h>
+
+#include <zephyr/sys/byteorder.h>
+
+#include <ring_store/rst.h>
+#include <ring_xfer/rxf.h>
+
+#include "rt.h"
+
+/* a TRANSFER with the card mounted, then `records` event log records queued on a card that stalls each write by
+ * `stall_ms`, then GET_LOG sent (not waited for) */
+static void transfer_with_busy_store(uint32_t stall_ms, int records)
+{
+	uint8_t pl[RREC_GET_LOG_REQ_BYTES];
+	uint8_t a[4] = { 0 };
+
+	rt_fresh(NULL);
+	rt_vbus(true);
+	rt_usb_configured();
+	zassert_equal(rt_state(), RC_ST_TRANSFER, "TRANSFER");
+	zassert_true(rt_sd(), "VDD_SD on in TRANSFER");
+	rhw_sim_disk_stall_ms(stall_ms);
+	for (int i = 0; i < records; i++) {
+		a[0] = (uint8_t)i;
+		rrec_log(RREC_LOG_BATTERY, a, sizeof(a));   /* records to write: the storage thread and GET_LOG write them */
+	}
+	sys_put_le32(1, pl);
+	sys_put_le16(RREC_GET_LOG_MAX_MAX, &pl[4]);
+	zassert_equal(rt_usb_send(RREC_OP_GET_LOG, pl, sizeof(pl)), 0, "GET_LOG sent");
+	rt_sleep(100);
+	zassert_true(rxf_busy(), "the command runs");
+	rt_steps_clear();
+	rhw_sim_log_clear();
+}
+
+/* the end of a case: the command ended (the transfer thread is free again) and the card no longer stalls */
+static void command_ended(void)
+{
+	for (int i = 0; i < 600 && rxf_busy(); i++) {
+		rt_sleep(100);
+	}
+	zassert_false(rxf_busy(), "the command ended");
+	rhw_sim_disk_stall_ms(0);
+	rt_settle();
+}
+
+/* the step of `row` ended with VDD_SD off: the rail went off inside that step (before its after-call), not in a later one */
+static void sd_off_in_the_step(int row)
+{
+	int32_t i_off = rt_find_rail(RHW_RAIL_SD, false, 0);
+	int64_t step_ms = -1;
+
+	for (uint32_t i = 0; i < rt_steps(); i++) {
+		if (rt_step_get(i).row == row) {
+			step_ms = rt_step_get(i).t_ms;
+			break;
+		}
+	}
+	TC_PRINT("unmount: row %d step at %lld ms, VDD_SD off at %lld us, steps %u, VDD_SD now %d\n", row, step_ms,
+		 rt_ev_us(i_off), rt_steps(), rt_sd());
+	zassert_true(step_ms >= 0, "row %d taken", row);
+	zassert_false(rt_sd(), "VDD_SD off when the step of row %d ended", row);
+	zassert_true(i_off >= 0 && rt_ev_us(i_off) <= step_ms * 1000 + 1000, "VDD_SD went off inside the step of row %d",
+		     row);
+}
+
+/* FW l.179: VBUS removed in TRANSFER while GET_LOG holds the store: abort, the command ends, VDD_SD off in that step */
+ZTEST(recorder_unmount, test_vbus_out_during_read_command)
+{
+	transfer_with_busy_store(400, 6);
+	rt_vbus(false);
+	zassert_equal(rt_state(), RC_ST_STANDBY, "STANDBY (FW l.179)");
+	sd_off_in_the_step(47);
+	command_ended();
+}
+
+/* FW l.178: unconfigured in TRANSFER while GET_LOG holds the store longer than the finish waits (5,000 ms, the join's
+ * bound): the finish times out, the unmount waits for the store call, VDD_SD off in that step */
+ZTEST(recorder_unmount, test_unconfigured_finish_times_out)
+{
+	int64_t t0;
+
+	transfer_with_busy_store(1300, 6);
+	t0 = k_uptime_get();
+	rglue_event(RC_EV_USB_UNCONFIGURED);
+	rt_settle();
+	TC_PRINT("unmount: the unconfigured step took about %lld ms\n", k_uptime_get() - t0);
+	zassert_equal(rt_state(), RC_ST_CHARGING, "CHARGING (FW l.178)");
+	sd_off_in_the_step(46);
+	zassert_true(k_uptime_get() - t0 > 5000, "the finish timed out first (the command held the store longer)");
+	zassert_true(rhw_sim_pmic_charger_on(), "charge on (FW l.178)");
+	command_ended();
+}
+
+/* a store call longer than both waits: the failed unmount is reported (event log) and tried again until VDD_SD is off */
+ZTEST(recorder_unmount, test_failed_unmount_retried_and_reported)
+{
+	struct rrec_tap_rec t;
+	int busy = 0;
+	bool order_ok = true;
+	uint8_t first_state = 0xFF;
+
+	rrec_tap_clear();
+	transfer_with_busy_store(3000, 6);
+	rrec_tap_clear();
+	rglue_event(RC_EV_USB_UNCONFIGURED);
+	for (int i = 0; i < 400 && rt_sd(); i++) {
+		rt_sleep(100);
+	}
+	rt_settle();
+	/* FW l.1234 (the code table, the lead's ruling): 0x0290 RREC_LOG_UNMOUNT_FAILED, errno i32, state u8, try u8, written
+	 * at the FIRST failed try (its errno, try 1) and once when the tries end (errno 0 when the unmount then succeeded,
+	 * try = the number of tries made) */
+	for (uint32_t k = 0; rrec_tap_get(k, &t); k++) {
+		if (t.code == RREC_LOG_UNMOUNT_FAILED) {
+			busy++;
+			TC_PRINT("unmount: record %d: errno %d, state %s, try %u\n", busy, (int32_t)sys_get_le32(t.args),
+				 rc_state_name((enum rc_state)t.args[4]), t.args[5]);
+			if (busy == 1) {
+				first_state = t.args[4];
+				order_ok &= (int32_t)sys_get_le32(t.args) == -EBUSY && t.args[5] == 1;
+			} else if (busy == 2) {
+				order_ok &= (int32_t)sys_get_le32(t.args) == 0 && t.args[5] >= 2;
+			}
+		}
+	}
+	TC_PRINT("unmount: %d records 0x0290, VDD_SD now %d, state %s\n", busy, rt_sd(), rc_state_name(rt_state()));
+	zassert_equal(RREC_LOG_UNMOUNT_FAILED, 0x0290, "the code of FW l.1234");
+	zassert_equal(busy, 2, "two records for a step with several failed tries (%d)", busy);
+	zassert_true(order_ok, "first: errno -EBUSY, try 1; second: errno 0, the number of tries (2 or more)");
+	zassert_equal(first_state, RC_ST_TRANSFER, "the first try in the step of row 46 (from TRANSFER)");
+	zassert_false(rt_sd(), "tried again until VDD_SD went off");
+	zassert_false(rst_mounted(), "unmounted");
+	command_ended();
+}
+
+static void *setup(void)
+{
+	rt_setup();
+	return NULL;
+}
+
+ZTEST_SUITE(recorder_unmount, NULL, setup, NULL, NULL, NULL);
diff --git a/firmware/tests/store/src/test_svc.c b/firmware/tests/store/src/test_svc.c
index 1f845ee6..54d950a9 100644
--- a/firmware/tests/store/src/test_svc.c
+++ b/firmware/tests/store/src/test_svc.c
@@ -516,6 +516,35 @@ ZTEST(store_svc, test_busy_while_operation_runs)
 	zassert_equal(n, 1);
 }
 
+/* step 6 fix round 1 (R6-03): rst_unmount_wait waits for the call that runs on another thread, then unmounts (rail off);
+ * with a bound shorter than that call it answers -EBUSY and changes nothing */
+ZTEST(store_svc, test_unmount_wait_waits_for_running_call)
+{
+	struct rst_mount_info mi;
+	uint32_t id;
+
+	tst_card(100);
+	tst_mount_boot(&mi);
+	zassert_equal(rst_open(RREC_REC_TYPE_RECORDING, 0, &id), 0);
+	rhw_sim_disk_stall_ms(300);                    /* the close writes 2 sectors, 300 ms each */
+	helper_rc = 99;
+	k_thread_create(&helper, helper_stack, K_THREAD_STACK_SIZEOF(helper_stack), helper_close, NULL, NULL, NULL, 1,
+			0, K_NO_WAIT);
+	k_msleep(100);
+	zassert_equal(rst_unmount_wait(50), -EBUSY, "the close runs longer than 50 ms");
+	zassert_true(rst_mounted(), "nothing changed");
+	zassert_true(rhw_pmic()->rail_get(RHW_RAIL_SD), "VDD_SD still on");
+	int64_t t0 = k_uptime_get();
+
+	zassert_equal(rst_unmount_wait(5000), 0, "waited for the close, then unmounted");
+	TC_PRINT("rst_unmount_wait waited %lld ms for the running close\n", k_uptime_get() - t0);
+	zassert_true(k_uptime_get() - t0 >= 100, "it waited for the running call");
+	zassert_false(rst_mounted(), "unmounted");
+	zassert_false(rhw_pmic()->rail_get(RHW_RAIL_SD), "VDD_SD off");
+	zassert_equal(k_thread_join(&helper, K_SECONDS(5)), 0);
+	zassert_equal(helper_rc, 0, "the close itself succeeded");
+}
+
 /* the ring of 3: a fourth chunk waits for nobody and is refused, nothing is overwritten */
 ZTEST(store_svc, test_put_chunk_ring_of_three)
 {
diff --git a/firmware/tests/xfer/src/test_svc.c b/firmware/tests/xfer/src/test_svc.c
index 8146ac45..0e946c5a 100644
--- a/firmware/tests/xfer/src/test_svc.c
+++ b/firmware/tests/xfer/src/test_svc.c
@@ -398,6 +398,34 @@ ZTEST(xfer_svc, test_finish_and_abort)
 	rhw_sim_usb_host_sink(NULL);
 }
 
+/* step 6 fix round 1 (R6-02, FW l.937): rxf_stop() aborts the command that runs (no response), the stack is disabled
+ * when it returns and stays off with VBUS still present; the next VBUS ready starts it again */
+ZTEST(xfer_svc, test_stop_closes_usb_for_ship)
+{
+	vbus_on();
+	zassert_true(rhw_sim_usb_enabled(), "the stack runs with VBUS");
+	fk.hook = slow;
+	host_send(RREC_OP_GET_BATTERY, 0x41, NULL, 0);
+	k_msleep(5);
+	zassert_true(rxf_busy(), "a command runs");
+	zassert_equal(rxf_stop(1000), 0, "the command ended within the bound");
+	zassert_false(rhw_sim_usb_enabled(), "the stack is off when rxf_stop returns");
+	zassert_equal(rhw_sim_log_count_kind(RHW_EV_USB_DISABLE), 1u, "one disable");
+	zassert_false(rxf_busy());
+	k_msleep(80);
+	zassert_equal(rhw_sim_usb_host_read(rsp, sizeof(rsp)), 0u, "no response for the aborted command");
+	zassert_equal(fk.after_calls, 0u, "the aborted command is not reported");
+	fk.hook = NULL;
+	k_msleep(20);
+	zassert_false(rhw_sim_usb_enabled(), "VBUS still present: the stack stays off (not started again by itself)");
+	rhw_sim_vbus(false);
+	k_msleep(2);
+	vbus_on();
+	zassert_true(rhw_sim_usb_enabled(), "VBUS ready again: the stack starts");
+	host_send(RREC_OP_GET_INFO, 0x42, NULL, 0);
+	zassert_equal(host_get(rsp, sizeof(rsp), 30), 51u, "and answers");
+}
+
 /* the bus events reach the join on the transfer thread: configured, unconfigured, suspended; VBUS removal is not one */
 ZTEST(xfer_svc, test_configured_callbacks)
 {
