NexusGPT/openring/firmware/build-logs/step7/review2-work/r7-diff-modules.txt

diff --git a/firmware/modules/ring_power/src/rpw_hw_real.c b/firmware/modules/ring_power/src/rpw_hw_real.c
index b240004e..f7f13586 100644
--- a/firmware/modules/ring_power/src/rpw_hw_real.c
+++ b/firmware/modules/ring_power/src/rpw_hw_real.c
@@ -304,10 +304,22 @@ static int g_start(const struct rhw_pmic_sample *first)
 
 static int g_process(const struct rhw_pmic_sample *s, uint32_t dt_ms, struct rhw_gauge_out *out)
 {
-	float soc = nrf_fuel_gauge_process(s->mv / 1000.0f, -(s->ua / 1000000.0f), s->temp_c_x10 / 10.0f,
-					   dt_ms / 1000.0f, NULL);
-	float tte = nrf_fuel_gauge_tte_get();
-	float ttf = nrf_fuel_gauge_ttf_get();
+	/* nRF Connect SDK v3.4.2 signatures (nrfxlib/nrf_fuel_gauge/include/nrf_fuel_gauge.h: process l.475, tte_get
+	 * l.498, ttf_get l.510): each returns 0 or a negative error and writes its value through a pointer; tte and ttf
+	 * may be NAN (the header's own words), which the "> 0" tests below turn into "unknown" (UINT32_MAX). */
+	float soc = 0.0f, tte = 0.0f, ttf = 0.0f;
+	int rc = nrf_fuel_gauge_process(s->mv / 1000.0f, -(s->ua / 1000000.0f), s->temp_c_x10 / 10.0f,
+					dt_ms / 1000.0f, &soc, NULL);
+
+	if (rc != 0) {
+		return rc;
+	}
+	if (nrf_fuel_gauge_tte_get(&tte) != 0) {
+		tte = 0.0f;
+	}
+	if (nrf_fuel_gauge_ttf_get(&ttf) != 0) {
+		ttf = 0.0f;
+	}
 
 	out->soc_x10 = (uint16_t)(soc * 10.0f + 0.5f);
 	out->tte_s = tte > 0.0f ? (uint32_t)tte : UINT32_MAX;
diff --git a/firmware/modules/ring_store/src/rst_hw_real.c b/firmware/modules/ring_store/src/rst_hw_real.c
index 9bb56a83..274cdd52 100644
--- a/firmware/modules/ring_store/src/rst_hw_real.c
+++ b/firmware/modules/ring_store/src/rst_hw_real.c
@@ -10,6 +10,7 @@
 
 #include <zephyr/device.h>
 #include <zephyr/devicetree.h>
+#include <zephyr/drivers/gpio.h>
 #include <zephyr/init.h>
 #include <zephyr/pm/device.h>
 #include <zephyr/storage/disk_access.h>
@@ -51,13 +52,58 @@ static const struct rhw_disk_api real_disk = {
 	.init = r_init, .deinit = r_deinit, .read = r_read, .write = r_write, .sector_count = r_count,
 };
 
+/* The card's chip select (FW l.506: no storage line driven high while VDD_SD is off). It is a GPIO of spi00
+ * (cs-gpios), outside spi00's pin states. The kit's SPIM driver (zephyr/drivers/spi/spi_nrfx_spim_common.c, SDK
+ * v3.4.2) drives it as an output at its inactive level (high) from its init (cs_init, l.678: GPIO_OUTPUT_INACTIVE) and
+ * leaves it so on suspend (pm_suspend applies the "sleep" pin state and only releases the GPIO port, cs_put l.571), so
+ * this file disconnects it (input buffer off, no pull) after each suspend and at boot, and drives it inactive again
+ * just before each resume. The storage part calls resume only after VDD_SD is on (rst.c l.345 to 349). */
+#if DT_NODE_HAS_PROP(DT_NODELABEL(spi00), cs_gpios)
+static const struct gpio_dt_spec sd_cs = GPIO_DT_SPEC_GET_BY_IDX(DT_NODELABEL(spi00), cs_gpios, 0);
+
+static int cs_release(void)
+{
+	return gpio_pin_configure_dt(&sd_cs, GPIO_DISCONNECTED);
+}
+
+static int cs_drive(void)
+{
+	return gpio_pin_configure_dt(&sd_cs, GPIO_OUTPUT_INACTIVE);
+}
+
+/* at boot, right after the kit's devices (spi00 at CONFIG_SPI_INIT_PRIORITY drove the line high): release it */
+static int rst_hw_real_cs_boot(void)
+{
+	return cs_release();
+}
+SYS_INIT(rst_hw_real_cs_boot, POST_KERNEL, 99);
+#else
+static int cs_release(void)
+{
+	return 0;
+}
+
+static int cs_drive(void)
+{
+	return 0;
+}
+#endif
+
 static int b_suspend(void)
 {
-	return pm_device_action_run(DEVICE_DT_GET(DT_NODELABEL(spi00)), PM_DEVICE_ACTION_SUSPEND);
+	int r = pm_device_action_run(DEVICE_DT_GET(DT_NODELABEL(spi00)), PM_DEVICE_ACTION_SUSPEND);
+	int c = cs_release();
+
+	return r != 0 && r != -EALREADY ? r : c;
 }
 
 static int b_resume(void)
 {
+	int c = cs_drive();
+
+	if (c != 0) {
+		return c;
+	}
 	return pm_device_action_run(DEVICE_DT_GET(DT_NODELABEL(spi00)), PM_DEVICE_ACTION_RESUME);
 }
 
exit 0
