NexusGPT/openring/design/ecad/ring-circuit-work/logs/info_diff.txt

1,6c1,6
< ring1 info at R_SPEC 1.9565 ohm: the cell terminal is 3.0232 V just before the start is over (settled, motor 175 mA) and dips to 2.9950 V when U11 finishes charging C84 and the motor draws its start current; the cell gives 232.5 mA at the peak (decision 41 names 230 mA)
< ring1: largest cell resistance that passes at open-circuit 3.45 V = 1.9277 ohm; first rows to fail just above it: R1.2
< ring1 info: largest cell resistance that passes at open-circuit 3.30 V = 1.2213 ohm; limiting rows R1.2
< ring1 info: largest cell resistance that passes at open-circuit 3.60 V = 2.7062 ohm; limiting rows R1.2
< ring1 info: at that resistance the cell gives 233.4 mA at the start, the cell terminal falls to 3.0000 V, the chip battery path carries 81.5 mA, U11 carries 220.3 mA, VDD_3V0 falls to 2.890 V, VMOT to 2.918 V
< ring1 info: largest cell resistance for each pass line at 3.45 V is in r1_row_limits.csv: R1.2=1.932; R1.3=3.051; R1.4=at least 4.0 (row holds over the whole sweep); R1.5=2.172; R1.6=at least 4.0 (row holds over the whole sweep); R1.7=3.127; R1.8=3.586; R1.9=at least 4.0 (row holds over the whole sweep); R1.10=at least 4.0 (row holds over the whole sweep)
---
> ring1 info at R_SPEC 1.9565 ohm: the cell terminal is 3.0232 V just before the start is over (settled, motor 175 mA) and dips to 3.0232 V when U11 finishes charging C84 and the motor draws its start current; the cell gives 218.1 mA at the peak (decision 41 names 230 mA)
> ring1: largest cell resistance that passes at open-circuit 3.45 V = 2.0739 ohm; first rows to fail just above it: R1.2
> ring1 info: largest cell resistance that passes at open-circuit 3.30 V = 1.3825 ohm; limiting rows R1.2
> ring1 info: largest cell resistance that passes at open-circuit 3.60 V = 2.7653 ohm; limiting rows R1.2
> ring1 info: at that resistance the cell gives 217.0 mA at the start, the cell terminal falls to 3.0000 V, the chip battery path carries 79.3 mA, U11 carries 193.9 mA, VDD_3V0 falls to 2.881 V, VMOT to 2.890 V
> ring1 info: largest cell resistance for each pass line at 3.45 V is in r1_row_limits.csv: R1.2=2.075; R1.3=3.051; R1.4=at least 4.0 (row holds over the whole sweep); R1.5=2.238; R1.6=at least 4.0 (row holds over the whole sweep); R1.7=3.127; R1.8=3.586; R1.9=at least 4.0 (row holds over the whole sweep); R1.10=at least 4.0 (row holds over the whole sweep)
15,20c15,20
< ring7 info: cell 3.30 V: VBUS pad before removal 5.000 V, 1 s after 3.595 V, 10 s after 3.551 V
< ring7 info: cell 3.80 V: VBUS pad before removal 5.000 V, 1 s after 3.973 V, 10 s after 3.924 V
< ring7 info: cell 4.35 V: VBUS pad before removal 5.000 V, 1 s after 4.942 V, 10 s after 4.498 V
< ring7 what-if (not in the design): a 1000 kohm bleeder from VBUS to GND gives 0.7000 V on the VBUS pad 10 s after removal (cell 3.8 V)
< ring7 what-if (not in the design): a 440 kohm bleeder from VBUS to GND gives 0.0780 V on the VBUS pad 10 s after removal (cell 3.8 V)
< ring7 what-if (not in the design): a 330 kohm bleeder from VBUS to GND gives 0.0211 V on the VBUS pad 10 s after removal (cell 3.8 V)
---
> ring7 info: cell 3.30 V: VBUS pad before removal 5.000 V, 1 s after 2.136 V, 10 s after 0.019 V
> ring7 info: cell 3.80 V: VBUS pad before removal 5.000 V, 1 s after 2.359 V, 10 s after 0.021 V
> ring7 info: cell 4.35 V: VBUS pad before removal 5.000 V, 1 s after 3.014 V, 10 s after 0.027 V
> ring7 what-if (not in the design): a 1000 kohm bleeder from VBUS to GND gives 0.0038 V on the VBUS pad 10 s after removal (cell 3.8 V)
> ring7 what-if (not in the design): a 440 kohm bleeder from VBUS to GND gives 0.0004 V on the VBUS pad 10 s after removal (cell 3.8 V)
> ring7 what-if (not in the design): a 330 kohm bleeder from VBUS to GND gives 0.0001 V on the VBUS pad 10 s after removal (cell 3.8 V)
