NexusGPT/openring/design/mfg/assembly/hotbar-work/dumps/flex1-us10-dump.txt

file design/mfg/assembly/hotbar-work/copies/flex1-us10.kicad_pcb
edge Line 50.0000,78.5000 -> 51.7450,78.5000 w 0.050
edge Line 50.0000,81.0000 -> 50.0000,78.5000 w 0.050
edge Line 51.7450,78.5000 -> 52.9310,79.1000 w 0.050
edge Line 51.7450,81.0000 -> 50.0000,81.0000 w 0.050
edge Line 52.9310,79.1000 -> 59.8974,79.1000 w 0.050
edge Line 52.9310,80.9000 -> 51.7450,81.0000 w 0.050
edge Line 59.8974,79.1000 -> 60.1974,78.8000 w 0.050
edge Line 59.9974,80.9000 -> 52.9310,80.9000 w 0.050
edge Line 60.1974,74.3000 -> 66.5974,74.3000 w 0.050
edge Line 60.1974,78.8000 -> 60.1974,74.3000 w 0.050
edge Line 60.1974,80.7000 -> 59.9974,80.9000 w 0.050
edge Line 66.5974,74.3000 -> 66.5974,80.7000 w 0.050
edge Line 66.5974,80.7000 -> 60.1974,80.7000 w 0.050
User.1 shape Line box x 50.0250 51.6750 y 78.5250 78.5750
User.1 shape Line box x 50.0250 50.0750 y 78.5250 80.9750
User.1 shape Line box x 51.6250 51.6750 y 78.5250 80.9750
User.1 shape Line box x 50.0250 51.6750 y 80.9250 80.9750
User.1 shape Line box x 60.1724 66.6224 y 74.2750 74.3250
User.1 shape Line box x 60.1724 60.2224 y 74.2750 80.7250
User.1 shape Line box x 66.5724 66.6224 y 74.2750 80.7250
User.1 shape Line box x 60.1724 66.6224 y 80.6750 80.7250
User.1 text at (50.100,77.900): 'STIFFENER PI 0.10 on back face'
User.1 text at (60.297,74.000): 'STIFFENER PI 0.10 on back (B.Cu) face, 6.4 x 6.4'
edge box x 49.9750 66.6224 y 74.2750 81.0250 outline_perimeter 46.9492
pad J_BAND_A,J_BAND_A_TAIL,1,JOY_UP,50.4750,78.9850,0.300,0.300,F.Cu|F.Mask
pad J_BAND_A,J_BAND_A_TAIL,2,JOY_DOWN,50.4750,80.5150,0.300,0.300,F.Cu|F.Mask
pad J_BAND_A,J_BAND_A_TAIL,3,JOY_LEFT,50.4750,80.0050,0.300,0.300,F.Cu|F.Mask
pad J_BAND_A,J_BAND_A_TAIL,4,JOY_RIGHT,51.3750,78.9850,0.300,0.300,F.Cu|F.Mask
pad J_BAND_A,J_BAND_A_TAIL,5,BTN_REC,51.3750,80.5150,0.300,0.300,F.Cu|F.Mask
pad J_BAND_A,J_BAND_A_TAIL,6,GND,50.4750,79.4950,0.300,0.300,F.Cu|F.Mask
pad J_BAND_A,J_BAND_A_TAIL,7,VMOT,51.3750,80.0050,0.300,0.300,F.Cu|F.Mask
pad J_BAND_A,J_BAND_A_TAIL,8,GND,51.3750,79.4950,0.300,0.300,F.Cu|F.Mask
pad SW1,Alps_SKTAAAE010_pads34,3,JOY_UP,61.3724,78.8250,0.550,0.550,F.Cu|F.Mask
pad SW1,Alps_SKTAAAE010_pads34,4,GND,61.3724,76.1750,0.550,0.550,F.Cu|F.Mask
pad M1,W0525AB001D_Lands,1,VMOT,57.6532,79.8000,0.300,0.800,F.Cu|F.Mask
pad M1,W0525AB001D_Lands,2,GND,58.6532,79.8000,0.300,0.800,F.Cu|F.Mask
pad SW4,Alps_SKTAAAE010_pads34,3,JOY_LEFT,64.7224,79.5250,0.550,0.550,F.Cu|F.Mask
pad SW4,Alps_SKTAAAE010_pads34,4,GND,62.0724,79.5250,0.550,0.550,F.Cu|F.Mask
pad SW5,Alps_SKTAAAE010_pads34,3,JOY_RIGHT,62.0724,75.4750,0.550,0.550,F.Cu|F.Mask
pad SW5,Alps_SKTAAAE010_pads34,4,GND,64.7224,75.4750,0.550,0.550,F.Cu|F.Mask
pad SW3,Alps_SKTAAAE010_pads34,3,JOY_DOWN,65.4224,76.1750,0.550,0.550,F.Cu|F.Mask
pad SW3,Alps_SKTAAAE010_pads34,4,GND,65.4224,78.8250,0.550,0.550,F.Cu|F.Mask
pad SW2,Alps_SKTAAAE010_4pad,1,BTN_REC,63.0224,78.8250,0.550,0.550,F.Cu|F.Mask
pad SW2,Alps_SKTAAAE010_4pad,2,GND,63.0224,76.1750,0.550,0.550,F.Cu|F.Mask
pad SW2,Alps_SKTAAAE010_4pad,3,BTN_REC,63.7724,78.8250,0.550,0.550,F.Cu|F.Mask
pad SW2,Alps_SKTAAAE010_4pad,4,GND,63.7724,76.1750,0.550,0.550,F.Cu|F.Mask
via 61.3724,78.8250,JOY_UP
via 50.9250,78.9850,JOY_UP
via 65.4224,76.1750,JOY_DOWN
via 50.9250,80.5150,JOY_DOWN
via 64.7224,79.5250,JOY_LEFT
via 50.9250,80.0050,JOY_LEFT
via 62.0724,75.4750,JOY_RIGHT
via 51.3750,78.9850,JOY_RIGHT
via 50.9250,79.4950,GND
via 63.0224,76.1750,GND
via 63.7724,76.1750,GND
via 61.3724,76.1750,GND
via 58.6532,79.9300,GND
via 62.0724,79.5250,GND
via 64.7224,75.4750,GND
via 65.4224,78.8250,GND
