NexusGPT/openring/firmware/build-logs/step7/review-work/diff-stat.txt

 firmware/README.md                                 |    20 +-
 firmware/app/boards/ringrec_nrf54lm20a_cpuapp.conf |    47 +
 .../app/boards/ringrec_nrf54lm20a_cpuapp.overlay   |    13 +
 firmware/boards/ringrec/CMakeLists.txt             |     4 +
 firmware/boards/ringrec/Kconfig.defconfig          |     8 +
 firmware/boards/ringrec/Kconfig.ringrec            |     4 +
 firmware/boards/ringrec/board.cmake                |     5 +
 firmware/boards/ringrec/board.yml                  |     6 +
 .../ringrec/include/ring_battery_model_20mAh.inc   |    19 +
 .../boards/ringrec/include/rpw_battery_model.h     |    21 +
 firmware/boards/ringrec/netlist.csv                |   410 +
 .../ringrec/ringrec_nrf54lm20a_cpuapp-pinctrl.dtsi |    93 +
 .../boards/ringrec/ringrec_nrf54lm20a_cpuapp.dts   |   384 +
 .../boards/ringrec/ringrec_nrf54lm20a_cpuapp.yaml  |    16 +
 .../ringrec/ringrec_nrf54lm20a_cpuapp_defconfig    |    17 +
 .../step6/20261113-164349-lead-full3.log           |  9987 +++++++
 .../step6/20261113-190009-lead-full4.log           | 27925 +++++++++++++++++++
 firmware/build-logs/step6/lead-full3.console       | 27530 ++++++++++++++++++
 .../step6/lead-full4-kit-ram-symbols.txt           |    63 +
 firmware/build-logs/step6/lead-full4.exit          |     1 +
 firmware/docs/step6-report.md                      |    59 +
 firmware/tools/build_all.sh                        |   126 +
 firmware/tools/check_ring_pins.py                  |   367 +
 23 files changed, 67124 insertions(+), 1 deletion(-)
