NexusGPT/openring/firmware/build-logs/step7/review2-work/diff-firmware_boards_ringrec_include_rpw_battery_model.h.txt

diff --git a/firmware/boards/ringrec/include/rpw_battery_model.h b/firmware/boards/ringrec/include/rpw_battery_model.h
index 1faa8e30..0b7cd775 100644
--- a/firmware/boards/ringrec/include/rpw_battery_model.h
+++ b/firmware/boards/ringrec/include/rpw_battery_model.h
@@ -2,7 +2,7 @@
  * rpw_battery_model.h: the cell model for the fuel gauge of the ring (software step 7), the header that
  * modules/ring_power/src/rpw_hw_real.c includes by this name and reads as `battery_model`.
  *
- * STAND-IN, NOT THE RING'S CELL. ring_battery_model_20mAh.inc is a byte-for-byte copy of the nRF Connect SDK v3.4.2
+ * NOT THE RING'S CELL: A STAND-IN. ring_battery_model_20mAh.inc is a byte-for-byte copy of the nRF Connect SDK v3.4.2
  * file nrf/samples/pmic/native/npm13xx_fuel_gauge/src/battery_model_20mAh.inc (sha256 d462a345...b3a37, model name
  * "LP18l917"), the model Nordic's own sample uses with the nPM1304 evaluation kit. It is a 20 mAh lithium cell, inside
  * the ring's measured range (17.6 to 31.9 mAh, design/firmware.md 8.1), but it is not a model of the ring's cell:
