NexusGPT/openring/firmware/build-logs/step7/review2-work/diff-firmware_boards_ringrec_ringrec_production_mcuboot.conf.txt

diff --git a/firmware/boards/ringrec/ringrec_production_mcuboot.conf b/firmware/boards/ringrec/ringrec_production_mcuboot.conf
new file mode 100644
index 00000000..57984a25
--- /dev/null
+++ b/firmware/boards/ringrec/ringrec_production_mcuboot.conf
@@ -0,0 +1,4 @@
+# MCUboot for the ring's production build (step 7 fix round 1; design/firmware.md l.1061): no UART output.
+CONFIG_SERIAL=n
+CONFIG_CONSOLE=n
+CONFIG_UART_CONSOLE=n
