NexusGPT/openring/firmware/build-logs/step7/review2-work/r2-r5-config.txt

26:		zephyr,console = &uart20;
27:		zephyr,shell-uart = &uart20;
246:/* debug log, send only (design/firmware.md: uart20, DBG_TX; the former DBG_RX pin has no net) */
247:&uart20 {
251:	pinctrl-0 = <&uart20_default>;
252:	pinctrl-1 = <&uart20_sleep>;
262:&spi00 {
264:	cs-gpios = <&gpio2 5 GPIO_ACTIVE_LOW>;                                  /* SD_CS */
265:	pinctrl-0 = <&spi00_default>;
266:	pinctrl-1 = <&spi00_sleep>;
269:	ring_sdhc: sdhc@0 {
270:		compatible = "zephyr,sdhc-spi-slot";
276:			compatible = "zephyr,sdmmc-disk";
286:	cs-gpios = <&gpio1 5 GPIO_ACTIVE_LOW>;                                  /* LCD_CS */
353:				regulator-boot-off;
361:				regulator-boot-off;
--- ring conf PM/SPI/console
29:# the storage part's real file: SD card over SPI through the disk access API (design/firmware.md 5.1)
36:CONFIG_PM_DEVICE=y
38:# the power chip nPM1304 (I2C): the kit's drivers for its regulators (the two load switches) and charger
43:# nPM1304 node exists) and the kit's fuel gauge library it calls; its calls were fixed to SDK v3.4.2 in step 7 fix
--- prj.conf console/log
1:CONFIG_PRINTK=y
2:CONFIG_CONSOLE=y
