NexusGPT/openring/design/ecad/case/evidence/geom-link/diff.txt

4c4
< PCB1_X0 -9.637067021407239
---
> PCB1_X0 -10.141980544609442
19,20c19,20
< X_B_INNER 5.820089487395537
< X_BO 6.395830781954816
---
> X_B_INNER 5.520089487395537
> X_BO 6.195830781954816
24c24,25
< case.py lines: PCB1 141 JY 173 LED_Y 175
---
> case.py lines: PCB1 151 JY 195 LED_Y 197
> board file as the model reads it: u [-1.8499139999999983, 23.0] d [-20.200000000000003, 17.700000000000003] built with CASE_EXTEND 2.5
