NexusGPT/openring/design/ecad/ring-circuit-work/logs/diff_committed_vs_base_summary.txt

12c12
< FAIL case4 LED currents: 2 of 4 rows hold; C4.2: led.green_current_min = 0.00196783 needs >= 0.002 A; C4.3: led.blue_current_min = 0.00196783 needs >= 0.002 A
---
> FAIL case4 LED currents: 0 of 4 rows hold; C4.1: led.red_current_min = no value needs >= 0.002 A; C4.2: led.green_current_min = no value needs >= 0.002 A; C4.3: led.blue_current_min = no value needs >= 0.002 A; C4.4: led.max_current = no value needs <= 0.020 A
