NexusGPT/openring/design/mfg/assembly/hotbar-work/dumps/flex2-us10-dump.txt

file design/mfg/assembly/hotbar-work/copies/flex2-us10.kicad_pcb
edge Line 50.0000,79.0000 -> 50.0000,81.5000 w 0.050
edge Line 50.0000,81.5000 -> 51.7450,81.5000 w 0.050
edge Line 51.7450,79.0000 -> 50.0000,79.0000 w 0.050
edge Line 51.7450,81.5000 -> 52.9310,80.9000 w 0.050
edge Line 52.9310,79.1000 -> 51.7450,79.0000 w 0.050
edge Line 52.9310,80.9000 -> 75.6657,80.9000 w 0.050
edge Line 75.6657,80.9000 -> 75.9657,81.2000 w 0.050
edge Line 75.9657,81.2000 -> 75.9657,82.7500 w 0.050
edge Line 75.9657,82.7500 -> 85.8130,82.7500 w 0.050
edge Line 85.8130,79.1000 -> 52.9310,79.1000 w 0.050
edge Line 85.8130,82.7500 -> 85.8130,79.1000 w 0.050
User.1 shape Line box x 50.0250 50.0750 y 79.0250 81.4750
User.1 shape Line box x 50.0250 51.6750 y 81.4250 81.4750
User.1 shape Line box x 50.0250 51.6750 y 79.0250 79.0750
User.1 shape Line box x 51.6250 51.6750 y 79.0250 81.4750
User.1 text at (50.100,82.100): 'STIFFENER PI 0.10 on back face'
edge box x 49.9750 85.8380 y 78.9750 82.7750 outline_perimeter 79.5976
pad CP4,CP_Pad_1.6,1,GND,84.5440,81.5000,1.600,1.600,B.Cu|B.Mask
pad PRT1,PRT1_Tabs,1,VBAT,56.5264,79.6250,0.260,0.450,F.Cu|F.Mask
pad PRT1,PRT1_Tabs,2,GND,57.3864,79.6250,0.260,0.450,F.Cu|F.Mask
pad PRT1,PRT1_Tabs,3,NTC,56.9564,79.6250,0.260,0.450,F.Cu|F.Mask
pad CP1,CP_Pad_1.6,1,VBUS,77.2347,81.5000,1.600,1.600,B.Cu|B.Mask
pad CP2,CP_Pad_1.6,1,USB_DN,79.6711,81.5000,1.600,1.600,B.Cu|B.Mask
pad J_BAND_B,J_BAND_B_TAIL,1,VBAT,50.4750,79.4850,0.300,0.300,F.Cu|F.Mask
pad J_BAND_B,J_BAND_B_TAIL,2,GND,50.4750,80.5050,0.300,0.300,F.Cu|F.Mask
pad J_BAND_B,J_BAND_B_TAIL,3,NTC,50.4750,79.9950,0.300,0.300,F.Cu|F.Mask
pad J_BAND_B,J_BAND_B_TAIL,4,VBUS,51.3750,80.5050,0.300,0.300,F.Cu|F.Mask
pad J_BAND_B,J_BAND_B_TAIL,5,USB_DN,51.3750,79.9950,0.300,0.300,F.Cu|F.Mask
pad J_BAND_B,J_BAND_B_TAIL,6,USB_DP,51.3750,79.4850,0.300,0.300,F.Cu|F.Mask
pad J_BAND_B,J_BAND_B_TAIL,7,GND,50.4750,81.0150,0.300,0.300,F.Cu|F.Mask
pad CP3,CP_Pad_1.6,1,USB_DP,82.1076,81.5000,1.600,1.600,B.Cu|B.Mask
via 56.5264,79.6250,VBAT
via 50.9250,79.4850,VBAT
via 50.9250,80.5050,GND
via 84.5440,81.5000,GND
via 57.3864,79.6250,GND
via 50.9250,81.0150,GND
via 50.9250,79.9950,NTC
via 56.9564,79.6250,NTC
via 77.2347,81.5000,VBUS
via 79.6711,81.5000,USB_DN
via 82.1076,81.5000,USB_DP
