NexusGPT/openring/design/review/ring-kicad-xml-diff.txt

 design/ecad/ring/ring-kicad.xml | 2 +-
 1 file changed, 1 insertion(+), 1 deletion(-)
diff --git a/design/ecad/ring/ring-kicad.xml b/design/ecad/ring/ring-kicad.xml
index 6bd42eb..e05e31f 100644
--- a/design/ecad/ring/ring-kicad.xml
+++ b/design/ecad/ring/ring-kicad.xml
@@ -2,7 +2,7 @@
 <export version="E">
   <design>
     <source>design/ecad/ring/ring.kicad_sch</source>
-    <date>2026-11-10T20:19:00</date>
+    <date>2026-11-10T21:51:52</date>
     <tool>Eeschema 10.0.8</tool>
     <sheet number="1" name="/" tstamps="/">
       <title_block>
