NexusGPT/openring/design/wiring/case-marks-2-work/svgc_diff.txt

95c95
<     <!-- W023  red lead wire AWG32 of the motor, cut 1.12-1.39 mm -->
---
>     <!-- W023  red lead wire AWG32 of the motor, cut 1.07-1.44 mm -->
98c98
<     <!-- W024  blue lead wire AWG32 of the motor, cut 1.12-1.39 mm -->
---
>     <!-- W024  blue lead wire AWG32 of the motor, cut 1.07-1.44 mm -->
112c112
<     <!-- W025  FLEX2 6.207-6.799 mm -->
---
>     <!-- W025  FLEX2 5.995-6.799 mm -->
115c115
<     <!-- W026  FLEX2 7.445-8.037 mm -->
---
>     <!-- W026  FLEX2 7.233-8.037 mm -->
121c121
<     <!-- W027  FLEX2 6.718-7.310 mm -->
---
>     <!-- W027  FLEX2 6.505-7.310 mm -->
127c127
<     <!-- W028  inside the switch -->
---
>     <!-- W028  inside the cell pack -->
262c262
<     <!-- W061  thermistor's own lead, cut 10 mm -->
---
>     <!-- W061  thermistor's own lead, bare, no polarity, cut 10 mm -->
265c265
<     <!-- W062  thermistor's own lead, cut 10 mm -->
---
>     <!-- W062  thermistor's own lead, bare, no polarity, cut 10 mm -->
273c273
<     <!-- W063  wire 30 AWG stranded, cut 15.6 mm -->
---
>     <!-- W063  wire 30 AWG stranded, red insulation, cut 15.6 mm -->
276c276
<     <!-- W064  wire 30 AWG stranded, cut 16.3 mm -->
---
>     <!-- W064  wire 30 AWG stranded, white insulation, cut 16.3 mm -->
279c279
<     <!-- W065  wire 30 AWG stranded, cut 16.3 mm -->
---
>     <!-- W065  wire 30 AWG stranded, green insulation, cut 16.3 mm -->
282c282
<     <!-- W066  wire 30 AWG stranded, cut 15.6 mm -->
---
>     <!-- W066  wire 30 AWG stranded, black insulation, cut 15.6 mm -->
285c285
<     <!-- W067  wire 30 AWG stranded, cut 15.9 mm -->
---
>     <!-- W067  wire 30 AWG stranded, yellow insulation, cut 15.9 mm -->
292c292
<     <!-- Line style = state of the line in the csv (column state). Copper lengths are the shortest copper path pad to pad in the band boards at US 7 and US 13; cut lengths are the lead or wire cut length (US 7 - US 13). Made by design/wiring/draw_wiring.py. -->
---
>     <!-- Line style = state of the line in the csv (column state). Copper lengths are the shortest copper path pad to pad in the band boards (smallest to largest over US 7 to 13); cut lengths are the lead or wire cut length (smallest to largest over US 7 to 13). Made by design/wiring/draw_wiring.py. -->
