NexusGPT/openring/explorer/collector/extract/boards.py

"""boards (a helper of board.py, no extract() of its own): the list of boards held by board/index.json.

One entry per board file: the ring's main board, the band circuits (two per ring size) and the two case boards.
Everything is read at collect time from the board files; no copy of a board is kept in app source.

  per board   its file, the time of the file, its outline, its copper layers (one SVG per layer made by KiCad's own
              command line, with the board outline in every file), the parts placed on each face (reference, value,
              position, size) and its state.
  state       the rules check, run here with `kicad-cli pcb drc --severity-all`; the numbers are the count lines of
              the report that is saved next to the layer files ("** Found N DRC violations **" and
              "** Found N unconnected pads **"). The words are "routed and checked: 0 violations, 0 open connections"
              when both are 0, else "not finished: N connections open, M violations".

A board file that is missing or cannot be read still gets an entry, with its state in words (status 'not-checked').
"""
import re
import subprocess
import sys
from datetime import datetime
from pathlib import Path

HERE = Path(__file__).resolve().parent
sys.path.insert(0, str(HERE.parent))
sys.path.insert(0, str(HERE))

import schematic  # noqa: E402  (its KiCad lookup: $KICAD_CLI, the app paths, then PATH)
from lib import csvread  # noqa: E402
from lib.source import pointer  # noqa: E402

BOM_FILES = {"ring": "design/bom.csv", "case": "design/case/case-bom.csv"}
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
