NexusGPT/openring/(commit log)

2026-11-13 OpenRing: the open design of a meeting recorder ring, state of 13 November 2026 (intermediate release)
    All 17 circuit boards routed; the wiring list of 66 conductors and the joint table of 99 joints; circuit simulation; ring software steps 1 to 6; the exterior for the 4.17 mm block. Open faults are named in the README and in design/wiring/wiring-review-4.md.
    This commit replaces the repository's earlier history. The earlier commits held pictures and text of makers' documents that did not belong in a public repository; they are removed.
    [01-try.kicad_pcb, 40-broken-diff.txt, 42-failtest-diff.txt, TH1_bead.step, a5_1_u6_select_gnd.csv, a5_2_u7_back.csv, a5_3_sw4_not_ground.csv, a5_4_testpad22_moved.csv]
2026-11-13 State of 13 November 2026, evening: recorder software (step 6), custom screen panel requirement, main board for the thin ring
    - Ring software step 6: microphones, storage, USB transfer, power, motor and
    factory tests against simulated drivers; report in firmware/docs/step6-report.md.
    - The design moves to a custom full-face screen panel on the thin block:
    requirement page design/mfg/specs/screen-panel-custom.md.
    - Main board version A1 for the thin ring: screen connector on the under face
    (design/ecad/ring-route-g). Not yet the board of the fabrication files.
    - Status file and README corrected to this state.
    [bom.csv, deferred-triage.csv, flex-tail-away-footstiffener-us10.step, flex-tail-away-footstiffener-us11.step, flex-tail-away-footstiffener-us12.step, flex-tail-away-footstiffener-us13.step, flex-tail-away-footstiffener-us7.step, flex-tail-away-footstiffener-us8.step]
2026-11-14 State of 14 November 2026: ring software step 7 (the real ring's board files), the thin ring's main board
    - Ring software step 7: board description of the real ring, pin check against
    the circuit's connection list, a build without the debug port; four
    independent reviews; report in firmware/docs/step7-report.md.
    - The ring's main board is the thin ring's: screen connector on the under
    face, no soldered part on the screen face (design/ecad/ring/pcb). The board
    of the 4.17 mm fallback is kept in design/ecad/ring/pcb/fallback-417.
    - Logs that were mostly copied source of the chip maker's software kit are
    removed.
    [c7-on-screen-face.kicad_pcb, c7a.kicad_pcb, c7b.kicad_pcb, c7c.kicad_pcb, c7d.kicad_pcb, c7e.kicad_pcb, c7f-.kicad_pcb, c7g.kicad_pcb]
